wujijun11/git/TangMega60K_Synth/hardware/touch25/README.md

# Touch25：25键 FPGA 合成器触摸面板

本目录是本项目的 **25键纯被动电容触摸电极面板 R1 打样版**。它只负责提供可触摸的铜电极，触摸检测由外接的三块 MPR121 模块完成，FPGA负责读取触摸状态与合成声音。

**状态：独立几何预检通过；最终原生工程已导入，2026-10-09 18:24:32完成立创EDA原生DRC，141项检查、0错误。实际导出的Gerber完成163项独立几何检查、全部通过，ZIP字节和25键映射交叉核对通过。尚未下单，触摸、音频整机与延迟未实测。**

2026-10-09：同名最终 Gerber ZIP 已上传立创并解析成功，关联文件 ID 为 `99255657`，识别尺寸29 × 10.5 cm、2层。这里只记录上传完成，订单仍未提交、未付款。

2026-10-09 21:28：按用户要求再次上传同一最终ZIP，最新关联文件 ID 为 `99258298`，上传记录显示处理成功（16秒）。新订单准备页核对29 × 10.5 cm、2层、哑黑阻焊、无铅喷锡及手动确认；未提交订单、未付款。该次上传未更改R1制造图。

本次继续优化已补齐 [8/8/9组可拆线束与底托方案](harness_assembly_zh.md)、[装配示意图](harness_layout.png)、[逐键校准工具与流程](calibration_guide_zh.md) 和 [B的驱动交接约定](touch25_driver_handoff_zh.md)。校准工具的10项合成测试通过；原制造文件和25键映射未修改。模块实物外形、引脚约束、采集驱动、校准阈值和完整延迟仍需上板确认。

## 面板规格

| 项目 | 设计值 |
| --- | --- |
| 音域 | C4–C6，MIDI 60–84，共25个半音 |
| 琴键 | 15个白键位置、10个黑键位置；平面触摸，无按压行程 |
| PCB | 双层，290 × 105 mm；建议1.6 mm FR-4 |
| 白键节距 | 18 mm |
| 白键电极 | 16 × 28 mm，圆角半径1.5 mm |
| 黑键电极 | 11 × 25 mm，圆角半径1.5 mm |
| 外观建议 | 黑色阻焊、白色丝印；白键由轮廓及音名识别 |
| 电极表面 | 顶层铜覆盖阻焊，不开露铜或锡膏窗口 |
| 信号接口 | J1：1×8；J2：1×8；J3：1×9，均为2.54 mm排针 |
| 连接孔 | 1.0 mm通孔、1.8 mm焊盘；pin1为方形焊盘 |
| 转层孔 | 0.3 mm孔、0.8 mm焊盘，焊环0.25 mm；上下阻焊扩展−0.4 mm，实际Gerber确认双面盖孔 |
| 最小丝印 | 字高1.0 mm，线宽0.15 mm |
| 安装孔 | 六个3.2 mm非金属化通孔；下中孔已改到(170,100) mm |

面板没有 MCU、MPR121 芯片、音频电路、SCL/SDA、VCC或GND接口，也没有地平面。不能单独发声。工程预览中的半透明色用于显示被阻焊覆盖的电极位置，不能当作实物照片或实际铜面颜色。

## 电极连接

| 面板接口 | 琴键网络 | 外接模块 | 模块触摸通道 |
| --- | --- | --- | --- |
| J1 pin1–8 | E00–E07 | MPR121 #1 | ELE0–ELE7 |
| J2 pin1–8 | E08–E15 | MPR121 #2 | ELE0–ELE7 |
| J3 pin1–9 | E16–E24 | MPR121 #3 | ELE0–ELE8 |

三个接口只传电极信号。**面板上的这些针脚接 MPR121 的 ELE端，不能直接接 FPGA GPIO，也不能接3.3V、5V或GND。** 从面板正面看，各接口pin1在左，信号按音高从左到右增加；从背面看左右会反转，请识别方形pin1。

将三块模块放在对应接口附近，电极连接线以 **不超过5 cm** 为布置目标，尽量避开DAC时钟线和功放/喇叭线。使用三个独立 I²C 总线：每块模块的 SCL、SDA、IRQ分别接FPGA，共占9个GPIO；模块另接3.3V和公共GND。按目前仅DAC占用三路PMOD信号的接线，13个空闲GPIO接完后剩4个。具体FPGA针脚必须由约束文件分配到已确认的3.3V GPIO。

完整装配步骤和25键逐针表见 [装配与接线指南](assembly_wiring_zh.md)。
面板侧优先采用2.54 mm的8/8/9针成组母壳，两端标明J1/J2/J3及pin1；模块端按实物ELE标注核对，不能默认两端直通。模块放在下沿外绝缘托架，量实物后确定固定方式；详见 [线束与底托方案](harness_assembly_zh.md)。

## 还需要准备

- 三块 MPR121 模块，优先选择排针已焊版本；模块使用3.3V供电及3.3V数字电平。
- 1×8公排针两条、1×9公排针一条，需要自行焊接；本面板没有SMT器件，普通PCB打样不会自动焊排针。
- 25根短电极信号线。面板侧用2.54 mm的1×8母壳两只、1×9母壳一只及匹配端子；模块侧公排针可用1P母端逐针接线，核对ELE物理顺序后再考虑成组插头。电极线另作拉力固定。
- 模块到FPGA的9根数字信号线及3.3V/GND分配线。模块公排针到FPGA PMOD插孔通常使用公对母线。
- 六套M3绝缘支柱/螺丝及安装底板；避免PCB背面焊点碰金属。
- 可选薄PET保护膜。加膜后重新校准触摸阈值，并重新测试响应。

当前FPGA工程还需要增加MPR121初始化、三总线触摸读取、25键音符映射与校准。触摸开/关不能作为已经测得的压力或击键速度；项目要求的第二种独立演奏维度应另接合适传感器。端到端触摸→声音延迟仍需实测，不能用芯片采样间隔或软件预检代替。

## 文件和复现

| 文件 | 用途 |
| --- | --- |
| `Touch25_C4_C6_18mm_R1_Final/Touch25_C4_C6_18mm_R1_Final.eprj3` | 在立创EDA专业版实际保存、完成0错误DRC的最终原生工程入口 |
| `Touch25_C4_C6_18mm_R1_Final/pcb/Touch25_C4_C6_18mm_R1.epcb2` | 最终原生PCB源码，随同上面的工程目录保存 |
| `Gerber_Touch25_C4_C6_18mm_R1_2026-10-09.zip` | 实际原生导出的制造文件，54,830字节；163项独立检查通过 |
| `Touch25_C4_C6_18mm_R1.epro2` | 生成脚本创建、用于导入的R1原生交换工程 |
| `Touch25_C4_C6_18mm_R1.epru` | 同一工程的原生记录文本 |
| `generate_touch25.py` | 从同源几何生成工程、映射与预览 |
| `native_writer.py`、`clean_editor_defaults.json` | 干净原生序列化器与编辑器通用默认配置，不含旧555电路 |
| `design_manifest.json` | 尺寸、坐标、每键电极与线路几何、状态和工程SHA256 |
| `mapping.csv` | 25键、MIDI、排针和MPR121通道逐项映射 |
| `top_preview.svg`、`bottom_preview.svg` | 工程几何预览；底层以正面透视方向显示，不镜像 |
| `top_preview.png`、`bottom_preview.png`、`design_overview.png` | 对现有SVG的渲染及中文双面总览，非原生Gerber截图 |
| `render_preview_png.cjs`、`compose_preview_png.py` | PNG渲染与组合脚本；需要sharp和Pillow，不修改工程几何 |
| `validate_geometry.py`、`geometry_preflight.json` | 独立几何与映射检查，不是立创原生DRC |
| `assembly_wiring_zh.md` | 中文装配、逐针接线和首板验收指南 |
| `harness_assembly_zh.md`、`harness_layout.svg/png` | 不改R1孔位的成组线束、pin1标记与模块托架方案；模块占位不用于加工 |
| `calibrate_touch25.py`、`calibration_template.csv`、`calibration_guide_zh.md` | 读取实测日志并生成逐键阈值候选；缺测/故障/噪声重叠时阻止相应候选，不写设备 |
| `test_calibrate_touch25.py` | 10项合成数据测试，不表示首板已实测 |
| `touch25_driver_handoff_zh.md` | B后续驱动的初始化、8/8/9状态屏蔽、按下/释放、故障恢复与验收约定 |
| `verification/optimization_20261009.md` | 本次优化范围、验证和制造文件保持情况 |
| `fabrication_parameters_zh.md` | PCB打样参数与提交前核对说明，价格/选项以实际页面为准 |
| `verification/actual_gerber_audit.json` | 实际Gerber的163项独立检查明细、钻孔/铜层/阻焊与文件哈希 |
| `verification/actual_gerber_review.md` | 实际制造文件的审核结论、解析方法和实物验收限制 |
| `verification/package_crosscheck.json` | ZIP内12个文件的字节核对和MIDI60–84映射核对 |

在本目录执行 `python generate_touch25.py` 和 `python validate_geometry.py` 可重新生成、检查。重新生成会创建新文档/对象UUID，因此归档文件SHA256会改变；电极尺寸和线路几何由生成脚本决定。设计坐标以毫米表示、正y向下，写入原生工程时统一将y取负。

## 已完成的真实预检

下中安装孔移动到(170,100) mm后，`geometry_preflight.json`记录：25键和8/8/9通道映射通过；同源几何的电极→转层点→接口端点连续；异网铜和安装孔避让检查通过。最小异网铜间距为 **0.740 mm**，最小异网线线间距为 **0.786818 mm**。原生记录包含25个顶层FILL电极、100段铜线和56个PAD（25个接口、25个转层点、6个NPTH）。

最终原生工程还完成了141项DRC检查、0错误，并实际导出了54,830字节的Gerber ZIP。该ZIP的SHA256为 `796CCB39E2B18CB72EF80832254A5D7D71BE6FFF0C74F9DEE4A8960D6979C42C`。实际Gerber的163项独立检查全部通过，确认290 × 105 mm闭合外框、25路独立连接、25个0.3 mm转层PTH、25个1.0 mm接口PTH、六个3.2 mm NPTH、双面电极/转层阻焊覆盖、接口阻焊开窗及无独立锡膏文件；ZIP内12个文件与审核副本逐字节一致，CSV/manifest的MIDI60–84映射一致。

这些证据不等同于厂家CAM接受或首板硬件验收。审核按标称钻孔移除了与NPTH完全同心同径的铜圆盘，钻偏、孔径公差和工厂CAM修改仍需制造端确认；实际Gerber检查也不代替完整丝印可读性审核。没有任何已下单、已制造、触摸延迟、音频整机或首板硬件验收通过的声明。详细范围见 `verification/actual_gerber_review.md`。
