wujijun11/git/TangMega60K_Synth/docs/hardware/GAO板内验证-20260923.md

# GAO板内数字验证（2026-09-23）

## 工程与运行方式

新增独立入口 `BoardAudioGAO.gprj`，顶层为 `rtl/board/board_audio_gao_top.v`，复用现有 `live64_system_top`。原主音源与手动板级诊断入口未被替换。

上电后自动执行：复位 → 启动64声部 → 保持约1秒 → 停止 → 等待释放完成且声部数归零 → 完成次数加一 → 下一轮。错误、任意非零欠载及等待超时会置位粘滞 `fault` 并停机。每轮音源复位会清除其欠载计数，但不会清除该粘滞故障。

配置 `debug/board_audio.rao` 用系统时钟采集4096点，观察状态、声部数、欠载及内部I2S。此工程不输出外部DAC引脚，不能用于模拟音频验收。

## 编译、仿真与下载

- `scripts/test-board-gao.ps1` 通过：`BOARD GAO AUTORUN PASSED runs=2 restart=3`。
- `scripts/build-board-gao.tcl` 构建通过；Setup/Hold违例均为0。
- V22非专用时钟输入导致的PR1014仍存在，本次未消除该物理限制。
- 实际带GAO码流为 `impl/pnr/ao_0.fs`。SHA256：`C8958860C0C4394B5CFD2E7FC11A349229BDBA240642F0F29CE1BF1208C6EA8C`。
- GOWIN Programmer SRAM Program成功，用时11.91秒，器件ID `0x0001481B`，User Code `0x0000C446`，Status Code `0x70026020`。未写Flash；断电后此SRAM程序不保留。

## 实物读回

| 信号 | 第一次采集 | 第二次采集 |
| --- | --- | --- |
| completed_runs（十进制） | 15 | 80 |
| active_count | 64 | 64 |
| phase | 3（HOLD） | 3（HOLD） |
| error / fault | 0 / 0 | 0 / 0 |
| underruns | 0 | 0 |
| 有效采样点 | 4096 | 4096 |

完成次数从15增加到80，表明自动启停及释放归零流程持续运行；两次快照均位于保持阶段，并非停止瞬间的直接波形。欠载、错误和粘滞故障均为0。启动欠载及自检复位修复过程见[修复记录](启动欠载修复-20260923.md)。

仅保留修复后的有效波形：[第15轮](gao-20260923/zero_underrun_run15.csv)和[第80轮](gao-20260923/zero_underrun_later.csv)。检查脚本默认零欠载要求下均通过：BCLK周期16个系统时钟、完整声道槽32位、1位延迟后24位数据、末尾填零，并各解码7个完整非零PCM样本。修复前的两份启动欠载波形已按用户要求移除。

CSV导出窗口默认时间单位为us、周期为1，不能把它作为实际采样时间。检查脚本使用行号作为系统时钟周期。按板载标称50MHz推算，BCLK为3.125MHz，音频采样率为48,828.125Hz；本次没有用外部仪器测量晶振频率。

复核命令（项目目录内）：

```powershell
python scripts/check-gao-capture.py docs/hardware/gao-20260923/zero_underrun_run15.csv docs/hardware/gao-20260923/zero_underrun_later.csv
```

## 验证边界与下一步

本次完成板内满声部运行、自动释放重启及I2S数字格式检查，未逐样本对比实物PCM的算法期望值，未验证外置DAC、模拟音质、准确音高或演奏端到端延迟。音高参数目前按48kHz生成，需与实际音频时钟统一。完整262144帧ModelSim频谱回归另行运行，不能用此GAO检查替代。

继续调试时在GOWIN打开本工程，进入Gowin Analyzer Oscilloscope，加载对应RAO与匹配码流，按F1采集；查看 `fault`、`active_count`、`completed_runs` 和I2S信号。DAC到货后再核对物理引脚、电平与供电并开展外部输出验证。
