wujijun11/git/TangMega60K_Synth/docs/hardware/官方资料读取-20260920.md

# 官方硬件资料读取记录（2026-09-20）

读取来源：Sipeed Tang Mega 60K Wiki所链接的官方下载站。
本次下载及读取资料，未修改RTL、工程文件或生效CST/SDC，未烧录。

## 资料版本

- SOM/tang_mega_60k_30354_schematics..pdf：7页，下载站更新时间2026-06-08。确实有2026年上传的60K核心板资料；不代表手中实物就是30354，也不代表所有图纸页日期都是2026。
- SOM/tang_mega_60k_30353_schematics.pdf：7页，旧版对照。
- DOCK/Tang_Mega_NEO_Dock-60K_31004_Schematics.pdf：21页，Rev 1.4，2025-03-31。
- 08_Misc/tang_mega_60K_pins.cst：官方60K全引脚参考，下载站更新时间2024-11-19。
- PTC PT8211_s.pdf：芯片手册明确16位、LSBJ格式。

文件保存在工作区tmp/hardware_read_20260920，核心板30354部分PDF字体不能直接提取，相关时钟和电源页已渲染查看；底板音频、按键、扩展口和DVP页已渲染查看。未逐项验收所有外设或新旧版本差异。

## 与当前工程直接相关的发现

1. 核心板30354第2页：Y1100为50MHz，OUT经R973到BANK7_V22_EMCCLK_50Mhz；官方CST sys_clk=V22、LVCMOS33。
2. 当前发送器DIV=8：Fs=clk/(8*2*64)。50MHz直连会得到48828.125Hz，不是48000Hz；当前音源ROM按48kHz生成。需要验证可实现的时钟方案，不能简单假定PLL能精确生成49.152MHz。
3. 底板第10页：U16=PT8211-S，U20=NS4263，PA_EN=1关闭功放，0开启。原理图I2S_BCLK/I2S_LRCK/I2S_DIN命名不能改变DAC的LSBJ协议。当前24位Philips I2S不能直接驱动该DAC。
4. 沿用用户既定标准I2S路线，后续应连接兼容的外置DAC，并依据具体模块电路决定供电、FMT/XSMT/SCK等接法。本次不恢复已删除PT8211模式。
5. 底板第9页：用户按键AA13、AB13、Y12在BANK9，要求LVCMOS15、内部上拉至1.5V，按下接地。AA13在官方例程CST命名sys_rst_n，但物理上是用户按键，不是系统专用复位管脚。
6. 底板第19页：FPC10P也注明BANK9、1.5V。更正笼统说法：不能把全部FPGA引脚设为3.3V；必须逐个BANK核对。
7. 官方CST包含摄像头、DDR、以太网等例程内部层级的INS_LOC/CLOCK_LOC，不可整份直接加入本音源工程。应只选已核对、实际使用的端口，并匹配新板级顶层名称。
8. PMOD与SDRAM1/DVP存在复用；外接DAC/键床分配前须建立冲突表。第19页PMOD电源脚1/2为3.3V，3/4为GND，以图纸连接器编号为准；不可按通用模块的外观方向猜针脚。

## 官方CST参考映射（不是已批准接线表）

|信号|FPGA球号|CST电平|用途|
|---|---|---|---|
|sys_clk|V22|3.3V|50MHz时钟|
|sys_rst_n|AA13|1.5V，上拉|板载用户按键EX_KEY.0|
|Key_in[0]|AB13|1.5V，上拉|板载用户按键EX_KEY.1|
|Key_in[1]|Y12|1.5V，上拉|板载用户按键EX_KEY.2|
|HP_BCK|Y17|3.3V|板载PT8211 BCK|
|HP_WS|AB17|3.3V|板载PT8211 WS|
|HP_DIN|AA16|3.3V|板载PT8211 DIN|
|PA_EN|AB16|3.3V|板载功放控制|

球号不是排针编号；板载DAC引脚也不是外置DAC建议接线。

## 尚需确认

实物核心板与底板丝印版本；外置标准I2S DAC具体模块；外接键床/传感器占用；音频时钟精度及PLL可行性；最终CST/SDC、布局布线和上板测量。

## 官方来源

- https://wiki.sipeed.com/hardware/zh/tang/tang-mega-60k/mega-60k.html
- https://dl.sipeed.com/shareURL/TANG/Mega_138K_60K/02_Schematic/SOM
- https://dl.sipeed.com/shareURL/TANG/Mega_138K_60K/02_Schematic/DOCK
- https://dl.sipeed.com/shareURL/TANG/Mega_138K_60K/08_Misc
- https://www.princeton.com.tw/Portals/0/activeforums_Attach/PT8211_s.pdf
