wujijun11/git/TangMega60K_Synth/docs/hardware/主工程板上复测-20261011.md

# 主工程板上复测（2026-10-11）

当前板上为 `full/ContestFull.gprj` / `board_contest_full_top`。独立单音诊断之后，已通过 Gowin Programmer GUI 恢复完整主工程；本次保留该位流，只读器件码并按用户实际听测核对控制。J13 空着，使用现有 PCM5102A → 功放 → 喇叭。

## 配置与构建依据

- 位流：`full/impl/pnr/ContestFull.fs`；SHA256 为 `d206588cf0e7a7d2e068e081b83c071344ddc7ccc740abeac4f350bebe4aa0ed`。
- 本次 JTAG 只读完成，退出码 0：器件 ID `0x0001481B`、用户码 `0x0000F0A6`、状态码 `0x70026020`。器件码读取不是整个位流内容回读，也不提供内部声部数或欠载计数。
- 对应布局布线报告：建立余量 0.171ns、保持余量 0.004ns，建立/保持违规均为 0；块 RAM 为 106/118（90%）。这是静态构建结果，不能代替长时间实物稳定性测试。

下载历史见 [GUI 下载记录](../../verification/contest-full-20261011/hardware-gui-after-diagnostic.json)，本次原始读码见 [JTAG 日志](../../verification/contest-full-20261011/jtag-main-controls-retest.log)，构建数据见 [build-results.json](../../verification/contest-full-20261011/build-results.json)。SRAM 配置断电后丢失。

## 实物结果

| 检查 | 结果与来源 |
| --- | --- |
| KEY0 启动、播放中停止、再按重播 | 用户报告通过 |
| KEY2 按下并松开复位，再按 KEY0 | 用户报告可重新播放 |
| 播放中按 KEY1 | 用户报告乐曲停止 |
| 再按 KEY1 退出引导，再按 KEY0 | 用户报告可重新播放 |
| 喇叭实际输出 | 用户报告“声音很轻，但能听到音高变化” |

原话为“能播放、停止、重播，复位后也能重播”和“KEY1 能停止乐曲，退出后 KEY0 能重播”。结构化结果见 [本次板上复测记录](../../verification/contest-full-20261011/hardware-main-controls-retest.json)。没有外接灯条，本次 KEY1 结果仅证明声音控制和恢复，不证明指引灯输出正常。

声音偏轻尚未解决。代码中主工程 `MASTER_SHIFT=1`，单声部诊断为 7；同一单音的数字尺度差 64 倍（约 36.1dB），主工程保留了多声部叠加余量。本次没有改变混音增益，也没有测量模拟输出电平、精确音高或失真，不能据此宣布旋律和音质验收通过。

## 尚未实测的功能

25 键琴键 PCB、滑条、ESP32-C3 和外接 WS2812 尚未到货。用户确认没有 HDMI 显示器和 3.3V USB 转 TTL；电脑仅枚举到蓝牙虚拟 COM5，不能当作 FPGA 的 UART 使用。现有主工程没有可用的内嵌 GAO，DEBUG USB 的读码不能替代内部遥测。

因此，25 键/滑条、手机 BLE、外接 LED、HDMI、64 声部实际并发、运行时音色/音效，以及控制到 DAC 的物理延迟仍待验收。现有仿真通过记录继续作为软件证据，不能标为以上实物功能已经通过。整机接线与后续步骤见 [首次上板与到货验收](../全功能首次上板步骤-20261011.md)。
