wujijun11/git/TangMega60K_Synth/docs/hardware/外置I2S下载验证-20260927.md

# 外置 I2S 下载验证（2026-09-27）

## 当前结论

外置 DAC 测试工程仿真、综合、布局布线通过，已通过 Gowin Programmer 下载到 Tang Mega 60K 的 SRAM。实际喇叭声音仍待用户反馈，不能据下载成功判定音频硬件验收通过。

本次使用 `clock48/BoardAudio48kI2S.gprj`、顶层 `board_audio_48k_i2s_top`，复用 `live64_system_top` 的 64 声部自检。这是外置音频链路测试入口，不是队员 B 完整演奏交互的最终板级入口。没有烧写 Flash。

## 接线证据

用户断电测量确认：青绿色线在 DAC 端的金属触点与 PMOD1 的 AA20 焊点持续蜂鸣，电阻接近 0Ω。此次测量直接确认数据线导通，其他线没有在本次获得独立测量结果。

| DAC 信号 | 线色 | 工程约束 |
| --- | --- | --- |
| DIN | 青绿色 | AA20 |
| WSEL / LRCLK | 紫色 | AB21 |
| BCK | 蓝色 | Y21 |

用户报告功放板已连接。

## 仿真与构建

- 脚本：`scripts/test-board-48k-i2s.ps1`
- 结果：`BOARD 48K EXTERNAL I2S PASSED stop/restart/reset slots=521 active_bits=1024`
- 构建：`gw_sh.exe scripts/build-board-48k-i2s.tcl`，退出码 0。
- 构建日志：工作区 `tmp/board_audio_i2s_build_20260927.log`。
- 时序报告：`clock48/impl/pnr/BoardAudio48kI2S.tr`。
- Setup 违规端点 0；Hold 违规端点 0。
- 49.152 MHz 音频时钟域报告 Fmax 72.536 MHz。
- 仍有 ROM 文本位宽、时钟关系 CK3000、非专用时钟布线 PR1014 等警告；本次未改动 RTL 或约束，不将此次编译描述为零警告。

## 实际下载结果

- 文件：`clock48/impl/pnr/BoardAudio48kI2S.fs`
- SHA256：`5D6743116073242F13620DB34CD2896C4DFE3D169D882845997E197526ED18DB`
- 工具：Gowin Programmer V1.9.12 (64-bit) (2558)
- 下载线：USB Debugger A/0/609/null
- 器件：GW5AT-60B，ID `0x0001481B`
- 操作：`SRAM Program`
- User Code：`0x0000BB56`
- Status Code：`0x70026020`
- 输出：`Finished.`，用时 13.03 秒。

## 待完成的实物测试

功放低音量，短按用户 KEY0（AA13）启动自检；KEY1（AB13）停止；KEY2（Y12）复位。不要把 PWR 当作用户按键。待记录是否发声，以及停止、再次启动、复位是否符合预期。
