wujijun11/git/TangMega60K_Synth/docs/hardware/外置I2S下载验证-20261007.md

# 外置 I2S 下载验证（2026-10-07）

## 本次结果

已在 GOWIN FPGA Designer 打开 `clock48/BoardAudio48kI2S.gprj`，通过 Gowin Programmer 将既有位流重新下载到 Tang Mega 60K 的 SRAM。下载器本次报告 `Finished.`，用时 11.78 秒。未重新编译，未烧写 Flash。

这确认本次下载成功。随后用户反馈“可以发声”，并明确确认“KEY1 能停止，KEY0 能重新发声，KEY2 能复位静音”。据此，本次外置音频链路的发声、停止、重新启动及复位静音检查按用户实物反馈通过；最终供电电压仍待确认。

## 下载证据

- 工具：Gowin Programmer V1.9.12 (64-bit) (2558)
- 文件：`clock48/impl/pnr/BoardAudio48kI2S.fs`
- SHA256：`5D6743116073242F13620DB34CD2896C4DFE3D169D882845997E197526ED18DB`，本机核对与 2026-09-27 记录一致。
- 顶层：`board_audio_48k_i2s_top`
- 工程器件：`GW5AT-LV60PG484AC1/I0`
- 本次识别：`GW5AT-60B(0x0001481B)`
- 下载线：`USB Debugger A/0/609/null@2.5MHz`；操作过程中报告频率更新为 15MHz。
- 操作：`SRAM Program`
- User Code：`0x0000BB56`
- Status Code：`0x70026020`
- 输出：`Finished.`，`Cost 11.78 second(s)`。

## 用户实物测试

功放供电应为 5V，音量从低档开始。普通用户键 KEY0（AA13 / EX_KEY.0）启动，KEY1（AB13）停止，KEY2（Y12）复位。PWR 不是这些用户键。

本测试入口同时持续输出 64 个正弦音（MIDI 36–99），不播放旋律。按 KEY1 后约 100ms 的尾音释放属程序预期；释放后可再次按 KEY0 启动。KEY2 复位后需再次按 KEY0。

| 项目 | 本次实物结果 |
| --- | --- |
| 功放供电电压、极性 | 待用户实测反馈 |
| KEY0 启动后发声 | 用户报告可以发声，并确认 KEY0 能重新发声 |
| KEY1 停止 | 用户确认通过 |
| KEY0 再启动 | 用户确认通过 |
| KEY2 复位静音 | 用户确认通过 |

## 接口与限制

- PMOD 外置 DAC：DIN=AA20（青绿色），WSEL/LRCLK=AB21（紫色），BCK=Y21（蓝色）。此次未新增线路实测。
- 2026-09-27 用户独立确认 DIN 至 AA20 约 0Ω 导通；其余线不得标记为已独立测量通过。
- 此入口是外置 DAC 64 音自检，不是队员 B 实体交互的最终演奏入口。
- 既有编译的时序与警告见 `外置I2S下载验证-20260927.md`；此次没有重新运行仿真、综合或布局布线，未消除既有 ROM 位宽、CK3000、PR1014 警告。
