wujijun11/git/TangMega60K_Synth/docs/hardware/启动欠载修复-20260923.md

# 启动欠载修复

## 原因和改动

复位释放后，I2S在第16个系统时钟开始第一帧；音源仍需初始化声部RAM并计算首个样本。此前空FIFO会直接计一次欠载，因此板内记录出现启动值1。

`rtl/i2s_tx.v` 增加播放启动状态：首个有效左右声道样本对被取出或在帧边界直通后，才启用欠载检测。在此之前连续输出成对静音，BCLK/LRCLK和frame_tick持续运行。正常播放后缺帧仍输出静音并置位脉冲、粘滞标志及累加计数；补供不会清除历史故障，只有复位清除。

此状态以有效握手的数据为准，首个全零静音样本也会启动监测。一直未提供第一帧的数据源不会触发播放欠载，需要上层用启动超时识别；GAO自动诊断已有超时检查。

两个板级诊断顶层均取消允许一次欠载的例外，任意非零欠载即故障。GAO CSV检查脚本默认要求零欠载；复核修复前的历史CSV时才显式传 `--max-underruns 1`。历史波形没有修改，不代表修复后上板结果。

## 验证

- 控制/I2S六组回归通过，含分频1与8、V1/V2接口、延迟首样本、真实断供、边界直通、FIFO反压、复位重新预备及串行PCM逐帧比对。
- `test-board-audio.ps1` 通过（2425帧），真实64声部音源启动欠载要求已从1改为0；包含停止回收、重启与复位。
- `test-board-gao.ps1` 通过：完成2轮自动启停并第3次启动，欠载为0（`BOARD GAO AUTORUN PASSED runs=2 restart=3`）。
- GAO工程重新综合、布局布线及生成码流成功；Setup/Hold违例均为0。原PR1014仍存在，NL0002为固定表情控制逻辑被优化。
- 新 `impl/pnr/ao_0.fs` SHA256：`53AD53110633932B8FF538D5447B09FCAA3F9B4D16449FB0E04E175E88825C9C`。

上述为第一次修复构建。此前29/120轮实物证据属于旧版。

## 后续实物复测与复位修复

首次下载53AD版本成功（12.75秒，User Code A0E3），但GAO读到phase=6、fault=1、active_count=0、underruns=0、completed_runs=0；重新加载RAO后仍相同，不能判定通过。

检查发现GAO顶层使用多位状态的组合译码直接驱动音源异步复位，存在状态切换毛刺风险。现将rst_n改为寄存器，仅在预备完成时释放、每轮释放回收完成时拉低。修改后实物恢复正常；未直接测量瞬态复位毛刺，因此该机理为代码分析支持的原因判断。

最终码流SHA256：`C8958860C0C4394B5CFD2E7FC11A349229BDBA240642F0F29CE1BF1208C6EA8C`。SRAM下载Finished，用时11.91秒，User Code `0x0000C446`，Status `0x70026020`；未写Flash。重新布局布线Setup/Hold违例均为0，PR1014仍存在。

寄存器复位版本重新运行 `test-board-gao.ps1` 通过：`BOARD GAO AUTORUN PASSED runs=2 restart=3`，退出码0，仿真结束时间99.25211ms。运行耗时较长但未超时，启动欠载严格要求0。

两次实物CSV：[第15轮](gao-20260923/zero_underrun_run15.csv)、[第80轮](gao-20260923/zero_underrun_later.csv)。均为64声部保持状态，error=0、fault=0、underruns=0，各4096点；默认严格零欠载检查通过，BCLK周期16拍、32位槽及24位PCM解码通过。计数15→80确认持续自动启停。CSV时间刻度仍为导出默认值，检查使用行号表示系统时钟周期。

外置DAC、模拟输出与长期稳定性不包含在本次验收中。
