wujijun11/git/TangMega60K_Synth/hardware/ahct125/release/verification/schematic_review.md

# AHCT125 LED R1 原理图独立审查

审查日期：2026-10-18（Asia/Shanghai）。结论：**原理图连接审查通过**；此结论仅针对下列文件，不代表 PCB 布局布线、电源通流、PCBA 装配或实物波形已验收。审查未修改设计、未调用 EDA invoke。

## 审查输入与一致性

- 导出网表：`C:/Users/asus/Documents/LCEDA-Pro/projects/AHCT125-LED-R1/AHCT125_LED_R1.net`
- 网表 SHA-256：`e24749d23e3ad3736b3fd62dc2f0cbd5bdbf5e99cbf973d99b10e33d2554a2c4`
- SCH DRC 记录：`hardware/ahct125/references/sch-check.json`
- DRC 记录 SHA-256：`06e9aa9ddcb675c63aaf10f387c4421ff171c44bc252c5f5f86fcb9aa049c51b`
- DRC 返回 `ok=true`、`value.passed=true`、`verbose=[]`。
- DRC 记录内嵌的 `value.net` 与导出网表逐字符相同。
- 独立解析结果：9 个元件、5 个网络、28 个已连接引脚；没有重复归属网络的引脚。
- 逐个比较下文预期网络集合，差异为 0；U1 的三个未用输出未被连接。

## U1 逐针检查

U1 为 TI `SN74AHCT125DR`，C155176，SOIC-14，采用标准 14 脚脚序。符号引脚名称与 TI 官方资料一致。

| 引脚 | 功能 | 导出网表 | 结论 |
| --- | --- | --- | --- |
| 1 | /1OE | GND | 第一通道常使能，正确 |
| 2 | 1A | DATA_IN | 输入，正确 |
| 3 | 1Y | BUF_OUT | 进入 R2，正确 |
| 4 | /2OE | +5V | 关闭未用第二通道，正确 |
| 5 | 2A | GND | 未用输入固定，正确 |
| 6 | 2Y | 未接 | 未用输出留空，正确 |
| 7 | GND | GND | 正确 |
| 8 | 3Y | 未接 | 未用输出留空，正确 |
| 9 | 3A | GND | 未用输入固定，正确 |
| 10 | /3OE | +5V | 关闭未用第三通道，正确 |
| 11 | 4Y | 未接 | 未用输出留空，正确 |
| 12 | 4A | GND | 未用输入固定，正确 |
| 13 | /4OE | +5V | 关闭未用第四通道，正确 |
| 14 | VCC | +5V | 正确；按 4.5～5.5V 工作范围使用 |

## 其余八件逐针检查

| 位号 / 物料 | 引脚连接 | 结论 |
| --- | --- | --- |
| R1 / C25804，10kΩ，0603，100mW | 1=DATA_IN，2=GND | 输入下拉正确；3.3V 时耗散约 1.1mW |
| R2 / C23138，330Ω，0603，100mW | 1=BUF_OUT，2=DATA_OUT | 单个输出串联电阻，正确 |
| C1 / C14663，100nF，50V，X7R，0603 | 1=+5V，2=GND | 去耦连接正确，位置待 PCB 检查 |
| C2 / C15850，10µF，25V，X5R，0805 | 1=+5V，2=GND | 本地储能连接正确 |
| C3 / C88853，1000µF，10V，径向 D8×11.5mm，P3.5mm | 1=+5V，2=GND | 网表极性分配正确；装配仍需按封装正负号核对 |
| J1 / C124375，2P，2.54mm 公排针 | 1=DATA_IN，2=GND | FPGA 输入接口正确，没有 5V 引出到该口 |
| J2 / C124376，3P，2.54mm 公排针 | 1=DATA_OUT，2=+5V，3=GND | LED 接口与指定脚序一致 |
| J3 / C474906，KF127-5.08-2P | 1=+5V，2=GND | 外接电源入口正确 |

完整信号链为 `J1-1 → U1-2 / U1-3 → R2-1 / R2-2 → J2-1`；未发现绕过 R2 的输出连接。R1 下拉只在输入端，未形成电阻分压器。+5V 与 GND 是两个独立网络。

## 布板、装配及使用边界

1. C1 必须贴近 U1 的供电脚，缩短电源与回地回路。网表不能证明这一点。C3 应靠近 J2 电源出口；安装整板时靠近 LED 的 DIN/电源入口。
2. 外接稳压 5V 同时供 U1 和 LED；GND 与 FPGA 共地。J1-1 接当前项目 J13-14/A15；J1-2 接 FPGA GND。J2-1 只接 LED DIN，不接 DOUT。
3. 本电路没有反接保护、过压保护或电源限流。丝印不能替代这些保护；供电极性必须按 J3-1/J3-2 检查，不得将外接 5V 接到 FPGA GPIO。
4. J2 器件的排针额定电流不代表未知杜邦插簧、线径和压接点可持续承载 2A。成品通流能力需结合 PCB 铜宽、焊接、配套线材与温升确认；对未知杜邦连接仅作低亮度调试，不承诺 2A。
5. 裸排针没有机械防反插。J1/J2 应大字标注功能和每针信号；J2 中间脚是 +5V，不能凭常见灯板线序整排盲插。
6. 当前 U1-1 常使能，输入 10kΩ 下拉提供断线/FPGA 未驱动时的默认低电平；这并不是经过电源监控的无毛刺启动保证。TI 的输入快沿要求不宜用未经分析的 RC 延时替代。
7. AHCT 与 LED 若分别上电/断电，输出高电平可能通过未供电 LED 的 DIN 结构回灌。共用同一 5V 电源并一起通断；330Ω 只限流，不构成电源隔离。
8. 首板仍需测 LED DIN 的高低电平、0/1 脉宽及电源跌落。逻辑仿真和 SCH DRC 不能替代实物测量。数据线与地线成对、尽量短，避免未知长线电容。

## 非阻塞的元数据问题

网表中 C3 的 `3D Model Title` 为 `CAP-TH_D8.0-H8.0-P3.50`，但选定 Rubycon 物料的实际高度为 **11.5mm**。这不改变电气网络或 3.5mm 脚距，但 3D 装配/外壳避让应按实际高度检查，不能以模型标题的 8mm 为机械依据。

U1 库中多项逻辑脚的 ERC 类型均标作 `Passive`。因此 DRC 通过只是一项辅助证据；本次另行依据芯片功能逐针审查，不把 ERC 通过等同于电路功能证明。

## 官方依据

- [TI SN74AHCT125 数据手册](https://www.ti.com/lit/ds/symlink/sn74ahct125.pdf)：14 脚定义、TTL 输入门限、供电范围、未用输入/输出处理、近端去耦与输入边沿要求。
- [LCSC C88853 商品页](https://www.lcsc.com/product-detail/C88853.html)及 [Rubycon PX 数据表](https://datasheet.lcsc.com/datasheet/pdf/1f06f8929b144e399833f605cc15b596.pdf?productCode=C88853)：1000µF/10V、D8×11.5mm、脚距 3.5mm。
- [LCSC C474906 商品页](https://www.lcsc.com/product-detail/C474906.html)：KF127-5.08-2P，2P、5.08mm 直插端子。
