wujijun11/git/TangMega60K_Synth/docs/混音平滑上板异常排查_20261027.md

# 混音平滑上板异常与独立启动诊断

## 已确认事实

2026-10-27，用户下载平滑新版后Programmer显示Finished，彩灯为绿色，实体琴键不可用。C3仍能被搜索到，失败提示为FPGA握手超时/无响应。保持接线不变，回退原滑条音量版后恢复。此次对比将优先排查范围收敛到新版实现，不能反过来要求用户先更换接线或蓝牙模块。

| 项目 | 文件 | SHA256 |
|---|---|---|
| 已暂停平滑版 | `ContestFull_HeadroomSmooth_TEST1024.fs` | `2415136A6A5DC6278B8772AE6E2F3C83290882282383437C5CA35A7D15F3ECA9` |
| 用户确认回退恢复 | `ContestFull_SliderVolume_TEST1024.fs` | `3C87F83E373BBEABF9D564474E7FB669F35856E339B89EF383AA9A25A6C35BF6` |

两个本地文件均实际计算哈希并与交付清单一致。原ZIP保留，旁置STATUS与暂停使用说明；打包器增加暂停门禁，不再把原仿真/STA作为重复交付该故障位流的理由。

## 检查得到什么，尚不能断定什么

与基线`20aa6f9`相比，原平滑版生产修改只有：新增平滑模块、音源中可选接入、完整系统启用参数、GPRJ加入该文件。C3、Windows/手机、UART源码、板级引脚、PLL源码与SDC没有改动。实际综合网表的三组PLLA倍分频参数也已与原版逐项查看，一致。

但是重新综合/布局布线会改变整个实现，不能由“源码没改PLL”推导为“上板时钟和复位一定没问题”。Setup/Hold为正也不是已经通过实板验收。

实体传感器与UART都运行在49.152MHz域，共用板级`rst_n`。原RGB发送器运行在独立50MHz，默认淡绿色不取决于音频PLL是否已经运行。因此绿色不能排除音频域未启动或一直复位。这是排查优先方向，**不是已确认PLL根因**。新的混音数据不直接控制UART复位；音频通路的局部复位也不直接复位UART。

仿真存在明确边界：`audio_plla_stage`在`SIM`条件下跳过实际PLL_INIT动态初始化，原厂模型不提供真实MDRDO；整机板级测试因此不能证明本次硬件PLL启动过程已经正确。原42项实际仿真结果保留，但不能用它们覆盖这次实板失败。

## 临时诊断模块与职责

本分支`codex/headroom-board-triage`只增加启动观察，不改变平滑算法，不把临时诊断版称为修复版，不上传main或自动下载。

| 文件 | 作用 |
|---|---|
| `rtl/board/audio_boot_status.v` | 在独立50MHz读取既有48位双级采样快照，检测音频心跳，并生成RGB状态 |
| `rtl/board/board_contest_full_top.v` | 本分支新增`BOOT_DIAGNOSTIC=1`选择诊断颜色；其他音频/通信连接不变 |
| `full/ContestFull.gprj` | 加入诊断模块；不改CST/SDC/PLL参数 |
| `sim/tb_audio_boot_status.sv` | 人工快照验证颜色优先级、心跳停转及恢复；不能当真实PLL测试 |
| `scripts/test-modelsim-full.ps1` | 登记上述用例，与板级、音频和通信相关回归一起运行 |

既有快照低位含`board_ready[0]、audio_locked[1]、ready_sync[2]、rst_n[3]、audio_rst_n[4]`，心跳位为44，传感器ready/fault分别为18:16和21:19。没有增加跨域功能控制。心跳取既有音频计数器bit8，正常约5.2μs翻转一次、周期约10.4μs；超100ms未观察到翻转则判为停转。这里使用普通寄存器计数器，无块RAM或历史记录。

## 诊断版颜色表

此表仅适用于独立启动诊断位流，覆盖原模式灯色。

| 颜色 | 观察含义 |
|---|---|
| 白 | 独立50MHz上电等待尚未结束，正常只持续很短时间 |
| 红 | 两级音频PLL综合锁定资格尚未成立，不能据此直接区分哪一级 |
| 蓝 | 尚未见音频心跳，或心跳停止超过100ms |
| 紫红 | 音频心跳存在，但顶层仍处于复位或ready尚未同步 |
| 黄 | 顶层已运行，但音频局部通路仍被panic/传感器溢出复位 |
| 青 | 公共启动链正常，但传感器未全部就绪或报告故障 |
| 绿 | 音频心跳、复位释放和传感器就绪；不证明UART握手或声音已正常 |

没有音频时钟时，50MHz灯色逻辑仍能显示红/蓝。多位状态是诊断快照，刚下载的短暂变色不算稳定故障；观察约3秒后的稳定颜色，并记录键盘与握手是否正常。

## 验证与下一步

### 排查流水记录

| 顺序 | 操作与证据 | 结论/状态 |
|---|---|---|
| 1 | 用户反馈新版Finished、绿色、实体键无效；C3可发现但FPGA握手超时 | 用户实板失败，不能再标记为待首测或已经可用 |
| 2 | 用户保持接线不变，回退原滑条音量版 | 用户确认恢复，优先排查新版实现 |
| 3 | 实际读取两份本地FS哈希、比较生产源码差异及综合网表PLLA参数 | 本地交付与记录匹配；协议/引脚/PLL源码与参数未更改；未确认根因 |
| 4 | 独立分支新增50MHz彩灯启动观察；第一轮7项相关ModelSim满足预期 | 只证明仿真场景，不证明实板启动 |
| 5 | 第一轮Gowin构建`headroom-boot-probe`在TA2003停止：原`status_meta*`被优化删除，SDC对象不存在 | 未形成有效位流；保留失败日志，不作为时序通过 |
| 6 | 给原状态同步寄存器加入keep/preserve，保留原SDC目标；重新冻结源码运行`headroom-boot-probe-r2`构建和7项回归 | 未删除/放松SDC，没有修改平滑算法；以本轮实际结果为准 |
| 7 | 用户下载R2后反馈“绿色，握手成功”，随后确认“实体琴键也恢复正常” | 通过一次用户实板的启动状态、FPGA蓝牙握手、实体键发声检查；原故障根因仍未确认 |

失败轮原始记录位于`TangDirectScore_1vn_tkqm/verification/boot-build/build_headroom-boot-probe_20261027_182735_502545a8`；后续交付归档同时保留其错误日志与结果JSON。未自动扫描/Program板卡，也未刷C3。

### 第二轮实际结果

- 最终诊断源码7项选定ModelSim全部正常通过：`audio_boot_status、headroom_smoothing_n64、oled_volume_board、transport_status_equivalence、full_system、expression_merge、audio_i2s`；80个生产源文件参与编译，运行前后输入SHA一致。不是重新运行原42项；这些是发版前仿真证据，用户后续实板反馈另列如下。
- Gowin实际综合、布局布线、STA和位流生成通过；Setup/Hold/Recovery/Removal最小余量分别`0.200/0.126/3.555/0.573ns`，违反端点0。95个构建输入与当前源文件SHA核对一致。
- Logic27891、Register19179、BSRAM105、DSP56.5。相比暂停的平滑位流增加212 Logic与22寄存器，BSRAM/DSP不变；Setup余量减少0.138ns。因此仅用于临时定位，不作为长期增加诊断功能或已经修复的版本。
- 临时位流命名`ContestFull_HeadroomBootProbe_R2.fs`，SHA256为`BD359CFD031977B970D2DB0C4E058C9575E12F2596B24A69CC62ED4A5E00480A`。不覆盖原版或故障版，不自动下载。
- 临时位流在`delivery-headroom-boot-probe/fpga/`，日志应显示UserCode`0x0000F2EA`；配套GUI在同目录下`fpga-source/full/ContestFull.gprj`。源码提交`75d0769`，交付清单另存本报告目录`delivery-manifest.json`。
- 证据目录：[`reports/headroom-board-triage-20261027/`](reports/headroom-board-triage-20261027/selected-r2/build-results.json)，其中`failed-r1`保留第一次失败，`selected-r2`保存通过的实际构建，`modelsim-r2`保存7项日志与输入记录。

复现时先运行`scripts/prepare-direct-score-verification.py`生成英文目录副本；在副本运行`scripts/test-modelsim-full.ps1 -CaseName @('audio_boot_status','headroom_smoothing_n64','oled_volume_board','transport_status_equivalence','full_system','expression_merge','audio_i2s')`，实际需可用ModelSim。构建运行`python scripts/build-contest-isolated.py --variant headroom-boot-probe-r2 --without-gao --baseline <原平滑构建结果JSON>`；原始完整命令另存`gowin-run.json`。源码GPRJ保留原调试配置，交付GUI副本关闭GAO，与本次受验条件一致。

以上记录了诊断单元、相关集成仿真与完整隔离布局布线的实际结果。诊断版改变了少量逻辑和布局；即使它在实板恢复，也不能直接证明原故障只由某一PLL或平滑算式造成。需要用户回传稳定颜色/行为，再决定针对性修复，不连续发布没有区分目的的随机候选。

### 用户实板反馈：R2单次运行恢复

2026-10-27，用户先确认R2“绿色，握手成功”，随后确认实体琴键也恢复正常。来源为用户实际观察，代理未自动下载、未读取板内逻辑分析仪，不把这次观察写成代理仪器测量。

- 诊断绿色表示：已有音频心跳、综合锁定资格成立、顶层与音频局部复位释放、传感器就绪。
- 握手成功进一步说明本次C3至FPGA的命令/回复路径能工作；实体发声说明本次触摸到音源及音频输出链已能运行。
- R2保留相同平滑算法。这表明该算法在本次运行中没有阻止上述基本功能，不能据此排除所有跨档边界问题。
- 诊断观察逻辑、keep/preserve以及重新布局布线同时存在，且没有对原故障位流采到时钟/复位状态，无法把恢复唯一归因于PLL、某个复位或某条约束。**“增加指示灯后恢复”不等于“指示灯修复了根因”。**

保留当前确切FS及其SHA，不立即删除诊断逻辑后重建，也不覆盖仍需复现的原故障FS。硬件反馈记录另存[`hardware-feedback-20261027.json`](reports/headroom-board-triage-20261027/hardware-feedback-20261027.json)。后续验收应分别记录连续弹奏/蓝牙交替操作、增益跨档听感、多次冷启动、64声部实测；这些尚不能填写通过。本轮不为上述待验项目预先生成结论。

为固定这次用户实际使用的构建，已另存[实板反馈对应R2封存包](../releases/headroom-boot-probe-20261027/ContestFull_HeadroomBootProbe_R2.zip)，含原FS、配套GUI源码、日志、发版清单及本次用户反馈。ZIP内所有文件已与本地副本逐项核对字节一致，ZIP SHA256为`8809A7DBA794E579FA0AAD162587889184E75F81481C4374F3A9BF2052D3F2CE`。未重新构建位流；源RTL仍对应`75d0769`。封存清单另存`archive-manifest.json`，其`fullHardwareAcceptance=false`明确表示尚未完成全部实板验收。

**当前结论：原版回退可用；故障平滑位流继续暂停；R2通过一次用户实板的绿色状态、握手和实体发声检查，固定保留为测试候选；根因与长期稳定性未确认。**

后续听感反馈：用户发现持续按住一个音、加入其他音时原声音被压低。已从`AUTO_HEADROOM`目标倍率表定位为按活跃声部数整体调增益的既有策略；平滑保留了减半终点。它与本次启动故障分开记录，见[持续音增益问题](持续音被新增声部压低_20261027.md)。基本发声/握手恢复不代表这一听感问题已经解决；本次没有重新构建R2。

原可用版保持可下载。不要为取诊断数据刷写C3、改引脚或改接线；本轮不通过电脑自动Program。
