wujijun11/git/TangMega60K_Synth/docs/25灯WS2812逐键指引_20261025.md

# 5×5 灯板做逐键指引

最新Windows 1.4.3增加了灯位与琴键对照界面，入口为
`delivery-realtime-score/windows-guide-map/TangNeonStudio/TangNeonStudio.exe`。
按钮已移至25键区域的灯位图旁，使用与估计同步限制见[灯位琴键对照说明](灯位琴键对照_20261025.md)。
下文保留1.4.2原始按钮位置说明；硬件接线与校准方案仍适用。

这块 5×5 灯板如果是带 `DIN / DOUT / 5V / GND` 的 WS2812/WS2812B 可寻址灯板，就能用 25 颗灯分别对应 25 个琴键。它只需要一根数据线，不需要 25 根 FPGA GPIO。

## 使用时是什么样子

在琴键和灯板上都贴1–25的编号，灯8亮就弹键8，灯3、7、10同时亮就同时按对应键。
以下是给演奏者看的编号，代码中的 key0 对应标号1，key24对应标号25：

```text
 1   2   3   4   5
 6   7   8   9  10
11  12  13  14  15
16  17  18  19  20
21  22  23  24  25
```

如果琴键也是5×5，建议灯板与琴键方向一致；如果琴键是一字排列，灯板放在旁边配同号标签，
但需要目光查找对应键，直观程度不如把灯装在各个琴键下面。不要把5×5整板直接裁成灯条。
灯表示当前曲谱目标，现有逻辑没有“提前几拍预告”和“等待弹对再继续”。
青色仅表示目标键与触摸键同时成立，不是音准检测或教学评分。

## 电脑版从哪里打开

使用 `delivery-realtime-score/windows-guide/TangNeonStudio/TangNeonStudio.exe`，左下角版本 **1.4.2**。
保留整个TangNeonStudio目录和其中的 `_internal`。

1. 连接FPGA，进入“曲谱”页，选择内置曲谱或25键映射曲谱。
2. 回到“演奏”页，在底部播放按钮旁点击“灯光指引”。所选曲谱需要上传时会先完整上传。
3. 状态回传确认后按钮亮起，SESSION显示GUIDE；FPGA按节奏点亮目标灯，自己弹实体琴键发声。
4. 再点“灯光指引”停止提示。点“全部停止”可停止整体演奏。

未接设备可进入“离线演示”检查按钮和流程；演示不点亮真实灯板，也不是完整5×5教学画面。
板上已有完整主工程的指引链路时，本次恢复按钮不要求重新下载 `.fs`。
440Hz测试位流不具备这条链路；具体当前板上程序仍应核对。

## 信号链

```text
FPGA A15（CST: guide_led_data，底板 J13-14）
        ↓ 3.3V逻辑
74AHCT125 输入
        ↓ 5V逻辑
74AHCT125 输出 ── 330Ω ── 灯板 DIN
```

另外连接：

- 灯板 `5V` 接独立、稳定的 5V 电源；25 颗全亮时按灯板规格预留电流，不能从 FPGA GPIO 取电。
- FPGA、74AHCT125、灯板电源必须共地。
- 74AHCT125 的 VCC 接 5V，输入侧接 FPGA 的 3.3V；不要把 5V 直接送回 FPGA 引脚。
- 使用的通道 `/OE` 接低电平使能，VCC/GND近端加0.1µF去耦。模块版按其接口说明连接。
- 灯板入口 `5V/GND` 并联约 470–1000µF 电解电容，DIN 串 220–470Ω 电阻；电容正负极不能接反。
- 按灯板箭头从 `DIN` 进入，`DOUT` 是向下一块灯板的输出；只有一块 5×5 时，DOUT 悬空即可。

工程约束已经把 `guide_led_data` 定位到 FPGA 球位 A15，对应底板 J13 第14脚。J13-11 的 5V 不作为灯板大电流电源，优先使用独立 5V 供电。

74AHCT125的使能、电源和引脚依据[TI数据手册](https://www.ti.com/lit/ds/symlink/sn74ahct125.pdf)。
上述接法仅适用于确认型号的兼容灯板；若实物是多针行列扫描矩阵而不是WS2812，不能套用。

## FPGA 内部已经做了什么

`performance_controller` 产生 25 位 `guide_mask`，每一位代表一个逻辑琴键。`ws2812_guide.v` 把它串成 25 个像素的 GRB 数据帧：

- 当前曲谱要按的键：绿色；
- 触摸键当前按下：蓝色；
- 两者同时成立：青色；
- 其余灯：熄灭。

串行帧通过 `guide_led_data` 输出，RTL 已包含 WS2812 的时序、帧快照和复位低电平。当前 FPGA 工程不需要增加 25 根引脚。

## 5×5 排列校准

灯珠在板上的几何位置，和 DIN 经过的像素顺序可能不同。工程参数 `GUIDE_PIXEL_KEY_MAP` 是“像素编号 → 琴键编号”的排列，默认是 0 到 24 直序。5×5 灯板常见的蛇形走线例子如下，假设逻辑琴键按从左到右、从上到下编号：

```text
逻辑琴键布局：
 0  1  2  3  4
 5  6  7  8  9
10 11 12 13 14
15 16 17 18 19
20 21 22 23 24

蛇形 DIN 像素对应的琴键顺序：
 0, 1, 2, 3, 4,
 9, 8, 7, 6, 5,
10,11,12,13,14,
19,18,17,16,15,
20,21,22,23,24
```

这只是常见示例，不能直接假定适合购买的灯板。实际校准步骤：

1. 在上位机“曲谱 → 导入曲谱JSON”打开 `hardware/led25/calibration-25.json`，再在演奏页点“灯光指引”。它包含50条事件，每键亮800ms，键间隔200ms。
2. 观察亮的是 5×5 的哪一个位置，记录“逻辑键 → 实际像素”。
3. 把记录结果写入 `GUIDE_PIXEL_KEY_MAP`，重新综合并生成 `.fs`。
4. 再跑一遍 25 个键，确认每个位置唯一、顺序正确，没有镜像或上下颠倒。

`ws2812_guide.v` 在仿真中会检查这个表必须是 0–24 的完整排列；重复编号或越界会直接报错。

## 软件使用限制

桌面端“灯光指引”按钮发送原有的 guide start/stop 命令，FPGA 静音运行曲谱指引，指引本身不发声。使用 25 键映射曲谱或板上内置曲谱；直接音高曲谱不提供逐键指引，因为它没有 25 键映射。

“静音”是指指引模块不替你弹奏，实体琴键仍可正常演奏。开始前关闭其他播放和录制。
蓝牙实时长曲谱也暂不提供该指引，不能把任意128音高强行对应到25颗灯。

## 本次代码结构

- `desktop/web/guide-control.js`：指引业务，确认状态、准备所选曲谱、启停、取消检查和格式限制。
- `desktop/web/app.js` / `index.html`：按钮、状态显示和与上传模块的连接。
- `desktop/tests/test_guide_ui.cjs`：真实浏览器界面加协议模拟器测试。
- `rtl/performance/performance_controller.v`：既有曲谱定时与目标键掩码，未修改。
- `rtl/performance/ws2812_guide.v`：既有灯珠顺序映射和串行输出，未修改。
- `hardware/led25/calibration-25.json`：既有逐键校准曲谱。

本次未新增HDL，不新增FPGA资源需求；没有重新综合，因此不据此宣称整机时序或现场灯效通过。

灯板接好后先低亮度测试。若灯全亮、颜色错乱或随机闪烁，优先检查 DIN/DOUT方向、独立 5V 电源、共地、74AHCT125 方向和入口电容，再检查像素排列表。

本说明只覆盖 RTL 和接线方案；灯板实际型号、电源电流、现场电平和整曲指引仍需上板实测。
