wujijun11/git/TangMega60K_Synth/docs/当前工程状态-20261023.md

# 当前工程状态：2026-10-23

为减少现场飞线，新增[外设转接底板第一版](../hardware/interconnect_backplane/README.md)，把 J13、C3、三块 MPR121、AHCT125/LED 电源接口统一到一块被动底板上。

完整入口为 `full/ContestFull.gprj`，顶层 `board_contest_full_top`。25 键触摸、64 声部音源、I2S、曲谱、LED 和远程协议都保留在完整工程中。电脑端为 [Tang Neon Studio 1.0.4](../desktop/README.md)，蓝牙板为 [ESP32-C3-Zero 桥接固件](../firmware/ble_bridge/README.md)。

## 源码与实机状态

| 项目 | 当前状态 |
| --- | --- |
| 主工程源码 | 完整构建通过，对应 UserCode `8FE0`；Setup/Hold 违规均为 0 |
| 实板当前 SRAM | 被动 UART 观察版完整主工程 `3B9F`，读回编号一致；GAO 配置 ID `5544` |
| FPGA 非易失 Flash | 本次没有写入；SRAM 下载不代表断电后保留 |
| C3 生产固件 | 已写入应用分区并独立校验，保留 RX6/TX7 接法 |
| 电脑软件 | 1.0.4 已构建；源码、构建脚本和协议测试随仓库提供 |
| BLE → FPGA 握手 | 尚未验收通过；此前 C3 报告收到并提交 UART 查询，但没有收到 FPGA 返回字节 |
| 最近现场状态 | C3 USB 与蓝牙广播均离线，无法完成发送后的片内对照采样 |

生产固件修复了蓝牙写回调中的数据覆盖、跨会话回调和延迟断连的连接归属问题；FPGA 修复截断帧头后的同步恢复；电脑控制器补充命令队列边界、停止/断开时的音符释放和可选 C3 只读诊断。上述软件验证不能代替实际硬件握手。

C3 宿主生命周期 62 项、所用 SDK 接收路径 60 项、电脑原生传输与诊断专项各 11 项及诊断界面 3 个场景已有通过记录。发布记录保留测试范围与待完成事项，不能解释为整机全部通过。

## 串口接线

| ESP32-C3 | FPGA NEO Dock |
| --- | --- |
| GPIO7 / UART TX | J13-7 / A14 / UART RX |
| GPIO6 / UART RX | J13-8 / A13 / UART TX |
| GND | J13-12 / GND |

串口为 115200、8N1、3.3V。C3 的 USB 串口当前只供日志使用；FPGA DEBUG USB 用于下载与片内分析。协议连接需返回同序号 ACK 并完成状态同步，软件才显示 FPGA 已连接。

## 构建与诊断

1. 在工程目录用 GOWIN 运行 `scripts/build-contest-full.tcl`，或使用 `scripts/build-contest-isolated.py` 生成独立完整快照；工具与 Python 依赖按各脚本说明配置。
2. C3 使用 `scripts/build-ble-bridge.ps1`，要求 Arduino-ESP32 3.3.5、微雪 ESP32-C3-Zero 目标和仓库中的 `firmware/libraries/BridgeBLE`，不要退回全局未修补的 BLE 库。
3. Windows 软件使用 `desktop/build.ps1`；移动端源码仍在 `mobile/`，本轮没有重新宣称发布新的 APK。
4. [UART 被动观测说明](../verification/uart-live-debug-20261023/README-observation.md)附完整源码副本、等价仿真、GAO 解码器及实机基线。`observation-source/` 与生产主源分开；该副本没有生成诊断 ACK，也没有改变外部引脚或琴键功能。

一次 READBACK 正常应收到 16 字节请求、接受 1 条命令，再发出 ACK 加遥测共 32 字节。当前只有发送前的空闲基线，不能据此判定物理串口已经导通。若重启或重新下载，必须重新采集基线。

GitHub 保存源码、ROM、精选原始报告与校验值。完整编译缓存、波形、安装器、设备 Flash/NVS 备份、私人订单、账号数据库及个人 EDA 恢复资料留在本机。历史琴键/滑条原生工程保留仓库已脱敏副本；AHCT 只采用已检查账号归属为空的精选设计交付。
