wujijun11/git/TangMega60K_Synth/docs/31005接口映射核对-20261017.md

# 31005接口映射核对

核对日期：2026-10-17。本文是原理图和当前CST之间的离线网名核对，不是现场导通、电压或功能测试记录。

## 核对方法与适用范围

用户此前照片显示底板编号为31005，工程器件为Tang Mega 60K。31005本地原理图的标题是138K Dock，因此不能将其中的138K球位直接套用给60K。本次依次核对：

1. 当前 `full/contest_full.cst` 的60K封装球位。
2. 60K核心30354原理图第1页中，该球位到C2399连接器的实际脚号；随后用30353原理图第1页复核同12路。
3. 31005底板原理图第7页中，与C2399配对的J1同号触点所连接的底板网名。
4. 31005底板原理图第19页中，该底板网名到J13的脚号。

以下结论适用于这组原理图对应的硬件连接。装配前仍须在实物确认底板编号、J13/J9丝印、pin1方向、排针安装和供电；本文没有证明现场硬件与原理图完全一致。不得按照片左右关系猜孔号。

30353与30354两份本地60K核心原理图第1页的这12路球位到C2399触点映射相同。这里只比较本表所需连接，不据此宣称两个核心版本的全部电路一致。

## 完整信号链

MPR①/②/③分别对应RTL索引0/1/2。核心连接器C2399与底板连接器J1列出的是接触点脚号，不是外部杜邦线接口。

| 当前CST信号 | 60K球位 | 核心C2399／底板J1接触点 | 31005底板网名 | 外部接口 |
| --- | --- | ---: | --- | --- |
| `mpr_scl[0]`，MPR① SCL | E14 | 65 | SDRAM0_D0 | J13-1 |
| `mpr_sda[0]`，MPR① SDA | E13 | 67 | SDRAM0_D1 | J13-2 |
| `mpr_scl[1]`，MPR② SCL | C15 | 59 | SDRAM0_D2 | J13-3 |
| `mpr_sda[1]`，MPR② SDA | C14 | 61 | SDRAM0_D3 | J13-4 |
| `mpr_scl[2]`，MPR③ SCL | B13 | 53 | SDRAM0_D4 | J13-5 |
| `mpr_sda[2]`，MPR③ SDA | C13 | 55 | SDRAM0_D5 | J13-6 |
| `uart_rx`，FPGA接收 | A14 | 47 | SDRAM0_D6 | J13-7 |
| `uart_tx`，FPGA发送 | A13 | 49 | SDRAM0_D7 | J13-8 |
| `mpr_irq_n[0]`，MPR① IRQ | B16 | 41 | SDRAM0_D15 | J13-9 |
| `mpr_irq_n[1]`，MPR② IRQ | B15 | 43 | SDRAM0_D14 | J13-10 |
| `mpr_irq_n[2]`，MPR③ IRQ | A16 | 35 | SDRAM0_D13 | J13-13 |
| `guide_led_data`，外部灯控 | A15 | 37 | SDRAM0_D12 | J13-14 |

当前CST将这些外设信号声明为3.3V LVCMOS。声明不是电压测量结果；接外设前仍应确认现场供电和连接位置。LED信号经5V供电的74AHCT125转换后再进入灯板DIN，不把5V送入FPGA GPIO。

## 供电与地

31005原理图第19页明确：

| 接口 | 网名／作用 | 装配说明 |
| --- | --- | --- |
| J13-11 | `5V_Peripheral` | 是5V，不能接MPR的3.3V脚。外接LED独立供电方案不使用此脚承担灯板电流。 |
| J13-12 | GND | 可作为外设公共地，再经可靠分线连接需要共地的设备。 |
| PMOD0 J9-1、J9-2 | `+3V3` | 原理图上的3.3V取电位置，可经可靠分线供给三块MPR。 |
| PMOD0 J9-3、J9-4 | GND | PMOD0地，可选作MPR地线连接。 |
| PMOD1 J8-1、J8-2 | `+3V3` | 同样是3.3V，但既有DAC使用J8，优先保留已验证的DAC接线。 |

**J13没有默认直接引出的3.3V电源脚。** J13-29为`SDRAM0_EXIO0`，默认经R68连接`SDRAM0_DM0`；接3.3V的R69在原图打叉不装。J13-30为`SDRAM0_EXIO1`，默认经R70连接`SDRAM0_DM1`；接地的R71在原图打叉不装。因此不能把J13-29/30当成3.3V/GND使用。

J9上的一个触点不能硬塞多根杜邦线。需要给三块MPR分电时，使用面包板电源排、可靠分线端子或焊接分线，并先断电操作。J13与SDRAM0共享接口，不可同时装SDRAM扩展模块。

## 原始资料与校验

图片由既存本地原理图渲染，2026-10-17复制到 `hardware/wiring31005/`，复制后SHA256一致。没有重绘或改变原图网名。

其中30353第1页在本次复核中使用本机Poppler重新渲染，保存在同一证据目录；其余三张为既有图片逐字节复制。

| 文件 | 来源与页码 | SHA256 |
| --- | --- | --- |
| [core30354_p1.png](../hardware/wiring31005/core30354_p1.png) | `tang_mega_60k_30354_schematics..pdf` 第1/7页；标题Sipeed_TANG_MEGA_60K，Rev 1.0，2025-06-27 | `f66fd9e02771a23d5e1cb9df8885ad5fed5c6e2eb12116d9a21110a66634615f` |
| [core30353_p1.png](../hardware/wiring31005/core30353_p1.png) | `tang_mega_60k_30353_schematics.pdf` 第1/7页；同表12路的独立复核 | `30a62bf783dad884bda29e1eb1dc1ac24b5377aedecaa264cfda13037c81a0b8` |
| [neo31005_p7.png](../hardware/wiring31005/neo31005_p7.png) | `Tang_Mega_NEO_Dock-138K_31005_Schematics.pdf` 第7/21页；页内Rev 1.3，2024-10-15 | `86296ce5c15ab6350c6487bbb172d2a942fb6f540823d1ad678c6520c25080b5` |
| [neo31005_p19.png](../hardware/wiring31005/neo31005_p19.png) | 同一31005 PDF 第19/21页；页内Rev 1.3，2024-10-15 | `b9b5018f9c4a4dcd6aa80d230a1e8922bba0ead226152a09f4a78076f8d20168` |

原始PDF存于工作区 `C:/Users/asus/Desktop/Git/tmp/hardware_read_20260920/`，没有在本文范围内复制大型PDF。31005 PDF封面标Rev 1.4（2025-02-08），与所引用第7、19页内的Rev 1.3分别记录，不混称成同一页版本。

| 其他核对输入 | SHA256 |
| --- | --- |
| `tang_mega_60k_30354_schematics..pdf` | `e457547f08ca37250b27ccfd4c8e29e3ce44cf309b24324623932fd2626002be` |
| `tang_mega_60k_30353_schematics.pdf` | `f9a1a01862fe8c48cb5461e88f84d61e37d03f2d032e0baee7ef03fb951f6157` |
| `Tang_Mega_NEO_Dock-138K_31005_Schematics.pdf` | `ade025e2c30b23d9fa820346cabd5ee3f90e6b9bfbc083d48bc691e1d3977d1e` |
| `full/contest_full.cst` | `57f9e07e34f38c81e6f1d1b4e9b44eebddae7481f28afd06942076c44fa8dd6c` |

核对完成的是12路信号及原理图供电位置。现场导通、电源极性／电压、传感器及LED/蓝牙实测均未由本记录完成。生产RTL、CST、SDC和下载产物未修改。
