wujijun11/git/TangMega60K_Synth/docs/全功能首次上板步骤-20261011.md

# 全功能工程首次上板与到货验收

本说明对应 `full/ContestFull.gprj` / `board_contest_full_top`，以及2026-10-11生成的位流、APK与ESP32-C3蓝牙桥固件。完整工程已经通过仿真、布局布线和时序检查，APK和蓝牙固件均已实际编译，尚未完成实物验收。官网要求与现有证据见 [全功能工程与官网验收](全功能工程与官网验收-20261011.md)。

本次优化位流已通过DEBUG USB下载SRAM，J13空着，原DAC／功放保留。恢复完整主工程后，用户已报告KEY0播放／停止／重播、KEY2复位后重新播放、KEY1停止乐曲及退出引导后重播通过。声音有音高变化但偏轻，曲调与音质尚未验收。最新结果见[主工程板上复测](hardware/主工程板上复测-20261011.md)，完整下载历史见[实物记录](../verification/contest-full-20261011/hardware-tests.json)；完整外设验收仍未完成。以下步骤用于重新下载和到货验收。

早期手机视频未识别出预期旋律，之后使用[独立单音诊断](发声异常与单音诊断-20261011.md)排查。后续自动诊断已由用户报告音高变化及控制正常，随后通过Gowin Programmer GUI恢复 `ContestFull.fs`。当前板上为完整主工程，用户码再次读回 `0x0000F0A6`；完整主工程的KEY1为静音指引模式切换，与诊断版停止键行为不同。

## 下载前核对

1. 核对手中Tang Mega 60K底板的编号、版本、接口pin1。新J13约束依据31004 Rev1.4；早前照片有31005字样，必须按实际原理图或断电导通测量核对。完整接线表在上述验收说明。
2. MPR121使用3.3V供电、3.3V I²C上拉和公共GND。J13-11为5V，不能接模块3.3V脚。板载KEY接口为1.5V，不能用它们接3.3V外设。
3. PCM5102A保留已试听的PMOD1连接：BCLK=Y21、LRCLK=AB21、DATA=AA20。功放保持原来已验证的5V供电和喇叭输出连接。
4. 接线时断开供电，核对无短路后恢复供电。将功放音量先调低，再进行试听。
5. 在GOWIN Programmer选择对应GW5AT-60B器件，先将 `release/contest-full-optimized-20261011/ContestFull.fs` 下载到SRAM。SRAM配置断电后丢失。以实际下载成功状态为准，不能把文件生成当作下载成功。

## 不接触摸模块的基础检查

KEY0启动/停止内置《欢乐颂》。KEY1启动/停止脱机LED指引；指引模式本身不会自动发声。KEY2复位静音。完整工程的按键行为与旧板载按键A4/和弦测试不同。先根据实际板上丝印或已确认的KEY接法识别按键，不把PWR开关当KEY0。

没有MPR模块时，传感器离线状态是预期结果；不能仅凭RGB灯颜色认定音频故障。记录曲谱是否能够开始、停止、再次开始，复位是否静音。若不发声，先用旧的已试听入口作对照，再检查下载状态、DAC供电及功放音量。

## 三块MPR与琴键、滑条

三块模块使用独立SCL/SDA/IRQ，地址均为0x5A。序号在本说明从1开始；RTL数组从0开始。

| 实物模块 | RTL索引 | 接线 | 启用数量 | 默认音符 |
| --- | --- | --- | --- | --- |
| 第1块 | 0 | 琴键J1 pin1～8→ELE0～7；滑条J4 pin1～4→ELE8～11 | 12 | MIDI60～67 |
| 第2块 | 1 | 琴键J2 pin1～8→ELE0～7 | 8 | MIDI68～75 |
| 第3块 | 2 | 琴键J3 pin1～9→ELE0～8 | 9 | MIDI76～84 |

琴键和滑条接口都是敏感电极，不接供电或FPGA GPIO。滑条接第1块模块，不接第2块。电极线尽量短并固定，避开I²S时钟、功放和喇叭线。装配图分别见 [琴键接线](../hardware/touch25/assembly_wiring_zh.md) 和 [滑条接线](../hardware/slider4/README.md)。

上电时保持无人触摸，等待模块配置读回及基线校准。先逐个验收第1块的八键，确认按下有声、保持不重触发、松开无卡音；再加第2/3块和跨模块和弦。25键默认从C4到C6。触摸键当前力度固定100，不能用来测真实按压力度。

滑条左端/中点/右端分别检查负弯音/接近零/正弯音，默认范围±200音分，松手回中。位置和阈值须按最终覆盖膜、线束、安装方式校准，数字仿真不替代轻触及抗功放干扰测试。

## 手机和蓝牙桥

将 `TangSynthRemote-debug.apk` 传到支持Android APK的鸿蒙4/EMUI手机并安装，按系统提示允许蓝牙权限。没有蓝牙模块时，可以选择“协议模拟（无硬件）”查看控制页；模拟不会使真实板子发声。

ESP32-C3桥固件已编译成功，文件位于 `firmware/ble_bridge/output/`。拿到模块后，先核对所购开发板的GPIO6/7、闪存容量及供电，再选择对应固件和烧录方式。默认桥GPIO7 TX→FPGA UART RX，桥GPIO6 RX←FPGA UART TX，共地、3.3V逻辑。桥只搬运控制包，音频仍由FPGA生成。固件构建方法见 [蓝牙桥说明](../firmware/ble_bridge/README.md)。

手机连接名称 `Tang-Synth-C3`。先“读取FPGA状态”，再逐个测试按下/松开、四音色、直通/延迟/混响/合唱、增益/弯音/颤音。“全部停止 / Panic”应静音；保持触摸的键要松开再按才重新触发。切换到后台或关闭蓝牙后验证手机声部释放，物理键和曲谱应保留各自控制关系。

曲谱上传先完成所有行和提交，再播放。开始/停止录音后“回传录音”并导出JSON；记录的是演奏事件，不是PCM音频。物理琴键事件可在板内回放，手机事件可导出但不支持该板内回放入口。用户曲谱与录制保存在片内RAM，断电丢失。

## LED与HDMI

25灯WS2812按琴键顺序安装，数据从已核对的A15接口经74AHCT125等合适的单向3.3→5V电平转换进入DIN；灯条使用独立5V电源并共地。先验收首灯方向和灯数，再验收KEY1的脱机曲谱指引、曲谱停止后的熄灯。琴键PCB自身不含LED。

HDMI接支持640×480时序的显示器。检查波形随发声变化、左右声道XY图，以及频率分析柱随音高变化。内置64频点显示覆盖46.875～3000Hz，不代替完整外部频谱仪。

## 验收记录

| 项目 | 通过条件 | 实物结果 |
| --- | --- | --- |
| 板载播放控制 | KEY0播放／停止／重播；KEY2复位恢复；KEY1停止并退出后KEY0可重播 | 完整主工程复测由用户报告通过；有音高变化但声音偏轻，曲调与音质待确认 |
| 25单键 | 对应MIDI60～84；保持、松开、快速连击无卡音 | 待填写 |
| 和弦与故障 | 跨模块同时演奏；单模块离线只释放该模块 | 待填写 |
| 滑条 | 左/中/右单调；松手回中；与选音可独立操作 | 待填写 |
| 四音色/三表情/三音效 | 实际输出可区分，切换及紧急停止有效 | 待填写 |
| 脱机LED曲谱 | 无手机可运行，灯号与25键对应 | 待填写 |
| 手机联动 | 状态读回、重映射、上传、导出、断线释放 | 待填写 |
| 64声部 | 活跃数读回64，并用外部频谱验证同时可闻独立音高 | 待填写 |
| HDMI | 三视图随演奏变化，复位后恢复 | 待填写 |
| 总延迟 | 示波器/逻辑分析仪测控制到DAC输出，记录最坏值和波动 | 待填写 |

MPR最短滤波和轮询相位使物理响应有可变等待。当前方案尚不能承诺≤10ms基础指标，也不能承诺≤5ms及无抖动扩展指标；测量结果决定是否需要调整输入硬件。万用表可检查供电和断电导通，不能验证这两个延迟指标。
