wujijun11/git/TangMega60K_Synth/docs/音频引擎V2验证记录.md

# V2 音频引擎验证记录

验证日期：2026-09-17。基线：队长提交 `166f043`。分支：`feature/liujiakun-audio-v2`。

用户确认尚未编写旧音源，因此本次是新增实现，不是对某个既有 DDS 算法进行逐位迁移。公共队长 RTL 和接口文档未修改。

## 1. 实际运行环境与复现

- Windows PowerShell，ModelSim SE-64 10.6e。
- GOWIN V1.9.12 x64，器件 GW5AT-LV60PG484AC1/I0。
- ROM 和算法采样率 48 kHz；I2S 联调使用约 49.152 MHz 时钟、BCLK_HALF_DIV=8，每音频帧预算 1024 个系统时钟。

从 TangMega60K_Synth 目录运行：

```powershell
# 新增音源的单元、4 声部、64 声部、I2S 闭环，以及导出样本分析
./scripts/test-audio.ps1 -ModelSimBin 'C:/modelsim/modeltech64_10.6e/win64'

# 原队长工程六组回归
./scripts/test.ps1 -ModelSimBin 'C:/modelsim/modeltech64_10.6e/win64'

# 分别综合旁路和开启延迟的顶层
& 'C:/Gowin/Gowin_V1.9.12_x64/IDE/bin/gw_sh.exe' scripts/synth-audio.tcl
& 'C:/Gowin/Gowin_V1.9.12_x64/IDE/bin/gw_sh.exe' scripts/synth-audio-fx.tcl
```

本次确实执行了上述验证；不是仅提供脚本。新增仿真每次使用新临时目录编译，不复用旧 work。仿真检查每个 testbench 的 test_passed 标志和退出码，PowerShell 再检查各组完成标志和导出 PCM。参数或断言不通过会使脚本失败。

## 2. 4 声部与 64 声部分开验收

| 项目 | 4 声部实例 | 64 声部实例 |
|---|---:|---:|
| ModelSim 结果 | PASS | PASS |
| 输出样本总数 | 81,188 | 81,366 |
| begin 提交沿至 FX_SEND 的最大周期数 | 45 | 585 |
| 中性参数与固定中性参考逐位相等 | 9,804 帧 | 9,804 帧 |
| 满载分配、拒绝额外音符 | 4/4 | 64/64 |
| 同时释放、done 反压后回收 | 4/4 | 64/64 |
| 额外两次独立尾音测试后累计 done | 6 | 66 |

参考实例是同一新核心的 EXPRESSION_ENABLE=0 固定中性路径，不是历史旧音源。此比较可以发现 V2 中性参数造成的额外幅度或音高改变，但不能替代对全部算法的独立数学验证；下面另有频率、频谱、单位算术和时序断言。

两种声部数均覆盖：

- 原 cmd/done/sample 握手；同音高不同 source 的分配独立性（source 只在队长分配器中出现）。
- 每声部相位与状态独立；改频、重新触发、释放不串扰其他声部。
- begin 后下一拍读取本次提交参数；同一帧全声部使用同一份参数。
- gain、bend、vibrato 三个限速平滑器逐帧推进量核对；LFO 每帧恰好推进一次。
- sample 反压时 valid、左右样本保持，所有声部相位、LFO 和参数平滑暂停。
- 反压期间收到新表情事件，active 参数到下一次 begin 才提交。
- done 反压时负载稳定；RELEASE 到零才上报一次；gain=0 不误回收。
- 满载释放、再分配、输出受阻时复位，不残留旧声部或旧输出。

585 周期是上述计算区间的计数，不是完整按键到声音延迟，也不代表布局布线后已实现 49.152 MHz。实际连续供数另由 I2S 闭环检查。

## 3. 表情与音色的数字样本测量

4/64 两组以下测量一致；正弦为 MIDI 69、最大力度，分别等待包络/表情稳定后测量。

| 设置 | 频率测量 | 左声道 RMS（样本编码值） |
|---|---:|---:|
| gain=2048，bend=0，vibrato=0 | 440.001905 Hz | 26065.96200 |
| gain=1024，其余中性 | 439.996642 Hz | 13032.97355 |
| bend=+1200 音分，其余中性 | 879.996465 Hz | 26066.02557 |
| bend=-1200 音分，其余中性 | 219.996074 Hz | 26065.96102 |

gain 减半后幅度约减半，音高不变；±1200 音分分别产生约两倍/一半频率；gain=0 在延迟旁路下逐位静音。A4 的 32 位频率控制字为 39370534，理论量化频率 440.000005066 Hz。表中从有限长度、量化波形零交叉测出的频率有测量误差，不能把两者混为 DDS 本身的误差。

独立导出 PCM 分析（scripts/verify-audio-samples.ps1）：

| 项目 | 实际结果 | 验收限制 |
|---|---:|---|
| 正弦二次谐波/基频 | 9.60×10^-8 | <0.002 |
| 正弦三次谐波/基频 | 9.25×10^-7 | <0.002 |
| 谐波音色二次谐波/基频 | 0.49999524 | 0.5±0.005 |
| 谐波音色三次谐波/基频 | 0.24999626 | 0.25±0.005 |
| 颤音速度 | 5.003813 Hz | 5±0.05 Hz |
| 100 音分颤音的测量范围 | -101.1114～+101.1395 音分 | 两端分别距 ±100 不超过 3 音分 |

颤音深度的 PCM 估计使用相邻零交叉周期，有限测量窗口及波表量化会产生偏差；同时仿真直接核对 LFO 步进和频率控制字范围。该测量不是板上声卡或示波器实测。

pcm_4.csv、pcm_64.csv 中 segment：0 中性正弦，1 半增益，2 上弯八度，3 下弯八度，4 颤音，5 谐波音色，6 满载。left/right 是有符号整数样本，采样率 48 kHz。

## 4. 算术、包络和延迟单元测试

实际结果：AUDIO DSP UNITS PASSED。

- 增益 unity/half/zero，正负边界，正负饱和。
- 64 路同相 16 位最大正值、最小负值累加，无回绕；与各声部频率不同的系统测试分开。
- Attack 480 样本单调到顶，Decay 3840 样本到保持电平，提前释放不下溢。
- 延迟单元使用缩短的 4 样本缓冲测脉冲响应，回声在 4、8、12、16 样本出现，验证反馈 0.5、wet 0.25。
- 旁路精确透传有符号 24 位边界；复位后旧延迟历史不泄漏。

这不是对所有可取参数的穷举证明。实际 2400 样本延迟由下一组整机仿真覆盖。

## 5. 64 声部 + 延迟 + 原 I2S 的闭环

使用 audio_system_v2_delay、原 captain_system_top_v2 与原 i2s_tx，不用替代 I2S 模型。外部串行接收器检查 I2S 一位延迟、32 位槽、填充位，并逐帧比较接受的左右 PCM。

实际结果：

```text
AUDIO I2S INTEGRATION PASSED voices=64 delay=on
frames=10862 nonzero=10859
steady_underrun_delta=0 startup_underruns=1 stalls=4712617
```

64 个不同音高（MIDI 36..99），交替音色；运行中改变三项表情，再释放全部音符检查回收。4712617 为观察到的反压时钟数，不是丢样本数。

启动阶段有 1 次 underrun，是引擎初始化/填充前的空 FIFO；在 200 帧预热后统计窗口内新增 underrun 为 0。没有隐瞒启动空帧，也不把它计作稳态断流。

新增全部 ModelSim 编译/仿真结束统计：0 errors、0 warnings。原队长六组回归全部完成；其 tb_control_v2 原有 11 个未连接端口警告仍保留，没有为消除这些警告修改公共文件。

## 6. 实际高云综合资源

| 顶层 | LUT | Register | ALU | BSRAM | MULTALU27X18 | MULT27X36 |
|---|---:|---:|---:|---:|---:|---:|
| audio_system_v2（延迟旁路） | 2452 | 1879 | 288 | 22 | 3 | 3 |
| audio_system_v2_delay（延迟开启） | 2713 | 2002 | 401 | 34 | 3 | 3 |

这是队长控制/分配/I2S 加音源的完整顶层综合结果，不是音源单模块数字。DSP 列按工具原语名称报告，不能直接当成等量的 18×18 乘法器个数。两个顶层都完成综合，RTL 解析 0 警告；工具另有用户缓存 sh.log 无法打开的提示，未阻止项目综合报告生成。

证据：synth_dry.log、synth_fx.log、对应 resources.xml。没有运行布局布线，不报告不存在的 Fmax、时序裕量或上板结果。

## 7. 未完成与协议待定

- 板级 PLL/CST/复位/DAC 配置、SDC、布局布线时序收敛和上板试听尚未完成，不能直接声称达到整机硬件验收。
- V2 没有独立滑音/连奏、实时 ADSR、声像或效果器控制协议。本版实现全局弯音平滑和静态可旁路延迟；未私自扩展公共接口。
- 高音区减去过高谐波，最终基频夹到 0.45Fs；超范围大弯音会被限高。
- 音色/力度突变和波表分区切换仍可能留下听感痕迹，未做交叉淡化。合唱和混响未实现。
- 全局增益在延迟前；开启延迟时降到零仍保留逐渐衰减的回声。整机“立即静音并清除回声”需队长共同定义后级 mute/clear 语义。
- 没有用户旧音源，不能声称通过旧音源回归；中性兼容的严格定义见第 2 节。

完整模块说明及接线见《音频引擎V2实现与接线.md》。本轮只在个人分支工作，未 push、未合并 main。
