wujijun11/git/TangMega60K_Synth/docs/团队协作说明.md

# 团队协作说明

## 当前交付范围

2026-10-07 更新：板载 KEY0/KEY1 已通过 `board_key_event_adapter` 接入 B 的 `instrument_system_v2` 与 A 的八成分钢琴；新外置 I2S 演奏工程已完成仿真、布局布线及 SRAM 下载，用户反馈本轮试听“已完成”。B 的下一份交付是实体演奏面板和独立表情输入的驱动、标定、引脚表及验证；现有两键属于同一触发维度。当前接入位置和硬件验证范围见[板载按键演奏记录](hardware/板载按键演奏-20261007.md)，下方日期记录保留历史状态。

2026-09-24 更新：B 的 `interaction_top_v2`、事件 FIFO 和统一逻辑顶层 `instrument_system_v2` 已合入，连接到 A 的最新八成分钢琴音源。B 侧已覆盖普通键和和弦的按下快照、松键回放、来源编号和表情更新；实物扫描、去抖和传感器驱动仍需板级实现。标称49.152MHz音频时钟及48kHz外置I2S约束已存在于 `clock48` 工程，但尚未把这一套交互输入接到实物外设。最新范围以[队员B合并记录](队员B合并记录-20260924.md)为准，下面的早期里程碑描述保留作背景。

平台：Sipeed Tang Mega 60K。当前交付新增V2：64声部按来源管理、三维全局表情参数通道、24位立体声I2S及样本缓冲。原V1继续可用；迁移按[接口V2与队员迁移](接口V2与队员迁移.md)进行。
已包含DDS、ADSR、混音及64声部自检；64声部最终混为左右两个音频输出声道。`BoardAudioDiagnostic.gprj`已接入主音源并完成布局布线和SRAM下载，但尚未完成实物音频验收。传感器驱动、最终音频时钟及外置DAC引脚接入仍待完成。板级数字自检采用50MHz，实际采样率48,828.125Hz，不能当作已校准48kHz音频入口。

| 目录 | 内容 | 对接建议 |
| --- | --- | --- |
| `rtl/` | 可综合的 Verilog 模块 | 队长维护控制器、I2S 和集成顶层 |
| `sim/` | SystemVerilog 测试台、ModelSim 脚本 | 所有成员提交模块时附相应测试 |
| `scripts/` | 本机测试、GOWIN 综合入口 | 工具路径根据本机安装位置指定 |
| `docs/` | 接口、使用说明、验证记录 | 修改接口时同步更新 |

## 两位队员如何接入

- 音频负责人：基于已合入的逐样本合成引擎继续验证音高、音色、包络与满负载行为。输入控制命令及尾音回收接口遵循V2；向队长输出 `sample_left`、`sample_right`（24位有符号数）和 `sample_valid`，接收 `sample_ready`。
- 交互负责人：把选音、触发、松键与力度转换成控制事件，遵循ready/valid握手；V2新增source并保存松键所需的原音符列表，使用独立表情快照通道。
- 音频负责人迁移：原cmd/done/sample字段保持不变；V2新增engine_sample_begin与active参数连接。负责实现真实幅度平滑、弯音换算、颤音LFO，不能仅连端口就声明三种表情完成。
- 队长：维护接口协议和集成顶层，负责控制器、I2S、联合仿真及后续板级时钟、引脚和时序验证。

所有 ready/valid 接口都只在两者同时为 1 的时钟沿完成传输。valid 为 1 而 ready 为 0 时，发送方必须保持 valid 和负载稳定。
当前音频入口与 I2S 发送器使用同一系统时钟；跨时钟模块不得直接接入，应先设计并验证跨时钟传输。

## 获取和运行

```powershell
git clone https://github.com/wujijun11/git.git
cd git/TangMega60K_Synth
./scripts/test.ps1 -ModelSimBin 'D:/msim/modelsim_ase/win32aloem'
```

若安装在其他位置，替换 `-ModelSimBin`。脚本同时检查控制器与 I2S 测试的退出码和通过标志。
GOWIN 打开 `TangMega60K_Synth.gprj`；仿真操作见 README 和第二阶段说明。

## 提交与合并

1. 队长为队友配置仓库协作者后，队友克隆仓库；也可使用个人 fork 提交 Pull Request。
2. 从最新 main 建立自己的功能分支，例如 `feature/audio-engine` 或 `feature/input-events`。
3. 每次提交仅包含相关源文件、测试和说明；使用 `git add <具体文件>`，先查看 `git diff --staged`。
4. 推送个人分支，在 GitHub 创建 Pull Request，说明功能、接口变化、测试结果和未完成事项。
5. 队长审查并运行联合测试后合并。发生接口冲突时先协商，不直接覆盖其他成员文件。

上传前不要包含安装包、许可证、账号凭据、仿真 work 库、波形数据库、工具缓存及个人路径配置。
这些文件仍可保留在各自电脑；项目的 `.gitignore` 会排除常见生成物。
