wujijun11/git/TangMega60K_Synth/docs/模块输入输出_20261030/01-总装启动.md

# 01 总装、启动与复位

[总索引](README.md) · [先理解接口规则](接口阅读方法.md) · [全部命名连接](实例连接索引.md)

端口方向始终相对本模块。位宽中的“默认”按模块声明计算，父实例覆盖值另列；连接例为父模块局部网络名，不是板上引脚名。

## audio_boot_status

定义：[rtl/board/audio_boot_status.v:3](https://github.com/wujijun11/git/blob/codex/sustain-20261030/TangMega60K_Synth/rtl/board/audio_boot_status.v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)

用途：在50MHz域观察PLL、复位、音频心跳和传感器状态，控制板载RGB诊断色；不接入音频ready/reset控制链，不保存黑匣子历史。

时序/注意事项：50MHz域只读观察48位启动快照、音频心跳并决定RGB颜色；不向功能链输出ready/reset，也不保存历史。输入多位快照是诊断观察，不能当严格原子跨时钟数据。

源码中本模块自己的边沿触发条件：`posedge clk`。子模块还可有自己的时序。

### 编译参数（模块默认值）

下列默认值不是当前父实例一定采用的值；覆盖项见本节末尾。

| 参数 | 默认表达式 | 含义/单位 |
|---|---|---|
| `HEARTBEAT_TIMEOUT_CYCLES` | `5000000` | 计数门限/步长，单位本模块时钟周期；换算时间必须使用实际连接时钟。 |

### 输入（2个）

| 端口 | 位宽 | 数值类型 | 作用、单位及条件 | 一处实际连接例 |
|---|---|---|---|---|
| `clk` | 1位 | 无符号/位图 | 本模块工作时钟；当前完整音频链通常为49.152MHz，显示/板级模块须看各自连接。 | `board_contest_full_top.status_monitor`：`sys_clk` |
| `snapshot` | `[47:0]`；默认48位 | 无符号/位图 | 50MHz域双级采样后的48位启动诊断快照；各位来自顶层debug_status打包，不是MPR121的43字节快照。 | `board_contest_full_top.status_monitor`：`debug_status` |

### 输出（1个）

| 端口 | 位宽 | 数值类型 | 作用、单位及条件 | 一处实际连接例 |
|---|---|---|---|---|
| `status_grb` | `[23:0]`；默认24位 | 无符号/位图 | 板载RGB颜色，24位按G、R、B字节排列；不是通常书写的RGB顺序。 | `board_contest_full_top.status_monitor`：`boot_status_grb` |

### 父级实例及参数覆盖

表中包含旧入口和条件分支，列出连接不表示分支最终启用。参数未覆盖时仍使用模块默认值。

| 父模块.实例 | 显式覆盖参数 | 父模块是否在完整顶层静态关系中 |
|---|---|---|
| `board_contest_full_top.status_monitor` | 未显式覆盖 | 是（含条件分支） |

[回到总索引](README.md)

## board_bringup_top

定义：[rtl/board/board_bringup_top.v:3](https://github.com/wujijun11/git/blob/codex/sustain-20261030/TangMega60K_Synth/rtl/board/board_bringup_top.v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)

用途：底板基础按键消抖、上电等待及RGB状态编码；被完整板级顶层复用，也可独立排查板卡。

时序/注意事项：50MHz域上电等待、板载按键消抖和RGB发送。key_n为低有效原始按键，keys_pressed为高有效按住状态。

源码中本模块自己的边沿触发条件：`posedge sys_clk`。子模块还可有自己的时序。

### 编译参数（模块默认值）

下列默认值不是当前父实例一定采用的值；覆盖项见本节末尾。

| 参数 | 默认表达式 | 含义/单位 |
|---|---|---|
| `DEBOUNCE_CYCLES` | `500000` | 计数门限/步长，单位本模块时钟周期；换算时间必须使用实际连接时钟。 |
| `HALF_SECOND_CYCLES` | `25000000` | 计数门限/步长，单位本模块时钟周期；换算时间必须使用实际连接时钟。 |
| `STATUS_MODE` | `0` | 板载RGB显示状态选择，依模块已有分支解释。 |

### 输入（3个）

| 端口 | 位宽 | 数值类型 | 作用、单位及条件 | 一处实际连接例 |
|---|---|---|---|---|
| `sys_clk` | 1位 | 无符号/位图 | 板载50MHz参考时钟输入，不是48kHz采样脉冲。 | `board_contest_full_top.board`：`sys_clk` |
| `key_n` | `[2:0]`；默认3位 | 无符号/位图 | 板载按键原始低有效输入，key_n[0..2]经消抖后使用。 | `board_contest_full_top.board`：`key_n` |
| `status_grb` | `[23:0]`；默认24位 | 无符号/位图 | 板载RGB颜色，24位按G、R、B字节排列；不是通常书写的RGB顺序。 | `board_contest_full_top.board`：`selected_status_grb` |

### 输出（4个）

| 端口 | 位宽 | 数值类型 | 作用、单位及条件 | 一处实际连接例 |
|---|---|---|---|---|
| `rgb_data` | 1位 | 无符号/位图；声明初值=`0` | 板载可寻址RGB灯的串行控制输出。 | `board_contest_full_top.board`：`rgb_data` |
| `pa_disable` | 1位 | 无符号/位图 | 板载功放禁止控制；不是外接PAM8403的USB供电。 | `board_contest_full_top.board`：`pa_disable` |
| `board_ready` | 1位 | 无符号/位图 | 板级上电等待和基础初始化完成指示。 | `board_contest_full_top.board`：`board_ready` |
| `keys_pressed` | `[2:0]`；默认3位 | 无符号/位图 | 消抖/同步后的板载按键按住位图，1表示按下。 | `board_contest_full_top.board`：`pressed_50` |

### 父级实例及参数覆盖

表中包含旧入口和条件分支，列出连接不表示分支最终启用。参数未覆盖时仍使用模块默认值。

| 父模块.实例 | 显式覆盖参数 | 父模块是否在完整顶层静态关系中 |
|---|---|---|
| `board_contest_full_top.board` | `DEBOUNCE_CYCLES=DEBOUNCE_CYCLES`；`STATUS_MODE=1` | 是（含条件分支） |
| `board_audio_16_48k_i2s_top.u_board` | `DEBOUNCE_CYCLES=DEBOUNCE_CYCLES` | 否/备用入口 |
| `board_audio_48k_gao_top.u_board` | `STATUS_MODE=1` | 否/备用入口 |
| `board_audio_48k_i2s_top.u_board` | `DEBOUNCE_CYCLES=DEBOUNCE_CYCLES` | 否/备用入口 |
| `board_audio_diagnostic_top.u_board` | `DEBOUNCE_CYCLES=DEBOUNCE_CYCLES`；`STATUS_MODE=1` | 否/备用入口 |
| `board_audio_gao_top.u_board` | `STATUS_MODE=1` | 否/备用入口 |
| `board_instrument_b_48k_gao_top.u_board` | `DEBOUNCE_CYCLES=DEBOUNCE_CYCLES`；`STATUS_MODE=1` | 否/备用入口 |
| `board_instrument_b_48k_i2s_top.u_board` | `DEBOUNCE_CYCLES=DEBOUNCE_CYCLES` | 否/备用入口 |
| `board_sequence16_48k_i2s_top.u_board` | `DEBOUNCE_CYCLES=DEBOUNCE_CYCLES` | 否/备用入口 |

[回到总索引](README.md)

## board_contest_full_top

定义：[rtl/board/board_contest_full_top.v:4](https://github.com/wujijun11/git/blob/codex/sustain-20261030/TangMega60K_Synth/rtl/board/board_contest_full_top.v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)

用途：当前物理板级顶层：连接50MHz输入、音频PLL、复位、实体引脚、HDMI、OLED和完整内部系统。

时序/注意事项：物理板级顶层。sys_clk为50MHz；内部音频49.152MHz、视频25/125MHz。端口能否外接以CST和板卡丝印为准。多数子模块端口仅为FPGA内部连线。

源码中本模块自己的边沿触发条件：`posedge audio_clk`；`posedge audio_clk or negedge audio_locked`；`posedge audio_clk or negedge rst_n`；`posedge pixel_clk or negedge video_locked`；`posedge sys_clk`。子模块还可有自己的时序。

### 编译参数（模块默认值）

下列默认值不是当前父实例一定采用的值；覆盖项见本节末尾。

| 参数 | 默认表达式 | 含义/单位 |
|---|---|---|
| `DEBOUNCE_CYCLES` | `100000` | 计数门限/步长，单位本模块时钟周期；换算时间必须使用实际连接时钟。 |
| `SLIDER_VOLUME_ENABLE` | `1` | 功能/接口选择参数，通常0关闭、1开启；不是运行时按钮。 |
| `MENU_HIERARCHY_ENABLE` | `1` | 功能/接口选择参数，通常0关闭、1开启；不是运行时按钮。 |
| `STABLE_CHORD_MIX_ENABLE` | `1` | 完整工程固定增益和弦方案选择开关，当前为1。 |
| `EARLY_KEY_ENABLE` | `1` | 功能/接口选择参数，通常0关闭、1开启；不是运行时按钮。 |
| `SUSTAIN_ENABLE` | `1` | 功能/接口选择参数，通常0关闭、1开启；不是运行时按钮。 |
| `BOOT_DIAGNOSTIC` | `1` | 板载RGB使用启动/PLL/心跳诊断色的编译参数，不是运行时菜单。 |
| `OLED_ENABLE` | `1` | 功能/接口选择参数，通常0关闭、1开启；不是运行时按钮。 |
| `OLED_I2C_HZ` | `100000` | 频率配置，单位Hz；用于计数/分频换算。 |
| `OLED_ADDRESS` | `7'h3c` | 7位I2C从机地址，不含读写位。 |
| `OLED_POWER_WAIT_CYCLES` | `4915200` | 计数门限/步长，单位本模块时钟周期；换算时间必须使用实际连接时钟。 |
| `OLED_FRAME_WAIT_CYCLES` | `1966080` | 计数门限/步长，单位本模块时钟周期；换算时间必须使用实际连接时钟。 |
| `OLED_WAVE_ENABLE` | `1` | 功能/接口选择参数，通常0关闭、1开启；不是运行时按钮。 |
| `OLED_WAVE_IDLE_CYCLES` | `491520000` | 计数门限/步长，单位本模块时钟周期；换算时间必须使用实际连接时钟。 |
| `GUIDE_BRIGHTNESS` | `8'd32` | 灯珠亮度8位刻度0..255，增大前须核对供电余量。 |
| `GUIDE_TOUCH_BRIGHTNESS` | `8'd16` | 灯珠亮度8位刻度0..255，增大前须核对供电余量。 |
| `GUIDE_PIXEL_KEY_MAP` | `{5'd24,5'd23,5'd22,5'd21,5'd20, 5'd19,5'd18,5'd17,5'd16,5'd15,5'd14,5'd13,5'd12,5'd11,5'd10, 5'd9,5'd8,5'd7,5'd6,5'd5,5'd4,5'd3,5'd2,5'd1,5'd0}` | 完整顶层传给灯板驱动的灯号到键号映射。 |

### 输入（4个）

| 端口 | 位宽 | 数值类型 | 作用、单位及条件 | 一处实际连接例 |
|---|---|---|---|---|
| `sys_clk` | 1位 | 无符号/位图 | 板载50MHz参考时钟输入，不是48kHz采样脉冲。 | 本清单无父实例命名接线；见独立工程或外部顶层。 |
| `key_n` | `[2:0]`；默认3位 | 无符号/位图 | 板载按键原始低有效输入，key_n[0..2]经消抖后使用。 | 本清单无父实例命名接线；见独立工程或外部顶层。 |
| `mpr_irq_n` | `[2:0]`；默认3位 | 无符号/位图 | 三块MPR121的低有效IRQ输入，按位对应模块0、1、2。 | 本清单无父实例命名接线；见独立工程或外部顶层。 |
| `uart_rx` | 1位 | 无符号/位图 | FPGA接收C3发来的UART位流。 | 本清单无父实例命名接线；见独立工程或外部顶层。 |

### 输出（12个）

| 端口 | 位宽 | 数值类型 | 作用、单位及条件 | 一处实际连接例 |
|---|---|---|---|---|
| `uart_tx` | 1位 | 无符号/位图 | FPGA向C3发送UART位流。 | 本清单无父实例命名接线；见独立工程或外部顶层。 |
| `rgb_data` | 1位 | 无符号/位图 | 板载可寻址RGB灯的串行控制输出。 | 本清单无父实例命名接线；见独立工程或外部顶层。 |
| `pa_disable` | 1位 | 无符号/位图 | 板载功放禁止控制；不是外接PAM8403的USB供电。 | 本清单无父实例命名接线；见独立工程或外部顶层。 |
| `i2s_bclk` | 1位 | 无符号/位图 | I2S位时钟输出；当前48kHz×64=3.072MHz。 | 本清单无父实例命名接线；见独立工程或外部顶层。 |
| `i2s_lrclk` | 1位 | 无符号/位图 | I2S左右声道选择/帧时钟输出，当前48kHz。 | 本清单无父实例命名接线；见独立工程或外部顶层。 |
| `i2s_data` | 1位 | 无符号/位图 | 标准Philips I2S串行数据，左右各24有效位、各32位槽。 | 本清单无父实例命名接线；见独立工程或外部顶层。 |
| `guide_led_data` | 1位 | 无符号/位图 | 外部5×5可寻址灯板的数据输出，需按既定电平转换和供电接线。 | 本清单无父实例命名接线；见独立工程或外部顶层。 |
| `tmds_clk_p` | 1位 | 无符号/位图 | HDMI TMDS时钟差分对正端。 | 本清单无父实例命名接线；见独立工程或外部顶层。 |
| `tmds_clk_n` | 1位 | 无符号/位图 | HDMI TMDS时钟差分对负端。 | 本清单无父实例命名接线；见独立工程或外部顶层。 |
| `tmds_data_p` | `[2:0]`；默认3位 | 无符号/位图 | 三路HDMI TMDS数据差分对正端。 | 本清单无父实例命名接线；见独立工程或外部顶层。 |
| `tmds_data_n` | `[2:0]`；默认3位 | 无符号/位图 | 三路HDMI TMDS数据差分对负端。 | 本清单无父实例命名接线；见独立工程或外部顶层。 |
| `hdmi_enable` | 1位 | 无符号/位图 | HDMI接口使能控制。 | 本清单无父实例命名接线；见独立工程或外部顶层。 |

### 双向（4个）

| 端口 | 位宽 | 数值类型 | 作用、单位及条件 | 一处实际连接例 |
|---|---|---|---|---|
| `mpr_scl` | `[2:0]`；默认3位 | 无符号/位图 | 三路相互独立的MPR121 I2C时钟线。 | 本清单无父实例命名接线；见独立工程或外部顶层。 |
| `mpr_sda` | `[2:0]`；默认3位 | 无符号/位图 | 三路相互独立的MPR121 I2C数据线。 | 本清单无父实例命名接线；见独立工程或外部顶层。 |
| `oled_scl` | 1位 | 无符号/位图 | OLED独立I2C时钟线，与MPR121三路总线分开。 | 本清单无父实例命名接线；见独立工程或外部顶层。 |
| `oled_sda` | 1位 | 无符号/位图 | OLED独立I2C数据线，与MPR121三路总线分开。 | 本清单无父实例命名接线；见独立工程或外部顶层。 |

[回到总索引](README.md)

## board_local_actions

定义：[rtl/board/board_contest_full_top.v:180](https://github.com/wujijun11/git/blob/codex/sustain-20261030/TangMega60K_Synth/rtl/board/board_contest_full_top.v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)

用途：当前物理板级顶层：连接50MHz输入、音频PLL、复位、实体引脚、HDMI、OLED和完整内部系统。

时序/注意事项：KEY0控制内置曲谱发声，KEY1控制离线指引；模式切换可能先停止并等待旧音释放。动作必须保持到local_action_ready。KEY2复位在板级父模块处理。

源码中本模块自己的边沿触发条件：`posedge clk or negedge rst_n`。子模块还可有自己的时序。

### 输入（6个）

| 端口 | 位宽 | 数值类型 | 作用、单位及条件 | 一处实际连接例 |
|---|---|---|---|---|
| `clk` | 1位 | 无符号/位图 | 本模块工作时钟；当前完整音频链通常为49.152MHz，显示/板级模块须看各自连接。 | `board_contest_full_top.local_actions`：`audio_clk` |
| `rst_n` | 1位 | 无符号/位图 | 低有效复位：0复位、1运行；同步/异步方式见本模块触发条件。 | `board_contest_full_top.local_actions`：`rst_n` |
| `keys_pressed` | `[1:0]`；默认2位 | 无符号/位图 | 消抖/同步后的板载按键按住位图，1表示按下。 | `board_contest_full_top.local_actions`：`pressed_sync[1:0]` |
| `playing` | 1位 | 无符号/位图 | 曲谱或回放业务正在播放，不等于所有声部均空闲/发声。 | `board_contest_full_top.local_actions`：`playing` |
| `guide` | 1位 | 无符号/位图 | 灯光指引业务状态，用于板级/显示观察。 | `board_contest_full_top.local_actions`：`guide` |
| `local_action_ready` | 1位 | 无符号/位图 | 本地动作接收许可；不是发送完成或全系统就绪。与同组valid同时为1才完成一次传输。 | `board_contest_full_top.local_actions`：`local_ready` |

### 输出（2个）

| 端口 | 位宽 | 数值类型 | 作用、单位及条件 | 一处实际连接例 |
|---|---|---|---|---|
| `local_action_valid` | 1位 | 无符号/位图 | 本地动作有效指示；标准流接口与同组ready在同一时钟边沿同时为1才接收。无ready的观察脉冲另见时序说明。 | `board_contest_full_top.local_actions`：`local_valid` |
| `local_action` | `[7:0]`；默认8位 | 无符号/位图 | 本地按键/菜单发出的曲谱控制动作编号。 | `board_contest_full_top.local_actions`：`action` |

### 父级实例及参数覆盖

表中包含旧入口和条件分支，列出连接不表示分支最终启用。参数未覆盖时仍使用模块默认值。

| 父模块.实例 | 显式覆盖参数 | 父模块是否在完整顶层静态关系中 |
|---|---|---|
| `board_contest_full_top.local_actions` | 未显式覆盖 | 是（含条件分支） |

[回到总索引](README.md)

## instrument_full_system

定义：[rtl/instrument_full_system.v:3](https://github.com/wujijun11/git/blob/codex/sustain-20261030/TangMega60K_Synth/rtl/instrument_full_system.v#L3)

用途：完整系统的内部接线中心，连接传感器、菜单、远程命令、录放、64声部、音效和显示观察端口；不负责板卡物理引脚。

时序/注意事项：完整逻辑系统。音频/通信/触摸/菜单使用clk，视频观察使用video_clk。公共event/cmd/done/sample协议未增加source字段。

源码中本模块自己的边沿触发条件：`posedge clk or negedge audio_rst_n`；`posedge clk or negedge rst_n`；`posedge video_clk or negedge audio_rst_n`。子模块还可有自己的时序。

### 编译参数（模块默认值）

下列默认值不是当前父实例一定采用的值；覆盖项见本节末尾。

| 参数 | 默认表达式 | 含义/单位 |
|---|---|---|
| `CLK_HZ` | `49152000` | 本模块工作时钟频率，单位Hz；用于换算计数周期，不创建新时钟。 |
| `UART_BAUD` | `115200` | FPGA与C3 UART波特率，单位bit/s。 |
| `SENSOR_SETTLE_CYCLES` | `CLK_HZ/20` | 计数门限/步长，单位本模块时钟周期；换算时间必须使用实际连接时钟。 |
| `MENU_ENABLE` | `1` | 功能/接口选择参数，通常0关闭、1开启；不是运行时按钮。 |
| `MENU_DEBOUNCE_CYCLES` | `CLK_HZ/50` | 计数门限/步长，单位本模块时钟周期；换算时间必须使用实际连接时钟。 |
| `MENU_LONG_PRESS_CYCLES` | `CLK_HZ` | 计数门限/步长，单位本模块时钟周期；换算时间必须使用实际连接时钟。 |
| `MENU_ROOT_IDLE_CYCLES` | `CLK_HZ*5` | 计数门限/步长，单位本模块时钟周期；换算时间必须使用实际连接时钟。 |
| `SLIDER_VOLUME_ENABLE` | `0` | 功能/接口选择参数，通常0关闭、1开启；不是运行时按钮。 |
| `HIERARCHICAL_MENU_ENABLE` | `0` | 功能/接口选择参数，通常0关闭、1开启；不是运行时按钮。 |
| `MENU_WAVE_IDLE_CYCLES` | `CLK_HZ*10` | 计数门限/步长，单位本模块时钟周期；换算时间必须使用实际连接时钟。 |
| `STABLE_CHORD_MIX_ENABLE` | `0` | 完整工程固定增益和弦方案选择开关，当前为1。 |
| `EARLY_KEY_ENABLE` | `0` | 功能/接口选择参数，通常0关闭、1开启；不是运行时按钮。 |
| `SUSTAIN_ENABLE` | `0` | 功能/接口选择参数，通常0关闭、1开启；不是运行时按钮。 |
| `ROM_DIR` | `"rtl/audio/rom/"` | 离线ROM/字模/系数文件路径；不是运行时播放的音频文件。 |
| `GUIDE_BRIGHTNESS` | `8'd32` | 灯珠亮度8位刻度0..255，增大前须核对供电余量。 |
| `GUIDE_TOUCH_BRIGHTNESS` | `8'd16` | 灯珠亮度8位刻度0..255，增大前须核对供电余量。 |
| `GUIDE_PIXEL_KEY_MAP` | `{5'd24,5'd23,5'd22,5'd21,5'd20, 5'd19,5'd18,5'd17,5'd16,5'd15,5'd14,5'd13,5'd12,5'd11,5'd10, 5'd9,5'd8,5'd7,5'd6,5'd5,5'd4,5'd3,5'd2,5'd1,5'd0}` | 完整顶层传给灯板驱动的灯号到键号映射。 |

### 输入（10个）

| 端口 | 位宽 | 数值类型 | 作用、单位及条件 | 一处实际连接例 |
|---|---|---|---|---|
| `clk` | 1位 | 无符号/位图 | 本模块工作时钟；当前完整音频链通常为49.152MHz，显示/板级模块须看各自连接。 | `board_contest_full_top.system`：`audio_clk` |
| `rst_n` | 1位 | 无符号/位图 | 低有效复位：0复位、1运行；同步/异步方式见本模块触发条件。 | `board_contest_full_top.system`：`rst_n` |
| `uart_rx` | 1位 | 无符号/位图 | FPGA接收C3发来的UART位流。 | `board_contest_full_top.system`：`uart_rx` |
| `mpr_irq_n` | `[2:0]`；默认3位 | 无符号/位图 | 三块MPR121的低有效IRQ输入，按位对应模块0、1、2。 | `board_contest_full_top.system`：`mpr_irq_n` |
| `local_action_valid` | 1位 | 无符号/位图 | 本地动作有效指示；标准流接口与同组ready在同一时钟边沿同时为1才接收。无ready的观察脉冲另见时序说明。 | `board_contest_full_top.system`：`local_valid` |
| `local_action` | `[7:0]`；默认8位 | 无符号/位图 | 本地按键/菜单发出的曲谱控制动作编号。 | `board_contest_full_top.system`：`action` |
| `video_clk` | 1位 | 无符号/位图 | 视频观察/绘图使用的像素时钟。 | `board_contest_full_top.system`：`pixel_clk` |
| `video_x` | `[9:0]`；默认10位 | 无符号/位图 | 提供给内部绘图器的像素横坐标。 | `board_contest_full_top.system`：`x` |
| `video_y` | `[9:0]`；默认10位 | 无符号/位图 | 提供给内部绘图器的像素纵坐标。 | `board_contest_full_top.system`：`y` |
| `video_de` | 1位 | 无符号/位图 | 内部绘图器有效显示区指示。 | `board_contest_full_top.system`：`de` |

### 输出（44个）

| 端口 | 位宽 | 数值类型 | 作用、单位及条件 | 一处实际连接例 |
|---|---|---|---|---|
| `uart_tx` | 1位 | 无符号/位图 | FPGA向C3发送UART位流。 | `board_contest_full_top.system`：`uart_tx` |
| `local_action_ready` | 1位 | 无符号/位图 | 本地动作接收许可；不是发送完成或全系统就绪。与同组valid同时为1才完成一次传输。 | `board_contest_full_top.system`：`local_ready` |
| `i2s_bclk` | 1位 | 无符号/位图 | I2S位时钟输出；当前48kHz×64=3.072MHz。 | `board_contest_full_top.system`：`i2s_bclk` |
| `i2s_lrclk` | 1位 | 无符号/位图 | I2S左右声道选择/帧时钟输出，当前48kHz。 | `board_contest_full_top.system`：`i2s_lrclk` |
| `i2s_data` | 1位 | 无符号/位图 | 标准Philips I2S串行数据，左右各24有效位、各32位槽。 | `board_contest_full_top.system`：`i2s_data` |
| `guide_led_data` | 1位 | 无符号/位图 | 外部5×5可寻址灯板的数据输出，需按既定电平转换和供电接线。 | `board_contest_full_top.system`：`guide_led_data` |
| `active_count` | `[6:0]`；默认7位 | 无符号/位图 | 已分配声部数，包含仍按住、延音保留及尚未回收的释放尾音；当前最多64。 | `board_contest_full_top.system`：`voices` |
| `touch_mask` | `[24:0]`；默认25位 | 无符号/位图 | 25个实体琴键的触摸状态位图，bit i=1表示第i键按住。 | `board_contest_full_top.system`：`debug_touch` |
| `guide_mask` | `[24:0]`；默认25位 | 无符号/位图 | 当前需要提示的25键目标位图，灯板按映射显示。 | 本清单无父实例命名接线；见独立工程或外部顶层。 |
| `sensor_ready` | `[2:0]`；默认3位 | 无符号/位图 | 三块MPR121初始化就绪位图。 | `board_contest_full_top.system`：`sensor_ready` |
| `sensor_fault` | `[2:0]`；默认3位 | 无符号/位图 | 三块MPR121故障位图。 | `board_contest_full_top.system`：`sensor_fault` |
| `underrun_count` | `[31:0]`；默认32位 | 无符号/位图 | 累计I2S欠载次数；启动静音与真实欠载需按实现区分。 | `board_contest_full_top.system`：`underruns` |
| `overflow_sticky` | 1位 | 无符号/位图 | 发生溢出后保持的历史标志，复位或规定清除动作后清零。 | `board_contest_full_top.system`：`overflow` |
| `playing` | 1位 | 无符号/位图 | 曲谱或回放业务正在播放，不等于所有声部均空闲/发声。 | `board_contest_full_top.system`：`playing` |
| `recording` | 1位 | 无符号/位图 | 正在记录演奏音符事件；不是录制PCM声音。 | `board_contest_full_top.system`：`recording` |
| `guide_active` | 1位 | 无符号/位图 | 曲谱灯光指引或等候学习业务正在运行。 | `board_contest_full_top.system`：`guide` |
| `video_rgb` | `[23:0]`；默认24位 | 无符号/位图 | 内部绘图器生成的RGB像素。 | `board_contest_full_top.system`：`rgb` |
| `monitor_left` | `[23:0]`；默认24位 | 有符号补码 | 用于观察的左声道PCM。 | 本清单无父实例命名接线；见独立工程或外部顶层。 |
| `monitor_right` | `[23:0]`；默认24位 | 有符号补码 | 用于观察的右声道PCM。 | 本清单无父实例命名接线；见独立工程或外部顶层。 |
| `monitor_valid` | 1位 | 无符号/位图 | 观察抽头样本有效指示，不允许显示拖住音频。 | 本清单无父实例命名接线；见独立工程或外部顶层。 |
| `debug_last_note` | `[6:0]`；默认7位 | 无符号/位图 | 最近一次音源接受的NoteOn音高编号。 | `board_contest_full_top.system`：`debug_note` |
| `debug_transmit_left` | `[23:0]`；默认24位 | 有符号补码 | 传给显示观察的实际I2S左声道PCM，不是移位中的串行寄存器。 | `board_contest_full_top.system`：`debug_transmit_left` |
| `debug_audio_reset_status` | `[3:0]`；默认4位 | 无符号/位图 | 音频启动/复位链的打包诊断状态，具体位定义见接线。 | `board_contest_full_top.system`：`debug_audio_reset_status` |
| `menu_main` | 1位 | 无符号/位图 | 当前导航处于主菜单的观察信号。 | `board_contest_full_top.system`：`menu_main` |
| `menu_page` | `[1:0]`；默认2位 | 无符号/位图 | 旧四类业务页编号或兼容菜单页编码；分层页面另看view。 | `board_contest_full_top.system`：`menu_page` |
| `menu_zone` | `[1:0]`；默认2位 | 无符号/位图 | 当前滑条区域0..3。 | `board_contest_full_top.system`：`menu_zone` |
| `menu_timbre` | `[1:0]`；默认2位 | 无符号/位图 | 菜单选择的音色编号。 | 本清单无父实例命名接线；见独立工程或外部顶层。 |
| `menu_transpose` | `[6:0]`；默认7位 | 有符号补码 | 菜单选择的音区移调，单位半音。 | 本清单无父实例命名接线；见独立工程或外部顶层。 |
| `menu_busy` | 1位 | 无符号/位图 | 当前菜单动作正在执行。 | `board_contest_full_top.system`：`menu_busy` |
| `menu_error` | `[7:0]`；默认8位 | 无符号/位图 | 供OLED/远程模式状态观察的菜单错误码。 | `board_contest_full_top.system`：`menu_error` |
| `menu_record_count` | `[15:0]`；默认16位 | 无符号/位图 | 供菜单显示的已录事件条数。 | `board_contest_full_top.system`：`menu_record_count` |
| `menu_prompt_valid` | 1位 | 无符号/位图 | 请求生成一次短提示音的脉冲，不是传输录音。 | 本清单无父实例命名接线；见独立工程或外部顶层。 |
| `menu_prompt_code` | `[1:0]`；默认2位 | 无符号/位图 | 短提示音类别编号，控制数学合成提示的音高/模式。 | 本清单无父实例命名接线；见独立工程或外部顶层。 |
| `menu_volume_mode` | 1位 | 无符号/位图 | 当前滑条处于连续控制界面/兼容音量模式。 | `board_contest_full_top.system`：`menu_volume_mode` |
| `menu_volume_percent` | `[7:0]`；默认8位 | 无符号/位图 | 实际已提交总增益换算的显示百分比0..100。 | `board_contest_full_top.system`：`menu_volume_percent` |
| `menu_touch_active` | 1位 | 无符号/位图 | 原始滑条有效触摸状态，供显示层观察。 | `board_contest_full_top.system`：`menu_touch_active` |
| `menu_view` | `[3:0]`；默认4位 | 无符号/位图 | 完整系统对外观察的分层页面编号。 | `board_contest_full_top.system`：`menu_view` |
| `menu_expression_mode` | `[1:0]`；默认2位 | 无符号/位图 | 滑条当前连续表情类型：0音量、1弯音、2颤音。 | `board_contest_full_top.system`：`menu_expression_mode` |
| `menu_waveform_view` | 1位 | 无符号/位图 | 菜单策略要求显示空闲/设置后的波形界面。 | `board_contest_full_top.system`：`menu_waveform_view` |
| `menu_control_value` | `[11:0]`；默认12位 | 无符号/位图 | 当前显示参数的数值：音量百分比、弯音绝对音分或颤音深度音分。 | `board_contest_full_top.system`：`menu_control_value` |
| `menu_control_negative` | 1位 | 无符号/位图 | 当前显示参数为负值的标志，主要用于弯音。 | `board_contest_full_top.system`：`menu_control_negative` |
| `menu_control_percent` | `[7:0]`；默认8位 | 无符号/位图 | 当前连续参数换算为0..100的显示条位置，弯音中点为50。 | `board_contest_full_top.system`：`menu_control_percent` |
| `sustain_enabled` | 1位 | 无符号/位图 | 实际延音开关：1暂缓松键OFF，0开始释放已松开的保留声部。 | `board_contest_full_top.system`：`sustain_enabled` |
| `sustain_deferred_count` | `[6:0]`；默认7位 | 无符号/位图 | 完整系统对外观察的延音保留声部数。 | `board_contest_full_top.system`：`未连接()` |

### 双向（2个）

| 端口 | 位宽 | 数值类型 | 作用、单位及条件 | 一处实际连接例 |
|---|---|---|---|---|
| `mpr_scl` | `[2:0]`；默认3位 | 无符号/位图 | 三路相互独立的MPR121 I2C时钟线。 | `board_contest_full_top.system`：`mpr_scl` |
| `mpr_sda` | `[2:0]`；默认3位 | 无符号/位图 | 三路相互独立的MPR121 I2C数据线。 | `board_contest_full_top.system`：`mpr_sda` |

### 父级实例及参数覆盖

表中包含旧入口和条件分支，列出连接不表示分支最终启用。参数未覆盖时仍使用模块默认值。

| 父模块.实例 | 显式覆盖参数 | 父模块是否在完整顶层静态关系中 |
|---|---|---|
| `board_contest_full_top.system` | `SLIDER_VOLUME_ENABLE=SLIDER_VOLUME_ENABLE`；`HIERARCHICAL_MENU_ENABLE=MENU_HIERARCHY_ENABLE`；`MENU_WAVE_IDLE_CYCLES=OLED_WAVE_IDLE_CYCLES`；`STABLE_CHORD_MIX_ENABLE=STABLE_CHORD_MIX_ENABLE`；`EARLY_KEY_ENABLE=EARLY_KEY_ENABLE`；`SUSTAIN_ENABLE=SUSTAIN_ENABLE`；`MENU_ROOT_IDLE_CYCLES=OLED_ENABLE && OLED_WAVE_ENABLE ? 0 : 245760000`；`GUIDE_BRIGHTNESS=GUIDE_BRIGHTNESS`；`GUIDE_TOUCH_BRIGHTNESS=GUIDE_TOUCH_BRIGHTNESS`；`GUIDE_PIXEL_KEY_MAP=GUIDE_PIXEL_KEY_MAP` | 是（含条件分支） |

[回到总索引](README.md)
