wujijun11/git/TangMega60K_Synth/docs/模块输入输出_20261030/03-触摸驱动.md

# 03 触摸采集与硬件驱动

[总索引](README.md) · [先理解接口规则](接口阅读方法.md) · [全部命名连接](实例连接索引.md)

端口方向始终相对本模块。位宽中的“默认”按模块声明计算，父实例覆盖值另列；连接例为父模块局部网络名，不是板上引脚名。

## i2c_register_master

定义：[rtl/sensors/i2c_register_master.v:3](https://github.com/wujijun11/git/blob/codex/sustain-20261030/TangMega60K_Synth/rtl/sensors/i2c_register_master.v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)

用途：开漏I²C寄存器读写底层，含超时/总线恢复；供MPR121采集使用，不与OLED共用同一总线状态机。

时序/注意事项：cmd握手启动一次寄存器事务，忙时不接新事务。读取字节通过rdata_valid脉冲输出，没有rdata_ready；done标志整次事务结束，error说明结果。SCL/SDA只拉低或高阻释放。

源码中本模块自己的边沿触发条件：`posedge clk`。子模块还可有自己的时序。

### 编译参数（模块默认值）

下列默认值不是当前父实例一定采用的值；覆盖项见本节末尾。

| 参数 | 默认表达式 | 含义/单位 |
|---|---|---|
| `CLK_HZ` | `49152000` | 本模块工作时钟频率，单位Hz；用于换算计数周期，不创建新时钟。 |
| `I2C_HZ` | `400000` | 频率配置，单位Hz；用于计数/分频换算。 |
| `TIMEOUT_CYCLES` | `CLK_HZ/200` | 计数门限/步长，单位本模块时钟周期；换算时间必须使用实际连接时钟。 |

### 输入（8个）

| 端口 | 位宽 | 数值类型 | 作用、单位及条件 | 一处实际连接例 |
|---|---|---|---|---|
| `clk` | 1位 | 无符号/位图 | 本模块工作时钟；当前完整音频链通常为49.152MHz，显示/板级模块须看各自连接。 | `mpr121_sampler.bus`：`clk` |
| `resetn` | 1位 | 无符号/位图 | 低有效复位：0复位、1运行；不是触摸状态。 | `mpr121_sampler.bus`：`resetn` |
| `cmd_valid` | 1位 | 无符号/位图 | 命令有效指示；标准流接口与同组ready在同一时钟边沿同时为1才接收。无ready的观察脉冲另见时序说明。 | `mpr121_sampler.bus`：`cmd_valid` |
| `cmd_read` | 1位 | 无符号/位图 | I2C事务方向：1读寄存器、0写寄存器。 | `mpr121_sampler.bus`：`cmd_read` |
| `cmd_addr` | `[6:0]`；默认7位 | 无符号/位图 | I2C从设备7位地址；0x3C等不要写成包含读写位的0x78。 | `mpr121_sampler.bus`：`I2C_ADDR` |
| `cmd_reg` | `[7:0]`；默认8位 | 无符号/位图 | I2C目标寄存器地址。 | `mpr121_sampler.bus`：`(state==POLL)?8'h00:cfg_addr(cfg_index)` |
| `cmd_wdata` | `[7:0]`；默认8位 | 无符号/位图 | I2C寄存器写入的8位数据。 | `mpr121_sampler.bus`：`cfg_data(cfg_index)` |
| `cmd_len` | `[5:0]`；默认6位 | 无符号/位图 | I2C连续读取的字节数，受模块范围约束。 | `mpr121_sampler.bus`：`(state==POLL)?6'd43:6'd1` |

### 输出（7个）

| 端口 | 位宽 | 数值类型 | 作用、单位及条件 | 一处实际连接例 |
|---|---|---|---|---|
| `cmd_ready` | 1位 | 无符号/位图 | 命令接收许可；不是发送完成或全系统就绪。与同组valid同时为1才完成一次传输。 | `mpr121_sampler.bus`：`bus_ready` |
| `busy` | 1位 | 无符号/位图 | 当前模块或受观察任务正在处理；含义随模块而异，不等于系统死机。 | `mpr121_sampler.bus`：`bus_busy` |
| `done` | 1位 | 无符号/位图 | 当前事务完成指示；不要与V2声部回收done_valid混淆。 | `mpr121_sampler.bus`：`bus_done` |
| `error` | `[2:0]`；默认3位 | 无符号/位图 | 本模块错误码；位宽和编码由模块决定，不能直接当电压/音量。 | `mpr121_sampler.bus`：`bus_error` |
| `rdata_valid` | 1位 | 无符号/位图 | 一个I2C读取字节有效的脉冲，无字节级ready。 | `mpr121_sampler.bus`：`rx_valid` |
| `rdata` | `[7:0]`；默认8位 | 无符号/位图 | I2C本次读到的8位数据。 | `mpr121_sampler.bus`：`rx_data` |
| `rindex` | `[5:0]`；默认6位 | 无符号/位图 | 当前I2C读取字节在本次连续读取中的索引。 | `mpr121_sampler.bus`：`rx_index` |

### 双向（2个）

| 端口 | 位宽 | 数值类型 | 作用、单位及条件 | 一处实际连接例 |
|---|---|---|---|---|
| `scl` | 1位 | 无符号/位图 | I2C时钟双向开漏线：主动拉低或高阻释放，由上拉形成高电平。 | `mpr121_sampler.bus`：`scl` |
| `sda` | 1位 | 无符号/位图 | I2C数据双向开漏线：主动拉低或高阻释放，由上拉形成高电平。 | `mpr121_sampler.bus`：`sda` |

### 父级实例及参数覆盖

表中包含旧入口和条件分支，列出连接不表示分支最终启用。参数未覆盖时仍使用模块默认值。

| 父模块.实例 | 显式覆盖参数 | 父模块是否在完整顶层静态关系中 |
|---|---|---|
| `mpr121_sampler.bus` | `CLK_HZ=CLK_HZ`；`I2C_HZ=I2C_HZ`；`TIMEOUT_CYCLES=TIMEOUT_CYCLES` | 是（含条件分支） |

[回到总索引](README.md)

## mpr121_input_frontend

定义：[rtl/sensors/mpr121_input_frontend.v:3](https://github.com/wujijun11/git/blob/codex/sustain-20261030/TangMega60K_Synth/rtl/sensors/mpr121_input_frontend.v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)

用途：组织三片MPR121采样、25键和四电极滑条，向上层报告有效触摸与故障。

时序/注意事项：三条独立I2C总线并行采集。key事件与expr_update分别握手；ready/fault为三块芯片状态位图。第一块ELE8..11作为滑条，快键通道与完整滑条快照分开。

本模块未解析到自己的posedge/negedge always块；可能是组合计算或连接子模块的包装，不能仅因没有此类块就断言所有内部功能均为组合。

### 编译参数（模块默认值）

下列默认值不是当前父实例一定采用的值；覆盖项见本节末尾。

| 参数 | 默认表达式 | 含义/单位 |
|---|---|---|
| `CLK_HZ` | `49152000` | 本模块工作时钟频率，单位Hz；用于换算计数周期，不创建新时钟。 |
| `I2C_HZ` | `400000` | 频率配置，单位Hz；用于计数/分频换算。 |
| `TIMEOUT_CYCLES` | `CLK_HZ/200` | 计数门限/步长，单位本模块时钟周期；换算时间必须使用实际连接时钟。 |
| `POLL_CYCLES` | `CLK_HZ/2000` | 计数门限/步长，单位本模块时钟周期；换算时间必须使用实际连接时钟。 |
| `RESET_CYCLES` | `CLK_HZ/1000` | 计数门限/步长，单位本模块时钟周期；换算时间必须使用实际连接时钟。 |
| `SETTLE_CYCLES` | `CLK_HZ/20` | 计数门限/步长，单位本模块时钟周期；换算时间必须使用实际连接时钟。 |
| `RETRY_CYCLES` | `CLK_HZ/10` | 计数门限/步长，单位本模块时钟周期；换算时间必须使用实际连接时钟。 |
| `CALIBRATION_SNAPSHOTS` | `3` | 初始化校准所需连续完整快照数量。 |
| `MAX_RETRIES` | `2` | 允许重试的最大次数。 |
| `ADDR0` | `7'h5a` | 7位I2C从机地址，不含读写位。 |
| `ADDR1` | `7'h5a` | 7位I2C从机地址，不含读写位。 |
| `ADDR2` | `7'h5a` | 7位I2C从机地址，不含读写位。 |
| `SOURCE_BASE` | `25` | 按键/自检来源编号基址，须避免与其他来源冲突。 |
| `EVENT_FIFO_DEPTH` | `64` | 缓存/队列容量，单位条或存储项，具体随模块。 |
| `EARLY_KEY_ENABLE` | `0` | 功能/接口选择参数，通常0关闭、1开启；不是运行时按钮。 |
| `TOUCH_THRESHOLD` | `12` | MPR121触摸阈值寄存器数值，不是伏特。 |
| `RELEASE_THRESHOLD` | `6` | MPR121释放阈值寄存器数值，不是伏特。 |
| `FILTER_CDC` | `8'h10` | MPR121采样/充电电流相关寄存器配置编码。 |
| `FILTER_CDT` | `8'h20` | MPR121采样/充电时间相关寄存器配置编码。 |
| `SLIDER_NOISE0` | `4` | 滑条电极噪声门限，单位采样差分刻度。 |
| `SLIDER_NOISE1` | `4` | 滑条电极噪声门限，单位采样差分刻度。 |
| `SLIDER_NOISE2` | `4` | 滑条电极噪声门限，单位采样差分刻度。 |
| `SLIDER_NOISE3` | `4` | 滑条电极噪声门限，单位采样差分刻度。 |
| `SLIDER_GAIN0` | `256` | 滑条电极校准增益，当前256对应1倍。 |
| `SLIDER_GAIN1` | `256` | 滑条电极校准增益，当前256对应1倍。 |
| `SLIDER_GAIN2` | `256` | 滑条电极校准增益，当前256对应1倍。 |
| `SLIDER_GAIN3` | `256` | 滑条电极校准增益，当前256对应1倍。 |
| `SLIDER_MIN_WEIGHT` | `12` | 传给滑条采集器的标定配置，单位同对应位置/权重参数。 |
| `SLIDER_POSITION_MIN` | `0` | 传给滑条采集器的标定配置，单位同对应位置/权重参数。 |
| `SLIDER_POSITION_MAX` | `3072` | 传给滑条采集器的标定配置，单位同对应位置/权重参数。 |
| `SLIDER_BEND_MAX` | `200` | 弯音/迟滞/死区范围，单位音分，100音分=1半音。 |
| `SLIDER_BEND_ENABLE` | `1` | 功能/接口选择参数，通常0关闭、1开启；不是运行时按钮。 |

### 输入（7个）

| 端口 | 位宽 | 数值类型 | 作用、单位及条件 | 一处实际连接例 |
|---|---|---|---|---|
| `clk` | 1位 | 无符号/位图 | 本模块工作时钟；当前完整音频链通常为49.152MHz，显示/板级模块须看各自连接。 | `instrument_full_system.sensors`：`clk` |
| `resetn` | 1位 | 无符号/位图 | 低有效复位：0复位、1运行；不是触摸状态。 | `instrument_full_system.sensors`：`rst_n` |
| `irq_n` | `[2:0]`；默认3位 | 无符号/位图 | MPR121低有效中断请求；不是音频数据线。 | `instrument_full_system.sensors`：`irq_sync` |
| `key_map_flat` | `[174:0]`；默认175位 | 无符号/位图 | 25个实体键的MIDI音高映射，25×7=175位，键i使用[i*7 +:7]。 | `instrument_full_system.sensors`：`mapping` |
| `current_timbre` | `[1:0]`；默认2位 | 无符号/位图 | 当前选定音色编号，用于新产生音符。 | `instrument_full_system.sensors`：`timbre` |
| `key_ready` | 1位 | 无符号/位图 | 触摸琴键事件接收许可；不是发送完成或全系统就绪。与同组valid同时为1才完成一次传输。 | `instrument_full_system.sensors`：`sensor_er` |
| `expr_update_ready` | 1位 | 无符号/位图 | 增量表情参数接收许可；不是发送完成或全系统就绪。与同组valid同时为1才完成一次传输。 | `instrument_full_system.sensors`：`slider_xr` |

### 输出（23个）

| 端口 | 位宽 | 数值类型 | 作用、单位及条件 | 一处实际连接例 |
|---|---|---|---|---|
| `key_valid` | 1位 | 无符号/位图 | 触摸琴键事件有效指示；标准流接口与同组ready在同一时钟边沿同时为1才接收。无ready的观察脉冲另见时序说明。 | `instrument_full_system.sensors`：`sensor_ev` |
| `key_on` | 1位 | 无符号/位图 | 触摸琴键事件开关，1按下/触发、0松开/释放。 | `instrument_full_system.sensors`：`sensor_on` |
| `key_source` | `[5:0]`；默认6位 | 无符号/位图 | 触摸琴键事件来源所有权编号，当前6位；用于同音不同来源的正确松键，不直接改变音色。 | `instrument_full_system.sensors`：`sensor_source` |
| `key_note` | `[6:0]`；默认7位 | 无符号/位图 | 触摸琴键事件MIDI音高编号0..127，不是频率Hz。 | `instrument_full_system.sensors`：`sensor_note` |
| `key_velocity` | `[6:0]`；默认7位 | 无符号/位图 | 触摸琴键事件MIDI式力度编号0..127。 | `instrument_full_system.sensors`：`sensor_velocity` |
| `key_timbre` | `[1:0]`；默认2位 | 无符号/位图 | 触摸琴键事件音色编号，当前完整音源0正弦、1风琴、2八成分钢琴、3可选FM。 | `instrument_full_system.sensors`：`sensor_timbre` |
| `expr_update_valid` | 1位 | 无符号/位图 | 增量表情参数有效指示；标准流接口与同组ready在同一时钟边沿同时为1才接收。无ready的观察脉冲另见时序说明。 | `instrument_full_system.sensors`：`slider_xv` |
| `expr_update_mask` | `[2:0]`；默认3位 | 无符号/位图 | 增量表情参数更新掩码，bit0增益、bit1弯音、bit2颤音，仅选中的字段生效。 | `instrument_full_system.sensors`：`slider_xm` |
| `expr_update_gain_q1_11` | `[11:0]`；默认12位 | 无符号/位图 | 增量表情参数无符号Q1.11增益，2048=1倍。 | `instrument_full_system.sensors`：`slider_gain` |
| `expr_update_bend_cents` | `[12:0]`；默认13位 | 有符号补码 | 增量表情参数有符号弯音，单位音分；100音分=1半音。 | `instrument_full_system.sensors`：`slider_bend` |
| `expr_update_vibrato_depth_cents` | `[7:0]`；默认8位 | 无符号/位图 | 增量表情参数颤音深度，单位音分，控制链限制0..100。 | `instrument_full_system.sensors`：`slider_vib` |
| `touch_mask` | `[24:0]`；默认25位 | 无符号/位图 | 25个实体琴键的触摸状态位图，bit i=1表示第i键按住。 | `instrument_full_system.sensors`：`touch_mask` |
| `fault` | `[2:0]`；默认3位 | 无符号/位图 | 传感器或显示驱动故障标志/逐模块位图；不会自动代表整个FPGA断电。 | `instrument_full_system.sensors`：`sensor_fault` |
| `ready` | `[2:0]`；默认3位 | 无符号/位图 | 模块初始化就绪或可工作状态；传感器中不是下游握手ready。 | `instrument_full_system.sensors`：`sensor_ready` |
| `event_overflow` | 1位 | 无符号/位图 | 触摸事件缓存出现容量不足的诊断。 | `instrument_full_system.sensors`：`sensor_overflow` |
| `pending_events` | `[15:0]`；默认16位 | 无符号/位图 | 等待输出的触摸事件数量，单位条。 | `instrument_full_system.sensors`：`sensor_pending` |
| `last_error` | `[11:0]`；默认12位 | 无符号/位图 | 最近一次驱动/业务错误码；多传感器时为打包字段。 | 本清单无父实例命名接线；见独立工程或外部顶层。 |
| `error_count` | `[95:0]`；默认96位 | 无符号/位图 | 累计错误次数；多传感器时按模块打包。 | 本清单无父实例命名接线；见独立工程或外部顶层。 |
| `last_success_age` | `[95:0]`；默认96位 | 无符号/位图 | 距最近成功采样的时钟周期数；多模块时打包多个计数。 | 本清单无父实例命名接线；见独立工程或外部顶层。 |
| `init_stage` | `[14:0]`；默认15位 | 无符号/位图 | 传感器初始化阶段编号；多模块时为打包字段。 | 本清单无父实例命名接线；见独立工程或外部顶层。 |
| `oor_status` | `[47:0]`；默认48位 | 无符号/位图 | 采集模块读出的MPR121 OOR状态位，供诊断观察；具体位含义按寄存器定义解释。 | 本清单无父实例命名接线；见独立工程或外部顶层。 |
| `slider_active` | 1位 | 无符号/位图 | 滑条当前有有效触摸。 | `instrument_full_system.sensors`：`slider_active` |
| `slider_position` | `[11:0]`；默认12位 | 无符号/位图 | 滑条位置，当前标度0..3072，由四电极权重计算。 | `instrument_full_system.sensors`：`slider_position` |

### 双向（2个）

| 端口 | 位宽 | 数值类型 | 作用、单位及条件 | 一处实际连接例 |
|---|---|---|---|---|
| `scl` | `[2:0]`；默认3位 | 无符号/位图 | I2C时钟双向开漏线：主动拉低或高阻释放，由上拉形成高电平。 | `instrument_full_system.sensors`：`mpr_scl` |
| `sda` | `[2:0]`；默认3位 | 无符号/位图 | I2C数据双向开漏线：主动拉低或高阻释放，由上拉形成高电平。 | `instrument_full_system.sensors`：`mpr_sda` |

### 父级实例及参数覆盖

表中包含旧入口和条件分支，列出连接不表示分支最终启用。参数未覆盖时仍使用模块默认值。

| 父模块.实例 | 显式覆盖参数 | 父模块是否在完整顶层静态关系中 |
|---|---|---|
| `instrument_full_system.sensors` | `CLK_HZ=CLK_HZ`；`SETTLE_CYCLES=SENSOR_SETTLE_CYCLES`；`EARLY_KEY_ENABLE=EARLY_KEY_ENABLE`；`SOURCE_BASE=25`；`SLIDER_BEND_ENABLE=!MENU_ENABLE` | 是（含条件分支） |

[回到总索引](README.md)

## mpr121_key_eventizer

定义：[rtl/sensors/mpr121_key_eventizer.v:3](https://github.com/wujijun11/git/blob/codex/sustain-20261030/TangMega60K_Synth/rtl/sensors/mpr121_key_eventizer.v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)

用途：把完整触摸快照的按下/松开变化转成有来源的演奏事件；缓存批量变化，避免和弦漏键。

时序/注意事项：逐芯片snapshot_valid/ready接收触摸位图，再序列化为key事件。为整批转移预留空间；key_valid阻塞时不丢松键。同一次持键沿用按下时的音高/音色映射。

源码中本模块自己的边沿触发条件：`posedge clk`。子模块还可有自己的时序。

### 编译参数（模块默认值）

下列默认值不是当前父实例一定采用的值；覆盖项见本节末尾。

| 参数 | 默认表达式 | 含义/单位 |
|---|---|---|
| `FIFO_DEPTH` | `64` | 缓存/队列容量，单位条或存储项，具体随模块。 |
| `SOURCE_BASE` | `25` | 按键/自检来源编号基址，须避免与其他来源冲突。 |

### 输入（10个）

| 端口 | 位宽 | 数值类型 | 作用、单位及条件 | 一处实际连接例 |
|---|---|---|---|---|
| `clk` | 1位 | 无符号/位图 | 本模块工作时钟；当前完整音频链通常为49.152MHz，显示/板级模块须看各自连接。 | `mpr121_input_frontend.eventizer`：`clk` |
| `resetn` | 1位 | 无符号/位图 | 低有效复位：0复位、1运行；不是触摸状态。 | `mpr121_input_frontend.eventizer`：`resetn` |
| `snapshot_valid` | `[2:0]`；默认3位 | 无符号/位图 | 一份或逐模块完整快照有效；与snapshot_ready配合接收。 | `mpr121_input_frontend.eventizer`：`EARLY_KEY_ENABLE?early_valid:snap_valid` |
| `touch0` | `[7:0]`；默认8位 | 无符号/位图 | 第一块触摸芯片对应的8个琴键状态。 | `mpr121_input_frontend.eventizer`：`EARLY_KEY_ENABLE?early_status[7:0]:snaps[7:0]` |
| `touch1` | `[7:0]`；默认8位 | 无符号/位图 | 第二块触摸芯片对应的8个琴键状态。 | `mpr121_input_frontend.eventizer`：`EARLY_KEY_ENABLE?early_status[12+:8]:snaps[344+:8]` |
| `touch2` | `[8:0]`；默认9位 | 无符号/位图 | 第三块触摸芯片对应的9个琴键状态。 | `mpr121_input_frontend.eventizer`：`EARLY_KEY_ENABLE?early_status[24+:9]:snaps[688+:9]` |
| `fault` | `[2:0]`；默认3位 | 无符号/位图 | 传感器或显示驱动故障标志/逐模块位图；不会自动代表整个FPGA断电。 | `mpr121_input_frontend.eventizer`：`fault` |
| `key_map_flat` | `[174:0]`；默认175位 | 无符号/位图 | 25个实体键的MIDI音高映射，25×7=175位，键i使用[i*7 +:7]。 | `mpr121_input_frontend.eventizer`：`key_map_flat` |
| `current_timbre` | `[1:0]`；默认2位 | 无符号/位图 | 当前选定音色编号，用于新产生音符。 | `mpr121_input_frontend.eventizer`：`current_timbre` |
| `key_ready` | 1位 | 无符号/位图 | 触摸琴键事件接收许可；不是发送完成或全系统就绪。与同组valid同时为1才完成一次传输。 | `mpr121_input_frontend.eventizer`：`key_ready` |

### 输出（10个）

| 端口 | 位宽 | 数值类型 | 作用、单位及条件 | 一处实际连接例 |
|---|---|---|---|---|
| `snapshot_ready` | `[2:0]`；默认3位 | 无符号/位图 | 可接收完整快照的许可，逐模块位图时每位独立对应一块芯片。 | `mpr121_input_frontend.eventizer`：`event_snapshot_ready` |
| `key_valid` | 1位 | 无符号/位图 | 触摸琴键事件有效指示；标准流接口与同组ready在同一时钟边沿同时为1才接收。无ready的观察脉冲另见时序说明。 | `mpr121_input_frontend.eventizer`：`key_valid` |
| `key_on` | 1位 | 无符号/位图 | 触摸琴键事件开关，1按下/触发、0松开/释放。 | `mpr121_input_frontend.eventizer`：`key_on` |
| `key_source` | `[5:0]`；默认6位 | 无符号/位图 | 触摸琴键事件来源所有权编号，当前6位；用于同音不同来源的正确松键，不直接改变音色。 | `mpr121_input_frontend.eventizer`：`key_source` |
| `key_note` | `[6:0]`；默认7位 | 无符号/位图 | 触摸琴键事件MIDI音高编号0..127，不是频率Hz。 | `mpr121_input_frontend.eventizer`：`key_note` |
| `key_velocity` | `[6:0]`；默认7位 | 无符号/位图 | 触摸琴键事件MIDI式力度编号0..127。 | `mpr121_input_frontend.eventizer`：`key_velocity` |
| `key_timbre` | `[1:0]`；默认2位 | 无符号/位图 | 触摸琴键事件音色编号，当前完整音源0正弦、1风琴、2八成分钢琴、3可选FM。 | `mpr121_input_frontend.eventizer`：`key_timbre` |
| `touch_mask` | `[24:0]`；默认25位 | 无符号/位图 | 25个实体琴键的触摸状态位图，bit i=1表示第i键按住。 | `mpr121_input_frontend.eventizer`：`touch_mask` |
| `overflow` | 1位 | 无符号/位图 | 模块容量/事件队列溢出指示；脉冲或保持方式见实现。 | `mpr121_input_frontend.eventizer`：`event_overflow` |
| `pending_events` | `[15:0]`；默认16位 | 无符号/位图 | 等待输出的触摸事件数量，单位条。 | `mpr121_input_frontend.eventizer`：`pending_events` |

### 父级实例及参数覆盖

表中包含旧入口和条件分支，列出连接不表示分支最终启用。参数未覆盖时仍使用模块默认值。

| 父模块.实例 | 显式覆盖参数 | 父模块是否在完整顶层静态关系中 |
|---|---|---|
| `mpr121_input_frontend.eventizer` | `FIFO_DEPTH=EVENT_FIFO_DEPTH`；`SOURCE_BASE=SOURCE_BASE` | 是（含条件分支） |

[回到总索引](README.md)

## mpr121_sampler

定义：[rtl/sensors/mpr121_sampler.v:3](https://github.com/wujijun11/git/blob/codex/sustain-20261030/TangMega60K_Synth/rtl/sensors/mpr121_sampler.v#L3)

用途：MPR121初始化、配置读回、校准等待与一致性寄存器快照，检测传感器失联并重试。

时序/注意事项：一块MPR121驱动。完整43字节快照用snapshot_valid/ready；EARLY_KEY_ENABLE时前2字节通过独立early_key口提前上报。IRQ须已在父级同步。

源码中本模块自己的边沿触发条件：`posedge clk`。子模块还可有自己的时序。

### 编译参数（模块默认值）

下列默认值不是当前父实例一定采用的值；覆盖项见本节末尾。

| 参数 | 默认表达式 | 含义/单位 |
|---|---|---|
| `CLK_HZ` | `49152000` | 本模块工作时钟频率，单位Hz；用于换算计数周期，不创建新时钟。 |
| `I2C_HZ` | `400000` | 频率配置，单位Hz；用于计数/分频换算。 |
| `TIMEOUT_CYCLES` | `CLK_HZ/200` | 计数门限/步长，单位本模块时钟周期；换算时间必须使用实际连接时钟。 |
| `POLL_CYCLES` | `CLK_HZ/2000` | 计数门限/步长，单位本模块时钟周期；换算时间必须使用实际连接时钟。 |
| `RESET_CYCLES` | `CLK_HZ/1000` | 计数门限/步长，单位本模块时钟周期；换算时间必须使用实际连接时钟。 |
| `SETTLE_CYCLES` | `CLK_HZ/20` | 计数门限/步长，单位本模块时钟周期；换算时间必须使用实际连接时钟。 |
| `RETRY_CYCLES` | `CLK_HZ/10` | 计数门限/步长，单位本模块时钟周期；换算时间必须使用实际连接时钟。 |
| `CALIBRATION_SNAPSHOTS` | `3` | 初始化校准所需连续完整快照数量。 |
| `MAX_RETRIES` | `2` | 允许重试的最大次数。 |
| `ELECTRODES` | `12` | 该MPR121启用的电极数量。 |
| `EARLY_KEY_ENABLE` | `0` | 功能/接口选择参数，通常0关闭、1开启；不是运行时按钮。 |
| `I2C_ADDR` | `7'h5a` | 7位I2C从机地址，不含读写位。 |
| `TOUCH_THRESHOLD` | `12` | MPR121触摸阈值寄存器数值，不是伏特。 |
| `RELEASE_THRESHOLD` | `6` | MPR121释放阈值寄存器数值，不是伏特。 |
| `FILTER_CDC` | `8'h10` | MPR121采样/充电电流相关寄存器配置编码。 |
| `FILTER_CDT` | `8'h20` | MPR121采样/充电时间相关寄存器配置编码。 |

### 输入（5个）

| 端口 | 位宽 | 数值类型 | 作用、单位及条件 | 一处实际连接例 |
|---|---|---|---|---|
| `clk` | 1位 | 无符号/位图 | 本模块工作时钟；当前完整音频链通常为49.152MHz，显示/板级模块须看各自连接。 | `mpr121_input_frontend.sampler`：`clk` |
| `resetn` | 1位 | 无符号/位图 | 低有效复位：0复位、1运行；不是触摸状态。 | `mpr121_input_frontend.sampler`：`resetn` |
| `irq_n` | 1位 | 无符号/位图 | MPR121低有效中断请求；不是音频数据线。 | `mpr121_input_frontend.sampler`：`irq_n[g]` |
| `snapshot_ready` | 1位 | 无符号/位图 | 可接收完整快照的许可，逐模块位图时每位独立对应一块芯片。 | `mpr121_input_frontend.sampler`：`snap_ready[g]` |
| `early_key_ready` | 1位 | 无符号/位图 | 下游可接受快速琴键状态；完整滑条快照仍会继续读完。 | `mpr121_input_frontend.sampler`：`early_ready[g]` |

### 输出（11个）

| 端口 | 位宽 | 数值类型 | 作用、单位及条件 | 一处实际连接例 |
|---|---|---|---|---|
| `snapshot_valid` | 1位 | 无符号/位图 | 一份或逐模块完整快照有效；与snapshot_ready配合接收。 | `mpr121_input_frontend.sampler`：`snap_valid[g]` |
| `snapshot` | `[343:0]`；默认344位 | 无符号/位图 | 一次完整读取的43字节快照，344位；包含电极状态、滤波数据和基线等。 | `mpr121_input_frontend.sampler`：`snaps[g*344 +:344]` |
| `ready` | 1位 | 无符号/位图 | 模块初始化就绪或可工作状态；传感器中不是下游握手ready。 | `mpr121_input_frontend.sampler`：`ready[g]` |
| `fault` | 1位 | 无符号/位图 | 传感器或显示驱动故障标志/逐模块位图；不会自动代表整个FPGA断电。 | `mpr121_input_frontend.sampler`：`fault[g]` |
| `last_error` | `[3:0]`；默认4位 | 无符号/位图 | 最近一次驱动/业务错误码；多传感器时为打包字段。 | `mpr121_input_frontend.sampler`：`last_error[g*4 +:4]` |
| `error_count` | `[31:0]`；默认32位 | 无符号/位图 | 累计错误次数；多传感器时按模块打包。 | `mpr121_input_frontend.sampler`：`error_count[g*32 +:32]` |
| `last_success_age` | `[31:0]`；默认32位 | 无符号/位图 | 距最近成功采样的时钟周期数；多模块时打包多个计数。 | `mpr121_input_frontend.sampler`：`last_success_age[g*32 +:32]` |
| `init_stage` | `[4:0]`；默认5位 | 无符号/位图 | 传感器初始化阶段编号；多模块时为打包字段。 | `mpr121_input_frontend.sampler`：`init_stage[g*5 +:5]` |
| `oor_status` | `[15:0]`；默认16位 | 无符号/位图 | 采集模块读出的MPR121 OOR状态位，供诊断观察；具体位含义按寄存器定义解释。 | `mpr121_input_frontend.sampler`：`oor_status[g*16 +:16]` |
| `early_key_valid` | 1位 | 无符号/位图 | 前2字节键状态已就绪，等待early_key_ready接收。 | `mpr121_input_frontend.sampler`：`early_valid[g]` |
| `early_key_status` | `[11:0]`；默认12位 | 无符号/位图 | 快速读取的前2字节中的12位电极触摸状态，仅用于琴键快通道。 | `mpr121_input_frontend.sampler`：`early_status[g*12+:12]` |

### 双向（2个）

| 端口 | 位宽 | 数值类型 | 作用、单位及条件 | 一处实际连接例 |
|---|---|---|---|---|
| `scl` | 1位 | 无符号/位图 | I2C时钟双向开漏线：主动拉低或高阻释放，由上拉形成高电平。 | `mpr121_input_frontend.sampler`：`scl[g]` |
| `sda` | 1位 | 无符号/位图 | I2C数据双向开漏线：主动拉低或高阻释放，由上拉形成高电平。 | `mpr121_input_frontend.sampler`：`sda[g]` |

### 父级实例及参数覆盖

表中包含旧入口和条件分支，列出连接不表示分支最终启用。参数未覆盖时仍使用模块默认值。

| 父模块.实例 | 显式覆盖参数 | 父模块是否在完整顶层静态关系中 |
|---|---|---|
| `mpr121_input_frontend.sampler` | `CLK_HZ=CLK_HZ`；`I2C_HZ=I2C_HZ`；`TIMEOUT_CYCLES=TIMEOUT_CYCLES`；`POLL_CYCLES=POLL_CYCLES`；`RESET_CYCLES=RESET_CYCLES`；`SETTLE_CYCLES=SETTLE_CYCLES`；`RETRY_CYCLES=RETRY_CYCLES`；`CALIBRATION_SNAPSHOTS=CALIBRATION_SNAPSHOTS`；`MAX_RETRIES=MAX_RETRIES`；`ELECTRODES=(g==0)?12:((g==1)?8:9)`；`EARLY_KEY_ENABLE=EARLY_KEY_ENABLE`；`I2C_ADDR=(g==0)?ADDR0:((g==1)?ADDR1:ADDR2)`；`TOUCH_THRESHOLD=TOUCH_THRESHOLD`；`RELEASE_THRESHOLD=RELEASE_THRESHOLD`；`FILTER_CDC=FILTER_CDC`；`FILTER_CDT=FILTER_CDT` | 是（含条件分支） |

[回到总索引](README.md)

## mpr121_slider

定义：[rtl/sensors/mpr121_slider.v:3](https://github.com/wujijun11/git/blob/codex/sustain-20261030/TangMega60K_Synth/rtl/sensors/mpr121_slider.v#L3)

用途：由四电极触摸强度计算加权位置0..3072；保留旧弯音输出能力，完整菜单模式不再直接用其弯音。

时序/注意事项：snapshot_strobe启动一次完整快照的位置计算。输入快照不是每周期变动的实时模拟电压；内部除法分时执行。expr_update输出可反压，active/position作为当前状态另行观察。

源码中本模块自己的边沿触发条件：`posedge clk`。子模块还可有自己的时序。

### 编译参数（模块默认值）

下列默认值不是当前父实例一定采用的值；覆盖项见本节末尾。

| 参数 | 默认表达式 | 含义/单位 |
|---|---|---|
| `NOISE0` | `4` | 滑条电极噪声门限，单位采样差分刻度。 |
| `NOISE1` | `4` | 滑条电极噪声门限，单位采样差分刻度。 |
| `NOISE2` | `4` | 滑条电极噪声门限，单位采样差分刻度。 |
| `NOISE3` | `4` | 滑条电极噪声门限，单位采样差分刻度。 |
| `GAIN0` | `256` | 滑条电极校准增益，当前256对应1倍。 |
| `GAIN1` | `256` | 滑条电极校准增益，当前256对应1倍。 |
| `GAIN2` | `256` | 滑条电极校准增益，当前256对应1倍。 |
| `GAIN3` | `256` | 滑条电极校准增益，当前256对应1倍。 |
| `MIN_WEIGHT` | `12` | 判定滑条有效触摸所需最小总权重。 |
| `POSITION_MIN` | `0` | 滑条位置标定下限，单位位置刻度。 |
| `POSITION_MAX` | `3072` | 滑条位置标定上限，当前常用3072。 |
| `BEND_MAX_CENTS` | `200` | 弯音/迟滞/死区范围，单位音分，100音分=1半音。 |
| `DEADZONE_CENTS` | `3` | 弯音/迟滞/死区范围，单位音分，100音分=1半音。 |
| `HYSTERESIS_CENTS` | `2` | 弯音/迟滞/死区范围，单位音分，100音分=1半音。 |
| `BEND_ENABLE` | `1` | 功能/接口选择参数，通常0关闭、1开启；不是运行时按钮。 |

### 输入（6个）

| 端口 | 位宽 | 数值类型 | 作用、单位及条件 | 一处实际连接例 |
|---|---|---|---|---|
| `clk` | 1位 | 无符号/位图 | 本模块工作时钟；当前完整音频链通常为49.152MHz，显示/板级模块须看各自连接。 | `mpr121_input_frontend.slider`：`clk` |
| `resetn` | 1位 | 无符号/位图 | 低有效复位：0复位、1运行；不是触摸状态。 | `mpr121_input_frontend.slider`：`resetn` |
| `snapshot_strobe` | 1位 | 无符号/位图 | 完整快照提交脉冲，采集模块据此启动位置计算。 | `mpr121_input_frontend.slider`：`snap_valid[0] && snap_ready[0]` |
| `snapshot` | `[343:0]`；默认344位 | 无符号/位图 | 第一块MPR121的43字节完整快照，用于ELE8..11四电极滑条计算。 | `mpr121_input_frontend.slider`：`snaps[343:0]` |
| `fault` | 1位 | 无符号/位图 | 传感器或显示驱动故障标志/逐模块位图；不会自动代表整个FPGA断电。 | `mpr121_input_frontend.slider`：`fault[0]` |
| `expr_update_ready` | 1位 | 无符号/位图 | 增量表情参数接收许可；不是发送完成或全系统就绪。与同组valid同时为1才完成一次传输。 | `mpr121_input_frontend.slider`：`expr_update_ready` |

### 输出（8个）

| 端口 | 位宽 | 数值类型 | 作用、单位及条件 | 一处实际连接例 |
|---|---|---|---|---|
| `expr_update_valid` | 1位 | 无符号/位图 | 增量表情参数有效指示；标准流接口与同组ready在同一时钟边沿同时为1才接收。无ready的观察脉冲另见时序说明。 | `mpr121_input_frontend.slider`：`expr_update_valid` |
| `expr_update_mask` | `[2:0]`；默认3位 | 无符号/位图 | 增量表情参数更新掩码，bit0增益、bit1弯音、bit2颤音，仅选中的字段生效。 | `mpr121_input_frontend.slider`：`expr_update_mask` |
| `expr_update_gain_q1_11` | `[11:0]`；默认12位 | 无符号/位图 | 增量表情参数无符号Q1.11增益，2048=1倍。 | `mpr121_input_frontend.slider`：`expr_update_gain_q1_11` |
| `expr_update_bend_cents` | `[12:0]`；默认13位 | 有符号补码 | 增量表情参数有符号弯音，单位音分；100音分=1半音。 | `mpr121_input_frontend.slider`：`expr_update_bend_cents` |
| `expr_update_vibrato_depth_cents` | `[7:0]`；默认8位 | 无符号/位图 | 增量表情参数颤音深度，单位音分，控制链限制0..100。 | `mpr121_input_frontend.slider`：`expr_update_vibrato_depth_cents` |
| `active` | 1位 | 无符号/位图 | 该模块处理对象处于活动状态；音频中是声部有效，学习中是学习任务有效。 | `mpr121_input_frontend.slider`：`slider_active` |
| `position` | `[11:0]`；默认12位 | 无符号/位图 | 滑条连续位置，当前标度0..3072；位宽12并不表示有效范围一定到4095。 | `mpr121_input_frontend.slider`：`slider_position` |
| `latest_bend` | `[12:0]`；默认13位 | 有符号补码 | 采集模块最近计算的弯音，单位音分；当前菜单方案主要使用位置输出。 | `mpr121_input_frontend.slider`：`latest_bend` |

### 父级实例及参数覆盖

表中包含旧入口和条件分支，列出连接不表示分支最终启用。参数未覆盖时仍使用模块默认值。

| 父模块.实例 | 显式覆盖参数 | 父模块是否在完整顶层静态关系中 |
|---|---|---|
| `mpr121_input_frontend.slider` | `NOISE0=SLIDER_NOISE0`；`NOISE1=SLIDER_NOISE1`；`NOISE2=SLIDER_NOISE2`；`NOISE3=SLIDER_NOISE3`；`GAIN0=SLIDER_GAIN0`；`GAIN1=SLIDER_GAIN1`；`GAIN2=SLIDER_GAIN2`；`GAIN3=SLIDER_GAIN3`；`MIN_WEIGHT=SLIDER_MIN_WEIGHT`；`POSITION_MIN=SLIDER_POSITION_MIN`；`POSITION_MAX=SLIDER_POSITION_MAX`；`BEND_MAX_CENTS=SLIDER_BEND_MAX`；`BEND_ENABLE=SLIDER_BEND_ENABLE` | 是（含条件分支） |

[回到总索引](README.md)
