wujijun11/git/TangMega60K_Synth/docs/模块输入输出_20261030/05-曲谱录制学习.md

# 05 曲谱、录制与学习

[总索引](README.md) · [先理解接口规则](接口阅读方法.md) · [全部命名连接](实例连接索引.md)

端口方向始终相对本模块。位宽中的“默认”按模块声明计算，父实例覆盖值另列；连接例为父模块局部网络名，不是板上引脚名。

## learning_stepper

定义：[rtl/performance/learning_stepper.v:4](https://github.com/wujijun11/git/blob/codex/sustain-20261030/TangMega60K_Synth/rtl/performance/learning_stepper.v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)

用途：学习模式判定器：等待松键、等待正确目标/和弦，按齐才前进；不限等待时间，本版不考核节奏。

时序/注意事项：row握手读取音符行，按目标聚合学习步骤；touch_ready是采集初始化条件。只有用户按齐目标才前进，可无限等待，不能用普通定时播放代替。

源码中本模块自己的边沿触发条件：`posedge clk`。子模块还可有自己的时序。

### 输入（11个）

| 端口 | 位宽 | 数值类型 | 作用、单位及条件 | 一处实际连接例 |
|---|---|---|---|---|
| `clk` | 1位 | 无符号/位图 | 本模块工作时钟；当前完整音频链通常为49.152MHz，显示/板级模块须看各自连接。 | `performance_controller.stepper`：`clk` |
| `rst_n` | 1位 | 无符号/位图 | 低有效复位：0复位、1运行；同步/异步方式见本模块触发条件。 | `performance_controller.stepper`：`rst_n` |
| `start` | 1位 | 无符号/位图 | 启动一次处理的控制；不是统一的ready/valid握手，接受条件见模块说明。 | `performance_controller.stepper`：`action_command && action==9` |
| `stop` | 1位 | 无符号/位图 | 请求停止当前自检/学习任务；实际释放与完成需后续时序。 | `performance_controller.stepper`：`action_command && (action==0 &#124;&#124; action==5 &#124;&#124; action==7)` |
| `row_valid` | 1位 | 无符号/位图 | 曲谱行有效指示；标准流接口与同组ready在同一时钟边沿同时为1才接收。无ready的观察脉冲另见时序说明。 | `performance_controller.stepper`：`learn_row_valid` |
| `row_key` | `[4:0]`；默认5位 | 无符号/位图 | 学习曲谱本行的实体键编号，0..24。 | `performance_controller.stepper`：`active_key[4:0]` |
| `row_on` | 1位 | 无符号/位图 | 学习曲谱本行开关：1按下、0松开。 | `performance_controller.stepper`：`active_on` |
| `row_delta_ms` | `[31:0]`；默认32位 | 无符号/位图 | 学习曲谱本行相对时间，单位毫秒；实际前进仍受按键等待条件控制。 | `performance_controller.stepper`：`active_row[47:16]` |
| `row_last` | 1位 | 无符号/位图 | 当前行是本轮最后一条事件的标志。 | `performance_controller.stepper`：`score_position+16'd1>=run_count` |
| `touch_mask` | `[24:0]`；默认25位 | 无符号/位图 | 25个实体琴键的触摸状态位图，bit i=1表示第i键按住。 | `performance_controller.stepper`：`learning_touch_mask` |
| `touch_ready` | 1位 | 无符号/位图 | 触摸前端就绪条件，用来避免未初始化数据误判学习；不是row_ready。 | `performance_controller.stepper`：`learning_touch_ready` |

### 输出（7个）

| 端口 | 位宽 | 数值类型 | 作用、单位及条件 | 一处实际连接例 |
|---|---|---|---|---|
| `row_ready` | 1位 | 无符号/位图 | 曲谱行接收许可；不是发送完成或全系统就绪。与同组valid同时为1才完成一次传输。 | `performance_controller.stepper`：`learn_row_ready` |
| `active` | 1位 | 无符号/位图 | 该模块处理对象处于活动状态；音频中是声部有效，学习中是学习任务有效。 | `performance_controller.stepper`：`learn_active` |
| `target_mask` | `[24:0]`；默认25位 | 无符号/位图 | 当前学习步骤要求按下的25键目标位图，可包含和弦。 | `performance_controller.stepper`：`learn_target` |
| `waiting_release` | 1位 | 无符号/位图 | 学习模式正等待松开之前的触摸状态。 | `performance_controller.stepper`：`learn_release` |
| `waiting_press` | 1位 | 无符号/位图 | 学习模式正等待按齐本步目标。 | `performance_controller.stepper`：`learn_press` |
| `completed_steps` | `[15:0]`；默认16位 | 无符号/位图 | 已完成学习步骤数。 | `performance_controller.stepper`：`learn_completed` |
| `finished` | 1位 | 无符号/位图 | 当前包络/学习/自检已到结束条件，具体是组合结果还是脉冲见实现。 | `performance_controller.stepper`：`learn_finished` |

### 父级实例及参数覆盖

表中包含旧入口和条件分支，列出连接不表示分支最终启用。参数未覆盖时仍使用模块默认值。

| 父模块.实例 | 显式覆盖参数 | 父模块是否在完整顶层静态关系中 |
|---|---|---|
| `performance_controller.stepper` | 未显式覆盖 | 是（含条件分支） |

[回到总索引](README.md)

## performance_controller

定义：[rtl/performance/performance_controller.v:2](https://github.com/wujijun11/git/blob/codex/sustain-20261030/TangMega60K_Synth/rtl/performance/performance_controller.v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)

用途：曲谱/录制RAM、时间调度、播放、停止释放、指引与学习的业务核心；当前板上曲谱容量1024条事件，不是1024首歌，也不保存PCM。

时序/注意事项：command口提交曲谱业务；event口输出调度后的音符。record_valid只观察已经接受的演奏，不能反压。record_read_index经同步RAM返回record_read_valid/row_payload。板内容量由SCORE_CAPACITY/RECORD_CAPACITY决定。

源码中本模块自己的边沿触发条件：`posedge clk`。子模块还可有自己的时序。

### 编译参数（模块默认值）

下列默认值不是当前父实例一定采用的值；覆盖项见本节末尾。

| 参数 | 默认表达式 | 含义/单位 |
|---|---|---|
| `CLK_HZ` | `49152000` | 本模块工作时钟频率，单位Hz；用于换算计数周期，不创建新时钟。 |
| `SCORE_CAPACITY` | `1024` | 板内曲谱RAM容量，单位事件条数，不是歌曲数。 |
| `RECORD_CAPACITY` | `1024` | 板内演奏录制RAM容量，单位事件条数。 |
| `SCORE_SOURCE_BASE` | `0` | 普通曲谱按键来源编号基址。 |
| `RECORD_SOURCE_BASE` | `25` | 录制回放来源编号基址。 |
| `DIRECT_SCORE_ENABLE` | `0` | 功能/接口选择参数，通常0关闭、1开启；不是运行时按钮。 |
| `LEARNING_ENABLE` | `0` | 功能/接口选择参数，通常0关闭、1开启；不是运行时按钮。 |
| `DIRECT_SCORE_SOURCE` | `6'd62` | 直接MIDI音高曲谱的来源编号。 |

### 输入（17个）

| 端口 | 位宽 | 数值类型 | 作用、单位及条件 | 一处实际连接例 |
|---|---|---|---|---|
| `clk` | 1位 | 无符号/位图 | 本模块工作时钟；当前完整音频链通常为49.152MHz，显示/板级模块须看各自连接。 | `instrument_full_system.performance`：`clk` |
| `rst_n` | 1位 | 无符号/位图 | 低有效复位：0复位、1运行；同步/异步方式见本模块触发条件。 | `instrument_full_system.performance`：`rst_n` |
| `command_valid` | 1位 | 无符号/位图 | 曲谱命令有效指示；标准流接口与同组ready在同一时钟边沿同时为1才接收。无ready的观察脉冲另见时序说明。 | `instrument_full_system.performance`：`staged_command_valid` |
| `command_opcode` | `[7:0]`；默认8位 | 无符号/位图 | 曲谱命令通信/业务命令操作码，解释取决于对应协议层。 | `instrument_full_system.performance`：`staged_opcode` |
| `command_payload` | `[79:0]`；默认80位 | 无符号/位图 | 曲谱命令打包负载；具体位布局见模块专用说明和协议文档。 | `instrument_full_system.performance`：`staged_payload` |
| `record_valid` | 1位 | 无符号/位图 | 已被仲裁器接受的演奏事件观察脉冲；无record_ready，录制模块不能反压原演奏链。 | `instrument_full_system.performance`：`push_valid && push_ready && arb_selected!=2` |
| `record_on` | 1位 | 无符号/位图 | 录制事件开关，1按下/触发、0松开/释放。 | `instrument_full_system.performance`：`push_payload[22]` |
| `record_source` | `[5:0]`；默认6位 | 无符号/位图 | 录制事件来源所有权编号，当前6位；用于同音不同来源的正确松键，不直接改变音色。 | `instrument_full_system.performance`：`push_payload[21:16]` |
| `record_note` | `[6:0]`；默认7位 | 无符号/位图 | 录制事件MIDI音高编号0..127，不是频率Hz。 | `instrument_full_system.performance`：`push_payload[15:9]` |
| `record_velocity` | `[6:0]`；默认7位 | 无符号/位图 | 录制事件MIDI式力度编号0..127。 | `instrument_full_system.performance`：`push_payload[8:2]` |
| `record_timbre` | `[1:0]`；默认2位 | 无符号/位图 | 录制事件音色编号，当前完整音源0正弦、1风琴、2八成分钢琴、3可选FM。 | `instrument_full_system.performance`：`push_payload[1:0]` |
| `event_ready` | 1位 | 无符号/位图 | 音符事件接收许可；不是发送完成或全系统就绪。与同组valid同时为1才完成一次传输。 | `instrument_full_system.performance`：`perf_er` |
| `key_map_flat` | `[174:0]`；默认175位 | 无符号/位图 | 25个实体键的MIDI音高映射，25×7=175位，键i使用[i*7 +:7]。 | `instrument_full_system.performance`：`mapping` |
| `current_timbre` | `[1:0]`；默认2位 | 无符号/位图 | 当前选定音色编号，用于新产生音符。 | `instrument_full_system.performance`：`timbre` |
| `learning_touch_mask` | `[24:0]`；默认25位 | 无符号/位图 | 供学习判定的25键触摸位图。 | `instrument_full_system.performance`：`touch_mask` |
| `learning_touch_ready` | 1位 | 无符号/位图 | 学习所需触摸数据已经初始化就绪的条件，不是曲谱流ready。 | `instrument_full_system.performance`：`(&sensor_ready) && !(&#124;sensor_fault)` |
| `record_read_index` | `[15:0]`；默认16位 | 无符号/位图 | 主机请求读取的录制事件索引。 | `instrument_full_system.performance`：`read_index` |

### 输出（20个）

| 端口 | 位宽 | 数值类型 | 作用、单位及条件 | 一处实际连接例 |
|---|---|---|---|---|
| `command_ready` | 1位 | 无符号/位图 | 曲谱后端可处理命令；当前实现常为1，但命令仍可能返回业务错误状态。 | `instrument_full_system.performance`：`perf_ready` |
| `command_status` | `[7:0]`；默认8位 | 无符号/位图 | 曲谱后端对本次命令的执行状态码。 | `instrument_full_system.performance`：`perf_status` |
| `action_busy` | 1位 | 无符号/位图 | 菜单/曲谱动作仍在处理，不能当作已经完成。 | `instrument_full_system.performance`：`perf_action_busy` |
| `local_action_status` | `[7:0]`；默认8位 | 无符号/位图 | 本地控制动作的实际执行状态码。 | `instrument_full_system.performance`：`perf_local_action_status` |
| `event_valid` | 1位 | 无符号/位图 | 音符事件有效指示；标准流接口与同组ready在同一时钟边沿同时为1才接收。无ready的观察脉冲另见时序说明。 | `instrument_full_system.performance`：`perf_ev` |
| `event_on` | 1位 | 无符号/位图 | 音符事件开关，1按下/触发、0松开/释放。 | `instrument_full_system.performance`：`perf_on` |
| `event_source` | `[5:0]`；默认6位 | 无符号/位图 | 音符事件来源所有权编号，当前6位；用于同音不同来源的正确松键，不直接改变音色。 | `instrument_full_system.performance`：`perf_source` |
| `event_note` | `[6:0]`；默认7位 | 无符号/位图 | 音符事件MIDI音高编号0..127，不是频率Hz。 | `instrument_full_system.performance`：`perf_note` |
| `event_velocity` | `[6:0]`；默认7位 | 无符号/位图 | 音符事件MIDI式力度编号0..127。 | `instrument_full_system.performance`：`perf_velocity` |
| `event_timbre` | `[1:0]`；默认2位 | 无符号/位图 | 音符事件音色编号，当前完整音源0正弦、1风琴、2八成分钢琴、3可选FM。 | `instrument_full_system.performance`：`perf_timbre` |
| `learning_status_payload` | `[79:0]`；默认80位 | 无符号/位图 | 等候学习的80位只读状态负载。 | `instrument_full_system.performance`：`learning_status_payload` |
| `guide_mask` | `[24:0]`；默认25位 | 无符号/位图 | 当前需要提示的25键目标位图，灯板按映射显示。 | `instrument_full_system.performance`：`guide_mask` |
| `playing` | 1位 | 无符号/位图 | 曲谱或回放业务正在播放，不等于所有声部均空闲/发声。 | `instrument_full_system.performance`：`playing` |
| `recording` | 1位 | 无符号/位图 | 正在记录演奏音符事件；不是录制PCM声音。 | `instrument_full_system.performance`：`recording` |
| `guide_active` | 1位 | 无符号/位图 | 曲谱灯光指引或等候学习业务正在运行。 | `instrument_full_system.performance`：`guide_active` |
| `overflow_sticky` | 1位 | 无符号/位图 | 发生溢出后保持的历史标志，复位或规定清除动作后清零。 | `instrument_full_system.performance`：`record_overflow` |
| `record_count` | `[15:0]`；默认16位 | 无符号/位图 | 已记录的演奏事件条数，不是歌曲数量。 | `instrument_full_system.performance`：`record_count` |
| `score_position` | `[15:0]`；默认16位 | 无符号/位图 | 当前曲谱/回放事件位置。 | `instrument_full_system.performance`：`score_position` |
| `record_read_valid` | 1位 | 无符号/位图 | 请求的录制事件读数已有效；按同步RAM路径使用。 | `instrument_full_system.performance`：`read_valid` |
| `row_payload` | `[79:0]`；默认80位 | 无符号/位图 | 录制事件读取返回负载，包含事件数据和索引，不是PCM。 | `instrument_full_system.performance`：`read_row` |

### 父级实例及参数覆盖

表中包含旧入口和条件分支，列出连接不表示分支最终启用。参数未覆盖时仍使用模块默认值。

| 父模块.实例 | 显式覆盖参数 | 父模块是否在完整顶层静态关系中 |
|---|---|---|
| `instrument_full_system.performance` | `CLK_HZ=CLK_HZ`；`DIRECT_SCORE_ENABLE=1`；`LEARNING_ENABLE=1` | 是（含条件分支） |

[回到总索引](README.md)
