wujijun11/git/TangMega60K_Synth/docs/模块输入输出_20261030/实例连接索引.md

# 全部RTL命名实例连接索引

[总索引](README.md)

按父模块分组；每一行都是源码中的.port(网络/表达式)。同名网络只有在同一父模块内才可能是同一根线。generate复制数量和条件不在此展开，SIM与综合互斥分支也可能同时出现。未连接()和常量连接如实保留。

## audio_clock_48k

定义：[rtl/clock/audio_clock_48k.v:6](https://github.com/wujijun11/git/blob/codex/sustain-20261030/TangMega60K_Synth/rtl/clock/audio_clock_48k.v#L6)

### pll_38m4：audio_plla_stage

| 子模块端口 | 相对子模块方向 | 父级实际网络/表达式 |
|---|---|---|
| `clkin` | 输入 | `clk_50` |
| `mdclk` | 输入 | `clk_50` |
| `reset` | 输入 | `1'b0` |
| `clkout` | 输出 | `clk_38m4` |
| `locked` | 输出 | `lock_38m4` |
| `debug_raw_lock` | 输出 | `raw_lock_first` |
| `debug_raw_reset` | 输出 | `raw_reset_first` |

### pll_49m152：audio_plla_stage

| 子模块端口 | 相对子模块方向 | 父级实际网络/表达式 |
|---|---|---|
| `clkin` | 输入 | `clk_38m4` |
| `mdclk` | 输入 | `clk_50` |
| `reset` | 输入 | `!first_lock_stable` |
| `clkout` | 输出 | `clk_audio` |
| `locked` | 输出 | `lock_49m152` |
| `debug_raw_lock` | 输出 | `raw_lock_second` |
| `debug_raw_reset` | 输出 | `raw_reset_second` |

## audio_plla_stage

定义：[rtl/clock/audio_clock_48k.v:68](https://github.com/wujijun11/git/blob/codex/sustain-20261030/TangMega60K_Synth/rtl/clock/audio_clock_48k.v#L68)

### init：PLL_INIT

| 子模块端口 | 相对子模块方向 | 父级实际网络/表达式 |
|---|---|---|
| `I_RST` | 输入 | `reset` |
| `I_MD_CLK` | 输入 | `mdclk` |
| `O_RST` | 输出 | `primitive_reset` |
| `I_LOCK` | 输入 | `primitive_lock` |
| `O_LOCK` | 输出 | `locked` |
| `O_MD_INC` | 输出 | `md_inc` |
| `O_MD_OPC` | 输出 | `md_op` |
| `O_MD_WR_DATA` | 输出 | `md_write` |
| `I_MD_RD_DATA` | 输入 | `md_read` |
| `PLL_INIT_BYPASS` | 输入 | `1'b0` |
| `MDRDO` | 输出 | 显式未连接() |
| `MDOPC` | 输入 | `2'b00` |
| `MDAINC` | 输入 | `1'b0` |
| `MDWDI` | 输入 | `8'b0` |

## audio_system_v2

定义：[rtl/audio/audio_system_v2.v:5](https://github.com/wujijun11/git/blob/codex/sustain-20261030/TangMega60K_Synth/rtl/audio/audio_system_v2.v#L5)

### u_captain：captain_system_top_v2

| 子模块端口 | 相对子模块方向 | 父级实际网络/表达式 |
|---|---|---|
| `clk` | 输入 | `clk` |
| `rst_n` | 输入 | `rst_n` |
| `event_valid` | 输入 | `event_valid` |
| `event_ready` | 输出 | `event_ready` |
| `event_on` | 输入 | `event_on` |
| `event_source` | 输入 | `event_source` |
| `event_note` | 输入 | `event_note` |
| `event_velocity` | 输入 | `event_velocity` |
| `event_timbre` | 输入 | `event_timbre` |
| `expr_valid` | 输入 | `expr_valid` |
| `expr_ready` | 输出 | `expr_ready` |
| `expr_gain` | 输入 | `expr_gain` |
| `expr_bend_cents` | 输入 | `expr_bend_cents` |
| `expr_vibrato_cents` | 输入 | `expr_vibrato_cents` |
| `engine_sample_begin` | 输入 | `engine_sample_begin` |
| `active_gain` | 输出 | `active_gain` |
| `active_bend_cents` | 输出 | `active_bend_cents` |
| `active_vibrato_cents` | 输出 | `active_vibrato_cents` |
| `expr_applied` | 输出 | `expr_applied` |
| `cmd_valid` | 输出 | `cmd_valid` |
| `cmd_ready` | 输入 | `cmd_ready` |
| `cmd_on` | 输出 | `cmd_on` |
| `cmd_voice` | 输出 | `cmd_voice` |
| `cmd_note` | 输出 | `cmd_note` |
| `cmd_velocity` | 输出 | `cmd_velocity` |
| `cmd_timbre` | 输出 | `cmd_timbre` |
| `done_valid` | 输入 | `done_valid` |
| `done_ready` | 输出 | `done_ready` |
| `done_voice` | 输入 | `done_voice` |
| `sample_valid` | 输入 | `sample_valid` |
| `sample_ready` | 输出 | `sample_ready` |
| `sample_left` | 输入 | `sample_left` |
| `sample_right` | 输入 | `sample_right` |
| `i2s_bclk` | 输出 | `i2s_bclk` |
| `i2s_lrclk` | 输出 | `i2s_lrclk` |
| `i2s_data` | 输出 | `i2s_data` |
| `active_count` | 输出 | `active_count` |
| `active_mask` | 输出 | 显式未连接() |
| `held_mask` | 输出 | 显式未连接() |
| `full_pulse` | 输出 | `full_pulse` |
| `ignored_pulse` | 输出 | 显式未连接() |
| `done_error_pulse` | 输出 | `done_error_pulse` |
| `frame_tick` | 输出 | 显式未连接() |
| `fifo_level` | 输出 | 显式未连接() |
| `underrun_pulse` | 输出 | 显式未连接() |
| `underrun_sticky` | 输出 | 显式未连接() |
| `underrun_count` | 输出 | `underrun_count` |

### u_engine：voice_engine

| 子模块端口 | 相对子模块方向 | 父级实际网络/表达式 |
|---|---|---|
| `clk` | 输入 | `clk` |
| `rst_n` | 输入 | `rst_n` |
| `cmd_valid` | 输入 | `cmd_valid` |
| `cmd_ready` | 输出 | `cmd_ready` |
| `cmd_on` | 输入 | `cmd_on` |
| `cmd_voice` | 输入 | `cmd_voice` |
| `cmd_note` | 输入 | `cmd_note` |
| `cmd_velocity` | 输入 | `cmd_velocity` |
| `cmd_timbre` | 输入 | `cmd_timbre` |
| `done_valid` | 输出 | `done_valid` |
| `done_ready` | 输入 | `done_ready` |
| `done_voice` | 输出 | `done_voice` |
| `sample_valid` | 输出 | `sample_valid` |
| `sample_ready` | 输入 | `sample_ready` |
| `sample_left` | 输出 | `sample_left` |
| `sample_right` | 输出 | `sample_right` |
| `engine_sample_begin` | 输出 | `engine_sample_begin` |
| `active_gain` | 输入 | `active_gain` |
| `active_bend_cents` | 输入 | `active_bend_cents` |
| `active_vibrato_cents` | 输入 | `active_vibrato_cents` |

## audio_system_v2_delay

定义：[rtl/audio/audio_system_v2.v:64](https://github.com/wujijun11/git/blob/codex/sustain-20261030/TangMega60K_Synth/rtl/audio/audio_system_v2.v#L64)

### u_system：audio_system_v2

| 子模块端口 | 相对子模块方向 | 父级实际网络/表达式 |
|---|---|---|
| `clk` | 输入 | `clk` |
| `rst_n` | 输入 | `rst_n` |
| `event_valid` | 输入 | `event_valid` |
| `event_ready` | 输出 | `event_ready` |
| `event_on` | 输入 | `event_on` |
| `event_source` | 输入 | `event_source` |
| `event_note` | 输入 | `event_note` |
| `event_velocity` | 输入 | `event_velocity` |
| `event_timbre` | 输入 | `event_timbre` |
| `expr_valid` | 输入 | `expr_valid` |
| `expr_ready` | 输出 | `expr_ready` |
| `expr_gain` | 输入 | `expr_gain` |
| `expr_bend_cents` | 输入 | `expr_bend_cents` |
| `expr_vibrato_cents` | 输入 | `expr_vibrato_cents` |
| `i2s_bclk` | 输出 | `i2s_bclk` |
| `i2s_lrclk` | 输出 | `i2s_lrclk` |
| `i2s_data` | 输出 | `i2s_data` |
| `active_count` | 输出 | `active_count` |
| `full_pulse` | 输出 | `full_pulse` |
| `done_error_pulse` | 输出 | `done_error_pulse` |
| `underrun_count` | 输出 | `underrun_count` |

## audio_system_v2_fm

定义：[rtl/audio/audio_system_v2_fm.v:3](https://github.com/wujijun11/git/blob/codex/sustain-20261030/TangMega60K_Synth/rtl/audio/audio_system_v2_fm.v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)

### u_system：audio_system_v2

| 子模块端口 | 相对子模块方向 | 父级实际网络/表达式 |
|---|---|---|
| `clk` | 输入 | `clk` |
| `rst_n` | 输入 | `rst_n` |
| `event_valid` | 输入 | `event_valid` |
| `event_ready` | 输出 | `event_ready` |
| `event_on` | 输入 | `event_on` |
| `event_source` | 输入 | `event_source` |
| `event_note` | 输入 | `event_note` |
| `event_velocity` | 输入 | `event_velocity` |
| `event_timbre` | 输入 | `event_timbre` |
| `expr_valid` | 输入 | `expr_valid` |
| `expr_ready` | 输出 | `expr_ready` |
| `expr_gain` | 输入 | `expr_gain` |
| `expr_bend_cents` | 输入 | `expr_bend_cents` |
| `expr_vibrato_cents` | 输入 | `expr_vibrato_cents` |
| `i2s_bclk` | 输出 | `i2s_bclk` |
| `i2s_lrclk` | 输出 | `i2s_lrclk` |
| `i2s_data` | 输出 | `i2s_data` |
| `active_count` | 输出 | `active_count` |
| `full_pulse` | 输出 | `full_pulse` |
| `done_error_pulse` | 输出 | `done_error_pulse` |
| `underrun_count` | 输出 | `underrun_count` |

## board_audio_16_48k_i2s_top

定义：[rtl/board/board_audio_16_48k_i2s_top.v:3](https://github.com/wujijun11/git/blob/codex/sustain-20261030/TangMega60K_Synth/rtl/board/board_audio_16_48k_i2s_top.v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)

### u_audio：audio_system_v2

| 子模块端口 | 相对子模块方向 | 父级实际网络/表达式 |
|---|---|---|
| `clk` | 输入 | `audio_clk` |
| `rst_n` | 输入 | `rst_n` |
| `event_valid` | 输入 | `event_valid` |
| `event_ready` | 输出 | `event_ready` |
| `event_on` | 输入 | `event_on` |
| `event_source` | 输入 | `event_source` |
| `event_note` | 输入 | `event_note` |
| `event_velocity` | 输入 | `event_velocity` |
| `event_timbre` | 输入 | `event_timbre` |
| `expr_valid` | 输入 | `1'b0` |
| `expr_ready` | 输出 | 显式未连接() |
| `expr_gain` | 输入 | `12'd2048` |
| `expr_bend_cents` | 输入 | `13'sd0` |
| `expr_vibrato_cents` | 输入 | `8'd0` |
| `i2s_bclk` | 输出 | `i2s_bclk` |
| `i2s_lrclk` | 输出 | `i2s_lrclk` |
| `i2s_data` | 输出 | `i2s_data` |
| `active_count` | 输出 | `active_count` |
| `full_pulse` | 输出 | `full_pulse` |
| `done_error_pulse` | 输出 | `done_error_pulse` |
| `underrun_count` | 输出 | `underruns` |

### u_audio_clock：audio_clock_48k

| 子模块端口 | 相对子模块方向 | 父级实际网络/表达式 |
|---|---|---|
| `clk_50` | 输入 | `sys_clk` |
| `clk_audio` | 输出 | `audio_clk` |
| `locked` | 输出 | `pll_locked` |

该实例未写出的端口：`debug_pll_status`。是否可省略须以该调用用途为准。

### u_board：board_bringup_top

| 子模块端口 | 相对子模块方向 | 父级实际网络/表达式 |
|---|---|---|
| `sys_clk` | 输入 | `sys_clk` |
| `key_n` | 输入 | `key_n` |
| `rgb_data` | 输出 | `rgb_data` |
| `pa_disable` | 输出 | `pa_disable` |
| `board_ready` | 输出 | `board_ready` |
| `keys_pressed` | 输出 | `pressed_50` |
| `status_grb` | 输入 | `24'h000000` |

### u_selftest：poly16_event_source

| 子模块端口 | 相对子模块方向 | 父级实际网络/表达式 |
|---|---|---|
| `clk` | 输入 | `audio_clk` |
| `rst_n` | 输入 | `rst_n` |
| `start` | 输入 | `start_request` |
| `stop` | 输入 | `pressed_sync[1]` |
| `active_count` | 输入 | `active_count` |
| `allocation_error` | 输入 | `full_pulse &#124;&#124; done_error_pulse` |
| `start_ready` | 输出 | `start_ready` |
| `busy` | 输出 | `busy` |
| `holding` | 输出 | `holding` |
| `released_pulse` | 输出 | `released` |
| `error` | 输出 | `error` |
| `event_valid` | 输出 | `event_valid` |
| `event_ready` | 输入 | `event_ready` |
| `event_on` | 输出 | `event_on` |
| `event_source` | 输出 | `event_source` |
| `event_note` | 输出 | `event_note` |
| `event_velocity` | 输出 | `event_velocity` |
| `event_timbre` | 输出 | `event_timbre` |

## board_audio_48k_gao_top

定义：[rtl/board/board_audio_48k_gao_top.v:3](https://github.com/wujijun11/git/blob/codex/sustain-20261030/TangMega60K_Synth/rtl/board/board_audio_48k_gao_top.v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)

### u_audio_clock：audio_clock_48k

| 子模块端口 | 相对子模块方向 | 父级实际网络/表达式 |
|---|---|---|
| `clk_50` | 输入 | `sys_clk` |
| `clk_audio` | 输出 | `audio_clk` |
| `locked` | 输出 | `pll_locked` |

该实例未写出的端口：`debug_pll_status`。是否可省略须以该调用用途为准。

### u_board：board_bringup_top

| 子模块端口 | 相对子模块方向 | 父级实际网络/表达式 |
|---|---|---|
| `sys_clk` | 输入 | `sys_clk` |
| `key_n` | 输入 | `key_n` |
| `rgb_data` | 输出 | `rgb_data` |
| `pa_disable` | 输出 | `pa_disable` |
| `board_ready` | 输出 | `board_ready` |
| `keys_pressed` | 输出 | `pressed` |
| `status_grb` | 输入 | `24'h000000` |

### u_live64：live64_system_top

| 子模块端口 | 相对子模块方向 | 父级实际网络/表达式 |
|---|---|---|
| `clk` | 输入 | `audio_clk` |
| `rst_n` | 输入 | `rst_n` |
| `start` | 输入 | `start_request` |
| `stop` | 输入 | `stop_request` |
| `start_ready` | 输出 | `start_ready` |
| `busy` | 输出 | `busy` |
| `holding` | 输出 | `holding` |
| `released_pulse` | 输出 | `released` |
| `error` | 输出 | `error` |
| `active_count` | 输出 | `active_count` |
| `i2s_bclk` | 输出 | `bclk` |
| `i2s_lrclk` | 输出 | `lrclk` |
| `i2s_data` | 输出 | `serial_data` |
| `underrun_count` | 输出 | `underruns` |

## board_audio_48k_i2s_top

定义：[rtl/board/board_audio_48k_i2s_top.v:4](https://github.com/wujijun11/git/blob/codex/sustain-20261030/TangMega60K_Synth/rtl/board/board_audio_48k_i2s_top.v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)

### u_audio_clock：audio_clock_48k

| 子模块端口 | 相对子模块方向 | 父级实际网络/表达式 |
|---|---|---|
| `clk_50` | 输入 | `sys_clk` |
| `clk_audio` | 输出 | `audio_clk` |
| `locked` | 输出 | `pll_locked` |

该实例未写出的端口：`debug_pll_status`。是否可省略须以该调用用途为准。

### u_board：board_bringup_top

| 子模块端口 | 相对子模块方向 | 父级实际网络/表达式 |
|---|---|---|
| `sys_clk` | 输入 | `sys_clk` |
| `key_n` | 输入 | `key_n` |
| `rgb_data` | 输出 | `rgb_data` |
| `pa_disable` | 输出 | `pa_disable` |
| `board_ready` | 输出 | `board_ready` |
| `keys_pressed` | 输出 | `pressed_50` |
| `status_grb` | 输入 | `24'h000000` |

### u_live64：live64_system_top

| 子模块端口 | 相对子模块方向 | 父级实际网络/表达式 |
|---|---|---|
| `clk` | 输入 | `audio_clk` |
| `rst_n` | 输入 | `rst_n` |
| `start` | 输入 | `start_request` |
| `stop` | 输入 | `pressed_sync[1]` |
| `start_ready` | 输出 | `start_ready` |
| `busy` | 输出 | `busy` |
| `holding` | 输出 | `holding` |
| `released_pulse` | 输出 | `released` |
| `error` | 输出 | `error` |
| `active_count` | 输出 | `active_count` |
| `i2s_bclk` | 输出 | `i2s_bclk` |
| `i2s_lrclk` | 输出 | `i2s_lrclk` |
| `i2s_data` | 输出 | `i2s_data` |
| `underrun_count` | 输出 | `underruns` |

## board_audio_diagnostic_top

定义：[rtl/board/board_audio_diagnostic_top.v:4](https://github.com/wujijun11/git/blob/codex/sustain-20261030/TangMega60K_Synth/rtl/board/board_audio_diagnostic_top.v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)

### u_board：board_bringup_top

| 子模块端口 | 相对子模块方向 | 父级实际网络/表达式 |
|---|---|---|
| `sys_clk` | 输入 | `sys_clk` |
| `key_n` | 输入 | `key_n` |
| `rgb_data` | 输出 | `rgb_data` |
| `pa_disable` | 输出 | `pa_disable` |
| `board_ready` | 输出 | `board_ready` |
| `keys_pressed` | 输出 | `pressed` |
| `status_grb` | 输入 | `status` |

### u_live64：live64_system_top

| 子模块端口 | 相对子模块方向 | 父级实际网络/表达式 |
|---|---|---|
| `clk` | 输入 | `sys_clk` |
| `rst_n` | 输入 | `rst_n` |
| `start` | 输入 | `start_request` |
| `stop` | 输入 | `pressed[1]` |
| `start_ready` | 输出 | `start_ready` |
| `busy` | 输出 | `busy` |
| `holding` | 输出 | `holding` |
| `released_pulse` | 输出 | `released` |
| `error` | 输出 | `error` |
| `active_count` | 输出 | `active_count` |
| `i2s_bclk` | 输出 | `bclk` |
| `i2s_lrclk` | 输出 | `lrclk` |
| `i2s_data` | 输出 | `serial_data` |
| `underrun_count` | 输出 | `underruns` |

## board_audio_gao_top

定义：[rtl/board/board_audio_gao_top.v:3](https://github.com/wujijun11/git/blob/codex/sustain-20261030/TangMega60K_Synth/rtl/board/board_audio_gao_top.v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)

### u_board：board_bringup_top

| 子模块端口 | 相对子模块方向 | 父级实际网络/表达式 |
|---|---|---|
| `sys_clk` | 输入 | `sys_clk` |
| `key_n` | 输入 | `key_n` |
| `rgb_data` | 输出 | `rgb_data` |
| `pa_disable` | 输出 | `pa_disable` |
| `board_ready` | 输出 | `board_ready` |
| `keys_pressed` | 输出 | `pressed` |
| `status_grb` | 输入 | `24'h000000` |

### u_live64：live64_system_top

| 子模块端口 | 相对子模块方向 | 父级实际网络/表达式 |
|---|---|---|
| `clk` | 输入 | `sys_clk` |
| `rst_n` | 输入 | `rst_n` |
| `start` | 输入 | `start_request` |
| `stop` | 输入 | `stop_request` |
| `start_ready` | 输出 | `start_ready` |
| `busy` | 输出 | `busy` |
| `holding` | 输出 | `holding` |
| `released_pulse` | 输出 | `released` |
| `error` | 输出 | `error` |
| `active_count` | 输出 | `active_count` |
| `i2s_bclk` | 输出 | `bclk` |
| `i2s_lrclk` | 输出 | `lrclk` |
| `i2s_data` | 输出 | `serial_data` |
| `underrun_count` | 输出 | `underruns` |

## board_contest_full_top

定义：[rtl/board/board_contest_full_top.v:4](https://github.com/wujijun11/git/blob/codex/sustain-20261030/TangMega60K_Synth/rtl/board/board_contest_full_top.v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)

### align：video_sync_align

| 子模块端口 | 相对子模块方向 | 父级实际网络/表达式 |
|---|---|---|
| `clk` | 输入 | `pixel_clk` |
| `reset` | 输入 | `!video_reset[1]` |
| `hsync_in` | 输入 | `hs` |
| `vsync_in` | 输入 | `vs` |
| `de_in` | 输入 | `de` |
| `hsync_out` | 输出 | `hs_aligned` |
| `vsync_out` | 输出 | `vs_aligned` |
| `de_out` | 输出 | `de_aligned` |

### audio_clock：audio_clock_48k

| 子模块端口 | 相对子模块方向 | 父级实际网络/表达式 |
|---|---|---|
| `clk_50` | 输入 | `sys_clk` |
| `clk_audio` | 输出 | `audio_clk` |
| `locked` | 输出 | `audio_locked` |
| `debug_pll_status` | 输出 | `debug_pll_status` |

### board：board_bringup_top

| 子模块端口 | 相对子模块方向 | 父级实际网络/表达式 |
|---|---|---|
| `sys_clk` | 输入 | `sys_clk` |
| `key_n` | 输入 | `key_n` |
| `rgb_data` | 输出 | `rgb_data` |
| `pa_disable` | 输出 | `pa_disable` |
| `board_ready` | 输出 | `board_ready` |
| `keys_pressed` | 输出 | `pressed_50` |
| `status_grb` | 输入 | `selected_status_grb` |

### display：oled_status_display

| 子模块端口 | 相对子模块方向 | 父级实际网络/表达式 |
|---|---|---|
| `clk` | 输入 | `audio_clk` |
| `rst_n` | 输入 | `rst_n` |
| `main_menu` | 输入 | `menu_main` |
| `menu_page` | 输入 | `menu_page` |
| `zone` | 输入 | `menu_zone` |
| `recording` | 输入 | `recording` |
| `playing` | 输入 | `playing` |
| `guide` | 输入 | `guide` |
| `busy` | 输入 | `menu_busy` |
| `error` | 输入 | `menu_error` |
| `record_count` | 输入 | `menu_record_count` |
| `performance_mode` | 输入 | `menu_volume_mode` |
| `volume_percent` | 输入 | `menu_volume_percent` |
| `scl` | 双向 | `oled_scl` |
| `sda` | 双向 | `oled_sda` |
| `fault` | 输出 | `oled_fault` |
| `completed_frames` | 输出 | `oled_completed_frames` |
| `ui_activity` | 输入 | `menu_touch_active` |
| `audio_sample_valid` | 输入 | `oled_audio_sample_valid` |
| `audio_sample` | 输入 | `debug_transmit_left` |
| `hierarchy_view` | 输入 | `menu_view` |
| `expression_mode` | 输入 | `menu_expression_mode` |
| `external_waveform_view` | 输入 | `menu_waveform_view` |
| `control_value` | 输入 | `menu_control_value` |
| `control_negative` | 输入 | `menu_control_negative` |
| `control_percent` | 输入 | `menu_control_percent` |
| `sustain_enabled` | 输入 | `sustain_enabled` |

### local_actions：board_local_actions

| 子模块端口 | 相对子模块方向 | 父级实际网络/表达式 |
|---|---|---|
| `clk` | 输入 | `audio_clk` |
| `rst_n` | 输入 | `rst_n` |
| `keys_pressed` | 输入 | `pressed_sync[1:0]` |
| `playing` | 输入 | `playing` |
| `guide` | 输入 | `guide` |
| `local_action_valid` | 输出 | `local_valid` |
| `local_action_ready` | 输入 | `local_ready` |
| `local_action` | 输出 | `action` |

### status_monitor：audio_boot_status

| 子模块端口 | 相对子模块方向 | 父级实际网络/表达式 |
|---|---|---|
| `clk` | 输入 | `sys_clk` |
| `snapshot` | 输入 | `debug_status` |
| `status_grb` | 输出 | `boot_status_grb` |

### system：instrument_full_system

| 子模块端口 | 相对子模块方向 | 父级实际网络/表达式 |
|---|---|---|
| `clk` | 输入 | `audio_clk` |
| `rst_n` | 输入 | `rst_n` |
| `uart_rx` | 输入 | `uart_rx` |
| `uart_tx` | 输出 | `uart_tx` |
| `mpr_scl` | 双向 | `mpr_scl` |
| `mpr_sda` | 双向 | `mpr_sda` |
| `mpr_irq_n` | 输入 | `mpr_irq_n` |
| `local_action_valid` | 输入 | `local_valid` |
| `local_action_ready` | 输出 | `local_ready` |
| `local_action` | 输入 | `action` |
| `i2s_bclk` | 输出 | `i2s_bclk` |
| `i2s_lrclk` | 输出 | `i2s_lrclk` |
| `i2s_data` | 输出 | `i2s_data` |
| `guide_led_data` | 输出 | `guide_led_data` |
| `active_count` | 输出 | `voices` |
| `touch_mask` | 输出 | `debug_touch` |
| `sensor_ready` | 输出 | `sensor_ready` |
| `sensor_fault` | 输出 | `sensor_fault` |
| `underrun_count` | 输出 | `underruns` |
| `overflow_sticky` | 输出 | `overflow` |
| `playing` | 输出 | `playing` |
| `recording` | 输出 | `recording` |
| `guide_active` | 输出 | `guide` |
| `video_clk` | 输入 | `pixel_clk` |
| `video_x` | 输入 | `x` |
| `video_y` | 输入 | `y` |
| `video_de` | 输入 | `de` |
| `video_rgb` | 输出 | `rgb` |
| `debug_transmit_left` | 输出 | `debug_transmit_left` |
| `debug_last_note` | 输出 | `debug_note` |
| `debug_audio_reset_status` | 输出 | `debug_audio_reset_status` |
| `menu_main` | 输出 | `menu_main` |
| `menu_page` | 输出 | `menu_page` |
| `menu_zone` | 输出 | `menu_zone` |
| `menu_busy` | 输出 | `menu_busy` |
| `menu_error` | 输出 | `menu_error` |
| `menu_record_count` | 输出 | `menu_record_count` |
| `menu_volume_mode` | 输出 | `menu_volume_mode` |
| `menu_volume_percent` | 输出 | `menu_volume_percent` |
| `menu_touch_active` | 输出 | `menu_touch_active` |
| `menu_view` | 输出 | `menu_view` |
| `menu_expression_mode` | 输出 | `menu_expression_mode` |
| `menu_waveform_view` | 输出 | `menu_waveform_view` |
| `menu_control_value` | 输出 | `menu_control_value` |
| `menu_control_negative` | 输出 | `menu_control_negative` |
| `menu_control_percent` | 输出 | `menu_control_percent` |
| `sustain_enabled` | 输出 | `sustain_enabled` |
| `sustain_deferred_count` | 输出 | 显式未连接() |

该实例未写出的端口：`guide_mask`、`menu_prompt_code`、`menu_prompt_valid`、`menu_timbre`、`menu_transpose`、`monitor_left`、`monitor_right`、`monitor_valid`。是否可省略须以该调用用途为准。

### timing：video_timing_640x480

| 子模块端口 | 相对子模块方向 | 父级实际网络/表达式 |
|---|---|---|
| `clk` | 输入 | `pixel_clk` |
| `reset` | 输入 | `!video_reset[1]` |
| `pixel_x` | 输出 | `x` |
| `pixel_y` | 输出 | `y` |
| `hsync` | 输出 | `hs` |
| `vsync` | 输出 | `vs` |
| `de` | 输出 | `de` |

### video：video_tmds_tx

| 子模块端口 | 相对子模块方向 | 父级实际网络/表达式 |
|---|---|---|
| `clk_pixel` | 输入 | `pixel_clk` |
| `clk_serial` | 输入 | `serial_clk` |
| `reset` | 输入 | `!video_reset[1]` |
| `red` | 输入 | `rgb[23:16]` |
| `green` | 输入 | `rgb[15:8]` |
| `blue` | 输入 | `rgb[7:0]` |
| `hsync` | 输入 | `hs_aligned` |
| `vsync` | 输入 | `vs_aligned` |
| `de` | 输入 | `de_aligned` |
| `tmds_clk_p` | 输出 | `tmds_clk_p` |
| `tmds_clk_n` | 输出 | `tmds_clk_n` |
| `tmds_data_p` | 输出 | `tmds_data_p` |
| `tmds_data_n` | 输出 | `tmds_data_n` |

### video_clock：video_clocking

| 子模块端口 | 相对子模块方向 | 父级实际网络/表达式 |
|---|---|---|
| `clk_50` | 输入 | `sys_clk` |
| `reset` | 输入 | `1'b0` |
| `clk_pixel` | 输出 | `pixel_clk` |
| `clk_serial` | 输出 | `serial_clk` |
| `locked` | 输出 | `video_locked` |

## board_instrument_b_48k_gao_top

定义：[rtl/board/board_instrument_b_48k_gao_top.v:3](https://github.com/wujijun11/git/blob/codex/sustain-20261030/TangMega60K_Synth/rtl/board/board_instrument_b_48k_gao_top.v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)

### u_audio_clock：audio_clock_48k

| 子模块端口 | 相对子模块方向 | 父级实际网络/表达式 |
|---|---|---|
| `clk_50` | 输入 | `sys_clk` |
| `clk_audio` | 输出 | `audio_clk` |
| `locked` | 输出 | `pll_locked` |

该实例未写出的端口：`debug_pll_status`。是否可省略须以该调用用途为准。

### u_board：board_bringup_top

| 子模块端口 | 相对子模块方向 | 父级实际网络/表达式 |
|---|---|---|
| `sys_clk` | 输入 | `sys_clk` |
| `key_n` | 输入 | `key_n` |
| `rgb_data` | 输出 | `rgb_data` |
| `pa_disable` | 输出 | `pa_disable` |
| `board_ready` | 输出 | `board_ready` |
| `keys_pressed` | 输出 | `pressed_50` |
| `status_grb` | 输入 | `status_grb` |

### u_instrument：instrument_system_v2

| 子模块端口 | 相对子模块方向 | 父级实际网络/表达式 |
|---|---|---|
| `clk` | 输入 | `audio_clk` |
| `rst_n` | 输入 | `rst_n` |
| `key_valid` | 输入 | `key_valid` |
| `key_ready` | 输出 | `key_ready` |
| `key_on` | 输入 | `key_on` |
| `key_source` | 输入 | `6'd1` |
| `key_note` | 输入 | `key_on ? 7'd69 : 7'd100` |
| `key_velocity` | 输入 | `key_on ? 7'd100 : 7'd0` |
| `key_timbre` | 输入 | `key_on ? 2'd2 : 2'd0` |
| `chord_valid` | 输入 | `chord_valid` |
| `chord_ready` | 输出 | `chord_ready` |
| `chord_on` | 输入 | `chord_on` |
| `chord_id` | 输入 | `3'd0` |
| `chord_source` | 输入 | `6'd2` |
| `chord_count` | 输入 | `4'd3` |
| `chord_notes_flat` | 输入 | `chord_on ? {35'd0, 7'd67, 7'd64, 7'd60} : 56'd0` |
| `chord_velocity` | 输入 | `chord_on ? 7'd100 : 7'd0` |
| `chord_timbre` | 输入 | `chord_on ? 2'd2 : 2'd0` |
| `expr_update_valid` | 输入 | `expr_update_valid` |
| `expr_update_ready` | 输出 | `expr_update_ready` |
| `expr_update_mask` | 输入 | `3'b111` |
| `expr_update_gain` | 输入 | `12'd1800` |
| `expr_update_bend_cents` | 输入 | `13'sd25` |
| `expr_update_vibrato_cents` | 输入 | `8'd7` |
| `i2s_bclk` | 输出 | `bclk` |
| `i2s_lrclk` | 输出 | `lrclk` |
| `i2s_data` | 输出 | `serial_data` |
| `active_count` | 输出 | `active_count` |
| `voice_full_pulse` | 输出 | `voice_full_pulse` |
| `done_error_pulse` | 输出 | `done_error_pulse` |
| `i2s_underrun_count` | 输出 | `underruns` |
| `event_fifo_level` | 输出 | `event_fifo_level` |
| `event_fifo_full` | 输出 | `event_fifo_full` |
| `event_backpressure` | 输出 | `event_backpressure` |
| `event_overflow_pulse` | 输出 | `event_overflow_pulse` |
| `event_overflow_sticky` | 输出 | `event_overflow_sticky` |
| `event_overflow_count` | 输出 | `event_overflow_count` |
| `events_pushed` | 输出 | `events_pushed` |
| `events_delivered` | 输出 | `events_delivered` |
| `current_expr_gain` | 输出 | `current_expr_gain` |
| `current_expr_bend_cents` | 输出 | `current_expr_bend_cents` |
| `current_expr_vibrato_cents` | 输出 | `current_expr_vibrato_cents` |

## board_instrument_b_48k_i2s_top

定义：[rtl/board/board_instrument_b_48k_i2s_top.v:4](https://github.com/wujijun11/git/blob/codex/sustain-20261030/TangMega60K_Synth/rtl/board/board_instrument_b_48k_i2s_top.v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)

### u_audio_clock：audio_clock_48k

| 子模块端口 | 相对子模块方向 | 父级实际网络/表达式 |
|---|---|---|
| `clk_50` | 输入 | `sys_clk` |
| `clk_audio` | 输出 | `audio_clk` |
| `locked` | 输出 | `pll_locked` |

该实例未写出的端口：`debug_pll_status`。是否可省略须以该调用用途为准。

### u_board：board_bringup_top

| 子模块端口 | 相对子模块方向 | 父级实际网络/表达式 |
|---|---|---|
| `sys_clk` | 输入 | `sys_clk` |
| `key_n` | 输入 | `key_n` |
| `rgb_data` | 输出 | `rgb_data` |
| `pa_disable` | 输出 | `pa_disable` |
| `board_ready` | 输出 | `board_ready` |
| `keys_pressed` | 输出 | `pressed_50` |
| `status_grb` | 输入 | `24'h000000` |

### u_instrument：instrument_system_v2

| 子模块端口 | 相对子模块方向 | 父级实际网络/表达式 |
|---|---|---|
| `clk` | 输入 | `audio_clk` |
| `rst_n` | 输入 | `instrument_rst_n` |
| `key_valid` | 输入 | `key_valid` |
| `key_ready` | 输出 | `key_ready` |
| `key_on` | 输入 | `key_on` |
| `key_source` | 输入 | `key_source` |
| `key_note` | 输入 | `key_note` |
| `key_velocity` | 输入 | `key_velocity` |
| `key_timbre` | 输入 | `key_timbre` |
| `chord_valid` | 输入 | `chord_valid` |
| `chord_ready` | 输出 | `chord_ready` |
| `chord_on` | 输入 | `chord_on` |
| `chord_id` | 输入 | `chord_id` |
| `chord_source` | 输入 | `chord_source` |
| `chord_count` | 输入 | `chord_count` |
| `chord_notes_flat` | 输入 | `chord_notes_flat` |
| `chord_velocity` | 输入 | `chord_velocity` |
| `chord_timbre` | 输入 | `chord_timbre` |
| `expr_update_valid` | 输入 | `1'b0` |
| `expr_update_ready` | 输出 | 显式未连接() |
| `expr_update_mask` | 输入 | `3'b000` |
| `expr_update_gain` | 输入 | `12'd2048` |
| `expr_update_bend_cents` | 输入 | `13'sd0` |
| `expr_update_vibrato_cents` | 输入 | `8'd0` |
| `i2s_bclk` | 输出 | `i2s_bclk` |
| `i2s_lrclk` | 输出 | `i2s_lrclk` |
| `i2s_data` | 输出 | `i2s_data` |
| `active_count` | 输出 | `active_count` |
| `voice_full_pulse` | 输出 | `voice_full_pulse` |
| `done_error_pulse` | 输出 | `done_error_pulse` |
| `i2s_underrun_count` | 输出 | `underruns` |
| `event_fifo_level` | 输出 | `event_fifo_level` |
| `event_fifo_full` | 输出 | `event_fifo_full` |
| `event_backpressure` | 输出 | `event_backpressure` |
| `event_overflow_pulse` | 输出 | `event_overflow_pulse` |
| `event_overflow_sticky` | 输出 | `event_overflow_sticky` |
| `event_overflow_count` | 输出 | `event_overflow_count` |
| `events_pushed` | 输出 | `events_pushed` |
| `events_delivered` | 输出 | `events_delivered` |
| `current_expr_gain` | 输出 | `current_expr_gain` |
| `current_expr_bend_cents` | 输出 | `current_expr_bend_cents` |
| `current_expr_vibrato_cents` | 输出 | `current_expr_vibrato_cents` |

### u_keys：board_key_event_adapter

| 子模块端口 | 相对子模块方向 | 父级实际网络/表达式 |
|---|---|---|
| `clk` | 输入 | `audio_clk` |
| `rst_n` | 输入 | `rst_n` |
| `pressed` | 输入 | `pressed_sync[1:0]` |
| `key_valid` | 输出 | `key_valid` |
| `key_ready` | 输入 | `key_ready` |
| `key_on` | 输出 | `key_on` |
| `key_source` | 输出 | `key_source` |
| `key_note` | 输出 | `key_note` |
| `key_velocity` | 输出 | `key_velocity` |
| `key_timbre` | 输出 | `key_timbre` |
| `chord_valid` | 输出 | `chord_valid` |
| `chord_ready` | 输入 | `chord_ready` |
| `chord_on` | 输出 | `chord_on` |
| `chord_id` | 输出 | `chord_id` |
| `chord_source` | 输出 | `chord_source` |
| `chord_count` | 输出 | `chord_count` |
| `chord_notes_flat` | 输出 | `chord_notes_flat` |
| `chord_velocity` | 输出 | `chord_velocity` |
| `chord_timbre` | 输出 | `chord_timbre` |
| `overflow_pulse` | 输出 | `input_overflow_pulse` |
| `overflow_sticky` | 输出 | `input_overflow_sticky` |
| `pending_count` | 输出 | `input_pending_count` |

## board_sequence16_48k_i2s_top

定义：[rtl/board/board_sequence16_48k_i2s_top.v:3](https://github.com/wujijun11/git/blob/codex/sustain-20261030/TangMega60K_Synth/rtl/board/board_sequence16_48k_i2s_top.v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)

### u_audio：audio_system_v2

| 子模块端口 | 相对子模块方向 | 父级实际网络/表达式 |
|---|---|---|
| `clk` | 输入 | `audio_clk` |
| `rst_n` | 输入 | `rst_n` |
| `event_valid` | 输入 | `event_valid` |
| `event_ready` | 输出 | `event_ready` |
| `event_on` | 输入 | `event_on` |
| `event_source` | 输入 | `event_source` |
| `event_note` | 输入 | `event_note` |
| `event_velocity` | 输入 | `event_velocity` |
| `event_timbre` | 输入 | `event_timbre` |
| `expr_valid` | 输入 | `1'b0` |
| `expr_ready` | 输出 | 显式未连接() |
| `expr_gain` | 输入 | `12'd2048` |
| `expr_bend_cents` | 输入 | `13'sd0` |
| `expr_vibrato_cents` | 输入 | `8'd0` |
| `i2s_bclk` | 输出 | `i2s_bclk` |
| `i2s_lrclk` | 输出 | `i2s_lrclk` |
| `i2s_data` | 输出 | `i2s_data` |
| `active_count` | 输出 | `active_count` |
| `full_pulse` | 输出 | `full_pulse` |
| `done_error_pulse` | 输出 | `done_error_pulse` |
| `underrun_count` | 输出 | `underruns` |

### u_audio_clock：audio_clock_48k

| 子模块端口 | 相对子模块方向 | 父级实际网络/表达式 |
|---|---|---|
| `clk_50` | 输入 | `sys_clk` |
| `clk_audio` | 输出 | `audio_clk` |
| `locked` | 输出 | `pll_locked` |

该实例未写出的端口：`debug_pll_status`。是否可省略须以该调用用途为准。

### u_board：board_bringup_top

| 子模块端口 | 相对子模块方向 | 父级实际网络/表达式 |
|---|---|---|
| `sys_clk` | 输入 | `sys_clk` |
| `key_n` | 输入 | `key_n` |
| `rgb_data` | 输出 | `rgb_data` |
| `pa_disable` | 输出 | `pa_disable` |
| `board_ready` | 输出 | `board_ready` |
| `keys_pressed` | 输出 | `pressed_50` |
| `status_grb` | 输入 | `24'h000000` |

### u_selftest：sequence16_event_source

| 子模块端口 | 相对子模块方向 | 父级实际网络/表达式 |
|---|---|---|
| `clk` | 输入 | `audio_clk` |
| `rst_n` | 输入 | `rst_n` |
| `start` | 输入 | `start_request` |
| `stop` | 输入 | `pressed_sync[1]` |
| `active_count` | 输入 | `active_count` |
| `allocation_error` | 输入 | `full_pulse &#124;&#124; done_error_pulse` |
| `start_ready` | 输出 | `start_ready` |
| `busy` | 输出 | `busy` |
| `holding` | 输出 | `holding` |
| `released_pulse` | 输出 | `released` |
| `error` | 输出 | `error` |
| `event_valid` | 输出 | `event_valid` |
| `event_ready` | 输入 | `event_ready` |
| `event_on` | 输出 | `event_on` |
| `event_source` | 输出 | `event_source` |
| `event_note` | 输出 | `event_note` |
| `event_velocity` | 输出 | `event_velocity` |
| `event_timbre` | 输出 | `event_timbre` |

## captain_control_top

定义：[rtl/captain_control_top.v:4](https://github.com/wujijun11/git/blob/codex/sustain-20261030/TangMega60K_Synth/rtl/captain_control_top.v#L4)

### u_allocator：voice_allocator

| 子模块端口 | 相对子模块方向 | 父级实际网络/表达式 |
|---|---|---|
| `clk` | 输入 | `clk` |
| `rst_n` | 输入 | `rst_n` |
| `event_valid` | 输入 | `event_valid` |
| `event_ready` | 输出 | `event_ready` |
| `event_on` | 输入 | `event_on` |
| `event_note` | 输入 | `event_note` |
| `event_velocity` | 输入 | `event_velocity` |
| `event_timbre` | 输入 | `event_timbre` |
| `cmd_valid` | 输出 | `cmd_valid` |
| `cmd_ready` | 输入 | `cmd_ready` |
| `cmd_on` | 输出 | `cmd_on` |
| `cmd_voice` | 输出 | `cmd_voice` |
| `cmd_note` | 输出 | `cmd_note` |
| `cmd_velocity` | 输出 | `cmd_velocity` |
| `cmd_timbre` | 输出 | `cmd_timbre` |
| `done_valid` | 输入 | `done_valid` |
| `done_ready` | 输出 | `done_ready` |
| `done_voice` | 输入 | `done_voice` |
| `active_count` | 输出 | `active_count` |
| `active_mask` | 输出 | `active_mask` |
| `held_mask` | 输出 | `held_mask` |
| `full_pulse` | 输出 | `full_pulse` |
| `ignored_pulse` | 输出 | `ignored_pulse` |
| `done_error_pulse` | 输出 | `done_error_pulse` |

## captain_control_top_v2

定义：[rtl/captain_control_top_v2.v:4](https://github.com/wujijun11/git/blob/codex/sustain-20261030/TangMega60K_Synth/rtl/captain_control_top_v2.v#L4)

### u_allocator：voice_allocator_v2

| 子模块端口 | 相对子模块方向 | 父级实际网络/表达式 |
|---|---|---|
| `clk` | 输入 | `clk` |
| `rst_n` | 输入 | `rst_n` |
| `event_valid` | 输入 | `event_valid` |
| `event_ready` | 输出 | `event_ready` |
| `event_on` | 输入 | `event_on` |
| `event_source` | 输入 | `event_source` |
| `event_note` | 输入 | `event_note` |
| `event_velocity` | 输入 | `event_velocity` |
| `event_timbre` | 输入 | `event_timbre` |
| `cmd_valid` | 输出 | `cmd_valid` |
| `cmd_ready` | 输入 | `cmd_ready` |
| `cmd_on` | 输出 | `cmd_on` |
| `cmd_voice` | 输出 | `cmd_voice` |
| `cmd_note` | 输出 | `cmd_note` |
| `cmd_velocity` | 输出 | `cmd_velocity` |
| `cmd_timbre` | 输出 | `cmd_timbre` |
| `done_valid` | 输入 | `done_valid` |
| `done_ready` | 输出 | `done_ready` |
| `done_voice` | 输入 | `done_voice` |
| `active_count` | 输出 | `active_count` |
| `active_mask` | 输出 | `active_mask` |
| `held_mask` | 输出 | `held_mask` |
| `full_pulse` | 输出 | `full_pulse` |
| `ignored_pulse` | 输出 | `ignored_pulse` |
| `done_error_pulse` | 输出 | `done_error_pulse` |

### u_expression：expression_controls_v2

| 子模块端口 | 相对子模块方向 | 父级实际网络/表达式 |
|---|---|---|
| `clk` | 输入 | `clk` |
| `rst_n` | 输入 | `rst_n` |
| `expr_valid` | 输入 | `expr_valid` |
| `expr_ready` | 输出 | `expr_ready` |
| `expr_gain` | 输入 | `expr_gain` |
| `expr_bend_cents` | 输入 | `expr_bend_cents` |
| `expr_vibrato_cents` | 输入 | `expr_vibrato_cents` |
| `engine_sample_begin` | 输入 | `engine_sample_begin` |
| `active_gain` | 输出 | `active_gain` |
| `active_bend_cents` | 输出 | `active_bend_cents` |
| `active_vibrato_cents` | 输出 | `active_vibrato_cents` |
| `expr_applied` | 输出 | `expr_applied` |

## captain_system_top

定义：[rtl/captain_system_top.v:4](https://github.com/wujijun11/git/blob/codex/sustain-20261030/TangMega60K_Synth/rtl/captain_system_top.v#L4)

### u_audio：i2s_tx

| 子模块端口 | 相对子模块方向 | 父级实际网络/表达式 |
|---|---|---|
| `clk` | 输入 | `clk` |
| `rst_n` | 输入 | `rst_n` |
| `sample_valid` | 输入 | `sample_valid` |
| `sample_ready` | 输出 | `sample_ready` |
| `sample_left` | 输入 | `sample_left` |
| `sample_right` | 输入 | `sample_right` |
| `i2s_bclk` | 输出 | `i2s_bclk` |
| `i2s_lrclk` | 输出 | `i2s_lrclk` |
| `i2s_data` | 输出 | `i2s_data` |
| `frame_tick` | 输出 | `frame_tick` |
| `fifo_level` | 输出 | `fifo_level` |
| `underrun_pulse` | 输出 | `underrun_pulse` |
| `underrun_sticky` | 输出 | `underrun_sticky` |
| `underrun_count` | 输出 | `underrun_count` |

该实例未写出的端口：`debug_frame_left`。是否可省略须以该调用用途为准。

### u_control：captain_control_top

| 子模块端口 | 相对子模块方向 | 父级实际网络/表达式 |
|---|---|---|
| `clk` | 输入 | `clk` |
| `rst_n` | 输入 | `rst_n` |
| `event_valid` | 输入 | `event_valid` |
| `event_ready` | 输出 | `event_ready` |
| `event_on` | 输入 | `event_on` |
| `event_note` | 输入 | `event_note` |
| `event_velocity` | 输入 | `event_velocity` |
| `event_timbre` | 输入 | `event_timbre` |
| `cmd_valid` | 输出 | `cmd_valid` |
| `cmd_ready` | 输入 | `cmd_ready` |
| `cmd_on` | 输出 | `cmd_on` |
| `cmd_voice` | 输出 | `cmd_voice` |
| `cmd_note` | 输出 | `cmd_note` |
| `cmd_velocity` | 输出 | `cmd_velocity` |
| `cmd_timbre` | 输出 | `cmd_timbre` |
| `done_valid` | 输入 | `done_valid` |
| `done_ready` | 输出 | `done_ready` |
| `done_voice` | 输入 | `done_voice` |
| `active_count` | 输出 | `active_count` |
| `active_mask` | 输出 | `active_mask` |
| `held_mask` | 输出 | `held_mask` |
| `full_pulse` | 输出 | `full_pulse` |
| `ignored_pulse` | 输出 | `ignored_pulse` |
| `done_error_pulse` | 输出 | `done_error_pulse` |

## captain_system_top_v2

定义：[rtl/captain_system_top_v2.v:4](https://github.com/wujijun11/git/blob/codex/sustain-20261030/TangMega60K_Synth/rtl/captain_system_top_v2.v#L4)

### u_audio：i2s_tx

| 子模块端口 | 相对子模块方向 | 父级实际网络/表达式 |
|---|---|---|
| `clk` | 输入 | `clk` |
| `rst_n` | 输入 | `rst_n` |
| `sample_valid` | 输入 | `sample_valid` |
| `sample_ready` | 输出 | `sample_ready` |
| `sample_left` | 输入 | `sample_left` |
| `sample_right` | 输入 | `sample_right` |
| `i2s_bclk` | 输出 | `i2s_bclk` |
| `i2s_lrclk` | 输出 | `i2s_lrclk` |
| `i2s_data` | 输出 | `i2s_data` |
| `frame_tick` | 输出 | `frame_tick` |
| `fifo_level` | 输出 | `fifo_level` |
| `underrun_pulse` | 输出 | `underrun_pulse` |
| `underrun_sticky` | 输出 | `underrun_sticky` |
| `underrun_count` | 输出 | `underrun_count` |

该实例未写出的端口：`debug_frame_left`。是否可省略须以该调用用途为准。

### u_control：captain_control_top_v2

| 子模块端口 | 相对子模块方向 | 父级实际网络/表达式 |
|---|---|---|
| `clk` | 输入 | `clk` |
| `rst_n` | 输入 | `rst_n` |
| `event_valid` | 输入 | `event_valid` |
| `event_ready` | 输出 | `event_ready` |
| `event_on` | 输入 | `event_on` |
| `event_source` | 输入 | `event_source` |
| `event_note` | 输入 | `event_note` |
| `expr_valid` | 输入 | `expr_valid` |
| `expr_ready` | 输出 | `expr_ready` |
| `expr_gain` | 输入 | `expr_gain` |
| `expr_bend_cents` | 输入 | `expr_bend_cents` |
| `expr_vibrato_cents` | 输入 | `expr_vibrato_cents` |
| `engine_sample_begin` | 输入 | `engine_sample_begin` |
| `active_gain` | 输出 | `active_gain` |
| `active_bend_cents` | 输出 | `active_bend_cents` |
| `active_vibrato_cents` | 输出 | `active_vibrato_cents` |
| `expr_applied` | 输出 | `expr_applied` |
| `event_velocity` | 输入 | `event_velocity` |
| `event_timbre` | 输入 | `event_timbre` |
| `cmd_valid` | 输出 | `cmd_valid` |
| `cmd_ready` | 输入 | `cmd_ready` |
| `cmd_on` | 输出 | `cmd_on` |
| `cmd_voice` | 输出 | `cmd_voice` |
| `cmd_note` | 输出 | `cmd_note` |
| `cmd_velocity` | 输出 | `cmd_velocity` |
| `cmd_timbre` | 输出 | `cmd_timbre` |
| `done_valid` | 输入 | `done_valid` |
| `done_ready` | 输出 | `done_ready` |
| `done_voice` | 输入 | `done_voice` |
| `active_count` | 输出 | `active_count` |
| `active_mask` | 输出 | `active_mask` |
| `held_mask` | 输出 | `held_mask` |
| `full_pulse` | 输出 | `full_pulse` |
| `ignored_pulse` | 输出 | `ignored_pulse` |
| `done_error_pulse` | 输出 | `done_error_pulse` |

## instrument_full_system

定义：[rtl/instrument_full_system.v:3](https://github.com/wujijun11/git/blob/codex/sustain-20261030/TangMega60K_Synth/rtl/instrument_full_system.v#L3)

### arbiter：note_arbiter

| 子模块端口 | 相对子模块方向 | 父级实际网络/表达式 |
|---|---|---|
| `clk` | 输入 | `clk` |
| `rst_n` | 输入 | `audio_rst_n` |
| `in_valid` | 输入 | `{watchdog_ev,perf_ev,remote_ev,sensor_ev && !sensor_blocked}` |
| `in_ready` | 输出 | `arb_ready` |
| `in_payload` | 输入 | `{watchdog_on,watchdog_source,watchdog_note,watchdog_velocity,watchdog_timbre, perf_on,perf_source,perf_note,perf_velocity,perf_timbre, remote_on,remote_source,remote_note,remote_velocity,remote_timbre, sensor_on,sensor_source,sensor_note,sensor_velocity,sensor_timbre}` |
| `out_valid` | 输出 | `arbiter_push_valid` |
| `out_ready` | 输入 | `push_ready` |
| `out_payload` | 输出 | `push_payload` |
| `selected` | 输出 | `arb_selected` |

### audio：i2s_tx

| 子模块端口 | 相对子模块方向 | 父级实际网络/表达式 |
|---|---|---|
| `clk` | 输入 | `clk` |
| `rst_n` | 输入 | `audio_rst_n` |
| `sample_valid` | 输入 | `post_valid` |
| `sample_ready` | 输出 | `post_ready` |
| `sample_left` | 输入 | `post_l` |
| `sample_right` | 输入 | `post_r` |
| `i2s_bclk` | 输出 | `i2s_bclk` |
| `i2s_lrclk` | 输出 | `i2s_lrclk` |
| `i2s_data` | 输出 | `i2s_data` |
| `underrun_count` | 输出 | `underrun_count` |
| `debug_frame_left` | 输出 | `debug_transmit_left` |

该实例未写出的端口：`fifo_level`、`frame_tick`、`underrun_pulse`、`underrun_sticky`。是否可省略须以该调用用途为准。

### control：captain_control_top_v2

| 子模块端口 | 相对子模块方向 | 父级实际网络/表达式 |
|---|---|---|
| `clk` | 输入 | `clk` |
| `rst_n` | 输入 | `audio_rst_n` |
| `event_valid` | 输入 | `ev` |
| `event_ready` | 输出 | `er` |
| `event_on` | 输入 | `eon` |
| `event_source` | 输入 | `es` |
| `event_note` | 输入 | `en` |
| `event_velocity` | 输入 | `evel` |
| `event_timbre` | 输入 | `et` |
| `expr_valid` | 输入 | `xv` |
| `expr_ready` | 输出 | `xr` |
| `expr_gain` | 输入 | `xg` |
| `expr_bend_cents` | 输入 | `xb` |
| `expr_vibrato_cents` | 输入 | `vib` |
| `engine_sample_begin` | 输入 | `sample_begin` |
| `active_gain` | 输出 | `gain` |
| `active_bend_cents` | 输出 | `bend` |
| `active_vibrato_cents` | 输出 | `vibrato` |
| `cmd_valid` | 输出 | `cmdv` |
| `cmd_ready` | 输入 | `cmdr` |
| `cmd_on` | 输出 | `cmdon` |
| `cmd_voice` | 输出 | `voice` |
| `cmd_note` | 输出 | `note` |
| `cmd_velocity` | 输出 | `velocity` |
| `cmd_timbre` | 输出 | `tone` |
| `done_valid` | 输入 | `dv` |
| `done_ready` | 输出 | `dr` |
| `done_voice` | 输入 | `done_voice` |
| `active_count` | 输出 | `active_count` |

该实例未写出的端口：`active_mask`、`done_error_pulse`、`expr_applied`、`full_pulse`、`held_mask`、`ignored_pulse`。是否可省略须以该调用用途为准。

### effects：runtime_audio_fx

| 子模块端口 | 相对子模块方向 | 父级实际网络/表达式 |
|---|---|---|
| `clk` | 输入 | `clk` |
| `rst_n` | 输入 | `audio_rst_n` |
| `mode` | 输入 | `fx` |
| `in_valid` | 输入 | `pcm_valid` |
| `in_ready` | 输出 | `pcm_ready` |
| `in_left` | 输入 | `pcm_l` |
| `in_right` | 输入 | `pcm_r` |
| `out_valid` | 输出 | `fx_valid` |
| `out_ready` | 输入 | `fx_ready` |
| `out_left` | 输出 | `fx_l` |
| `out_right` | 输出 | `fx_r` |

### events：event_fifo_v2

| 子模块端口 | 相对子模块方向 | 父级实际网络/表达式 |
|---|---|---|
| `clk` | 输入 | `clk` |
| `rst_n` | 输入 | `audio_rst_n` |
| `push_valid` | 输入 | `push_valid` |
| `push_ready` | 输出 | `push_ready` |
| `push_on` | 输入 | `push_payload[22]` |
| `push_source` | 输入 | `push_payload[21:16]` |
| `push_note` | 输入 | `push_payload[15:9]` |
| `push_velocity` | 输入 | `push_payload[8:2]` |
| `push_timbre` | 输入 | `push_payload[1:0]` |
| `pop_valid` | 输出 | `ev` |
| `pop_ready` | 输入 | `er` |
| `pop_on` | 输出 | `eon` |
| `pop_source` | 输出 | `es` |
| `pop_note` | 输出 | `en` |
| `pop_velocity` | 输出 | `evel` |
| `pop_timbre` | 输出 | `et` |

该实例未写出的端口：`empty`、`full`、`level`。是否可省略须以该调用用途为准。

### expression：expression_merge

| 子模块端口 | 相对子模块方向 | 父级实际网络/表达式 |
|---|---|---|
| `clk` | 输入 | `clk` |
| `rst_n` | 输入 | `audio_rst_n` |
| `a_valid` | 输入 | `local_expression_enabled ? volume_xv : slider_xv` |
| `a_ready` | 输出 | `expression_a_ready` |
| `a_mask` | 输入 | `local_expression_enabled ? local_expression_mask : slider_xm` |
| `a_gain` | 输入 | `local_expression_enabled ? volume_gain : slider_gain` |
| `a_bend` | 输入 | `local_expression_bend` |
| `a_vibrato` | 输入 | `local_expression_vibrato` |
| `b_valid` | 输入 | `phone_xv` |
| `b_ready` | 输出 | `phone_xr` |
| `b_mask` | 输入 | `phone_xm` |
| `b_gain` | 输入 | `phone_gain` |
| `b_bend` | 输入 | `phone_bend` |
| `b_vibrato` | 输入 | `phone_vib` |
| `out_valid` | 输出 | `xv` |
| `out_ready` | 输入 | `xr` |
| `out_gain` | 输出 | `xg` |
| `out_bend` | 输出 | `xb` |
| `out_vibrato` | 输出 | `vib` |

### guide：ws2812_guide

| 子模块端口 | 相对子模块方向 | 父级实际网络/表达式 |
|---|---|---|
| `clk` | 输入 | `clk` |
| `rst_n` | 输入 | `rst_n` |
| `guide_mask` | 输入 | `guide_mask` |
| `touch_mask` | 输入 | `touch_mask` |
| `led_data` | 输出 | `guide_led_data` |

该实例未写出的端口：`busy`、`frame_done`。是否可省略须以该调用用途为准。

### local_controls：local_action_arbiter

| 子模块端口 | 相对子模块方向 | 父级实际网络/表达式 |
|---|---|---|
| `clk` | 输入 | `clk` |
| `rst_n` | 输入 | `rst_n` |
| `key_valid` | 输入 | `local_action_valid` |
| `key_ready` | 输出 | `local_action_ready` |
| `key_action` | 输入 | `local_action` |
| `menu_valid` | 输入 | `menu_action_valid` |
| `menu_ready` | 输出 | `menu_action_ready` |
| `menu_action` | 输入 | `menu_action` |
| `out_valid` | 输出 | `merged_action_valid` |
| `out_ready` | 输入 | `merged_action_ready` |
| `out_action` | 输出 | `merged_action` |
| `selected_menu` | 输出 | `selected_menu_action` |

### menu_actions：menu_action_router

| 子模块端口 | 相对子模块方向 | 父级实际网络/表达式 |
|---|---|---|
| `clk` | 输入 | `clk` |
| `rst_n` | 输入 | `rst_n` |
| `request_valid` | 输入 | `menu_request_valid` |
| `request_ready` | 输出 | `menu_request_ready` |
| `request_kind` | 输入 | `menu_request_kind` |
| `request_page` | 输入 | `menu_request_page` |
| `request_zone` | 输入 | `menu_request_zone` |
| `recording` | 输入 | `recording` |
| `playing` | 输入 | `playing` |
| `guide_active` | 输入 | `guide_active` |
| `timbre_valid` | 输出 | `menu_timbre_valid` |
| `timbre` | 输出 | `local_timbre` |
| `transpose` | 输出 | `menu_transpose` |
| `action_valid` | 输出 | `menu_action_valid` |
| `action_ready` | 输入 | `menu_action_ready` |
| `action` | 输出 | `menu_action` |
| `action_status` | 输入 | `perf_local_action_status` |
| `prompt_valid` | 输出 | `menu_prompt_valid` |
| `prompt_code` | 输出 | `menu_prompt_code` |
| `last_error` | 输出 | `dispatch_error` |
| `busy` | 输出 | `menu_busy` |

### menu_input：slider_menu_controller

| 子模块端口 | 相对子模块方向 | 父级实际网络/表达式 |
|---|---|---|
| `clk` | 输入 | `clk` |
| `rst_n` | 输入 | `rst_n` |
| `touch_active` | 输入 | `MENU_ENABLE && slider_active` |
| `touch_fault` | 输入 | `sensor_fault[0] &#124;&#124; !sensor_ready[0]` |
| `position` | 输入 | `slider_position` |
| `request_valid` | 输出 | `menu_request_valid` |
| `request_ready` | 输入 | `menu_request_ready` |
| `request_kind` | 输出 | `menu_request_kind` |
| `request_page` | 输出 | `menu_request_page` |
| `request_zone` | 输出 | `menu_request_zone` |
| `main_menu` | 输出 | `menu_main` |
| `page` | 输出 | `menu_page` |
| `selected_zone` | 输出 | 显式未连接() |
| `preview_zone` | 输出 | `menu_preview_zone` |
| `action_busy` | 输入 | `menu_busy` |
| `performance_mode` | 输出 | `menu_volume_mode` |
| `volume_position_valid` | 输出 | `volume_position_valid` |
| `volume_position` | 输出 | `volume_position` |

### monitor：audio_monitor_cdc

| 子模块端口 | 相对子模块方向 | 父级实际网络/表达式 |
|---|---|---|
| `src_clk` | 输入 | `clk` |
| `src_rst_n` | 输入 | `audio_rst_n` |
| `src_valid` | 输入 | `monitor_valid` |
| `src_left` | 输入 | `post_l` |
| `src_right` | 输入 | `post_r` |
| `drop_count` | 输出 | `cdc_drops` |
| `dst_clk` | 输入 | `video_clk` |
| `dst_rst_n` | 输入 | `video_reset[1]` |
| `dst_valid` | 输出 | `vsample` |
| `dst_left` | 输出 | `vl` |
| `dst_right` | 输出 | `vr` |

### navigation：menu_hierarchy

| 子模块端口 | 相对子模块方向 | 父级实际网络/表达式 |
|---|---|---|
| `clk` | 输入 | `clk` |
| `rst_n` | 输入 | `rst_n` |
| `touch_active` | 输入 | `MENU_ENABLE && slider_active` |
| `touch_fault` | 输入 | `sensor_fault[0] &#124;&#124; !sensor_ready[0]` |
| `position` | 输入 | `slider_position` |
| `request_valid` | 输出 | `menu_request_valid` |
| `request_ready` | 输入 | `menu_request_ready` |
| `request_kind` | 输出 | `menu_request_kind` |
| `request_page` | 输出 | `menu_request_page` |
| `request_zone` | 输出 | `menu_request_zone` |
| `action_busy` | 输入 | `menu_busy` |
| `action_done` | 输入 | `menu_prompt_valid` |
| `action_error` | 输入 | `dispatch_error` |
| `display_error` | 输出 | `hierarchy_error` |
| `fx_write` | 输出 | `local_fx_write` |
| `fx_value` | 输出 | `local_fx_value` |
| `expression_reset` | 输出 | `local_expression_reset` |
| `sustain_write` | 输出 | `local_sustain_write` |
| `sustain_value` | 输出 | `local_sustain_value` |
| `view` | 输出 | `menu_view` |
| `expression_mode` | 输出 | `menu_expression_mode` |
| `waveform_view` | 输出 | `menu_waveform_view` |
| `preview_zone` | 输出 | `menu_preview_zone` |
| `position_valid` | 输出 | `volume_position_valid` |
| `control_position` | 输出 | `volume_position` |

### parameters：slider_expression_control

| 子模块端口 | 相对子模块方向 | 父级实际网络/表达式 |
|---|---|---|
| `clk` | 输入 | `clk` |
| `rst_n` | 输入 | `audio_rst_n` |
| `mode` | 输入 | `menu_expression_mode` |
| `position_valid` | 输入 | `volume_position_valid` |
| `position` | 输入 | `volume_position` |
| `touch_active` | 输入 | `slider_active` |
| `touch_fault` | 输入 | `sensor_fault[0] &#124;&#124; !sensor_ready[0]` |
| `reset_expression` | 输入 | `local_expression_reset` |
| `expr_valid` | 输出 | `volume_xv` |
| `expr_ready` | 输入 | `volume_xr` |
| `expr_mask` | 输出 | `local_expression_mask` |
| `expr_gain` | 输出 | `volume_gain` |
| `expr_bend` | 输出 | `local_expression_bend` |
| `expr_vibrato` | 输出 | `local_expression_vibrato` |

### pedal：sustain_command_gate

| 子模块端口 | 相对子模块方向 | 父级实际网络/表达式 |
|---|---|---|
| `clk` | 输入 | `clk` |
| `rst_n` | 输入 | `audio_rst_n` |
| `sustain_enabled` | 输入 | `sustain_enabled` |
| `in_valid` | 输入 | `cmdv` |
| `in_ready` | 输出 | `cmdr` |
| `in_on` | 输入 | `cmdon` |
| `in_voice` | 输入 | `voice` |
| `in_note` | 输入 | `note` |
| `in_velocity` | 输入 | `velocity` |
| `in_timbre` | 输入 | `tone` |
| `out_valid` | 输出 | `engine_cmd_valid` |
| `out_ready` | 输入 | `engine_cmd_ready` |
| `out_on` | 输出 | `engine_cmd_on` |
| `out_voice` | 输出 | `engine_cmd_voice` |
| `out_note` | 输出 | `engine_cmd_note` |
| `out_velocity` | 输出 | `engine_cmd_velocity` |
| `out_timbre` | 输出 | `engine_cmd_timbre` |
| `deferred_mask` | 输出 | 显式未连接() |
| `deferred_count` | 输出 | `sustain_deferred_count` |

### performance：performance_controller

| 子模块端口 | 相对子模块方向 | 父级实际网络/表达式 |
|---|---|---|
| `clk` | 输入 | `clk` |
| `rst_n` | 输入 | `rst_n` |
| `command_valid` | 输入 | `staged_command_valid` |
| `command_ready` | 输出 | `perf_ready` |
| `command_opcode` | 输入 | `staged_opcode` |
| `command_payload` | 输入 | `staged_payload` |
| `command_status` | 输出 | `perf_status` |
| `action_busy` | 输出 | `perf_action_busy` |
| `local_action_status` | 输出 | `perf_local_action_status` |
| `record_valid` | 输入 | `push_valid && push_ready && arb_selected!=2` |
| `record_on` | 输入 | `push_payload[22]` |
| `record_source` | 输入 | `push_payload[21:16]` |
| `record_note` | 输入 | `push_payload[15:9]` |
| `record_velocity` | 输入 | `push_payload[8:2]` |
| `record_timbre` | 输入 | `push_payload[1:0]` |
| `event_valid` | 输出 | `perf_ev` |
| `event_ready` | 输入 | `perf_er` |
| `event_on` | 输出 | `perf_on` |
| `event_source` | 输出 | `perf_source` |
| `event_note` | 输出 | `perf_note` |
| `event_velocity` | 输出 | `perf_velocity` |
| `event_timbre` | 输出 | `perf_timbre` |
| `learning_touch_mask` | 输入 | `touch_mask` |
| `learning_touch_ready` | 输入 | `(&sensor_ready) && !(&#124;sensor_fault)` |
| `learning_status_payload` | 输出 | `learning_status_payload` |
| `key_map_flat` | 输入 | `mapping` |
| `current_timbre` | 输入 | `timbre` |
| `guide_mask` | 输出 | `guide_mask` |
| `playing` | 输出 | `playing` |
| `recording` | 输出 | `recording` |
| `guide_active` | 输出 | `guide_active` |
| `overflow_sticky` | 输出 | `record_overflow` |
| `record_count` | 输出 | `record_count` |
| `score_position` | 输出 | `score_position` |
| `record_read_index` | 输入 | `read_index` |
| `record_read_valid` | 输出 | `read_valid` |
| `row_payload` | 输出 | `read_row` |

### performance_commands：performance_command_stage

| 子模块端口 | 相对子模块方向 | 父级实际网络/表达式 |
|---|---|---|
| `clk` | 输入 | `clk` |
| `rst_n` | 输入 | `rst_n` |
| `remote_valid` | 输入 | `perf_cv` |
| `remote_ready` | 输出 | `perf_cr` |
| `remote_opcode` | 输入 | `perf_co` |
| `remote_payload` | 输入 | `perf_cp` |
| `local_valid` | 输入 | `merged_action_valid && !panic_quiescing && !panic` |
| `local_ready` | 输出 | `staged_local_ready` |
| `local_action` | 输入 | `merged_action` |
| `local_status` | 输出 | 显式未连接() |
| `command_valid` | 输出 | `staged_command_valid` |
| `command_ready` | 输入 | `perf_ready` |
| `command_opcode` | 输出 | `staged_opcode` |
| `command_payload` | 输出 | `staged_payload` |
| `command_status` | 输入 | `perf_status` |

### renderer：scope_renderer

| 子模块端口 | 相对子模块方向 | 父级实际网络/表达式 |
|---|---|---|
| `clk` | 输入 | `video_clk` |
| `rst_n` | 输入 | `video_reset[1]` |
| `x` | 输入 | `video_x` |
| `y` | 输入 | `video_y` |
| `de` | 输入 | `video_de` |
| `wave_data` | 输入 | `wave` |
| `xy_pixel` | 输入 | `xy` |
| `xy_valid` | 输入 | `xyvalid` |
| `spectrum_levels` | 输入 | `levels` |
| `wave_read_index` | 输出 | `wave_index` |
| `xy_read_addr` | 输出 | `xy_addr` |
| `rgb` | 输出 | `video_rgb` |

### router：remote_command_router

| 子模块端口 | 相对子模块方向 | 父级实际网络/表达式 |
|---|---|---|
| `clk` | 输入 | `clk` |
| `rst_n` | 输入 | `rst_n` |
| `cmd_valid` | 输入 | `cv && accept_commands` |
| `cmd_ready` | 输出 | `router_cr` |
| `cmd_seq` | 输入 | `cs` |
| `cmd_opcode` | 输入 | `co` |
| `cmd_payload` | 输入 | `cp` |
| `rsp_valid` | 输出 | `rv` |
| `rsp_ready` | 输入 | `rr` |
| `rsp_seq` | 输出 | `rs` |
| `rsp_opcode` | 输出 | `ro` |
| `rsp_payload` | 输出 | `rp` |
| `event_valid` | 输出 | `remote_ev` |
| `event_ready` | 输入 | `remote_er` |
| `event_on` | 输出 | `remote_on` |
| `event_source` | 输出 | `remote_source` |
| `event_note` | 输出 | `remote_note` |
| `event_velocity` | 输出 | `remote_velocity` |
| `event_timbre` | 输出 | `remote_timbre` |
| `expr_valid` | 输出 | `phone_xv` |
| `expr_ready` | 输入 | `phone_xr` |
| `expr_mask` | 输出 | `phone_xm` |
| `expr_gain` | 输出 | `phone_gain` |
| `expr_bend` | 输出 | `phone_bend` |
| `expr_vibrato` | 输出 | `phone_vib` |
| `performance_valid` | 输出 | `perf_cv` |
| `performance_pending` | 输出 | `perf_pending` |
| `performance_ready` | 输入 | `perf_cr` |
| `performance_opcode` | 输出 | `perf_co` |
| `performance_payload` | 输出 | `perf_cp` |
| `performance_status` | 输入 | `perf_status` |
| `key_map_flat` | 输出 | `base_mapping` |
| `current_timbre` | 输出 | `router_timbre` |
| `effect_mode` | 输出 | `router_fx` |
| `panic_pulse` | 输出 | `panic` |
| `timbre_write_pulse` | 输出 | `router_timbre_written` |
| `sustain_write_pulse` | 输出 | `router_sustain_written` |
| `sustain_value` | 输出 | `router_sustain_value` |
| `sustain_status_payload` | 输入 | `sustain_status_payload` |
| `active_count` | 输入 | `active_count` |
| `playing` | 输入 | `playing` |
| `recording` | 输入 | `recording` |
| `guide_active` | 输入 | `guide_active` |
| `overflow_sticky` | 输入 | `overflow_sticky` |
| `record_count` | 输入 | `record_count` |
| `score_position` | 输入 | `score_position` |
| `underrun_count` | 输入 | `underrun_count` |
| `mode_status_payload` | 输入 | `mode_status_payload` |
| `learning_status_payload` | 输入 | `learning_status_payload` |
| `record_read_index` | 输出 | `read_index` |
| `record_read_valid` | 输入 | `read_valid` |
| `record_read_payload` | 输入 | `read_row` |

### sensors：mpr121_input_frontend

| 子模块端口 | 相对子模块方向 | 父级实际网络/表达式 |
|---|---|---|
| `clk` | 输入 | `clk` |
| `resetn` | 输入 | `rst_n` |
| `irq_n` | 输入 | `irq_sync` |
| `scl` | 双向 | `mpr_scl` |
| `sda` | 双向 | `mpr_sda` |
| `key_map_flat` | 输入 | `mapping` |
| `current_timbre` | 输入 | `timbre` |
| `key_valid` | 输出 | `sensor_ev` |
| `key_ready` | 输入 | `sensor_er` |
| `key_on` | 输出 | `sensor_on` |
| `key_source` | 输出 | `sensor_source` |
| `key_note` | 输出 | `sensor_note` |
| `key_velocity` | 输出 | `sensor_velocity` |
| `key_timbre` | 输出 | `sensor_timbre` |
| `expr_update_valid` | 输出 | `slider_xv` |
| `expr_update_ready` | 输入 | `slider_xr` |
| `expr_update_mask` | 输出 | `slider_xm` |
| `expr_update_gain_q1_11` | 输出 | `slider_gain` |
| `expr_update_bend_cents` | 输出 | `slider_bend` |
| `expr_update_vibrato_depth_cents` | 输出 | `slider_vib` |
| `touch_mask` | 输出 | `touch_mask` |
| `fault` | 输出 | `sensor_fault` |
| `ready` | 输出 | `sensor_ready` |
| `event_overflow` | 输出 | `sensor_overflow` |
| `pending_events` | 输出 | `sensor_pending` |
| `slider_active` | 输出 | `slider_active` |
| `slider_position` | 输出 | `slider_position` |

该实例未写出的端口：`error_count`、`init_stage`、`last_error`、`last_success_age`、`oor_status`。是否可省略须以该调用用途为准。

### synth：voice_engine

| 子模块端口 | 相对子模块方向 | 父级实际网络/表达式 |
|---|---|---|
| `clk` | 输入 | `clk` |
| `rst_n` | 输入 | `audio_rst_n` |
| `cmd_valid` | 输入 | `engine_cmd_valid` |
| `cmd_ready` | 输出 | `engine_cmd_ready` |
| `cmd_on` | 输入 | `engine_cmd_on` |
| `cmd_voice` | 输入 | `engine_cmd_voice` |
| `cmd_note` | 输入 | `engine_cmd_note` |
| `cmd_velocity` | 输入 | `engine_cmd_velocity` |
| `cmd_timbre` | 输入 | `engine_cmd_timbre` |
| `done_valid` | 输出 | `dv` |
| `done_ready` | 输入 | `dr` |
| `done_voice` | 输出 | `done_voice` |
| `sample_valid` | 输出 | `pcm_valid` |
| `sample_ready` | 输入 | `pcm_ready` |
| `sample_left` | 输出 | `pcm_l` |
| `sample_right` | 输出 | `pcm_r` |
| `engine_sample_begin` | 输出 | `sample_begin` |
| `active_gain` | 输入 | `gain` |
| `active_bend_cents` | 输入 | `bend` |
| `active_vibrato_cents` | 输入 | `vibrato` |

### transpose_keys：key_map_transpose

| 子模块端口 | 相对子模块方向 | 父级实际网络/表达式 |
|---|---|---|
| `base_map` | 输入 | `base_mapping` |
| `semitones` | 输入 | `menu_transpose` |
| `mapped_notes` | 输出 | `mapping` |

### uart：remote_uart_transport

| 子模块端口 | 相对子模块方向 | 父级实际网络/表达式 |
|---|---|---|
| `clk` | 输入 | `clk` |
| `reset` | 输入 | `!rst_n` |
| `rx` | 输入 | `uart_rx` |
| `tx` | 输出 | `uart_tx` |
| `cmd_valid` | 输出 | `cv` |
| `cmd_ready` | 输入 | `cr` |
| `cmd_seq` | 输出 | `cs` |
| `cmd_opcode` | 输出 | `co` |
| `cmd_payload` | 输出 | `cp` |
| `rsp_valid` | 输入 | `rv` |
| `rsp_ready` | 输出 | `rr` |
| `rsp_seq` | 输入 | `rs` |
| `rsp_opcode` | 输入 | `ro` |
| `rsp_payload` | 输入 | `rp` |
| `crc_error_count` | 输出 | `crc_errors` |
| `framing_error_count` | 输出 | `framing_errors` |
| `overflow_count` | 输出 | `uart_overflows` |
| `timeout_count` | 输出 | `uart_timeouts` |
| `overflow_pulse` | 输出 | `uart_overflow` |

### ui_prompt：ui_tone_overlay

| 子模块端口 | 相对子模块方向 | 父级实际网络/表达式 |
|---|---|---|
| `clk` | 输入 | `clk` |
| `rst_n` | 输入 | `audio_rst_n` |
| `prompt_valid` | 输入 | `menu_prompt_valid` |
| `prompt_code` | 输入 | `menu_prompt_code` |
| `in_valid` | 输入 | `fx_valid` |
| `in_ready` | 输出 | `fx_ready` |
| `in_left` | 输入 | `fx_l` |
| `in_right` | 输入 | `fx_r` |
| `out_valid` | 输出 | `post_valid` |
| `out_ready` | 输入 | `post_ready` |
| `out_left` | 输出 | `post_l` |
| `out_right` | 输出 | `post_r` |

### visual：audio_visualizer

| 子模块端口 | 相对子模块方向 | 父级实际网络/表达式 |
|---|---|---|
| `clk` | 输入 | `video_clk` |
| `rst_n` | 输入 | `video_reset[1]` |
| `sample_valid` | 输入 | `vsample` |
| `sample_left` | 输入 | `vl` |
| `sample_right` | 输入 | `vr` |
| `spectrum_levels` | 输出 | `levels` |
| `wave_read_index` | 输入 | `wave_index` |
| `wave_data` | 输出 | `wave` |
| `xy_read_addr` | 输入 | `xy_addr` |
| `xy_pixel` | 输出 | `xy` |
| `xy_valid` | 输出 | `xyvalid` |

该实例未写出的端口：`dropped_samples`、`spectrum_valid`。是否可省略须以该调用用途为准。

### volume：slider_volume_control

| 子模块端口 | 相对子模块方向 | 父级实际网络/表达式 |
|---|---|---|
| `clk` | 输入 | `clk` |
| `rst_n` | 输入 | `audio_rst_n` |
| `position_valid` | 输入 | `volume_position_valid` |
| `position` | 输入 | `volume_position` |
| `expr_valid` | 输出 | `volume_xv` |
| `expr_ready` | 输入 | `volume_xr` |
| `expr_gain` | 输出 | `volume_gain` |

### volume_meter：gain_percent_meter

| 子模块端口 | 相对子模块方向 | 父级实际网络/表达式 |
|---|---|---|
| `clk` | 输入 | `clk` |
| `rst_n` | 输入 | `rst_n` |
| `gain` | 输入 | `gain` |
| `percent` | 输出 | `menu_volume_percent` |

### watchdog：remote_note_watchdog

| 子模块端口 | 相对子模块方向 | 父级实际网络/表达式 |
|---|---|---|
| `clk` | 输入 | `clk` |
| `rst_n` | 输入 | `rst_n` |
| `heartbeat` | 输入 | `cv && cr` |
| `expire` | 输入 | `uart_overflow &#124;&#124; panic_discard` |
| `accepted` | 输入 | `remote_ev && remote_er` |
| `accepted_on` | 输入 | `remote_on` |
| `accepted_note` | 输入 | `remote_note` |
| `event_valid` | 输出 | `watchdog_ev` |
| `event_ready` | 输入 | `watchdog_er` |
| `event_on` | 输出 | `watchdog_on` |
| `event_source` | 输出 | `watchdog_source` |
| `event_note` | 输出 | `watchdog_note` |
| `event_velocity` | 输出 | `watchdog_velocity` |
| `event_timbre` | 输出 | `watchdog_timbre` |
| `releasing` | 输出 | `phone_releasing` |

该实例未写出的端口：`timeout_count`。是否可省略须以该调用用途为准。

## instrument_system_v2

定义：[rtl/instrument_system_v2.v:7](https://github.com/wujijun11/git/blob/codex/sustain-20261030/TangMega60K_Synth/rtl/instrument_system_v2.v#L7)

### u_audio：audio_system_v2

| 子模块端口 | 相对子模块方向 | 父级实际网络/表达式 |
|---|---|---|
| `clk` | 输入 | `clk` |
| `rst_n` | 输入 | `rst_n` |
| `event_valid` | 输入 | `event_valid` |
| `event_ready` | 输出 | `event_ready` |
| `event_on` | 输入 | `event_on` |
| `event_source` | 输入 | `event_source` |
| `event_note` | 输入 | `event_note` |
| `event_velocity` | 输入 | `event_velocity` |
| `event_timbre` | 输入 | `event_timbre` |
| `expr_valid` | 输入 | `expr_valid` |
| `expr_ready` | 输出 | `expr_ready` |
| `expr_gain` | 输入 | `expr_gain` |
| `expr_bend_cents` | 输入 | `expr_bend_cents` |
| `expr_vibrato_cents` | 输入 | `expr_vibrato_cents` |
| `i2s_bclk` | 输出 | `i2s_bclk` |
| `i2s_lrclk` | 输出 | `i2s_lrclk` |
| `i2s_data` | 输出 | `i2s_data` |
| `active_count` | 输出 | `active_count` |
| `full_pulse` | 输出 | `voice_full_pulse` |
| `done_error_pulse` | 输出 | `done_error_pulse` |
| `underrun_count` | 输出 | `i2s_underrun_count` |

### u_inputs：interaction_top_v2

| 子模块端口 | 相对子模块方向 | 父级实际网络/表达式 |
|---|---|---|
| `clk` | 输入 | `clk` |
| `rst_n` | 输入 | `rst_n` |
| `in_valid` | 输入 | `key_valid` |
| `in_ready` | 输出 | `key_ready` |
| `in_on` | 输入 | `key_on` |
| `in_source` | 输入 | `key_source` |
| `in_note` | 输入 | `key_note` |
| `in_velocity` | 输入 | `key_velocity` |
| `in_timbre` | 输入 | `key_timbre` |
| `chord_valid` | 输入 | `chord_valid` |
| `chord_ready` | 输出 | `chord_ready` |
| `chord_on` | 输入 | `chord_on` |
| `chord_id` | 输入 | `chord_id` |
| `chord_source` | 输入 | `chord_source` |
| `chord_count` | 输入 | `chord_count` |
| `chord_notes_flat` | 输入 | `chord_notes_flat` |
| `chord_velocity` | 输入 | `chord_velocity` |
| `chord_timbre` | 输入 | `chord_timbre` |
| `event_valid` | 输出 | `event_valid` |
| `event_ready` | 输入 | `event_ready` |
| `event_on` | 输出 | `event_on` |
| `event_source` | 输出 | `event_source` |
| `event_note` | 输出 | `event_note` |
| `event_velocity` | 输出 | `event_velocity` |
| `event_timbre` | 输出 | `event_timbre` |
| `expr_update_valid` | 输入 | `expr_update_valid` |
| `expr_update_ready` | 输出 | `expr_update_ready` |
| `expr_update_mask` | 输入 | `expr_update_mask` |
| `expr_update_gain` | 输入 | `expr_update_gain` |
| `expr_update_bend_cents` | 输入 | `expr_update_bend_cents` |
| `expr_update_vibrato_cents` | 输入 | `expr_update_vibrato_cents` |
| `expr_valid` | 输出 | `expr_valid` |
| `expr_ready` | 输入 | `expr_ready` |
| `expr_gain` | 输出 | `expr_gain` |
| `expr_bend_cents` | 输出 | `expr_bend_cents` |
| `expr_vibrato_cents` | 输出 | `expr_vibrato_cents` |
| `fifo_level` | 输出 | `event_fifo_level` |
| `fifo_full` | 输出 | `event_fifo_full` |
| `event_backpressure` | 输出 | `event_backpressure` |
| `overflow_pulse` | 输出 | `event_overflow_pulse` |
| `overflow_sticky` | 输出 | `event_overflow_sticky` |
| `overflow_count` | 输出 | `event_overflow_count` |
| `pushed_count` | 输出 | `events_pushed` |
| `event_count` | 输出 | `events_delivered` |
| `current_expr_gain` | 输出 | `current_expr_gain` |
| `current_expr_bend_cents` | 输出 | `current_expr_bend_cents` |
| `current_expr_vibrato_cents` | 输出 | `current_expr_vibrato_cents` |

## interaction_top

定义：[rtl/interaction_top.v:32](https://github.com/wujijun11/git/blob/codex/sustain-20261030/TangMega60K_Synth/rtl/interaction_top.v#L32)

### u_events：event_fifo

| 子模块端口 | 相对子模块方向 | 父级实际网络/表达式 |
|---|---|---|
| `clk` | 输入 | `clk` |
| `rst_n` | 输入 | `rst_n` |
| `push_valid` | 输入 | `in_valid` |
| `push_ready` | 输出 | `in_ready` |
| `push_on` | 输入 | `in_on` |
| `push_note` | 输入 | `in_note` |
| `push_velocity` | 输入 | `in_velocity` |
| `push_timbre` | 输入 | `in_timbre` |
| `pop_valid` | 输出 | `event_valid` |
| `pop_ready` | 输入 | `event_ready` |
| `pop_on` | 输出 | `event_on` |
| `pop_note` | 输出 | `event_note` |
| `pop_velocity` | 输出 | `event_velocity` |
| `pop_timbre` | 输出 | `event_timbre` |
| `level` | 输出 | `fifo_level` |
| `full` | 输出 | `fifo_full` |
| `empty` | 输出 | 显式未连接() |

## interaction_top_v2

定义：[rtl/interaction_top_v2.v:13](https://github.com/wujijun11/git/blob/codex/sustain-20261030/TangMega60K_Synth/rtl/interaction_top_v2.v#L13)

### u_events：event_fifo_v2

| 子模块端口 | 相对子模块方向 | 父级实际网络/表达式 |
|---|---|---|
| `clk` | 输入 | `clk` |
| `rst_n` | 输入 | `rst_n` |
| `push_valid` | 输入 | `fifo_push_valid` |
| `push_ready` | 输出 | `fifo_push_ready` |
| `push_on` | 输入 | `fifo_push_on` |
| `push_source` | 输入 | `fifo_push_source` |
| `push_note` | 输入 | `fifo_push_note` |
| `push_velocity` | 输入 | `fifo_push_velocity` |
| `push_timbre` | 输入 | `fifo_push_timbre` |
| `pop_valid` | 输出 | `event_valid` |
| `pop_ready` | 输入 | `event_ready` |
| `pop_on` | 输出 | `event_on` |
| `pop_source` | 输出 | `event_source` |
| `pop_note` | 输出 | `event_note` |
| `pop_velocity` | 输出 | `event_velocity` |
| `pop_timbre` | 输出 | `event_timbre` |
| `level` | 输出 | `fifo_level` |
| `full` | 输出 | `fifo_full` |
| `empty` | 输出 | 显式未连接() |

## live64_system_top

定义：[rtl/diagnostics/live64_system_top.v:4](https://github.com/wujijun11/git/blob/codex/sustain-20261030/TangMega60K_Synth/rtl/diagnostics/live64_system_top.v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)

### u_audio：audio_system_v2

| 子模块端口 | 相对子模块方向 | 父级实际网络/表达式 |
|---|---|---|
| `clk` | 输入 | `clk` |
| `rst_n` | 输入 | `rst_n` |
| `event_valid` | 输入 | `event_valid` |
| `event_ready` | 输出 | `event_ready` |
| `event_on` | 输入 | `event_on` |
| `event_source` | 输入 | `event_source` |
| `event_note` | 输入 | `event_note` |
| `event_velocity` | 输入 | `event_velocity` |
| `event_timbre` | 输入 | `event_timbre` |
| `expr_valid` | 输入 | `1'b0` |
| `expr_ready` | 输出 | 显式未连接() |
| `expr_gain` | 输入 | `12'd2048` |
| `expr_bend_cents` | 输入 | `13'sd0` |
| `expr_vibrato_cents` | 输入 | `8'd0` |
| `i2s_bclk` | 输出 | `i2s_bclk` |
| `i2s_lrclk` | 输出 | `i2s_lrclk` |
| `i2s_data` | 输出 | `i2s_data` |
| `active_count` | 输出 | `active_count` |
| `full_pulse` | 输出 | `full_pulse` |
| `done_error_pulse` | 输出 | `done_error_pulse` |
| `underrun_count` | 输出 | `underrun_count` |

### u_selftest：live64_event_source

| 子模块端口 | 相对子模块方向 | 父级实际网络/表达式 |
|---|---|---|
| `clk` | 输入 | `clk` |
| `rst_n` | 输入 | `rst_n` |
| `start` | 输入 | `start` |
| `stop` | 输入 | `stop` |
| `active_count` | 输入 | `active_count` |
| `allocation_error` | 输入 | `full_pulse &#124;&#124; done_error_pulse` |
| `start_ready` | 输出 | `start_ready` |
| `busy` | 输出 | `busy` |
| `holding` | 输出 | `holding` |
| `released_pulse` | 输出 | `released_pulse` |
| `error` | 输出 | `error` |
| `event_valid` | 输出 | `event_valid` |
| `event_ready` | 输入 | `event_ready` |
| `event_on` | 输出 | `event_on` |
| `event_source` | 输出 | `event_source` |
| `event_note` | 输出 | `event_note` |
| `event_velocity` | 输出 | `event_velocity` |
| `event_timbre` | 输出 | `event_timbre` |

## menu_hierarchy

定义：[rtl/control/menu_hierarchy.v:4](https://github.com/wujijun11/git/blob/codex/sustain-20261030/TangMega60K_Synth/rtl/control/menu_hierarchy.v#L4)

### gestures：slider_gesture_input

| 子模块端口 | 相对子模块方向 | 父级实际网络/表达式 |
|---|---|---|
| `clk` | 输入 | `clk` |
| `rst_n` | 输入 | `rst_n` |
| `touch_active` | 输入 | `touch_active` |
| `touch_fault` | 输入 | `touch_fault` |
| `position` | 输入 | `position` |
| `continuous_mode` | 输入 | `view==0` |
| `waveform_view` | 输入 | `waveform_view` |
| `event_valid` | 输出 | `gv` |
| `event_ready` | 输入 | `gr` |
| `event_kind` | 输出 | `kind` |
| `event_zone` | 输出 | `zone` |
| `preview_zone` | 输出 | `preview_zone` |
| `position_valid` | 输出 | `position_valid` |
| `control_position` | 输出 | `control_position` |

## mpr121_input_frontend

定义：[rtl/sensors/mpr121_input_frontend.v:3](https://github.com/wujijun11/git/blob/codex/sustain-20261030/TangMega60K_Synth/rtl/sensors/mpr121_input_frontend.v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)

### eventizer：mpr121_key_eventizer

| 子模块端口 | 相对子模块方向 | 父级实际网络/表达式 |
|---|---|---|
| `clk` | 输入 | `clk` |
| `resetn` | 输入 | `resetn` |
| `snapshot_valid` | 输入 | `EARLY_KEY_ENABLE?early_valid:snap_valid` |
| `snapshot_ready` | 输出 | `event_snapshot_ready` |
| `touch0` | 输入 | `EARLY_KEY_ENABLE?early_status[7:0]:snaps[7:0]` |
| `touch1` | 输入 | `EARLY_KEY_ENABLE?early_status[12+:8]:snaps[344+:8]` |
| `touch2` | 输入 | `EARLY_KEY_ENABLE?early_status[24+:9]:snaps[688+:9]` |
| `fault` | 输入 | `fault` |
| `key_map_flat` | 输入 | `key_map_flat` |
| `current_timbre` | 输入 | `current_timbre` |
| `key_valid` | 输出 | `key_valid` |
| `key_ready` | 输入 | `key_ready` |
| `key_on` | 输出 | `key_on` |
| `key_source` | 输出 | `key_source` |
| `key_note` | 输出 | `key_note` |
| `key_velocity` | 输出 | `key_velocity` |
| `key_timbre` | 输出 | `key_timbre` |
| `touch_mask` | 输出 | `touch_mask` |
| `overflow` | 输出 | `event_overflow` |
| `pending_events` | 输出 | `pending_events` |

### sampler：mpr121_sampler

| 子模块端口 | 相对子模块方向 | 父级实际网络/表达式 |
|---|---|---|
| `clk` | 输入 | `clk` |
| `resetn` | 输入 | `resetn` |
| `irq_n` | 输入 | `irq_n[g]` |
| `snapshot_ready` | 输入 | `snap_ready[g]` |
| `snapshot_valid` | 输出 | `snap_valid[g]` |
| `snapshot` | 输出 | `snaps[g*344 +:344]` |
| `ready` | 输出 | `ready[g]` |
| `fault` | 输出 | `fault[g]` |
| `last_error` | 输出 | `last_error[g*4 +:4]` |
| `error_count` | 输出 | `error_count[g*32 +:32]` |
| `last_success_age` | 输出 | `last_success_age[g*32 +:32]` |
| `init_stage` | 输出 | `init_stage[g*5 +:5]` |
| `oor_status` | 输出 | `oor_status[g*16 +:16]` |
| `scl` | 双向 | `scl[g]` |
| `sda` | 双向 | `sda[g]` |
| `early_key_valid` | 输出 | `early_valid[g]` |
| `early_key_ready` | 输入 | `early_ready[g]` |
| `early_key_status` | 输出 | `early_status[g*12+:12]` |

### slider：mpr121_slider

| 子模块端口 | 相对子模块方向 | 父级实际网络/表达式 |
|---|---|---|
| `clk` | 输入 | `clk` |
| `resetn` | 输入 | `resetn` |
| `snapshot_strobe` | 输入 | `snap_valid[0] && snap_ready[0]` |
| `snapshot` | 输入 | `snaps[343:0]` |
| `fault` | 输入 | `fault[0]` |
| `expr_update_valid` | 输出 | `expr_update_valid` |
| `expr_update_ready` | 输入 | `expr_update_ready` |
| `expr_update_mask` | 输出 | `expr_update_mask` |
| `expr_update_gain_q1_11` | 输出 | `expr_update_gain_q1_11` |
| `expr_update_bend_cents` | 输出 | `expr_update_bend_cents` |
| `expr_update_vibrato_depth_cents` | 输出 | `expr_update_vibrato_depth_cents` |
| `active` | 输出 | `slider_active` |
| `position` | 输出 | `slider_position` |
| `latest_bend` | 输出 | `latest_bend` |

## mpr121_sampler

定义：[rtl/sensors/mpr121_sampler.v:3](https://github.com/wujijun11/git/blob/codex/sustain-20261030/TangMega60K_Synth/rtl/sensors/mpr121_sampler.v#L3)

### bus：i2c_register_master

| 子模块端口 | 相对子模块方向 | 父级实际网络/表达式 |
|---|---|---|
| `clk` | 输入 | `clk` |
| `resetn` | 输入 | `resetn` |
| `cmd_valid` | 输入 | `cmd_valid` |
| `cmd_ready` | 输出 | `bus_ready` |
| `cmd_read` | 输入 | `cmd_read` |
| `cmd_addr` | 输入 | `I2C_ADDR` |
| `cmd_reg` | 输入 | `(state==POLL)?8'h00:cfg_addr(cfg_index)` |
| `cmd_wdata` | 输入 | `cfg_data(cfg_index)` |
| `cmd_len` | 输入 | `(state==POLL)?6'd43:6'd1` |
| `busy` | 输出 | `bus_busy` |
| `done` | 输出 | `bus_done` |
| `error` | 输出 | `bus_error` |
| `rdata_valid` | 输出 | `rx_valid` |
| `rdata` | 输出 | `rx_data` |
| `rindex` | 输出 | `rx_index` |
| `scl` | 双向 | `scl` |
| `sda` | 双向 | `sda` |

## oled_status_display

定义：[rtl/visual/oled_status_display.v:5](https://github.com/wujijun11/git/blob/codex/sustain-20261030/TangMega60K_Synth/rtl/visual/oled_status_display.v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)

### bus：oled_i2c_stream

| 子模块端口 | 相对子模块方向 | 父级实际网络/表达式 |
|---|---|---|
| `clk` | 输入 | `clk` |
| `resetn` | 输入 | `rst_n` |
| `cmd_valid` | 输入 | `state==SEND` |
| `cmd_ready` | 输出 | `cmd_ready` |
| `cmd_addr` | 输入 | `ADDRESS` |
| `cmd_control` | 输入 | `control_byte` |
| `cmd_length` | 输入 | `stream_length` |
| `data_valid` | 输入 | `1'b1` |
| `data_ready` | 输出 | `stream_ready` |
| `data` | 输入 | `stream_data` |
| `done` | 输出 | `transaction_done` |
| `error` | 输出 | `transaction_error` |
| `scl` | 双向 | `scl` |
| `sda` | 双向 | `sda` |

### capture：oled_wave_capture

| 子模块端口 | 相对子模块方向 | 父级实际网络/表达式 |
|---|---|---|
| `clk` | 输入 | `clk` |
| `rst_n` | 输入 | `rst_n` |
| `sample_valid` | 输入 | `audio_sample_valid` |
| `sample` | 输入 | `audio_sample` |
| `frame_snapshot` | 输入 | `state==SNAPSHOT` |
| `read_column` | 输入 | `column` |
| `read_bounds` | 输出 | `bounds` |

### decimal_count：bin16_to_bcd

| 子模块端口 | 相对子模块方向 | 父级实际网络/表达式 |
|---|---|---|
| `clk` | 输入 | `clk` |
| `rst_n` | 输入 | `rst_n` |
| `start` | 输入 | `bcd_start` |
| `value` | 输入 | `snap_count` |
| `digits` | 输出 | `digits` |
| `done` | 输出 | `bcd_done` |

### decimal_volume：bin16_to_bcd

| 子模块端口 | 相对子模块方向 | 父级实际网络/表达式 |
|---|---|---|
| `clk` | 输入 | `clk` |
| `rst_n` | 输入 | `rst_n` |
| `start` | 输入 | `bcd_start` |
| `value` | 输入 | `HIERARCHY_UI_ENABLE?{4'd0,snap_control}:{8'd0,snap_volume}` |
| `digits` | 输出 | `volume_digits` |
| `done` | 输出 | `volume_bcd_done` |

### idle_control：oled_idle_view

| 子模块端口 | 相对子模块方向 | 父级实际网络/表达式 |
|---|---|---|
| `clk` | 输入 | `clk` |
| `rst_n` | 输入 | `rst_n` |
| `touch_active` | 输入 | `ui_activity` |
| `busy` | 输入 | `busy` |
| `error` | 输入 | `error` |
| `ui_signature` | 输入 | `ui_signature` |
| `waveform_view` | 输出 | `waveform_idle` |

### renderer：oled_hierarchy_renderer

| 子模块端口 | 相对子模块方向 | 父级实际网络/表达式 |
|---|---|---|
| `clk` | 输入 | `clk` |
| `screen_page` | 输入 | `screen_page` |
| `column` | 输入 | `column` |
| `view` | 输入 | `snap_view` |
| `zone` | 输入 | `snap_zone` |
| `expression_mode` | 输入 | `snap_expression` |
| `recording` | 输入 | `snap_record` |
| `playing` | 输入 | `snap_play` |
| `guide` | 输入 | `snap_guide` |
| `busy` | 输入 | `snap_busy` |
| `error` | 输入 | `snap_error` |
| `record_digits` | 输入 | `digits` |
| `control_digits` | 输入 | `volume_digits` |
| `control_negative` | 输入 | `snap_negative` |
| `control_percent` | 输入 | `snap_percent` |
| `sustain_enabled` | 输入 | `snap_sustain` |
| `data` | 输出 | `menu_pixels` |

### renderer：oled_menu_renderer

| 子模块端口 | 相对子模块方向 | 父级实际网络/表达式 |
|---|---|---|
| `clk` | 输入 | `clk` |
| `screen_page` | 输入 | `screen_page` |
| `column` | 输入 | `column` |
| `main_menu` | 输入 | `snap_main` |
| `menu_page` | 输入 | `snap_page` |
| `zone` | 输入 | `snap_zone` |
| `recording` | 输入 | `snap_record` |
| `playing` | 输入 | `snap_play` |
| `guide` | 输入 | `snap_guide` |
| `busy` | 输入 | `snap_busy` |
| `error` | 输入 | `snap_error` |
| `record_digits` | 输入 | `digits` |
| `data` | 输出 | `menu_pixels` |
| `performance_mode` | 输入 | `snap_performance` |
| `volume_digits` | 输入 | `volume_digits[11:0]` |
| `volume_percent` | 输入 | `snap_volume` |

### wave_renderer：oled_wave_renderer

| 子模块端口 | 相对子模块方向 | 父级实际网络/表达式 |
|---|---|---|
| `clk` | 输入 | `clk` |
| `screen_page` | 输入 | `screen_page` |
| `column` | 输入 | `column` |
| `bounds` | 输入 | `bounds` |
| `data` | 输出 | `wave_pixels` |

## performance_controller

定义：[rtl/performance/performance_controller.v:2](https://github.com/wujijun11/git/blob/codex/sustain-20261030/TangMega60K_Synth/rtl/performance/performance_controller.v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)

### stepper：learning_stepper

| 子模块端口 | 相对子模块方向 | 父级实际网络/表达式 |
|---|---|---|
| `clk` | 输入 | `clk` |
| `rst_n` | 输入 | `rst_n` |
| `start` | 输入 | `action_command && action==9` |
| `stop` | 输入 | `action_command && (action==0 &#124;&#124; action==5 &#124;&#124; action==7)` |
| `row_valid` | 输入 | `learn_row_valid` |
| `row_ready` | 输出 | `learn_row_ready` |
| `row_key` | 输入 | `active_key[4:0]` |
| `row_on` | 输入 | `active_on` |
| `row_delta_ms` | 输入 | `active_row[47:16]` |
| `row_last` | 输入 | `score_position+16'd1>=run_count` |
| `touch_mask` | 输入 | `learning_touch_mask` |
| `touch_ready` | 输入 | `learning_touch_ready` |
| `active` | 输出 | `learn_active` |
| `target_mask` | 输出 | `learn_target` |
| `waiting_release` | 输出 | `learn_release` |
| `waiting_press` | 输出 | `learn_press` |
| `completed_steps` | 输出 | `learn_completed` |
| `finished` | 输出 | `learn_finished` |

## remote_uart_transport

定义：[rtl/remote/remote_uart_transport.sv:73](https://github.com/wujijun11/git/blob/codex/sustain-20261030/TangMega60K_Synth/rtl/remote/remote_uart_transport.sv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)

### receiver：remote_uart_rx

| 子模块端口 | 相对子模块方向 | 父级实际网络/表达式 |
|---|---|---|
| `clk` | 输入 | `clk` |
| `reset` | 输入 | `reset` |
| `rx` | 输入 | `rx` |
| `data` | 输出 | `rx_byte` |
| `valid` | 输出 | `rx_valid` |
| `framing_error` | 输出 | `rx_framing` |

### transmitter：remote_uart_tx

| 子模块端口 | 相对子模块方向 | 父级实际网络/表达式 |
|---|---|---|
| `clk` | 输入 | `clk` |
| `reset` | 输入 | `reset` |
| `data` | 输入 | `tx_byte` |
| `start` | 输入 | `tx_start` |
| `busy` | 输出 | `tx_busy` |
| `tx` | 输出 | `tx` |

## tone_demo_top

定义：[rtl/tone_demo_top.v:4](https://github.com/wujijun11/git/blob/codex/sustain-20261030/TangMega60K_Synth/rtl/tone_demo_top.v#L4)

### u_source：test_tone_source

| 子模块端口 | 相对子模块方向 | 父级实际网络/表达式 |
|---|---|---|
| `clk` | 输入 | `clk` |
| `rst_n` | 输入 | `rst_n` |
| `sample_valid` | 输出 | `valid` |
| `sample_ready` | 输入 | `ready` |
| `sample_left` | 输出 | `left_sample` |
| `sample_right` | 输出 | `right_sample` |

### u_tx：i2s_tx

| 子模块端口 | 相对子模块方向 | 父级实际网络/表达式 |
|---|---|---|
| `clk` | 输入 | `clk` |
| `rst_n` | 输入 | `rst_n` |
| `sample_valid` | 输入 | `valid` |
| `sample_ready` | 输出 | `ready` |
| `sample_left` | 输入 | `left_sample` |
| `sample_right` | 输入 | `right_sample` |
| `i2s_bclk` | 输出 | `i2s_bclk` |
| `i2s_lrclk` | 输出 | `i2s_lrclk` |
| `i2s_data` | 输出 | `i2s_data` |
| `frame_tick` | 输出 | 显式未连接() |
| `fifo_level` | 输出 | 显式未连接() |
| `underrun_pulse` | 输出 | 显式未连接() |
| `underrun_sticky` | 输出 | 显式未连接() |
| `underrun_count` | 输出 | `underrun_count` |

该实例未写出的端口：`debug_frame_left`。是否可省略须以该调用用途为准。

## video_clocking

定义：[rtl/visual/video_clocking.v:6](https://github.com/wujijun11/git/blob/codex/sustain-20261030/TangMega60K_Synth/rtl/visual/video_clocking.v#L6)

### init：PLL_INIT

| 子模块端口 | 相对子模块方向 | 父级实际网络/表达式 |
|---|---|---|
| `I_RST` | 输入 | `reset` |
| `I_MD_CLK` | 输入 | `clk_50` |
| `O_RST` | 输出 | `primitive_reset` |
| `I_LOCK` | 输入 | `raw_lock` |
| `O_LOCK` | 输出 | `init_lock` |
| `O_MD_INC` | 输出 | `md_inc` |
| `O_MD_OPC` | 输出 | `md_op` |
| `O_MD_WR_DATA` | 输出 | `md_write` |
| `I_MD_RD_DATA` | 输入 | `md_read` |
| `PLL_INIT_BYPASS` | 输入 | `1'b0` |
| `MDRDO` | 输出 | 显式未连接() |
| `MDOPC` | 输入 | `2'b00` |
| `MDAINC` | 输入 | `1'b0` |
| `MDWDI` | 输入 | `8'b0` |

## video_tmds_tx

定义：[rtl/visual/video_tmds_tx.v:6](https://github.com/wujijun11/git/blob/codex/sustain-20261030/TangMega60K_Synth/rtl/visual/video_tmds_tx.v#L6)

### blue_lane：video_serializer10

| 子模块端口 | 相对子模块方向 | 父级实际网络/表达式 |
|---|---|---|
| `clk_pixel` | 输入 | `clk_pixel` |
| `clk_serial` | 输入 | `clk_serial` |
| `reset` | 输入 | `reset` |
| `symbol` | 输入 | `blue_symbol` |
| `serial` | 输出 | `serial_data[0]` |

### clock_lane：video_serializer10

| 子模块端口 | 相对子模块方向 | 父级实际网络/表达式 |
|---|---|---|
| `clk_pixel` | 输入 | `clk_pixel` |
| `clk_serial` | 输入 | `clk_serial` |
| `reset` | 输入 | `reset` |
| `symbol` | 输入 | `10'b1111100000` |
| `serial` | 输出 | `serial_clock` |

### enc_blue：video_tmds_encoder

| 子模块端口 | 相对子模块方向 | 父级实际网络/表达式 |
|---|---|---|
| `clk` | 输入 | `clk_pixel` |
| `reset` | 输入 | `reset` |
| `data` | 输入 | `blue` |
| `de` | 输入 | `de` |
| `c0` | 输入 | `hsync` |
| `c1` | 输入 | `vsync` |
| `symbol` | 输出 | `blue_symbol` |

### enc_green：video_tmds_encoder

| 子模块端口 | 相对子模块方向 | 父级实际网络/表达式 |
|---|---|---|
| `clk` | 输入 | `clk_pixel` |
| `reset` | 输入 | `reset` |
| `data` | 输入 | `green` |
| `de` | 输入 | `de` |
| `c0` | 输入 | `1'b0` |
| `c1` | 输入 | `1'b0` |
| `symbol` | 输出 | `green_symbol` |

### enc_red：video_tmds_encoder

| 子模块端口 | 相对子模块方向 | 父级实际网络/表达式 |
|---|---|---|
| `clk` | 输入 | `clk_pixel` |
| `reset` | 输入 | `reset` |
| `data` | 输入 | `red` |
| `de` | 输入 | `de` |
| `c0` | 输入 | `1'b0` |
| `c1` | 输入 | `1'b0` |
| `symbol` | 输出 | `red_symbol` |

### green_lane：video_serializer10

| 子模块端口 | 相对子模块方向 | 父级实际网络/表达式 |
|---|---|---|
| `clk_pixel` | 输入 | `clk_pixel` |
| `clk_serial` | 输入 | `clk_serial` |
| `reset` | 输入 | `reset` |
| `symbol` | 输入 | `green_symbol` |
| `serial` | 输出 | `serial_data[1]` |

### red_lane：video_serializer10

| 子模块端口 | 相对子模块方向 | 父级实际网络/表达式 |
|---|---|---|
| `clk_pixel` | 输入 | `clk_pixel` |
| `clk_serial` | 输入 | `clk_serial` |
| `reset` | 输入 | `reset` |
| `symbol` | 输入 | `red_symbol` |
| `serial` | 输出 | `serial_data[2]` |

## voice_engine

定义：[rtl/audio/voice_engine.v:5](https://github.com/wujijun11/git/blob/codex/sustain-20261030/TangMega60K_Synth/rtl/audio/voice_engine.v#L5)

### limiter：stereo_peak_limiter

| 子模块端口 | 相对子模块方向 | 父级实际网络/表达式 |
|---|---|---|
| `clk` | 输入 | `clk` |
| `rst_n` | 输入 | `rst_n` |
| `in_valid` | 输入 | `state==FX_SEND` |
| `in_ready` | 输出 | `fx_ready` |
| `in_left` | 输入 | `wide_left` |
| `in_right` | 输入 | `wide_right` |
| `out_valid` | 输出 | `source_valid` |
| `out_ready` | 输入 | `source_ready` |
| `out_left` | 输出 | `source_left` |
| `out_right` | 输出 | `source_right` |
| `applied_gain_q16` | 输出 | `limiter_gain` |
| `limiting` | 输出 | `limiting` |

### smooth_gain：headroom_smoother

| 子模块端口 | 相对子模块方向 | 父级实际网络/表达式 |
|---|---|---|
| `clk` | 输入 | `clk` |
| `rst_n` | 输入 | `rst_n` |
| `start` | 输入 | `state==V_MIX && voice_id==VOICE_COUNT-1` |
| `active_count` | 输入 | `frame_active_count` |
| `target_shift` | 输入 | `frame_boost_shift` |
| `mix_left` | 输入 | `mix_left` |
| `mix_right` | 输入 | `mix_right` |
| `scaled_left` | 输出 | `master_mix_left` |
| `scaled_right` | 输出 | `master_mix_right` |
| `applied_gain_q10` | 输出 | `applied_gain_q10` |
| `peak_guard` | 输出 | `peak_guard` |

### u_adsr：adsr

| 子模块端口 | 相对子模块方向 | 父级实际网络/表达式 |
|---|---|---|
| `active` | 输入 | `r_active` |
| `timbre` | 输入 | `r_timbre` |
| `stage` | 输入 | `r_stage` |
| `level` | 输入 | `r_env` |
| `next_stage` | 输出 | `env_next_stage` |
| `next_level` | 输出 | `env_next` |
| `finished` | 输出 | `env_finished` |

### u_dds：dds_lane

| 子模块端口 | 相对子模块方向 | 父级实际网络/表达式 |
|---|---|---|
| `phase` | 输入 | `w_phase` |
| `ftw` | 输入 | `effective_ftw` |
| `timbre` | 输入 | `w_timbre` |
| `next_phase` | 输出 | `dds_next_phase` |
| `wave_addr` | 输出 | `dds_addr` |

### u_expression：pitch_expression

| 子模块端口 | 相对子模块方向 | 父级实际网络/表达式 |
|---|---|---|
| `clk` | 输入 | `clk` |
| `rst_n` | 输入 | `rst_n` |
| `start` | 输入 | `state==LATCH` |
| `gain_target` | 输入 | `EXPRESSION_ENABLE ? active_gain : 12'd2048` |
| `bend_target` | 输入 | `EXPRESSION_ENABLE ? active_bend_cents : 13'sd0` |
| `depth_target` | 输入 | `EXPRESSION_ENABLE ? active_vibrato_cents : 8'd0` |
| `valid` | 输出 | `expr_valid` |
| `frame_gain` | 输出 | `frame_gain` |
| `frame_ratio` | 输出 | `frame_ratio` |

### u_fm：fm_piano_lane

| 子模块端口 | 相对子模块方向 | 父级实际网络/表达式 |
|---|---|---|
| `clk` | 输入 | `clk` |
| `rst_n` | 输入 | `rst_n` |
| `start` | 输入 | `state==V_READ` |
| `voice` | 输入 | `voice_id` |
| `active` | 输入 | `r_active && r_timbre==3` |
| `age` | 输入 | `r_age` |
| `velocity` | 输入 | `r_velocity` |
| `fundamental_ftw` | 输入 | `effective_ftw` |
| `valid` | 输出 | `fm_valid` |
| `sample` | 输出 | `fm_sample` |

### u_fx：audio_fx

| 子模块端口 | 相对子模块方向 | 父级实际网络/表达式 |
|---|---|---|
| `clk` | 输入 | `clk` |
| `rst_n` | 输入 | `rst_n` |
| `bypass` | 输入 | `!FX_ENABLE` |
| `in_valid` | 输入 | `source_valid` |
| `in_ready` | 输出 | `source_ready` |
| `in_left` | 输入 | `source_left` |
| `in_right` | 输入 | `source_right` |
| `out_valid` | 输出 | `sample_valid` |
| `out_ready` | 输入 | `sample_ready` |
| `out_left` | 输出 | `sample_left` |
| `out_right` | 输出 | `sample_right` |

### u_gain：gain_saturator

| 子模块端口 | 相对子模块方向 | 父级实际网络/表达式 |
|---|---|---|
| `clk` | 输入 | `clk` |
| `mix_left` | 输入 | `master_mix_left` |
| `mix_right` | 输入 | `master_mix_right` |
| `gain` | 输入 | `frame_gain` |
| `out_left` | 输出 | `dry_left` |
| `out_right` | 输出 | `dry_right` |
| `wide_left` | 输出 | `wide_left` |
| `wide_right` | 输出 | `wide_right` |

### u_mixer：stereo_mixer

| 子模块端口 | 相对子模块方向 | 父级实际网络/表达式 |
|---|---|---|
| `clk` | 输入 | `clk` |
| `rst_n` | 输入 | `rst_n` |
| `clear` | 输入 | `state==PREP` |
| `add` | 输入 | `state==V_MIX` |
| `voice_id` | 输入 | `voice_id` |
| `sample_in` | 输入 | `voice_sample` |
| `left_sum` | 输出 | `mix_left` |
| `right_sum` | 输出 | 显式未连接() |

### u_mixer_r：stereo_mixer

| 子模块端口 | 相对子模块方向 | 父级实际网络/表达式 |
|---|---|---|
| `clk` | 输入 | `clk` |
| `rst_n` | 输入 | `rst_n` |
| `clear` | 输入 | `state==PREP` |
| `add` | 输入 | `state==V_MIX` |
| `voice_id` | 输入 | `voice_id` |
| `sample_in` | 输入 | `voice_sample_r` |
| `left_sum` | 输出 | 显式未连接() |
| `right_sum` | 输出 | `mix_right` |

### u_polar0：polar_lane

| 子模块端口 | 相对子模块方向 | 父级实际网络/表达式 |
|---|---|---|
| `clk` | 输入 | `clk` |
| `rst_n` | 输入 | `rst_n` |
| `start` | 输入 | `state==V_READ` |
| `voice` | 输入 | `voice_id` |
| `active` | 输入 | `r_active && r_timbre==2` |
| `age` | 输入 | `r_age` |
| `fundamental_ftw` | 输入 | `effective_ftw` |
| `base_ftw` | 输入 | `r_base` |
| `valid` | 输出 | `pv0` |
| `left` | 输出 | `pL0` |
| `right` | 输出 | `pR0` |

### u_polar1：polar_lane

| 子模块端口 | 相对子模块方向 | 父级实际网络/表达式 |
|---|---|---|
| `clk` | 输入 | `clk` |
| `rst_n` | 输入 | `rst_n` |
| `start` | 输入 | `state==V_READ` |
| `voice` | 输入 | `voice_id` |
| `active` | 输入 | `r_active && r_timbre==2` |
| `age` | 输入 | `r_age` |
| `fundamental_ftw` | 输入 | `effective_ftw` |
| `base_ftw` | 输入 | `r_base` |
| `valid` | 输出 | `pv1` |
| `left` | 输出 | `pL1` |
| `right` | 输出 | `pR1` |

### u_state：voice_state_ram

| 子模块端口 | 相对子模块方向 | 父级实际网络/表达式 |
|---|---|---|
| `clk` | 输入 | `clk` |
| `read_addr` | 输入 | `ram_addr` |
| `read_data` | 输出 | `ram_data` |
| `write_enable` | 输入 | `ram_write` |
| `write_addr` | 输入 | `ram_write_addr` |
| `write_data` | 输入 | `ram_write_data` |

### u_tables：wavetable_rom

| 子模块端口 | 相对子模块方向 | 父级实际网络/表达式 |
|---|---|---|
| `clk` | 输入 | `clk` |
| `wave_addr` | 输入 | `wave_addr` |
| `wave_sample` | 输出 | `wave_sample` |
| `note_addr` | 输入 | `pending_note` |
| `note_ftw` | 输出 | `note_ftw` |
| `velocity_addr` | 输入 | `w_velocity` |
| `velocity_gain` | 输出 | `velocity_gain` |
| `piano_addr` | 输入 | `13'd0` |
| `piano_body` | 输出 | 显式未连接() |
| `piano_bright` | 输出 | 显式未连接() |
