wujijun11/git/TangMega60K_Synth/docs/模块输入输出_20261030/接口阅读方法.md

# 把输入输出看成模块之间的交接

[回到总索引](README.md)

## 输入、输出相对谁

模块好比一个小工作台。input是别人送进来的信息，output是本工作台送出去的信息。
同一根线从发送者看是output，从接收者看就是input。大部分线在FPGA内部，不需要你拿杜邦线逐个连接。
真正接到板外的信号由board_contest_full_top端口和CST引脚约束决定。

以新延音门为例：

```text
分配器cmd_valid输出 → 延音门in_valid输入
分配器cmd_ready输入 ← 延音门in_ready输出
延音门out_valid输出 → 音源cmd_valid输入
延音门out_ready输入 ← 音源cmd_ready输出
```

ready逆着数据方向返回，因为它表达“我现在能接”。输入输出不是按信号名字valid/ready固定判断，
而是按这个信号对当前模块的方向判断。

## 位宽与signed怎么看

```verilog
input wire [6:0] cmd_note;
input wire signed [12:0] active_bend_cents;
output wire signed [23:0] sample_left;
```

- cmd_note是7位无符号音高编号，可编码0..127。例如69通常代表A4，不能直接把440写进去。
- active_bend_cents是13位有符号数，传负数可以降音，单位音分；100音分是一个半音。
- sample_left是24位有符号振幅，范围−8388608..8388607，是某一瞬间的振幅，不是音高编号。

位宽能编码的范围，不等于业务允许的范围。例如12位滑条位置能编码0..4095，但当前有效标度是0..3072。
位图和普通整数也不同：25位touch_mask每一位对应一个键，并不是一个0..33554431的演奏参数。

wire/reg是Verilog声明类型；reg并不保证一定综合成寄存器。ADSR的output reg由组合always计算，
实际是否保存状态要看触发条件和赋值完整性。

## valid/ready如何交接

对于文档明确标为标准流握手的通路，在其所属时钟上升沿满足：

```text
valid=1 且 ready=1 → 完成一次传输
valid=1 且 ready=0 → 发送者继续保持valid及整组负载
valid=0           → 本拍没有有效传输
```

例如音源sample_valid=1而音效sample_ready=0时，左右样本必须一起保持，不能只保持左路，
也不能提前更新为下一帧。ready=1只是“可接收”，并不要求发送者必须先等ready才能把valid拉高。
复位/取消是否可撤回必须服从具体模块协议，不能自行把“松手了”作为撤回已呈现事件的理由。

注意：并非每个名为valid的信号都能等待ready。remote_uart_rx.valid只有接收字节脉冲，
没有ready；观察sample_valid也不允许显示反压音频。polar_lane.valid表示一次流水线结果，
没有out_ready。每个模块说明都区分这些情况。

## 为什么音源有三套接口

| 接口组 | 方向（相对voice_engine） | 交接内容 |
|---|---|---|
| cmd_* | 输入命令、输出cmd_ready | 某个声部按下/松开，音高、力度、音色 |
| done_* | 输出完成、输入done_ready | 某个声部的释放包络已经结束，可以回收槽位 |
| sample_* | 输出左右样本、输入sample_ready | 所有声部混合后的一对24位PCM |

因此cmd_voice=17不代表只有17个音，也不代表I2S有64个声道。
一个48kHz采样帧最终是一对左/右混音样本；64个逻辑声部在音源里算好再混合。

延音只改变OFF何时送给音源。它不把done伪造成提前完成，也不改变sample接口。
关闭延音后，已松键的声音进入释放；仍按住的声部继续发声。

## 帧边界为什么有engine_sample_begin

表情提交器把新增益/弯音/颤音先暂存，等begin上升沿再提交为active_*。
由于时序寄存器同一边沿更新，音源在下一上升沿或之后读取新值。
同一帧64个声部用同一份参数，避免前半帧用旧音量、后半帧用新音量。
pitch_expression的全局LFO也每生成帧只推进一次，而不是每个声部推进一次。

## 编译参数和实际连接

parameter决定综合出的电路或ROM路径，input是电路运行时送入的信息。
接口表的“默认101位”来自voice_state_ram的WIDTH默认值，而当前实例明确写WIDTH=125，
所以当前RAM数据口实际按125位连接。

连接索引里的“父模块.实例”是某个具体工作台，例如voice_engine.u_state。
同名module可以实例化多次，例如polar_lane有两条lane。实例数量、逻辑声部数、泛音分量数要分开理解。
本索引包含generate条件两侧源码，但不会证明两侧都综合进入了最终位流。

## 时钟与复位先看清

当前主要时钟是板载参考50MHz、音频工作49.152MHz、视频像素25MHz/串行125MHz。
48kHz是实际音频采样率；I2S的3.072MHz BCLK是串行输出时序，不能与工作时钟混淆。
rst_n/resetn通常低有效，reset高有效；同步/异步方式以每模块的always边沿和子模块连接为准。
DDS/ADSR组合模块没有clk，不能凭名字给它们补一个时钟。

SCL/SDA为开漏，总线高电平由上拉产生。该文档仅整理已确认接口，不新增引脚或电压接法。
