wujijun11/git/TangMega60K_Synth/releases/headroom-smoothing-20261027/暂停使用.md

# 此平滑位流暂停使用

用户实板确认：下载Finished，实体琴键失效，C3可被搜索到但FPGA握手超时；相同接线回退`ContestFull_SliderVolume_TEST1024.fs`后恢复。

仿真及STA通过不等于实板通过，不能继续将该ZIP当作可用最新版。原ZIP、哈希与位流保留，便于复现，未用新文件覆盖历史证据。根因尚未确认，排查在独立分支`codex/headroom-board-triage`进行。
