wujijun11/git/TangMega60K_Synth/docs/作品文档准备_20261026/主工程模块连接索引.md

# 主工程模块连接索引

[返回阅读入口](README.md)

下表仅列从board_contest_full_top静态遍历到的已知RTL模块。不展开generate参数、不统计实例复制数量、不含外部厂商原语；因此不能拿表长当资源或振荡器数量。

| 模块 | 定义文件 | 直接实例化的模块（实例名） |
|---|---|---|
| `PLL_INIT` | [rtl/clock/pll_init.v](../../rtl/clock/pll_init.v) | 无本清单可识别的子模块 |
| `adsr` | [rtl/audio/adsr.v](../../rtl/audio/adsr.v) | 无本清单可识别的子模块 |
| `audio_clock_48k` | [rtl/clock/audio_clock_48k.v](../../rtl/clock/audio_clock_48k.v) | audio_plla_stage（pll_38m4）；audio_plla_stage（pll_49m152） |
| `audio_fx` | [rtl/audio/audio_fx.v](../../rtl/audio/audio_fx.v) | 无本清单可识别的子模块 |
| `audio_monitor_cdc` | [rtl/visual/audio_monitor_cdc.v](../../rtl/visual/audio_monitor_cdc.v) | 无本清单可识别的子模块 |
| `audio_plla_stage` | [rtl/clock/audio_clock_48k.v](../../rtl/clock/audio_clock_48k.v) | PLL_INIT（init） |
| `audio_visualizer` | [rtl/visual/audio_visualizer.v](../../rtl/visual/audio_visualizer.v) | 无本清单可识别的子模块 |
| `bin16_to_bcd` | [rtl/visual/bin16_to_bcd.v](../../rtl/visual/bin16_to_bcd.v) | 无本清单可识别的子模块 |
| `board_bringup_top` | [rtl/board/board_bringup_top.v](../../rtl/board/board_bringup_top.v) | 无本清单可识别的子模块 |
| `board_contest_full_top` | [rtl/board/board_contest_full_top.v](../../rtl/board/board_contest_full_top.v) | board_bringup_top（board）；audio_clock_48k（audio_clock）；video_clocking（video_clock）；board_local_actions（local_actions）；video_timing_640x480（timing）；instrument_full_system（system）；oled_status_display（display）；video_sync_align（align）；video_tmds_tx（video） |
| `board_local_actions` | [rtl/board/board_contest_full_top.v](../../rtl/board/board_contest_full_top.v) | 无本清单可识别的子模块 |
| `captain_control_top_v2` | [rtl/captain_control_top_v2.v](../../rtl/captain_control_top_v2.v) | voice_allocator_v2（u_allocator）；expression_controls_v2（u_expression） |
| `dds_lane` | [rtl/audio/dds_lane.v](../../rtl/audio/dds_lane.v) | 无本清单可识别的子模块 |
| `event_fifo_v2` | [rtl/event_fifo_v2.v](../../rtl/event_fifo_v2.v) | 无本清单可识别的子模块 |
| `expression_controls_v2` | [rtl/expression_controls_v2.v](../../rtl/expression_controls_v2.v) | 无本清单可识别的子模块 |
| `expression_merge` | [rtl/control/expression_merge.v](../../rtl/control/expression_merge.v) | 无本清单可识别的子模块 |
| `fm_piano_lane` | [rtl/audio/fm_piano_lane.v](../../rtl/audio/fm_piano_lane.v) | 无本清单可识别的子模块 |
| `gain_percent_meter` | [rtl/control/gain_percent_meter.v](../../rtl/control/gain_percent_meter.v) | 无本清单可识别的子模块 |
| `gain_saturator` | [rtl/audio/gain_saturator.v](../../rtl/audio/gain_saturator.v) | 无本清单可识别的子模块 |
| `i2c_register_master` | [rtl/sensors/i2c_register_master.v](../../rtl/sensors/i2c_register_master.v) | 无本清单可识别的子模块 |
| `i2s_tx` | [rtl/i2s_tx.v](../../rtl/i2s_tx.v) | 无本清单可识别的子模块 |
| `instrument_full_system` | [rtl/instrument_full_system.v](../../rtl/instrument_full_system.v) | remote_uart_transport（uart）；remote_command_router（router）；mpr121_input_frontend（sensors）；slider_menu_controller（menu_input）；menu_action_router（menu_actions）；key_map_transpose（transpose_keys）；local_action_arbiter（local_controls）；performance_command_stage（performance_commands）；performance_controller（performance）；ws2812_guide（guide）；remote_note_watchdog（watchdog）；note_arbiter（arbiter）；event_fifo_v2（events）；slider_volume_control（volume）；expression_merge（expression）；gain_percent_meter（volume_meter）；captain_control_top_v2（control）；voice_engine（synth）；runtime_audio_fx（effects）；ui_tone_overlay（ui_prompt）；i2s_tx（audio）；audio_monitor_cdc（monitor）；audio_visualizer（visual）；scope_renderer（renderer） |
| `key_map_transpose` | [rtl/control/key_map_transpose.v](../../rtl/control/key_map_transpose.v) | 无本清单可识别的子模块 |
| `learning_stepper` | [rtl/performance/learning_stepper.v](../../rtl/performance/learning_stepper.v) | 无本清单可识别的子模块 |
| `local_action_arbiter` | [rtl/control/local_action_arbiter.v](../../rtl/control/local_action_arbiter.v) | 无本清单可识别的子模块 |
| `menu_action_router` | [rtl/control/menu_action_router.v](../../rtl/control/menu_action_router.v) | 无本清单可识别的子模块 |
| `mpr121_input_frontend` | [rtl/sensors/mpr121_input_frontend.v](../../rtl/sensors/mpr121_input_frontend.v) | mpr121_sampler（sampler）；mpr121_key_eventizer（eventizer）；mpr121_slider（slider） |
| `mpr121_key_eventizer` | [rtl/sensors/mpr121_key_eventizer.v](../../rtl/sensors/mpr121_key_eventizer.v) | 无本清单可识别的子模块 |
| `mpr121_sampler` | [rtl/sensors/mpr121_sampler.v](../../rtl/sensors/mpr121_sampler.v) | i2c_register_master（bus） |
| `mpr121_slider` | [rtl/sensors/mpr121_slider.v](../../rtl/sensors/mpr121_slider.v) | 无本清单可识别的子模块 |
| `note_arbiter` | [rtl/control/note_arbiter.v](../../rtl/control/note_arbiter.v) | 无本清单可识别的子模块 |
| `oled_menu_renderer` | [rtl/visual/oled_menu_renderer.v](../../rtl/visual/oled_menu_renderer.v) | 无本清单可识别的子模块 |
| `oled_status_display` | [rtl/visual/oled_status_display.v](../../rtl/visual/oled_status_display.v) | bin16_to_bcd（decimal_count）；bin16_to_bcd（decimal_volume）；oled_menu_renderer（renderer）；i2c_register_master（bus） |
| `performance_command_stage` | [rtl/control/performance_command_stage.v](../../rtl/control/performance_command_stage.v) | 无本清单可识别的子模块 |
| `performance_controller` | [rtl/performance/performance_controller.v](../../rtl/performance/performance_controller.v) | learning_stepper（stepper） |
| `pitch_expression` | [rtl/audio/pitch_expression.v](../../rtl/audio/pitch_expression.v) | 无本清单可识别的子模块 |
| `polar_lane` | [rtl/audio/polar_lane.v](../../rtl/audio/polar_lane.v) | 无本清单可识别的子模块 |
| `remote_command_router` | [rtl/control/remote_command_router.v](../../rtl/control/remote_command_router.v) | 无本清单可识别的子模块 |
| `remote_note_watchdog` | [rtl/control/remote_note_watchdog.v](../../rtl/control/remote_note_watchdog.v) | 无本清单可识别的子模块 |
| `remote_uart_rx` | [rtl/remote/remote_uart_transport.sv](../../rtl/remote/remote_uart_transport.sv) | 无本清单可识别的子模块 |
| `remote_uart_transport` | [rtl/remote/remote_uart_transport.sv](../../rtl/remote/remote_uart_transport.sv) | remote_uart_rx（receiver）；remote_uart_tx（transmitter） |
| `remote_uart_tx` | [rtl/remote/remote_uart_transport.sv](../../rtl/remote/remote_uart_transport.sv) | 无本清单可识别的子模块 |
| `runtime_audio_fx` | [rtl/audio/runtime_audio_fx.v](../../rtl/audio/runtime_audio_fx.v) | 无本清单可识别的子模块 |
| `scope_renderer` | [rtl/visual/scope_renderer.v](../../rtl/visual/scope_renderer.v) | 无本清单可识别的子模块 |
| `slider_menu_controller` | [rtl/control/slider_menu_controller.v](../../rtl/control/slider_menu_controller.v) | 无本清单可识别的子模块 |
| `slider_volume_control` | [rtl/control/slider_volume_control.v](../../rtl/control/slider_volume_control.v) | 无本清单可识别的子模块 |
| `stereo_mixer` | [rtl/audio/stereo_mixer.v](../../rtl/audio/stereo_mixer.v) | 无本清单可识别的子模块 |
| `ui_tone_overlay` | [rtl/audio/ui_tone_overlay.v](../../rtl/audio/ui_tone_overlay.v) | 无本清单可识别的子模块 |
| `video_clocking` | [rtl/visual/video_clocking.v](../../rtl/visual/video_clocking.v) | PLL_INIT（init） |
| `video_serializer10` | [rtl/visual/video_tmds_tx.v](../../rtl/visual/video_tmds_tx.v) | 无本清单可识别的子模块 |
| `video_sync_align` | [rtl/visual/video_timing_640x480.v](../../rtl/visual/video_timing_640x480.v) | 无本清单可识别的子模块 |
| `video_timing_640x480` | [rtl/visual/video_timing_640x480.v](../../rtl/visual/video_timing_640x480.v) | 无本清单可识别的子模块 |
| `video_tmds_encoder` | [rtl/visual/video_tmds_encoder.v](../../rtl/visual/video_tmds_encoder.v) | 无本清单可识别的子模块 |
| `video_tmds_tx` | [rtl/visual/video_tmds_tx.v](../../rtl/visual/video_tmds_tx.v) | video_tmds_encoder（enc_red）；video_tmds_encoder（enc_green）；video_tmds_encoder（enc_blue）；video_serializer10（red_lane）；video_serializer10（green_lane）；video_serializer10（blue_lane）；video_serializer10（clock_lane） |
| `voice_allocator_v2` | [rtl/voice_allocator_v2.v](../../rtl/voice_allocator_v2.v) | 无本清单可识别的子模块 |
| `voice_engine` | [rtl/audio/voice_engine.v](../../rtl/audio/voice_engine.v) | voice_state_ram（u_state）；adsr（u_adsr）；pitch_expression（u_expression）；dds_lane（u_dds）；polar_lane（u_polar0）；polar_lane（u_polar1）；fm_piano_lane（u_fm）；wavetable_rom（u_tables）；stereo_mixer（u_mixer）；stereo_mixer（u_mixer_r）；gain_saturator（u_gain）；audio_fx（u_fx） |
| `voice_state_ram` | [rtl/audio/voice_state_ram.v](../../rtl/audio/voice_state_ram.v) | 无本清单可识别的子模块 |
| `wavetable_rom` | [rtl/audio/wavetable_rom.v](../../rtl/audio/wavetable_rom.v) | 无本清单可识别的子模块 |
| `ws2812_guide` | [rtl/performance/ws2812_guide.v](../../rtl/performance/ws2812_guide.v) | 无本清单可识别的子模块 |
