wujijun11/git/TangMega60K_Synth/docs/作品文档准备_20261026/其他工程文件索引.md

# 其他工程文件索引

[返回阅读入口](README.md)

补充列出冻结版本的1134个配套/归档文件，与520个开发源码文件合计1654项；其中151项归档代码/HTML报告另在源码逐文件说明文末详列。报告、图像、压缩包、ROM和约束不是同一种文件；此表按用途分类，不代替报告内容审查。

| 文件 | 用途 |
|---|---|
| [.gitattributes](../../.gitattributes) | Git忽略/文本属性规则，控制缓存、生成物与换行处理。 |
| [.gitignore](../../.gitignore) | Git忽略/文本属性规则，控制缓存、生成物与换行处理。 |
| [AudioEngine_V2.gprj](../../AudioEngine_V2.gprj) | Gowin工程入口：列出器件与输入文件；具体顶层由配套构建脚本指定。 |
| [BoardAudioDiagnostic.gprj](../../BoardAudioDiagnostic.gprj) | Gowin工程入口：列出器件与输入文件；具体顶层由配套构建脚本指定。 |
| [BoardAudioGAO.gprj](../../BoardAudioGAO.gprj) | Gowin工程入口：列出器件与输入文件；具体顶层由配套构建脚本指定。 |
| [BoardBringup.gprj](../../BoardBringup.gprj) | Gowin工程入口：列出器件与输入文件；具体顶层由配套构建脚本指定。 |
| [Live64_Diagnostic.gprj](../../Live64_Diagnostic.gprj) | Gowin工程入口：列出器件与输入文件；具体顶层由配套构建脚本指定。 |
| [README.md](../../README.md) | 所在模块的入口、用法与验证边界说明。 |
| [TangMega60K_Synth.gprj](../../TangMega60K_Synth.gprj) | Gowin工程入口：列出器件与输入文件；具体顶层由配套构建脚本指定。 |
| [TangMega60K_Synth_V2.gprj](../../TangMega60K_Synth_V2.gprj) | Gowin工程入口：列出器件与输入文件；具体顶层由配套构建脚本指定。 |
| [ToneDemo.gprj](../../ToneDemo.gprj) | Gowin工程入口：列出器件与输入文件；具体顶层由配套构建脚本指定。 |
| [assets/audio/LICENSE-Salamander.txt](../../assets/audio/LICENSE-Salamander.txt) | 音色离线拟合参数、参考来源或授权说明；不可据此宣称实时播放原始PCM。 |
| [assets/audio/README.md](../../assets/audio/README.md) | 音色离线拟合参数、参考来源或授权说明；不可据此宣称实时播放原始PCM。 |
| [assets/audio/piano_a4_iq.json](../../assets/audio/piano_a4_iq.json) | 音色离线拟合参数、参考来源或授权说明；不可据此宣称实时播放原始PCM。 |
| [assets/audio/piano_eight_profiles.json](../../assets/audio/piano_eight_profiles.json) | 音色离线拟合参数、参考来源或授权说明；不可据此宣称实时播放原始PCM。 |
| [board16/BoardAudio16_48kI2S.gprj](../../board16/BoardAudio16_48kI2S.gprj) | Gowin工程入口：列出器件与输入文件；具体顶层由配套构建脚本指定。 |
| [board16/rtl/audio/rom/midi.hex](../../board16/rtl/audio/rom/midi.hex) | 128个MIDI音高的频率控制字；HDL初始化输入，不等于整段录音。 |
| [board16/rtl/audio/rom/piano.hex](../../board16/rtl/audio/rom/piano.hex) | 原钢琴数学查表数据；HDL初始化输入，不等于整段录音。 |
| [board16/rtl/audio/rom/polar_lane0.hex](../../board16/rtl/audio/rom/polar_lane0.hex) | 八成分钢琴偶数通道的分段幅度/相位参数；HDL初始化输入，不等于整段录音。 |
| [board16/rtl/audio/rom/polar_lane1.hex](../../board16/rtl/audio/rom/polar_lane1.hex) | 八成分钢琴奇数通道的分段幅度/相位参数；HDL初始化输入，不等于整段录音。 |
| [board16/rtl/audio/rom/polar_ratios.hex](../../board16/rtl/audio/rom/polar_ratios.hex) | 八成分非整数谐波频率比例；HDL初始化输入，不等于整段录音。 |
| [board16/rtl/audio/rom/ratio.hex](../../board16/rtl/audio/rom/ratio.hex) | 弯音/颤音的音高比例查表；HDL初始化输入，不等于整段录音。 |
| [board16/rtl/audio/rom/sine.hex](../../board16/rtl/audio/rom/sine.hex) | 正弦波表；HDL初始化输入，不等于整段录音。 |
| [board16/rtl/audio/rom/velocity.hex](../../board16/rtl/audio/rom/velocity.hex) | 力度到幅度的曲线；HDL初始化输入，不等于整段录音。 |
| [board16/rtl/audio/rom/waves.hex](../../board16/rtl/audio/rom/waves.hex) | 数学周期波形查表数据；HDL初始化输入，不等于整段录音。 |
| [boardkeys48/BoardInstrumentB48kI2S.gprj](../../boardkeys48/BoardInstrumentB48kI2S.gprj) | Gowin工程入口：列出器件与输入文件；具体顶层由配套构建脚本指定。 |
| [boardkeys48/rtl/audio/rom/midi.hex](../../boardkeys48/rtl/audio/rom/midi.hex) | 128个MIDI音高的频率控制字；HDL初始化输入，不等于整段录音。 |
| [boardkeys48/rtl/audio/rom/piano.hex](../../boardkeys48/rtl/audio/rom/piano.hex) | 原钢琴数学查表数据；HDL初始化输入，不等于整段录音。 |
| [boardkeys48/rtl/audio/rom/polar_lane0.hex](../../boardkeys48/rtl/audio/rom/polar_lane0.hex) | 八成分钢琴偶数通道的分段幅度/相位参数；HDL初始化输入，不等于整段录音。 |
| [boardkeys48/rtl/audio/rom/polar_lane1.hex](../../boardkeys48/rtl/audio/rom/polar_lane1.hex) | 八成分钢琴奇数通道的分段幅度/相位参数；HDL初始化输入，不等于整段录音。 |
| [boardkeys48/rtl/audio/rom/polar_ratios.hex](../../boardkeys48/rtl/audio/rom/polar_ratios.hex) | 八成分非整数谐波频率比例；HDL初始化输入，不等于整段录音。 |
| [boardkeys48/rtl/audio/rom/ratio.hex](../../boardkeys48/rtl/audio/rom/ratio.hex) | 弯音/颤音的音高比例查表；HDL初始化输入，不等于整段录音。 |
| [boardkeys48/rtl/audio/rom/sine.hex](../../boardkeys48/rtl/audio/rom/sine.hex) | 正弦波表；HDL初始化输入，不等于整段录音。 |
| [boardkeys48/rtl/audio/rom/velocity.hex](../../boardkeys48/rtl/audio/rom/velocity.hex) | 力度到幅度的曲线；HDL初始化输入，不等于整段录音。 |
| [boardkeys48/rtl/audio/rom/waves.hex](../../boardkeys48/rtl/audio/rom/waves.hex) | 数学周期波形查表数据；HDL初始化输入，不等于整段录音。 |
| [boardseq16/BoardSequence16_48kI2S.gprj](../../boardseq16/BoardSequence16_48kI2S.gprj) | Gowin工程入口：列出器件与输入文件；具体顶层由配套构建脚本指定。 |
| [boardseq16/rtl/audio/rom/midi.hex](../../boardseq16/rtl/audio/rom/midi.hex) | 128个MIDI音高的频率控制字；HDL初始化输入，不等于整段录音。 |
| [boardseq16/rtl/audio/rom/piano.hex](../../boardseq16/rtl/audio/rom/piano.hex) | 原钢琴数学查表数据；HDL初始化输入，不等于整段录音。 |
| [boardseq16/rtl/audio/rom/polar_lane0.hex](../../boardseq16/rtl/audio/rom/polar_lane0.hex) | 八成分钢琴偶数通道的分段幅度/相位参数；HDL初始化输入，不等于整段录音。 |
| [boardseq16/rtl/audio/rom/polar_lane1.hex](../../boardseq16/rtl/audio/rom/polar_lane1.hex) | 八成分钢琴奇数通道的分段幅度/相位参数；HDL初始化输入，不等于整段录音。 |
| [boardseq16/rtl/audio/rom/polar_ratios.hex](../../boardseq16/rtl/audio/rom/polar_ratios.hex) | 八成分非整数谐波频率比例；HDL初始化输入，不等于整段录音。 |
| [boardseq16/rtl/audio/rom/ratio.hex](../../boardseq16/rtl/audio/rom/ratio.hex) | 弯音/颤音的音高比例查表；HDL初始化输入，不等于整段录音。 |
| [boardseq16/rtl/audio/rom/sine.hex](../../boardseq16/rtl/audio/rom/sine.hex) | 正弦波表；HDL初始化输入，不等于整段录音。 |
| [boardseq16/rtl/audio/rom/velocity.hex](../../boardseq16/rtl/audio/rom/velocity.hex) | 力度到幅度的曲线；HDL初始化输入，不等于整段录音。 |
| [boardseq16/rtl/audio/rom/waves.hex](../../boardseq16/rtl/audio/rom/waves.hex) | 数学周期波形查表数据；HDL初始化输入，不等于整段录音。 |
| [clock48/BoardAudio48kGAO.gprj](../../clock48/BoardAudio48kGAO.gprj) | Gowin工程入口：列出器件与输入文件；具体顶层由配套构建脚本指定。 |
| [clock48/BoardAudio48kI2S.gprj](../../clock48/BoardAudio48kI2S.gprj) | Gowin工程入口：列出器件与输入文件；具体顶层由配套构建脚本指定。 |
| [clock48/BoardInstrumentB48kGAO.gprj](../../clock48/BoardInstrumentB48kGAO.gprj) | Gowin工程入口：列出器件与输入文件；具体顶层由配套构建脚本指定。 |
| [clock48/board48k.sdc](../../clock48/board48k.sdc) | 时钟、生成时钟和时序约束；不是通过缩短文档数字提高硬件速度。 |
| [clock48/board48k_i2s.cst](../../clock48/board48k_i2s.cst) | 物理引脚和I/O电平约束；须对应此工程的实物接线。 |
| [clock48/board48k_i2s.sdc](../../clock48/board48k_i2s.sdc) | 时钟、生成时钟和时序约束；不是通过缩短文档数字提高硬件速度。 |
| [clock48/board_audio_48k.rao](../../clock48/board_audio_48k.rao) | GAO片内逻辑分析仪配置；启用会影响资源与布局，须区分调试/发布构建。 |
| [clock48/board_b_48k.sdc](../../clock48/board_b_48k.sdc) | 时钟、生成时钟和时序约束；不是通过缩短文档数字提高硬件速度。 |
| [clock48/board_instrument_b_48k.rao](../../clock48/board_instrument_b_48k.rao) | GAO片内逻辑分析仪配置；启用会影响资源与布局，须区分调试/发布构建。 |
| [clock48/rtl/audio/rom/midi.hex](../../clock48/rtl/audio/rom/midi.hex) | 128个MIDI音高的频率控制字；HDL初始化输入，不等于整段录音。 |
| [clock48/rtl/audio/rom/piano.hex](../../clock48/rtl/audio/rom/piano.hex) | 原钢琴数学查表数据；HDL初始化输入，不等于整段录音。 |
| [clock48/rtl/audio/rom/polar_lane0.hex](../../clock48/rtl/audio/rom/polar_lane0.hex) | 八成分钢琴偶数通道的分段幅度/相位参数；HDL初始化输入，不等于整段录音。 |
| [clock48/rtl/audio/rom/polar_lane1.hex](../../clock48/rtl/audio/rom/polar_lane1.hex) | 八成分钢琴奇数通道的分段幅度/相位参数；HDL初始化输入，不等于整段录音。 |
| [clock48/rtl/audio/rom/polar_ratios.hex](../../clock48/rtl/audio/rom/polar_ratios.hex) | 八成分非整数谐波频率比例；HDL初始化输入，不等于整段录音。 |
| [clock48/rtl/audio/rom/ratio.hex](../../clock48/rtl/audio/rom/ratio.hex) | 弯音/颤音的音高比例查表；HDL初始化输入，不等于整段录音。 |
| [clock48/rtl/audio/rom/sine.hex](../../clock48/rtl/audio/rom/sine.hex) | 正弦波表；HDL初始化输入，不等于整段录音。 |
| [clock48/rtl/audio/rom/velocity.hex](../../clock48/rtl/audio/rom/velocity.hex) | 力度到幅度的曲线；HDL初始化输入，不等于整段录音。 |
| [clock48/rtl/audio/rom/waves.hex](../../clock48/rtl/audio/rom/waves.hex) | 数学周期波形查表数据；HDL初始化输入，不等于整段录音。 |
| [constraints/board_audio.sdc](../../constraints/board_audio.sdc) | 时钟、生成时钟和时序约束；不是通过缩短文档数字提高硬件速度。 |
| [constraints/board_bringup.cst](../../constraints/board_bringup.cst) | 物理引脚和I/O电平约束；须对应此工程的实物接线。 |
| [constraints/board_bringup.sdc](../../constraints/board_bringup.sdc) | 时钟、生成时钟和时序约束；不是通过缩短文档数字提高硬件速度。 |
| [constraints/board_gao.sdc](../../constraints/board_gao.sdc) | 时钟、生成时钟和时序约束；不是通过缩短文档数字提高硬件速度。 |
| [debug/board_audio.rao](../../debug/board_audio.rao) | GAO片内逻辑分析仪配置；启用会影响资源与布局，须区分调试/发布构建。 |
| [desktop/README.md](../../desktop/README.md) | 所在模块的入口、用法与验证边界说明。 |
| [desktop/assets/neon.ico](../../desktop/assets/neon.ico) | 配套配置/数据/说明；结合所属目录使用，不作为独立可执行功能。 |
| [desktop/assets/neon.png](../../desktop/assets/neon.png) | 示意、波形或界面图片；需区分预览/仿真和真实实物照片。 |
| [desktop/examples/C4-C6.json](../../desktop/examples/C4-C6.json) | 配套配置/数据/说明；结合所属目录使用，不作为独立可执行功能。 |
| [desktop/requirements.txt](../../desktop/requirements.txt) | Python依赖与版本清单。 |
| [docs/25灯WS2812逐键指引_20261025.md](../../docs/25%E7%81%AFWS2812%E9%80%90%E9%94%AE%E6%8C%87%E5%BC%95_20261025.md) | 接口、算法、装配、使用或历史技术说明；日期早的说明可能不代表当前入口。 |
| [docs/31005接口映射核对-20261017.md](../../docs/31005%E6%8E%A5%E5%8F%A3%E6%98%A0%E5%B0%84%E6%A0%B8%E5%AF%B9-20261017.md) | 接口、算法、装配、使用或历史技术说明；日期早的说明可能不代表当前入口。 |
| [docs/64音现场自检与接入.md](../../docs/64%E9%9F%B3%E7%8E%B0%E5%9C%BA%E8%87%AA%E6%A3%80%E4%B8%8E%E6%8E%A5%E5%85%A5.md) | 接口、算法、装配、使用或历史技术说明；日期早的说明可能不代表当前入口。 |
| [docs/64音自检验证记录.md](../../docs/64%E9%9F%B3%E8%87%AA%E6%A3%80%E9%AA%8C%E8%AF%81%E8%AE%B0%E5%BD%95.md) | 接口、算法、装配、使用或历史技术说明；日期早的说明可能不代表当前入口。 |
| [docs/FM电钢琴实验.md](../../docs/FM%E7%94%B5%E9%92%A2%E7%90%B4%E5%AE%9E%E9%AA%8C.md) | 接口、算法、装配、使用或历史技术说明；日期早的说明可能不代表当前入口。 |
| [docs/Live64合并验证-20260919.md](../../docs/Live64%E5%90%88%E5%B9%B6%E9%AA%8C%E8%AF%81-20260919.md) | 接口、算法、装配、使用或历史技术说明；日期早的说明可能不代表当前入口。 |
| [docs/ModelSim完整回归-20260919.md](../../docs/ModelSim%E5%AE%8C%E6%95%B4%E5%9B%9E%E5%BD%92-20260919.md) | 接口、算法、装配、使用或历史技术说明；日期早的说明可能不代表当前入口。 |
| [docs/ModelSim波形检查-20260918.md](../../docs/ModelSim%E6%B3%A2%E5%BD%A2%E6%A3%80%E6%9F%A5-20260918.md) | 接口、算法、装配、使用或历史技术说明；日期早的说明可能不代表当前入口。 |
| [docs/OLED完整工程接入_20261026.md](../../docs/OLED%E5%AE%8C%E6%95%B4%E5%B7%A5%E7%A8%8B%E6%8E%A5%E5%85%A5_20261026.md) | 接口、算法、装配、使用或历史技术说明；日期早的说明可能不代表当前入口。 |
| [docs/PT8211板载DAC适配-20260919.md](../../docs/PT8211%E6%9D%BF%E8%BD%BDDAC%E9%80%82%E9%85%8D-20260919.md) | 接口、算法、装配、使用或历史技术说明；日期早的说明可能不代表当前入口。 |
| [docs/TangMega60K-Dock兼容性核查-20260919.md](../../docs/TangMega60K-Dock%E5%85%BC%E5%AE%B9%E6%80%A7%E6%A0%B8%E6%9F%A5-20260919.md) | 接口、算法、装配、使用或历史技术说明；日期早的说明可能不代表当前入口。 |
| [docs/hardware/16声部持续发声测试-20261008.md](../../docs/hardware/16%E5%A3%B0%E9%83%A8%E6%8C%81%E7%BB%AD%E5%8F%91%E5%A3%B0%E6%B5%8B%E8%AF%95-20261008.md) | 接口、算法、装配、使用或历史技术说明；日期早的说明可能不代表当前入口。 |
| [docs/hardware/16音逐个播放测试-20261008.md](../../docs/hardware/16%E9%9F%B3%E9%80%90%E4%B8%AA%E6%92%AD%E6%94%BE%E6%B5%8B%E8%AF%95-20261008.md) | 接口、算法、装配、使用或历史技术说明；日期早的说明可能不代表当前入口。 |
| [docs/hardware/25键LED指引选购与安装-20261011.md](../../docs/hardware/25%E9%94%AELED%E6%8C%87%E5%BC%95%E9%80%89%E8%B4%AD%E4%B8%8E%E5%AE%89%E8%A3%85-20261011.md) | 接口、算法、装配、使用或历史技术说明；日期早的说明可能不代表当前入口。 |
| [docs/hardware/48kHz外置I2S预备工程-20260923.md](../../docs/hardware/48kHz%E5%A4%96%E7%BD%AEI2S%E9%A2%84%E5%A4%87%E5%B7%A5%E7%A8%8B-20260923.md) | 接口、算法、装配、使用或历史技术说明；日期早的说明可能不代表当前入口。 |
| [docs/hardware/48kHz时钟与I2S板级验证-20260923.md](../../docs/hardware/48kHz%E6%97%B6%E9%92%9F%E4%B8%8EI2S%E6%9D%BF%E7%BA%A7%E9%AA%8C%E8%AF%81-20260923.md) | 接口、算法、装配、使用或历史技术说明；日期早的说明可能不代表当前入口。 |
| [docs/hardware/GAO板内验证-20260923.md](../../docs/hardware/GAO%E6%9D%BF%E5%86%85%E9%AA%8C%E8%AF%81-20260923.md) | 接口、算法、装配、使用或历史技术说明；日期早的说明可能不代表当前入口。 |
| [docs/hardware/PR1014-clock-investigation-20260922.md](../../docs/hardware/PR1014-clock-investigation-20260922.md) | 接口、算法、装配、使用或历史技术说明；日期早的说明可能不代表当前入口。 |
| [docs/hardware/gao-20260923/zero_underrun_later.csv](../../docs/hardware/gao-20260923/zero_underrun_later.csv) | 接口、算法、装配、使用或历史技术说明；日期早的说明可能不代表当前入口。 |
| [docs/hardware/gao-20260923/zero_underrun_results.json](../../docs/hardware/gao-20260923/zero_underrun_results.json) | 接口、算法、装配、使用或历史技术说明；日期早的说明可能不代表当前入口。 |
| [docs/hardware/gao-20260923/zero_underrun_run15.csv](../../docs/hardware/gao-20260923/zero_underrun_run15.csv) | 接口、算法、装配、使用或历史技术说明；日期早的说明可能不代表当前入口。 |
| [docs/hardware/gao-48k-20260923/board_audio_48k_core0.csv](../../docs/hardware/gao-48k-20260923/board_audio_48k_core0.csv) | 接口、算法、装配、使用或历史技术说明；日期早的说明可能不代表当前入口。 |
| [docs/hardware/gao-48k-20260923/board_audio_48k_later_core0.csv](../../docs/hardware/gao-48k-20260923/board_audio_48k_later_core0.csv) | 接口、算法、装配、使用或历史技术说明；日期早的说明可能不代表当前入口。 |
| [docs/hardware/gao-48k-20260923/board_audio_48k_reconnected_core0.csv](../../docs/hardware/gao-48k-20260923/board_audio_48k_reconnected_core0.csv) | 接口、算法、装配、使用或历史技术说明；日期早的说明可能不代表当前入口。 |
| [docs/hardware/gao-48k-20260923/verification.json](../../docs/hardware/gao-48k-20260923/verification.json) | 接口、算法、装配、使用或历史技术说明；日期早的说明可能不代表当前入口。 |
| [docs/hardware/gao-48k-20260923/verification_reconnected.json](../../docs/hardware/gao-48k-20260923/verification_reconnected.json) | 接口、算法、装配、使用或历史技术说明；日期早的说明可能不代表当前入口。 |
| [docs/hardware/mini_keyboard_enclosure_plan.md](../../docs/hardware/mini_keyboard_enclosure_plan.md) | 接口、算法、装配、使用或历史技术说明；日期早的说明可能不代表当前入口。 |
| [docs/hardware/reference/Tang_Mega_138K_NEO_Dock.pdf](../../docs/hardware/reference/Tang_Mega_138K_NEO_Dock.pdf) | 接口、算法、装配、使用或历史技术说明；日期早的说明可能不代表当前入口。 |
| [docs/hardware/reports/BoardAudio48kI2S-eight-20260923-timing.html](../../docs/hardware/reports/BoardAudio48kI2S-eight-20260923-timing.html) | Gowin自动生成的引脚/资源/时序HTML报告，不是运行程序；内容只对应该目录的构建版本。 |
| [docs/hardware/reports/BoardAudio48kI2S-eight-20260923.rpt.txt](../../docs/hardware/reports/BoardAudio48kI2S-eight-20260923.rpt.txt) | 接口、算法、装配、使用或历史技术说明；日期早的说明可能不代表当前入口。 |
| [docs/hardware/主工程0111操作与验收-20261021.md](../../docs/hardware/%E4%B8%BB%E5%B7%A5%E7%A8%8B0111%E6%93%8D%E4%BD%9C%E4%B8%8E%E9%AA%8C%E6%94%B6-20261021.md) | 接口、算法、装配、使用或历史技术说明；日期早的说明可能不代表当前入口。 |
| [docs/hardware/主工程板上复测-20261011.md](../../docs/hardware/%E4%B8%BB%E5%B7%A5%E7%A8%8B%E6%9D%BF%E4%B8%8A%E5%A4%8D%E6%B5%8B-20261011.md) | 接口、算法、装配、使用或历史技术说明；日期早的说明可能不代表当前入口。 |
| [docs/hardware/主音源板级接入-20260922.md](../../docs/hardware/%E4%B8%BB%E9%9F%B3%E6%BA%90%E6%9D%BF%E7%BA%A7%E6%8E%A5%E5%85%A5-20260922.md) | 接口、算法、装配、使用或历史技术说明；日期早的说明可能不代表当前入口。 |
| [docs/hardware/启动欠载修复-20260923.md](../../docs/hardware/%E5%90%AF%E5%8A%A8%E6%AC%A0%E8%BD%BD%E4%BF%AE%E5%A4%8D-20260923.md) | 接口、算法、装配、使用或历史技术说明；日期早的说明可能不代表当前入口。 |
| [docs/hardware/外置I2S下载验证-20260927.md](../../docs/hardware/%E5%A4%96%E7%BD%AEI2S%E4%B8%8B%E8%BD%BD%E9%AA%8C%E8%AF%81-20260927.md) | 接口、算法、装配、使用或历史技术说明；日期早的说明可能不代表当前入口。 |
| [docs/hardware/外置I2S下载验证-20261007.md](../../docs/hardware/%E5%A4%96%E7%BD%AEI2S%E4%B8%8B%E8%BD%BD%E9%AA%8C%E8%AF%81-20261007.md) | 接口、算法、装配、使用或历史技术说明；日期早的说明可能不代表当前入口。 |
| [docs/hardware/官方资料读取-20260920.md](../../docs/hardware/%E5%AE%98%E6%96%B9%E8%B5%84%E6%96%99%E8%AF%BB%E5%8F%96-20260920.md) | 接口、算法、装配、使用或历史技术说明；日期早的说明可能不代表当前入口。 |
| [docs/hardware/按键响应优化-20261008.md](../../docs/hardware/%E6%8C%89%E9%94%AE%E5%93%8D%E5%BA%94%E4%BC%98%E5%8C%96-20261008.md) | 接口、算法、装配、使用或历史技术说明；日期早的说明可能不代表当前入口。 |
| [docs/hardware/板级验证-20260922.md](../../docs/hardware/%E6%9D%BF%E7%BA%A7%E9%AA%8C%E8%AF%81-20260922.md) | 接口、算法、装配、使用或历史技术说明；日期早的说明可能不代表当前入口。 |
| [docs/hardware/板载按键演奏-20261007.md](../../docs/hardware/%E6%9D%BF%E8%BD%BD%E6%8C%89%E9%94%AE%E6%BC%94%E5%A5%8F-20261007.md) | 接口、算法、装配、使用或历史技术说明；日期早的说明可能不代表当前入口。 |
| [docs/hardware/队员B-48kHz板内自检-20260924.md](../../docs/hardware/%E9%98%9F%E5%91%98B-48kHz%E6%9D%BF%E5%86%85%E8%87%AA%E6%A3%80-20260924.md) | 接口、算法、装配、使用或历史技术说明；日期早的说明可能不代表当前入口。 |
| [docs/live64/frequencies64.csv](../../docs/live64/frequencies64.csv) | 接口、算法、装配、使用或历史技术说明；日期早的说明可能不代表当前入口。 |
| [docs/mpr121-implementation.md](../../docs/mpr121-implementation.md) | 接口、算法、装配、使用或历史技术说明；日期早的说明可能不代表当前入口。 |
| [docs/performance-implementation.md](../../docs/performance-implementation.md) | 接口、算法、装配、使用或历史技术说明；日期早的说明可能不代表当前入口。 |
| [docs/remote-control-v1.md](../../docs/remote-control-v1.md) | 接口、算法、装配、使用或历史技术说明；日期早的说明可能不代表当前入口。 |
| [docs/remote-implementation.md](../../docs/remote-implementation.md) | 接口、算法、装配、使用或历史技术说明；日期早的说明可能不代表当前入口。 |
| [docs/reports/pipeline-round2-20261026/comparison.json](../../docs/reports/pipeline-round2-20261026/comparison.json) | 报告原始证据或摘要；按日期、候选和冻结输入核对，不能混作当前实测。 |
| [docs/reports/pipeline-round2-20261026/experiment-elastic-r3/build-results.json](../../docs/reports/pipeline-round2-20261026/experiment-elastic-r3/build-results.json) | 报告原始证据或摘要；按日期、候选和冻结输入核对，不能混作当前实测。 |
| [docs/reports/pipeline-round2-20261026/experiment-elastic-r3/gowin-build.log](../../docs/reports/pipeline-round2-20261026/experiment-elastic-r3/gowin-build.log) | 报告原始证据或摘要；按日期、候选和冻结输入核对，不能混作当前实测。 |
| [docs/reports/pipeline-round2-20261026/experiment-elastic-r3/gowin-run.json](../../docs/reports/pipeline-round2-20261026/experiment-elastic-r3/gowin-run.json) | 报告原始证据或摘要；按日期、候选和冻结输入核对，不能混作当前实测。 |
| [docs/reports/pipeline-round2-20261026/experiment-elastic-r3/modelsim-experiment/global_panic.log](../../docs/reports/pipeline-round2-20261026/experiment-elastic-r3/modelsim-experiment/global_panic.log) | 报告原始证据或摘要；按日期、候选和冻结输入核对，不能混作当前实测。 |
| [docs/reports/pipeline-round2-20261026/experiment-elastic-r3/modelsim-experiment/manifest.json](../../docs/reports/pipeline-round2-20261026/experiment-elastic-r3/modelsim-experiment/manifest.json) | 报告原始证据或摘要；按日期、候选和冻结输入核对，不能混作当前实测。 |
| [docs/reports/pipeline-round2-20261026/experiment-elastic-r3/modelsim-experiment/test-summary.json](../../docs/reports/pipeline-round2-20261026/experiment-elastic-r3/modelsim-experiment/test-summary.json) | 报告原始证据或摘要；按日期、候选和冻结输入核对，不能混作当前实测。 |
| [docs/reports/pipeline-round2-20261026/experiment-elastic-r3/pre-adjustment/global_panic.log](../../docs/reports/pipeline-round2-20261026/experiment-elastic-r3/pre-adjustment/global_panic.log) | 报告原始证据或摘要；按日期、候选和冻结输入核对，不能混作当前实测。 |
| [docs/reports/pipeline-round2-20261026/experiment-elastic-r3/pre-adjustment/test-summary.json](../../docs/reports/pipeline-round2-20261026/experiment-elastic-r3/pre-adjustment/test-summary.json) | 报告原始证据或摘要；按日期、候选和冻结输入核对，不能混作当前实测。 |
| [docs/reports/pipeline-round2-20261026/experiment-elastic-r3/snapshot-inputs-after.json](../../docs/reports/pipeline-round2-20261026/experiment-elastic-r3/snapshot-inputs-after.json) | 报告原始证据或摘要；按日期、候选和冻结输入核对，不能混作当前实测。 |
| [docs/reports/pipeline-round2-20261026/experiment-elastic-r3/snapshot-inputs.json](../../docs/reports/pipeline-round2-20261026/experiment-elastic-r3/snapshot-inputs.json) | 报告原始证据或摘要；按日期、候选和冻结输入核对，不能混作当前实测。 |
| [docs/reports/pipeline-round2-20261026/experiment-elastic-r3/snapshot-metadata.json](../../docs/reports/pipeline-round2-20261026/experiment-elastic-r3/snapshot-metadata.json) | 报告原始证据或摘要；按日期、候选和冻结输入核对，不能混作当前实测。 |
| [docs/reports/pipeline-round2-20261026/experiment-group-r2/build-results.json](../../docs/reports/pipeline-round2-20261026/experiment-group-r2/build-results.json) | 报告原始证据或摘要；按日期、候选和冻结输入核对，不能混作当前实测。 |
| [docs/reports/pipeline-round2-20261026/experiment-group-r2/gowin-build.log](../../docs/reports/pipeline-round2-20261026/experiment-group-r2/gowin-build.log) | 报告原始证据或摘要；按日期、候选和冻结输入核对，不能混作当前实测。 |
| [docs/reports/pipeline-round2-20261026/experiment-group-r2/gowin-run.json](../../docs/reports/pipeline-round2-20261026/experiment-group-r2/gowin-run.json) | 报告原始证据或摘要；按日期、候选和冻结输入核对，不能混作当前实测。 |
| [docs/reports/pipeline-round2-20261026/experiment-group-r2/snapshot-inputs-after.json](../../docs/reports/pipeline-round2-20261026/experiment-group-r2/snapshot-inputs-after.json) | 报告原始证据或摘要；按日期、候选和冻结输入核对，不能混作当前实测。 |
| [docs/reports/pipeline-round2-20261026/experiment-group-r2/snapshot-inputs.json](../../docs/reports/pipeline-round2-20261026/experiment-group-r2/snapshot-inputs.json) | 报告原始证据或摘要；按日期、候选和冻结输入核对，不能混作当前实测。 |
| [docs/reports/pipeline-round2-20261026/experiment-group-r2/snapshot-metadata.json](../../docs/reports/pipeline-round2-20261026/experiment-group-r2/snapshot-metadata.json) | 报告原始证据或摘要；按日期、候选和冻结输入核对，不能混作当前实测。 |
| [docs/reports/pipeline-round2-20261026/modelsim-final/event_fifo_pipeline.log](../../docs/reports/pipeline-round2-20261026/modelsim-final/event_fifo_pipeline.log) | 报告原始证据或摘要；按日期、候选和冻结输入核对，不能混作当前实测。 |
| [docs/reports/pipeline-round2-20261026/modelsim-final/global_panic.log](../../docs/reports/pipeline-round2-20261026/modelsim-final/global_panic.log) | 报告原始证据或摘要；按日期、候选和冻结输入核对，不能混作当前实测。 |
| [docs/reports/pipeline-round2-20261026/modelsim-final/inputs.json](../../docs/reports/pipeline-round2-20261026/modelsim-final/inputs.json) | 报告原始证据或摘要；按日期、候选和冻结输入核对，不能混作当前实测。 |
| [docs/reports/pipeline-round2-20261026/modelsim-final/manifest.json](../../docs/reports/pipeline-round2-20261026/modelsim-final/manifest.json) | 报告原始证据或摘要；按日期、候选和冻结输入核对，不能混作当前实测。 |
| [docs/reports/pipeline-round2-20261026/modelsim-final/test-summary.json](../../docs/reports/pipeline-round2-20261026/modelsim-final/test-summary.json) | 报告原始证据或摘要；按日期、候选和冻结输入核对，不能混作当前实测。 |
| [docs/reports/pipeline-round2-20261026/modelsim-final/touch_i2s_latency.log](../../docs/reports/pipeline-round2-20261026/modelsim-final/touch_i2s_latency.log) | 报告原始证据或摘要；按日期、候选和冻结输入核对，不能混作当前实测。 |
| [docs/reports/pipeline-round2-20261026/selected-fifo-r1/ContestFull.pin.html](../../docs/reports/pipeline-round2-20261026/selected-fifo-r1/ContestFull.pin.html) | Gowin自动生成的引脚/资源/时序HTML报告，不是运行程序；内容只对应该目录的构建版本。 |
| [docs/reports/pipeline-round2-20261026/selected-fifo-r1/ContestFull.rpt.txt](../../docs/reports/pipeline-round2-20261026/selected-fifo-r1/ContestFull.rpt.txt) | 报告原始证据或摘要；按日期、候选和冻结输入核对，不能混作当前实测。 |
| [docs/reports/pipeline-round2-20261026/selected-fifo-r1/ContestFull.tr](../../docs/reports/pipeline-round2-20261026/selected-fifo-r1/ContestFull.tr) | 报告原始证据或摘要；按日期、候选和冻结输入核对，不能混作当前实测。 |
| [docs/reports/pipeline-round2-20261026/selected-fifo-r1/build-results.json](../../docs/reports/pipeline-round2-20261026/selected-fifo-r1/build-results.json) | 报告原始证据或摘要；按日期、候选和冻结输入核对，不能混作当前实测。 |
| [docs/reports/pipeline-round2-20261026/selected-fifo-r1/gowin-build.log](../../docs/reports/pipeline-round2-20261026/selected-fifo-r1/gowin-build.log) | 报告原始证据或摘要；按日期、候选和冻结输入核对，不能混作当前实测。 |
| [docs/reports/pipeline-round2-20261026/selected-fifo-r1/gowin-run.json](../../docs/reports/pipeline-round2-20261026/selected-fifo-r1/gowin-run.json) | 报告原始证据或摘要；按日期、候选和冻结输入核对，不能混作当前实测。 |
| [docs/reports/pipeline-round2-20261026/selected-fifo-r1/snapshot-inputs-after.json](../../docs/reports/pipeline-round2-20261026/selected-fifo-r1/snapshot-inputs-after.json) | 报告原始证据或摘要；按日期、候选和冻结输入核对，不能混作当前实测。 |
| [docs/reports/pipeline-round2-20261026/selected-fifo-r1/snapshot-inputs.json](../../docs/reports/pipeline-round2-20261026/selected-fifo-r1/snapshot-inputs.json) | 报告原始证据或摘要；按日期、候选和冻结输入核对，不能混作当前实测。 |
| [docs/reports/pipeline-round2-20261026/selected-fifo-r1/snapshot-metadata.json](../../docs/reports/pipeline-round2-20261026/selected-fifo-r1/snapshot-metadata.json) | 报告原始证据或摘要；按日期、候选和冻结输入核对，不能混作当前实测。 |
| [docs/reports/slider-volume-20261026/first-candidate/build-results.json](../../docs/reports/slider-volume-20261026/first-candidate/build-results.json) | 报告原始证据或摘要；按日期、候选和冻结输入核对，不能混作当前实测。 |
| [docs/reports/slider-volume-20261026/first-candidate/gowin-build.log](../../docs/reports/slider-volume-20261026/first-candidate/gowin-build.log) | 报告原始证据或摘要；按日期、候选和冻结输入核对，不能混作当前实测。 |
| [docs/reports/slider-volume-20261026/first-candidate/gowin-run.json](../../docs/reports/slider-volume-20261026/first-candidate/gowin-run.json) | 报告原始证据或摘要；按日期、候选和冻结输入核对，不能混作当前实测。 |
| [docs/reports/slider-volume-20261026/first-candidate/snapshot-inputs-after.json](../../docs/reports/slider-volume-20261026/first-candidate/snapshot-inputs-after.json) | 报告原始证据或摘要；按日期、候选和冻结输入核对，不能混作当前实测。 |
| [docs/reports/slider-volume-20261026/first-candidate/snapshot-inputs.json](../../docs/reports/slider-volume-20261026/first-candidate/snapshot-inputs.json) | 报告原始证据或摘要；按日期、候选和冻结输入核对，不能混作当前实测。 |
| [docs/reports/slider-volume-20261026/first-candidate/snapshot-metadata.json](../../docs/reports/slider-volume-20261026/first-candidate/snapshot-metadata.json) | 报告原始证据或摘要；按日期、候选和冻结输入核对，不能混作当前实测。 |
| [docs/reports/slider-volume-20261026/modelsim-final/inputs.json](../../docs/reports/slider-volume-20261026/modelsim-final/inputs.json) | 报告原始证据或摘要；按日期、候选和冻结输入核对，不能混作当前实测。 |
| [docs/reports/slider-volume-20261026/modelsim-final/manifest.json](../../docs/reports/slider-volume-20261026/modelsim-final/manifest.json) | 报告原始证据或摘要；按日期、候选和冻结输入核对，不能混作当前实测。 |
| [docs/reports/slider-volume-20261026/modelsim-final/oled_volume.log](../../docs/reports/slider-volume-20261026/modelsim-final/oled_volume.log) | 报告原始证据或摘要；按日期、候选和冻结输入核对，不能混作当前实测。 |
| [docs/reports/slider-volume-20261026/modelsim-final/oled_volume_board.log](../../docs/reports/slider-volume-20261026/modelsim-final/oled_volume_board.log) | 报告原始证据或摘要；按日期、候选和冻结输入核对，不能混作当前实测。 |
| [docs/reports/slider-volume-20261026/modelsim-final/slider_performance.log](../../docs/reports/slider-volume-20261026/modelsim-final/slider_performance.log) | 报告原始证据或摘要；按日期、候选和冻结输入核对，不能混作当前实测。 |
| [docs/reports/slider-volume-20261026/modelsim-final/slider_volume_control.log](../../docs/reports/slider-volume-20261026/modelsim-final/slider_volume_control.log) | 报告原始证据或摘要；按日期、候选和冻结输入核对，不能混作当前实测。 |
| [docs/reports/slider-volume-20261026/modelsim-final/slider_volume_system.log](../../docs/reports/slider-volume-20261026/modelsim-final/slider_volume_system.log) | 报告原始证据或摘要；按日期、候选和冻结输入核对，不能混作当前实测。 |
| [docs/reports/slider-volume-20261026/modelsim-final/test-summary.json](../../docs/reports/slider-volume-20261026/modelsim-final/test-summary.json) | 报告原始证据或摘要；按日期、候选和冻结输入核对，不能混作当前实测。 |
| [docs/reports/slider-volume-20261026/modelsim-final/touch_i2s_latency.log](../../docs/reports/slider-volume-20261026/modelsim-final/touch_i2s_latency.log) | 报告原始证据或摘要；按日期、候选和冻结输入核对，不能混作当前实测。 |
| [docs/reports/slider-volume-20261026/selected-r2/ContestFull.pin.html](../../docs/reports/slider-volume-20261026/selected-r2/ContestFull.pin.html) | Gowin自动生成的引脚/资源/时序HTML报告，不是运行程序；内容只对应该目录的构建版本。 |
| [docs/reports/slider-volume-20261026/selected-r2/ContestFull.rpt.txt](../../docs/reports/slider-volume-20261026/selected-r2/ContestFull.rpt.txt) | 报告原始证据或摘要；按日期、候选和冻结输入核对，不能混作当前实测。 |
| [docs/reports/slider-volume-20261026/selected-r2/ContestFull.tr](../../docs/reports/slider-volume-20261026/selected-r2/ContestFull.tr) | 报告原始证据或摘要；按日期、候选和冻结输入核对，不能混作当前实测。 |
| [docs/reports/slider-volume-20261026/selected-r2/build-results.json](../../docs/reports/slider-volume-20261026/selected-r2/build-results.json) | 报告原始证据或摘要；按日期、候选和冻结输入核对，不能混作当前实测。 |
| [docs/reports/slider-volume-20261026/selected-r2/gowin-build.log](../../docs/reports/slider-volume-20261026/selected-r2/gowin-build.log) | 报告原始证据或摘要；按日期、候选和冻结输入核对，不能混作当前实测。 |
| [docs/reports/slider-volume-20261026/selected-r2/gowin-run.json](../../docs/reports/slider-volume-20261026/selected-r2/gowin-run.json) | 报告原始证据或摘要；按日期、候选和冻结输入核对，不能混作当前实测。 |
| [docs/reports/slider-volume-20261026/selected-r2/snapshot-inputs-after.json](../../docs/reports/slider-volume-20261026/selected-r2/snapshot-inputs-after.json) | 报告原始证据或摘要；按日期、候选和冻结输入核对，不能混作当前实测。 |
| [docs/reports/slider-volume-20261026/selected-r2/snapshot-inputs.json](../../docs/reports/slider-volume-20261026/selected-r2/snapshot-inputs.json) | 报告原始证据或摘要；按日期、候选和冻结输入核对，不能混作当前实测。 |
| [docs/reports/slider-volume-20261026/selected-r2/snapshot-metadata.json](../../docs/reports/slider-volume-20261026/selected-r2/snapshot-metadata.json) | 报告原始证据或摘要；按日期、候选和冻结输入核对，不能混作当前实测。 |
| [docs/reports/slider-volume-20261026/test-development/before-fix-manifest.json](../../docs/reports/slider-volume-20261026/test-development/before-fix-manifest.json) | 报告原始证据或摘要；按日期、候选和冻结输入核对，不能混作当前实测。 |
| [docs/reports/slider-volume-20261026/test-development/before-fix-test-summary.json](../../docs/reports/slider-volume-20261026/test-development/before-fix-test-summary.json) | 报告原始证据或摘要；按日期、候选和冻结输入核对，不能混作当前实测。 |
| [docs/reports/slider-volume-20261026/test-development/oled_volume_board-before-fix.log](../../docs/reports/slider-volume-20261026/test-development/oled_volume_board-before-fix.log) | 报告原始证据或摘要；按日期、候选和冻结输入核对，不能混作当前实测。 |
| [docs/reports/timing-latency-20261026/analysis/latency-results.json](../../docs/reports/timing-latency-20261026/analysis/latency-results.json) | 报告原始证据或摘要；按日期、候选和冻结输入核对，不能混作当前实测。 |
| [docs/reports/timing-latency-20261026/analysis/延迟分段结果.md](../../docs/reports/timing-latency-20261026/analysis/%E5%BB%B6%E8%BF%9F%E5%88%86%E6%AE%B5%E7%BB%93%E6%9E%9C.md) | 报告原始证据或摘要；按日期、候选和冻结输入核对，不能混作当前实测。 |
| [docs/reports/timing-latency-20261026/evidence/fpga/ContestFull.pin.html](../../docs/reports/timing-latency-20261026/evidence/fpga/ContestFull.pin.html) | Gowin自动生成的引脚/资源/时序HTML报告，不是运行程序；内容只对应该目录的构建版本。 |
| [docs/reports/timing-latency-20261026/evidence/fpga/ContestFull.rpt.txt](../../docs/reports/timing-latency-20261026/evidence/fpga/ContestFull.rpt.txt) | 报告原始证据或摘要；按日期、候选和冻结输入核对，不能混作当前实测。 |
| [docs/reports/timing-latency-20261026/evidence/fpga/ContestFull.tr](../../docs/reports/timing-latency-20261026/evidence/fpga/ContestFull.tr) | 报告原始证据或摘要；按日期、候选和冻结输入核对，不能混作当前实测。 |
| [docs/reports/timing-latency-20261026/evidence/fpga/build-results.json](../../docs/reports/timing-latency-20261026/evidence/fpga/build-results.json) | 报告原始证据或摘要；按日期、候选和冻结输入核对，不能混作当前实测。 |
| [docs/reports/timing-latency-20261026/evidence/fpga/gowin-build.log](../../docs/reports/timing-latency-20261026/evidence/fpga/gowin-build.log) | 报告原始证据或摘要；按日期、候选和冻结输入核对，不能混作当前实测。 |
| [docs/reports/timing-latency-20261026/evidence/fpga/gowin-run.json](../../docs/reports/timing-latency-20261026/evidence/fpga/gowin-run.json) | 报告原始证据或摘要；按日期、候选和冻结输入核对，不能混作当前实测。 |
| [docs/reports/timing-latency-20261026/evidence/fpga/snapshot-inputs-after.json](../../docs/reports/timing-latency-20261026/evidence/fpga/snapshot-inputs-after.json) | 报告原始证据或摘要；按日期、候选和冻结输入核对，不能混作当前实测。 |
| [docs/reports/timing-latency-20261026/evidence/fpga/snapshot-inputs.json](../../docs/reports/timing-latency-20261026/evidence/fpga/snapshot-inputs.json) | 报告原始证据或摘要；按日期、候选和冻结输入核对，不能混作当前实测。 |
| [docs/reports/timing-latency-20261026/evidence/fpga/snapshot-metadata.json](../../docs/reports/timing-latency-20261026/evidence/fpga/snapshot-metadata.json) | 报告原始证据或摘要；按日期、候选和冻结输入核对，不能混作当前实测。 |
| [docs/reports/timing-latency-20261026/evidence/modelsim/cases/audio_i2s.do](../../docs/reports/timing-latency-20261026/evidence/modelsim/cases/audio_i2s.do) | 当次ModelSim用例运行脚本，保存编译/参数/运行命令；配套日志才证明结果，历史绝对路径须重建。 |
| [docs/reports/timing-latency-20261026/evidence/modelsim/cases/direct_score.do](../../docs/reports/timing-latency-20261026/evidence/modelsim/cases/direct_score.do) | 当次ModelSim用例运行脚本，保存编译/参数/运行命令；配套日志才证明结果，历史绝对路径须重建。 |
| [docs/reports/timing-latency-20261026/evidence/modelsim/cases/direct_system.do](../../docs/reports/timing-latency-20261026/evidence/modelsim/cases/direct_system.do) | 当次ModelSim用例运行脚本，保存编译/参数/运行命令；配套日志才证明结果，历史绝对路径须重建。 |
| [docs/reports/timing-latency-20261026/evidence/modelsim/cases/full_system.do](../../docs/reports/timing-latency-20261026/evidence/modelsim/cases/full_system.do) | 当次ModelSim用例运行脚本，保存编译/参数/运行命令；涉及tb_instrument_full_system；配套日志才证明结果，历史绝对路径须重建。 |
| [docs/reports/timing-latency-20261026/evidence/modelsim/cases/global_panic.do](../../docs/reports/timing-latency-20261026/evidence/modelsim/cases/global_panic.do) | 当次ModelSim用例运行脚本，保存编译/参数/运行命令；配套日志才证明结果，历史绝对路径须重建。 |
| [docs/reports/timing-latency-20261026/evidence/modelsim/cases/learning_mode.do](../../docs/reports/timing-latency-20261026/evidence/modelsim/cases/learning_mode.do) | 当次ModelSim用例运行脚本，保存编译/参数/运行命令；配套日志才证明结果，历史绝对路径须重建。 |
| [docs/reports/timing-latency-20261026/evidence/modelsim/cases/learning_status.do](../../docs/reports/timing-latency-20261026/evidence/modelsim/cases/learning_status.do) | 当次ModelSim用例运行脚本，保存编译/参数/运行命令；配套日志才证明结果，历史绝对路径须重建。 |
| [docs/reports/timing-latency-20261026/evidence/modelsim/cases/learning_system.do](../../docs/reports/timing-latency-20261026/evidence/modelsim/cases/learning_system.do) | 当次ModelSim用例运行脚本，保存编译/参数/运行命令；配套日志才证明结果，历史绝对路径须重建。 |
| [docs/reports/timing-latency-20261026/evidence/modelsim/cases/menu_replay.do](../../docs/reports/timing-latency-20261026/evidence/modelsim/cases/menu_replay.do) | 当次ModelSim用例运行脚本，保存编译/参数/运行命令；配套日志才证明结果，历史绝对路径须重建。 |
| [docs/reports/timing-latency-20261026/evidence/modelsim/cases/menu_system.do](../../docs/reports/timing-latency-20261026/evidence/modelsim/cases/menu_system.do) | 当次ModelSim用例运行脚本，保存编译/参数/运行命令；配套日志才证明结果，历史绝对路径须重建。 |
| [docs/reports/timing-latency-20261026/evidence/modelsim/cases/mpr121_backpressure.do](../../docs/reports/timing-latency-20261026/evidence/modelsim/cases/mpr121_backpressure.do) | 当次ModelSim用例运行脚本，保存编译/参数/运行命令；配套日志才证明结果，历史绝对路径须重建。 |
| [docs/reports/timing-latency-20261026/evidence/modelsim/cases/mpr121_capacity.do](../../docs/reports/timing-latency-20261026/evidence/modelsim/cases/mpr121_capacity.do) | 当次ModelSim用例运行脚本，保存编译/参数/运行命令；配套日志才证明结果，历史绝对路径须重建。 |
| [docs/reports/timing-latency-20261026/evidence/modelsim/cases/oled_timing_regression.do](../../docs/reports/timing-latency-20261026/evidence/modelsim/cases/oled_timing_regression.do) | 当次ModelSim用例运行脚本，保存编译/参数/运行命令；配套日志才证明结果，历史绝对路径须重建。 |
| [docs/reports/timing-latency-20261026/evidence/modelsim/cases/performance.do](../../docs/reports/timing-latency-20261026/evidence/modelsim/cases/performance.do) | 当次ModelSim用例运行脚本，保存编译/参数/运行命令；配套日志才证明结果，历史绝对路径须重建。 |
| [docs/reports/timing-latency-20261026/evidence/modelsim/cases/performance_commit.do](../../docs/reports/timing-latency-20261026/evidence/modelsim/cases/performance_commit.do) | 当次ModelSim用例运行脚本，保存编译/参数/运行命令；配套日志才证明结果，历史绝对路径须重建。 |
| [docs/reports/timing-latency-20261026/evidence/modelsim/cases/performance_retrigger.do](../../docs/reports/timing-latency-20261026/evidence/modelsim/cases/performance_retrigger.do) | 当次ModelSim用例运行脚本，保存编译/参数/运行命令；配套日志才证明结果，历史绝对路径须重建。 |
| [docs/reports/timing-latency-20261026/evidence/modelsim/cases/polar_margin_early_write.do](../../docs/reports/timing-latency-20261026/evidence/modelsim/cases/polar_margin_early_write.do) | 当次ModelSim用例运行脚本，保存编译/参数/运行命令；配套日志才证明结果，历史绝对路径须重建。 |
| [docs/reports/timing-latency-20261026/evidence/modelsim/cases/polar_margin_negative.do](../../docs/reports/timing-latency-20261026/evidence/modelsim/cases/polar_margin_negative.do) | 当次ModelSim用例运行脚本，保存编译/参数/运行命令；配套日志才证明结果，历史绝对路径须重建。 |
| [docs/reports/timing-latency-20261026/evidence/modelsim/cases/polar_margin_s1.do](../../docs/reports/timing-latency-20261026/evidence/modelsim/cases/polar_margin_s1.do) | 当次ModelSim用例运行脚本，保存编译/参数/运行命令；配套日志才证明结果，历史绝对路径须重建。 |
| [docs/reports/timing-latency-20261026/evidence/modelsim/cases/polar_margin_s2.do](../../docs/reports/timing-latency-20261026/evidence/modelsim/cases/polar_margin_s2.do) | 当次ModelSim用例运行脚本，保存编译/参数/运行命令；配套日志才证明结果，历史绝对路径须重建。 |
| [docs/reports/timing-latency-20261026/evidence/modelsim/cases/polar_margin_s3.do](../../docs/reports/timing-latency-20261026/evidence/modelsim/cases/polar_margin_s3.do) | 当次ModelSim用例运行脚本，保存编译/参数/运行命令；配套日志才证明结果，历史绝对路径须重建。 |
| [docs/reports/timing-latency-20261026/evidence/modelsim/cases/score_capacity_1024.do](../../docs/reports/timing-latency-20261026/evidence/modelsim/cases/score_capacity_1024.do) | 当次ModelSim用例运行脚本，保存编译/参数/运行命令；配套日志才证明结果，历史绝对路径须重建。 |
| [docs/reports/timing-latency-20261026/evidence/modelsim/cases/touch_i2s_latency.do](../../docs/reports/timing-latency-20261026/evidence/modelsim/cases/touch_i2s_latency.do) | 当次ModelSim用例运行脚本，保存编译/参数/运行命令；配套日志才证明结果，历史绝对路径须重建。 |
| [docs/reports/timing-latency-20261026/evidence/modelsim/cases/transport_status_equivalence.do](../../docs/reports/timing-latency-20261026/evidence/modelsim/cases/transport_status_equivalence.do) | 当次ModelSim用例运行脚本，保存编译/参数/运行命令；配套日志才证明结果，历史绝对路径须重建。 |
| [docs/reports/timing-latency-20261026/evidence/modelsim/inputs.json](../../docs/reports/timing-latency-20261026/evidence/modelsim/inputs.json) | 报告原始证据或摘要；按日期、候选和冻结输入核对，不能混作当前实测。 |
| [docs/reports/timing-latency-20261026/evidence/modelsim/logs/audio_i2s.console.log](../../docs/reports/timing-latency-20261026/evidence/modelsim/logs/audio_i2s.console.log) | 报告原始证据或摘要；按日期、候选和冻结输入核对，不能混作当前实测。 |
| [docs/reports/timing-latency-20261026/evidence/modelsim/logs/audio_i2s.exitcode](../../docs/reports/timing-latency-20261026/evidence/modelsim/logs/audio_i2s.exitcode) | 报告原始证据或摘要；按日期、候选和冻结输入核对，不能混作当前实测。 |
| [docs/reports/timing-latency-20261026/evidence/modelsim/logs/audio_i2s.log](../../docs/reports/timing-latency-20261026/evidence/modelsim/logs/audio_i2s.log) | 报告原始证据或摘要；按日期、候选和冻结输入核对，不能混作当前实测。 |
| [docs/reports/timing-latency-20261026/evidence/modelsim/logs/audio_i2s.worker.pid](../../docs/reports/timing-latency-20261026/evidence/modelsim/logs/audio_i2s.worker.pid) | 报告原始证据或摘要；按日期、候选和冻结输入核对，不能混作当前实测。 |
| [docs/reports/timing-latency-20261026/evidence/modelsim/logs/direct_score.console.log](../../docs/reports/timing-latency-20261026/evidence/modelsim/logs/direct_score.console.log) | 报告原始证据或摘要；按日期、候选和冻结输入核对，不能混作当前实测。 |
| [docs/reports/timing-latency-20261026/evidence/modelsim/logs/direct_score.exitcode](../../docs/reports/timing-latency-20261026/evidence/modelsim/logs/direct_score.exitcode) | 报告原始证据或摘要；按日期、候选和冻结输入核对，不能混作当前实测。 |
| [docs/reports/timing-latency-20261026/evidence/modelsim/logs/direct_score.log](../../docs/reports/timing-latency-20261026/evidence/modelsim/logs/direct_score.log) | 报告原始证据或摘要；按日期、候选和冻结输入核对，不能混作当前实测。 |
| [docs/reports/timing-latency-20261026/evidence/modelsim/logs/direct_score.worker.pid](../../docs/reports/timing-latency-20261026/evidence/modelsim/logs/direct_score.worker.pid) | 报告原始证据或摘要；按日期、候选和冻结输入核对，不能混作当前实测。 |
| [docs/reports/timing-latency-20261026/evidence/modelsim/logs/direct_system.console.log](../../docs/reports/timing-latency-20261026/evidence/modelsim/logs/direct_system.console.log) | 报告原始证据或摘要；按日期、候选和冻结输入核对，不能混作当前实测。 |
| [docs/reports/timing-latency-20261026/evidence/modelsim/logs/direct_system.exitcode](../../docs/reports/timing-latency-20261026/evidence/modelsim/logs/direct_system.exitcode) | 报告原始证据或摘要；按日期、候选和冻结输入核对，不能混作当前实测。 |
| [docs/reports/timing-latency-20261026/evidence/modelsim/logs/direct_system.log](../../docs/reports/timing-latency-20261026/evidence/modelsim/logs/direct_system.log) | 报告原始证据或摘要；按日期、候选和冻结输入核对，不能混作当前实测。 |
| [docs/reports/timing-latency-20261026/evidence/modelsim/logs/direct_system.worker.pid](../../docs/reports/timing-latency-20261026/evidence/modelsim/logs/direct_system.worker.pid) | 报告原始证据或摘要；按日期、候选和冻结输入核对，不能混作当前实测。 |
| [docs/reports/timing-latency-20261026/evidence/modelsim/logs/full_system.console.log](../../docs/reports/timing-latency-20261026/evidence/modelsim/logs/full_system.console.log) | 报告原始证据或摘要；按日期、候选和冻结输入核对，不能混作当前实测。 |
| [docs/reports/timing-latency-20261026/evidence/modelsim/logs/full_system.exitcode](../../docs/reports/timing-latency-20261026/evidence/modelsim/logs/full_system.exitcode) | 报告原始证据或摘要；按日期、候选和冻结输入核对，不能混作当前实测。 |
| [docs/reports/timing-latency-20261026/evidence/modelsim/logs/full_system.log](../../docs/reports/timing-latency-20261026/evidence/modelsim/logs/full_system.log) | 报告原始证据或摘要；按日期、候选和冻结输入核对，不能混作当前实测。 |
| [docs/reports/timing-latency-20261026/evidence/modelsim/logs/full_system.worker.pid](../../docs/reports/timing-latency-20261026/evidence/modelsim/logs/full_system.worker.pid) | 报告原始证据或摘要；按日期、候选和冻结输入核对，不能混作当前实测。 |
| [docs/reports/timing-latency-20261026/evidence/modelsim/logs/global_panic.console.log](../../docs/reports/timing-latency-20261026/evidence/modelsim/logs/global_panic.console.log) | 报告原始证据或摘要；按日期、候选和冻结输入核对，不能混作当前实测。 |
| [docs/reports/timing-latency-20261026/evidence/modelsim/logs/global_panic.exitcode](../../docs/reports/timing-latency-20261026/evidence/modelsim/logs/global_panic.exitcode) | 报告原始证据或摘要；按日期、候选和冻结输入核对，不能混作当前实测。 |
| [docs/reports/timing-latency-20261026/evidence/modelsim/logs/global_panic.log](../../docs/reports/timing-latency-20261026/evidence/modelsim/logs/global_panic.log) | 报告原始证据或摘要；按日期、候选和冻结输入核对，不能混作当前实测。 |
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
| [docs/reports/timing-latency-20261026/evidence/modelsim/logs/touch_i2s_latency.exitcode](../../docs/reports/timing-latency-20261026/evidence/modelsim/logs/touch_i2s_latency.exitcode) | 报告原始证据或摘要；按日期、候选和冻结输入核对，不能混作当前实测。 |
| [docs/reports/timing-latency-20261026/evidence/modelsim/logs/touch_i2s_latency.log](../../docs/reports/timing-latency-20261026/evidence/modelsim/logs/touch_i2s_latency.log) | 报告原始证据或摘要；按日期、候选和冻结输入核对，不能混作当前实测。 |
| [docs/reports/timing-latency-20261026/evidence/modelsim/logs/touch_i2s_latency.worker.pid](../../docs/reports/timing-latency-20261026/evidence/modelsim/logs/touch_i2s_latency.worker.pid) | 报告原始证据或摘要；按日期、候选和冻结输入核对，不能混作当前实测。 |
| [docs/reports/timing-latency-20261026/evidence/modelsim/logs/transport_status_equivalence.console.log](../../docs/reports/timing-latency-20261026/evidence/modelsim/logs/transport_status_equivalence.console.log) | 报告原始证据或摘要；按日期、候选和冻结输入核对，不能混作当前实测。 |
| [docs/reports/timing-latency-20261026/evidence/modelsim/logs/transport_status_equivalence.exitcode](../../docs/reports/timing-latency-20261026/evidence/modelsim/logs/transport_status_equivalence.exitcode) | 报告原始证据或摘要；按日期、候选和冻结输入核对，不能混作当前实测。 |
| [docs/reports/timing-latency-20261026/evidence/modelsim/logs/transport_status_equivalence.log](../../docs/reports/timing-latency-20261026/evidence/modelsim/logs/transport_status_equivalence.log) | 报告原始证据或摘要；按日期、候选和冻结输入核对，不能混作当前实测。 |
| [docs/reports/timing-latency-20261026/evidence/modelsim/logs/transport_status_equivalence.worker.pid](../../docs/reports/timing-latency-20261026/evidence/modelsim/logs/transport_status_equivalence.worker.pid) | 报告原始证据或摘要；按日期、候选和冻结输入核对，不能混作当前实测。 |
| [docs/reports/timing-latency-20261026/evidence/modelsim/logs/vendor.compile.log](../../docs/reports/timing-latency-20261026/evidence/modelsim/logs/vendor.compile.log) | 报告原始证据或摘要；按日期、候选和冻结输入核对，不能混作当前实测。 |
| [docs/reports/timing-latency-20261026/evidence/modelsim/logs/vlib.log](../../docs/reports/timing-latency-20261026/evidence/modelsim/logs/vlib.log) | 报告原始证据或摘要；按日期、候选和冻结输入核对，不能混作当前实测。 |
| [docs/reports/timing-latency-20261026/evidence/modelsim/manifest.json](../../docs/reports/timing-latency-20261026/evidence/modelsim/manifest.json) | 报告原始证据或摘要；按日期、候选和冻结输入核对，不能混作当前实测。 |
| [docs/reports/timing-latency-20261026/evidence/modelsim/test-summary.json](../../docs/reports/timing-latency-20261026/evidence/modelsim/test-summary.json) | 报告原始证据或摘要；按日期、候选和冻结输入核对，不能混作当前实测。 |
| [docs/reports/timing-latency-20261026/manifest.json](../../docs/reports/timing-latency-20261026/manifest.json) | 报告原始证据或摘要；按日期、候选和冻结输入核对，不能混作当前实测。 |
| [docs/reports/timing-latency-20261026/技术总结.md](../../docs/reports/timing-latency-20261026/%E6%8A%80%E6%9C%AF%E6%80%BB%E7%BB%93.md) | 报告原始证据或摘要；按日期、候选和冻结输入核对，不能混作当前实测。 |
| [docs/reports/timing-latency-20261026/源码修改.diff](../../docs/reports/timing-latency-20261026/%E6%BA%90%E7%A0%81%E4%BF%AE%E6%94%B9.diff) | 报告原始证据或摘要；按日期、候选和冻结输入核对，不能混作当前实测。 |
| [docs/reports/timing-latency-20261026/验证结果.md](../../docs/reports/timing-latency-20261026/%E9%AA%8C%E8%AF%81%E7%BB%93%E6%9E%9C.md) | 报告原始证据或摘要；按日期、候选和冻结输入核对，不能混作当前实测。 |
| [docs/主工程继续验证-20260923.md](../../docs/%E4%B8%BB%E5%B7%A5%E7%A8%8B%E7%BB%A7%E7%BB%AD%E9%AA%8C%E8%AF%81-20260923.md) | 接口、算法、装配、使用或历史技术说明；日期早的说明可能不代表当前入口。 |
| [docs/全功能工程与官网验收-20261011.md](../../docs/%E5%85%A8%E5%8A%9F%E8%83%BD%E5%B7%A5%E7%A8%8B%E4%B8%8E%E5%AE%98%E7%BD%91%E9%AA%8C%E6%94%B6-20261011.md) | 接口、算法、装配、使用或历史技术说明；日期早的说明可能不代表当前入口。 |
| [docs/全功能首次上板步骤-20261011.md](../../docs/%E5%85%A8%E5%8A%9F%E8%83%BD%E9%A6%96%E6%AC%A1%E4%B8%8A%E6%9D%BF%E6%AD%A5%E9%AA%A4-20261011.md) | 接口、算法、装配、使用或历史技术说明；日期早的说明可能不代表当前入口。 |
| [docs/八成分分区钢琴.md](../../docs/%E5%85%AB%E6%88%90%E5%88%86%E5%88%86%E5%8C%BA%E9%92%A2%E7%90%B4.md) | 接口、算法、装配、使用或历史技术说明；日期早的说明可能不代表当前入口。 |
| [docs/到货装配与联调-20261017.md](../../docs/%E5%88%B0%E8%B4%A7%E8%A3%85%E9%85%8D%E4%B8%8E%E8%81%94%E8%B0%83-20261017.md) | 接口、算法、装配、使用或历史技术说明；日期早的说明可能不代表当前入口。 |
| [docs/发声异常与单音诊断-20261011.md](../../docs/%E5%8F%91%E5%A3%B0%E5%BC%82%E5%B8%B8%E4%B8%8E%E5%8D%95%E9%9F%B3%E8%AF%8A%E6%96%AD-20261011.md) | 接口、算法、装配、使用或历史技术说明；日期早的说明可能不代表当前入口。 |
| [docs/团队协作说明.md](../../docs/%E5%9B%A2%E9%98%9F%E5%8D%8F%E4%BD%9C%E8%AF%B4%E6%98%8E.md) | 接口、算法、装配、使用或历史技术说明；日期早的说明可能不代表当前入口。 |
| [docs/工程复查与优化-20261011.md](../../docs/%E5%B7%A5%E7%A8%8B%E5%A4%8D%E6%9F%A5%E4%B8%8E%E4%BC%98%E5%8C%96-20261011.md) | 接口、算法、装配、使用或历史技术说明；日期早的说明可能不代表当前入口。 |
| [docs/当前工程状态-20261023.md](../../docs/%E5%BD%93%E5%89%8D%E5%B7%A5%E7%A8%8B%E7%8A%B6%E6%80%81-20261023.md) | 接口、算法、装配、使用或历史技术说明；日期早的说明可能不代表当前入口。 |
| [docs/恢复24位标准I2S-20260919.md](../../docs/%E6%81%A2%E5%A4%8D24%E4%BD%8D%E6%A0%87%E5%87%86I2S-20260919.md) | 接口、算法、装配、使用或历史技术说明；日期早的说明可能不代表当前入口。 |
| [docs/手机版曲库与蓝牙按键说明_20261025.md](../../docs/%E6%89%8B%E6%9C%BA%E7%89%88%E6%9B%B2%E5%BA%93%E4%B8%8E%E8%93%9D%E7%89%99%E6%8C%89%E9%94%AE%E8%AF%B4%E6%98%8E_20261025.md) | 接口、算法、装配、使用或历史技术说明；日期早的说明可能不代表当前入口。 |
| [docs/接口V2与队员迁移.md](../../docs/%E6%8E%A5%E5%8F%A3V2%E4%B8%8E%E9%98%9F%E5%91%98%E8%BF%81%E7%A7%BB.md) | 接口、算法、装配、使用或历史技术说明；日期早的说明可能不代表当前入口。 |
| [docs/接口与第一课.md](../../docs/%E6%8E%A5%E5%8F%A3%E4%B8%8E%E7%AC%AC%E4%B8%80%E8%AF%BE.md) | 接口、算法、装配、使用或历史技术说明；日期早的说明可能不代表当前入口。 |
| [docs/推荐曲目与刷新_20261025.md](../../docs/%E6%8E%A8%E8%8D%90%E6%9B%B2%E7%9B%AE%E4%B8%8E%E5%88%B7%E6%96%B0_20261025.md) | 接口、算法、装配、使用或历史技术说明；日期早的说明可能不代表当前入口。 |
| [docs/整机连线方案-20261017.md](../../docs/%E6%95%B4%E6%9C%BA%E8%BF%9E%E7%BA%BF%E6%96%B9%E6%A1%88-20261017.md) | 接口、算法、装配、使用或历史技术说明；日期早的说明可能不代表当前入口。 |
| [docs/时序与块RAM优化-20261011.md](../../docs/%E6%97%B6%E5%BA%8F%E4%B8%8E%E5%9D%97RAM%E4%BC%98%E5%8C%96-20261011.md) | 接口、算法、装配、使用或历史技术说明；日期早的说明可能不代表当前入口。 |
| [docs/时序余量与触摸I2S延迟技术总结_20261026.md](../../docs/%E6%97%B6%E5%BA%8F%E4%BD%99%E9%87%8F%E4%B8%8E%E8%A7%A6%E6%91%B8I2S%E5%BB%B6%E8%BF%9F%E6%8A%80%E6%9C%AF%E6%80%BB%E7%BB%93_20261026.md) | 接口、算法、装配、使用或历史技术说明；日期早的说明可能不代表当前入口。 |
| [docs/时序流水线第二轮技术总结_20261026.md](../../docs/%E6%97%B6%E5%BA%8F%E6%B5%81%E6%B0%B4%E7%BA%BF%E7%AC%AC%E4%BA%8C%E8%BD%AE%E6%8A%80%E6%9C%AF%E6%80%BB%E7%BB%93_20261026.md) | 接口、算法、装配、使用或历史技术说明；日期早的说明可能不代表当前入口。 |
| [docs/模式同步与蓝牙延迟修正_20261025.md](../../docs/%E6%A8%A1%E5%BC%8F%E5%90%8C%E6%AD%A5%E4%B8%8E%E8%93%9D%E7%89%99%E5%BB%B6%E8%BF%9F%E4%BF%AE%E6%AD%A3_20261025.md) | 接口、算法、装配、使用或历史技术说明；日期早的说明可能不代表当前入口。 |
| [docs/滑条菜单与曲库交付_20261025.md](../../docs/%E6%BB%91%E6%9D%A1%E8%8F%9C%E5%8D%95%E4%B8%8E%E6%9B%B2%E5%BA%93%E4%BA%A4%E4%BB%98_20261025.md) | 接口、算法、装配、使用或历史技术说明；日期早的说明可能不代表当前入口。 |
| [docs/滑条音量模式使用说明_20261026.md](../../docs/%E6%BB%91%E6%9D%A1%E9%9F%B3%E9%87%8F%E6%A8%A1%E5%BC%8F%E4%BD%BF%E7%94%A8%E8%AF%B4%E6%98%8E_20261026.md) | 接口、算法、装配、使用或历史技术说明；日期早的说明可能不代表当前入口。 |
| [docs/滑条音量演奏模式实现说明_20261026.md](../../docs/%E6%BB%91%E6%9D%A1%E9%9F%B3%E9%87%8F%E6%BC%94%E5%A5%8F%E6%A8%A1%E5%BC%8F%E5%AE%9E%E7%8E%B0%E8%AF%B4%E6%98%8E_20261026.md) | 接口、算法、装配、使用或历史技术说明；日期早的说明可能不代表当前入口。 |
| [docs/灯位琴键对照_20261025.md](../../docs/%E7%81%AF%E4%BD%8D%E7%90%B4%E9%94%AE%E5%AF%B9%E7%85%A7_20261025.md) | 接口、算法、装配、使用或历史技术说明；日期早的说明可能不代表当前入口。 |
| [docs/电脑快捷键与滑条操作_20261025.md](../../docs/%E7%94%B5%E8%84%91%E5%BF%AB%E6%8D%B7%E9%94%AE%E4%B8%8E%E6%BB%91%E6%9D%A1%E6%93%8D%E4%BD%9C_20261025.md) | 接口、算法、装配、使用或历史技术说明；日期早的说明可能不代表当前入口。 |
| [docs/电脑曲库联网修复_20261025.md](../../docs/%E7%94%B5%E8%84%91%E6%9B%B2%E5%BA%93%E8%81%94%E7%BD%91%E4%BF%AE%E5%A4%8D_20261025.md) | 接口、算法、装配、使用或历史技术说明；日期早的说明可能不代表当前入口。 |
| [docs/直接音高曲谱播放_20261025.md](../../docs/%E7%9B%B4%E6%8E%A5%E9%9F%B3%E9%AB%98%E6%9B%B2%E8%B0%B1%E6%92%AD%E6%94%BE_20261025.md) | 接口、算法、装配、使用或历史技术说明；日期早的说明可能不代表当前入口。 |
| [docs/第三阶段-测试音源.md](../../docs/%E7%AC%AC%E4%B8%89%E9%98%B6%E6%AE%B5-%E6%B5%8B%E8%AF%95%E9%9F%B3%E6%BA%90.md) | 接口、算法、装配、使用或历史技术说明；日期早的说明可能不代表当前入口。 |
| [docs/第二阶段-I2S使用说明.md](../../docs/%E7%AC%AC%E4%BA%8C%E9%98%B6%E6%AE%B5-I2S%E4%BD%BF%E7%94%A8%E8%AF%B4%E6%98%8E.md) | 接口、算法、装配、使用或历史技术说明；日期早的说明可能不代表当前入口。 |
| [docs/等候学习模式_20261026.md](../../docs/%E7%AD%89%E5%80%99%E5%AD%A6%E4%B9%A0%E6%A8%A1%E5%BC%8F_20261026.md) | 接口、算法、装配、使用或历史技术说明；日期早的说明可能不代表当前入口。 |
| [docs/蓝牙实时曲谱播放_20261025.md](../../docs/%E8%93%9D%E7%89%99%E5%AE%9E%E6%97%B6%E6%9B%B2%E8%B0%B1%E6%92%AD%E6%94%BE_20261025.md) | 接口、算法、装配、使用或历史技术说明；日期早的说明可能不代表当前入口。 |
| [docs/蓝牙延迟优化与测量_20261025.md](../../docs/%E8%93%9D%E7%89%99%E5%BB%B6%E8%BF%9F%E4%BC%98%E5%8C%96%E4%B8%8E%E6%B5%8B%E9%87%8F_20261025.md) | 接口、算法、装配、使用或历史技术说明；日期早的说明可能不代表当前入口。 |
| [docs/资源核对与曲谱扩容评估_20261025.md](../../docs/%E8%B5%84%E6%BA%90%E6%A0%B8%E5%AF%B9%E4%B8%8E%E6%9B%B2%E8%B0%B1%E6%89%A9%E5%AE%B9%E8%AF%84%E4%BC%B0_20261025.md) | 接口、算法、装配、使用或历史技术说明；日期早的说明可能不代表当前入口。 |
| [docs/赛题核查与下一步计划-20260916.md](../../docs/%E8%B5%9B%E9%A2%98%E6%A0%B8%E6%9F%A5%E4%B8%8E%E4%B8%8B%E4%B8%80%E6%AD%A5%E8%AE%A1%E5%88%92-20260916.md) | 接口、算法、装配、使用或历史技术说明；日期早的说明可能不代表当前入口。 |
| [docs/采购清单-桌面电子乐器-20260917.md](../../docs/%E9%87%87%E8%B4%AD%E6%B8%85%E5%8D%95-%E6%A1%8C%E9%9D%A2%E7%94%B5%E5%AD%90%E4%B9%90%E5%99%A8-20260917.md) | 接口、算法、装配、使用或历史技术说明；日期早的说明可能不代表当前入口。 |
| [docs/队员A交付核查-20260917.md](../../docs/%E9%98%9F%E5%91%98A%E4%BA%A4%E4%BB%98%E6%A0%B8%E6%9F%A5-20260917.md) | 接口、算法、装配、使用或历史技术说明；日期早的说明可能不代表当前入口。 |
| [docs/队员A八成分合并记录-20260923.md](../../docs/%E9%98%9F%E5%91%98A%E5%85%AB%E6%88%90%E5%88%86%E5%90%88%E5%B9%B6%E8%AE%B0%E5%BD%95-20260923.md) | 接口、算法、装配、使用或历史技术说明；日期早的说明可能不代表当前入口。 |
| [docs/队员B-V2迁移说明.md](../../docs/%E9%98%9F%E5%91%98B-V2%E8%BF%81%E7%A7%BB%E8%AF%B4%E6%98%8E.md) | 接口、算法、装配、使用或历史技术说明；日期早的说明可能不代表当前入口。 |
| [docs/队员B-接口变更提案.md](../../docs/%E9%98%9F%E5%91%98B-%E6%8E%A5%E5%8F%A3%E5%8F%98%E6%9B%B4%E6%8F%90%E6%A1%88.md) | 接口、算法、装配、使用或历史技术说明；日期早的说明可能不代表当前入口。 |
| [docs/队员B-集成说明.md](../../docs/%E9%98%9F%E5%91%98B-%E9%9B%86%E6%88%90%E8%AF%B4%E6%98%8E.md) | 接口、算法、装配、使用或历史技术说明；日期早的说明可能不代表当前入口。 |
| [docs/队员B-验证记录.md](../../docs/%E9%98%9F%E5%91%98B-%E9%AA%8C%E8%AF%81%E8%AE%B0%E5%BD%95.md) | 接口、算法、装配、使用或历史技术说明；日期早的说明可能不代表当前入口。 |
| [docs/队员B合并记录-20260924.md](../../docs/%E9%98%9F%E5%91%98B%E5%90%88%E5%B9%B6%E8%AE%B0%E5%BD%95-20260924.md) | 接口、算法、装配、使用或历史技术说明；日期早的说明可能不代表当前入口。 |
| [docs/音源合并记录-20260918.md](../../docs/%E9%9F%B3%E6%BA%90%E5%90%88%E5%B9%B6%E8%AE%B0%E5%BD%95-20260918.md) | 接口、算法、装配、使用或历史技术说明；日期早的说明可能不代表当前入口。 |
| [docs/音频引擎V2实现与接线.md](../../docs/%E9%9F%B3%E9%A2%91%E5%BC%95%E6%93%8EV2%E5%AE%9E%E7%8E%B0%E4%B8%8E%E6%8E%A5%E7%BA%BF.md) | 接口、算法、装配、使用或历史技术说明；日期早的说明可能不代表当前入口。 |
| [docs/音频引擎V2验证记录.md](../../docs/%E9%9F%B3%E9%A2%91%E5%BC%95%E6%93%8EV2%E9%AA%8C%E8%AF%81%E8%AE%B0%E5%BD%95.md) | 接口、算法、装配、使用或历史技术说明；日期早的说明可能不代表当前入口。 |
| [docs/验证记录.md](../../docs/%E9%AA%8C%E8%AF%81%E8%AE%B0%E5%BD%95.md) | 接口、算法、装配、使用或历史技术说明；日期早的说明可能不代表当前入口。 |
| [firmware/ble_bridge/README.md](../../firmware/ble_bridge/README.md) | 所在模块的入口、用法与验证边界说明。 |
| [firmware/libraries/BridgeBLE/LICENSE](../../firmware/libraries/BridgeBLE/LICENSE) | 第三方BLE库的许可、来源、构建描述或完整性清单；须保留。 |
| [firmware/libraries/BridgeBLE/UPSTREAM.md](../../firmware/libraries/BridgeBLE/UPSTREAM.md) | 第三方BLE库的许可、来源、构建描述或完整性清单；须保留。 |
| [firmware/libraries/BridgeBLE/library.properties](../../firmware/libraries/BridgeBLE/library.properties) | 第三方BLE库的许可、来源、构建描述或完整性清单；须保留。 |
| [firmware/libraries/BridgeBLE/source-manifest.json](../../firmware/libraries/BridgeBLE/source-manifest.json) | 第三方BLE库的许可、来源、构建描述或完整性清单；须保留。 |
| [full/ContestFull.gprj](../../full/ContestFull.gprj) | Gowin工程入口：列出器件与输入文件；具体顶层由配套构建脚本指定。 |
| [full/contest_full.cst](../../full/contest_full.cst) | 物理引脚和I/O电平约束；须对应此工程的实物接线。 |
| [full/contest_full.sdc](../../full/contest_full.sdc) | 时钟、生成时钟和时序约束；不是通过缩短文档数字提高硬件速度。 |
| [full/main_audio.rao](../../full/main_audio.rao) | GAO片内逻辑分析仪配置；启用会影响资源与布局，须区分调试/发布构建。 |
| [full/main_status.rao](../../full/main_status.rao) | GAO片内逻辑分析仪配置；启用会影响资源与布局，须区分调试/发布构建。 |
| [hardware/ahct125/README.md](../../hardware/ahct125/README.md) | 硬件几何/网络/器件清单、预览、制造导出或检查资料；按子目录README使用。 |
| [hardware/ahct125/assembly_order_notes.md](../../hardware/ahct125/assembly_order_notes.md) | 硬件几何/网络/器件清单、预览、制造导出或检查资料；按子目录README使用。 |
| [hardware/ahct125/release/README.md](../../hardware/ahct125/release/README.md) | 硬件几何/网络/器件清单、预览、制造导出或检查资料；按子目录README使用。 |
| [hardware/ahct125/release/assembly_order_notes.md](../../hardware/ahct125/release/assembly_order_notes.md) | 硬件几何/网络/器件清单、预览、制造导出或检查资料；按子目录README使用。 |
| [hardware/ahct125/release/maintenance/README.md](../../hardware/ahct125/release/maintenance/README.md) | 硬件几何/网络/器件清单、预览、制造导出或检查资料；按子目录README使用。 |
| [hardware/ahct125/release/manifest.json](../../hardware/ahct125/release/manifest.json) | 硬件几何/网络/器件清单、预览、制造导出或检查资料；按子目录README使用。 |
| [hardware/ahct125/release/preview/PCB.png](../../hardware/ahct125/release/preview/PCB.png) | 硬件几何/网络/器件清单、预览、制造导出或检查资料；按子目录README使用。 |
| [hardware/ahct125/release/preview/Schematic.png](../../hardware/ahct125/release/preview/Schematic.png) | 硬件几何/网络/器件清单、预览、制造导出或检查资料；按子目录README使用。 |
| [hardware/ahct125/release/production/AHCT125_LED_R1.net](../../hardware/ahct125/release/production/AHCT125_LED_R1.net) | 硬件几何/网络/器件清单、预览、制造导出或检查资料；按子目录README使用。 |
| [hardware/ahct125/release/production/BOM_AHCT125_LED_R1.csv](../../hardware/ahct125/release/production/BOM_AHCT125_LED_R1.csv) | 硬件几何/网络/器件清单、预览、制造导出或检查资料；按子目录README使用。 |
| [hardware/ahct125/release/production/BOM_AHCT125_LED_R1.xlsx](../../hardware/ahct125/release/production/BOM_AHCT125_LED_R1.xlsx) | 硬件几何/网络/器件清单、预览、制造导出或检查资料；按子目录README使用。 |
| [hardware/ahct125/release/production/CPL_AHCT125_LED_R1.csv](../../hardware/ahct125/release/production/CPL_AHCT125_LED_R1.csv) | 硬件几何/网络/器件清单、预览、制造导出或检查资料；按子目录README使用。 |
| [hardware/ahct125/release/production/CPL_AHCT125_LED_R1.xlsx](../../hardware/ahct125/release/production/CPL_AHCT125_LED_R1.xlsx) | 硬件几何/网络/器件清单、预览、制造导出或检查资料；按子目录README使用。 |
| [hardware/ahct125/release/production/Gerber_AHCT125_LED_R1.zip](../../hardware/ahct125/release/production/Gerber_AHCT125_LED_R1.zip) | 硬件几何/网络/器件清单、预览、制造导出或检查资料；按子目录README使用。 |
| [hardware/ahct125/release/production/PCB_AHCT125_LED_R1.pdf](../../hardware/ahct125/release/production/PCB_AHCT125_LED_R1.pdf) | 硬件几何/网络/器件清单、预览、制造导出或检查资料；按子目录README使用。 |
| [hardware/ahct125/release/project/AHCT125-LED-R1/AHCT125-LED-R1.eprj3](../../hardware/ahct125/release/project/AHCT125-LED-R1/AHCT125-LED-R1.eprj3) | 嘉立创EDA原生硬件设计/项目配置；不是Gowin输入，需原生DRC和实物装配验收。 |
| [hardware/ahct125/release/project/AHCT125-LED-R1/panel/Panel1.epan2](../../hardware/ahct125/release/project/AHCT125-LED-R1/panel/Panel1.epan2) | 嘉立创EDA原生硬件设计/项目配置；不是Gowin输入，需原生DRC和实物装配验收。 |
| [hardware/ahct125/release/project/AHCT125-LED-R1/pcb/PCB1.epcb2](../../hardware/ahct125/release/project/AHCT125-LED-R1/pcb/PCB1.epcb2) | 嘉立创EDA原生硬件设计/项目配置；不是Gowin输入，需原生DRC和实物装配验收。 |
| [hardware/ahct125/release/project/AHCT125-LED-R1/sch/Schematic1/P1.esch2](../../hardware/ahct125/release/project/AHCT125-LED-R1/sch/Schematic1/P1.esch2) | 嘉立创EDA原生硬件设计/项目配置；不是Gowin输入，需原生DRC和实物装配验收。 |
| [hardware/ahct125/release/project/AHCT125-LED-R1/sch/Schematic1/Schematic1.ecfg](../../hardware/ahct125/release/project/AHCT125-LED-R1/sch/Schematic1/Schematic1.ecfg) | 嘉立创EDA原生硬件设计/项目配置；不是Gowin输入，需原生DRC和实物装配验收。 |
| [hardware/ahct125/release/references/critical-layout.json](../../hardware/ahct125/release/references/critical-layout.json) | 硬件几何/网络/器件清单、预览、制造导出或检查资料；按子目录README使用。 |
| [hardware/ahct125/release/verification/fixed-ground-geometry.json](../../hardware/ahct125/release/verification/fixed-ground-geometry.json) | 硬件几何/网络/器件清单、预览、制造导出或检查资料；按子目录README使用。 |
| [hardware/ahct125/release/verification/footprint_review.md](../../hardware/ahct125/release/verification/footprint_review.md) | 硬件几何/网络/器件清单、预览、制造导出或检查资料；按子目录README使用。 |
| [hardware/ahct125/release/verification/independent-ground-check.json](../../hardware/ahct125/release/verification/independent-ground-check.json) | 硬件几何/网络/器件清单、预览、制造导出或检查资料；按子目录README使用。 |
| [hardware/ahct125/release/verification/layout_review.md](../../hardware/ahct125/release/verification/layout_review.md) | 硬件几何/网络/器件清单、预览、制造导出或检查资料；按子目录README使用。 |
| [hardware/ahct125/release/verification/manufacturing_review.json](../../hardware/ahct125/release/verification/manufacturing_review.json) | 硬件几何/网络/器件清单、预览、制造导出或检查资料；按子目录README使用。 |
| [hardware/ahct125/release/verification/manufacturing_review.md](../../hardware/ahct125/release/verification/manufacturing_review.md) | 硬件几何/网络/器件清单、预览、制造导出或检查资料；按子目录README使用。 |
| [hardware/ahct125/release/verification/pcb-check-ground-contours.json](../../hardware/ahct125/release/verification/pcb-check-ground-contours.json) | 硬件几何/网络/器件清单、预览、制造导出或检查资料；按子目录README使用。 |
| [hardware/ahct125/release/verification/release-reopen-check.json](../../hardware/ahct125/release/verification/release-reopen-check.json) | 硬件几何/网络/器件清单、预览、制造导出或检查资料；按子目录README使用。 |
| [hardware/ahct125/release/verification/sch-check.json](../../hardware/ahct125/release/verification/sch-check.json) | 硬件几何/网络/器件清单、预览、制造导出或检查资料；按子目录README使用。 |
| [hardware/ahct125/release/verification/schematic_review.md](../../hardware/ahct125/release/verification/schematic_review.md) | 硬件几何/网络/器件清单、预览、制造导出或检查资料；按子目录README使用。 |
| [hardware/interconnect_backplane/README.md](../../hardware/interconnect_backplane/README.md) | 硬件几何/网络/器件清单、预览、制造导出或检查资料；按子目录README使用。 |
| [hardware/interconnect_backplane/backplane_spec.json](../../hardware/interconnect_backplane/backplane_spec.json) | 硬件几何/网络/器件清单、预览、制造导出或检查资料；按子目录README使用。 |
| [hardware/interconnect_backplane/bom.csv](../../hardware/interconnect_backplane/bom.csv) | 硬件几何/网络/器件清单、预览、制造导出或检查资料；按子目录README使用。 |
| [hardware/interconnect_backplane/connector_map.csv](../../hardware/interconnect_backplane/connector_map.csv) | 硬件几何/网络/器件清单、预览、制造导出或检查资料；按子目录README使用。 |
| [hardware/interconnect_backplane/easyeda/README.md](../../hardware/interconnect_backplane/easyeda/README.md) | 硬件几何/网络/器件清单、预览、制造导出或检查资料；按子目录README使用。 |
| [hardware/interconnect_backplane/easyeda/TangMega60K-Backplane-R2-SameSide/FINAL_DRC_REPORT.md](../../hardware/interconnect_backplane/easyeda/TangMega60K-Backplane-R2-SameSide/FINAL_DRC_REPORT.md) | 硬件几何/网络/器件清单、预览、制造导出或检查资料；按子目录README使用。 |
| [hardware/interconnect_backplane/easyeda/TangMega60K-Backplane-R2-SameSide/README.md](../../hardware/interconnect_backplane/easyeda/TangMega60K-Backplane-R2-SameSide/README.md) | 硬件几何/网络/器件清单、预览、制造导出或检查资料；按子目录README使用。 |
| [hardware/interconnect_backplane/easyeda/TangMega60K-Backplane-R2-SameSide/TangMega60K-Backplane-R2-SameSide.eprj3](../../hardware/interconnect_backplane/easyeda/TangMega60K-Backplane-R2-SameSide/TangMega60K-Backplane-R2-SameSide.eprj3) | 嘉立创EDA原生硬件设计/项目配置；不是Gowin输入，需原生DRC和实物装配验收。 |
| [hardware/interconnect_backplane/easyeda/TangMega60K-Backplane-R2-SameSide/backplane_spec.json](../../hardware/interconnect_backplane/easyeda/TangMega60K-Backplane-R2-SameSide/backplane_spec.json) | 硬件几何/网络/器件清单、预览、制造导出或检查资料；按子目录README使用。 |
| [hardware/interconnect_backplane/easyeda/TangMega60K-Backplane-R2-SameSide/connector_bom.csv](../../hardware/interconnect_backplane/easyeda/TangMega60K-Backplane-R2-SameSide/connector_bom.csv) | 硬件几何/网络/器件清单、预览、制造导出或检查资料；按子目录README使用。 |
| [hardware/interconnect_backplane/easyeda/TangMega60K-Backplane-R2-SameSide/connector_map.csv](../../hardware/interconnect_backplane/easyeda/TangMega60K-Backplane-R2-SameSide/connector_map.csv) | 硬件几何/网络/器件清单、预览、制造导出或检查资料；按子目录README使用。 |
| [hardware/interconnect_backplane/easyeda/TangMega60K-Backplane-R2-SameSide/panel/Panel1.epan2](../../hardware/interconnect_backplane/easyeda/TangMega60K-Backplane-R2-SameSide/panel/Panel1.epan2) | 嘉立创EDA原生硬件设计/项目配置；不是Gowin输入，需原生DRC和实物装配验收。 |
| [hardware/interconnect_backplane/easyeda/TangMega60K-Backplane-R2-SameSide/pcb/PCB1.epcb2](../../hardware/interconnect_backplane/easyeda/TangMega60K-Backplane-R2-SameSide/pcb/PCB1.epcb2) | 嘉立创EDA原生硬件设计/项目配置；不是Gowin输入，需原生DRC和实物装配验收。 |
| [hardware/interconnect_backplane/easyeda/TangMega60K-Backplane-R2-SameSide/references/JILN-3210-XXR-family.pdf](../../hardware/interconnect_backplane/easyeda/TangMega60K-Backplane-R2-SameSide/references/JILN-3210-XXR-family.pdf) | 硬件几何/网络/器件清单、预览、制造导出或检查资料；按子目录README使用。 |
| [hardware/interconnect_backplane/easyeda/TangMega60K-Backplane-R2-SameSide/references/XFCN-PZ254R-11-family.pdf](../../hardware/interconnect_backplane/easyeda/TangMega60K-Backplane-R2-SameSide/references/XFCN-PZ254R-11-family.pdf) | 硬件几何/网络/器件清单、预览、制造导出或检查资料；按子目录README使用。 |
| [hardware/interconnect_backplane/easyeda/TangMega60K-Backplane-R2-SameSide/sch/Schematic1/P1.esch2](../../hardware/interconnect_backplane/easyeda/TangMega60K-Backplane-R2-SameSide/sch/Schematic1/P1.esch2) | 嘉立创EDA原生硬件设计/项目配置；不是Gowin输入，需原生DRC和实物装配验收。 |
| [hardware/interconnect_backplane/easyeda/TangMega60K-Backplane-R2-SameSide/sch/Schematic1/Schematic1.ecfg](../../hardware/interconnect_backplane/easyeda/TangMega60K-Backplane-R2-SameSide/sch/Schematic1/Schematic1.ecfg) | 嘉立创EDA原生硬件设计/项目配置；不是Gowin输入，需原生DRC和实物装配验收。 |
| [hardware/interconnect_backplane/easyeda/evidence/r2-drc-final-reopen.json](../../hardware/interconnect_backplane/easyeda/evidence/r2-drc-final-reopen.json) | 硬件几何/网络/器件清单、预览、制造导出或检查资料；按子目录README使用。 |
| [hardware/interconnect_backplane/easyeda/router_fallback/README.md](../../hardware/interconnect_backplane/easyeda/router_fallback/README.md) | 硬件几何/网络/器件清单、预览、制造导出或检查资料；按子目录README使用。 |
| [hardware/interconnect_backplane/easyeda/router_fallback/r2_geometry_check.json](../../hardware/interconnect_backplane/easyeda/router_fallback/r2_geometry_check.json) | 硬件几何/网络/器件清单、预览、制造导出或检查资料；按子目录README使用。 |
| [hardware/interconnect_backplane/easyeda/router_fallback/routing_r2_verified.json](../../hardware/interconnect_backplane/easyeda/router_fallback/routing_r2_verified.json) | 硬件几何/网络/器件清单、预览、制造导出或检查资料；按子目录README使用。 |
| [hardware/interconnect_backplane/layout_preview.svg](../../hardware/interconnect_backplane/layout_preview.svg) | 硬件几何/网络/器件清单、预览、制造导出或检查资料；按子目录README使用。 |
| [hardware/interconnect_backplane_r0.zip](../../hardware/interconnect_backplane_r0.zip) | 硬件几何/网络/器件清单、预览、制造导出或检查资料；按子目录README使用。 |
| [hardware/led25/README.md](../../hardware/led25/README.md) | 硬件几何/网络/器件清单、预览、制造导出或检查资料；按子目录README使用。 |
| [hardware/led25/calibration-25.json](../../hardware/led25/calibration-25.json) | 硬件几何/网络/器件清单、预览、制造导出或检查资料；按子目录README使用。 |
| [hardware/led25/identity.csv](../../hardware/led25/identity.csv) | 硬件几何/网络/器件清单、预览、制造导出或检查资料；按子目录README使用。 |
| [hardware/led25/serpentine.csv](../../hardware/led25/serpentine.csv) | 硬件几何/网络/器件清单、预览、制造导出或检查资料；按子目录README使用。 |
| [hardware/slider4/Gerber_Touch25_Slider4_100x20_R1_Release.zip](../../hardware/slider4/Gerber_Touch25_Slider4_100x20_R1_Release.zip) | 硬件几何/网络/器件清单、预览、制造导出或检查资料；按子目录README使用。 |
| [hardware/slider4/README.md](../../hardware/slider4/README.md) | 硬件几何/网络/器件清单、预览、制造导出或检查资料；按子目录README使用。 |
| [hardware/slider4/Touch25_Slider4_100x20_R1.epro2](../../hardware/slider4/Touch25_Slider4_100x20_R1.epro2) | 嘉立创EDA原生硬件设计/项目配置；不是Gowin输入，需原生DRC和实物装配验收。 |
| [hardware/slider4/Touch25_Slider4_100x20_R1_Final/Touch25_Slider4_100x20_R1_Final.eprj3](../../hardware/slider4/Touch25_Slider4_100x20_R1_Final/Touch25_Slider4_100x20_R1_Final.eprj3) | 嘉立创EDA原生硬件设计/项目配置；不是Gowin输入，需原生DRC和实物装配验收。 |
| [hardware/slider4/Touch25_Slider4_100x20_R1_Final/eprj3-intro.md](../../hardware/slider4/Touch25_Slider4_100x20_R1_Final/eprj3-intro.md) | 硬件几何/网络/器件清单、预览、制造导出或检查资料；按子目录README使用。 |
| [hardware/slider4/Touch25_Slider4_100x20_R1_Final/panel/Panel1.epan2](../../hardware/slider4/Touch25_Slider4_100x20_R1_Final/panel/Panel1.epan2) | 嘉立创EDA原生硬件设计/项目配置；不是Gowin输入，需原生DRC和实物装配验收。 |
| [hardware/slider4/Touch25_Slider4_100x20_R1_Final/pcb/PCB1.epcb2](../../hardware/slider4/Touch25_Slider4_100x20_R1_Final/pcb/PCB1.epcb2) | 嘉立创EDA原生硬件设计/项目配置；不是Gowin输入，需原生DRC和实物装配验收。 |
| [hardware/slider4/Touch25_Slider4_100x20_R1_Final/pcb/Touch25_Slider4_100x20_R1.epcb2](../../hardware/slider4/Touch25_Slider4_100x20_R1_Final/pcb/Touch25_Slider4_100x20_R1.epcb2) | 嘉立创EDA原生硬件设计/项目配置；不是Gowin输入，需原生DRC和实物装配验收。 |
| [hardware/slider4/Touch25_Slider4_100x20_R1_Final/sch/Schematic1/P1.esch2](../../hardware/slider4/Touch25_Slider4_100x20_R1_Final/sch/Schematic1/P1.esch2) | 嘉立创EDA原生硬件设计/项目配置；不是Gowin输入，需原生DRC和实物装配验收。 |
| [hardware/slider4/Touch25_Slider4_100x20_R1_Final/sch/Schematic1/Schematic1.ecfg](../../hardware/slider4/Touch25_Slider4_100x20_R1_Final/sch/Schematic1/Schematic1.ecfg) | 嘉立创EDA原生硬件设计/项目配置；不是Gowin输入，需原生DRC和实物装配验收。 |
| [hardware/slider4/clean_editor_defaults.json](../../hardware/slider4/clean_editor_defaults.json) | 硬件几何/网络/器件清单、预览、制造导出或检查资料；按子目录README使用。 |
| [hardware/slider4/design_manifest.json](../../hardware/slider4/design_manifest.json) | 硬件几何/网络/器件清单、预览、制造导出或检查资料；按子目录README使用。 |
| [hardware/slider4/design_overview.png](../../hardware/slider4/design_overview.png) | 硬件几何/网络/器件清单、预览、制造导出或检查资料；按子目录README使用。 |
| [hardware/slider4/design_overview.svg](../../hardware/slider4/design_overview.svg) | 硬件几何/网络/器件清单、预览、制造导出或检查资料；按子目录README使用。 |
| [hardware/slider4/independent_geometry_review.json](../../hardware/slider4/independent_geometry_review.json) | 硬件几何/网络/器件清单、预览、制造导出或检查资料；按子目录README使用。 |
| [hardware/slider4/native_drc_pass.jpg](../../hardware/slider4/native_drc_pass.jpg) | 硬件几何/网络/器件清单、预览、制造导出或检查资料；按子目录README使用。 |
| [hardware/slider4/verification/gerber_release_independent_audit.json](../../hardware/slider4/verification/gerber_release_independent_audit.json) | 硬件几何/网络/器件清单、预览、制造导出或检查资料；按子目录README使用。 |
| [hardware/slider4/verification/gerber_release_independent_audit.md](../../hardware/slider4/verification/gerber_release_independent_audit.md) | 硬件几何/网络/器件清单、预览、制造导出或检查资料；按子目录README使用。 |
| [hardware/slider4/wiring.csv](../../hardware/slider4/wiring.csv) | 硬件几何/网络/器件清单、预览、制造导出或检查资料；按子目录README使用。 |
| [hardware/touch25/Gerber_Touch25_C4_C6_18mm_R1_2026-10-09.zip](../../hardware/touch25/Gerber_Touch25_C4_C6_18mm_R1_2026-10-09.zip) | 硬件几何/网络/器件清单、预览、制造导出或检查资料；按子目录README使用。 |
| [hardware/touch25/README.md](../../hardware/touch25/README.md) | 硬件几何/网络/器件清单、预览、制造导出或检查资料；按子目录README使用。 |
| [hardware/touch25/Touch25_C4_C6_18mm_R1.epro2](../../hardware/touch25/Touch25_C4_C6_18mm_R1.epro2) | 嘉立创EDA原生硬件设计/项目配置；不是Gowin输入，需原生DRC和实物装配验收。 |
| [hardware/touch25/Touch25_C4_C6_18mm_R1/Touch25_C4_C6_18mm_R1.eprj3](../../hardware/touch25/Touch25_C4_C6_18mm_R1/Touch25_C4_C6_18mm_R1.eprj3) | 嘉立创EDA原生硬件设计/项目配置；不是Gowin输入，需原生DRC和实物装配验收。 |
| [hardware/touch25/Touch25_C4_C6_18mm_R1/eprj3-intro.md](../../hardware/touch25/Touch25_C4_C6_18mm_R1/eprj3-intro.md) | 硬件几何/网络/器件清单、预览、制造导出或检查资料；按子目录README使用。 |
| [hardware/touch25/Touch25_C4_C6_18mm_R1/pcb/Touch25_C4_C6_18mm_R1.epcb2](../../hardware/touch25/Touch25_C4_C6_18mm_R1/pcb/Touch25_C4_C6_18mm_R1.epcb2) | 嘉立创EDA原生硬件设计/项目配置；不是Gowin输入，需原生DRC和实物装配验收。 |
| [hardware/touch25/Touch25_C4_C6_18mm_R1_Final/Touch25_C4_C6_18mm_R1_Final.eprj3](../../hardware/touch25/Touch25_C4_C6_18mm_R1_Final/Touch25_C4_C6_18mm_R1_Final.eprj3) | 嘉立创EDA原生硬件设计/项目配置；不是Gowin输入，需原生DRC和实物装配验收。 |
| [hardware/touch25/Touch25_C4_C6_18mm_R1_Final/eprj3-intro.md](../../hardware/touch25/Touch25_C4_C6_18mm_R1_Final/eprj3-intro.md) | 硬件几何/网络/器件清单、预览、制造导出或检查资料；按子目录README使用。 |
| [hardware/touch25/Touch25_C4_C6_18mm_R1_Final/pcb/Touch25_C4_C6_18mm_R1.epcb2](../../hardware/touch25/Touch25_C4_C6_18mm_R1_Final/pcb/Touch25_C4_C6_18mm_R1.epcb2) | 嘉立创EDA原生硬件设计/项目配置；不是Gowin输入，需原生DRC和实物装配验收。 |
| [hardware/touch25/assembly_wiring_zh.md](../../hardware/touch25/assembly_wiring_zh.md) | 硬件几何/网络/器件清单、预览、制造导出或检查资料；按子目录README使用。 |
| [hardware/touch25/bottom_preview.png](../../hardware/touch25/bottom_preview.png) | 硬件几何/网络/器件清单、预览、制造导出或检查资料；按子目录README使用。 |
| [hardware/touch25/bottom_preview.svg](../../hardware/touch25/bottom_preview.svg) | 硬件几何/网络/器件清单、预览、制造导出或检查资料；按子目录README使用。 |
| [hardware/touch25/calibration_guide_zh.md](../../hardware/touch25/calibration_guide_zh.md) | 硬件几何/网络/器件清单、预览、制造导出或检查资料；按子目录README使用。 |
| [hardware/touch25/calibration_template.csv](../../hardware/touch25/calibration_template.csv) | 硬件几何/网络/器件清单、预览、制造导出或检查资料；按子目录README使用。 |
| [hardware/touch25/clean_editor_defaults.json](../../hardware/touch25/clean_editor_defaults.json) | 硬件几何/网络/器件清单、预览、制造导出或检查资料；按子目录README使用。 |
| [hardware/touch25/design_manifest.json](../../hardware/touch25/design_manifest.json) | 硬件几何/网络/器件清单、预览、制造导出或检查资料；按子目录README使用。 |
| [hardware/touch25/design_overview.png](../../hardware/touch25/design_overview.png) | 硬件几何/网络/器件清单、预览、制造导出或检查资料；按子目录README使用。 |
| [hardware/touch25/fabrication_parameters_zh.md](../../hardware/touch25/fabrication_parameters_zh.md) | 硬件几何/网络/器件清单、预览、制造导出或检查资料；按子目录README使用。 |
| [hardware/touch25/geometry_preflight.json](../../hardware/touch25/geometry_preflight.json) | 硬件几何/网络/器件清单、预览、制造导出或检查资料；按子目录README使用。 |
| [hardware/touch25/harness_assembly_zh.md](../../hardware/touch25/harness_assembly_zh.md) | 硬件几何/网络/器件清单、预览、制造导出或检查资料；按子目录README使用。 |
| [hardware/touch25/harness_layout.png](../../hardware/touch25/harness_layout.png) | 硬件几何/网络/器件清单、预览、制造导出或检查资料；按子目录README使用。 |
| [hardware/touch25/harness_layout.svg](../../hardware/touch25/harness_layout.svg) | 硬件几何/网络/器件清单、预览、制造导出或检查资料；按子目录README使用。 |
| [hardware/touch25/led_installation_25.png](../../hardware/touch25/led_installation_25.png) | 硬件几何/网络/器件清单、预览、制造导出或检查资料；按子目录README使用。 |
| [hardware/touch25/led_installation_25.svg](../../hardware/touch25/led_installation_25.svg) | 硬件几何/网络/器件清单、预览、制造导出或检查资料；按子目录README使用。 |
| [hardware/touch25/mapping.csv](../../hardware/touch25/mapping.csv) | 硬件几何/网络/器件清单、预览、制造导出或检查资料；按子目录README使用。 |
| [hardware/touch25/top_preview.png](../../hardware/touch25/top_preview.png) | 硬件几何/网络/器件清单、预览、制造导出或检查资料；按子目录README使用。 |
| [hardware/touch25/top_preview.svg](../../hardware/touch25/top_preview.svg) | 硬件几何/网络/器件清单、预览、制造导出或检查资料；按子目录README使用。 |
| [hardware/touch25/touch25_driver_handoff_zh.md](../../hardware/touch25/touch25_driver_handoff_zh.md) | 硬件几何/网络/器件清单、预览、制造导出或检查资料；按子目录README使用。 |
| [hardware/touch25/verification/actual_gerber_audit.json](../../hardware/touch25/verification/actual_gerber_audit.json) | 硬件几何/网络/器件清单、预览、制造导出或检查资料；按子目录README使用。 |
| [hardware/touch25/verification/actual_gerber_review.md](../../hardware/touch25/verification/actual_gerber_review.md) | 硬件几何/网络/器件清单、预览、制造导出或检查资料；按子目录README使用。 |
| [hardware/touch25/verification/optimization_20261009.md](../../hardware/touch25/verification/optimization_20261009.md) | 硬件几何/网络/器件清单、预览、制造导出或检查资料；按子目录README使用。 |
| [hardware/touch25/verification/package_crosscheck.json](../../hardware/touch25/verification/package_crosscheck.json) | 硬件几何/网络/器件清单、预览、制造导出或检查资料；按子目录README使用。 |
| [hardware/wiring31005/core30353_p1.png](../../hardware/wiring31005/core30353_p1.png) | 硬件几何/网络/器件清单、预览、制造导出或检查资料；按子目录README使用。 |
| [hardware/wiring31005/core30354_p1.png](../../hardware/wiring31005/core30354_p1.png) | 硬件几何/网络/器件清单、预览、制造导出或检查资料；按子目录README使用。 |
| [hardware/wiring31005/evidence-manifest.json](../../hardware/wiring31005/evidence-manifest.json) | 硬件几何/网络/器件清单、预览、制造导出或检查资料；按子目录README使用。 |
| [hardware/wiring31005/neo31005_p19.png](../../hardware/wiring31005/neo31005_p19.png) | 硬件几何/网络/器件清单、预览、制造导出或检查资料；按子目录README使用。 |
| [hardware/wiring31005/neo31005_p7.png](../../hardware/wiring31005/neo31005_p7.png) | 硬件几何/网络/器件清单、预览、制造导出或检查资料；按子目录README使用。 |
| [licenses/menu-font/COPYING](../../licenses/menu-font/COPYING) | 第三方素材/字体授权与来源，提交源码时随相关素材保留。 |
| [licenses/menu-font/OFL-1.1.txt](../../licenses/menu-font/OFL-1.1.txt) | 第三方素材/字体授权与来源，提交源码时随相关素材保留。 |
| [licenses/menu-font/manifest.json](../../licenses/menu-font/manifest.json) | 第三方素材/字体授权与来源，提交源码时随相关素材保留。 |
| [mobile/README.md](../../mobile/README.md) | 所在模块的入口、用法与验证边界说明。 |
| [mobile/android/.gitignore](../../mobile/android/.gitignore) | Git忽略/文本属性规则，控制缓存、生成物与换行处理。 |
| [mobile/android/app/src/main/AndroidManifest.xml](../../mobile/android/app/src/main/AndroidManifest.xml) | Android权限、资源或备份策略配置，配合原生Java和Gradle打包。 |
| [mobile/android/app/src/main/res/drawable/ic_piano.xml](../../mobile/android/app/src/main/res/drawable/ic_piano.xml) | Android权限、资源或备份策略配置，配合原生Java和Gradle打包。 |
| [mobile/android/app/src/main/res/xml/data_extraction_rules.xml](../../mobile/android/app/src/main/res/xml/data_extraction_rules.xml) | Android权限、资源或备份策略配置，配合原生Java和Gradle打包。 |
| [mobile/examples/score.json](../../mobile/examples/score.json) | 配套配置/数据/说明；结合所属目录使用，不作为独立可执行功能。 |
| [mono_auto/MonoAutostart.gprj](../../mono_auto/MonoAutostart.gprj) | Gowin工程入口：列出器件与输入文件；具体顶层由配套构建脚本指定。 |
| [mono_auto/README.md](../../mono_auto/README.md) | 所在模块的入口、用法与验证边界说明。 |
| [mono_auto/mono_auto.cst](../../mono_auto/mono_auto.cst) | 物理引脚和I/O电平约束；须对应此工程的实物接线。 |
| [mono_auto/mono_auto.sdc](../../mono_auto/mono_auto.sdc) | 时钟、生成时钟和时序约束；不是通过缩短文档数字提高硬件速度。 |
| [mono_auto/rtl/audio/rom/midi.hex](../../mono_auto/rtl/audio/rom/midi.hex) | 128个MIDI音高的频率控制字；HDL初始化输入，不等于整段录音。 |
| [mono_auto/rtl/audio/rom/piano.hex](../../mono_auto/rtl/audio/rom/piano.hex) | 原钢琴数学查表数据；HDL初始化输入，不等于整段录音。 |
| [mono_auto/rtl/audio/rom/polar_lane0.hex](../../mono_auto/rtl/audio/rom/polar_lane0.hex) | 八成分钢琴偶数通道的分段幅度/相位参数；HDL初始化输入，不等于整段录音。 |
| [mono_auto/rtl/audio/rom/polar_lane1.hex](../../mono_auto/rtl/audio/rom/polar_lane1.hex) | 八成分钢琴奇数通道的分段幅度/相位参数；HDL初始化输入，不等于整段录音。 |
| [mono_auto/rtl/audio/rom/polar_ratios.hex](../../mono_auto/rtl/audio/rom/polar_ratios.hex) | 八成分非整数谐波频率比例；HDL初始化输入，不等于整段录音。 |
| [mono_auto/rtl/audio/rom/ratio.hex](../../mono_auto/rtl/audio/rom/ratio.hex) | 弯音/颤音的音高比例查表；HDL初始化输入，不等于整段录音。 |
| [mono_auto/rtl/audio/rom/sine.hex](../../mono_auto/rtl/audio/rom/sine.hex) | 正弦波表；HDL初始化输入，不等于整段录音。 |
| [mono_auto/rtl/audio/rom/velocity.hex](../../mono_auto/rtl/audio/rom/velocity.hex) | 力度到幅度的曲线；HDL初始化输入，不等于整段录音。 |
| [mono_auto/rtl/audio/rom/waves.hex](../../mono_auto/rtl/audio/rom/waves.hex) | 数学周期波形查表数据；HDL初始化输入，不等于整段录音。 |
| [mono_diag/MonoDiagnostic.gprj](../../mono_diag/MonoDiagnostic.gprj) | Gowin工程入口：列出器件与输入文件；具体顶层由配套构建脚本指定。 |
| [mono_diag/README.md](../../mono_diag/README.md) | 所在模块的入口、用法与验证边界说明。 |
| [mono_diag/mono_diag.cst](../../mono_diag/mono_diag.cst) | 物理引脚和I/O电平约束；须对应此工程的实物接线。 |
| [mono_diag/mono_diag.sdc](../../mono_diag/mono_diag.sdc) | 时钟、生成时钟和时序约束；不是通过缩短文档数字提高硬件速度。 |
| [mono_diag/rtl/audio/rom/midi.hex](../../mono_diag/rtl/audio/rom/midi.hex) | 128个MIDI音高的频率控制字；HDL初始化输入，不等于整段录音。 |
| [mono_diag/rtl/audio/rom/piano.hex](../../mono_diag/rtl/audio/rom/piano.hex) | 原钢琴数学查表数据；HDL初始化输入，不等于整段录音。 |
| [mono_diag/rtl/audio/rom/polar_lane0.hex](../../mono_diag/rtl/audio/rom/polar_lane0.hex) | 八成分钢琴偶数通道的分段幅度/相位参数；HDL初始化输入，不等于整段录音。 |
| [mono_diag/rtl/audio/rom/polar_lane1.hex](../../mono_diag/rtl/audio/rom/polar_lane1.hex) | 八成分钢琴奇数通道的分段幅度/相位参数；HDL初始化输入，不等于整段录音。 |
| [mono_diag/rtl/audio/rom/polar_ratios.hex](../../mono_diag/rtl/audio/rom/polar_ratios.hex) | 八成分非整数谐波频率比例；HDL初始化输入，不等于整段录音。 |
| [mono_diag/rtl/audio/rom/ratio.hex](../../mono_diag/rtl/audio/rom/ratio.hex) | 弯音/颤音的音高比例查表；HDL初始化输入，不等于整段录音。 |
| [mono_diag/rtl/audio/rom/sine.hex](../../mono_diag/rtl/audio/rom/sine.hex) | 正弦波表；HDL初始化输入，不等于整段录音。 |
| [mono_diag/rtl/audio/rom/velocity.hex](../../mono_diag/rtl/audio/rom/velocity.hex) | 力度到幅度的曲线；HDL初始化输入，不等于整段录音。 |
| [mono_diag/rtl/audio/rom/waves.hex](../../mono_diag/rtl/audio/rom/waves.hex) | 数学周期波形查表数据；HDL初始化输入，不等于整段录音。 |
| [releases/learning-mode-20261026/ContestFull_LearningMode1024.fs](../../releases/learning-mode-20261026/ContestFull_LearningMode1024.fs) | 已归档发布包/清单/说明；不是默认正在编译的源码，需匹配版本。 |
| [releases/learning-mode-20261026/README.md](../../releases/learning-mode-20261026/README.md) | 已归档发布包/清单/说明；不是默认正在编译的源码，需匹配版本。 |
| [releases/learning-mode-20261026/SHA256.json](../../releases/learning-mode-20261026/SHA256.json) | 已归档发布包/清单/说明；不是默认正在编译的源码，需匹配版本。 |
| [releases/learning-mode-20261026/TangNeonStudio-Windows-1.5.0.zip](../../releases/learning-mode-20261026/TangNeonStudio-Windows-1.5.0.zip) | 已归档发布包/清单/说明；不是默认正在编译的源码，需匹配版本。 |
| [releases/learning-mode-20261026/evidence/browser.log](../../releases/learning-mode-20261026/evidence/browser.log) | 已归档发布包/清单/说明；不是默认正在编译的源码，需匹配版本。 |
| [releases/learning-mode-20261026/evidence/desktop-unit.log](../../releases/learning-mode-20261026/evidence/desktop-unit.log) | 已归档发布包/清单/说明；不是默认正在编译的源码，需匹配版本。 |
| [releases/learning-mode-20261026/evidence/fpga/ContestFull.pin.html](../../releases/learning-mode-20261026/evidence/fpga/ContestFull.pin.html) | Gowin自动生成的引脚/资源/时序HTML报告，不是运行程序；内容只对应该目录的构建版本。 |
| [releases/learning-mode-20261026/evidence/fpga/ContestFull.rpt.txt](../../releases/learning-mode-20261026/evidence/fpga/ContestFull.rpt.txt) | 已归档发布包/清单/说明；不是默认正在编译的源码，需匹配版本。 |
| [releases/learning-mode-20261026/evidence/fpga/ContestFull.tr](../../releases/learning-mode-20261026/evidence/fpga/ContestFull.tr) | 已归档发布包/清单/说明；不是默认正在编译的源码，需匹配版本。 |
| [releases/learning-mode-20261026/evidence/fpga/build-results.json](../../releases/learning-mode-20261026/evidence/fpga/build-results.json) | 已归档发布包/清单/说明；不是默认正在编译的源码，需匹配版本。 |
| [releases/learning-mode-20261026/evidence/fpga/gowin-build.log](../../releases/learning-mode-20261026/evidence/fpga/gowin-build.log) | 已归档发布包/清单/说明；不是默认正在编译的源码，需匹配版本。 |
| [releases/learning-mode-20261026/evidence/fpga/gowin-run.json](../../releases/learning-mode-20261026/evidence/fpga/gowin-run.json) | 已归档发布包/清单/说明；不是默认正在编译的源码，需匹配版本。 |
| [releases/learning-mode-20261026/evidence/fpga/gprj-dependencies.json](../../releases/learning-mode-20261026/evidence/fpga/gprj-dependencies.json) | 已归档发布包/清单/说明；不是默认正在编译的源码，需匹配版本。 |
| [releases/learning-mode-20261026/evidence/fpga/snapshot-inputs-after.json](../../releases/learning-mode-20261026/evidence/fpga/snapshot-inputs-after.json) | 已归档发布包/清单/说明；不是默认正在编译的源码，需匹配版本。 |
| [releases/learning-mode-20261026/evidence/fpga/snapshot-inputs.json](../../releases/learning-mode-20261026/evidence/fpga/snapshot-inputs.json) | 已归档发布包/清单/说明；不是默认正在编译的源码，需匹配版本。 |
| [releases/learning-mode-20261026/evidence/fpga/snapshot-metadata.json](../../releases/learning-mode-20261026/evidence/fpga/snapshot-metadata.json) | 已归档发布包/清单/说明；不是默认正在编译的源码，需匹配版本。 |
| [releases/learning-mode-20261026/evidence/modelsim/run_20261026_110418_581ab908/cases/control_router.do](../../releases/learning-mode-20261026/evidence/modelsim/run_20261026_110418_581ab908/cases/control_router.do) | 当次ModelSim用例运行脚本，保存编译/参数/运行命令；配套日志才证明结果，历史绝对路径须重建。 |
| [releases/learning-mode-20261026/evidence/modelsim/run_20261026_110418_581ab908/cases/direct_capability.do](../../releases/learning-mode-20261026/evidence/modelsim/run_20261026_110418_581ab908/cases/direct_capability.do) | 当次ModelSim用例运行脚本，保存编译/参数/运行命令；配套日志才证明结果，历史绝对路径须重建。 |
| [releases/learning-mode-20261026/evidence/modelsim/run_20261026_110418_581ab908/cases/direct_score.do](../../releases/learning-mode-20261026/evidence/modelsim/run_20261026_110418_581ab908/cases/direct_score.do) | 当次ModelSim用例运行脚本，保存编译/参数/运行命令；配套日志才证明结果，历史绝对路径须重建。 |
| [releases/learning-mode-20261026/evidence/modelsim/run_20261026_110418_581ab908/cases/direct_system.do](../../releases/learning-mode-20261026/evidence/modelsim/run_20261026_110418_581ab908/cases/direct_system.do) | 当次ModelSim用例运行脚本，保存编译/参数/运行命令；配套日志才证明结果，历史绝对路径须重建。 |
| [releases/learning-mode-20261026/evidence/modelsim/run_20261026_110418_581ab908/cases/global_panic.do](../../releases/learning-mode-20261026/evidence/modelsim/run_20261026_110418_581ab908/cases/global_panic.do) | 当次ModelSim用例运行脚本，保存编译/参数/运行命令；配套日志才证明结果，历史绝对路径须重建。 |
| [releases/learning-mode-20261026/evidence/modelsim/run_20261026_110418_581ab908/cases/learning_mode.do](../../releases/learning-mode-20261026/evidence/modelsim/run_20261026_110418_581ab908/cases/learning_mode.do) | 当次ModelSim用例运行脚本，保存编译/参数/运行命令；配套日志才证明结果，历史绝对路径须重建。 |
| [releases/learning-mode-20261026/evidence/modelsim/run_20261026_110418_581ab908/cases/learning_status.do](../../releases/learning-mode-20261026/evidence/modelsim/run_20261026_110418_581ab908/cases/learning_status.do) | 当次ModelSim用例运行脚本，保存编译/参数/运行命令；配套日志才证明结果，历史绝对路径须重建。 |
| [releases/learning-mode-20261026/evidence/modelsim/run_20261026_110418_581ab908/cases/learning_system.do](../../releases/learning-mode-20261026/evidence/modelsim/run_20261026_110418_581ab908/cases/learning_system.do) | 当次ModelSim用例运行脚本，保存编译/参数/运行命令；配套日志才证明结果，历史绝对路径须重建。 |
| [releases/learning-mode-20261026/evidence/modelsim/run_20261026_110418_581ab908/cases/menu_replay.do](../../releases/learning-mode-20261026/evidence/modelsim/run_20261026_110418_581ab908/cases/menu_replay.do) | 当次ModelSim用例运行脚本，保存编译/参数/运行命令；配套日志才证明结果，历史绝对路径须重建。 |
| [releases/learning-mode-20261026/evidence/modelsim/run_20261026_110418_581ab908/cases/menu_system.do](../../releases/learning-mode-20261026/evidence/modelsim/run_20261026_110418_581ab908/cases/menu_system.do) | 当次ModelSim用例运行脚本，保存编译/参数/运行命令；配套日志才证明结果，历史绝对路径须重建。 |
| [releases/learning-mode-20261026/evidence/modelsim/run_20261026_110418_581ab908/cases/mode_status.do](../../releases/learning-mode-20261026/evidence/modelsim/run_20261026_110418_581ab908/cases/mode_status.do) | 当次ModelSim用例运行脚本，保存编译/参数/运行命令；配套日志才证明结果，历史绝对路径须重建。 |
| [releases/learning-mode-20261026/evidence/modelsim/run_20261026_110418_581ab908/cases/performance.do](../../releases/learning-mode-20261026/evidence/modelsim/run_20261026_110418_581ab908/cases/performance.do) | 当次ModelSim用例运行脚本，保存编译/参数/运行命令；配套日志才证明结果，历史绝对路径须重建。 |
| [releases/learning-mode-20261026/evidence/modelsim/run_20261026_110418_581ab908/cases/performance_commit.do](../../releases/learning-mode-20261026/evidence/modelsim/run_20261026_110418_581ab908/cases/performance_commit.do) | 当次ModelSim用例运行脚本，保存编译/参数/运行命令；配套日志才证明结果，历史绝对路径须重建。 |
| [releases/learning-mode-20261026/evidence/modelsim/run_20261026_110418_581ab908/cases/performance_retrigger.do](../../releases/learning-mode-20261026/evidence/modelsim/run_20261026_110418_581ab908/cases/performance_retrigger.do) | 当次ModelSim用例运行脚本，保存编译/参数/运行命令；配套日志才证明结果，历史绝对路径须重建。 |
| [releases/learning-mode-20261026/evidence/modelsim/run_20261026_110418_581ab908/cases/ws2812_matrix.do](../../releases/learning-mode-20261026/evidence/modelsim/run_20261026_110418_581ab908/cases/ws2812_matrix.do) | 当次ModelSim用例运行脚本，保存编译/参数/运行命令；涉及tb_ws2812_matrix；配套日志才证明结果，历史绝对路径须重建。 |
| [releases/learning-mode-20261026/evidence/modelsim/run_20261026_110418_581ab908/inputs.json](../../releases/learning-mode-20261026/evidence/modelsim/run_20261026_110418_581ab908/inputs.json) | 已归档发布包/清单/说明；不是默认正在编译的源码，需匹配版本。 |
| [releases/learning-mode-20261026/evidence/modelsim/run_20261026_110418_581ab908/logs/control_router.console.log](../../releases/learning-mode-20261026/evidence/modelsim/run_20261026_110418_581ab908/logs/control_router.console.log) | 已归档发布包/清单/说明；不是默认正在编译的源码，需匹配版本。 |
| [releases/learning-mode-20261026/evidence/modelsim/run_20261026_110418_581ab908/logs/control_router.exitcode](../../releases/learning-mode-20261026/evidence/modelsim/run_20261026_110418_581ab908/logs/control_router.exitcode) | 已归档发布包/清单/说明；不是默认正在编译的源码，需匹配版本。 |
| [releases/learning-mode-20261026/evidence/modelsim/run_20261026_110418_581ab908/logs/control_router.log](../../releases/learning-mode-20261026/evidence/modelsim/run_20261026_110418_581ab908/logs/control_router.log) | 已归档发布包/清单/说明；不是默认正在编译的源码，需匹配版本。 |
| [releases/learning-mode-20261026/evidence/modelsim/run_20261026_110418_581ab908/logs/direct_capability.console.log](../../releases/learning-mode-20261026/evidence/modelsim/run_20261026_110418_581ab908/logs/direct_capability.console.log) | 已归档发布包/清单/说明；不是默认正在编译的源码，需匹配版本。 |
| [releases/learning-mode-20261026/evidence/modelsim/run_20261026_110418_581ab908/logs/direct_capability.exitcode](../../releases/learning-mode-20261026/evidence/modelsim/run_20261026_110418_581ab908/logs/direct_capability.exitcode) | 已归档发布包/清单/说明；不是默认正在编译的源码，需匹配版本。 |
| [releases/learning-mode-20261026/evidence/modelsim/run_20261026_110418_581ab908/logs/direct_capability.log](../../releases/learning-mode-20261026/evidence/modelsim/run_20261026_110418_581ab908/logs/direct_capability.log) | 已归档发布包/清单/说明；不是默认正在编译的源码，需匹配版本。 |
| [releases/learning-mode-20261026/evidence/modelsim/run_20261026_110418_581ab908/logs/direct_score.console.log](../../releases/learning-mode-20261026/evidence/modelsim/run_20261026_110418_581ab908/logs/direct_score.console.log) | 已归档发布包/清单/说明；不是默认正在编译的源码，需匹配版本。 |
| [releases/learning-mode-20261026/evidence/modelsim/run_20261026_110418_581ab908/logs/direct_score.exitcode](../../releases/learning-mode-20261026/evidence/modelsim/run_20261026_110418_581ab908/logs/direct_score.exitcode) | 已归档发布包/清单/说明；不是默认正在编译的源码，需匹配版本。 |
| [releases/learning-mode-20261026/evidence/modelsim/run_20261026_110418_581ab908/logs/direct_score.log](../../releases/learning-mode-20261026/evidence/modelsim/run_20261026_110418_581ab908/logs/direct_score.log) | 已归档发布包/清单/说明；不是默认正在编译的源码，需匹配版本。 |
| [releases/learning-mode-20261026/evidence/modelsim/run_20261026_110418_581ab908/logs/direct_system.console.log](../../releases/learning-mode-20261026/evidence/modelsim/run_20261026_110418_581ab908/logs/direct_system.console.log) | 已归档发布包/清单/说明；不是默认正在编译的源码，需匹配版本。 |
| [releases/learning-mode-20261026/evidence/modelsim/run_20261026_110418_581ab908/logs/direct_system.exitcode](../../releases/learning-mode-20261026/evidence/modelsim/run_20261026_110418_581ab908/logs/direct_system.exitcode) | 已归档发布包/清单/说明；不是默认正在编译的源码，需匹配版本。 |
| [releases/learning-mode-20261026/evidence/modelsim/run_20261026_110418_581ab908/logs/direct_system.log](../../releases/learning-mode-20261026/evidence/modelsim/run_20261026_110418_581ab908/logs/direct_system.log) | 已归档发布包/清单/说明；不是默认正在编译的源码，需匹配版本。 |
| [releases/learning-mode-20261026/evidence/modelsim/run_20261026_110418_581ab908/logs/global_panic.console.log](../../releases/learning-mode-20261026/evidence/modelsim/run_20261026_110418_581ab908/logs/global_panic.console.log) | 已归档发布包/清单/说明；不是默认正在编译的源码，需匹配版本。 |
| [releases/learning-mode-20261026/evidence/modelsim/run_20261026_110418_581ab908/logs/global_panic.exitcode](../../releases/learning-mode-20261026/evidence/modelsim/run_20261026_110418_581ab908/logs/global_panic.exitcode) | 已归档发布包/清单/说明；不是默认正在编译的源码，需匹配版本。 |
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
| [releases/learning-mode-20261026/evidence/modelsim/run_20261026_110418_581ab908/logs/performance_retrigger.log](../../releases/learning-mode-20261026/evidence/modelsim/run_20261026_110418_581ab908/logs/performance_retrigger.log) | 已归档发布包/清单/说明；不是默认正在编译的源码，需匹配版本。 |
| [releases/learning-mode-20261026/evidence/modelsim/run_20261026_110418_581ab908/logs/rtl.compile.log](../../releases/learning-mode-20261026/evidence/modelsim/run_20261026_110418_581ab908/logs/rtl.compile.log) | 已归档发布包/清单/说明；不是默认正在编译的源码，需匹配版本。 |
| [releases/learning-mode-20261026/evidence/modelsim/run_20261026_110418_581ab908/logs/testbenches.compile.log](../../releases/learning-mode-20261026/evidence/modelsim/run_20261026_110418_581ab908/logs/testbenches.compile.log) | 已归档发布包/清单/说明；不是默认正在编译的源码，需匹配版本。 |
| [releases/learning-mode-20261026/evidence/modelsim/run_20261026_110418_581ab908/logs/vendor.compile.log](../../releases/learning-mode-20261026/evidence/modelsim/run_20261026_110418_581ab908/logs/vendor.compile.log) | 已归档发布包/清单/说明；不是默认正在编译的源码，需匹配版本。 |
| [releases/learning-mode-20261026/evidence/modelsim/run_20261026_110418_581ab908/logs/vlib.log](../../releases/learning-mode-20261026/evidence/modelsim/run_20261026_110418_581ab908/logs/vlib.log) | 已归档发布包/清单/说明；不是默认正在编译的源码，需匹配版本。 |
| [releases/learning-mode-20261026/evidence/modelsim/run_20261026_110418_581ab908/logs/ws2812_matrix.console.log](../../releases/learning-mode-20261026/evidence/modelsim/run_20261026_110418_581ab908/logs/ws2812_matrix.console.log) | 已归档发布包/清单/说明；不是默认正在编译的源码，需匹配版本。 |
| [releases/learning-mode-20261026/evidence/modelsim/run_20261026_110418_581ab908/logs/ws2812_matrix.exitcode](../../releases/learning-mode-20261026/evidence/modelsim/run_20261026_110418_581ab908/logs/ws2812_matrix.exitcode) | 已归档发布包/清单/说明；不是默认正在编译的源码，需匹配版本。 |
| [releases/learning-mode-20261026/evidence/modelsim/run_20261026_110418_581ab908/logs/ws2812_matrix.log](../../releases/learning-mode-20261026/evidence/modelsim/run_20261026_110418_581ab908/logs/ws2812_matrix.log) | 已归档发布包/清单/说明；不是默认正在编译的源码，需匹配版本。 |
| [releases/learning-mode-20261026/evidence/modelsim/run_20261026_110418_581ab908/manifest.json](../../releases/learning-mode-20261026/evidence/modelsim/run_20261026_110418_581ab908/manifest.json) | 已归档发布包/清单/说明；不是默认正在编译的源码，需匹配版本。 |
| [releases/learning-mode-20261026/evidence/modelsim/run_20261026_110418_581ab908/test-summary.json](../../releases/learning-mode-20261026/evidence/modelsim/run_20261026_110418_581ab908/test-summary.json) | 已归档发布包/清单/说明；不是默认正在编译的源码，需匹配版本。 |
| [releases/learning-mode-20261026/evidence/modelsim/run_20261026_111343_f9037044/cases/full_system.do](../../releases/learning-mode-20261026/evidence/modelsim/run_20261026_111343_f9037044/cases/full_system.do) | 当次ModelSim用例运行脚本，保存编译/参数/运行命令；涉及tb_instrument_full_system；配套日志才证明结果，历史绝对路径须重建。 |
| [releases/learning-mode-20261026/evidence/modelsim/run_20261026_111343_f9037044/cases/mpr121_backpressure.do](../../releases/learning-mode-20261026/evidence/modelsim/run_20261026_111343_f9037044/cases/mpr121_backpressure.do) | 当次ModelSim用例运行脚本，保存编译/参数/运行命令；配套日志才证明结果，历史绝对路径须重建。 |
| [releases/learning-mode-20261026/evidence/modelsim/run_20261026_111343_f9037044/cases/performance_stage.do](../../releases/learning-mode-20261026/evidence/modelsim/run_20261026_111343_f9037044/cases/performance_stage.do) | 当次ModelSim用例运行脚本，保存编译/参数/运行命令；配套日志才证明结果，历史绝对路径须重建。 |
| [releases/learning-mode-20261026/evidence/modelsim/run_20261026_111343_f9037044/cases/score_capacity_1024.do](../../releases/learning-mode-20261026/evidence/modelsim/run_20261026_111343_f9037044/cases/score_capacity_1024.do) | 当次ModelSim用例运行脚本，保存编译/参数/运行命令；配套日志才证明结果，历史绝对路径须重建。 |
| [releases/learning-mode-20261026/evidence/modelsim/run_20261026_111343_f9037044/inputs.json](../../releases/learning-mode-20261026/evidence/modelsim/run_20261026_111343_f9037044/inputs.json) | 已归档发布包/清单/说明；不是默认正在编译的源码，需匹配版本。 |
| [releases/learning-mode-20261026/evidence/modelsim/run_20261026_111343_f9037044/logs/full_system.console.log](../../releases/learning-mode-20261026/evidence/modelsim/run_20261026_111343_f9037044/logs/full_system.console.log) | 已归档发布包/清单/说明；不是默认正在编译的源码，需匹配版本。 |
| [releases/learning-mode-20261026/evidence/modelsim/run_20261026_111343_f9037044/logs/full_system.exitcode](../../releases/learning-mode-20261026/evidence/modelsim/run_20261026_111343_f9037044/logs/full_system.exitcode) | 已归档发布包/清单/说明；不是默认正在编译的源码，需匹配版本。 |
| [releases/learning-mode-20261026/evidence/modelsim/run_20261026_111343_f9037044/logs/full_system.log](../../releases/learning-mode-20261026/evidence/modelsim/run_20261026_111343_f9037044/logs/full_system.log) | 已归档发布包/清单/说明；不是默认正在编译的源码，需匹配版本。 |
| [releases/learning-mode-20261026/evidence/modelsim/run_20261026_111343_f9037044/logs/mpr121_backpressure.console.log](../../releases/learning-mode-20261026/evidence/modelsim/run_20261026_111343_f9037044/logs/mpr121_backpressure.console.log) | 已归档发布包/清单/说明；不是默认正在编译的源码，需匹配版本。 |
| [releases/learning-mode-20261026/evidence/modelsim/run_20261026_111343_f9037044/logs/mpr121_backpressure.exitcode](../../releases/learning-mode-20261026/evidence/modelsim/run_20261026_111343_f9037044/logs/mpr121_backpressure.exitcode) | 已归档发布包/清单/说明；不是默认正在编译的源码，需匹配版本。 |
| [releases/learning-mode-20261026/evidence/modelsim/run_20261026_111343_f9037044/logs/mpr121_backpressure.log](../../releases/learning-mode-20261026/evidence/modelsim/run_20261026_111343_f9037044/logs/mpr121_backpressure.log) | 已归档发布包/清单/说明；不是默认正在编译的源码，需匹配版本。 |
| [releases/learning-mode-20261026/evidence/modelsim/run_20261026_111343_f9037044/logs/performance_stage.console.log](../../releases/learning-mode-20261026/evidence/modelsim/run_20261026_111343_f9037044/logs/performance_stage.console.log) | 已归档发布包/清单/说明；不是默认正在编译的源码，需匹配版本。 |
| [releases/learning-mode-20261026/evidence/modelsim/run_20261026_111343_f9037044/logs/performance_stage.exitcode](../../releases/learning-mode-20261026/evidence/modelsim/run_20261026_111343_f9037044/logs/performance_stage.exitcode) | 已归档发布包/清单/说明；不是默认正在编译的源码，需匹配版本。 |
| [releases/learning-mode-20261026/evidence/modelsim/run_20261026_111343_f9037044/logs/performance_stage.log](../../releases/learning-mode-20261026/evidence/modelsim/run_20261026_111343_f9037044/logs/performance_stage.log) | 已归档发布包/清单/说明；不是默认正在编译的源码，需匹配版本。 |
| [releases/learning-mode-20261026/evidence/modelsim/run_20261026_111343_f9037044/logs/rtl.compile.log](../../releases/learning-mode-20261026/evidence/modelsim/run_20261026_111343_f9037044/logs/rtl.compile.log) | 已归档发布包/清单/说明；不是默认正在编译的源码，需匹配版本。 |
| [releases/learning-mode-20261026/evidence/modelsim/run_20261026_111343_f9037044/logs/score_capacity_1024.console.log](../../releases/learning-mode-20261026/evidence/modelsim/run_20261026_111343_f9037044/logs/score_capacity_1024.console.log) | 已归档发布包/清单/说明；不是默认正在编译的源码，需匹配版本。 |
| [releases/learning-mode-20261026/evidence/modelsim/run_20261026_111343_f9037044/logs/score_capacity_1024.exitcode](../../releases/learning-mode-20261026/evidence/modelsim/run_20261026_111343_f9037044/logs/score_capacity_1024.exitcode) | 已归档发布包/清单/说明；不是默认正在编译的源码，需匹配版本。 |
| [releases/learning-mode-20261026/evidence/modelsim/run_20261026_111343_f9037044/logs/score_capacity_1024.log](../../releases/learning-mode-20261026/evidence/modelsim/run_20261026_111343_f9037044/logs/score_capacity_1024.log) | 已归档发布包/清单/说明；不是默认正在编译的源码，需匹配版本。 |
| [releases/learning-mode-20261026/evidence/modelsim/run_20261026_111343_f9037044/logs/testbenches.compile.log](../../releases/learning-mode-20261026/evidence/modelsim/run_20261026_111343_f9037044/logs/testbenches.compile.log) | 已归档发布包/清单/说明；不是默认正在编译的源码，需匹配版本。 |
| [releases/learning-mode-20261026/evidence/modelsim/run_20261026_111343_f9037044/logs/vendor.compile.log](../../releases/learning-mode-20261026/evidence/modelsim/run_20261026_111343_f9037044/logs/vendor.compile.log) | 已归档发布包/清单/说明；不是默认正在编译的源码，需匹配版本。 |
| [releases/learning-mode-20261026/evidence/modelsim/run_20261026_111343_f9037044/logs/vlib.log](../../releases/learning-mode-20261026/evidence/modelsim/run_20261026_111343_f9037044/logs/vlib.log) | 已归档发布包/清单/说明；不是默认正在编译的源码，需匹配版本。 |
| [releases/learning-mode-20261026/evidence/modelsim/run_20261026_111343_f9037044/manifest.json](../../releases/learning-mode-20261026/evidence/modelsim/run_20261026_111343_f9037044/manifest.json) | 已归档发布包/清单/说明；不是默认正在编译的源码，需匹配版本。 |
| [releases/learning-mode-20261026/evidence/modelsim/run_20261026_111343_f9037044/test-summary.json](../../releases/learning-mode-20261026/evidence/modelsim/run_20261026_111343_f9037044/test-summary.json) | 已归档发布包/清单/说明；不是默认正在编译的源码，需匹配版本。 |
| [releases/learning-mode-20261026/evidence/publication/desktop.log](../../releases/learning-mode-20261026/evidence/publication/desktop.log) | 已归档发布包/清单/说明；不是默认正在编译的源码，需匹配版本。 |
| [releases/learning-mode-20261026/evidence/publication/mobile-midi.log](../../releases/learning-mode-20261026/evidence/publication/mobile-midi.log) | 已归档发布包/清单/说明；不是默认正在编译的源码，需匹配版本。 |
| [releases/learning-mode-20261026/evidence/publication/mobile.log](../../releases/learning-mode-20261026/evidence/publication/mobile.log) | 已归档发布包/清单/说明；不是默认正在编译的源码，需匹配版本。 |
| [releases/learning-mode-20261026/evidence/publication/python.log](../../releases/learning-mode-20261026/evidence/publication/python.log) | 已归档发布包/清单/说明；不是默认正在编译的源码，需匹配版本。 |
| [releases/learning-mode-20261026/evidence/ui/learning-narrow.png](../../releases/learning-mode-20261026/evidence/ui/learning-narrow.png) | 已归档发布包/清单/说明；不是默认正在编译的源码，需匹配版本。 |
| [releases/learning-mode-20261026/evidence/ui/result.json](../../releases/learning-mode-20261026/evidence/ui/result.json) | 已归档发布包/清单/说明；不是默认正在编译的源码，需匹配版本。 |
| [releases/learning-mode-20261026/evidence/ui/wait-for-chord.png](../../releases/learning-mode-20261026/evidence/ui/wait-for-chord.png) | 已归档发布包/清单/说明；不是默认正在编译的源码，需匹配版本。 |
| [releases/learning-mode-20261026/evidence/windows-build/build-manifest.json](../../releases/learning-mode-20261026/evidence/windows-build/build-manifest.json) | 已归档发布包/清单/说明；不是默认正在编译的源码，需匹配版本。 |
| [releases/learning-mode-20261026/evidence/windows-build/installed-dependencies.txt](../../releases/learning-mode-20261026/evidence/windows-build/installed-dependencies.txt) | 已归档发布包/清单/说明；不是默认正在编译的源码，需匹配版本。 |
| [releases/learning-mode-20261026/evidence/windows-build/packaged-smoke-test.json](../../releases/learning-mode-20261026/evidence/windows-build/packaged-smoke-test.json) | 已归档发布包/清单/说明；不是默认正在编译的源码，需匹配版本。 |
| [releases/learning-mode-20261026/manifest.json](../../releases/learning-mode-20261026/manifest.json) | 已归档发布包/清单/说明；不是默认正在编译的源码，需匹配版本。 |
| [releases/learning-mode-20261026/使用与模块说明.md](../../releases/learning-mode-20261026/%E4%BD%BF%E7%94%A8%E4%B8%8E%E6%A8%A1%E5%9D%97%E8%AF%B4%E6%98%8E.md) | 已归档发布包/清单/说明；不是默认正在编译的源码，需匹配版本。 |
| [releases/learning-mode-20261026/提交前复核.md](../../releases/learning-mode-20261026/%E6%8F%90%E4%BA%A4%E5%89%8D%E5%A4%8D%E6%A0%B8.md) | 已归档发布包/清单/说明；不是默认正在编译的源码，需匹配版本。 |
| [releases/learning-mode-20261026/验证结果.md](../../releases/learning-mode-20261026/%E9%AA%8C%E8%AF%81%E7%BB%93%E6%9E%9C.md) | 已归档发布包/清单/说明；不是默认正在编译的源码，需匹配版本。 |
| [releases/pipeline-round2-20261026/ContestFull_PipelineRound2_TEST1024.zip](../../releases/pipeline-round2-20261026/ContestFull_PipelineRound2_TEST1024.zip) | 已归档发布包/清单/说明；不是默认正在编译的源码，需匹配版本。 |
| [releases/pipeline-round2-20261026/README.md](../../releases/pipeline-round2-20261026/README.md) | 已归档发布包/清单/说明；不是默认正在编译的源码，需匹配版本。 |
| [releases/pipeline-round2-20261026/release-info.json](../../releases/pipeline-round2-20261026/release-info.json) | 已归档发布包/清单/说明；不是默认正在编译的源码，需匹配版本。 |
| [releases/slider-volume-20261026/ContestFull_SliderVolume_TEST1024.zip](../../releases/slider-volume-20261026/ContestFull_SliderVolume_TEST1024.zip) | 已归档发布包/清单/说明；不是默认正在编译的源码，需匹配版本。 |
| [releases/slider-volume-20261026/README.md](../../releases/slider-volume-20261026/README.md) | 已归档发布包/清单/说明；不是默认正在编译的源码，需匹配版本。 |
| [releases/slider-volume-20261026/release-info.json](../../releases/slider-volume-20261026/release-info.json) | 已归档发布包/清单/说明；不是默认正在编译的源码，需匹配版本。 |
| [rtl/audio/rom/menu_font.hex](../../rtl/audio/rom/menu_font.hex) | OLED中文/符号字模；HDL初始化输入，不等于整段录音。 |
| [rtl/audio/rom/midi.hex](../../rtl/audio/rom/midi.hex) | 128个MIDI音高的频率控制字；HDL初始化输入，不等于整段录音。 |
| [rtl/audio/rom/piano.hex](../../rtl/audio/rom/piano.hex) | 原钢琴数学查表数据；HDL初始化输入，不等于整段录音。 |
| [rtl/audio/rom/polar_lane0.hex](../../rtl/audio/rom/polar_lane0.hex) | 八成分钢琴偶数通道的分段幅度/相位参数；HDL初始化输入，不等于整段录音。 |
| [rtl/audio/rom/polar_lane1.hex](../../rtl/audio/rom/polar_lane1.hex) | 八成分钢琴奇数通道的分段幅度/相位参数；HDL初始化输入，不等于整段录音。 |
| [rtl/audio/rom/polar_ratios.hex](../../rtl/audio/rom/polar_ratios.hex) | 八成分非整数谐波频率比例；HDL初始化输入，不等于整段录音。 |
| [rtl/audio/rom/ratio.hex](../../rtl/audio/rom/ratio.hex) | 弯音/颤音的音高比例查表；HDL初始化输入，不等于整段录音。 |
| [rtl/audio/rom/sine.hex](../../rtl/audio/rom/sine.hex) | 正弦波表；HDL初始化输入，不等于整段录音。 |
| [rtl/audio/rom/velocity.hex](../../rtl/audio/rom/velocity.hex) | 力度到幅度的曲线；HDL初始化输入，不等于整段录音。 |
| [rtl/audio/rom/waves.hex](../../rtl/audio/rom/waves.hex) | 数学周期波形查表数据；HDL初始化输入，不等于整段录音。 |
| [rtl/visual/goertzel_1024_64.hex](../../rtl/visual/goertzel_1024_64.hex) | 64个Goertzel显示频点系数；HDL初始化输入，不等于整段录音。 |
| [sim/gclk_comparison_timing.txt](../../sim/gclk_comparison_timing.txt) | 配套配置/数据/说明；结合所属目录使用，不作为独立可执行功能。 |
| [sim/modelsim_local.ini](../../sim/modelsim_local.ini) | 配套配置/数据/说明；结合所属目录使用，不作为独立可执行功能。 |
| [verification/ble-connection-fix-20261023/README.md](../../verification/ble-connection-fix-20261023/README.md) | 历史验证记录/固定输入/采集资料；对应版本和实际结果须看同目录清单。 |
| [verification/ble-connection-fix-20261023/accepted-summary.json](../../verification/ble-connection-fix-20261023/accepted-summary.json) | 历史验证记录/固定输入/采集资料；对应版本和实际结果须看同目录清单。 |
| [verification/ble-connection-fix-20261023/c3-compile.log](../../verification/ble-connection-fix-20261023/c3-compile.log) | 历史验证记录/固定输入/采集资料；对应版本和实际结果须看同目录清单。 |
| [verification/ble-connection-fix-20261023/c3-review/README.md](../../verification/ble-connection-fix-20261023/c3-review/README.md) | 历史验证记录/固定输入/采集资料；对应版本和实际结果须看同目录清单。 |
| [verification/ble-connection-fix-20261023/c3-review/after/ble_bridge.ino](../../verification/ble-connection-fix-20261023/c3-review/after/ble_bridge.ino) | 2026-10-23 C3修复后冻结对照副本：ESP32-C3 BLE↔UART透明桥，处理会话、队列、故障和统计；不合成音频，不生成曲谱事件，也不替FPGA重复执行命令。 |
| [verification/ble-connection-fix-20261023/c3-review/after/bridge_uart_io.h](../../verification/ble-connection-fix-20261023/c3-review/after/bridge_uart_io.h) | 2026-10-23 C3修复后冻结对照副本：基于IDF UART检查实际写入/超时，避免上层接口无条件返回成功导致丢包。 |
| [verification/ble-connection-fix-20261023/c3-review/before/ble_bridge.ino](../../verification/ble-connection-fix-20261023/c3-review/before/ble_bridge.ino) | 2026-10-23 C3修复前冻结对照副本：ESP32-C3 BLE↔UART透明桥，处理会话、队列、故障和统计；不合成音频，不生成曲谱事件，也不替FPGA重复执行命令。 |
| [verification/ble-connection-fix-20261023/c3-review/before/bridge_uart_io.h](../../verification/ble-connection-fix-20261023/c3-review/before/bridge_uart_io.h) | 2026-10-23 C3修复前冻结对照副本：基于IDF UART检查实际写入/超时，避免上层接口无条件返回成功导致丢包。 |
| [verification/ble-connection-fix-20261023/c3-review/harness/bridge_transport_test.cpp](../../verification/ble-connection-fix-20261023/c3-review/harness/bridge_transport_test.cpp) | C3桥实际传输逻辑的宿主测试，使用Arduino/BLE/RTOS替身，不代表射频结果；历史专项材料，不等于当前版本已重新运行。 |
| [verification/ble-connection-fix-20261023/c3-review/harness/run-bridge-tests.py](../../verification/ble-connection-fix-20261023/c3-review/harness/run-bridge-tests.py) | 编译并运行宿主桥传输测试；历史专项材料，不等于当前版本已重新运行。 |
| [verification/ble-connection-fix-20261023/c3-review/harness/stubs/Arduino.h](../../verification/ble-connection-fix-20261023/c3-review/harness/stubs/Arduino.h) | 宿主测试用Arduino.h替身，模拟Arduino/BLE/RTOS接口；不编入正式C3固件，也不是上游SDK。 |
| [verification/ble-connection-fix-20261023/c3-review/harness/stubs/BLE2902.h](../../verification/ble-connection-fix-20261023/c3-review/harness/stubs/BLE2902.h) | 宿主测试用BLE2902.h替身，模拟Arduino/BLE/RTOS接口；不编入正式C3固件，也不是上游SDK。 |
| [verification/ble-connection-fix-20261023/c3-review/harness/stubs/BLEDevice.h](../../verification/ble-connection-fix-20261023/c3-review/harness/stubs/BLEDevice.h) | 宿主测试用BLEDevice.h替身，模拟Arduino/BLE/RTOS接口；不编入正式C3固件，也不是上游SDK。 |
| [verification/ble-connection-fix-20261023/c3-review/harness/stubs/BLEServer.h](../../verification/ble-connection-fix-20261023/c3-review/harness/stubs/BLEServer.h) | 宿主测试用BLEServer.h替身，模拟Arduino/BLE/RTOS接口；不编入正式C3固件，也不是上游SDK。 |
| [verification/ble-connection-fix-20261023/c3-review/harness/stubs/BLEUtils.h](../../verification/ble-connection-fix-20261023/c3-review/harness/stubs/BLEUtils.h) | 宿主测试用BLEUtils.h替身，模拟Arduino/BLE/RTOS接口；不编入正式C3固件，也不是上游SDK。 |
| [verification/ble-connection-fix-20261023/c3-review/harness/stubs/freertos/FreeRTOS.h](../../verification/ble-connection-fix-20261023/c3-review/harness/stubs/freertos/FreeRTOS.h) | 宿主测试用FreeRTOS.h替身，模拟Arduino/BLE/RTOS接口；不编入正式C3固件，也不是上游SDK。 |
| [verification/ble-connection-fix-20261023/c3-review/harness/stubs/freertos/queue.h](../../verification/ble-connection-fix-20261023/c3-review/harness/stubs/freertos/queue.h) | 宿主测试用queue.h替身，模拟Arduino/BLE/RTOS接口；不编入正式C3固件，也不是上游SDK。 |
| [verification/ble-connection-fix-20261023/c3-review/harness/stubs/freertos/task.h](../../verification/ble-connection-fix-20261023/c3-review/harness/stubs/freertos/task.h) | 宿主测试用task.h替身，模拟Arduino/BLE/RTOS接口；不编入正式C3固件，也不是上游SDK。 |
| [verification/ble-connection-fix-20261023/c3-review/host-close_20261023_220707_498936/result.json](../../verification/ble-connection-fix-20261023/c3-review/host-close_20261023_220707_498936/result.json) | 历史验证记录/固定输入/采集资料；对应版本和实际结果须看同目录清单。 |
| [verification/ble-connection-fix-20261023/c3-review/production-freeze.json](../../verification/ble-connection-fix-20261023/c3-review/production-freeze.json) | 历史验证记录/固定输入/采集资料；对应版本和实际结果须看同目录清单。 |
| [verification/ble-connection-fix-20261023/c3-review/run_host_close_tests.py](../../verification/ble-connection-fix-20261023/c3-review/run_host_close_tests.py) | 核对主机关闭/断连时桥队列清理；历史专项材料，不等于当前版本已重新运行。 |
| [verification/ble-connection-fix-20261023/c3-review/run_lifecycle_tests.py](../../verification/ble-connection-fix-20261023/c3-review/run_lifecycle_tests.py) | 核对BLE桥会话切换与生命周期；历史专项材料，不等于当前版本已重新运行。 |
| [verification/ble-connection-fix-20261023/desktop-review/README.md](../../verification/ble-connection-fix-20261023/desktop-review/README.md) | 历史验证记录/固定输入/采集资料；对应版本和实际结果须看同目录清单。 |
| [verification/ble-connection-fix-20261023/desktop-review/diagnostic-ui-result.json](../../verification/ble-connection-fix-20261023/desktop-review/diagnostic-ui-result.json) | 历史验证记录/固定输入/采集资料；对应版本和实际结果须看同目录清单。 |
| [verification/ble-connection-fix-20261023/desktop-review/diagnostic-ui.log](../../verification/ble-connection-fix-20261023/desktop-review/diagnostic-ui.log) | 历史验证记录/固定输入/采集资料；对应版本和实际结果须看同目录清单。 |
| [verification/ble-connection-fix-20261023/desktop-review/diagnostics-result.json](../../verification/ble-connection-fix-20261023/desktop-review/diagnostics-result.json) | 历史验证记录/固定输入/采集资料；对应版本和实际结果须看同目录清单。 |
| [verification/ble-connection-fix-20261023/desktop-review/diagnostics-tests.log](../../verification/ble-connection-fix-20261023/desktop-review/diagnostics-tests.log) | 历史验证记录/固定输入/采集资料；对应版本和实际结果须看同目录清单。 |
| [verification/ble-connection-fix-20261023/desktop-review/first-notify-result.json](../../verification/ble-connection-fix-20261023/desktop-review/first-notify-result.json) | 历史验证记录/固定输入/采集资料；对应版本和实际结果须看同目录清单。 |
| [verification/ble-connection-fix-20261023/desktop-review/first-notify.log](../../verification/ble-connection-fix-20261023/desktop-review/first-notify.log) | 历史验证记录/固定输入/采集资料；对应版本和实际结果须看同目录清单。 |
| [verification/ble-connection-fix-20261023/desktop-review/first-readback-result.json](../../verification/ble-connection-fix-20261023/desktop-review/first-readback-result.json) | 历史验证记录/固定输入/采集资料；对应版本和实际结果须看同目录清单。 |
| [verification/ble-connection-fix-20261023/desktop-review/first-readback.log](../../verification/ble-connection-fix-20261023/desktop-review/first-readback.log) | 历史验证记录/固定输入/采集资料；对应版本和实际结果须看同目录清单。 |
| [verification/ble-connection-fix-20261023/desktop-review/native-legacy-11.log](../../verification/ble-connection-fix-20261023/desktop-review/native-legacy-11.log) | 历史验证记录/固定输入/采集资料；对应版本和实际结果须看同目录清单。 |
| [verification/ble-connection-fix-20261023/desktop-review/run_diagnostic_ui.py](../../verification/ble-connection-fix-20261023/desktop-review/run_diagnostic_ui.py) | 运行诊断界面测试并留存证据；历史专项材料，不等于当前版本已重新运行。 |
| [verification/ble-connection-fix-20261023/desktop-review/test_diagnostics.py](../../verification/ble-connection-fix-20261023/desktop-review/test_diagnostics.py) | 测试诊断信息与错误传播；历史专项材料，不等于当前版本已重新运行。 |
| [verification/ble-connection-fix-20261023/desktop-review/test_first_notify.py](../../verification/ble-connection-fix-20261023/desktop-review/test_first_notify.py) | 测试BLE首条通知在订阅/连接边界的处理；历史专项材料，不等于当前版本已重新运行。 |
| [verification/ble-connection-fix-20261023/desktop-review/test_first_readback.js](../../verification/ble-connection-fix-20261023/desktop-review/test_first_readback.js) | 测试首条状态读回和控制会话握手；历史专项材料，不等于当前版本已重新运行。 |
| [verification/ble-connection-fix-20261023/final-verification.json](../../verification/ble-connection-fix-20261023/final-verification.json) | 历史验证记录/固定输入/采集资料；对应版本和实际结果须看同目录清单。 |
| [verification/code-hardening-20261023/README.md](../../verification/code-hardening-20261023/README.md) | 历史验证记录/固定输入/采集资料；对应版本和实际结果须看同目录清单。 |
| [verification/code-hardening-20261023/fpga-build/build_uart-prefix-recovery_20261023_094225_1ccb041d/build-results.json](../../verification/code-hardening-20261023/fpga-build/build_uart-prefix-recovery_20261023_094225_1ccb041d/build-results.json) | 历史验证记录/固定输入/采集资料；对应版本和实际结果须看同目录清单。 |
| [verification/code-hardening-20261023/fpga-build/build_uart-prefix-recovery_20261023_094225_1ccb041d/gowin-build.log](../../verification/code-hardening-20261023/fpga-build/build_uart-prefix-recovery_20261023_094225_1ccb041d/gowin-build.log) | 历史验证记录/固定输入/采集资料；对应版本和实际结果须看同目录清单。 |
| [verification/code-hardening-20261023/fpga-build/build_uart-prefix-recovery_20261023_094225_1ccb041d/gowin-run.json](../../verification/code-hardening-20261023/fpga-build/build_uart-prefix-recovery_20261023_094225_1ccb041d/gowin-run.json) | 历史验证记录/固定输入/采集资料；对应版本和实际结果须看同目录清单。 |
| [verification/code-hardening-20261023/fpga-build/build_uart-prefix-recovery_20261023_094225_1ccb041d/gprj-dependencies.json](../../verification/code-hardening-20261023/fpga-build/build_uart-prefix-recovery_20261023_094225_1ccb041d/gprj-dependencies.json) | 历史验证记录/固定输入/采集资料；对应版本和实际结果须看同目录清单。 |
| [verification/code-hardening-20261023/fpga-build/build_uart-prefix-recovery_20261023_094225_1ccb041d/snapshot-inputs.json](../../verification/code-hardening-20261023/fpga-build/build_uart-prefix-recovery_20261023_094225_1ccb041d/snapshot-inputs.json) | 历史验证记录/固定输入/采集资料；对应版本和实际结果须看同目录清单。 |
| [verification/desktop-app-20261021/README.md](../../verification/desktop-app-20261021/README.md) | 历史验证记录/固定输入/采集资料；对应版本和实际结果须看同目录清单。 |
| [verification/direct-score/baseline.json](../../verification/direct-score/baseline.json) | 历史验证记录/固定输入/采集资料；对应版本和实际结果须看同目录清单。 |
| [verification/learning-mode/build-results.json](../../verification/learning-mode/build-results.json) | 历史验证记录/固定输入/采集资料；对应版本和实际结果须看同目录清单。 |
| [verification/modelsim-20261014/README.md](../../verification/modelsim-20261014/README.md) | 历史验证记录/固定输入/采集资料；对应版本和实际结果须看同目录清单。 |
| [verification/modelsim-20261014/baseline_20261014_124011/case_1.log](../../verification/modelsim-20261014/baseline_20261014_124011/case_1.log) | 历史验证记录/固定输入/采集资料；对应版本和实际结果须看同目录清单。 |
| [verification/modelsim-20261014/baseline_20261014_124011/case_1.stdout.log](../../verification/modelsim-20261014/baseline_20261014_124011/case_1.stdout.log) | 历史验证记录/固定输入/采集资料；对应版本和实际结果须看同目录清单。 |
| [verification/modelsim-20261014/baseline_20261014_124011/case_2.log](../../verification/modelsim-20261014/baseline_20261014_124011/case_2.log) | 历史验证记录/固定输入/采集资料；对应版本和实际结果须看同目录清单。 |
| [verification/modelsim-20261014/baseline_20261014_124011/case_2.stdout.log](../../verification/modelsim-20261014/baseline_20261014_124011/case_2.stdout.log) | 历史验证记录/固定输入/采集资料；对应版本和实际结果须看同目录清单。 |
| [verification/modelsim-20261014/baseline_20261014_124011/case_3.log](../../verification/modelsim-20261014/baseline_20261014_124011/case_3.log) | 历史验证记录/固定输入/采集资料；对应版本和实际结果须看同目录清单。 |
| [verification/modelsim-20261014/baseline_20261014_124011/case_3.stdout.log](../../verification/modelsim-20261014/baseline_20261014_124011/case_3.stdout.log) | 历史验证记录/固定输入/采集资料；对应版本和实际结果须看同目录清单。 |
| [verification/modelsim-20261014/baseline_20261014_124011/compile.log](../../verification/modelsim-20261014/baseline_20261014_124011/compile.log) | 历史验证记录/固定输入/采集资料；对应版本和实际结果须看同目录清单。 |
| [verification/modelsim-20261014/baseline_20261014_124011/compile.stdout.log](../../verification/modelsim-20261014/baseline_20261014_124011/compile.stdout.log) | 历史验证记录/固定输入/采集资料；对应版本和实际结果须看同目录清单。 |
| [verification/modelsim-20261014/baseline_20261014_124011/results.json](../../verification/modelsim-20261014/baseline_20261014_124011/results.json) | 历史验证记录/固定输入/采集资料；对应版本和实际结果须看同目录清单。 |
| [verification/modelsim-20261014/build_snapshot_20261014_124217/README.md](../../verification/modelsim-20261014/build_snapshot_20261014_124217/README.md) | 历史验证记录/固定输入/采集资料；对应版本和实际结果须看同目录清单。 |
| [verification/modelsim-20261014/build_snapshot_20261014_124217/build-results.json](../../verification/modelsim-20261014/build_snapshot_20261014_124217/build-results.json) | 历史验证记录/固定输入/采集资料；对应版本和实际结果须看同目录清单。 |
| [verification/modelsim-20261014/build_snapshot_20261014_124217/gowin-build.exit.txt](../../verification/modelsim-20261014/build_snapshot_20261014_124217/gowin-build.exit.txt) | 历史验证记录/固定输入/采集资料；对应版本和实际结果须看同目录清单。 |
| [verification/modelsim-20261014/build_snapshot_20261014_124217/gowin-build.log](../../verification/modelsim-20261014/build_snapshot_20261014_124217/gowin-build.log) | 历史验证记录/固定输入/采集资料；对应版本和实际结果须看同目录清单。 |
| [verification/modelsim-20261014/build_snapshot_20261014_124217/gprj-dependencies.json](../../verification/modelsim-20261014/build_snapshot_20261014_124217/gprj-dependencies.json) | 历史验证记录/固定输入/采集资料；对应版本和实际结果须看同目录清单。 |
| [verification/modelsim-20261014/build_snapshot_20261014_124217/protected-impl-after.json](../../verification/modelsim-20261014/build_snapshot_20261014_124217/protected-impl-after.json) | 历史验证记录/固定输入/采集资料；对应版本和实际结果须看同目录清单。 |
| [verification/modelsim-20261014/build_snapshot_20261014_124217/protected-impl-before.json](../../verification/modelsim-20261014/build_snapshot_20261014_124217/protected-impl-before.json) | 历史验证记录/固定输入/采集资料；对应版本和实际结果须看同目录清单。 |
| [verification/modelsim-20261014/build_snapshot_20261014_124217/snapshot-inputs.json](../../verification/modelsim-20261014/build_snapshot_20261014_124217/snapshot-inputs.json) | 历史验证记录/固定输入/采集资料；对应版本和实际结果须看同目录清单。 |
| [verification/modelsim-20261014/build_snapshot_20261014_124217/snapshot-metadata.json](../../verification/modelsim-20261014/build_snapshot_20261014_124217/snapshot-metadata.json) | 历史验证记录/固定输入/采集资料；对应版本和实际结果须看同目录清单。 |
| [verification/modelsim-20261014/core_acceptance/README.md](../../verification/modelsim-20261014/core_acceptance/README.md) | 历史验证记录/固定输入/采集资料；对应版本和实际结果须看同目录清单。 |
| [verification/modelsim-20261014/core_acceptance/manifest.json](../../verification/modelsim-20261014/core_acceptance/manifest.json) | 历史验证记录/固定输入/采集资料；对应版本和实际结果须看同目录清单。 |
| [verification/modelsim-20261014/run_20261014_124827_1829ac81/inputs.json](../../verification/modelsim-20261014/run_20261014_124827_1829ac81/inputs.json) | 历史验证记录/固定输入/采集资料；对应版本和实际结果须看同目录清单。 |
| [verification/modelsim-20261014/run_20261014_124827_1829ac81/logs/audio_engine_n4.console.log](../../verification/modelsim-20261014/run_20261014_124827_1829ac81/logs/audio_engine_n4.console.log) | 历史验证记录/固定输入/采集资料；对应版本和实际结果须看同目录清单。 |
| [verification/modelsim-20261014/run_20261014_124827_1829ac81/logs/audio_engine_n4.exitcode](../../verification/modelsim-20261014/run_20261014_124827_1829ac81/logs/audio_engine_n4.exitcode) | 历史验证记录/固定输入/采集资料；对应版本和实际结果须看同目录清单。 |
| [verification/modelsim-20261014/run_20261014_124827_1829ac81/logs/audio_engine_n4.log](../../verification/modelsim-20261014/run_20261014_124827_1829ac81/logs/audio_engine_n4.log) | 历史验证记录/固定输入/采集资料；对应版本和实际结果须看同目录清单。 |
| [verification/modelsim-20261014/run_20261014_124827_1829ac81/logs/audio_engine_n64.console.log](../../verification/modelsim-20261014/run_20261014_124827_1829ac81/logs/audio_engine_n64.console.log) | 历史验证记录/固定输入/采集资料；对应版本和实际结果须看同目录清单。 |
| [verification/modelsim-20261014/run_20261014_124827_1829ac81/logs/audio_engine_n64.log](../../verification/modelsim-20261014/run_20261014_124827_1829ac81/logs/audio_engine_n64.log) | 历史验证记录/固定输入/采集资料；对应版本和实际结果须看同目录清单。 |
| [verification/modelsim-20261014/run_20261014_124827_1829ac81/logs/audio_engine_n64.timeout.log](../../verification/modelsim-20261014/run_20261014_124827_1829ac81/logs/audio_engine_n64.timeout.log) | 历史验证记录/固定输入/采集资料；对应版本和实际结果须看同目录清单。 |
| [verification/modelsim-20261014/run_20261014_124827_1829ac81/logs/audio_i2s.console.log](../../verification/modelsim-20261014/run_20261014_124827_1829ac81/logs/audio_i2s.console.log) | 历史验证记录/固定输入/采集资料；对应版本和实际结果须看同目录清单。 |
| [verification/modelsim-20261014/run_20261014_124827_1829ac81/logs/audio_i2s.exitcode](../../verification/modelsim-20261014/run_20261014_124827_1829ac81/logs/audio_i2s.exitcode) | 历史验证记录/固定输入/采集资料；对应版本和实际结果须看同目录清单。 |
| [verification/modelsim-20261014/run_20261014_124827_1829ac81/logs/audio_i2s.log](../../verification/modelsim-20261014/run_20261014_124827_1829ac81/logs/audio_i2s.log) | 历史验证记录/固定输入/采集资料；对应版本和实际结果须看同目录清单。 |
| [verification/modelsim-20261014/run_20261014_124827_1829ac81/logs/audio_monitor_cdc.console.log](../../verification/modelsim-20261014/run_20261014_124827_1829ac81/logs/audio_monitor_cdc.console.log) | 历史验证记录/固定输入/采集资料；对应版本和实际结果须看同目录清单。 |
| [verification/modelsim-20261014/run_20261014_124827_1829ac81/logs/audio_monitor_cdc.exitcode](../../verification/modelsim-20261014/run_20261014_124827_1829ac81/logs/audio_monitor_cdc.exitcode) | 历史验证记录/固定输入/采集资料；对应版本和实际结果须看同目录清单。 |
| [verification/modelsim-20261014/run_20261014_124827_1829ac81/logs/audio_monitor_cdc.log](../../verification/modelsim-20261014/run_20261014_124827_1829ac81/logs/audio_monitor_cdc.log) | 历史验证记录/固定输入/采集资料；对应版本和实际结果须看同目录清单。 |
| [verification/modelsim-20261014/run_20261014_124827_1829ac81/logs/audio_units.console.log](../../verification/modelsim-20261014/run_20261014_124827_1829ac81/logs/audio_units.console.log) | 历史验证记录/固定输入/采集资料；对应版本和实际结果须看同目录清单。 |
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
| [verification/modelsim-20261014/run_20261014_124827_1829ac81/logs/ws2812_reject_large.log](../../verification/modelsim-20261014/run_20261014_124827_1829ac81/logs/ws2812_reject_large.log) | 历史验证记录/固定输入/采集资料；对应版本和实际结果须看同目录清单。 |
| [verification/modelsim-20261014/run_20261014_124827_1829ac81/logs/ws2812_reject_map.console.log](../../verification/modelsim-20261014/run_20261014_124827_1829ac81/logs/ws2812_reject_map.console.log) | 历史验证记录/固定输入/采集资料；对应版本和实际结果须看同目录清单。 |
| [verification/modelsim-20261014/run_20261014_124827_1829ac81/logs/ws2812_reject_map.exitcode](../../verification/modelsim-20261014/run_20261014_124827_1829ac81/logs/ws2812_reject_map.exitcode) | 历史验证记录/固定输入/采集资料；对应版本和实际结果须看同目录清单。 |
| [verification/modelsim-20261014/run_20261014_124827_1829ac81/logs/ws2812_reject_map.log](../../verification/modelsim-20261014/run_20261014_124827_1829ac81/logs/ws2812_reject_map.log) | 历史验证记录/固定输入/采集资料；对应版本和实际结果须看同目录清单。 |
| [verification/modelsim-20261014/run_20261014_124827_1829ac81/logs/ws2812_reject_zero.console.log](../../verification/modelsim-20261014/run_20261014_124827_1829ac81/logs/ws2812_reject_zero.console.log) | 历史验证记录/固定输入/采集资料；对应版本和实际结果须看同目录清单。 |
| [verification/modelsim-20261014/run_20261014_124827_1829ac81/logs/ws2812_reject_zero.exitcode](../../verification/modelsim-20261014/run_20261014_124827_1829ac81/logs/ws2812_reject_zero.exitcode) | 历史验证记录/固定输入/采集资料；对应版本和实际结果须看同目录清单。 |
| [verification/modelsim-20261014/run_20261014_124827_1829ac81/logs/ws2812_reject_zero.log](../../verification/modelsim-20261014/run_20261014_124827_1829ac81/logs/ws2812_reject_zero.log) | 历史验证记录/固定输入/采集资料；对应版本和实际结果须看同目录清单。 |
| [verification/modelsim-20261014/run_20261014_124827_1829ac81/logs/ws2812_waveform.console.log](../../verification/modelsim-20261014/run_20261014_124827_1829ac81/logs/ws2812_waveform.console.log) | 历史验证记录/固定输入/采集资料；对应版本和实际结果须看同目录清单。 |
| [verification/modelsim-20261014/run_20261014_124827_1829ac81/logs/ws2812_waveform.exitcode](../../verification/modelsim-20261014/run_20261014_124827_1829ac81/logs/ws2812_waveform.exitcode) | 历史验证记录/固定输入/采集资料；对应版本和实际结果须看同目录清单。 |
| [verification/modelsim-20261014/run_20261014_124827_1829ac81/logs/ws2812_waveform.log](../../verification/modelsim-20261014/run_20261014_124827_1829ac81/logs/ws2812_waveform.log) | 历史验证记录/固定输入/采集资料；对应版本和实际结果须看同目录清单。 |
| [verification/modelsim-20261014/run_20261014_124827_1829ac81/manifest.json](../../verification/modelsim-20261014/run_20261014_124827_1829ac81/manifest.json) | 历史验证记录/固定输入/采集资料；对应版本和实际结果须看同目录清单。 |
| [verification/modelsim-20261014/run_20261014_124827_1829ac81/test-summary.json](../../verification/modelsim-20261014/run_20261014_124827_1829ac81/test-summary.json) | 历史验证记录/固定输入/采集资料；对应版本和实际结果须看同目录清单。 |
| [verification/second-code-review-20261023/README.md](../../verification/second-code-review-20261023/README.md) | 历史验证记录/固定输入/采集资料；对应版本和实际结果须看同目录清单。 |
| [verification/timing-20261014/audit-watchdog-equivalence-inputs.ps1](../../verification/timing-20261014/audit-watchdog-equivalence-inputs.ps1) | 核对历史看门狗等价测试输入哈希与参考版本；历史专项材料，不等于当前版本已重新运行。 |
| [verification/timing-20261014/router-performance-equivalence-evidence.md](../../verification/timing-20261014/router-performance-equivalence-evidence.md) | 历史验证记录/固定输入/采集资料；对应版本和实际结果须看同目录清单。 |
| [verification/timing-20261014/router_performance_equivalence_20261014_200638_461a1134/compile.console.log](../../verification/timing-20261014/router_performance_equivalence_20261014_200638_461a1134/compile.console.log) | 历史验证记录/固定输入/采集资料；对应版本和实际结果须看同目录清单。 |
| [verification/timing-20261014/router_performance_equivalence_20261014_200638_461a1134/compile.log](../../verification/timing-20261014/router_performance_equivalence_20261014_200638_461a1134/compile.log) | 历史验证记录/固定输入/采集资料；对应版本和实际结果须看同目录清单。 |
| [verification/timing-20261014/router_performance_equivalence_20261014_200638_461a1134/oracle_negative.console.log](../../verification/timing-20261014/router_performance_equivalence_20261014_200638_461a1134/oracle_negative.console.log) | 历史验证记录/固定输入/采集资料；对应版本和实际结果须看同目录清单。 |
| [verification/timing-20261014/router_performance_equivalence_20261014_200638_461a1134/oracle_negative.log](../../verification/timing-20261014/router_performance_equivalence_20261014_200638_461a1134/oracle_negative.log) | 历史验证记录/固定输入/采集资料；对应版本和实际结果须看同目录清单。 |
| [verification/timing-20261014/router_performance_equivalence_20261014_200638_461a1134/seed_123456789.console.log](../../verification/timing-20261014/router_performance_equivalence_20261014_200638_461a1134/seed_123456789.console.log) | 历史验证记录/固定输入/采集资料；对应版本和实际结果须看同目录清单。 |
| [verification/timing-20261014/router_performance_equivalence_20261014_200638_461a1134/seed_123456789.log](../../verification/timing-20261014/router_performance_equivalence_20261014_200638_461a1134/seed_123456789.log) | 历史验证记录/固定输入/采集资料；对应版本和实际结果须看同目录清单。 |
| [verification/timing-20261014/router_performance_equivalence_20261014_200638_461a1134/seed_471833.console.log](../../verification/timing-20261014/router_performance_equivalence_20261014_200638_461a1134/seed_471833.console.log) | 历史验证记录/固定输入/采集资料；对应版本和实际结果须看同目录清单。 |
| [verification/timing-20261014/router_performance_equivalence_20261014_200638_461a1134/seed_471833.log](../../verification/timing-20261014/router_performance_equivalence_20261014_200638_461a1134/seed_471833.log) | 历史验证记录/固定输入/采集资料；对应版本和实际结果须看同目录清单。 |
| [verification/timing-20261014/router_performance_equivalence_20261014_200638_461a1134/seed_94177.console.log](../../verification/timing-20261014/router_performance_equivalence_20261014_200638_461a1134/seed_94177.console.log) | 历史验证记录/固定输入/采集资料；对应版本和实际结果须看同目录清单。 |
| [verification/timing-20261014/router_performance_equivalence_20261014_200638_461a1134/seed_94177.log](../../verification/timing-20261014/router_performance_equivalence_20261014_200638_461a1134/seed_94177.log) | 历史验证记录/固定输入/采集资料；对应版本和实际结果须看同目录清单。 |
| [verification/timing-20261014/router_performance_equivalence_20261014_200638_461a1134/summary.json](../../verification/timing-20261014/router_performance_equivalence_20261014_200638_461a1134/summary.json) | 历史验证记录/固定输入/采集资料；对应版本和实际结果须看同目录清单。 |
| [verification/timing-20261014/watchdog-equivalence-evidence.md](../../verification/timing-20261014/watchdog-equivalence-evidence.md) | 历史验证记录/固定输入/采集资料；对应版本和实际结果须看同目录清单。 |
| [verification/timing-20261014/watchdog-equivalence-guard-audit.json](../../verification/timing-20261014/watchdog-equivalence-guard-audit.json) | 历史验证记录/固定输入/采集资料；对应版本和实际结果须看同目录清单。 |
| [verification/timing-20261014/watchdog-equivalence-tested-runner-v1.ps1](../../verification/timing-20261014/watchdog-equivalence-tested-runner-v1.ps1) | 当次已受验的看门狗等价运行器快照；历史专项材料，不等于当前版本已重新运行。 |
| [verification/timing-20261014/watchdog_equivalence_20261014_194640_7ea7700c/summary.json](../../verification/timing-20261014/watchdog_equivalence_20261014_194640_7ea7700c/summary.json) | 历史验证记录/固定输入/采集资料；对应版本和实际结果须看同目录清单。 |
| [verification/timing-20261014/watchdog_equivalence_20261014_194715_03d4ed52/compile.console.log](../../verification/timing-20261014/watchdog_equivalence_20261014_194715_03d4ed52/compile.console.log) | 历史验证记录/固定输入/采集资料；对应版本和实际结果须看同目录清单。 |
| [verification/timing-20261014/watchdog_equivalence_20261014_194715_03d4ed52/compile.log](../../verification/timing-20261014/watchdog_equivalence_20261014_194715_03d4ed52/compile.log) | 历史验证记录/固定输入/采集资料；对应版本和实际结果须看同目录清单。 |
| [verification/timing-20261014/watchdog_equivalence_20261014_194715_03d4ed52/oracle_negative.console.log](../../verification/timing-20261014/watchdog_equivalence_20261014_194715_03d4ed52/oracle_negative.console.log) | 历史验证记录/固定输入/采集资料；对应版本和实际结果须看同目录清单。 |
| [verification/timing-20261014/watchdog_equivalence_20261014_194715_03d4ed52/oracle_negative.log](../../verification/timing-20261014/watchdog_equivalence_20261014_194715_03d4ed52/oracle_negative.log) | 历史验证记录/固定输入/采集资料；对应版本和实际结果须看同目录清单。 |
| [verification/timing-20261014/watchdog_equivalence_20261014_194715_03d4ed52/seed_123456789.console.log](../../verification/timing-20261014/watchdog_equivalence_20261014_194715_03d4ed52/seed_123456789.console.log) | 历史验证记录/固定输入/采集资料；对应版本和实际结果须看同目录清单。 |
| [verification/timing-20261014/watchdog_equivalence_20261014_194715_03d4ed52/seed_123456789.log](../../verification/timing-20261014/watchdog_equivalence_20261014_194715_03d4ed52/seed_123456789.log) | 历史验证记录/固定输入/采集资料；对应版本和实际结果须看同目录清单。 |
| [verification/timing-20261014/watchdog_equivalence_20261014_194715_03d4ed52/seed_734921.console.log](../../verification/timing-20261014/watchdog_equivalence_20261014_194715_03d4ed52/seed_734921.console.log) | 历史验证记录/固定输入/采集资料；对应版本和实际结果须看同目录清单。 |
| [verification/timing-20261014/watchdog_equivalence_20261014_194715_03d4ed52/seed_734921.log](../../verification/timing-20261014/watchdog_equivalence_20261014_194715_03d4ed52/seed_734921.log) | 历史验证记录/固定输入/采集资料；对应版本和实际结果须看同目录清单。 |
| [verification/timing-20261014/watchdog_equivalence_20261014_194715_03d4ed52/seed_94177.console.log](../../verification/timing-20261014/watchdog_equivalence_20261014_194715_03d4ed52/seed_94177.console.log) | 历史验证记录/固定输入/采集资料；对应版本和实际结果须看同目录清单。 |
| [verification/timing-20261014/watchdog_equivalence_20261014_194715_03d4ed52/seed_94177.log](../../verification/timing-20261014/watchdog_equivalence_20261014_194715_03d4ed52/seed_94177.log) | 历史验证记录/固定输入/采集资料；对应版本和实际结果须看同目录清单。 |
| [verification/timing-20261014/watchdog_equivalence_20261014_194715_03d4ed52/summary.json](../../verification/timing-20261014/watchdog_equivalence_20261014_194715_03d4ed52/summary.json) | 历史验证记录/固定输入/采集资料；对应版本和实际结果须看同目录清单。 |
| [verification/timing-margin-20261014/README.md](../../verification/timing-margin-20261014/README.md) | 历史验证记录/固定输入/采集资料；对应版本和实际结果须看同目录清单。 |
| [verification/timing-margin-20261014/build_payload-select_20261014_200315_8e6fbc97/build-results.json](../../verification/timing-margin-20261014/build_payload-select_20261014_200315_8e6fbc97/build-results.json) | 历史验证记录/固定输入/采集资料；对应版本和实际结果须看同目录清单。 |
| [verification/timing-margin-20261014/build_payload-select_20261014_200315_8e6fbc97/full/impl/pnr/ContestFull.rpt.html](../../verification/timing-margin-20261014/build_payload-select_20261014_200315_8e6fbc97/full/impl/pnr/ContestFull.rpt.html) | Gowin自动生成的引脚/资源/时序HTML报告，不是运行程序；内容只对应该目录的构建版本。 |
| [verification/timing-margin-20261014/build_payload-select_20261014_200315_8e6fbc97/full/impl/pnr/ContestFull.rpt.txt](../../verification/timing-margin-20261014/build_payload-select_20261014_200315_8e6fbc97/full/impl/pnr/ContestFull.rpt.txt) | 历史验证记录/固定输入/采集资料；对应版本和实际结果须看同目录清单。 |
| [verification/timing-margin-20261014/build_payload-select_20261014_200315_8e6fbc97/full/impl/pnr/ContestFull.tr](../../verification/timing-margin-20261014/build_payload-select_20261014_200315_8e6fbc97/full/impl/pnr/ContestFull.tr) | 历史验证记录/固定输入/采集资料；对应版本和实际结果须看同目录清单。 |
| [verification/timing-margin-20261014/build_payload-select_20261014_200315_8e6fbc97/full/impl/pnr/ContestFull.tr.html](../../verification/timing-margin-20261014/build_payload-select_20261014_200315_8e6fbc97/full/impl/pnr/ContestFull.tr.html) | Gowin自动生成的引脚/资源/时序HTML报告，不是运行程序；内容只对应该目录的构建版本。 |
| [verification/timing-margin-20261014/build_payload-select_20261014_200315_8e6fbc97/full/impl/pnr/ContestFull_tr_cata.html](../../verification/timing-margin-20261014/build_payload-select_20261014_200315_8e6fbc97/full/impl/pnr/ContestFull_tr_cata.html) | Gowin自动生成的引脚/资源/时序HTML报告，不是运行程序；内容只对应该目录的构建版本。 |
| [verification/timing-margin-20261014/build_payload-select_20261014_200315_8e6fbc97/full/impl/pnr/ContestFull_tr_content.html](../../verification/timing-margin-20261014/build_payload-select_20261014_200315_8e6fbc97/full/impl/pnr/ContestFull_tr_content.html) | Gowin自动生成的引脚/资源/时序HTML报告，不是运行程序；内容只对应该目录的构建版本。 |
| [verification/timing-margin-20261014/build_payload-select_20261014_200315_8e6fbc97/gowin-build.exit.txt](../../verification/timing-margin-20261014/build_payload-select_20261014_200315_8e6fbc97/gowin-build.exit.txt) | 历史验证记录/固定输入/采集资料；对应版本和实际结果须看同目录清单。 |
| [verification/timing-margin-20261014/build_payload-select_20261014_200315_8e6fbc97/gowin-build.log](../../verification/timing-margin-20261014/build_payload-select_20261014_200315_8e6fbc97/gowin-build.log) | 历史验证记录/固定输入/采集资料；对应版本和实际结果须看同目录清单。 |
| [verification/timing-margin-20261014/build_payload-select_20261014_200315_8e6fbc97/gprj-dependencies.json](../../verification/timing-margin-20261014/build_payload-select_20261014_200315_8e6fbc97/gprj-dependencies.json) | 历史验证记录/固定输入/采集资料；对应版本和实际结果须看同目录清单。 |
| [verification/timing-margin-20261014/build_payload-select_20261014_200315_8e6fbc97/protected-impl-after.json](../../verification/timing-margin-20261014/build_payload-select_20261014_200315_8e6fbc97/protected-impl-after.json) | 历史验证记录/固定输入/采集资料；对应版本和实际结果须看同目录清单。 |
| [verification/timing-margin-20261014/build_payload-select_20261014_200315_8e6fbc97/protected-impl-before.json](../../verification/timing-margin-20261014/build_payload-select_20261014_200315_8e6fbc97/protected-impl-before.json) | 历史验证记录/固定输入/采集资料；对应版本和实际结果须看同目录清单。 |
| [verification/timing-margin-20261014/build_payload-select_20261014_200315_8e6fbc97/snapshot-inputs-after.json](../../verification/timing-margin-20261014/build_payload-select_20261014_200315_8e6fbc97/snapshot-inputs-after.json) | 历史验证记录/固定输入/采集资料；对应版本和实际结果须看同目录清单。 |
| [verification/timing-margin-20261014/build_payload-select_20261014_200315_8e6fbc97/snapshot-inputs.json](../../verification/timing-margin-20261014/build_payload-select_20261014_200315_8e6fbc97/snapshot-inputs.json) | 历史验证记录/固定输入/采集资料；对应版本和实际结果须看同目录清单。 |
| [verification/timing-margin-20261014/build_payload-select_20261014_200315_8e6fbc97/snapshot-metadata.json](../../verification/timing-margin-20261014/build_payload-select_20261014_200315_8e6fbc97/snapshot-metadata.json) | 历史验证记录/固定输入/采集资料；对应版本和实际结果须看同目录清单。 |
| [verification/timing-margin-20261014/build_payload-select_20261014_200315_8e6fbc97/warning-comparison.json](../../verification/timing-margin-20261014/build_payload-select_20261014_200315_8e6fbc97/warning-comparison.json) | 历史验证记录/固定输入/采集资料；对应版本和实际结果须看同目录清单。 |
| [verification/timing-margin-20261014/build_scalar-nonempty_20261014_194501_f7aeeb65/build-results.json](../../verification/timing-margin-20261014/build_scalar-nonempty_20261014_194501_f7aeeb65/build-results.json) | 历史验证记录/固定输入/采集资料；对应版本和实际结果须看同目录清单。 |
| [verification/timing-margin-20261014/build_scalar-nonempty_20261014_194501_f7aeeb65/gowin-build.exit.txt](../../verification/timing-margin-20261014/build_scalar-nonempty_20261014_194501_f7aeeb65/gowin-build.exit.txt) | 历史验证记录/固定输入/采集资料；对应版本和实际结果须看同目录清单。 |
| [verification/timing-margin-20261014/build_scalar-nonempty_20261014_194501_f7aeeb65/gowin-build.log](../../verification/timing-margin-20261014/build_scalar-nonempty_20261014_194501_f7aeeb65/gowin-build.log) | 历史验证记录/固定输入/采集资料；对应版本和实际结果须看同目录清单。 |
| [verification/timing-margin-20261014/build_scalar-nonempty_20261014_194501_f7aeeb65/gprj-dependencies.json](../../verification/timing-margin-20261014/build_scalar-nonempty_20261014_194501_f7aeeb65/gprj-dependencies.json) | 历史验证记录/固定输入/采集资料；对应版本和实际结果须看同目录清单。 |
| [verification/timing-margin-20261014/build_scalar-nonempty_20261014_194501_f7aeeb65/protected-impl-after.json](../../verification/timing-margin-20261014/build_scalar-nonempty_20261014_194501_f7aeeb65/protected-impl-after.json) | 历史验证记录/固定输入/采集资料；对应版本和实际结果须看同目录清单。 |
| [verification/timing-margin-20261014/build_scalar-nonempty_20261014_194501_f7aeeb65/protected-impl-before.json](../../verification/timing-margin-20261014/build_scalar-nonempty_20261014_194501_f7aeeb65/protected-impl-before.json) | 历史验证记录/固定输入/采集资料；对应版本和实际结果须看同目录清单。 |
| [verification/timing-margin-20261014/build_scalar-nonempty_20261014_194501_f7aeeb65/snapshot-inputs-after.json](../../verification/timing-margin-20261014/build_scalar-nonempty_20261014_194501_f7aeeb65/snapshot-inputs-after.json) | 历史验证记录/固定输入/采集资料；对应版本和实际结果须看同目录清单。 |
| [verification/timing-margin-20261014/build_scalar-nonempty_20261014_194501_f7aeeb65/snapshot-inputs.json](../../verification/timing-margin-20261014/build_scalar-nonempty_20261014_194501_f7aeeb65/snapshot-inputs.json) | 历史验证记录/固定输入/采集资料；对应版本和实际结果须看同目录清单。 |
| [verification/timing-margin-20261014/build_scalar-nonempty_20261014_194501_f7aeeb65/snapshot-metadata.json](../../verification/timing-margin-20261014/build_scalar-nonempty_20261014_194501_f7aeeb65/snapshot-metadata.json) | 历史验证记录/固定输入/采集资料；对应版本和实际结果须看同目录清单。 |
| [verification/timing-margin-20261014/compare-build-warnings.py](../../verification/timing-margin-20261014/compare-build-warnings.py) | 比较优化前后构建警告，防止仅看通过标志漏掉新增问题；历史专项材料，不等于当前版本已重新运行。 |
| [verification/timing-margin-20261014/modelsim_payload_select/run_20261014_200705_ffd383c2/inputs.json](../../verification/timing-margin-20261014/modelsim_payload_select/run_20261014_200705_ffd383c2/inputs.json) | 历史验证记录/固定输入/采集资料；对应版本和实际结果须看同目录清单。 |
| [verification/timing-margin-20261014/modelsim_payload_select/run_20261014_200705_ffd383c2/logs/audio_engine_n4.console.log](../../verification/timing-margin-20261014/modelsim_payload_select/run_20261014_200705_ffd383c2/logs/audio_engine_n4.console.log) | 历史验证记录/固定输入/采集资料；对应版本和实际结果须看同目录清单。 |
| [verification/timing-margin-20261014/modelsim_payload_select/run_20261014_200705_ffd383c2/logs/audio_engine_n4.exitcode](../../verification/timing-margin-20261014/modelsim_payload_select/run_20261014_200705_ffd383c2/logs/audio_engine_n4.exitcode) | 历史验证记录/固定输入/采集资料；对应版本和实际结果须看同目录清单。 |
| [verification/timing-margin-20261014/modelsim_payload_select/run_20261014_200705_ffd383c2/logs/audio_engine_n4.log](../../verification/timing-margin-20261014/modelsim_payload_select/run_20261014_200705_ffd383c2/logs/audio_engine_n4.log) | 历史验证记录/固定输入/采集资料；对应版本和实际结果须看同目录清单。 |
| [verification/timing-margin-20261014/modelsim_payload_select/run_20261014_200705_ffd383c2/logs/audio_i2s.console.log](../../verification/timing-margin-20261014/modelsim_payload_select/run_20261014_200705_ffd383c2/logs/audio_i2s.console.log) | 历史验证记录/固定输入/采集资料；对应版本和实际结果须看同目录清单。 |
| [verification/timing-margin-20261014/modelsim_payload_select/run_20261014_200705_ffd383c2/logs/audio_i2s.log](../../verification/timing-margin-20261014/modelsim_payload_select/run_20261014_200705_ffd383c2/logs/audio_i2s.log) | 历史验证记录/固定输入/采集资料；对应版本和实际结果须看同目录清单。 |
| [verification/timing-margin-20261014/modelsim_payload_select/run_20261014_200705_ffd383c2/logs/audio_monitor_cdc.console.log](../../verification/timing-margin-20261014/modelsim_payload_select/run_20261014_200705_ffd383c2/logs/audio_monitor_cdc.console.log) | 历史验证记录/固定输入/采集资料；对应版本和实际结果须看同目录清单。 |
| [verification/timing-margin-20261014/modelsim_payload_select/run_20261014_200705_ffd383c2/logs/audio_monitor_cdc.exitcode](../../verification/timing-margin-20261014/modelsim_payload_select/run_20261014_200705_ffd383c2/logs/audio_monitor_cdc.exitcode) | 历史验证记录/固定输入/采集资料；对应版本和实际结果须看同目录清单。 |
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
| [verification/timing-margin-20261014/modelsim_payload_select_resume/run_20261014_213338_49354631/logs/ws2812_reject_zero.log](../../verification/timing-margin-20261014/modelsim_payload_select_resume/run_20261014_213338_49354631/logs/ws2812_reject_zero.log) | 历史验证记录/固定输入/采集资料；对应版本和实际结果须看同目录清单。 |
| [verification/timing-margin-20261014/modelsim_payload_select_resume/run_20261014_213338_49354631/manifest.json](../../verification/timing-margin-20261014/modelsim_payload_select_resume/run_20261014_213338_49354631/manifest.json) | 历史验证记录/固定输入/采集资料；对应版本和实际结果须看同目录清单。 |
| [verification/timing-margin-20261014/modelsim_payload_select_resume/run_20261014_213338_49354631/test-summary.json](../../verification/timing-margin-20261014/modelsim_payload_select_resume/run_20261014_213338_49354631/test-summary.json) | 历史验证记录/固定输入/采集资料；对应版本和实际结果须看同目录清单。 |
| [verification/timing-margin-20261014/promotion.json](../../verification/timing-margin-20261014/promotion.json) | 历史验证记录/固定输入/采集资料；对应版本和实际结果须看同目录清单。 |
| [verification/timing-margin-20261014/selected-release.json](../../verification/timing-margin-20261014/selected-release.json) | 历史验证记录/固定输入/采集资料；对应版本和实际结果须看同目录清单。 |
| [verification/timing-margin-20261014/verify-selected-release.py](../../verification/timing-margin-20261014/verify-selected-release.py) | 核对历史选定交付输入、时序报告与位流一致性；历史专项材料，不等于当前版本已重新运行。 |
| [verification/uart-live-debug-20261023/README-observation.md](../../verification/uart-live-debug-20261023/README-observation.md) | 历史验证记录/固定输入/采集资料；对应版本和实际结果须看同目录清单。 |
| [verification/uart-live-debug-20261023/RUN-STATUS.md](../../verification/uart-live-debug-20261023/RUN-STATUS.md) | 历史验证记录/固定输入/采集资料；对应版本和实际结果须看同目录清单。 |
| [verification/uart-live-debug-20261023/baseline-inputs.json](../../verification/uart-live-debug-20261023/baseline-inputs.json) | 历史验证记录/固定输入/采集资料；对应版本和实际结果须看同目录清单。 |
| [verification/uart-live-debug-20261023/baseline_remote_uart_transport.sv](../../verification/uart-live-debug-20261023/baseline_remote_uart_transport.sv) | UART观测修改前的冻结通信RTL参考；历史专项材料，不等于当前版本已重新运行。 |
| [verification/uart-live-debug-20261023/c3-tx-observation-audit/copied-header.diff](../../verification/uart-live-debug-20261023/c3-tx-observation-audit/copied-header.diff) | 历史验证记录/固定输入/采集资料；对应版本和实际结果须看同目录清单。 |
| [verification/uart-live-debug-20261023/c3-tx-observation-audit/isr-disassembly.txt](../../verification/uart-live-debug-20261023/c3-tx-observation-audit/isr-disassembly.txt) | 历史验证记录/固定输入/采集资料；对应版本和实际结果须看同目录清单。 |
| [verification/uart-live-debug-20261023/c3-tx-observation-audit/result.json](../../verification/uart-live-debug-20261023/c3-tx-observation-audit/result.json) | 历史验证记录/固定输入/采集资料；对应版本和实际结果须看同目录清单。 |
| [verification/uart-live-debug-20261023/c3-tx-observation-audit/sections.txt](../../verification/uart-live-debug-20261023/c3-tx-observation-audit/sections.txt) | 历史验证记录/固定输入/采集资料；对应版本和实际结果须看同目录清单。 |
| [verification/uart-live-debug-20261023/c3-tx-observation-audit/selected-symbols.json](../../verification/uart-live-debug-20261023/c3-tx-observation-audit/selected-symbols.json) | 历史验证记录/固定输入/采集资料；对应版本和实际结果须看同目录清单。 |
| [verification/uart-live-debug-20261023/c3-tx-observation-build.log](../../verification/uart-live-debug-20261023/c3-tx-observation-build.log) | 历史验证记录/固定输入/采集资料；对应版本和实际结果须看同目录清单。 |
| [verification/uart-live-debug-20261023/c3-tx-observation-source/README.md](../../verification/uart-live-debug-20261023/c3-tx-observation-source/README.md) | 历史验证记录/固定输入/采集资料；对应版本和实际结果须看同目录清单。 |
| [verification/uart-live-debug-20261023/c3-tx-observation-source/ble_bridge.ino.diff](../../verification/uart-live-debug-20261023/c3-tx-observation-source/ble_bridge.ino.diff) | 历史验证记录/固定输入/采集资料；对应版本和实际结果须看同目录清单。 |
| [verification/uart-live-debug-20261023/c3-tx-observation-source/ble_bridge/ble_bridge.ino](../../verification/uart-live-debug-20261023/c3-tx-observation-source/ble_bridge/ble_bridge.ino) | C3实际UART发送观察版冻结副本，用于定位BLE到串口路径，不是当前默认固件。ESP32-C3 BLE↔UART透明桥，处理会话、队列、故障和统计；不合成音频，不生成曲谱事件，也不替FPGA重复执行命令。 |
| [verification/uart-live-debug-20261023/c3-tx-observation-source/ble_bridge/bridge_uart_io.h](../../verification/uart-live-debug-20261023/c3-tx-observation-source/ble_bridge/bridge_uart_io.h) | C3实际UART发送观察版冻结副本，用于定位BLE到串口路径，不是当前默认固件。基于IDF UART检查实际写入/超时，避免上层接口无条件返回成功导致丢包。 |
| [verification/uart-live-debug-20261023/c3-tx-observation-source/bridge_uart_io.h.diff](../../verification/uart-live-debug-20261023/c3-tx-observation-source/bridge_uart_io.h.diff) | 历史验证记录/固定输入/采集资料；对应版本和实际结果须看同目录清单。 |
| [verification/uart-live-debug-20261023/c3-tx-observation-source/source-audit.json](../../verification/uart-live-debug-20261023/c3-tx-observation-source/source-audit.json) | 历史验证记录/固定输入/采集资料；对应版本和实际结果须看同目录清单。 |
| [verification/uart-live-debug-20261023/capture-before/main_status_core0.csv](../../verification/uart-live-debug-20261023/capture-before/main_status_core0.csv) | 历史验证记录/固定输入/采集资料；对应版本和实际结果须看同目录清单。 |
| [verification/uart-live-debug-20261023/capture-before/result.json](../../verification/uart-live-debug-20261023/capture-before/result.json) | 历史验证记录/固定输入/采集资料；对应版本和实际结果须看同目录清单。 |
| [verification/uart-live-debug-20261023/decode_uart_gao.py](../../verification/uart-live-debug-20261023/decode_uart_gao.py) | 只读解码GAO采集的UART串行位与通信帧；历史专项材料，不等于当前版本已重新运行。 |
| [verification/uart-live-debug-20261023/decoder-tests.log](../../verification/uart-live-debug-20261023/decoder-tests.log) | 历史验证记录/固定输入/采集资料；对应版本和实际结果须看同目录清单。 |
| [verification/uart-live-debug-20261023/fpga-after.log](../../verification/uart-live-debug-20261023/fpga-after.log) | 历史验证记录/固定输入/采集资料；对应版本和实际结果须看同目录清单。 |
| [verification/uart-live-debug-20261023/fpga-before.log](../../verification/uart-live-debug-20261023/fpga-before.log) | 历史验证记录/固定输入/采集资料；对应版本和实际结果须看同目录清单。 |
| [verification/uart-live-debug-20261023/fpga-build/build_uart-gao-passive_20261023_225737_4569e195/build-results.json](../../verification/uart-live-debug-20261023/fpga-build/build_uart-gao-passive_20261023_225737_4569e195/build-results.json) | 历史验证记录/固定输入/采集资料；对应版本和实际结果须看同目录清单。 |
| [verification/uart-live-debug-20261023/fpga-build/build_uart-gao-passive_20261023_225737_4569e195/gowin-build.log](../../verification/uart-live-debug-20261023/fpga-build/build_uart-gao-passive_20261023_225737_4569e195/gowin-build.log) | 历史验证记录/固定输入/采集资料；对应版本和实际结果须看同目录清单。 |
| [verification/uart-live-debug-20261023/fpga-build/build_uart-gao-passive_20261023_225737_4569e195/gowin-run.json](../../verification/uart-live-debug-20261023/fpga-build/build_uart-gao-passive_20261023_225737_4569e195/gowin-run.json) | 历史验证记录/固定输入/采集资料；对应版本和实际结果须看同目录清单。 |
| [verification/uart-live-debug-20261023/fpga-build/build_uart-gao-passive_20261023_225737_4569e195/gprj-dependencies.json](../../verification/uart-live-debug-20261023/fpga-build/build_uart-gao-passive_20261023_225737_4569e195/gprj-dependencies.json) | 历史验证记录/固定输入/采集资料；对应版本和实际结果须看同目录清单。 |
| [verification/uart-live-debug-20261023/fpga-build/build_uart-gao-passive_20261023_225737_4569e195/snapshot-inputs.json](../../verification/uart-live-debug-20261023/fpga-build/build_uart-gao-passive_20261023_225737_4569e195/snapshot-inputs.json) | 历史验证记录/固定输入/采集资料；对应版本和实际结果须看同目录清单。 |
| [verification/uart-live-debug-20261023/fpga-sram-program.log](../../verification/uart-live-debug-20261023/fpga-sram-program.log) | 历史验证记录/固定输入/采集资料；对应版本和实际结果须看同目录清单。 |
| [verification/uart-live-debug-20261023/main-status-report.json](../../verification/uart-live-debug-20261023/main-status-report.json) | 历史验证记录/固定输入/采集资料；对应版本和实际结果须看同目录清单。 |
| [verification/uart-live-debug-20261023/main_status_core0.csv](../../verification/uart-live-debug-20261023/main_status_core0.csv) | 历史验证记录/固定输入/采集资料；对应版本和实际结果须看同目录清单。 |
| [verification/uart-live-debug-20261023/observation-preparation-result.json](../../verification/uart-live-debug-20261023/observation-preparation-result.json) | 历史验证记录/固定输入/采集资料；对应版本和实际结果须看同目录清单。 |
| [verification/uart-live-debug-20261023/observation-source/full/ContestFull.gprj](../../verification/uart-live-debug-20261023/observation-source/full/ContestFull.gprj) | 历史验证记录/固定输入/采集资料；对应版本和实际结果须看同目录清单。 |
| [verification/uart-live-debug-20261023/observation-source/full/contest_full.cst](../../verification/uart-live-debug-20261023/observation-source/full/contest_full.cst) | 历史验证记录/固定输入/采集资料；对应版本和实际结果须看同目录清单。 |
| [verification/uart-live-debug-20261023/observation-source/full/contest_full.sdc](../../verification/uart-live-debug-20261023/observation-source/full/contest_full.sdc) | 历史验证记录/固定输入/采集资料；对应版本和实际结果须看同目录清单。 |
| [verification/uart-live-debug-20261023/observation-source/full/main_status.rao](../../verification/uart-live-debug-20261023/observation-source/full/main_status.rao) | 历史验证记录/固定输入/采集资料；对应版本和实际结果须看同目录清单。 |
| [verification/uart-live-debug-20261023/observation-source/rtl/audio/adsr.v](../../verification/uart-live-debug-20261023/observation-source/rtl/audio/adsr.v) | 2026-10-23被动UART观察工程冻结副本，不能与当前主源混用。计算起音、衰减、保持、释放包络及重触发过渡，决定声音随时间如何变响、变弱、结束。 |
| [verification/uart-live-debug-20261023/observation-source/rtl/audio/audio_fx.v](../../verification/uart-live-debug-20261023/observation-source/rtl/audio/audio_fx.v) | 2026-10-23被动UART观察工程冻结副本，不能与当前主源混用。较早的固定立体声反馈延迟，供独立音源示例与回归；完整工程关闭音源内部此支路，另用runtime_audio_fx。 |
| [verification/uart-live-debug-20261023/observation-source/rtl/audio/audio_system_v2.v](../../verification/uart-live-debug-20261023/observation-source/rtl/audio/audio_system_v2.v) | 2026-10-23被动UART观察工程冻结副本，不能与当前主源混用。V2控制、音源与I2S的逻辑集成示例，含干声及固定延迟两个顶层；不含当前整机全部外围。 |
| [verification/uart-live-debug-20261023/observation-source/rtl/audio/audio_system_v2_fm.v](../../verification/uart-live-debug-20261023/observation-source/rtl/audio/audio_system_v2_fm.v) | 2026-10-23被动UART观察工程冻结副本，不能与当前主源混用。可选FM音色的独立V2音频集成示例。 |
| [verification/uart-live-debug-20261023/observation-source/rtl/audio/dds_lane.v](../../verification/uart-live-debug-20261023/observation-source/rtl/audio/dds_lane.v) | 2026-10-23被动UART观察工程冻结副本，不能与当前主源混用。32位相位累加器及频率控制字运算，产生波表地址；相位回绕形成周期振荡。 |
| [verification/uart-live-debug-20261023/observation-source/rtl/audio/fm_piano_lane.v](../../verification/uart-live-debug-20261023/observation-source/rtl/audio/fm_piano_lane.v) | 2026-10-23被动UART观察工程冻结副本，不能与当前主源混用。可切换的双运算器FM音色计算通道，保留为另一种声音；不是当前八成分钢琴的替代实现。 |
| [verification/uart-live-debug-20261023/observation-source/rtl/audio/gain_saturator.v](../../verification/uart-live-debug-20261023/observation-source/rtl/audio/gain_saturator.v) | 2026-10-23被动UART观察工程冻结副本，不能与当前主源混用。应用Q1.11增益、混音缩放并饱和到24位，防止数值溢出回绕；自动余量策略仍沿用原算法。 |
| [verification/uart-live-debug-20261023/observation-source/rtl/audio/pitch_expression.v](../../verification/uart-live-debug-20261023/observation-source/rtl/audio/pitch_expression.v) | 2026-10-23被动UART观察工程冻结副本，不能与当前主源混用。对增益、弯音、颤音深度作逐帧平滑；查音高比例表，全局低频振荡器每采样帧只推进一次。 |
| [verification/uart-live-debug-20261023/observation-source/rtl/audio/polar_lane.v](../../verification/uart-live-debug-20261023/observation-source/rtl/audio/polar_lane.v) | 2026-10-23被动UART观察工程冻结副本，不能与当前主源混用。八成分钢琴的计算通道之一：每通道分时处理4个分量，两通道合计8个；读取幅度/相位参数并保存分量状态，减少原I/Q运算占用。 |
| [verification/uart-live-debug-20261023/observation-source/rtl/audio/rom/midi.hex](../../verification/uart-live-debug-20261023/observation-source/rtl/audio/rom/midi.hex) | 历史验证记录/固定输入/采集资料；对应版本和实际结果须看同目录清单。 |
| [verification/uart-live-debug-20261023/observation-source/rtl/audio/rom/piano.hex](../../verification/uart-live-debug-20261023/observation-source/rtl/audio/rom/piano.hex) | 历史验证记录/固定输入/采集资料；对应版本和实际结果须看同目录清单。 |
| [verification/uart-live-debug-20261023/observation-source/rtl/audio/rom/polar_lane0.hex](../../verification/uart-live-debug-20261023/observation-source/rtl/audio/rom/polar_lane0.hex) | 历史验证记录/固定输入/采集资料；对应版本和实际结果须看同目录清单。 |
| [verification/uart-live-debug-20261023/observation-source/rtl/audio/rom/polar_lane1.hex](../../verification/uart-live-debug-20261023/observation-source/rtl/audio/rom/polar_lane1.hex) | 历史验证记录/固定输入/采集资料；对应版本和实际结果须看同目录清单。 |
| [verification/uart-live-debug-20261023/observation-source/rtl/audio/rom/polar_ratios.hex](../../verification/uart-live-debug-20261023/observation-source/rtl/audio/rom/polar_ratios.hex) | 历史验证记录/固定输入/采集资料；对应版本和实际结果须看同目录清单。 |
| [verification/uart-live-debug-20261023/observation-source/rtl/audio/rom/ratio.hex](../../verification/uart-live-debug-20261023/observation-source/rtl/audio/rom/ratio.hex) | 历史验证记录/固定输入/采集资料；对应版本和实际结果须看同目录清单。 |
| [verification/uart-live-debug-20261023/observation-source/rtl/audio/rom/sine.hex](../../verification/uart-live-debug-20261023/observation-source/rtl/audio/rom/sine.hex) | 历史验证记录/固定输入/采集资料；对应版本和实际结果须看同目录清单。 |
| [verification/uart-live-debug-20261023/observation-source/rtl/audio/rom/velocity.hex](../../verification/uart-live-debug-20261023/observation-source/rtl/audio/rom/velocity.hex) | 历史验证记录/固定输入/采集资料；对应版本和实际结果须看同目录清单。 |
| [verification/uart-live-debug-20261023/observation-source/rtl/audio/rom/waves.hex](../../verification/uart-live-debug-20261023/observation-source/rtl/audio/rom/waves.hex) | 历史验证记录/固定输入/采集资料；对应版本和实际结果须看同目录清单。 |
| [verification/uart-live-debug-20261023/observation-source/rtl/audio/runtime_audio_fx.v](../../verification/uart-live-debug-20261023/observation-source/rtl/audio/runtime_audio_fx.v) | 2026-10-23被动UART观察工程冻结副本，不能与当前主源混用。完整工程运行时干声、延迟、混响、合唱；共享历史RAM，处理切换清空与输出反压。 |
| [verification/uart-live-debug-20261023/observation-source/rtl/audio/stereo_mixer.v](../../verification/uart-live-debug-20261023/observation-source/rtl/audio/stereo_mixer.v) | 2026-10-23被动UART观察工程冻结副本，不能与当前主源混用。将各声部的当前样本按声像累加为左右声道；使用扩展位宽，64声部最终仍是两路PCM。 |
| [verification/uart-live-debug-20261023/observation-source/rtl/audio/voice_engine.v](../../verification/uart-live-debug-20261023/observation-source/rtl/audio/voice_engine.v) | 2026-10-23被动UART观察工程冻结副本，不能与当前主源混用。音源主调度器：逐帧扫描声部，执行DDS/钢琴/FM、ADSR、力度和混音，输出左右24位PCM；遵守cmd/done/sample握手。 |
| [verification/uart-live-debug-20261023/observation-source/rtl/audio/voice_state_ram.v](../../verification/uart-live-debug-20261023/observation-source/rtl/audio/voice_state_ram.v) | 2026-10-23被动UART观察工程冻结副本，不能与当前主源混用。保存各声部独立相位、频率、包络、音色等状态；用同步RAM代替大量分散寄存器。 |
| [verification/uart-live-debug-20261023/observation-source/rtl/audio/wavetable_rom.v](../../verification/uart-live-debug-20261023/observation-source/rtl/audio/wavetable_rom.v) | 2026-10-23被动UART观察工程冻结副本，不能与当前主源混用。读取数学波形、音高频率字、力度及原钢琴查表数据；其ROM不是整段演奏录音。 |
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
