wujijun11/git/TangMega60K_Synth/desktop/assets/neon.png

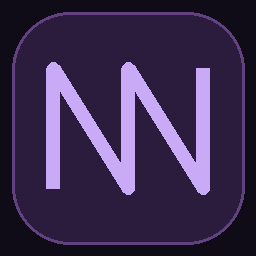
TangMega60K_Synth/desktop/assets/neon.png
