wujijun11/git/TangMega60K_Synth/docs/reports/menu-hierarchy-20261028/menu-preview/menu_06.png

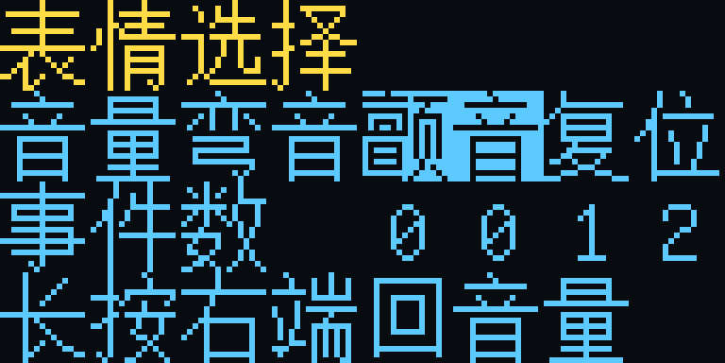
TangMega60K_Synth/docs/reports/menu-hierarchy-20261028/menu-preview/menu_06.png
