wujijun11/git/TangMega60K_Synth/docs/reports/menu-hierarchy-20261028/wave-preview/OLED真实音频波形_仿真像素.png

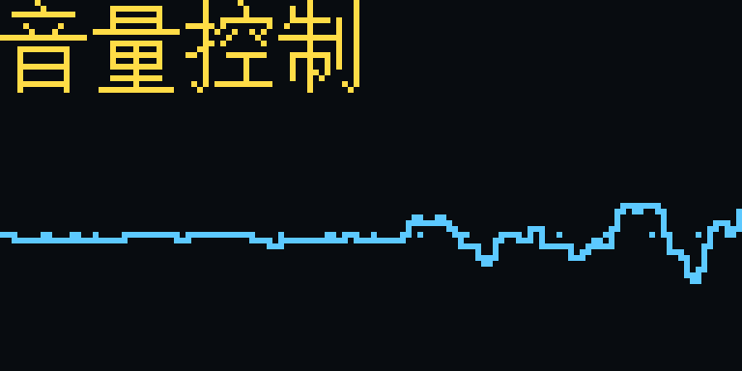
TangMega60K_Synth/docs/reports/menu-hierarchy-20261028/wave-preview/OLED真实音频波形_仿真像素.png
