wujijun11/git/TangMega60K_Synth/docs/reports/oled-idle-wave-20261027/preview/oled_awake_menu_frame.png

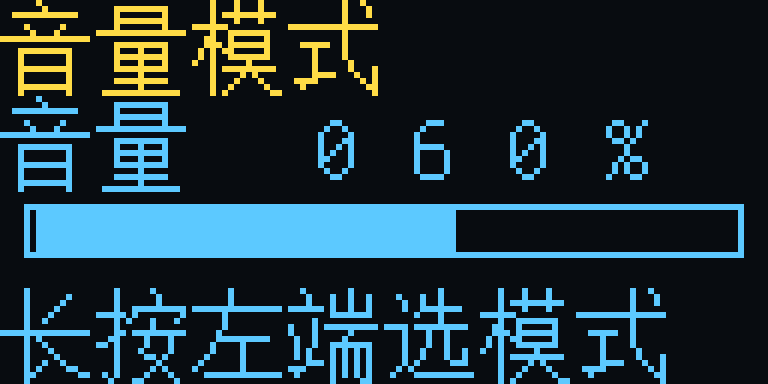
TangMega60K_Synth/docs/reports/oled-idle-wave-20261027/preview/oled_awake_menu_frame.png
