wujijun11/git/TangMega60K_Synth/docs/reports/sustain-20261030/clients/analysis/声音菜单_延音入口.png

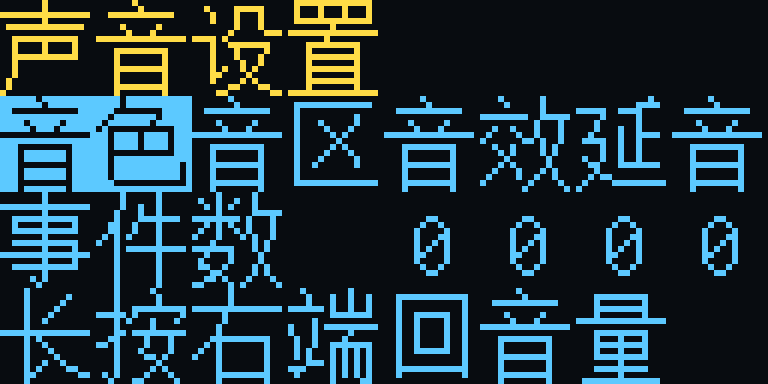
TangMega60K_Synth/docs/reports/sustain-20261030/clients/analysis/声音菜单_延音入口.png
