wujijun11/git/TangMega60K_Synth/docs/reports/sustain-20261030/clients/analysis/延音设置_关闭.png

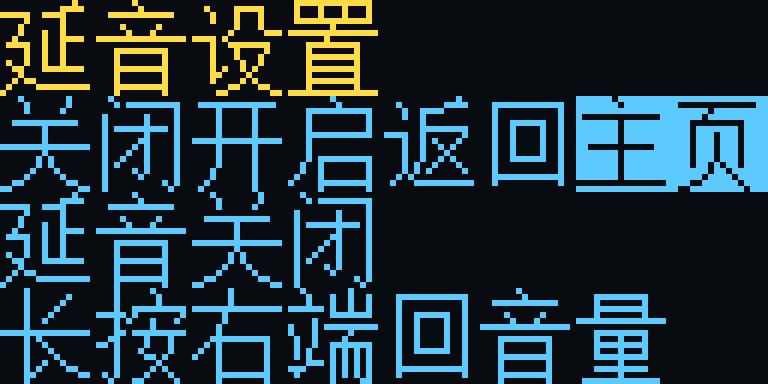
TangMega60K_Synth/docs/reports/sustain-20261030/clients/analysis/延音设置_关闭.png
