wujijun11/git/TangMega60K_Synth/docs/reports/sustain-20261030/clients/browser/Windows延音开关_协议模拟.png

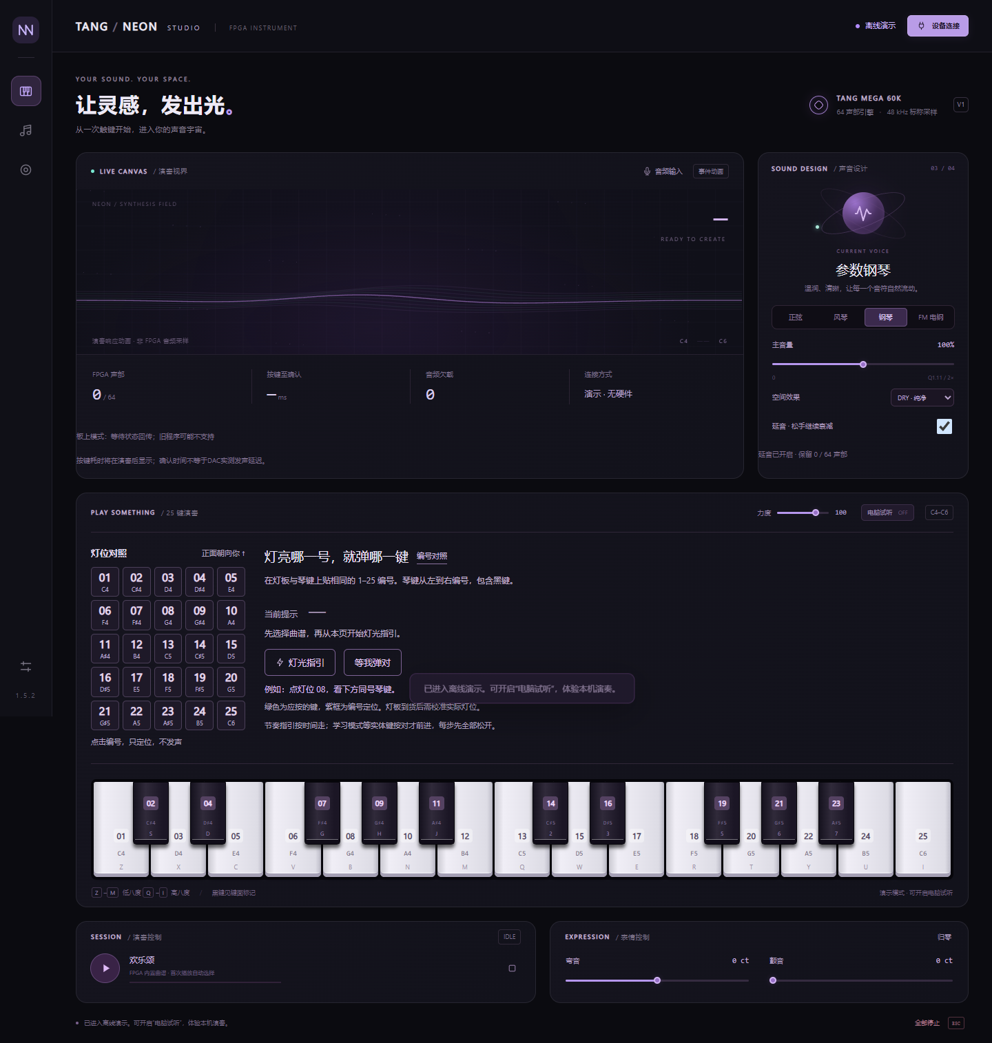
TangMega60K_Synth/docs/reports/sustain-20261030/clients/browser/Windows延音开关_协议模拟.png
