wujijun11/git/TangMega60K_Synth/hardware/ahct125/release/preview/PCB.png

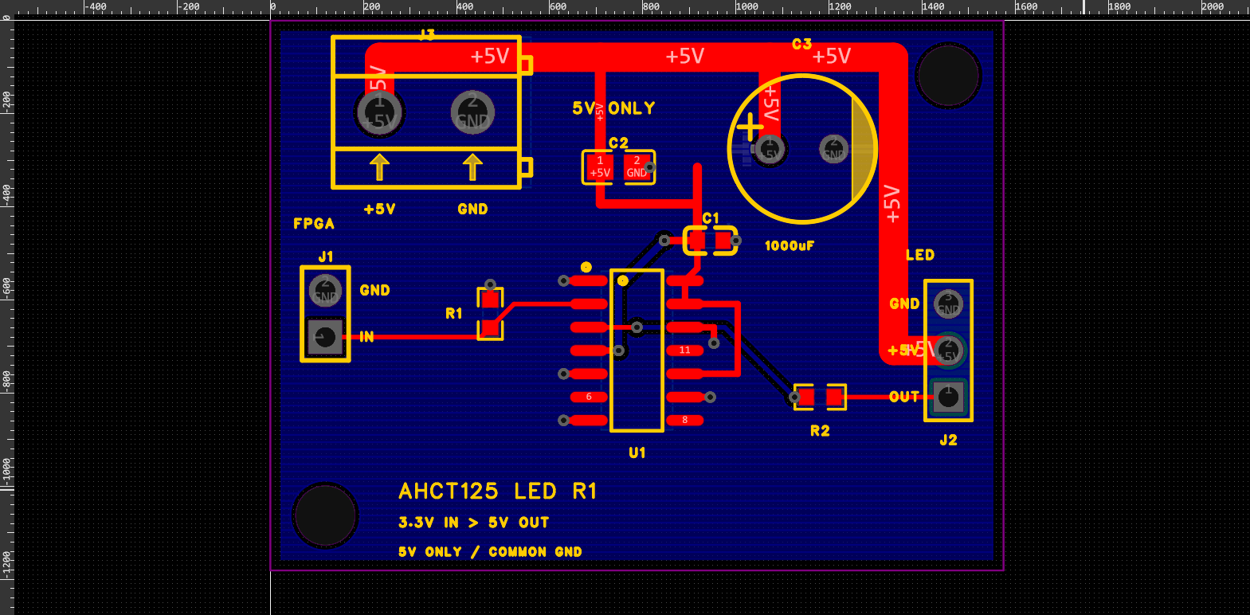
TangMega60K_Synth/hardware/ahct125/release/preview/PCB.png
