wujijun11/git/TangMega60K_Synth/hardware/ahct125/release/preview/Schematic.png

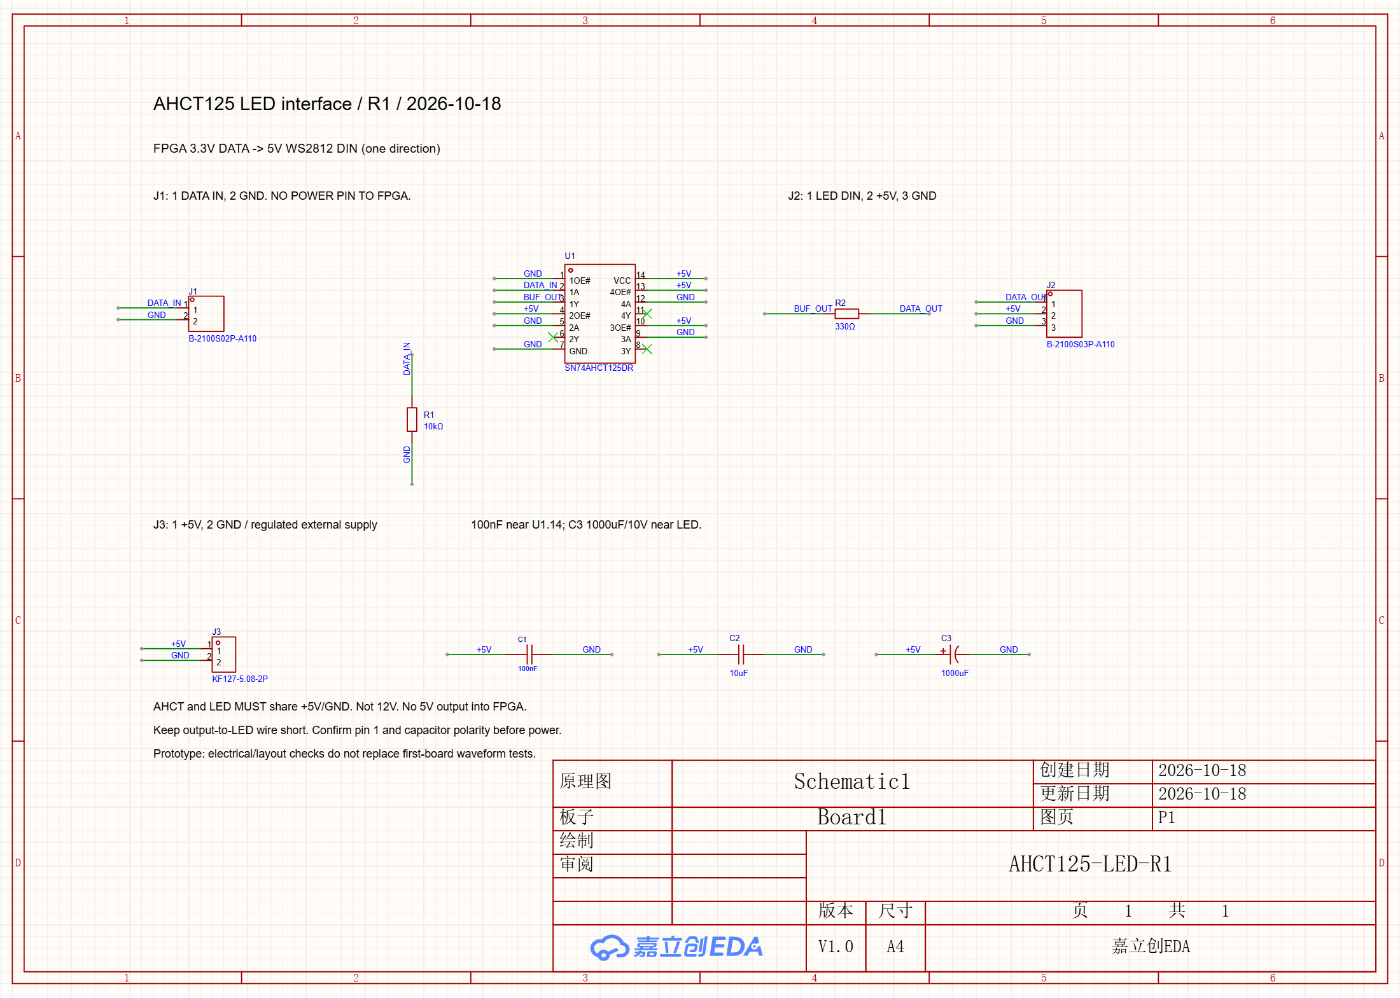
TangMega60K_Synth/hardware/ahct125/release/preview/Schematic.png
