wujijun11/git/TangMega60K_Synth/hardware/slider4/design_overview.png

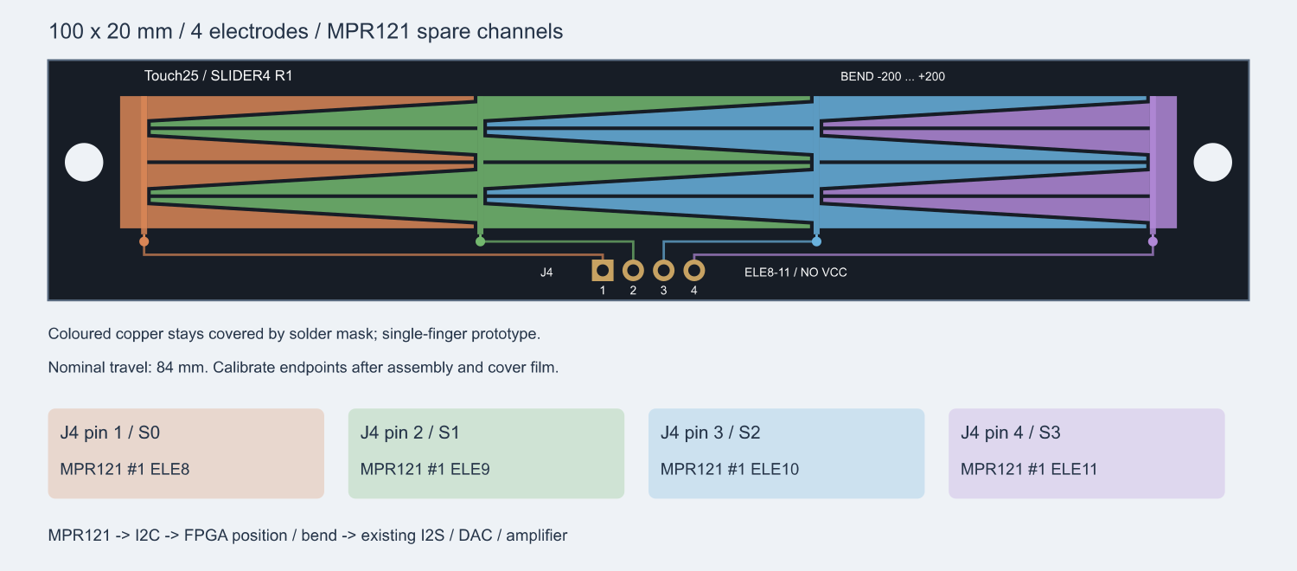
TangMega60K_Synth/hardware/slider4/design_overview.png
