wujijun11/git/TangMega60K_Synth/hardware/slider4/native_drc_pass.jpg

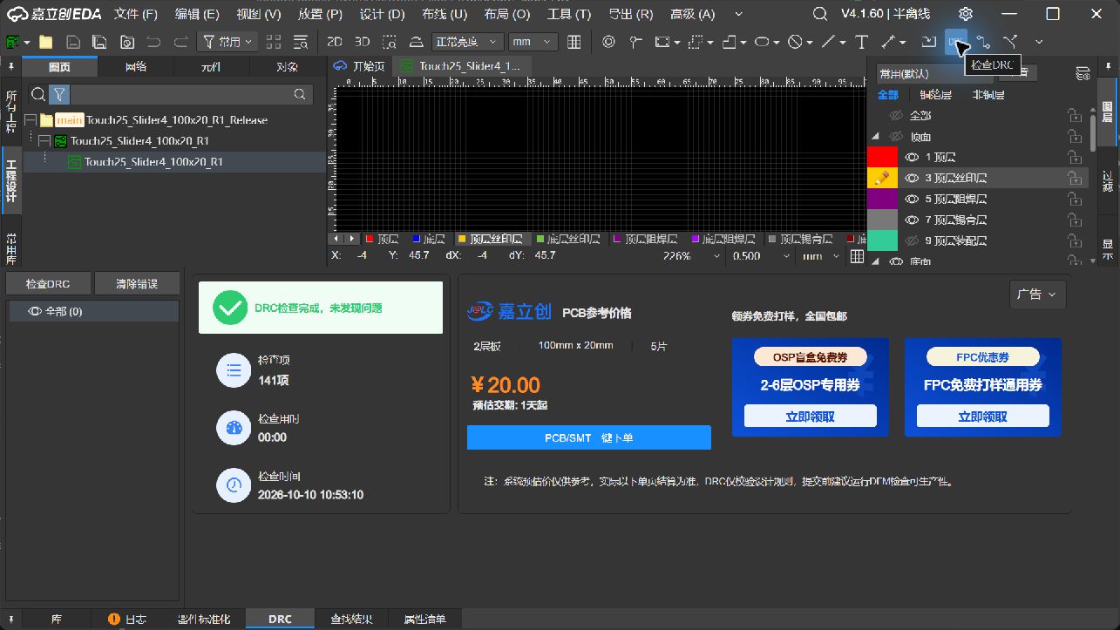
TangMega60K_Synth/hardware/slider4/native_drc_pass.jpg
