wujijun11/git/TangMega60K_Synth/hardware/touch25/bottom_preview.png

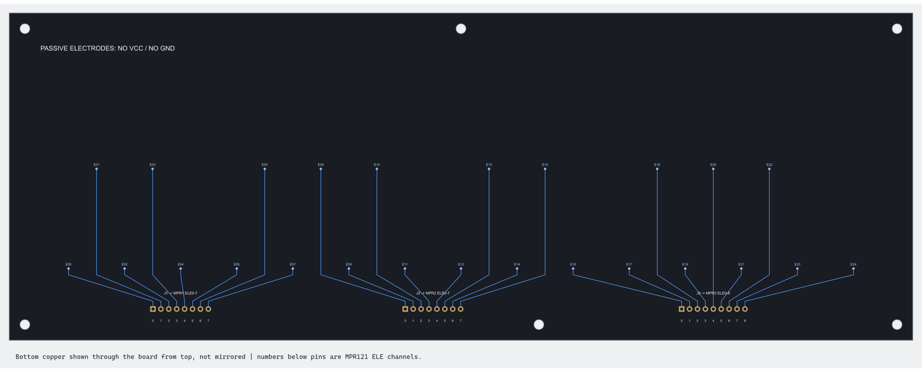
TangMega60K_Synth/hardware/touch25/bottom_preview.png
