wujijun11/git/TangMega60K_Synth/hardware/touch25/design_overview.png

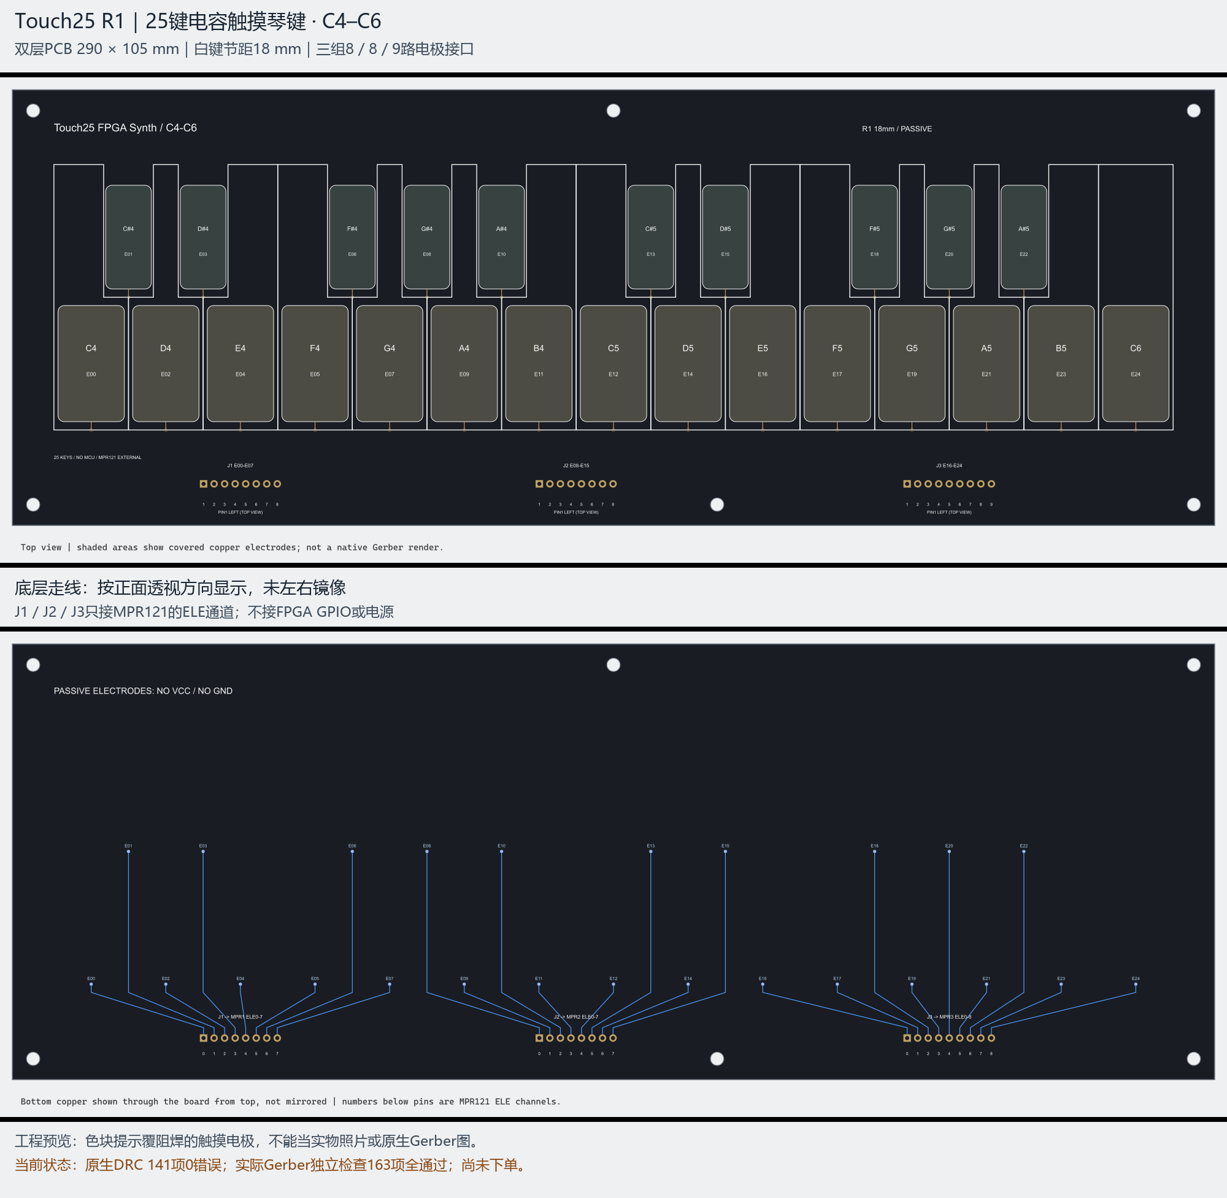
TangMega60K_Synth/hardware/touch25/design_overview.png
