wujijun11/git/TangMega60K_Synth/hardware/touch25/harness_layout.png

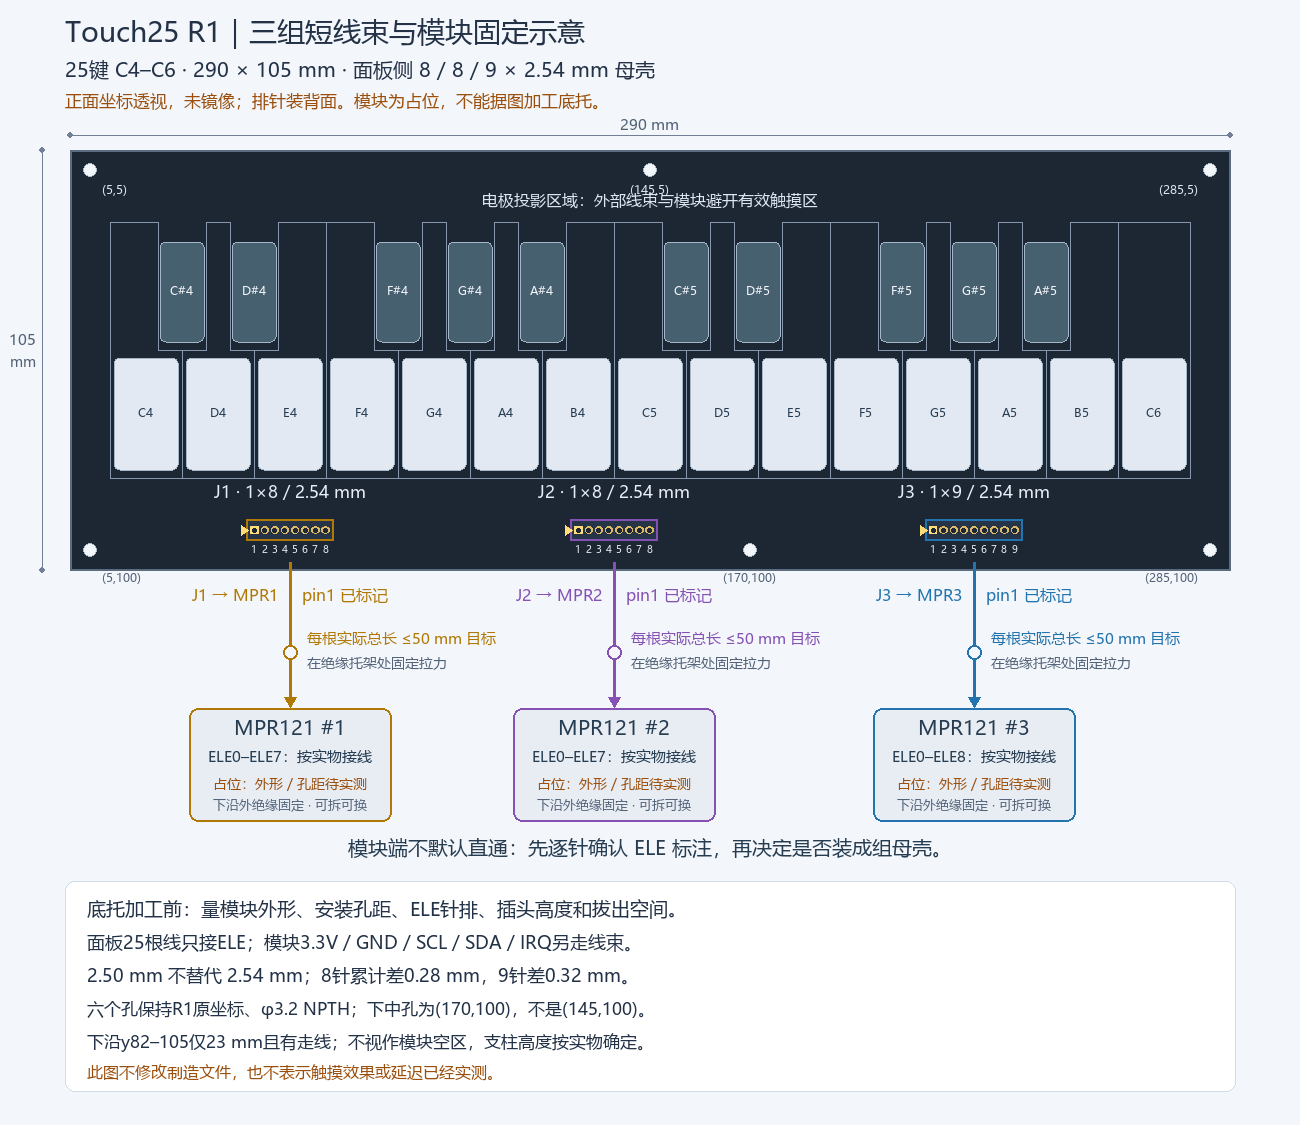
TangMega60K_Synth/hardware/touch25/harness_layout.png
