wujijun11/git/TangMega60K_Synth/docs/采购清单-桌面电子乐器-20260917.md

# 桌面电子乐器采购清单（选型草案，2026-09-17）

范围：Sipeed Tang Mega 60K + NEO Dock；8个和弦按钮、4个压力演奏垫、独立压力增益/滑条弯音/旋钮颤音；目标64复音、2种以上合成音色、FPGA效果和LED曲目指引。数量按一套整机，加少量备件列出。已有器材不重复采购。

本表是可实施方案的备料清单，不代表模块已经买到、装配电路已经定稿或整机已经通过验收。板卡丝印、实际模块原理图、GPIO供电与余量、外壳孔位尚需核对；供应商的替代型号不能视为自动兼容。当前未核实闲鱼库存和成交价格。

## 音频方案的重要核对

官方NEO Dock-60K 31004原理图（Rev 1.4，2025-03-31）第10页，U16为PT8211-S，U20为NS4263。PT8211采用16位LSBJ/右对齐格式；工程现有i2s_tx为24位Philips I2S、每声道32个BCLK。不能只因网络名写着I2S就直接沿用发送格式。

本清单选外接PCM5102A成品DAC模块，使用标准I2S，再连接有源音箱。原有板载PT8211和扬声器端子不属于这条外接音频链。若将来使用板载音频，需要独立适配、验证串行格式，并明确比赛的I2S要求。

PCM5102A的模拟输出是线电平，不直接驱动低阻耳机或无源扬声器。模块需具备完整稳压、去耦、滤波和输出插座，并提供原理图；确认其实际VIN电压、I2S格式配置、SCK无外部MCLK时的处理及静音脚状态。芯片可采用3线I2S，但模块的接法必须按实物原理图确定。

## A. 板卡、供电与音频

| 编号 | 器件/规格 | 安装需要 | 建议备有 | 采购及使用条件 |
|---|---|---:|---:|---|
| A01 | Sipeed Tang Mega 60K核心板 | 1 | 1 | 核对已有板卡，无须另买138K |
| A02 | 与核心板配套的NEO Dock底板 | 1 | 1 | 若已是完整套装，不重复买；Console不是同一底板 |
| A03 | 核心板/底板配套固定件、原配散热器 | 1套 | 1套 | 优先使用原套装；缺件按实际孔径/芯片空间配 |
| A04 | USB数据线，适配电脑到板上DEBUG USB-C | 1 | 2 | 必须有数据功能，1条备用 |
| A05 | 稳压12V DC适配器，建议3A，DC5521 | 1 | 1 | 电流是本方案留余量的选择；极性按板卡标识核对，含交流电源线 |
| A06 | PCM5102A成品立体声DAC模块 | 1 | 1 | 3.3V数字电平、支持24位I2S，带已焊排针和3.5mm TRS线输出；模块VIN按原理图 |
| A07 | AUX模拟输入有源立体声音箱，带音量控制 | 1套 | 1套 | 配套电源/USB供电线完整；使用有线输入 |
| A08 | 3.5mm TRS立体声音频线，公对公 | 1 | 2 | 1条备用；如音箱自带同规格线，减去重复项 |
| A09 | 5V USB电源适配器，建议2A | 条件1 | 1 | 仅USB供电音箱缺电源时购买；不把5V接到FPGA IO |
| A10 | 带开关电源插排 | 1 | 1 | 实验室已有可共用 |

外接输入、逻辑芯片、OLED按3.3V系统设计。ADC参考电压和传感器激励采用同一经核对的3.3V源；所有相关模块共地。板上3.3V/5V引脚的剩余供电能力需核算；若不足，补独立受控稳压电源，不能并联两个稳压器输出。

## B. 人机输入与模拟采集

| 编号 | 器件/规格 | 安装需要 | 建议购买/备有 | 用途及配套 |
|---|---|---:|---:|---|
| B01 | 常开、自复位、无灯面板按钮，拟选24mm安装孔 | 14 | 16 | 8和弦+6功能，2备件；含螺母/卡扣，固定具体触点尺寸 |
| B02 | FSR402类薄膜力敏电阻，同一确定型号 | 5 | 6 | 4演奏垫+1独立持续压力，1备件；须有曲线与引出端资料 |
| B03 | 与FSR引出端匹配的预接引线/夹持转接件 | 5套 | 6套 | 与B02一起买；不能按不明间距强插或长时间直接烫焊薄膜尾部 |
| B04 | 演奏垫软面、刚性背板、局部传力块 | 5组 | 6组 | 4大垫+1表情压区+备件；外形待布局，传力块落在传感器有效区 |
| B05 | B10K线性滑动电位器，拟选60mm行程 | 1 | 2 | 弯音；配滑块帽和安装件，另1备件；不是音频对数电位器 |
| B06 | B10K线性旋转电位器 | 1 | 2 | 颤音深度+1备件，配轴径相符旋钮、螺母、垫圈 |
| B07 | 额外B10K旋转电位器及旋钮 | 可选1 | 可选1 | 后续效果干湿比；当前V2无专门效果参数接口，不当成已接入功能 |
| B08 | MCP3208-CI/P，DIP-16，12位8通道SPI ADC | 1 | 2 | 工作3.3V；1备件。选择模块版时必须明确电平/参考和原理图，不与裸芯片重复购买 |
| B09 | MCP6004-I/P，DIP-14，四运放 | 2 | 3 | 8路电压跟随缓冲，降低ADC看到的源阻抗；1备件 |
| B10 | 100kΩ多圈微调电阻，如3296W | 5 | 6 | 压力分压范围调试，与固定电阻配用；最终阻值按FSR标定 |
| B11 | SN74HC165N，DIP-16 | 2 | 3 | 级联采集普通按钮，3.3V；1备件，别换成只适合5V的器件 |

B01六个功能建议为音色、和弦模式、八度上/下、效果开关、静音/协调复位。紧急静音/复位的最终接法需单独定义；若作为硬件复位，不能只通过正在工作的移位扫描链实现。

ADC通道分配：CH0~3=四演奏垫，CH4=独立全局压力，CH5=弯音滑条，CH6=颤音旋钮，CH7=预留/效果旋钮。四演奏垫是手指压力触发方案，不是压电鼓棒打击方案。压力幅值到velocity的映射需要标定，不能直接称为物理击键速度测量。

MCP3208在低供电下的最高采样率与5V规格不同；按数据手册选择SPI频率和采集时序。缓冲/RC须验证建立时间，滤波和力度采集窗口计入延迟，不能通过长时间等待峰值满足力度功能却忽略10ms要求。

## C. 指示与图形显示

| 编号 | 器件/规格 | 安装需要 | 建议购买/备有 | 说明 |
|---|---|---:|---:|---|
| C01 | SN74HC595N，DIP-16 | 2 | 3 | 16路低电流LED驱动，3.3V；1备用 |
| C02 | 高效率低电流绿色LED，拟选3mm | 12 | 20 | 8和弦+4演奏垫状态 |
| C03 | 红色LED，拟选3mm | 2 | 10 | 满载/异常状态 |
| C04 | 黄色LED，拟选3mm | 2 | 10 | 模式/指引状态 |
| C05 | LED面板灯座/固定套，与LED外径匹配 | 16 | 20 | 装配件 |
| C06 | 0.96英寸128×64 OLED，SSD1315，7针SPI成品模块 | 扩展1 | 1 | 选有文档的3.3V模块；FPGA显示参数/简易波形，用于扩展演示 |
| C07 | OLED配套7针线及固定支架/螺丝 | 1套 | 1套 | 有配套线不重复买；SSD1306/SH1106替代品需重新核对驱动 |

每颗LED串独立限流电阻，初始按约1mA等级设计并按颜色核算，检查595总电流；OE及复位脚不能悬空。OLED和LED同时配备是完整展示方案，基础发声阶段可以先不装OLED。效果器、曲目节奏逻辑和图形生成在FPGA实现，购买屏幕不等于完成可视化。

## D. 电阻、电容、芯片座和原型板

以下是备料数量，不是要求全部焊进电路；具体位号和值在前端原理图确定后分配。

| 编号 | 物品 | 建议数量 | 说明 |
|---|---|---:|---|
| D01 | 33Ω、100Ω金属膜电阻，1%、1/4W | 各20 | 数字串联阻尼/模拟缓冲隔离备选，按实测选择 |
| D02 | 1kΩ电阻，1%、1/4W | 50 | LED限流及前端备料 |
| D03 | 4.7kΩ、10kΩ电阻，1%、1/4W | 各50 | 上拉/下拉及压力分压 |
| D04 | 22kΩ、47kΩ、100kΩ电阻，1%、1/4W | 各20 | FSR范围调试，按实际曲线选值 |
| D05 | 100nF陶瓷去耦电容，额定≥16V | 30 | 每个IC电源脚附近至少1颗，ADC电源/参考分别处理 |
| D06 | 1nF、10nF陶瓷电容，额定≥16V | 各20 | 模拟滤波备选；不是所有输入任意并大电容 |
| D07 | 1μF电容，额定≥16V | 10 | 前端/参考局部滤波 |
| D08 | 10μF、47μF电解电容，额定≥16V | 各10 | 3.3V/5V局部储能；注意极性 |
| D09 | DIP-16窄体芯片插座 | 8 | MCP3208、165、595共安装5个，余量备用 |
| D10 | DIP-14窄体芯片插座 | 3 | 两片运放及备件 |
| D11 | 2.54mm FR-4双面洞洞板，约10×15cm | 2 | 一块模拟前端，一块按键/LED；最终布局可改 |
| D12 | 830孔面包板 | 1 | 低速原型；正式I2S不要经过长面包板线路 |
| D13 | 连接转接小板/试焊板 | 2 | 线束固定、接口测试 |
| D14 | 最终前端/连接PCB打样 | 条件1批 | 原型成功且原理图审查后，可替代部分洞洞板，先不下单 |

若选择现成ADC缓冲模块、按键扩展模块、LED模块，其已经包含的芯片、电阻和去耦不重复采购；必须知道实际电路，不能仅凭标题含“3.3V/5V”确认兼容。

## E. 连线和接口（按本方案留合理余量）

| 编号 | 物品 | 建议数量 | 说明 |
|---|---|---:|---|
| E01 | 2.54mm杜邦线，母母/公母/公公 | 每种40根 | 原型连接；I2S单独用短线，长线与地线配对 |
| E02 | 2.54mm 1×40可裁排针 | 5条 | 子板端子 |
| E03 | 2.54mm 1×40可裁排母 | 5条 | 子板插接 |
| E04 | 2.54mm跳线帽 | 20个 | 配置/测量断点 |
| E05 | 与按钮端子匹配的预压接绝缘母插簧线 | 32根 | 两根/按钮，覆盖16个；必须随按钮确认2.8/4.8mm等实际宽度 |
| E06 | 成套带锁2针预压接线束+板端插座 | 10套 | 按键、传感器分组；同品牌、同间距，不混PH/XH |
| E07 | 成套带锁3针预压接线束+板端插座 | 5套 | 滑条、旋钮、供电；同系列，含预压端子 |
| E08 | 多芯总线连接线/转接板 | 1套，待定 | 对接实际Dock扩展口；先核对排针/排母、间距、方向和占用 |
| E09 | 24~26AWG多股绝缘导线，红/黑/黄/蓝/绿 | 每色2m | 信号和短距离低压配线 |
| E10 | 22AWG红/黑电源线 | 各2m | 低压电源配线，不接市电 |
| E11 | 热缩管，2/3/5mm | 每种1m | 焊点及线束绝缘 |
| E12 | 2~3mm宽小扎带 | 50根 | 理线与应力释放 |
| E13 | 自粘扎带座 | 10个 | 内部固定 |
| E14 | 编号标签/线号标签 | 1张 | 每束线标注信号与电源方向 |
| E15 | 3.5mm TRS插座转接测试板/转接线 | 1 | 接示波器测DAC模拟输出，保证测线输出对地 |

不预先购买不明针脚的“树莓派40针直插扩展板”。Dock接口即使外形类似，也不能假设引脚兼容。前端到FPGA的初步数字需求：165扫描3线、595控制4线、ADC SPI4线、OLED SPI5线、协调复位1线、外接DAC3线，合计约20根信号；OLED/ADC可评估共享部分SPI。最终CST必须在板卡版本与复用资源核对后生成。

## F. 结构和散热

| 编号 | 物品 | 建议数量 | 说明 |
|---|---|---:|---|
| F01 | 面板+底板+侧壁/完整外壳 | 1套，尺寸待定 | 实物试排后画孔位；不沿用旧键床方案尺寸直接加工 |
| F02 | 前述五个压力区域的固定件、传力/回弹结构 | 5组 | 与B04一起加工，预留防过压限位与薄膜出线保护 |
| F03 | M2/M2.5/M3尼龙隔离柱和螺丝/螺母/垫圈套装 | 各1小盒 | 匹配实际板孔；不要强行用更大螺丝 |
| F04 | 底部防滑脚垫 | 4，备8 | 外壳稳定 |
| F05 | 泡棉双面胶/绝缘固定胶 | 1卷 | 固定轻型模块，不能覆盖传感器有效区影响受力 |
| F06 | 绝缘片/Kapton胶带 | 1卷/张 | 防止焊点与壳体短接 |
| F07 | 塑料护线圈 | 4 | 线缆穿壳孔的保护 |
| F08 | 面板标识贴纸 | 1套 | 音符、功能、输入输出、电源标识 |
| F09 | FPGA配套散热片和绝缘导热垫 | 缺少才买1套 | 先检查套装；不能压碰周边元件 |
| F10 | 5V风扇、匹配线束、防护网、螺丝 | 条件1套 | 密闭外壳温升实测决定；接口针序和电流需核对 |

## G. 选做的无线和记录扩展

| 项目 | 数量 | 使用范围与限制 |
|---|---:|---|
| 有AT文档的BLE-UART成品模块，3.3V IO | 选做1 | 可参考E104-BT02系列加适配底板；实际硬件版本、供电、手机支持必须核对。只传曲谱/控制/演奏事件 |
| 蓝牙模块适配底板、排针、天线 | 按模块配1套 | 选择已装PCB天线版本可免外接天线；不能漏买裸模块所需转接 |
| 支持BLE的手机 | 已有1 | App还需开发；蓝牙透传板不自动获得曲谱界面 |
| 16/32GB microSD卡+电脑读卡器 | 选做各1 | 脱机大量曲谱/音频记录才考虑；少量LED曲谱可放FPGA ROM，板上已有卡槽 |
| 3.3V USB-UART调试模块+USB线 | 选做1套 | 板载UART可满足时不买；需要独立调试BLE时才添置 |
| 耳机放大器+有线耳机 | 选做各1 | 只在需要耳机监听时添加；不得用PCM5102A线输出直接带低阻耳机 |

无线传输不参与实时音频生成。当前V2没有完整蓝牙曲谱/效果/录音接口，需后续开发。演奏事件记录和WAV音频记录是两件事。若要FPGA生成的WAV通过蓝牙回传，需设计存储、文件系统、缓存和传输协议；普通串口BLE不能被默认当成实时24位立体声音频链。

如果要求声音从外壳内直接发出，可以用模拟输入双声道功放模块+两个匹配阻抗/功率的扬声器+喇叭线束/网罩/供电替换A07有源音箱。这个分支需确定功放输入电平、扬声器规格和功耗后单独锁定，不能与主方案随意混接。主方案完整发声不需要这些额外元件。

## H. 装配工具（每队一套，可借用）

| 物品 | 数量 | 配套 |
|---|---:|---|
| 温控电烙铁/焊台 | 1套 | 含电源、烙铁架、适合通孔焊接的烙铁头 |
| 细焊锡丝、电子助焊剂 | 各1 | 正规电子焊接耗材 |
| 吸锡带或吸锡器 | 1 | 返修 |
| 烙铁清洁铜丝球 | 1 | 工具维护 |
| 斜口钳、剥线钳、尖嘴钳、镊子 | 各1 | 线材与元件装配 |
| 螺丝刀套装 | 1 | 匹配结构螺丝 |
| 数显卡尺/直尺 | 各1 | 孔位和尺寸测量 |
| 热风工具/热缩工具 | 借用1 | 热缩管处理，远离FSR薄膜 |
| 固定夹具/第三只手 | 1 | 焊接固定 |
| 护目镜、焊烟抽排设施 | 1套 | 焊接和钻孔工位配套 |
| 防静电垫/腕带 | 1套 | 按工位规范使用 |
| 开孔加工条件 | 借用/委托1次 | 面板孔用加工服务也可，不必买台钻 |

## I. 验证设备（有借用渠道则不采购）

| 物品 | 数量 | 要验证什么 |
|---|---:|---|
| 数字万用表+表笔 | 1 | 电源极性、电压、短路、FSR阻值 |
| 8通道或以上逻辑分析仪 | 1 | 3.3V兼容，I2S/SPI采样速率至少24MS/s等级，配USB数据线和抓钩 |
| 示波器 | 1 | 建议≥2通道、50MHz等级并配匹配10×探头；观察触发到模拟声音及信号质量，按测量对象选择实际性能 |
| 测试抓钩/迷你夹/短接地线 | 1组 | 数字和模拟测试点 |
| USB音频接口，真正立体声Line In | 1 | 建议24bit/48kHz或更高，关闭自动增益/降噪，采集频谱；廉价单声道麦克风输入小声卡不替代 |
| DAC到音频接口的线 | 1 | 依接口购买，如3.5mm TRS转双6.35mm TS；不要选成单声道短接线 |
| 音频接口USB线、电脑可用接口 | 1套 | 检查随机附件；数字样本分析之外仍需验证真实DAC输出 |
| 开发电脑 | 现有 | GOWIN、仿真器、Git和音频分析工具；无需为每位队员重复购买全套仪器 |

万用表不能证明I2S时序和10ms延迟，逻辑分析仪不能代替模拟音频输出测量。验收重点包括64实际独立声部、混音无回绕、两种音色、三维实际表情、持续输出无欠载，以及真实输入到DAC输出的延迟。

## 无需因64复音额外购买

不需要64个DAC、64个扬声器、64个按键、独立DSP芯片、Arduino/STM32音源、树莓派/RK3588或预录音频播放模块。无需为了基本合成另买DDR3、Flash、独立JTAG下载器；有NEO Dock时先用板上已有资源。没有定义续航目标，暂不采购锂电池、充电板或升压板。

## 分批采购和待定项

第一批：核对已有板卡和电源；A06/A07/A08；至少1路FSR和引线、滑条、旋钮；ADC及缓冲；少量按钮、移位芯片、阻容、原型板和连线；准备可借用的测量设备。

第二批：原型测通后补齐5路FSR、14按钮、16指示LED、OLED和完整线束，安装一套完整面板。备件数量可合并下单以节省运费。

第三批：布局/电气审核后加工外壳及可选PCB；需要无线/录音时再采购G组并定义协议。

尚需用户/实物信息：核心板和底板丝印及所含配件；音箱/万用表等已有物品；所选模块完整商品页和原理图；最终面板安装孔距。外壳、接口总线和电源极性在这些信息确认前不按猜测下单。

## 官方参考

- Sipeed Tang Mega 60K：https://wiki.sipeed.com/hardware/zh/tang/tang-mega-60k/mega-60k.html
- NEO Dock 60K 31004原理图：https://dl.sipeed.com/fileList/TANG/Mega_138K_60K/02_Schematic/DOCK/Tang_Mega_NEO_Dock-60K_31004_Schematics.pdf
- PT8211格式：https://www.princeton.com.tw/en-us/Products/Multi-Media-Audio/Digital-to-Analog-Converter
- PCM5102A：https://www.ti.com/product/PCM5102A
- MCP3208：https://www.microchip.com/en-us/product/mcp3208
- MCP3208数据手册：https://ww1.microchip.com/downloads/en/devicedoc/21298e.pdf
- MCP6004数据手册：https://ww1.microchip.com/downloads/aemDocuments/documents/MSLD/ProductDocuments/DataSheets/MCP6001-1R-1U-2-4-1-MHz-Low-Power-Op-Amp-DS20001733L.pdf
- FSR402：https://www.interlinkelectronics.com/fsr-402
- SN74HC165：https://www.ti.com/product/SN74HC165
- SN74HC595：https://www.ti.com/product/SN74HC595
- OLED参考模块：https://www.waveshare.com/product/displays/0.96inch-oled-module-c.htm
- BLE参考系列：https://www.ebyte.com/product/107.html
