wujijun11/git/TangMega60K_Synth/hardware/ahct125/release/production/BOM_AHCT125_LED_R1.csv

No. | Quantity | Comment | Designator | Footprint | Value | Manufacturer Part | Manufacturer | Supplier Part | Supplier
1 | 1 | 100nF | C1 | C0603 | 100nF | CC0603KRX7R9BB104 | YAGEO(国巨) | C14663 | LCSC
2 | 1 | 10uF | C2 | C0805 | 10uF | CL21A106KAYNNNE | SAMSUNG(三星) | C15850 | LCSC
3 | 1 | 1000uF | C3 | CAP-TH_BD8.0-P3.50-D0.6-FD | 1000uF | 10PX1000MEFC8X11.5 | Rubycon(红宝石) | C88853 | LCSC
4 | 1 | B-2100S02P-A110 | J1 | HDR-TH_2P-P2.54-V-M-1 |  | B-2100S02P-A110 | Ckmtw(灿科盟) | C124375 | LCSC
5 | 1 | B-2100S03P-A110 | J2 | HDR-TH_3P-P2.54-V-M-1 |  | B-2100S03P-A110 | Ckmtw(灿科盟) | C124376 | LCSC
6 | 1 | KF127-5.08-2P | J3 | CONN-TH_P5.08_KF127-5.08-2P |  | KF127-5.08-2P | KEFA(科发) | C474906 | LCSC
7 | 1 | 10kΩ | R1 | R0603 | 10kΩ | 0603WAF1002T5E | UNI-ROYAL(厚声) | C25804 | LCSC
8 | 1 | 330Ω | R2 | R0603 | 330Ω | 0603WAF3300T5E | UNI-ROYAL(厚声) | C23138 | LCSC
9 | 1 | SN74AHCT125DR | U1 | SOIC-14_L8.7-W3.9-P1.27-LS6.0-BL |  | SN74AHCT125DR | TI(德州仪器) | C155176 | LCSC
