wujijun11/git/TangMega60K_Synth/hardware/touch25/fabrication_parameters_zh.md

# Touch25 R1 PCB打样参数

以下是这块纯被动触摸面板的建议下单参数，需在实际厂家页面核对自动识别结果、可选项、价格和交期。**这里只准备制造说明，没有提交订单或付款。实际导出的Gerber已完成163项独立检查、全部通过，并通过ZIP字节与25键映射交叉核对。**

| 参数 | 建议选择 |
| --- | --- |
| 上传文件 | `Gerber_Touch25_C4_C6_18mm_R1_2026-10-09.zip`，54,830字节 |
| 类型 | 普通刚性PCB |
| 层数 | 2层 |
| 尺寸 | 290 × 105 mm |
| 数量 | 5片 |
| 材料 | FR-4 |
| 板厚 | 1.6 mm |
| 外层铜厚 | 1 oz |
| 阻焊颜色 | 黑色 |
| 丝印颜色 | 白色 |
| 表面处理 | 无铅喷锡 |
| SMT贴片 | 不需要 |
| 钢网 | 不需要 |
| 装配 | 本次只做裸PCB；排针需自行焊接或另约代焊 |

这是25个触摸电极和三个接口的面板，没有板载MPR121或MCU，不需要BOM、坐标文件或贴片服务。MPR121模块三块另购。

提交前核对：外框确实为290 × 105 mm、顶底铜均存在、25个触摸电极保持阻焊覆盖、25个0.3 mm转层孔按设计盖阻焊、25个1.0 mm连接孔是金属化通孔、六个3.2 mm安装孔是非金属化通孔。下中安装孔在(170,100) mm。表面处理主要作用于露出的连接焊盘，触摸区不应开窗露铜。

如厂家页面将尺寸、孔属性或阻焊识别为其他值，应先核对制造文件，不直接按错误识别结果付款。黑色阻焊、白色丝印、板厚、铜厚及数量等实际可选项和报价以页面为准；不预设免费打样资格或具体交期。

最终原生工程为 `Touch25_C4_C6_18mm_R1_Final/Touch25_C4_C6_18mm_R1_Final.eprj3`，在2026-10-09 18:24:32完成141项原生DRC、0错误。该结果不代表触摸响应、整机音频或端到端延迟已通过实测。

实际Gerber检查报告位于 `verification/actual_gerber_audit.json`、`verification/actual_gerber_review.md` 和 `verification/package_crosscheck.json`。对应ZIP的SHA256为 `796CCB39E2B18CB72EF80832254A5D7D71BE6FFF0C74F9DEE4A8960D6979C42C`。审核不等于厂家CAM接受；标称钻孔与铜圆盘重合处理、钻孔公差和丝印可读性限制已在报告中说明。
