wujijun11/git/TangMega60K_Synth/docs/reports/windows-minimized-20261027/build/installed-dependencies.txt

altgraph==0.17.5
bleak==3.0.2
bottle==0.13.4
cffi==2.1.1
clr_loader==0.3.1
mido==1.3.3
packaging==26.3
pefile==2024.8.26
proxy_tools==0.1.0
pycparser==3.11
pyinstaller==6.22.3
pyinstaller-hooks-contrib==2026.9
pyserial==3.5
pythonnet==3.2.1
pywebview==6.2.1
pywin32-ctypes==0.2.3
setuptools==84.2.1
typing_extensions==4.16.0
winrt-runtime==3.2.1
winrt-Windows.Devices.Bluetooth==3.2.1
winrt-Windows.Devices.Bluetooth.Advertisement==3.2.1
winrt-Windows.Devices.Bluetooth.GenericAttributeProfile==3.2.1
winrt-Windows.Devices.Enumeration==3.2.1
winrt-Windows.Devices.Radios==3.2.1
winrt-Windows.Foundation==3.2.1
winrt-Windows.Foundation.Collections==3.2.1
winrt-Windows.Storage.Streams==3.2.1
