wujijun11/git/TangMega60K_Synth/verification/uart-live-debug-20261023/c3-tx-observation-audit/isr-disassembly.txt

C:\Users\asus\Desktop\Git\TangMega60K_Synth\verification\uart-live-debug-20261023\c3-tx-observation-build\ble_bridge.ino.elf:     file format elf32-littleriscv

Disassembly of section .iram0.text:

403802de <BridgeTxObserver::edgeIsr(void*)>:
403802de:	1141                	addi	sp,sp,-16
403802e0:	c422                	sw	s0,8(sp)
403802e2:	c606                	sw	ra,12(sp)
403802e4:	842a                	mv	s0,a0
403802e6:	45d0c0ef          	jal	4038cf42 <vPortEnterCritical>
403802ea:	08042783          	lw	a5,128(s0)
403802ee:	40b2                	lw	ra,12(sp)
403802f0:	0785                	addi	a5,a5,1
403802f2:	08f42023          	sw	a5,128(s0)
403802f6:	4422                	lw	s0,8(sp)
403802f8:	0141                	addi	sp,sp,16
403802fa:	4770c06f          	j	4038cf70 <vPortExitCritical>

C:\Users\asus\Desktop\Git\TangMega60K_Synth\verification\uart-live-debug-20261023\c3-tx-observation-build\ble_bridge.ino.elf:     file format elf32-littleriscv

Disassembly of section .iram0.text:

403802fe <gpio_intr_service>:
403802fe:	7179                	addi	sp,sp,-48
40380300:	d422                	sw	s0,40(sp)
40380302:	9d818793          	addi	a5,gp,-1576 # 3fc94dd8 <gpio_context>
40380306:	4b9c                	lw	a5,16(a5)
40380308:	d606                	sw	ra,44(sp)
4038030a:	d226                	sw	s1,36(sp)
4038030c:	d04a                	sw	s2,32(sp)
4038030e:	ce4e                	sw	s3,28(sp)
40380310:	cc52                	sw	s4,24(sp)
40380312:	ca56                	sw	s5,20(sp)
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

4038cf32 <vPortClearInterruptMaskFromISR>:
4038cf32:	600c27b7          	lui	a5,0x600c2
4038cf36:	18a7aa23          	sw	a0,404(a5) # 600c2194 <SYSTEM+0x2194>
4038cf3a:	0001                	nop
4038cf3c:	0001                	nop
4038cf3e:	0001                	nop
4038cf40:	8082                	ret
