wujijun11/git/TangMega60K_Synth/verification/timing-margin-20261014/build_payload-select_20261014_200315_8e6fbc97/full/impl/pnr/ContestFull.rpt.html

- PnR Messages
- PnR Details
- Resource
  - Resource Usage Summary
  - I/O Bank Usage Summary
  - Clock Resource Usage Summary
  - Global Clock Signals
  - Pinout by Port Name
  - All Package Pins

# PnR Messages

Report Title | PnR Report
Design File | C:\Users\asus\Desktop\Git\TangMega60K_Synth\verification\timing-margin-20261014\build_payload-select_20261014_200315_8e6fbc97\full\impl\gwsynthesis\ContestFull.vg
Physical Constraints File | C:\Users\asus\Desktop\Git\TangMega60K_Synth\verification\timing-margin-20261014\build_payload-select_20261014_200315_8e6fbc97\full\contest_full.cst
Timing Constraints File | C:\Users\asus\Desktop\Git\TangMega60K_Synth\verification\timing-margin-20261014\build_payload-select_20261014_200315_8e6fbc97\full\contest_full.sdc
Tool Version | V1.9.12 (64-bit)
Part Number | GW5AT-LV60PG484AC1/I0
Device | GW5AT-60
Device Version | B
Created Time | Wed Oct 14 20:18:42 2026
Legal Announcement | Copyright (C)2014-2025 Gowin Semiconductor Corporation. All rights reserved.

# PnR Details

Place & Route Process

Running placement: Placement Phase 0: CPU time = 0h 0m 42s, Elapsed time = 0h 0m 42s Placement Phase 1: CPU time = 0h 0m 6s, Elapsed time = 0h 0m 6s Placement Phase 2: CPU time = 0h 2m 28s, Elapsed time = 0h 2m 28s Placement Phase 3: CPU time = 0h 1m 1s, Elapsed time = 0h 1m 1s Total Placement: CPU time = 0h 4m 17s, Elapsed time = 0h 4m 17s Running routing: Routing Phase 0: CPU time = 0h 0m 0.037s, Elapsed time = 0h 0m 0.038s Routing Phase 1: CPU time = 0h 3m 35s, Elapsed time = 0h 3m 35s Routing Phase 2: CPU time = 0h 0m 2s, Elapsed time = 0h 0m 2s Routing Phase 3: CPU time = 0h 0m 0s, Elapsed time = 0h 0m 0s Total Routing: CPU time = 0h 3m 37s, Elapsed time = 0h 3m 37s Generate output files: CPU time = 0h 0m 21s, Elapsed time = 0h 0m 21s
Total Time and Memory Usage | CPU time = 0h 8m 15s, Elapsed time = 0h 8m 15s, Peak memory usage = 2096MB

# Resource

## Resource Usage Summary:

Resource | Usage | Utilization
Logic | 21968/59904 | 37%
--LUT,ALU,ROM16 | 21968(18825 LUT, 3143 ALU, 0 ROM16) | -
--SSRAM(RAM16) | 0 | -
Register | 15322/60780 | 26%
--Logic Register as Latch | 0/59904 | 0%
--Logic Register as FF | 15307/59904 | 26%
--I/O Register as Latch | 0/876 | 0%
--I/O Register as FF | 15/876 | 2%
CLS | 19420/29952 | 65%
I/O Port | 30/297 | 11%
I/O Buf | 26 | -
--Input Buf | 8 | -
--Output Buf | 12 | -
--Inout Buf | 6 | -
IOLOGIC | 4 ODDR | 2%
BSRAM | 39 SDPB 24 SDPX9B 36 pROM 7 pROMX9 | 90%
DSP | 3 MULT12X12 21 MULT27X36 7 MULTALU27X18 | 43%

## I/O Bank Usage Summary:

I/O Bank | Usage | Utilization
bank 1 | 12/25 | 48%
bank 2 | 0/26 | 0%
bank 3 | 0/8 | 0%
bank 4 | 7/16 | 44%
bank 5 | 3/34 | 9%
bank 6 | 0/20 | 0%
bank 7 | 3/24 | 13%
bank 8 | 2/24 | 9%
bank 9 | 3/66 | 5%
bank 10 | 0/25 | 0%
bank 11 | 0/25 | 0%
bank 12 | 0/4 | 0%

## Clock Resource Usage Summary:

Clock Resource | Usage | Utilization
PRIMARY | 8/8 | 100%
LW | 8/8 | 100%
GCLK_PIN | 0/40 | 0%
PLLA | 3/8 | 38%

## Global Clock Signals:

Signal | Global Clock | Location
sys_clk_d | PRIMARY | PTR1 PTR2 PTR3 PBR1 PBR3
audio_clk | PRIMARY | PTR0 PTR1 PTR2 PBR0 PBR1 PBR2
serial_clk | PRIMARY | PTR3 PBR1
pixel_clk | PRIMARY | PTR0 PTR1 PTR2 PBR0 PBR1
audio_clock/clk_38m4 | PRIMARY | PTR1
system/sensors/eventizer/n2842_19 | PRIMARY | PTR2
system/synth/u_polar0/v[0] | PRIMARY | PTR1 PTR2 PBR1
system/synth/u_polar1/v[0] | PRIMARY | PTR1 PBR0 PBR1 PBR2
n11_7 | LW | -
system/audio_rst_n | LW | -
system/video_reset[1] | LW | -
system/synth/u_polar0/v[1] | LW | -
system/synth/u_polar0/v[2] | LW | -
system/synth/u_polar1/v[1] | LW | -
system/synth/u_polar1/v[2] | LW | -
system/visual/n15721_9 | LW | -

## Pinout by Port Name:

Port Name | Diff Pair | Loc./Bank | Constraint | Dir. | Site | CFG | IO Type | Drive | Pull Mode | PCI Clamp | Hysteresis | Open Drain | Slew Rate | Vref | Single Resistor | Diff Resistor | BankVccio | Pull Strength | Ctle
sys_clk | - | V22/7 | Y | in | IOB117[B] | EMCCLK | LVCMOS33 | OFF | NONE | OFF | ON | OFF | SLOW | OFF | OFF | OFF | 3.3 | MEDIUM | NONE
key_n[0] | - | AA13/9 | Y | in | IOB54[B] | - | LVCMOS15 | OFF | UP | OFF | ON | OFF | SLOW | OFF | OFF | OFF | 1.5 | MEDIUM | NONE
key_n[1] | - | AB13/9 | Y | in | IOB54[A] | - | LVCMOS15 | OFF | UP | OFF | ON | OFF | SLOW | OFF | OFF | OFF | 1.5 | MEDIUM | NONE
key_n[2] | - | Y12/9 | Y | in | IOB52[A] | - | LVCMOS15 | OFF | UP | OFF | ON | OFF | SLOW | OFF | OFF | OFF | 1.5 | MEDIUM | NONE
mpr_irq_n[0] | - | B16/1 | Y | in | IOT97[B] | - | LVCMOS33 | OFF | UP | OFF | ON | OFF | SLOW | OFF | OFF | OFF | 3.3 | MEDIUM | NONE
mpr_irq_n[1] | - | B15/1 | Y | in | IOT97[A] | - | LVCMOS33 | OFF | UP | OFF | ON | OFF | SLOW | OFF | OFF | OFF | 3.3 | MEDIUM | NONE
mpr_irq_n[2] | - | A16/1 | Y | in | IOT99[B] | - | LVCMOS33 | OFF | UP | OFF | ON | OFF | SLOW | OFF | OFF | OFF | 3.3 | MEDIUM | NONE
uart_rx | - | A14/1 | Y | in | IOT95[B] | - | LVCMOS33 | OFF | UP | OFF | ON | OFF | SLOW | OFF | OFF | OFF | 3.3 | MEDIUM | NONE
uart_tx | - | A13/1 | Y | out | IOT95[A] | - | LVCMOS33 | 4 | NONE | OFF | OFF | OFF | SLOW | OFF | OFF | OFF | 3.3 | MEDIUM | NONE
rgb_data | - | J16/5 | Y | out | IOR47[A] | - | LVCMOS33 | 8 | NONE | OFF | OFF | OFF | SLOW | OFF | OFF | OFF | 3.3 | MEDIUM | NONE
pa_disable | - | AB16/7 | Y | out | IOB108[B] | - | LVCMOS33 | 4 | NONE | OFF | OFF | OFF | SLOW | OFF | OFF | OFF | 3.3 | MEDIUM | NONE
i2s_bclk | - | Y21/8 | Y | out | IOB99[A] | - | LVCMOS33 | 4 | NONE | OFF | OFF | OFF | SLOW | OFF | OFF | OFF | 3.3 | MEDIUM | NONE
i2s_lrclk | - | AB21/8 | Y | out | IOB97[A] | D14 | LVCMOS33 | 4 | NONE | OFF | OFF | OFF | SLOW | OFF | OFF | OFF | 3.3 | MEDIUM | NONE
i2s_data | - | AA20/7 | Y | out | IOB102[A] | D11 | LVCMOS33 | 4 | NONE | OFF | OFF | OFF | SLOW | OFF | OFF | OFF | 3.3 | MEDIUM | NONE
guide_led_data | - | A15/1 | Y | out | IOT99[A] | - | LVCMOS33 | 4 | NONE | OFF | OFF | OFF | SLOW | OFF | OFF | OFF | 3.3 | MEDIUM | NONE
tmds_clk_p | tmds_clk_n | G15/4 | Y | out | IOR24[A] | - | LVDS25 | 3.5 | NONE | OFF | OFF | NONE | NONE | OFF | OFF | OFF | 3.3 | MEDIUM | NONE
tmds_clk_n | tmds_clk_p | G16/4 | Y | out | IOR24[B] | - | LVDS25 | 3.5 | NONE | OFF | OFF | NONE | NONE | OFF | OFF | OFF | 3.3 | MEDIUM | NONE
tmds_data_p[0] | tmds_data_n[0] | J14/4 | Y | out | IOR26[A] | - | LVDS25 | 3.5 | NONE | OFF | OFF | NONE | NONE | OFF | OFF | OFF | 3.3 | MEDIUM | NONE
tmds_data_p[1] | tmds_data_n[1] | J15/4 | Y | out | IOR22[A] | - | LVDS25 | 3.5 | NONE | OFF | OFF | NONE | NONE | OFF | OFF | OFF | 3.3 | MEDIUM | NONE
tmds_data_p[2] | tmds_data_n[2] | K17/5 | Y | out | IOR39[A] | RPLL0_T_IN0/RPLL0_T_FB1 | LVDS25 | 3.5 | NONE | OFF | OFF | NONE | NONE | OFF | OFF | OFF | 3.3 | MEDIUM | NONE
tmds_data_n[0] | tmds_data_p[0] | H14/4 | Y | out | IOR26[B] | - | LVDS25 | 3.5 | NONE | OFF | OFF | NONE | NONE | OFF | OFF | OFF | 3.3 | MEDIUM | NONE
tmds_data_n[1] | tmds_data_p[1] | H15/4 | Y | out | IOR22[B] | - | LVDS25 | 3.5 | NONE | OFF | OFF | NONE | NONE | OFF | OFF | OFF | 3.3 | MEDIUM | NONE
tmds_data_n[2] | tmds_data_p[2] | J17/5 | Y | out | IOR39[B] | RPLL0_C_IN0/RPLL0_C_FB1 | LVDS25 | 3.5 | NONE | OFF | OFF | NONE | NONE | OFF | OFF | OFF | 3.3 | MEDIUM | NONE
hdmi_enable | - | K13/4 | Y | out | IOR36[A] | RPLL0_T_IN1/RPLL0_T_FB0 | LVCMOS33 | 12 | UP | OFF | OFF | OFF | SLOW | OFF | OFF | OFF | 3.3 | MEDIUM | NONE
mpr_scl[0] | - | E14/1 | Y | io | IOT78[B] | - | LVCMOS33 | 4 | NONE | OFF | OFF | OFF | SLOW | OFF | OFF | OFF | 3.3 | MEDIUM | NONE
mpr_scl[1] | - | C15/1 | Y | io | IOT85[B] | - | LVCMOS33 | 4 | NONE | OFF | OFF | OFF | SLOW | OFF | OFF | OFF | 3.3 | MEDIUM | NONE
mpr_scl[2] | - | B13/1 | Y | io | IOT93[B] | - | LVCMOS33 | 4 | NONE | OFF | OFF | OFF | SLOW | OFF | OFF | OFF | 3.3 | MEDIUM | NONE
mpr_sda[0] | - | E13/1 | Y | io | IOT78[A] | - | LVCMOS33 | 4 | NONE | OFF | OFF | OFF | SLOW | OFF | OFF | OFF | 3.3 | MEDIUM | NONE
mpr_sda[1] | - | C14/1 | Y | io | IOT85[A] | - | LVCMOS33 | 4 | NONE | OFF | OFF | OFF | SLOW | OFF | OFF | OFF | 3.3 | MEDIUM | NONE
mpr_sda[2] | - | C13/1 | Y | io | IOT93[A] | - | LVCMOS33 | 4 | NONE | OFF | OFF | OFF | SLOW | OFF | OFF | OFF | 3.3 | MEDIUM | NONE

## All Package Pins:

Loc./Bank | Signal | Dir. | Site | CFG | IO Type | Drive | Pull Mode | PCI Clamp | Hysteresis | Open Drain | Slew Rate | Vref | Single Resistor | Diff Resistor | Bank Vccio | Pull Strength | Ctle
E13/1 | mpr_sda[0] | io | IOT78[A] | - | LVCMOS33 | 4 | NONE | OFF | OFF | OFF | SLOW | OFF | OFF | OFF | 3.3 | MEDIUM | NONE
E14/1 | mpr_scl[0] | io | IOT78[B] | - | LVCMOS33 | 4 | NONE | OFF | OFF | OFF | SLOW | OFF | OFF | OFF | 3.3 | MEDIUM | NONE
F13/1 | - | in | IOT80[A] | TPLL0_T_IN1/TPLL0_T_FB1 | LVCMOS33 | 8 | UP | OFF | ON | OFF | SLOW | OFF | OFF | OFF | 3.3 | MEDIUM | NONE
F14/1 | - | in | IOT80[B] | TPLL0_C_IN1/TPLL0_C_FB1 | LVCMOS33 | 8 | UP | OFF | ON | OFF | SLOW | OFF | OFF | OFF | 3.3 | MEDIUM | NONE
D14/1 | - | in | IOT82[A] | PCIE_HOST_RSTN/TPLL0_T_IN2/TPLL0_T_FB0 | LVCMOS33 | 8 | UP | OFF | ON | OFF | SLOW | OFF | OFF | OFF | 3.3 | MEDIUM | NONE
D15/1 | - | in | IOT82[B] | TPLL0_C_IN2/TPLL0_C_FB0 | LVCMOS33 | 8 | UP | OFF | ON | OFF | SLOW | OFF | OFF | OFF | 3.3 | MEDIUM | NONE
C14/1 | mpr_sda[1] | io | IOT85[A] | - | LVCMOS33 | 4 | NONE | OFF | OFF | OFF | SLOW | OFF | OFF | OFF | 3.3 | MEDIUM | NONE
C15/1 | mpr_scl[1] | io | IOT85[B] | - | LVCMOS33 | 4 | NONE | OFF | OFF | OFF | SLOW | OFF | OFF | OFF | 3.3 | MEDIUM | NONE
E16/1 | - | in | IOT87[A] | - | LVCMOS33 | 8 | UP | OFF | ON | OFF | SLOW | OFF | OFF | OFF | 3.3 | MEDIUM | NONE
D16/1 | - | in | IOT87[B] | - | LVCMOS33 | 8 | UP | OFF | ON | OFF | SLOW | OFF | OFF | OFF | 3.3 | MEDIUM | NONE
F16/1 | - | in | IOT89[A] | Q0REF_T_IN0 | LVCMOS33 | 8 | UP | OFF | ON | OFF | SLOW | OFF | OFF | OFF | 3.3 | MEDIUM | NONE
E17/1 | - | in | IOT89[B] | Q0REF_C_IN0 | LVCMOS33 | 8 | UP | OFF | ON | OFF | SLOW | OFF | OFF | OFF | 3.3 | MEDIUM | NONE
F15/1 | - | in | IOT91[A] | - | LVCMOS33 | 8 | UP | OFF | ON | OFF | SLOW | OFF | OFF | OFF | 3.3 | MEDIUM | NONE
C13/1 | mpr_sda[2] | io | IOT93[A] | - | LVCMOS33 | 4 | NONE | OFF | OFF | OFF | SLOW | OFF | OFF | OFF | 3.3 | MEDIUM | NONE
B13/1 | mpr_scl[2] | io | IOT93[B] | - | LVCMOS33 | 4 | NONE | OFF | OFF | OFF | SLOW | OFF | OFF | OFF | 3.3 | MEDIUM | NONE
A13/1 | uart_tx | out | IOT95[A] | - | LVCMOS33 | 4 | NONE | OFF | OFF | OFF | SLOW | OFF | OFF | OFF | 3.3 | MEDIUM | NONE
A14/1 | uart_rx | in | IOT95[B] | - | LVCMOS33 | OFF | UP | OFF | ON | OFF | SLOW | OFF | OFF | OFF | 3.3 | MEDIUM | NONE
B15/1 | mpr_irq_n[1] | in | IOT97[A] | - | LVCMOS33 | OFF | UP | OFF | ON | OFF | SLOW | OFF | OFF | OFF | 3.3 | MEDIUM | NONE
B16/1 | mpr_irq_n[0] | in | IOT97[B] | - | LVCMOS33 | OFF | UP | OFF | ON | OFF | SLOW | OFF | OFF | OFF | 3.3 | MEDIUM | NONE
A15/1 | guide_led_data | out | IOT99[A] | - | LVCMOS33 | 4 | NONE | OFF | OFF | OFF | SLOW | OFF | OFF | OFF | 3.3 | MEDIUM | NONE
A16/1 | mpr_irq_n[2] | in | IOT99[B] | - | LVCMOS33 | OFF | UP | OFF | ON | OFF | SLOW | OFF | OFF | OFF | 3.3 | MEDIUM | NONE
B17/1 | - | in | IOT104[A] | GCLKT_1 | LVCMOS33 | 8 | UP | OFF | ON | OFF | SLOW | OFF | OFF | OFF | 3.3 | MEDIUM | NONE
B18/1 | - | in | IOT104[B] | GCLKC_1 | LVCMOS33 | 8 | UP | OFF | ON | OFF | SLOW | OFF | OFF | OFF | 3.3 | MEDIUM | NONE
D17/1 | - | in | IOT106[A] | GCLKT_0 | LVCMOS33 | 8 | UP | OFF | ON | OFF | SLOW | OFF | OFF | OFF | 3.3 | MEDIUM | NONE
C17/1 | - | in | IOT106[B] | GCLKC_0 | LVCMOS33 | 8 | UP | OFF | ON | OFF | SLOW | OFF | OFF | OFF | 3.3 | MEDIUM | NONE
A18/2 | - | in | IOT113[A] | Q0REF_T_IN1 | LVCMOS33 | 8 | UP | OFF | ON | OFF | SLOW | OFF | OFF | OFF | 3.3 | MEDIUM | NONE
A19/2 | - | in | IOT113[B] | Q0REF_C_IN1 | LVCMOS33 | 8 | UP | OFF | ON | OFF | SLOW | OFF | OFF | OFF | 3.3 | MEDIUM | NONE
C18/2 | - | in | IOT115[A] | GCLKT_3 | LVCMOS33 | 8 | UP | OFF | ON | OFF | SLOW | OFF | OFF | OFF | 3.3 | MEDIUM | NONE
C19/2 | - | in | IOT115[B] | GCLKC_3 | LVCMOS33 | 8 | UP | OFF | ON | OFF | SLOW | OFF | OFF | OFF | 3.3 | MEDIUM | NONE
F18/2 | - | in | IOT117[A] | - | LVCMOS33 | 8 | UP | OFF | ON | OFF | SLOW | OFF | OFF | OFF | 3.3 | MEDIUM | NONE
E18/2 | - | in | IOT117[B] | - | LVCMOS33 | 8 | UP | OFF | ON | OFF | SLOW | OFF | OFF | OFF | 3.3 | MEDIUM | NONE
E19/2 | - | in | IOT120[A] | GCLKT_2 | LVCMOS33 | 8 | UP | OFF | ON | OFF | SLOW | OFF | OFF | OFF | 3.3 | MEDIUM | NONE
D19/2 | - | in | IOT120[B] | GCLKC_2 | LVCMOS33 | 8 | UP | OFF | ON | OFF | SLOW | OFF | OFF | OFF | 3.3 | MEDIUM | NONE
B20/2 | - | in | IOT122[A] | - | LVCMOS33 | 8 | UP | OFF | ON | OFF | SLOW | OFF | OFF | OFF | 3.3 | MEDIUM | NONE
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
AB18/8 | - | in | IOB77[B] | BPLL1_C_IN2/BPLL1_C_FB0 | LVCMOS33 | 8 | UP | OFF | ON | OFF | SLOW | OFF | OFF | OFF | 3.3 | MEDIUM | NONE
V17/8 | - | in | IOB79[A] | CSI_B | LVCMOS33 | 8 | UP | OFF | ON | OFF | SLOW | OFF | OFF | OFF | 3.3 | MEDIUM | NONE
W17/8 | - | in | IOB79[B] | - | LVCMOS33 | 8 | UP | OFF | ON | OFF | SLOW | OFF | OFF | OFF | 3.3 | MEDIUM | NONE
V18/8 | - | in | IOB81[A] | GCLKT_11 | LVCMOS33 | 8 | UP | OFF | ON | OFF | SLOW | OFF | OFF | OFF | 3.3 | MEDIUM | NONE
V19/8 | - | in | IOB81[B] | GCLKC_11 | LVCMOS33 | 8 | UP | OFF | ON | OFF | SLOW | OFF | OFF | OFF | 3.3 | MEDIUM | NONE
AA19/8 | - | in | IOB85[A] | RDWR_B | LVCMOS33 | 8 | DOWN | OFF | ON | OFF | SLOW | OFF | OFF | OFF | 3.3 | MEDIUM | NONE
AB20/8 | - | out | IOB85[B] | CSO_B/DOUT | LVCMOS33 | 8 | UP | OFF | OFF | OFF | SLOW | OFF | OFF | OFF | 3.3 | MEDIUM | NONE
Y18/8 | - | in | IOB87[A] | GCLKT_10 | LVCMOS33 | 8 | UP | OFF | ON | OFF | SLOW | OFF | OFF | OFF | 3.3 | MEDIUM | NONE
Y19/8 | - | in | IOB87[B] | GCLKC_10 | LVCMOS33 | 8 | UP | OFF | ON | OFF | SLOW | OFF | OFF | OFF | 3.3 | MEDIUM | NONE
AB15/8 | - | in | IOB89[A] | - | LVCMOS33 | 8 | UP | OFF | ON | OFF | SLOW | OFF | OFF | OFF | 3.3 | MEDIUM | NONE
AA14/8 | - | in | IOB89[B] | - | LVCMOS33 | 8 | UP | OFF | ON | OFF | SLOW | OFF | OFF | OFF | 3.3 | MEDIUM | NONE
W14/8 | - | in | IOB91[A] | - | LVCMOS33 | 8 | UP | OFF | ON | OFF | SLOW | OFF | OFF | OFF | 3.3 | MEDIUM | NONE
V14/8 | - | in | IOB91[B] | - | LVCMOS33 | 8 | UP | OFF | ON | OFF | SLOW | OFF | OFF | OFF | 3.3 | MEDIUM | NONE
W19/8 | - | in | IOB93[A] | GCLKT_9 | LVCMOS33 | 8 | UP | OFF | ON | OFF | SLOW | OFF | OFF | OFF | 3.3 | MEDIUM | NONE
W20/8 | - | in | IOB93[B] | GCLKC_9 | LVCMOS33 | 8 | UP | OFF | ON | OFF | SLOW | OFF | OFF | OFF | 3.3 | MEDIUM | NONE
U20/8 | - | in | IOB95[A] | GCLKT_8 | LVCMOS33 | 8 | UP | OFF | ON | OFF | SLOW | OFF | OFF | OFF | 3.3 | MEDIUM | NONE
V20/8 | - | in | IOB95[B] | GCLKC_8 | LVCMOS33 | 8 | UP | OFF | ON | OFF | SLOW | OFF | OFF | OFF | 3.3 | MEDIUM | NONE
AB21/8 | i2s_lrclk | out | IOB97[A] | D14 | LVCMOS33 | 4 | NONE | OFF | OFF | OFF | SLOW | OFF | OFF | OFF | 3.3 | MEDIUM | NONE
AB22/8 | - | in | IOB97[B] | D15 | LVCMOS33 | 8 | NONE | OFF | ON | OFF | SLOW | OFF | OFF | OFF | 3.3 | MEDIUM | NONE
Y21/8 | i2s_bclk | out | IOB99[A] | - | LVCMOS33 | 4 | NONE | OFF | OFF | OFF | SLOW | OFF | OFF | OFF | 3.3 | MEDIUM | NONE
Y22/8 | - | in | IOB99[B] | D13 | LVCMOS33 | 8 | NONE | OFF | ON | OFF | SLOW | OFF | OFF | OFF | 3.3 | MEDIUM | NONE
AA20/7 | i2s_data | out | IOB102[A] | D11 | LVCMOS33 | 4 | NONE | OFF | OFF | OFF | SLOW | OFF | OFF | OFF | 3.3 | MEDIUM | NONE
AA21/7 | - | in | IOB102[B] | D12 | LVCMOS33 | 8 | NONE | OFF | ON | OFF | SLOW | OFF | OFF | OFF | 3.3 | MEDIUM | NONE
W21/7 | - | in | IOB104[A] | D09 | LVCMOS33 | 8 | NONE | OFF | ON | OFF | SLOW | OFF | OFF | OFF | 3.3 | MEDIUM | NONE
W22/7 | - | in | IOB104[B] | D10 | LVCMOS33 | 8 | NONE | OFF | ON | OFF | SLOW | OFF | OFF | OFF | 3.3 | MEDIUM | NONE
AA16/7 | - | in | IOB106[A] | - | LVCMOS33 | 8 | UP | OFF | ON | OFF | SLOW | OFF | OFF | OFF | 3.3 | MEDIUM | NONE
AA15/7 | - | in | IOB106[B] | - | LVCMOS33 | 8 | UP | OFF | ON | OFF | SLOW | OFF | OFF | OFF | 3.3 | MEDIUM | NONE
AB17/7 | - | in | IOB108[A] | - | LVCMOS33 | 8 | UP | OFF | ON | OFF | SLOW | OFF | OFF | OFF | 3.3 | MEDIUM | NONE
AB16/7 | pa_disable | out | IOB108[B] | - | LVCMOS33 | 4 | NONE | OFF | OFF | OFF | SLOW | OFF | OFF | OFF | 3.3 | MEDIUM | NONE
T19/7 | - | in | IOB111[A] | MCS_N | LVCMOS33 | 8 | UP | OFF | ON | OFF | SLOW | OFF | OFF | OFF | 3.3 | MEDIUM | NONE
T20/7 | - | in | IOB111[B] | D08 | LVCMOS33 | 8 | NONE | OFF | ON | OFF | SLOW | OFF | OFF | OFF | 3.3 | MEDIUM | NONE
P19/7 | - | in | IOB113[A] | D06 | LVCMOS33 | 8 | UP | OFF | ON | OFF | SLOW | OFF | OFF | OFF | 3.3 | MEDIUM | NONE
R19/7 | - | in | IOB113[B] | D07 | LVCMOS33 | 8 | UP | OFF | ON | OFF | SLOW | OFF | OFF | OFF | 3.3 | MEDIUM | NONE
T21/7 | - | in | IOB115[A] | D04 | LVCMOS33 | 8 | UP | OFF | ON | OFF | SLOW | OFF | OFF | OFF | 3.3 | MEDIUM | NONE
U21/7 | - | in | IOB115[B] | D05 | LVCMOS33 | 8 | UP | OFF | ON | OFF | SLOW | OFF | OFF | OFF | 3.3 | MEDIUM | NONE
U22/7 | - | in | IOB117[A] | PUDC_B | LVCMOS33 | 8 | DOWN | OFF | ON | OFF | SLOW | OFF | OFF | OFF | 3.3 | MEDIUM | NONE
V22/7 | sys_clk | in | IOB117[B] | EMCCLK | LVCMOS33 | OFF | NONE | OFF | ON | OFF | SLOW | OFF | OFF | OFF | 3.3 | MEDIUM | NONE
P21/7 | - | in | IOB120[A] | D02/MI2 | LVCMOS33 | 8 | UP | OFF | ON | OFF | SLOW | OFF | OFF | OFF | 3.3 | MEDIUM | NONE
R21/7 | - | in | IOB120[B] | D03/MI3 | LVCMOS33 | 8 | UP | OFF | ON | OFF | SLOW | OFF | OFF | OFF | 3.3 | MEDIUM | NONE
Y17/7 | - | in | IOB122[A] | - | LVCMOS33 | 8 | UP | OFF | ON | OFF | SLOW | OFF | OFF | OFF | 3.3 | MEDIUM | NONE
Y16/7 | - | in | IOB122[B] | - | LVCMOS33 | 8 | UP | OFF | ON | OFF | SLOW | OFF | OFF | OFF | 3.3 | MEDIUM | NONE
P20/7 | - | in | IOB124[A] | - | LVCMOS33 | 8 | UP | OFF | ON | OFF | SLOW | OFF | OFF | OFF | 3.3 | MEDIUM | NONE
V13/7 | - | in | IOB124[B] | - | LVCMOS33 | 8 | UP | OFF | ON | OFF | SLOW | OFF | OFF | OFF | 3.3 | MEDIUM | NONE
W16/7 | - | in | IOB126[A] | - | LVCMOS33 | 8 | UP | OFF | ON | OFF | SLOW | OFF | OFF | OFF | 3.3 | MEDIUM | NONE
W15/7 | - | in | IOB126[B] | - | LVCMOS33 | 8 | UP | OFF | ON | OFF | SLOW | OFF | OFF | OFF | 3.3 | MEDIUM | NONE
P22/6 | - | in | IOB128[A] | D00/MOSI/MI0 | LVCMOS33 | 8 | UP | OFF | ON | OFF | SLOW | OFF | OFF | OFF | 3.3 | MEDIUM | NONE
R22/6 | - | in | IOB128[B] | D01/DIN/MISO/MI1 | LVCMOS33 | 8 | UP | OFF | ON | OFF | SLOW | OFF | OFF | OFF | 3.3 | MEDIUM | NONE
V15/6 | - | in | IOB130[A] | - | LVCMOS33 | 8 | UP | OFF | ON | OFF | SLOW | OFF | OFF | OFF | 3.3 | MEDIUM | NONE
U15/6 | - | in | IOB130[B] | - | LVCMOS33 | 8 | UP | OFF | ON | OFF | SLOW | OFF | OFF | OFF | 3.3 | MEDIUM | NONE
T15/6 | - | in | IOB132[A] | - | LVCMOS33 | 8 | UP | OFF | ON | OFF | SLOW | OFF | OFF | OFF | 3.3 | MEDIUM | NONE
T14/6 | - | in | IOB132[B] | - | LVCMOS33 | 8 | UP | OFF | ON | OFF | SLOW | OFF | OFF | OFF | 3.3 | MEDIUM | NONE
U16/6 | - | in | IOB134[A] | - | LVCMOS33 | 8 | UP | OFF | ON | OFF | SLOW | OFF | OFF | OFF | 3.3 | MEDIUM | NONE
N15/6 | - | in | IOB134[B] | - | LVCMOS33 | 8 | UP | OFF | ON | OFF | SLOW | OFF | OFF | OFF | 3.3 | MEDIUM | NONE
P16/6 | - | in | IOB136[A] | - | LVCMOS33 | 8 | UP | OFF | ON | OFF | SLOW | OFF | OFF | OFF | 3.3 | MEDIUM | NONE
R17/6 | - | in | IOB136[B] | - | LVCMOS33 | 8 | UP | OFF | ON | OFF | SLOW | OFF | OFF | OFF | 3.3 | MEDIUM | NONE
N13/6 | - | in | IOB138[A] | - | LVCMOS33 | 8 | UP | OFF | ON | OFF | SLOW | OFF | OFF | OFF | 3.3 | MEDIUM | NONE
N14/6 | - | in | IOB138[B] | - | LVCMOS33 | 8 | UP | OFF | ON | OFF | SLOW | OFF | OFF | OFF | 3.3 | MEDIUM | NONE
N17/6 | - | in | IOB140[A] | - | LVCMOS33 | 8 | UP | OFF | ON | OFF | SLOW | OFF | OFF | OFF | 3.3 | MEDIUM | NONE
P17/6 | - | in | IOB140[B] | - | LVCMOS33 | 8 | UP | OFF | ON | OFF | SLOW | OFF | OFF | OFF | 3.3 | MEDIUM | NONE
P15/6 | - | in | IOB142[A] | - | LVCMOS33 | 8 | UP | OFF | ON | OFF | SLOW | OFF | OFF | OFF | 3.3 | MEDIUM | NONE
R16/6 | - | in | IOB142[B] | - | LVCMOS33 | 8 | UP | OFF | ON | OFF | SLOW | OFF | OFF | OFF | 3.3 | MEDIUM | NONE
R18/6 | - | in | IOB144[A] | - | LVCMOS33 | 8 | UP | OFF | ON | OFF | SLOW | OFF | OFF | OFF | 3.3 | MEDIUM | NONE
T18/6 | - | in | IOB144[B] | - | LVCMOS33 | 8 | UP | OFF | ON | OFF | SLOW | OFF | OFF | OFF | 3.3 | MEDIUM | NONE
P14/6 | - | in | IOB146[A] | - | LVCMOS33 | 8 | UP | OFF | ON | OFF | SLOW | OFF | OFF | OFF | 3.3 | MEDIUM | NONE
R14/6 | - | in | IOB146[B] | - | LVCMOS33 | 8 | UP | OFF | ON | OFF | SLOW | OFF | OFF | OFF | 3.3 | MEDIUM | NONE
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
L4/10 | - | in | IOL59[B] | - | LVCMOS33 | 8 | UP | OFF | ON | OFF | SLOW | OFF | OFF | OFF | 3.3 | MEDIUM | NONE
N4/10 | - | in | IOL61[A] | - | LVCMOS33 | 8 | UP | OFF | ON | OFF | SLOW | OFF | OFF | OFF | 3.3 | MEDIUM | NONE
N3/10 | - | in | IOL61[B] | - | LVCMOS33 | 8 | UP | OFF | ON | OFF | SLOW | OFF | OFF | OFF | 3.3 | MEDIUM | NONE
R1/10 | - | in | IOL63[A] | LPLL1_T_IN0 | LVCMOS33 | 8 | UP | OFF | ON | OFF | SLOW | OFF | OFF | OFF | 3.3 | MEDIUM | NONE
P1/10 | - | in | IOL63[B] | LPLL1_C_IN0 | LVCMOS33 | 8 | UP | OFF | ON | OFF | SLOW | OFF | OFF | OFF | 3.3 | MEDIUM | NONE
L6/10 | - | in | IOL65[A] | - | LVCMOS33 | 8 | UP | OFF | ON | OFF | SLOW | OFF | OFF | OFF | 3.3 | MEDIUM | NONE
P5/10 | - | in | IOL66[A] | LPLL1_T_IN1/LPLL1_T_FB0 | LVCMOS33 | 8 | UP | OFF | ON | OFF | SLOW | OFF | OFF | OFF | 3.3 | MEDIUM | NONE
P4/10 | - | in | IOL66[B] | LPLL1_C_IN1/LPLL1_C_FB0 | LVCMOS33 | 8 | UP | OFF | ON | OFF | SLOW | OFF | OFF | OFF | 3.3 | MEDIUM | NONE
P2/10 | - | in | IOL68[A] | LPLL1_T_IN2/LPLL1_T_FB0 | LVCMOS33 | 8 | UP | OFF | ON | OFF | SLOW | OFF | OFF | OFF | 3.3 | MEDIUM | NONE
N2/10 | - | in | IOL68[B] | LPLL1_C_IN2/LPLL1_C_FB0 | LVCMOS33 | 8 | UP | OFF | ON | OFF | SLOW | OFF | OFF | OFF | 3.3 | MEDIUM | NONE
M6/10 | - | in | IOL70[A] | BPLL0_T_IN0 | LVCMOS33 | 8 | UP | OFF | ON | OFF | SLOW | OFF | OFF | OFF | 3.3 | MEDIUM | NONE
M5/10 | - | in | IOL70[B] | BPLL0_C_IN0 | LVCMOS33 | 8 | UP | OFF | ON | OFF | SLOW | OFF | OFF | OFF | 3.3 | MEDIUM | NONE
P6/10 | - | in | IOL72[A] | - | LVCMOS33 | 8 | UP | OFF | ON | OFF | SLOW | OFF | OFF | OFF | 3.3 | MEDIUM | NONE
N5/10 | - | in | IOL72[B] | - | LVCMOS33 | 8 | UP | OFF | ON | OFF | SLOW | OFF | OFF | OFF | 3.3 | MEDIUM | NONE
V12/12 | - | in | IOR1[A] | TCK | LVCMOS33 | 8 | UP | OFF | ON | OFF | SLOW | OFF | OFF | OFF | 3.3 | MEDIUM | NONE
R13/12 | - | in | IOR1[B] | TDI | LVCMOS33 | 8 | UP | OFF | ON | OFF | SLOW | OFF | OFF | OFF | 3.3 | MEDIUM | NONE
T13/12 | - | in | IOR3[A] | TMS | LVCMOS33 | 8 | UP | OFF | ON | OFF | SLOW | OFF | OFF | OFF | 3.3 | MEDIUM | NONE
U13/12 | - | out | IOR3[B] | TDO | LVCMOS33 | 8 | UP | OFF | OFF | OFF | SLOW | OFF | OFF | OFF | 3.3 | MEDIUM | NONE
L12/3 | - | in | IOR5[A] | CCLK | LVCMOS33 | 8 | UP | OFF | ON | OFF | SLOW | OFF | OFF | OFF | 3.3 | MEDIUM | NONE
U12/3 | - | in | IOR5[B] | READY | LVCMOS33 | 8 | UP | OFF | ON | OFF | SLOW | OFF | OFF | OFF | 3.3 | MEDIUM | NONE
U10/3 | - | in | IOR7[A] | MODE1 | LVCMOS33 | 8 | UP | OFF | ON | OFF | SLOW | OFF | OFF | OFF | 3.3 | MEDIUM | NONE
U11/3 | - | in | IOR7[B] | MODE0 | LVCMOS33 | 8 | UP | OFF | ON | OFF | SLOW | OFF | OFF | OFF | 3.3 | MEDIUM | NONE
G11/3 | - | in | IOR9[A] | DONE | LVCMOS33 | 8 | UP | OFF | ON | OFF | SLOW | OFF | OFF | OFF | 3.3 | MEDIUM | NONE
N12/3 | - | in | IOR9[B] | RECONFIG_N | LVCMOS33 | 8 | UP | OFF | ON | OFF | SLOW | OFF | OFF | OFF | 3.3 | MEDIUM | NONE
U8/3 | - | in | IOR11[A] | TPLL1_T_IN0/TPLL1_T_FB1 | LVCMOS33 | 8 | UP | OFF | ON | OFF | SLOW | OFF | OFF | OFF | 3.3 | MEDIUM | NONE
U9/3 | - | in | IOR11[B] | MODE2/TPLL1_C_IN0/TPLL1_C_FB1 | LVCMOS33 | 8 | UP | OFF | ON | OFF | SLOW | OFF | OFF | OFF | 3.3 | MEDIUM | NONE
H13/4 | - | in | IOR20[A] | - | LVCMOS33 | 8 | UP | OFF | ON | OFF | SLOW | OFF | OFF | OFF | 3.3 | MEDIUM | NONE
G13/4 | - | in | IOR20[B] | - | LVCMOS33 | 8 | UP | OFF | ON | OFF | SLOW | OFF | OFF | OFF | 3.3 | MEDIUM | NONE
J15/4 | tmds_data_p[1] | out | IOR22[A] | - | LVDS25 | 3.5 | NONE | OFF | OFF | NONE | NONE | OFF | OFF | OFF | 3.3 | MEDIUM | NONE
H15/4 | tmds_data_n[1] | out | IOR22[B] | - | LVDS25 | 3.5 | NONE | OFF | OFF | NONE | NONE | OFF | OFF | OFF | 3.3 | MEDIUM | NONE
G15/4 | tmds_clk_p | out | IOR24[A] | - | LVDS25 | 3.5 | NONE | OFF | OFF | NONE | NONE | OFF | OFF | OFF | 3.3 | MEDIUM | NONE
G16/4 | tmds_clk_n | out | IOR24[B] | - | LVDS25 | 3.5 | NONE | OFF | OFF | NONE | NONE | OFF | OFF | OFF | 3.3 | MEDIUM | NONE
J14/4 | tmds_data_p[0] | out | IOR26[A] | - | LVDS25 | 3.5 | NONE | OFF | OFF | NONE | NONE | OFF | OFF | OFF | 3.3 | MEDIUM | NONE
H14/4 | tmds_data_n[0] | out | IOR26[B] | - | LVDS25 | 3.5 | NONE | OFF | OFF | NONE | NONE | OFF | OFF | OFF | 3.3 | MEDIUM | NONE
G17/4 | - | in | IOR30[A] | - | LVCMOS33 | 8 | UP | OFF | ON | OFF | SLOW | OFF | OFF | OFF | 3.3 | MEDIUM | NONE
G18/4 | - | in | IOR30[B] | - | LVCMOS33 | 8 | UP | OFF | ON | OFF | SLOW | OFF | OFF | OFF | 3.3 | MEDIUM | NONE
H17/4 | - | in | IOR32[A] | - | LVCMOS33 | 8 | UP | OFF | ON | OFF | SLOW | OFF | OFF | OFF | 3.3 | MEDIUM | NONE
H18/4 | - | in | IOR32[B] | - | LVCMOS33 | 8 | UP | OFF | ON | OFF | SLOW | OFF | OFF | OFF | 3.3 | MEDIUM | NONE
L16/4 | - | in | IOR34[A] | - | LVCMOS33 | 8 | UP | OFF | ON | OFF | SLOW | OFF | OFF | OFF | 3.3 | MEDIUM | NONE
K16/4 | - | in | IOR34[B] | - | LVCMOS33 | 8 | UP | OFF | ON | OFF | SLOW | OFF | OFF | OFF | 3.3 | MEDIUM | NONE
K13/4 | hdmi_enable | out | IOR36[A] | RPLL0_T_IN1/RPLL0_T_FB0 | LVCMOS33 | 12 | UP | OFF | OFF | OFF | SLOW | OFF | OFF | OFF | 3.3 | MEDIUM | NONE
K14/4 | - | in | IOR36[B] | RPLL0_C_IN1/RPLL0_C_FB0 | LVCMOS33 | 8 | UP | OFF | ON | OFF | SLOW | OFF | OFF | OFF | 3.3 | MEDIUM | NONE
K17/5 | tmds_data_p[2] | out | IOR39[A] | RPLL0_T_IN0/RPLL0_T_FB1 | LVDS25 | 3.5 | NONE | OFF | OFF | NONE | NONE | OFF | OFF | OFF | 3.3 | MEDIUM | NONE
J17/5 | tmds_data_n[2] | out | IOR39[B] | RPLL0_C_IN0/RPLL0_C_FB1 | LVDS25 | 3.5 | NONE | OFF | OFF | NONE | NONE | OFF | OFF | OFF | 3.3 | MEDIUM | NONE
J19/5 | - | in | IOR41[A] | GCLKT_7 | LVCMOS33 | 8 | UP | OFF | ON | OFF | SLOW | OFF | OFF | OFF | 3.3 | MEDIUM | NONE
H19/5 | - | in | IOR41[B] | GCLKC_7 | LVCMOS33 | 8 | UP | OFF | ON | OFF | SLOW | OFF | OFF | OFF | 3.3 | MEDIUM | NONE
H20/5 | - | in | IOR43[A] | - | LVCMOS33 | 8 | UP | OFF | ON | OFF | SLOW | OFF | OFF | OFF | 3.3 | MEDIUM | NONE
G20/5 | - | in | IOR43[B] | - | LVCMOS33 | 8 | UP | OFF | ON | OFF | SLOW | OFF | OFF | OFF | 3.3 | MEDIUM | NONE
J22/5 | - | in | IOR45[A] | - | LVCMOS33 | 8 | UP | OFF | ON | OFF | SLOW | OFF | OFF | OFF | 3.3 | MEDIUM | NONE
H22/5 | - | in | IOR45[B] | - | LVCMOS33 | 8 | UP | OFF | ON | OFF | SLOW | OFF | OFF | OFF | 3.3 | MEDIUM | NONE
J16/5 | rgb_data | out | IOR47[A] | - | LVCMOS33 | 8 | NONE | OFF | OFF | OFF | SLOW | OFF | OFF | OFF | 3.3 | MEDIUM | NONE
L14/5 | - | in | IOR48[A] | - | LVCMOS33 | 8 | UP | OFF | ON | OFF | SLOW | OFF | OFF | OFF | 3.3 | MEDIUM | NONE
L15/5 | - | in | IOR48[B] | - | LVCMOS33 | 8 | UP | OFF | ON | OFF | SLOW | OFF | OFF | OFF | 3.3 | MEDIUM | NONE
M13/5 | - | in | IOR50[A] | - | LVCMOS33 | 8 | UP | OFF | ON | OFF | SLOW | OFF | OFF | OFF | 3.3 | MEDIUM | NONE
L13/5 | - | in | IOR50[B] | - | LVCMOS33 | 8 | UP | OFF | ON | OFF | SLOW | OFF | OFF | OFF | 3.3 | MEDIUM | NONE
M15/5 | - | in | IOR52[A] | - | LVCMOS33 | 8 | UP | OFF | ON | OFF | SLOW | OFF | OFF | OFF | 3.3 | MEDIUM | NONE
M16/5 | - | in | IOR52[B] | - | LVCMOS33 | 8 | UP | OFF | ON | OFF | SLOW | OFF | OFF | OFF | 3.3 | MEDIUM | NONE
J20/5 | - | in | IOR54[A] | GCLKT_5 | LVCMOS33 | 8 | UP | OFF | ON | OFF | SLOW | OFF | OFF | OFF | 3.3 | MEDIUM | NONE
J21/5 | - | in | IOR54[B] | GCLKC_5 | LVCMOS33 | 8 | UP | OFF | ON | OFF | SLOW | OFF | OFF | OFF | 3.3 | MEDIUM | NONE
M17/5 | - | in | IOR56[A] | - | LVCMOS33 | 8 | UP | OFF | ON | OFF | SLOW | OFF | OFF | OFF | 3.3 | MEDIUM | NONE
K18/5 | - | in | IOR57[A] | GCLKT_6 | LVCMOS33 | 8 | UP | OFF | ON | OFF | SLOW | OFF | OFF | OFF | 3.3 | MEDIUM | NONE
K19/5 | - | in | IOR57[B] | GCLKC_6 | LVCMOS33 | 8 | UP | OFF | ON | OFF | SLOW | OFF | OFF | OFF | 3.3 | MEDIUM | NONE
K21/5 | - | in | IOR59[A] | - | LVCMOS33 | 8 | UP | OFF | ON | OFF | SLOW | OFF | OFF | OFF | 3.3 | MEDIUM | NONE
K22/5 | - | in | IOR59[B] | - | LVCMOS33 | 8 | UP | OFF | ON | OFF | SLOW | OFF | OFF | OFF | 3.3 | MEDIUM | NONE
L19/5 | - | in | IOR61[A] | SDA/GCLKT_4/RPLL1_T_IN2/RPLL1_T_FB0 | LVCMOS33 | 8 | UP | OFF | ON | OFF | SLOW | OFF | OFF | OFF | 3.3 | MEDIUM | NONE
L20/5 | - | in | IOR61[B] | SCL/GCLKC_4/RPLL1_C_IN2/RPLL1_C_FB0 | LVCMOS33 | 8 | UP | OFF | ON | OFF | SLOW | OFF | OFF | OFF | 3.3 | MEDIUM | NONE
N22/5 | - | in | IOR63[A] | SI/SSI0 | LVCMOS33 | 8 | UP | OFF | ON | OFF | SLOW | OFF | OFF | OFF | 3.3 | MEDIUM | NONE
M22/5 | - | in | IOR63[B] | SSPI_CS_N | LVCMOS33 | 8 | UP | OFF | ON | OFF | SLOW | OFF | OFF | OFF | 3.3 | MEDIUM | NONE
M18/5 | - | in | IOR66[A] | SO/SSI1/RPLL1_T_IN1/RPLL1_T_FB1 | LVCMOS33 | 8 | UP | OFF | ON | OFF | SLOW | OFF | OFF | OFF | 3.3 | MEDIUM | NONE
L18/5 | - | in | IOR66[B] | SSPI_CLK/RPLL1_C_IN1/RPLL1_C_FB1 | LVCMOS33 | 8 | UP | OFF | ON | OFF | SLOW | OFF | OFF | OFF | 3.3 | MEDIUM | NONE
M21/5 | - | in | IOR68[A] | - | LVCMOS33 | 8 | UP | OFF | ON | OFF | SLOW | OFF | OFF | OFF | 3.3 | MEDIUM | NONE
L21/5 | - | in | IOR68[B] | - | LVCMOS33 | 8 | UP | OFF | ON | OFF | SLOW | OFF | OFF | OFF | 3.3 | MEDIUM | NONE
N20/5 | - | in | IOR70[A] | SSPI_WPN/SSI2 | LVCMOS33 | 8 | UP | OFF | ON | OFF | SLOW | OFF | OFF | OFF | 3.3 | MEDIUM | NONE
M20/5 | - | in | IOR70[B] | CLKHOLD_N/SSI3 | LVCMOS33 | 8 | UP | OFF | ON | OFF | SLOW | OFF | OFF | OFF | 3.3 | MEDIUM | NONE
N18/5 | - | in | IOR72[A] | RPLL1_T_IN0 | LVCMOS33 | 8 | UP | OFF | ON | OFF | SLOW | OFF | OFF | OFF | 3.3 | MEDIUM | NONE
N19/5 | - | in | IOR72[B] | RPLL1_C_IN0 | LVCMOS33 | 8 | UP | OFF | ON | OFF | SLOW | OFF | OFF | OFF | 3.3 | MEDIUM | NONE
N9/ADC | - | in | ADCTN | - | - | - | - | - | - | - | - | - | - | - | - | - | -
N10/ADC | - | in | ADCTP | - | - | - | - | - | - | - | - | - | - | - | - | - | -
M9/ADC | - | in | ADCVN | - | - | - | - | - | - | - | - | - | - | - | - | - | -
L10/ADC | - | in | ADCVP | - | - | - | - | - | - | - | - | - | - | - | - | - | -
F8/Q0 | - | inout | Q0_ATEST_O | - | - | - | - | - | - | - | - | - | - | - | - | - | -
A8/Q0 | - | in | Q0_LN0_RXM_I | - | - | - | - | - | - | - | - | - | - | - | - | - | -
B8/Q0 | - | in | Q0_LN0_RXP_I | - | - | - | - | - | - | - | - | - | - | - | - | - | -
A4/Q0 | - | out | Q0_LN0_TXM_O | - | - | - | - | - | - | - | - | - | - | - | - | - | -
B4/Q0 | - | out | Q0_LN0_TXP_O | - | - | - | - | - | - | - | - | - | - | - | - | - | -
C11/Q0 | - | in | Q0_LN1_RXM_I | - | - | - | - | - | - | - | - | - | - | - | - | - | -
D11/Q0 | - | in | Q0_LN1_RXP_I | - | - | - | - | - | - | - | - | - | - | - | - | - | -
C5/Q0 | - | out | Q0_LN1_TXM_O | - | - | - | - | - | - | - | - | - | - | - | - | - | -
D5/Q0 | - | out | Q0_LN1_TXP_O | - | - | - | - | - | - | - | - | - | - | - | - | - | -
A10/Q0 | - | in | Q0_LN2_RXM_I | - | - | - | - | - | - | - | - | - | - | - | - | - | -
B10/Q0 | - | in | Q0_LN2_RXP_I | - | - | - | - | - | - | - | - | - | - | - | - | - | -
A6/Q0 | - | out | Q0_LN2_TXM_O | - | - | - | - | - | - | - | - | - | - | - | - | - | -
B6/Q0 | - | out | Q0_LN2_TXP_O | - | - | - | - | - | - | - | - | - | - | - | - | - | -
C9/Q0 | - | in | Q0_LN3_RXM_I | - | - | - | - | - | - | - | - | - | - | - | - | - | -
D9/Q0 | - | in | Q0_LN3_RXP_I | - | - | - | - | - | - | - | - | - | - | - | - | - | -
C7/Q0 | - | out | Q0_LN3_TXM_O | - | - | - | - | - | - | - | - | - | - | - | - | - | -
D7/Q0 | - | out | Q0_LN3_TXP_O | - | - | - | - | - | - | - | - | - | - | - | - | - | -
E6/Q0 | - | in | Q0_REFCLKM_0 | - | - | - | - | - | - | - | - | - | - | - | - | - | -
E10/Q0 | - | in | Q0_REFCLKM_1 | - | - | - | - | - | - | - | - | - | - | - | - | - | -
F6/Q0 | - | in | Q0_REFCLKP_0 | - | - | - | - | - | - | - | - | - | - | - | - | - | -
F10/Q0 | - | in | Q0_REFCLKP_1 | - | - | - | - | - | - | - | - | - | - | - | - | - | -
