wujijun11/git/TangMega60K_Synth/verification/timing-margin-20261014/build_payload-select_20261014_200315_8e6fbc97/full/impl/pnr/ContestFull_tr_cata.html

- Timing Messages
- Timing Summaries
  - STA Tool Run Summary
  - Clock Summary
  - Max Frequency Summary
  - Total Negative Slack Summary
- Timing Details
  - Path Slacks Table
    - Setup Paths Table
    - Hold Paths Table
    - Recovery Paths Table
    - Removal Paths Table
  - Minimum Pulse Width Table
  - Timing Report By Analysis Type
    - Setup Analysis Report
    - Hold Analysis Report
    - Recovery Analysis Report
    - Removal Analysis Report
  - Minimum Pulse Width Report
  - High Fanout Nets Report
  - Route Congestions Report
  - Timing Exceptions Report
    - Setup Analysis Report
    - Hold Analysis Report
    - Recovery Analysis Report
    - Removal Analysis Report
  - Timing Constraints Report
