wujijun11/git/TangMega60K_Synth/verification/timing-margin-20261014/build_payload-select_20261014_200315_8e6fbc97/full/impl/pnr/ContestFull_tr_content.html

# Timing Messages

Report Title | Timing Analysis Report
Design File | C:\Users\asus\Desktop\Git\TangMega60K_Synth\verification\timing-margin-20261014\build_payload-select_20261014_200315_8e6fbc97\full\impl\gwsynthesis\ContestFull.vg
Physical Constraints File | C:\Users\asus\Desktop\Git\TangMega60K_Synth\verification\timing-margin-20261014\build_payload-select_20261014_200315_8e6fbc97\full\contest_full.cst
Timing Constraint File | C:\Users\asus\Desktop\Git\TangMega60K_Synth\verification\timing-margin-20261014\build_payload-select_20261014_200315_8e6fbc97\full\contest_full.sdc
Tool Version | V1.9.12 (64-bit)
Part Number | GW5AT-LV60PG484AC1/I0
Device | GW5AT-60
Device Version | B
Created Time | Wed Oct 14 20:18:43 2026
Legal Announcement | Copyright (C)2014-2025 Gowin Semiconductor Corporation. All rights reserved.

# Timing Summaries

## STA Tool Run Summary:

Setup Delay Model | Slow 0.855V 0C C1/I0
Hold Delay Model | Fast 0.945V 85C C1/I0
Numbers of Paths Analyzed | 92658
Numbers of Endpoints Analyzed | 50300
Numbers of Falling Endpoints | 0
Numbers of Setup Violated Endpoints | 0
Numbers of Hold Violated Endpoints | 0

## Clock Summary:

NO. | Clock Name | Type | Period | Frequency(MHz) | Rise | Fall | Source | Master | Objects
1 | sys_clk | Base | 20.000 | 50.000 | 0.000 | 10.000 | | | sys_clk
2 | audio_clock/pll_38m4/pll/CLKOUT0.default_gen_clk | Generated | 26.042 | 38.400 | 0.000 | 13.021 | sys_clk_ibuf/I | sys_clk | audio_clock/pll_38m4/pll/CLKOUT0
3 | video_clock/pll/CLKOUT0.default_gen_clk | Generated | 8.000 | 125.000 | 0.000 | 4.000 | sys_clk_ibuf/I | sys_clk | video_clock/pll/CLKOUT0
4 | video_clock/pll/CLKOUT1.default_gen_clk | Generated | 40.000 | 25.000 | 0.000 | 20.000 | sys_clk_ibuf/I | sys_clk | video_clock/pll/CLKOUT1
5 | audio_clock/pll_49m152/pll/CLKOUT0.default_gen_clk | Generated | 20.345 | 49.152 | 0.000 | 10.173 | audio_clock/pll_38m4/pll/CLKOUT0 | audio_clock/pll_38m4/pll/CLKOUT0.default_gen_clk | audio_clock/pll_49m152/pll/CLKOUT0

## Max Frequency Summary:

NO. | Clock Name | Constraint | Actual Fmax | Logic Level | Entity
1 | sys_clk | 50.000(MHz) | 150.333(MHz) | 9 | TOP
2 | video_clock/pll/CLKOUT0.default_gen_clk | 125.000(MHz) | 192.377(MHz) | 1 | TOP
3 | video_clock/pll/CLKOUT1.default_gen_clk | 25.000(MHz) | 73.046(MHz) | 16 | TOP
4 | audio_clock/pll_49m152/pll/CLKOUT0.default_gen_clk | 49.152(MHz) | 49.817(MHz) | 16 | TOP

#### No timing paths to get frequency of audio_clock/pll_38m4/pll/CLKOUT0.default_gen_clk!

## Total Negative Slack Summary:

Clock Name | Analysis Type | Endpoints TNS | Number of Endpoints
sys_clk | Setup | 0.000 | 0
sys_clk | Hold | 0.000 | 0
audio_clock/pll_38m4/pll/CLKOUT0.default_gen_clk | Setup | 0.000 | 0
audio_clock/pll_38m4/pll/CLKOUT0.default_gen_clk | Hold | 0.000 | 0
video_clock/pll/CLKOUT0.default_gen_clk | Setup | 0.000 | 0
video_clock/pll/CLKOUT0.default_gen_clk | Hold | 0.000 | 0
video_clock/pll/CLKOUT1.default_gen_clk | Setup | 0.000 | 0
video_clock/pll/CLKOUT1.default_gen_clk | Hold | 0.000 | 0
audio_clock/pll_49m152/pll/CLKOUT0.default_gen_clk | Setup | 0.000 | 0
audio_clock/pll_49m152/pll/CLKOUT0.default_gen_clk | Hold | 0.000 | 0

# Timing Details

## Path Slacks Table:

### Setup Paths Table

#### Report Command:report_timing -setup -max_paths 25 -max_common_paths 1

Path Number | Path Slack | From Node | To Node | From Clock | To Clock | Relation | Clock Skew | Data Delay
1 | 0.272 | system/performance/record_ram_record_ram_0_2_s/DO[1] | system/performance/event_velocity_1_s0/D | audio_clock/pll_49m152/pll/CLKOUT0.default_gen_clk:[R] | audio_clock/pll_49m152/pll/CLKOUT0.default_gen_clk:[R] | 20.345 | 0.009 | 20.000
2 | 0.278 | system/sensors/eventizer/fifo_fifo_0_0_s/DO[13] | system/events/mem[37]_5_s0/CE | audio_clock/pll_49m152/pll/CLKOUT0.default_gen_clk:[R] | audio_clock/pll_49m152/pll/CLKOUT0.default_gen_clk:[R] | 20.345 | 0.000 | 19.756
3 | 0.278 | system/sensors/eventizer/fifo_fifo_0_0_s/DO[13] | system/events/mem[37]_22_s0/CE | audio_clock/pll_49m152/pll/CLKOUT0.default_gen_clk:[R] | audio_clock/pll_49m152/pll/CLKOUT0.default_gen_clk:[R] | 20.345 | 0.000 | 19.756
4 | 0.447 | system/performance/record_ram_record_ram_0_2_s/DO[1] | system/performance/event_velocity_0_s0/D | audio_clock/pll_49m152/pll/CLKOUT0.default_gen_clk:[R] | audio_clock/pll_49m152/pll/CLKOUT0.default_gen_clk:[R] | 20.345 | 0.009 | 19.825
5 | 0.540 | system/sensors/eventizer/fifo_fifo_0_0_s/DO[13] | system/events/mem[35]_22_s0/CE | audio_clock/pll_49m152/pll/CLKOUT0.default_gen_clk:[R] | audio_clock/pll_49m152/pll/CLKOUT0.default_gen_clk:[R] | 20.345 | 0.000 | 19.494
6 | 0.756 | system/performance/record_ram_record_ram_0_2_s/DO[1] | system/performance/event_note_6_s0/D | audio_clock/pll_49m152/pll/CLKOUT0.default_gen_clk:[R] | audio_clock/pll_49m152/pll/CLKOUT0.default_gen_clk:[R] | 20.345 | 0.019 | 19.506
7 | 0.787 | system/sensors/eventizer/fifo_fifo_0_0_s/DO[13] | system/events/mem[35]_5_s0/CE | audio_clock/pll_49m152/pll/CLKOUT0.default_gen_clk:[R] | audio_clock/pll_49m152/pll/CLKOUT0.default_gen_clk:[R] | 20.345 | -0.009 | 19.256
8 | 0.787 | system/sensors/eventizer/fifo_fifo_0_0_s/DO[13] | system/events/mem[35]_6_s0/CE | audio_clock/pll_49m152/pll/CLKOUT0.default_gen_clk:[R] | audio_clock/pll_49m152/pll/CLKOUT0.default_gen_clk:[R] | 20.345 | -0.009 | 19.256
9 | 0.791 | system/sensors/eventizer/fifo_fifo_0_0_s/DO[13] | system/events/mem[39]_4_s0/CE | audio_clock/pll_49m152/pll/CLKOUT0.default_gen_clk:[R] | audio_clock/pll_49m152/pll/CLKOUT0.default_gen_clk:[R] | 20.345 | -0.009 | 19.252
10 | 0.848 | system/performance/record_ram_record_ram_0_2_s/DO[1] | system/performance/event_on_s0/D | audio_clock/pll_49m152/pll/CLKOUT0.default_gen_clk:[R] | audio_clock/pll_49m152/pll/CLKOUT0.default_gen_clk:[R] | 20.345 | 0.009 | 19.424
11 | 0.858 | system/sensors/eventizer/fifo_fifo_0_0_s/DO[13] | system/performance/last_record_ms_0_s0/CE | audio_clock/pll_49m152/pll/CLKOUT0.default_gen_clk:[R] | audio_clock/pll_49m152/pll/CLKOUT0.default_gen_clk:[R] | 20.345 | 0.000 | 19.176
12 | 0.858 | system/sensors/eventizer/fifo_fifo_0_0_s/DO[13] | system/performance/last_record_ms_2_s0/CE | audio_clock/pll_49m152/pll/CLKOUT0.default_gen_clk:[R] | audio_clock/pll_49m152/pll/CLKOUT0.default_gen_clk:[R] | 20.345 | 0.000 | 19.176
13 | 0.858 | system/sensors/eventizer/fifo_fifo_0_0_s/DO[13] | system/performance/last_record_ms_3_s0/CE | audio_clock/pll_49m152/pll/CLKOUT0.default_gen_clk:[R] | audio_clock/pll_49m152/pll/CLKOUT0.default_gen_clk:[R] | 20.345 | 0.000 | 19.176
14 | 0.858 | system/sensors/eventizer/fifo_fifo_0_0_s/DO[13] | system/performance/last_record_ms_4_s0/CE | audio_clock/pll_49m152/pll/CLKOUT0.default_gen_clk:[R] | audio_clock/pll_49m152/pll/CLKOUT0.default_gen_clk:[R] | 20.345 | 0.000 | 19.176
15 | 0.899 | system/sensors/eventizer/fifo_fifo_0_0_s/DO[13] | system/events/mem[39]_3_s0/CE | audio_clock/pll_49m152/pll/CLKOUT0.default_gen_clk:[R] | audio_clock/pll_49m152/pll/CLKOUT0.default_gen_clk:[R] | 20.345 | 0.000 | 19.135
16 | 0.956 | system/performance/record_ram_record_ram_0_2_s/DO[1] | system/performance/event_note_1_s0/D | audio_clock/pll_49m152/pll/CLKOUT0.default_gen_clk:[R] | audio_clock/pll_49m152/pll/CLKOUT0.default_gen_clk:[R] | 20.345 | 0.009 | 19.316
17 | 0.956 | system/performance/record_ram_record_ram_0_2_s/DO[1] | system/performance/event_note_4_s0/D | audio_clock/pll_49m152/pll/CLKOUT0.default_gen_clk:[R] | audio_clock/pll_49m152/pll/CLKOUT0.default_gen_clk:[R] | 20.345 | 0.009 | 19.316
18 | 0.962 | system/sensors/eventizer/fifo_fifo_0_0_s/DO[13] | system/events/mem[39]_8_s0/CE | audio_clock/pll_49m152/pll/CLKOUT0.default_gen_clk:[R] | audio_clock/pll_49m152/pll/CLKOUT0.default_gen_clk:[R] | 20.345 | 0.009 | 19.062
19 | 1.001 | system/performance/record_ram_record_ram_0_2_s/DO[1] | system/performance/event_velocity_3_s0/D | audio_clock/pll_49m152/pll/CLKOUT0.default_gen_clk:[R] | audio_clock/pll_49m152/pll/CLKOUT0.default_gen_clk:[R] | 20.345 | 0.009 | 19.271
20 | 1.004 | system/sensors/eventizer/fifo_fifo_0_0_s/DO[13] | system/events/mem[37]_6_s0/CE | audio_clock/pll_49m152/pll/CLKOUT0.default_gen_clk:[R] | audio_clock/pll_49m152/pll/CLKOUT0.default_gen_clk:[R] | 20.345 | -0.009 | 19.039
21 | 1.004 | system/sensors/eventizer/fifo_fifo_0_0_s/DO[13] | system/events/mem[37]_7_s0/CE | audio_clock/pll_49m152/pll/CLKOUT0.default_gen_clk:[R] | audio_clock/pll_49m152/pll/CLKOUT0.default_gen_clk:[R] | 20.345 | -0.009 | 19.039
22 | 1.004 | system/performance/record_ram_record_ram_0_2_s/DO[1] | system/performance/event_velocity_6_s0/D | audio_clock/pll_49m152/pll/CLKOUT0.default_gen_clk:[R] | audio_clock/pll_49m152/pll/CLKOUT0.default_gen_clk:[R] | 20.345 | 0.009 | 19.268
23 | 1.033 | system/sensors/eventizer/fifo_fifo_0_0_s/DO[13] | system/performance/last_record_ms_30_s0/CE | audio_clock/pll_49m152/pll/CLKOUT0.default_gen_clk:[R] | audio_clock/pll_49m152/pll/CLKOUT0.default_gen_clk:[R] | 20.345 | 0.000 | 19.001
24 | 1.050 | system/sensors/eventizer/fifo_fifo_0_0_s/DO[13] | system/performance/last_record_ms_1_s0/CE | audio_clock/pll_49m152/pll/CLKOUT0.default_gen_clk:[R] | audio_clock/pll_49m152/pll/CLKOUT0.default_gen_clk:[R] | 20.345 | 0.000 | 18.984
25 | 1.082 | system/performance/record_ram_record_ram_0_2_s/DO[1] | system/performance/event_velocity_2_s0/D | audio_clock/pll_49m152/pll/CLKOUT0.default_gen_clk:[R] | audio_clock/pll_49m152/pll/CLKOUT0.default_gen_clk:[R] | 20.345 | 0.009 | 19.190

### Hold Paths Table

#### Report Command:report_timing -hold -max_paths 25 -max_common_paths 1

Path Number | Path Slack | From Node | To Node | From Clock | To Clock | Relation | Clock Skew | Data Delay
1 | 0.035 | system/synth/u_polar0/tR3_17_s0/Q | system/synth/u_polar0/states_states_0_1_s/DI[13] | audio_clock/pll_49m152/pll/CLKOUT0.default_gen_clk:[R] | audio_clock/pll_49m152/pll/CLKOUT0.default_gen_clk:[R] | 0.000 | -0.193 | 0.265
2 | 0.068 | system/synth/u_polar0/tR3_8_s0/Q | system/synth/u_polar0/states_states_0_1_s/DI[4] | audio_clock/pll_49m152/pll/CLKOUT0.default_gen_clk:[R] | audio_clock/pll_49m152/pll/CLKOUT0.default_gen_clk:[R] | 0.000 | -0.197 | 0.302
3 | 0.068 | system/synth/u_polar0/tR3_6_s0/Q | system/synth/u_polar0/states_states_0_1_s/DI[2] | audio_clock/pll_49m152/pll/CLKOUT0.default_gen_clk:[R] | audio_clock/pll_49m152/pll/CLKOUT0.default_gen_clk:[R] | 0.000 | -0.197 | 0.302
4 | 0.069 | system/synth/u_polar0/tR3_13_s0/Q | system/synth/u_polar0/states_states_0_1_s/DI[9] | audio_clock/pll_49m152/pll/CLKOUT0.default_gen_clk:[R] | audio_clock/pll_49m152/pll/CLKOUT0.default_gen_clk:[R] | 0.000 | -0.197 | 0.303
5 | 0.073 | system/synth/u_polar0/tR3_19_s0/Q | system/synth/u_polar0/states_states_0_1_s/DI[15] | audio_clock/pll_49m152/pll/CLKOUT0.default_gen_clk:[R] | audio_clock/pll_49m152/pll/CLKOUT0.default_gen_clk:[R] | 0.000 | -0.193 | 0.303
6 | 0.092 | system/synth/u_polar0/tR3_4_s0/Q | system/synth/u_polar0/states_states_0_1_s/DI[0] | audio_clock/pll_49m152/pll/CLKOUT0.default_gen_clk:[R] | audio_clock/pll_49m152/pll/CLKOUT0.default_gen_clk:[R] | 0.000 | -0.197 | 0.326
7 | 0.094 | system/synth/u_polar0/tR3_15_s0/Q | system/synth/u_polar0/states_states_0_1_s/DI[11] | audio_clock/pll_49m152/pll/CLKOUT0.default_gen_clk:[R] | audio_clock/pll_49m152/pll/CLKOUT0.default_gen_clk:[R] | 0.000 | -0.197 | 0.328
8 | 0.097 | system/synth/u_polar0/addr3_6_s0/Q | system/synth/u_polar0/states_states_0_2_s/ADA[11] | audio_clock/pll_49m152/pll/CLKOUT0.default_gen_clk:[R] | audio_clock/pll_49m152/pll/CLKOUT0.default_gen_clk:[R] | 0.000 | -0.193 | 0.327
9 | 0.097 | system/synth/u_polar0/tR3_21_s0/Q | system/synth/u_polar0/states_states_0_1_s/DI[17] | audio_clock/pll_49m152/pll/CLKOUT0.default_gen_clk:[R] | audio_clock/pll_49m152/pll/CLKOUT0.default_gen_clk:[R] | 0.000 | -0.193 | 0.327
10 | 0.102 | system/synth/u_polar0/tL3_25_s0/Q | system/synth/u_polar0/states_states_0_2_s/DI[17] | audio_clock/pll_49m152/pll/CLKOUT0.default_gen_clk:[R] | audio_clock/pll_49m152/pll/CLKOUT0.default_gen_clk:[R] | 0.000 | -0.193 | 0.332
11 | 0.129 | system/synth/u_polar0/addr3_7_s0/Q | system/synth/u_polar0/states_states_0_1_s/ADA[12] | audio_clock/pll_49m152/pll/CLKOUT0.default_gen_clk:[R] | audio_clock/pll_49m152/pll/CLKOUT0.default_gen_clk:[R] | 0.000 | -0.197 | 0.363
12 | 0.133 | system/synth/u_polar0/addr3_7_s0/Q | system/synth/u_polar0/states_states_0_2_s/ADA[12] | audio_clock/pll_49m152/pll/CLKOUT0.default_gen_clk:[R] | audio_clock/pll_49m152/pll/CLKOUT0.default_gen_clk:[R] | 0.000 | -0.193 | 0.363
13 | 0.138 | system/synth/u_polar0/end3_10_s0/Q | system/synth/u_polar0/states_states_0_5_s/DI[5] | audio_clock/pll_49m152/pll/CLKOUT0.default_gen_clk:[R] | audio_clock/pll_49m152/pll/CLKOUT0.default_gen_clk:[R] | 0.000 | 0.000 | 0.175
14 | 0.144 | system/synth/u_polar0/tR3_18_s0/Q | system/synth/u_polar0/states_states_0_1_s/DI[14] | audio_clock/pll_49m152/pll/CLKOUT0.default_gen_clk:[R] | audio_clock/pll_49m152/pll/CLKOUT0.default_gen_clk:[R] | 0.000 | -0.197 | 0.378
15 | 0.146 | system/synth/u_polar0/tL3_15_s0/Q | system/synth/u_polar0/states_states_0_2_s/DI[7] | audio_clock/pll_49m152/pll/CLKOUT0.default_gen_clk:[R] | audio_clock/pll_49m152/pll/CLKOUT0.default_gen_clk:[R] | 0.000 | -0.193 | 0.376
16 | 0.146 | system/synth/u_polar0/addr3_7_s0/Q | system/synth/u_polar0/states_states_0_0_s/ADA[12] | audio_clock/pll_49m152/pll/CLKOUT0.default_gen_clk:[R] | audio_clock/pll_49m152/pll/CLKOUT0.default_gen_clk:[R] | 0.000 | -0.201 | 0.384
17 | 0.150 | system/synth/u_polar0/tL3_11_s0/Q | system/synth/u_polar0/states_states_0_2_s/DI[3] | audio_clock/pll_49m152/pll/CLKOUT0.default_gen_clk:[R] | audio_clock/pll_49m152/pll/CLKOUT0.default_gen_clk:[R] | 0.000 | -0.189 | 0.376
18 | 0.152 | system/synth/u_polar0/addr3_6_s0/Q | system/synth/u_polar0/states_states_0_1_s/ADA[11] | audio_clock/pll_49m152/pll/CLKOUT0.default_gen_clk:[R] | audio_clock/pll_49m152/pll/CLKOUT0.default_gen_clk:[R] | 0.000 | -0.197 | 0.386
19 | 0.153 | system/synth/u_polar0/v_3_s0/Q | system/synth/u_polar0/states_states_0_1_s/CEA | audio_clock/pll_49m152/pll/CLKOUT0.default_gen_clk:[R] | audio_clock/pll_49m152/pll/CLKOUT0.default_gen_clk:[R] | 0.000 | -0.197 | 0.335
20 | 0.158 | system/synth/u_polar0/tR3_5_s0/Q | system/synth/u_polar0/states_states_0_1_s/DI[1] | audio_clock/pll_49m152/pll/CLKOUT0.default_gen_clk:[R] | audio_clock/pll_49m152/pll/CLKOUT0.default_gen_clk:[R] | 0.000 | -0.201 | 0.396
21 | 0.162 | system/synth/u_polar0/tL3_23_s0/Q | system/synth/u_polar0/states_states_0_2_s/DI[15] | audio_clock/pll_49m152/pll/CLKOUT0.default_gen_clk:[R] | audio_clock/pll_49m152/pll/CLKOUT0.default_gen_clk:[R] | 0.000 | -0.193 | 0.392
22 | 0.162 | system/synth/u_polar0/tL3_12_s0/Q | system/synth/u_polar0/states_states_0_2_s/DI[4] | audio_clock/pll_49m152/pll/CLKOUT0.default_gen_clk:[R] | audio_clock/pll_49m152/pll/CLKOUT0.default_gen_clk:[R] | 0.000 | -0.197 | 0.396
23 | 0.162 | system/synth/u_polar0/tR3_10_s0/Q | system/synth/u_polar0/states_states_0_1_s/DI[6] | audio_clock/pll_49m152/pll/CLKOUT0.default_gen_clk:[R] | audio_clock/pll_49m152/pll/CLKOUT0.default_gen_clk:[R] | 0.000 | -0.197 | 0.396
24 | 0.162 | system/synth/u_polar0/tR3_9_s0/Q | system/synth/u_polar0/states_states_0_1_s/DI[5] | audio_clock/pll_49m152/pll/CLKOUT0.default_gen_clk:[R] | audio_clock/pll_49m152/pll/CLKOUT0.default_gen_clk:[R] | 0.000 | -0.197 | 0.396
25 | 0.170 | video_clock/init/rRomAddr_5_s1/Q | video_clock/init/rRomDReg_0_s4/AD[10] | sys_clk:[R] | sys_clk:[R] | 0.000 | 0.004 | 0.201

### Recovery Paths Table

#### Report Command:report_timing -recovery -max_paths 25 -max_common_paths 1

Path Number | Path Slack | From Node | To Node | From Clock | To Clock | Relation | Clock Skew | Data Delay
1 | 8.207 | ready_sync_s0/Q | system/synth/u_polar1/n25821_0_s/RESET[0] | audio_clock/pll_49m152/pll/CLKOUT0.default_gen_clk:[R] | audio_clock/pll_49m152/pll/CLKOUT0.default_gen_clk:[R] | 20.345 | 0.000 | 11.577
2 | 9.115 | ready_sync_s0/Q | system/synth/u_polar1/n25822_0_s/RESET[0] | audio_clock/pll_49m152/pll/CLKOUT0.default_gen_clk:[R] | audio_clock/pll_49m152/pll/CLKOUT0.default_gen_clk:[R] | 20.345 | -0.009 | 10.678
3 | 9.923 | ready_sync_s0/Q | system/synth/n3266_s/RESET[0] | audio_clock/pll_49m152/pll/CLKOUT0.default_gen_clk:[R] | audio_clock/pll_49m152/pll/CLKOUT0.default_gen_clk:[R] | 20.345 | 0.000 | 9.861
4 | 10.077 | ready_sync_s0/Q | system/synth/n3387_s/RESET[0] | audio_clock/pll_49m152/pll/CLKOUT0.default_gen_clk:[R] | audio_clock/pll_49m152/pll/CLKOUT0.default_gen_clk:[R] | 20.345 | -0.009 | 9.717
5 | 10.327 | ready_sync_s0/Q | system/synth/u_polar0/n25821_0_s/RESET[0] | audio_clock/pll_49m152/pll/CLKOUT0.default_gen_clk:[R] | audio_clock/pll_49m152/pll/CLKOUT0.default_gen_clk:[R] | 20.345 | -0.009 | 9.467
6 | 10.358 | ready_sync_s0/Q | system/synth/n3524_s/RESET[0] | audio_clock/pll_49m152/pll/CLKOUT0.default_gen_clk:[R] | audio_clock/pll_49m152/pll/CLKOUT0.default_gen_clk:[R] | 20.345 | 0.000 | 9.426
7 | 10.386 | ready_sync_s0/Q | system/synth/u_expression/n746_s/RESET[0] | audio_clock/pll_49m152/pll/CLKOUT0.default_gen_clk:[R] | audio_clock/pll_49m152/pll/CLKOUT0.default_gen_clk:[R] | 20.345 | 0.000 | 9.398
8 | 10.682 | ready_sync_s0/Q | system/synth/u_polar0/n25822_0_s/RESET[0] | audio_clock/pll_49m152/pll/CLKOUT0.default_gen_clk:[R] | audio_clock/pll_49m152/pll/CLKOUT0.default_gen_clk:[R] | 20.345 | 0.000 | 9.102
9 | 10.734 | ready_sync_s0/Q | system/synth/n3491_s/RESET[0] | audio_clock/pll_49m152/pll/CLKOUT0.default_gen_clk:[R] | audio_clock/pll_49m152/pll/CLKOUT0.default_gen_clk:[R] | 20.345 | 0.009 | 9.041
10 | 10.821 | ready_sync_s0/Q | system/synth/u_gain/n143_s/RESET[0] | audio_clock/pll_49m152/pll/CLKOUT0.default_gen_clk:[R] | audio_clock/pll_49m152/pll/CLKOUT0.default_gen_clk:[R] | 20.345 | 0.000 | 8.963
11 | 10.983 | ready_sync_s0/Q | system/synth/u_gain/n188_s/RESET[0] | audio_clock/pll_49m152/pll/CLKOUT0.default_gen_clk:[R] | audio_clock/pll_49m152/pll/CLKOUT0.default_gen_clk:[R] | 20.345 | -0.009 | 8.811
12 | 11.423 | ready_sync_s0/Q | system/synth/n3071_s/RESET[0] | audio_clock/pll_49m152/pll/CLKOUT0.default_gen_clk:[R] | audio_clock/pll_49m152/pll/CLKOUT0.default_gen_clk:[R] | 20.345 | -0.009 | 8.371
13 | 13.269 | ready_sync_s0/Q | system/effects/comb_average_10_s0/CLEAR | audio_clock/pll_49m152/pll/CLKOUT0.default_gen_clk:[R] | audio_clock/pll_49m152/pll/CLKOUT0.default_gen_clk:[R] | 20.345 | 0.000 | 6.729
14 | 13.269 | ready_sync_s0/Q | system/synth/u_polar0/v_5_s0/CLEAR | audio_clock/pll_49m152/pll/CLKOUT0.default_gen_clk:[R] | audio_clock/pll_49m152/pll/CLKOUT0.default_gen_clk:[R] | 20.345 | 0.000 | 6.729
15 | 13.271 | ready_sync_s0/Q | system/effects/active_mode_0_s0/CLEAR | audio_clock/pll_49m152/pll/CLKOUT0.default_gen_clk:[R] | audio_clock/pll_49m152/pll/CLKOUT0.default_gen_clk:[R] | 20.345 | 0.009 | 6.718
16 | 13.271 | ready_sync_s0/Q | system/effects/active_mode_1_s0/CLEAR | audio_clock/pll_49m152/pll/CLKOUT0.default_gen_clk:[R] | audio_clock/pll_49m152/pll/CLKOUT0.default_gen_clk:[R] | 20.345 | 0.009 | 6.718
17 | 13.271 | ready_sync_s0/Q | system/effects/aout0_0_s0/CLEAR | audio_clock/pll_49m152/pll/CLKOUT0.default_gen_clk:[R] | audio_clock/pll_49m152/pll/CLKOUT0.default_gen_clk:[R] | 20.345 | 0.000 | 6.727
18 | 13.271 | ready_sync_s0/Q | system/effects/aout0_1_s0/CLEAR | audio_clock/pll_49m152/pll/CLKOUT0.default_gen_clk:[R] | audio_clock/pll_49m152/pll/CLKOUT0.default_gen_clk:[R] | 20.345 | 0.000 | 6.727
19 | 13.271 | ready_sync_s0/Q | system/effects/aout0_2_s0/CLEAR | audio_clock/pll_49m152/pll/CLKOUT0.default_gen_clk:[R] | audio_clock/pll_49m152/pll/CLKOUT0.default_gen_clk:[R] | 20.345 | 0.000 | 6.727
20 | 13.271 | ready_sync_s0/Q | system/effects/aout0_3_s0/CLEAR | audio_clock/pll_49m152/pll/CLKOUT0.default_gen_clk:[R] | audio_clock/pll_49m152/pll/CLKOUT0.default_gen_clk:[R] | 20.345 | 0.000 | 6.727
21 | 13.271 | ready_sync_s0/Q | system/effects/aout0_4_s0/CLEAR | audio_clock/pll_49m152/pll/CLKOUT0.default_gen_clk:[R] | audio_clock/pll_49m152/pll/CLKOUT0.default_gen_clk:[R] | 20.345 | 0.000 | 6.727
22 | 13.271 | ready_sync_s0/Q | system/effects/aout0_5_s0/CLEAR | audio_clock/pll_49m152/pll/CLKOUT0.default_gen_clk:[R] | audio_clock/pll_49m152/pll/CLKOUT0.default_gen_clk:[R] | 20.345 | 0.000 | 6.727
23 | 13.273 | ready_sync_s0/Q | system/effects/comb_average_15_s0/CLEAR | audio_clock/pll_49m152/pll/CLKOUT0.default_gen_clk:[R] | audio_clock/pll_49m152/pll/CLKOUT0.default_gen_clk:[R] | 20.345 | 0.009 | 6.716
24 | 13.273 | ready_sync_s0/Q | system/effects/comb_average_9_s0/CLEAR | audio_clock/pll_49m152/pll/CLKOUT0.default_gen_clk:[R] | audio_clock/pll_49m152/pll/CLKOUT0.default_gen_clk:[R] | 20.345 | 0.000 | 6.725
25 | 13.273 | ready_sync_s0/Q | system/synth/u_polar0/v_0_s0/CLEAR | audio_clock/pll_49m152/pll/CLKOUT0.default_gen_clk:[R] | audio_clock/pll_49m152/pll/CLKOUT0.default_gen_clk:[R] | 20.345 | 0.000 | 6.725

### Removal Paths Table

#### Report Command:report_timing -removal -max_paths 25 -max_common_paths 1

Path Number | Path Slack | From Node | To Node | From Clock | To Clock | Relation | Clock Skew | Data Delay
1 | 0.386 | audio_clock/first_lock_stable_s0/Q | audio_clock/pll_49m152/init/rEnable_1_s0/CLEAR | sys_clk:[R] | sys_clk:[R] | 0.000 | 0.004 | 0.329
2 | 0.386 | audio_clock/first_lock_stable_s0/Q | audio_clock/pll_49m152/init/rEnable_0_s0/CLEAR | sys_clk:[R] | sys_clk:[R] | 0.000 | 0.004 | 0.329
3 | 1.844 | system/sensors/eventizer/overflow_s0/Q | system/monitor/bundle_18_s0/CLEAR | audio_clock/pll_49m152/pll/CLKOUT0.default_gen_clk:[R] | audio_clock/pll_49m152/pll/CLKOUT0.default_gen_clk:[R] | 0.000 | -0.197 | 1.988
4 | 1.844 | system/sensors/eventizer/overflow_s0/Q | system/synth/u_polar0/right_10_s0/CLEAR | audio_clock/pll_49m152/pll/CLKOUT0.default_gen_clk:[R] | audio_clock/pll_49m152/pll/CLKOUT0.default_gen_clk:[R] | 0.000 | -0.197 | 1.988
5 | 1.849 | system/sensors/eventizer/overflow_s0/Q | system/monitor/bundle_17_s0/CLEAR | audio_clock/pll_49m152/pll/CLKOUT0.default_gen_clk:[R] | audio_clock/pll_49m152/pll/CLKOUT0.default_gen_clk:[R] | 0.000 | -0.197 | 1.993
6 | 1.849 | system/sensors/eventizer/overflow_s0/Q | system/synth/u_polar0/right_11_s0/CLEAR | audio_clock/pll_49m152/pll/CLKOUT0.default_gen_clk:[R] | audio_clock/pll_49m152/pll/CLKOUT0.default_gen_clk:[R] | 0.000 | -0.197 | 1.993
7 | 1.849 | system/sensors/eventizer/overflow_s0/Q | system/synth/u_polar0/right_30_s0/CLEAR | audio_clock/pll_49m152/pll/CLKOUT0.default_gen_clk:[R] | audio_clock/pll_49m152/pll/CLKOUT0.default_gen_clk:[R] | 0.000 | -0.197 | 1.993
8 | 1.852 | system/sensors/eventizer/overflow_s0/Q | system/synth/u_polar0/sumR_4_s0/CLEAR | audio_clock/pll_49m152/pll/CLKOUT0.default_gen_clk:[R] | audio_clock/pll_49m152/pll/CLKOUT0.default_gen_clk:[R] | 0.000 | -0.189 | 1.988
9 | 1.852 | system/sensors/eventizer/overflow_s0/Q | system/synth/u_polar0/sumR_5_s0/CLEAR | audio_clock/pll_49m152/pll/CLKOUT0.default_gen_clk:[R] | audio_clock/pll_49m152/pll/CLKOUT0.default_gen_clk:[R] | 0.000 | -0.193 | 1.992
10 | 1.852 | system/sensors/eventizer/overflow_s0/Q | system/synth/u_polar0/sumR_13_s0/CLEAR | audio_clock/pll_49m152/pll/CLKOUT0.default_gen_clk:[R] | audio_clock/pll_49m152/pll/CLKOUT0.default_gen_clk:[R] | 0.000 | -0.193 | 1.992
11 | 1.852 | system/sensors/eventizer/overflow_s0/Q | system/synth/u_polar0/sumR_16_s0/CLEAR | audio_clock/pll_49m152/pll/CLKOUT0.default_gen_clk:[R] | audio_clock/pll_49m152/pll/CLKOUT0.default_gen_clk:[R] | 0.000 | -0.193 | 1.992
12 | 1.852 | system/sensors/eventizer/overflow_s0/Q | system/synth/u_polar0/sumR_31_s0/CLEAR | audio_clock/pll_49m152/pll/CLKOUT0.default_gen_clk:[R] | audio_clock/pll_49m152/pll/CLKOUT0.default_gen_clk:[R] | 0.000 | -0.193 | 1.992
13 | 1.854 | system/sensors/eventizer/overflow_s0/Q | system/monitor/ack_sync_s0/CLEAR | audio_clock/pll_49m152/pll/CLKOUT0.default_gen_clk:[R] | audio_clock/pll_49m152/pll/CLKOUT0.default_gen_clk:[R] | 0.000 | -0.197 | 1.998
14 | 1.854 | system/sensors/eventizer/overflow_s0/Q | system/effects/cfill1_7_s3/CLEAR | audio_clock/pll_49m152/pll/CLKOUT0.default_gen_clk:[R] | audio_clock/pll_49m152/pll/CLKOUT0.default_gen_clk:[R] | 0.000 | -0.197 | 1.998
15 | 1.854 | system/sensors/eventizer/overflow_s0/Q | system/effects/cfill1_5_s1/CLEAR | audio_clock/pll_49m152/pll/CLKOUT0.default_gen_clk:[R] | audio_clock/pll_49m152/pll/CLKOUT0.default_gen_clk:[R] | 0.000 | -0.197 | 1.998
16 | 1.854 | system/sensors/eventizer/overflow_s0/Q | system/synth/u_polar0/right_7_s0/CLEAR | audio_clock/pll_49m152/pll/CLKOUT0.default_gen_clk:[R] | audio_clock/pll_49m152/pll/CLKOUT0.default_gen_clk:[R] | 0.000 | -0.197 | 1.998
17 | 1.854 | system/sensors/eventizer/overflow_s0/Q | system/synth/u_polar0/right_8_s0/CLEAR | audio_clock/pll_49m152/pll/CLKOUT0.default_gen_clk:[R] | audio_clock/pll_49m152/pll/CLKOUT0.default_gen_clk:[R] | 0.000 | -0.197 | 1.998
18 | 1.854 | system/sensors/eventizer/overflow_s0/Q | system/monitor/req_s2/CLEAR | audio_clock/pll_49m152/pll/CLKOUT0.default_gen_clk:[R] | audio_clock/pll_49m152/pll/CLKOUT0.default_gen_clk:[R] | 0.000 | -0.193 | 1.994
19 | 1.854 | system/sensors/eventizer/overflow_s0/Q | system/effects/cfill1_3_s3/CLEAR | audio_clock/pll_49m152/pll/CLKOUT0.default_gen_clk:[R] | audio_clock/pll_49m152/pll/CLKOUT0.default_gen_clk:[R] | 0.000 | -0.193 | 1.994
20 | 1.854 | system/sensors/eventizer/overflow_s0/Q | system/effects/cfill1_4_s3/CLEAR | audio_clock/pll_49m152/pll/CLKOUT0.default_gen_clk:[R] | audio_clock/pll_49m152/pll/CLKOUT0.default_gen_clk:[R] | 0.000 | -0.193 | 1.994
21 | 1.854 | system/sensors/eventizer/overflow_s0/Q | system/effects/cfill1_6_s3/CLEAR | audio_clock/pll_49m152/pll/CLKOUT0.default_gen_clk:[R] | audio_clock/pll_49m152/pll/CLKOUT0.default_gen_clk:[R] | 0.000 | -0.193 | 1.994
22 | 1.854 | system/sensors/eventizer/overflow_s0/Q | system/synth/u_polar0/right_14_s0/CLEAR | audio_clock/pll_49m152/pll/CLKOUT0.default_gen_clk:[R] | audio_clock/pll_49m152/pll/CLKOUT0.default_gen_clk:[R] | 0.000 | -0.193 | 1.994
23 | 1.854 | system/sensors/eventizer/overflow_s0/Q | system/synth/u_polar0/right_17_s0/CLEAR | audio_clock/pll_49m152/pll/CLKOUT0.default_gen_clk:[R] | audio_clock/pll_49m152/pll/CLKOUT0.default_gen_clk:[R] | 0.000 | -0.193 | 1.994
24 | 1.857 | system/sensors/eventizer/overflow_s0/Q | system/synth/u_polar0/issuing_s1/CLEAR | audio_clock/pll_49m152/pll/CLKOUT0.default_gen_clk:[R] | audio_clock/pll_49m152/pll/CLKOUT0.default_gen_clk:[R] | 0.000 | -0.193 | 1.997
25 | 1.857 | system/sensors/eventizer/overflow_s0/Q | system/synth/u_polar0/sumR_11_s0/CLEAR | audio_clock/pll_49m152/pll/CLKOUT0.default_gen_clk:[R] | audio_clock/pll_49m152/pll/CLKOUT0.default_gen_clk:[R] | 0.000 | -0.189 | 1.993

## Minimum Pulse Width Table:

Number | Slack | Actual Width | Required Width | Type | Clock | Objects

#### Report Command:report_min_pulse_width -nworst 10 -detail

1 | 2.322 | 2.572 | 0.250 | Low Pulse Width | video_clock/pll/CLKOUT0.default_gen_clk | video/green_lane/shift_9_s0
2 | 2.322 | 2.572 | 0.250 | Low Pulse Width | video_clock/pll/CLKOUT0.default_gen_clk | video/green_lane/shift_8_s0
3 | 2.322 | 2.572 | 0.250 | Low Pulse Width | video_clock/pll/CLKOUT0.default_gen_clk | video/blue_lane/shift_9_s0
4 | 2.322 | 2.572 | 0.250 | Low Pulse Width | video_clock/pll/CLKOUT0.default_gen_clk | video/blue_lane/shift_8_s0
5 | 2.322 | 2.572 | 0.250 | Low Pulse Width | video_clock/pll/CLKOUT0.default_gen_clk | video/blue_lane/shift_7_s0
6 | 2.322 | 2.572 | 0.250 | Low Pulse Width | video_clock/pll/CLKOUT0.default_gen_clk | video/blue_lane/shift_6_s0
7 | 2.322 | 2.572 | 0.250 | Low Pulse Width | video_clock/pll/CLKOUT0.default_gen_clk | video/blue_lane/shift_4_s0
8 | 2.323 | 2.573 | 0.250 | High Pulse Width | video_clock/pll/CLKOUT0.default_gen_clk | video/green_lane/shift_9_s0
9 | 2.323 | 2.573 | 0.250 | High Pulse Width | video_clock/pll/CLKOUT0.default_gen_clk | video/green_lane/shift_8_s0
10 | 2.323 | 2.573 | 0.250 | High Pulse Width | video_clock/pll/CLKOUT0.default_gen_clk | video/blue_lane/shift_9_s0

## Timing Report By Analysis Type:

### Setup Analysis Report

#### Report Command:report_timing -setup -max_paths 25 -max_common_paths 1

### Path1

Path Summary:

Slack | 0.272
Data Arrival Time | 27.072
Data Required Time | 27.344
From | system/performance/record_ram_record_ram_0_2_s
To | system/performance/event_velocity_1_s0
Launch Clk | audio_clock/pll_49m152/pll/CLKOUT0.default_gen_clk:[R]
Latch Clk | audio_clock/pll_49m152/pll/CLKOUT0.default_gen_clk:[R]

Data Arrival Path:

AT | DELAY | TYPE | RF | FANOUT | LOC | NODE
0.000 | 0.000 | | | | | active clock edge time
0.000 | 0.000 | | | | | audio_clock/pll_49m152/pll/CLKOUT0.default_gen_clk
4.964 | 4.964 | tCL | RR | 9528 | PLL_T[0] | audio_clock/pll_49m152/pll/CLKOUT0
7.072 | 2.109 | tNET | RR | 16 | BSRAM_R56[31][A] | system/performance/record_ram_record_ram_0_2_s/CLKB
9.077 | 2.005 | tC2Q | RF | 4 | BSRAM_R56[31][A] | system/performance/record_ram_record_ram_0_2_s/DO[1]
10.255 | 1.178 | tNET | FF | 1 | R44C128[0][A] | system/performance/active_key_2_s4/I1
10.781 | 0.526 | tINS | FR | 1 | R44C128[0][A] | system/performance/active_key_2_s4/F
10.784 | 0.003 | tNET | RR | 1 | R44C128[0][B] | system/performance/active_key_2_s3/I1
11.046 | 0.262 | tINS | RR | 1 | R44C128[0][B] | system/performance/active_key_2_s3/F
11.431 | 0.385 | tNET | RR | 1 | R46C127[0][A] | system/performance/active_key_2_s0/I2
11.811 | 0.380 | tINS | RF | 224 | R46C127[0][A] | system/performance/active_key_2_s0/F
15.770 | 3.959 | tNET | FF | 1 | R68C124[2][A] | system/performance/active_note_6_s13/I0
16.296 | 0.526 | tINS | FR | 29 | R68C124[2][A] | system/performance/active_note_6_s13/F
17.575 | 1.279 | tNET | RR | 1 | R70C114[1][A] | system/performance/active_note_1_s125/I0
18.036 | 0.461 | tINS | RR | 1 | R70C114[1][A] | system/performance/active_note_1_s125/F
18.039 | 0.003 | tNET | RR | 1 | R70C114[2][B] | system/performance/active_note_1_s115/I1
18.301 | 0.262 | tINS | RR | 1 | R70C114[2][B] | system/performance/active_note_1_s115/F
18.629 | 0.327 | tNET | RR | 1 | R69C114[2][B] | system/performance/active_note_1_s78/I2
19.155 | 0.526 | tINS | RR | 1 | R69C114[2][B] | system/performance/active_note_1_s78/F
19.821 | 0.666 | tNET | RR | 1 | R62C119[2][B] | system/performance/active_note_1_s25/I3
20.282 | 0.461 | tINS | RR | 1 | R62C119[2][B] | system/performance/active_note_1_s25/F
20.285 | 0.003 | tNET | RR | 1 | R62C119[3][A] | system/performance/active_note_1_s6/I3
20.782 | 0.498 | tINS | RR | 1 | R62C119[3][A] | system/performance/active_note_1_s6/F
20.940 | 0.157 | tNET | RR | 1 | R61C119[3][A] | system/performance/active_note_1_s1/I3
21.230 | 0.290 | tINS | RF | 1 | R61C119[3][A] | system/performance/active_note_1_s1/F
21.696 | 0.466 | tNET | FF | 1 | R61C125[0][A] | system/performance/active_note_1_s0/I0
22.157 | 0.461 | tINS | FR | 2 | R61C125[0][A] | system/performance/active_note_1_s0/F
23.151 | 0.994 | tNET | RR | 2 | R60C138[0][B] | system/performance/n4752_s0/I1
23.714 | 0.562 | tINS | RF | 1 | R60C138[0][B] | system/performance/n4752_s0/COUT
23.714 | 0.000 | tNET | FF | 2 | R60C138[1][A] | system/performance/n4753_s0/CIN
23.764 | 0.050 | tINS | FR | 1 | R60C138[1][A] | system/performance/n4753_s0/COUT
23.764 | 0.000 | tNET | RR | 2 | R60C138[1][B] | system/performance/n4754_s0/CIN
23.814 | 0.050 | tINS | RR | 1 | R60C138[1][B] | system/performance/n4754_s0/COUT
23.814 | 0.000 | tNET | RR | 2 | R60C138[2][A] | system/performance/n4755_s0/CIN
23.864 | 0.050 | tINS | RR | 1 | R60C138[2][A] | system/performance/n4755_s0/COUT
23.864 | 0.000 | tNET | RR | 2 | R60C138[2][B] | system/performance/n4756_s0/CIN
23.914 | 0.050 | tINS | RR | 1 | R60C138[2][B] | system/performance/n4756_s0/COUT
23.914 | 0.000 | tNET | RR | 2 | R60C139[0][A] | system/performance/n4757_s0/CIN
23.964 | 0.050 | tINS | RR | 3 | R60C139[0][A] | system/performance/n4757_s0/COUT
24.772 | 0.809 | tNET | RR | 1 | R60C135[3][B] | system/performance/n5028_s10/I2
25.270 | 0.498 | tINS | RR | 8 | R60C135[3][B] | system/performance/n5028_s10/F
26.611 | 1.341 | tNET | RR | 1 | R48C139[0][A] | system/performance/n5047_s2/I3
27.072 | 0.461 | tINS | RR | 1 | R48C139[0][A] | system/performance/n5047_s2/F
27.072 | 0.000 | tNET | RR | 1 | R48C139[0][A] | system/performance/event_velocity_1_s0/D

Data Required Path:

AT | DELAY | TYPE | RF | FANOUT | LOC | NODE
20.345 | 20.345 | | | | | active clock edge time
20.345 | 0.000 | | | | | audio_clock/pll_49m152/pll/CLKOUT0.default_gen_clk
25.309 | 4.964 | tCL | RR | 9528 | PLL_T[0] | audio_clock/pll_49m152/pll/CLKOUT0
27.408 | 2.099 | tNET | RR | 1 | R48C139[0][A] | system/performance/event_velocity_1_s0/CLK
27.344 | -0.064 | tSu | | 1 | R48C139[0][A] | system/performance/event_velocity_1_s0

Path Statistics:

Clock Skew | -0.009
Setup Relationship | 20.345
Logic Level | 16
Arrival Clock Path Delay | cell: 0.000, 0.000%; route: 2.109, 100.000%
Arrival Data Path Delay | cell: 6.426, 32.131%; route: 11.569, 57.844%; tC2Q: 2.005, 10.025%
Required Clock Path Delay | cell: 0.000, 0.000%; route: 2.099, 100.000%

### Path2

Path Summary:

Slack | 0.278
Data Arrival Time | 26.819
Data Required Time | 27.097
From | system/sensors/eventizer/fifo_fifo_0_0_s
To | system/events/mem[37]_5_s0
Launch Clk | audio_clock/pll_49m152/pll/CLKOUT0.default_gen_clk:[R]
Latch Clk | audio_clock/pll_49m152/pll/CLKOUT0.default_gen_clk:[R]

Data Arrival Path:

AT | DELAY | TYPE | RF | FANOUT | LOC | NODE
0.000 | 0.000 | | | | | active clock edge time
0.000 | 0.000 | | | | | audio_clock/pll_49m152/pll/CLKOUT0.default_gen_clk
4.964 | 4.964 | tCL | RR | 9528 | PLL_T[0] | audio_clock/pll_49m152/pll/CLKOUT0
7.063 | 2.099 | tNET | RR | 16 | BSRAM_R19[6] | system/sensors/eventizer/fifo_fifo_0_0_s/CLKB
9.073 | 2.010 | tC2Q | RR | 7 | BSRAM_R19[6] | system/sensors/eventizer/fifo_fifo_0_0_s/DO[13]
9.316 | 0.243 | tNET | RR | 1 | R20C104[3][B] | system/n1299_s4/I0
9.837 | 0.521 | tINS | RR | 3 | R20C104[3][B] | system/n1299_s4/F
10.167 | 0.330 | tNET | RR | 1 | R20C103[2][B] | system/n1327_s62/S0
10.419 | 0.252 | tINS | RR | 2 | R20C103[2][B] | system/n1327_s62/O
10.959 | 0.540 | tNET | RR | 1 | R20C108[0][B] | system/n1333_s8/I0
11.222 | 0.262 | tINS | RR | 1 | R20C108[0][B] | system/n1333_s8/F
11.794 | 0.572 | tNET | RR | 1 | R25C108[2][B] | system/n1333_s7/I2
12.311 | 0.516 | tINS | RR | 1 | R25C108[2][B] | system/n1333_s7/F
12.468 | 0.157 | tNET | RR | 1 | R26C108[3][A] | system/n1333_s5/I1
12.758 | 0.290 | tINS | RF | 1 | R26C108[3][A] | system/n1333_s5/F
12.763 | 0.005 | tNET | FF | 1 | R26C108[3][B] | system/n1333_s2/I2
13.178 | 0.415 | tINS | FR | 4 | R26C108[3][B] | system/n1333_s2/F
14.587 | 1.409 | tNET | RR | 1 | R59C113[1][B] | system/arbiter/n10_s6/I2
14.849 | 0.262 | tINS | RR | 2 | R59C113[1][B] | system/arbiter/n10_s6/F
14.989 | 0.140 | tNET | RR | 1 | R59C113[3][A] | system/arbiter/n27_s4/I1
15.487 | 0.498 | tINS | RR | 2 | R59C113[3][A] | system/arbiter/n27_s4/F
15.647 | 0.160 | tNET | RR | 1 | R60C113[3][B] | system/arbiter/n31_s3/I3
16.144 | 0.498 | tINS | RR | 1 | R60C113[3][B] | system/arbiter/n31_s3/F
16.147 | 0.003 | tNET | RR | 1 | R60C113[3][A] | system/arbiter/n31_s1/I0
16.644 | 0.498 | tINS | RR | 2 | R60C113[3][A] | system/arbiter/n31_s1/F
16.784 | 0.140 | tNET | RR | 1 | R60C113[2][B] | system/arbiter/n153_s4/I0
17.301 | 0.516 | tINS | RR | 44 | R60C113[2][B] | system/arbiter/n153_s4/F
17.656 | 0.355 | tNET | RR | 1 | R58C112[0][B] | system/arbiter/push_valid_s1/I3
18.182 | 0.526 | tINS | RR | 1 | R58C112[0][B] | system/arbiter/push_valid_s1/F
18.184 | 0.003 | tNET | RR | 1 | R58C112[1][A] | system/arbiter/push_valid_s0/I3
18.701 | 0.516 | tINS | RR | 2 | R58C112[1][A] | system/arbiter/push_valid_s0/F
18.706 | 0.005 | tNET | RR | 1 | R58C112[0][A] | system/arbiter/push_valid_s/I0
18.968 | 0.262 | tINS | RR | 3 | R58C112[0][A] | system/arbiter/push_valid_s/F
19.773 | 0.805 | tNET | RR | 1 | R27C111[3][B] | system/n921_s1/I3
20.294 | 0.521 | tINS | RR | 38 | R27C111[3][B] | system/n921_s1/F
22.801 | 2.506 | tNET | RR | 1 | R7C93[0][B] | system/events/n6895_s1/I3
23.063 | 0.262 | tINS | RR | 8 | R7C93[0][B] | system/events/n6895_s1/F
24.773 | 1.710 | tNET | RR | 1 | R23C93[3][B] | system/events/n7010_s0/I3
25.271 | 0.498 | tINS | RR | 8 | R23C93[3][B] | system/events/n7010_s0/F
26.819 | 1.549 | tNET | RR | 1 | R9C97[1][B] | system/events/mem[37]_5_s0/CE

Data Required Path:

AT | DELAY | TYPE | RF | FANOUT | LOC | NODE
20.345 | 20.345 | | | | | active clock edge time
20.345 | 0.000 | | | | | audio_clock/pll_49m152/pll/CLKOUT0.default_gen_clk
25.309 | 4.964 | tCL | RR | 9528 | PLL_T[0] | audio_clock/pll_49m152/pll/CLKOUT0
27.408 | 2.099 | tNET | RR | 1 | R9C97[1][B] | system/events/mem[37]_5_s0/CLK
27.097 | -0.311 | tSu | | 1 | R9C97[1][B] | system/events/mem[37]_5_s0

Path Statistics:

Clock Skew | 0.000
Setup Relationship | 20.345
Logic Level | 18
Arrival Clock Path Delay | cell: 0.000, 0.000%; route: 2.099, 100.000%
Arrival Data Path Delay | cell: 7.115, 36.014%; route: 10.631, 53.812%; tC2Q: 2.010, 10.174%
Required Clock Path Delay | cell: 0.000, 0.000%; route: 2.099, 100.000%

### Path3

Path Summary:

Slack | 0.278
Data Arrival Time | 26.819
Data Required Time | 27.097
From | system/sensors/eventizer/fifo_fifo_0_0_s
To | system/events/mem[37]_22_s0
Launch Clk | audio_clock/pll_49m152/pll/CLKOUT0.default_gen_clk:[R]
Latch Clk | audio_clock/pll_49m152/pll/CLKOUT0.default_gen_clk:[R]

Data Arrival Path:

AT | DELAY | TYPE | RF | FANOUT | LOC | NODE
0.000 | 0.000 | | | | | active clock edge time
0.000 | 0.000 | | | | | audio_clock/pll_49m152/pll/CLKOUT0.default_gen_clk
4.964 | 4.964 | tCL | RR | 9528 | PLL_T[0] | audio_clock/pll_49m152/pll/CLKOUT0
7.063 | 2.099 | tNET | RR | 16 | BSRAM_R19[6] | system/sensors/eventizer/fifo_fifo_0_0_s/CLKB
9.073 | 2.010 | tC2Q | RR | 7 | BSRAM_R19[6] | system/sensors/eventizer/fifo_fifo_0_0_s/DO[13]
9.316 | 0.243 | tNET | RR | 1 | R20C104[3][B] | system/n1299_s4/I0
9.837 | 0.521 | tINS | RR | 3 | R20C104[3][B] | system/n1299_s4/F
10.167 | 0.330 | tNET | RR | 1 | R20C103[2][B] | system/n1327_s62/S0
10.419 | 0.252 | tINS | RR | 2 | R20C103[2][B] | system/n1327_s62/O
10.959 | 0.540 | tNET | RR | 1 | R20C108[0][B] | system/n1333_s8/I0
11.222 | 0.262 | tINS | RR | 1 | R20C108[0][B] | system/n1333_s8/F
11.794 | 0.572 | tNET | RR | 1 | R25C108[2][B] | system/n1333_s7/I2
12.311 | 0.516 | tINS | RR | 1 | R25C108[2][B] | system/n1333_s7/F
12.468 | 0.157 | tNET | RR | 1 | R26C108[3][A] | system/n1333_s5/I1
12.758 | 0.290 | tINS | RF | 1 | R26C108[3][A] | system/n1333_s5/F
12.763 | 0.005 | tNET | FF | 1 | R26C108[3][B] | system/n1333_s2/I2
13.178 | 0.415 | tINS | FR | 4 | R26C108[3][B] | system/n1333_s2/F
14.587 | 1.409 | tNET | RR | 1 | R59C113[1][B] | system/arbiter/n10_s6/I2
14.849 | 0.262 | tINS | RR | 2 | R59C113[1][B] | system/arbiter/n10_s6/F
14.989 | 0.140 | tNET | RR | 1 | R59C113[3][A] | system/arbiter/n27_s4/I1
15.487 | 0.498 | tINS | RR | 2 | R59C113[3][A] | system/arbiter/n27_s4/F
15.647 | 0.160 | tNET | RR | 1 | R60C113[3][B] | system/arbiter/n31_s3/I3
16.144 | 0.498 | tINS | RR | 1 | R60C113[3][B] | system/arbiter/n31_s3/F
16.147 | 0.003 | tNET | RR | 1 | R60C113[3][A] | system/arbiter/n31_s1/I0
16.644 | 0.498 | tINS | RR | 2 | R60C113[3][A] | system/arbiter/n31_s1/F
16.784 | 0.140 | tNET | RR | 1 | R60C113[2][B] | system/arbiter/n153_s4/I0
17.301 | 0.516 | tINS | RR | 44 | R60C113[2][B] | system/arbiter/n153_s4/F
17.656 | 0.355 | tNET | RR | 1 | R58C112[0][B] | system/arbiter/push_valid_s1/I3
18.182 | 0.526 | tINS | RR | 1 | R58C112[0][B] | system/arbiter/push_valid_s1/F
18.184 | 0.003 | tNET | RR | 1 | R58C112[1][A] | system/arbiter/push_valid_s0/I3
18.701 | 0.516 | tINS | RR | 2 | R58C112[1][A] | system/arbiter/push_valid_s0/F
18.706 | 0.005 | tNET | RR | 1 | R58C112[0][A] | system/arbiter/push_valid_s/I0
18.968 | 0.262 | tINS | RR | 3 | R58C112[0][A] | system/arbiter/push_valid_s/F
19.773 | 0.805 | tNET | RR | 1 | R27C111[3][B] | system/n921_s1/I3
20.294 | 0.521 | tINS | RR | 38 | R27C111[3][B] | system/n921_s1/F
22.801 | 2.506 | tNET | RR | 1 | R7C93[0][B] | system/events/n6895_s1/I3
23.063 | 0.262 | tINS | RR | 8 | R7C93[0][B] | system/events/n6895_s1/F
24.773 | 1.710 | tNET | RR | 1 | R23C93[3][B] | system/events/n7010_s0/I3
25.271 | 0.498 | tINS | RR | 8 | R23C93[3][B] | system/events/n7010_s0/F
26.819 | 1.549 | tNET | RR | 1 | R9C97[1][A] | system/events/mem[37]_22_s0/CE

Data Required Path:

AT | DELAY | TYPE | RF | FANOUT | LOC | NODE
20.345 | 20.345 | | | | | active clock edge time
20.345 | 0.000 | | | | | audio_clock/pll_49m152/pll/CLKOUT0.default_gen_clk
25.309 | 4.964 | tCL | RR | 9528 | PLL_T[0] | audio_clock/pll_49m152/pll/CLKOUT0
27.408 | 2.099 | tNET | RR | 1 | R9C97[1][A] | system/events/mem[37]_22_s0/CLK
27.097 | -0.311 | tSu | | 1 | R9C97[1][A] | system/events/mem[37]_22_s0

Path Statistics:

Clock Skew | 0.000
Setup Relationship | 20.345
Logic Level | 18
Arrival Clock Path Delay | cell: 0.000, 0.000%; route: 2.099, 100.000%
Arrival Data Path Delay | cell: 7.115, 36.014%; route: 10.631, 53.812%; tC2Q: 2.010, 10.174%
Required Clock Path Delay | cell: 0.000, 0.000%; route: 2.099, 100.000%

### Path4

Path Summary:

Slack | 0.447
Data Arrival Time | 26.897
Data Required Time | 27.344
From | system/performance/record_ram_record_ram_0_2_s
To | system/performance/event_velocity_0_s0
Launch Clk | audio_clock/pll_49m152/pll/CLKOUT0.default_gen_clk:[R]
Latch Clk | audio_clock/pll_49m152/pll/CLKOUT0.default_gen_clk:[R]

Data Arrival Path:

AT | DELAY | TYPE | RF | FANOUT | LOC | NODE
0.000 | 0.000 | | | | | active clock edge time
0.000 | 0.000 | | | | | audio_clock/pll_49m152/pll/CLKOUT0.default_gen_clk
4.964 | 4.964 | tCL | RR | 9528 | PLL_T[0] | audio_clock/pll_49m152/pll/CLKOUT0
7.072 | 2.109 | tNET | RR | 16 | BSRAM_R56[31][A] | system/performance/record_ram_record_ram_0_2_s/CLKB
9.077 | 2.005 | tC2Q | RF | 4 | BSRAM_R56[31][A] | system/performance/record_ram_record_ram_0_2_s/DO[1]
10.255 | 1.178 | tNET | FF | 1 | R44C128[0][A] | system/performance/active_key_2_s4/I1
10.781 | 0.526 | tINS | FR | 1 | R44C128[0][A] | system/performance/active_key_2_s4/F
10.784 | 0.003 | tNET | RR | 1 | R44C128[0][B] | system/performance/active_key_2_s3/I1
11.046 | 0.262 | tINS | RR | 1 | R44C128[0][B] | system/performance/active_key_2_s3/F
11.431 | 0.385 | tNET | RR | 1 | R46C127[0][A] | system/performance/active_key_2_s0/I2
11.811 | 0.380 | tINS | RF | 224 | R46C127[0][A] | system/performance/active_key_2_s0/F
15.770 | 3.959 | tNET | FF | 1 | R68C124[2][A] | system/performance/active_note_6_s13/I0
16.296 | 0.526 | tINS | FR | 29 | R68C124[2][A] | system/performance/active_note_6_s13/F
17.575 | 1.279 | tNET | RR | 1 | R70C114[1][A] | system/performance/active_note_1_s125/I0
18.036 | 0.461 | tINS | RR | 1 | R70C114[1][A] | system/performance/active_note_1_s125/F
18.039 | 0.003 | tNET | RR | 1 | R70C114[2][B] | system/performance/active_note_1_s115/I1
18.301 | 0.262 | tINS | RR | 1 | R70C114[2][B] | system/performance/active_note_1_s115/F
18.629 | 0.327 | tNET | RR | 1 | R69C114[2][B] | system/performance/active_note_1_s78/I2
19.155 | 0.526 | tINS | RR | 1 | R69C114[2][B] | system/performance/active_note_1_s78/F
19.821 | 0.666 | tNET | RR | 1 | R62C119[2][B] | system/performance/active_note_1_s25/I3
20.282 | 0.461 | tINS | RR | 1 | R62C119[2][B] | system/performance/active_note_1_s25/F
20.285 | 0.003 | tNET | RR | 1 | R62C119[3][A] | system/performance/active_note_1_s6/I3
20.782 | 0.498 | tINS | RR | 1 | R62C119[3][A] | system/performance/active_note_1_s6/F
20.940 | 0.157 | tNET | RR | 1 | R61C119[3][A] | system/performance/active_note_1_s1/I3
21.230 | 0.290 | tINS | RF | 1 | R61C119[3][A] | system/performance/active_note_1_s1/F
21.696 | 0.466 | tNET | FF | 1 | R61C125[0][A] | system/performance/active_note_1_s0/I0
22.157 | 0.461 | tINS | FR | 2 | R61C125[0][A] | system/performance/active_note_1_s0/F
23.151 | 0.994 | tNET | RR | 2 | R60C138[0][B] | system/performance/n4752_s0/I1
23.714 | 0.562 | tINS | RF | 1 | R60C138[0][B] | system/performance/n4752_s0/COUT
23.714 | 0.000 | tNET | FF | 2 | R60C138[1][A] | system/performance/n4753_s0/CIN
23.764 | 0.050 | tINS | FR | 1 | R60C138[1][A] | system/performance/n4753_s0/COUT
23.764 | 0.000 | tNET | RR | 2 | R60C138[1][B] | system/performance/n4754_s0/CIN
23.814 | 0.050 | tINS | RR | 1 | R60C138[1][B] | system/performance/n4754_s0/COUT
23.814 | 0.000 | tNET | RR | 2 | R60C138[2][A] | system/performance/n4755_s0/CIN
23.864 | 0.050 | tINS | RR | 1 | R60C138[2][A] | system/performance/n4755_s0/COUT
23.864 | 0.000 | tNET | RR | 2 | R60C138[2][B] | system/performance/n4756_s0/CIN
23.914 | 0.050 | tINS | RR | 1 | R60C138[2][B] | system/performance/n4756_s0/COUT
23.914 | 0.000 | tNET | RR | 2 | R60C139[0][A] | system/performance/n4757_s0/CIN
23.964 | 0.050 | tINS | RR | 3 | R60C139[0][A] | system/performance/n4757_s0/COUT
24.772 | 0.809 | tNET | RR | 1 | R60C135[3][B] | system/performance/n5028_s10/I2
25.270 | 0.498 | tINS | RR | 8 | R60C135[3][B] | system/performance/n5028_s10/F
26.635 | 1.365 | tNET | RR | 1 | R46C139[2][A] | system/performance/n5048_s2/I1
26.897 | 0.262 | tINS | RR | 1 | R46C139[2][A] | system/performance/n5048_s2/F
26.897 | 0.000 | tNET | RR | 1 | R46C139[2][A] | system/performance/event_velocity_0_s0/D

Data Required Path:

AT | DELAY | TYPE | RF | FANOUT | LOC | NODE
20.345 | 20.345 | | | | | active clock edge time
20.345 | 0.000 | | | | | audio_clock/pll_49m152/pll/CLKOUT0.default_gen_clk
25.309 | 4.964 | tCL | RR | 9528 | PLL_T[0] | audio_clock/pll_49m152/pll/CLKOUT0
27.408 | 2.099 | tNET | RR | 1 | R46C139[2][A] | system/performance/event_velocity_0_s0/CLK
27.344 | -0.064 | tSu | | 1 | R46C139[2][A] | system/performance/event_velocity_0_s0

Path Statistics:

Clock Skew | -0.009
Setup Relationship | 20.345
Logic Level | 16
Arrival Clock Path Delay | cell: 0.000, 0.000%; route: 2.109, 100.000%
Arrival Data Path Delay | cell: 6.228, 31.412%; route: 11.592, 58.474%; tC2Q: 2.005, 10.113%
Required Clock Path Delay | cell: 0.000, 0.000%; route: 2.099, 100.000%

### Path5

Path Summary:

Slack | 0.540
Data Arrival Time | 26.557
Data Required Time | 27.097
From | system/sensors/eventizer/fifo_fifo_0_0_s
To | system/events/mem[35]_22_s0
Launch Clk | audio_clock/pll_49m152/pll/CLKOUT0.default_gen_clk:[R]
Latch Clk | audio_clock/pll_49m152/pll/CLKOUT0.default_gen_clk:[R]

Data Arrival Path:

AT | DELAY | TYPE | RF | FANOUT | LOC | NODE
0.000 | 0.000 | | | | | active clock edge time
0.000 | 0.000 | | | | | audio_clock/pll_49m152/pll/CLKOUT0.default_gen_clk
4.964 | 4.964 | tCL | RR | 9528 | PLL_T[0] | audio_clock/pll_49m152/pll/CLKOUT0
7.063 | 2.099 | tNET | RR | 16 | BSRAM_R19[6] | system/sensors/eventizer/fifo_fifo_0_0_s/CLKB
9.073 | 2.010 | tC2Q | RR | 7 | BSRAM_R19[6] | system/sensors/eventizer/fifo_fifo_0_0_s/DO[13]
9.316 | 0.243 | tNET | RR | 1 | R20C104[3][B] | system/n1299_s4/I0
9.837 | 0.521 | tINS | RR | 3 | R20C104[3][B] | system/n1299_s4/F
10.167 | 0.330 | tNET | RR | 1 | R20C103[2][B] | system/n1327_s62/S0
10.419 | 0.252 | tINS | RR | 2 | R20C103[2][B] | system/n1327_s62/O
10.959 | 0.540 | tNET | RR | 1 | R20C108[0][B] | system/n1333_s8/I0
11.222 | 0.262 | tINS | RR | 1 | R20C108[0][B] | system/n1333_s8/F
11.794 | 0.572 | tNET | RR | 1 | R25C108[2][B] | system/n1333_s7/I2
12.311 | 0.516 | tINS | RR | 1 | R25C108[2][B] | system/n1333_s7/F
12.468 | 0.157 | tNET | RR | 1 | R26C108[3][A] | system/n1333_s5/I1
12.758 | 0.290 | tINS | RF | 1 | R26C108[3][A] | system/n1333_s5/F
12.763 | 0.005 | tNET | FF | 1 | R26C108[3][B] | system/n1333_s2/I2
13.178 | 0.415 | tINS | FR | 4 | R26C108[3][B] | system/n1333_s2/F
14.587 | 1.409 | tNET | RR | 1 | R59C113[1][B] | system/arbiter/n10_s6/I2
14.849 | 0.262 | tINS | RR | 2 | R59C113[1][B] | system/arbiter/n10_s6/F
14.989 | 0.140 | tNET | RR | 1 | R59C113[3][A] | system/arbiter/n27_s4/I1
15.487 | 0.498 | tINS | RR | 2 | R59C113[3][A] | system/arbiter/n27_s4/F
15.647 | 0.160 | tNET | RR | 1 | R60C113[3][B] | system/arbiter/n31_s3/I3
16.144 | 0.498 | tINS | RR | 1 | R60C113[3][B] | system/arbiter/n31_s3/F
16.147 | 0.003 | tNET | RR | 1 | R60C113[3][A] | system/arbiter/n31_s1/I0
16.644 | 0.498 | tINS | RR | 2 | R60C113[3][A] | system/arbiter/n31_s1/F
16.784 | 0.140 | tNET | RR | 1 | R60C113[2][B] | system/arbiter/n153_s4/I0
17.301 | 0.516 | tINS | RR | 44 | R60C113[2][B] | system/arbiter/n153_s4/F
17.656 | 0.355 | tNET | RR | 1 | R58C112[0][B] | system/arbiter/push_valid_s1/I3
18.182 | 0.526 | tINS | RR | 1 | R58C112[0][B] | system/arbiter/push_valid_s1/F
18.184 | 0.003 | tNET | RR | 1 | R58C112[1][A] | system/arbiter/push_valid_s0/I3
18.701 | 0.516 | tINS | RR | 2 | R58C112[1][A] | system/arbiter/push_valid_s0/F
18.706 | 0.005 | tNET | RR | 1 | R58C112[0][A] | system/arbiter/push_valid_s/I0
18.968 | 0.262 | tINS | RR | 3 | R58C112[0][A] | system/arbiter/push_valid_s/F
19.773 | 0.805 | tNET | RR | 1 | R27C111[3][B] | system/n921_s1/I3
20.294 | 0.521 | tINS | RR | 38 | R27C111[3][B] | system/n921_s1/F
22.801 | 2.506 | tNET | RR | 1 | R7C93[0][B] | system/events/n6895_s1/I3
23.063 | 0.262 | tINS | RR | 8 | R7C93[0][B] | system/events/n6895_s1/F
24.448 | 1.385 | tNET | RR | 1 | R22C94[3][A] | system/events/n6964_s0/I3
24.863 | 0.415 | tINS | RR | 8 | R22C94[3][A] | system/events/n6964_s0/F
26.557 | 1.694 | tNET | RR | 1 | R7C95[1][B] | system/events/mem[35]_22_s0/CE

Data Required Path:

AT | DELAY | TYPE | RF | FANOUT | LOC | NODE
20.345 | 20.345 | | | | | active clock edge time
20.345 | 0.000 | | | | | audio_clock/pll_49m152/pll/CLKOUT0.default_gen_clk
25.309 | 4.964 | tCL | RR | 9528 | PLL_T[0] | audio_clock/pll_49m152/pll/CLKOUT0
27.408 | 2.099 | tNET | RR | 1 | R7C95[1][B] | system/events/mem[35]_22_s0/CLK
27.097 | -0.311 | tSu | | 1 | R7C95[1][B] | system/events/mem[35]_22_s0

Path Statistics:

Clock Skew | 0.000
Setup Relationship | 20.345
Logic Level | 18
Arrival Clock Path Delay | cell: 0.000, 0.000%; route: 2.099, 100.000%
Arrival Data Path Delay | cell: 7.032, 36.076%; route: 10.451, 53.613%; tC2Q: 2.010, 10.311%
Required Clock Path Delay | cell: 0.000, 0.000%; route: 2.099, 100.000%

### Path6

Path Summary:

Slack | 0.756
Data Arrival Time | 26.579
Data Required Time | 27.335
From | system/performance/record_ram_record_ram_0_2_s
To | system/performance/event_note_6_s0
Launch Clk | audio_clock/pll_49m152/pll/CLKOUT0.default_gen_clk:[R]
Latch Clk | audio_clock/pll_49m152/pll/CLKOUT0.default_gen_clk:[R]

Data Arrival Path:

AT | DELAY | TYPE | RF | FANOUT | LOC | NODE
0.000 | 0.000 | | | | | active clock edge time
0.000 | 0.000 | | | | | audio_clock/pll_49m152/pll/CLKOUT0.default_gen_clk
4.964 | 4.964 | tCL | RR | 9528 | PLL_T[0] | audio_clock/pll_49m152/pll/CLKOUT0
7.072 | 2.109 | tNET | RR | 16 | BSRAM_R56[31][A] | system/performance/record_ram_record_ram_0_2_s/CLKB
9.077 | 2.005 | tC2Q | RF | 4 | BSRAM_R56[31][A] | system/performance/record_ram_record_ram_0_2_s/DO[1]
10.255 | 1.178 | tNET | FF | 1 | R44C128[0][A] | system/performance/active_key_2_s4/I1
10.781 | 0.526 | tINS | FR | 1 | R44C128[0][A] | system/performance/active_key_2_s4/F
10.784 | 0.003 | tNET | RR | 1 | R44C128[0][B] | system/performance/active_key_2_s3/I1
11.046 | 0.262 | tINS | RR | 1 | R44C128[0][B] | system/performance/active_key_2_s3/F
11.431 | 0.385 | tNET | RR | 1 | R46C127[0][A] | system/performance/active_key_2_s0/I2
11.811 | 0.380 | tINS | RF | 224 | R46C127[0][A] | system/performance/active_key_2_s0/F
15.770 | 3.959 | tNET | FF | 1 | R68C124[2][A] | system/performance/active_note_6_s13/I0
16.296 | 0.526 | tINS | FR | 29 | R68C124[2][A] | system/performance/active_note_6_s13/F
17.575 | 1.279 | tNET | RR | 1 | R70C114[1][A] | system/performance/active_note_1_s125/I0
18.036 | 0.461 | tINS | RR | 1 | R70C114[1][A] | system/performance/active_note_1_s125/F
18.039 | 0.003 | tNET | RR | 1 | R70C114[2][B] | system/performance/active_note_1_s115/I1
18.301 | 0.262 | tINS | RR | 1 | R70C114[2][B] | system/performance/active_note_1_s115/F
18.629 | 0.327 | tNET | RR | 1 | R69C114[2][B] | system/performance/active_note_1_s78/I2
19.155 | 0.526 | tINS | RR | 1 | R69C114[2][B] | system/performance/active_note_1_s78/F
19.821 | 0.666 | tNET | RR | 1 | R62C119[2][B] | system/performance/active_note_1_s25/I3
20.282 | 0.461 | tINS | RR | 1 | R62C119[2][B] | system/performance/active_note_1_s25/F
20.285 | 0.003 | tNET | RR | 1 | R62C119[3][A] | system/performance/active_note_1_s6/I3
20.782 | 0.498 | tINS | RR | 1 | R62C119[3][A] | system/performance/active_note_1_s6/F
20.940 | 0.157 | tNET | RR | 1 | R61C119[3][A] | system/performance/active_note_1_s1/I3
21.230 | 0.290 | tINS | RF | 1 | R61C119[3][A] | system/performance/active_note_1_s1/F
21.696 | 0.466 | tNET | FF | 1 | R61C125[0][A] | system/performance/active_note_1_s0/I0
22.157 | 0.461 | tINS | FR | 2 | R61C125[0][A] | system/performance/active_note_1_s0/F
23.151 | 0.994 | tNET | RR | 2 | R60C138[0][B] | system/performance/n4752_s0/I1
23.714 | 0.562 | tINS | RF | 1 | R60C138[0][B] | system/performance/n4752_s0/COUT
23.714 | 0.000 | tNET | FF | 2 | R60C138[1][A] | system/performance/n4753_s0/CIN
23.764 | 0.050 | tINS | FR | 1 | R60C138[1][A] | system/performance/n4753_s0/COUT
23.764 | 0.000 | tNET | RR | 2 | R60C138[1][B] | system/performance/n4754_s0/CIN
23.814 | 0.050 | tINS | RR | 1 | R60C138[1][B] | system/performance/n4754_s0/COUT
23.814 | 0.000 | tNET | RR | 2 | R60C138[2][A] | system/performance/n4755_s0/CIN
23.864 | 0.050 | tINS | RR | 1 | R60C138[2][A] | system/performance/n4755_s0/COUT
23.864 | 0.000 | tNET | RR | 2 | R60C138[2][B] | system/performance/n4756_s0/CIN
23.914 | 0.050 | tINS | RR | 1 | R60C138[2][B] | system/performance/n4756_s0/COUT
23.914 | 0.000 | tNET | RR | 2 | R60C139[0][A] | system/performance/n4757_s0/CIN
23.964 | 0.050 | tINS | RR | 3 | R60C139[0][A] | system/performance/n4757_s0/COUT
24.775 | 0.811 | tNET | RR | 1 | R60C135[3][A] | system/performance/n5049_s5/I0
25.272 | 0.498 | tINS | RR | 9 | R60C135[3][A] | system/performance/n5049_s5/F
26.052 | 0.780 | tNET | RR | 1 | R63C132[2][A] | system/performance/n5035_s0/I2
26.579 | 0.526 | tINS | RR | 1 | R63C132[2][A] | system/performance/n5035_s0/F
26.579 | 0.000 | tNET | RR | 1 | R63C132[2][A] | system/performance/event_note_6_s0/D

Data Required Path:

AT | DELAY | TYPE | RF | FANOUT | LOC | NODE
20.345 | 20.345 | | | | | active clock edge time
20.345 | 0.000 | | | | | audio_clock/pll_49m152/pll/CLKOUT0.default_gen_clk
25.309 | 4.964 | tCL | RR | 9528 | PLL_T[0] | audio_clock/pll_49m152/pll/CLKOUT0
27.399 | 2.090 | tNET | RR | 1 | R63C132[2][A] | system/performance/event_note_6_s0/CLK
27.335 | -0.064 | tSu | | 1 | R63C132[2][A] | system/performance/event_note_6_s0

Path Statistics:

Clock Skew | -0.019
Setup Relationship | 20.345
Logic Level | 16
Arrival Clock Path Delay | cell: 0.000, 0.000%; route: 2.109, 100.000%
Arrival Data Path Delay | cell: 6.491, 33.278%; route: 11.010, 56.443%; tC2Q: 2.005, 10.279%
Required Clock Path Delay | cell: 0.000, 0.000%; route: 2.090, 100.000%

### Path7

Path Summary:

Slack | 0.787
Data Arrival Time | 26.319
Data Required Time | 27.106
From | system/sensors/eventizer/fifo_fifo_0_0_s
To | system/events/mem[35]_5_s0
Launch Clk | audio_clock/pll_49m152/pll/CLKOUT0.default_gen_clk:[R]
Latch Clk | audio_clock/pll_49m152/pll/CLKOUT0.default_gen_clk:[R]

Data Arrival Path:

AT | DELAY | TYPE | RF | FANOUT | LOC | NODE
0.000 | 0.000 | | | | | active clock edge time
0.000 | 0.000 | | | | | audio_clock/pll_49m152/pll/CLKOUT0.default_gen_clk
4.964 | 4.964 | tCL | RR | 9528 | PLL_T[0] | audio_clock/pll_49m152/pll/CLKOUT0
7.063 | 2.099 | tNET | RR | 16 | BSRAM_R19[6] | system/sensors/eventizer/fifo_fifo_0_0_s/CLKB
9.073 | 2.010 | tC2Q | RR | 7 | BSRAM_R19[6] | system/sensors/eventizer/fifo_fifo_0_0_s/DO[13]
9.316 | 0.243 | tNET | RR | 1 | R20C104[3][B] | system/n1299_s4/I0
9.837 | 0.521 | tINS | RR | 3 | R20C104[3][B] | system/n1299_s4/F
10.167 | 0.330 | tNET | RR | 1 | R20C103[2][B] | system/n1327_s62/S0
10.419 | 0.252 | tINS | RR | 2 | R20C103[2][B] | system/n1327_s62/O
10.959 | 0.540 | tNET | RR | 1 | R20C108[0][B] | system/n1333_s8/I0
11.222 | 0.262 | tINS | RR | 1 | R20C108[0][B] | system/n1333_s8/F
11.794 | 0.572 | tNET | RR | 1 | R25C108[2][B] | system/n1333_s7/I2
12.311 | 0.516 | tINS | RR | 1 | R25C108[2][B] | system/n1333_s7/F
12.468 | 0.157 | tNET | RR | 1 | R26C108[3][A] | system/n1333_s5/I1
12.758 | 0.290 | tINS | RF | 1 | R26C108[3][A] | system/n1333_s5/F
12.763 | 0.005 | tNET | FF | 1 | R26C108[3][B] | system/n1333_s2/I2
13.178 | 0.415 | tINS | FR | 4 | R26C108[3][B] | system/n1333_s2/F
14.587 | 1.409 | tNET | RR | 1 | R59C113[1][B] | system/arbiter/n10_s6/I2
14.849 | 0.262 | tINS | RR | 2 | R59C113[1][B] | system/arbiter/n10_s6/F
14.989 | 0.140 | tNET | RR | 1 | R59C113[3][A] | system/arbiter/n27_s4/I1
15.487 | 0.498 | tINS | RR | 2 | R59C113[3][A] | system/arbiter/n27_s4/F
15.647 | 0.160 | tNET | RR | 1 | R60C113[3][B] | system/arbiter/n31_s3/I3
16.144 | 0.498 | tINS | RR | 1 | R60C113[3][B] | system/arbiter/n31_s3/F
16.147 | 0.003 | tNET | RR | 1 | R60C113[3][A] | system/arbiter/n31_s1/I0
16.644 | 0.498 | tINS | RR | 2 | R60C113[3][A] | system/arbiter/n31_s1/F
16.784 | 0.140 | tNET | RR | 1 | R60C113[2][B] | system/arbiter/n153_s4/I0
17.301 | 0.516 | tINS | RR | 44 | R60C113[2][B] | system/arbiter/n153_s4/F
17.656 | 0.355 | tNET | RR | 1 | R58C112[0][B] | system/arbiter/push_valid_s1/I3
18.182 | 0.526 | tINS | RR | 1 | R58C112[0][B] | system/arbiter/push_valid_s1/F
18.184 | 0.003 | tNET | RR | 1 | R58C112[1][A] | system/arbiter/push_valid_s0/I3
18.701 | 0.516 | tINS | RR | 2 | R58C112[1][A] | system/arbiter/push_valid_s0/F
18.706 | 0.005 | tNET | RR | 1 | R58C112[0][A] | system/arbiter/push_valid_s/I0
18.968 | 0.262 | tINS | RR | 3 | R58C112[0][A] | system/arbiter/push_valid_s/F
19.773 | 0.805 | tNET | RR | 1 | R27C111[3][B] | system/n921_s1/I3
20.294 | 0.521 | tINS | RR | 38 | R27C111[3][B] | system/n921_s1/F
22.801 | 2.506 | tNET | RR | 1 | R7C93[0][B] | system/events/n6895_s1/I3
23.063 | 0.262 | tINS | RR | 8 | R7C93[0][B] | system/events/n6895_s1/F
24.448 | 1.385 | tNET | RR | 1 | R22C94[3][A] | system/events/n6964_s0/I3
24.863 | 0.415 | tINS | RR | 8 | R22C94[3][A] | system/events/n6964_s0/F
26.319 | 1.456 | tNET | RR | 1 | R14C98[2][A] | system/events/mem[35]_5_s0/CE

Data Required Path:

AT | DELAY | TYPE | RF | FANOUT | LOC | NODE
20.345 | 20.345 | | | | | active clock edge time
20.345 | 0.000 | | | | | audio_clock/pll_49m152/pll/CLKOUT0.default_gen_clk
25.309 | 4.964 | tCL | RR | 9528 | PLL_T[0] | audio_clock/pll_49m152/pll/CLKOUT0
27.417 | 2.109 | tNET | RR | 1 | R14C98[2][A] | system/events/mem[35]_5_s0/CLK
27.106 | -0.311 | tSu | | 1 | R14C98[2][A] | system/events/mem[35]_5_s0

Path Statistics:

Clock Skew | 0.009
Setup Relationship | 20.345
Logic Level | 18
Arrival Clock Path Delay | cell: 0.000, 0.000%; route: 2.099, 100.000%
Arrival Data Path Delay | cell: 7.032, 36.521%; route: 10.214, 53.041%; tC2Q: 2.010, 10.438%
Required Clock Path Delay | cell: 0.000, 0.000%; route: 2.109, 100.000%

### Path8

Path Summary:

Slack | 0.787
Data Arrival Time | 26.319
Data Required Time | 27.106
From | system/sensors/eventizer/fifo_fifo_0_0_s
To | system/events/mem[35]_6_s0
Launch Clk | audio_clock/pll_49m152/pll/CLKOUT0.default_gen_clk:[R]
Latch Clk | audio_clock/pll_49m152/pll/CLKOUT0.default_gen_clk:[R]

Data Arrival Path:

AT | DELAY | TYPE | RF | FANOUT | LOC | NODE
0.000 | 0.000 | | | | | active clock edge time
0.000 | 0.000 | | | | | audio_clock/pll_49m152/pll/CLKOUT0.default_gen_clk
4.964 | 4.964 | tCL | RR | 9528 | PLL_T[0] | audio_clock/pll_49m152/pll/CLKOUT0
7.063 | 2.099 | tNET | RR | 16 | BSRAM_R19[6] | system/sensors/eventizer/fifo_fifo_0_0_s/CLKB
9.073 | 2.010 | tC2Q | RR | 7 | BSRAM_R19[6] | system/sensors/eventizer/fifo_fifo_0_0_s/DO[13]
9.316 | 0.243 | tNET | RR | 1 | R20C104[3][B] | system/n1299_s4/I0
9.837 | 0.521 | tINS | RR | 3 | R20C104[3][B] | system/n1299_s4/F
10.167 | 0.330 | tNET | RR | 1 | R20C103[2][B] | system/n1327_s62/S0
10.419 | 0.252 | tINS | RR | 2 | R20C103[2][B] | system/n1327_s62/O
10.959 | 0.540 | tNET | RR | 1 | R20C108[0][B] | system/n1333_s8/I0
11.222 | 0.262 | tINS | RR | 1 | R20C108[0][B] | system/n1333_s8/F
11.794 | 0.572 | tNET | RR | 1 | R25C108[2][B] | system/n1333_s7/I2
12.311 | 0.516 | tINS | RR | 1 | R25C108[2][B] | system/n1333_s7/F
12.468 | 0.157 | tNET | RR | 1 | R26C108[3][A] | system/n1333_s5/I1
12.758 | 0.290 | tINS | RF | 1 | R26C108[3][A] | system/n1333_s5/F
12.763 | 0.005 | tNET | FF | 1 | R26C108[3][B] | system/n1333_s2/I2
13.178 | 0.415 | tINS | FR | 4 | R26C108[3][B] | system/n1333_s2/F
14.587 | 1.409 | tNET | RR | 1 | R59C113[1][B] | system/arbiter/n10_s6/I2
14.849 | 0.262 | tINS | RR | 2 | R59C113[1][B] | system/arbiter/n10_s6/F
14.989 | 0.140 | tNET | RR | 1 | R59C113[3][A] | system/arbiter/n27_s4/I1
15.487 | 0.498 | tINS | RR | 2 | R59C113[3][A] | system/arbiter/n27_s4/F
15.647 | 0.160 | tNET | RR | 1 | R60C113[3][B] | system/arbiter/n31_s3/I3
16.144 | 0.498 | tINS | RR | 1 | R60C113[3][B] | system/arbiter/n31_s3/F
16.147 | 0.003 | tNET | RR | 1 | R60C113[3][A] | system/arbiter/n31_s1/I0
16.644 | 0.498 | tINS | RR | 2 | R60C113[3][A] | system/arbiter/n31_s1/F
16.784 | 0.140 | tNET | RR | 1 | R60C113[2][B] | system/arbiter/n153_s4/I0
17.301 | 0.516 | tINS | RR | 44 | R60C113[2][B] | system/arbiter/n153_s4/F
17.656 | 0.355 | tNET | RR | 1 | R58C112[0][B] | system/arbiter/push_valid_s1/I3
18.182 | 0.526 | tINS | RR | 1 | R58C112[0][B] | system/arbiter/push_valid_s1/F
18.184 | 0.003 | tNET | RR | 1 | R58C112[1][A] | system/arbiter/push_valid_s0/I3
18.701 | 0.516 | tINS | RR | 2 | R58C112[1][A] | system/arbiter/push_valid_s0/F
18.706 | 0.005 | tNET | RR | 1 | R58C112[0][A] | system/arbiter/push_valid_s/I0
18.968 | 0.262 | tINS | RR | 3 | R58C112[0][A] | system/arbiter/push_valid_s/F
19.773 | 0.805 | tNET | RR | 1 | R27C111[3][B] | system/n921_s1/I3
20.294 | 0.521 | tINS | RR | 38 | R27C111[3][B] | system/n921_s1/F
22.801 | 2.506 | tNET | RR | 1 | R7C93[0][B] | system/events/n6895_s1/I3
23.063 | 0.262 | tINS | RR | 8 | R7C93[0][B] | system/events/n6895_s1/F
24.448 | 1.385 | tNET | RR | 1 | R22C94[3][A] | system/events/n6964_s0/I3
24.863 | 0.415 | tINS | RR | 8 | R22C94[3][A] | system/events/n6964_s0/F
26.319 | 1.456 | tNET | RR | 1 | R14C98[2][B] | system/events/mem[35]_6_s0/CE

Data Required Path:

AT | DELAY | TYPE | RF | FANOUT | LOC | NODE
20.345 | 20.345 | | | | | active clock edge time
20.345 | 0.000 | | | | | audio_clock/pll_49m152/pll/CLKOUT0.default_gen_clk
25.309 | 4.964 | tCL | RR | 9528 | PLL_T[0] | audio_clock/pll_49m152/pll/CLKOUT0
27.417 | 2.109 | tNET | RR | 1 | R14C98[2][B] | system/events/mem[35]_6_s0/CLK
27.106 | -0.311 | tSu | | 1 | R14C98[2][B] | system/events/mem[35]_6_s0

Path Statistics:

Clock Skew | 0.009
Setup Relationship | 20.345
Logic Level | 18
Arrival Clock Path Delay | cell: 0.000, 0.000%; route: 2.099, 100.000%
Arrival Data Path Delay | cell: 7.032, 36.521%; route: 10.214, 53.041%; tC2Q: 2.010, 10.438%
Required Clock Path Delay | cell: 0.000, 0.000%; route: 2.109, 100.000%

### Path9

Path Summary:

Slack | 0.791
Data Arrival Time | 26.316
Data Required Time | 27.106
From | system/sensors/eventizer/fifo_fifo_0_0_s
To | system/events/mem[39]_4_s0
Launch Clk | audio_clock/pll_49m152/pll/CLKOUT0.default_gen_clk:[R]
Latch Clk | audio_clock/pll_49m152/pll/CLKOUT0.default_gen_clk:[R]

Data Arrival Path:

AT | DELAY | TYPE | RF | FANOUT | LOC | NODE
0.000 | 0.000 | | | | | active clock edge time
0.000 | 0.000 | | | | | audio_clock/pll_49m152/pll/CLKOUT0.default_gen_clk
4.964 | 4.964 | tCL | RR | 9528 | PLL_T[0] | audio_clock/pll_49m152/pll/CLKOUT0
7.063 | 2.099 | tNET | RR | 16 | BSRAM_R19[6] | system/sensors/eventizer/fifo_fifo_0_0_s/CLKB
9.073 | 2.010 | tC2Q | RR | 7 | BSRAM_R19[6] | system/sensors/eventizer/fifo_fifo_0_0_s/DO[13]
9.316 | 0.243 | tNET | RR | 1 | R20C104[3][B] | system/n1299_s4/I0
9.837 | 0.521 | tINS | RR | 3 | R20C104[3][B] | system/n1299_s4/F
10.167 | 0.330 | tNET | RR | 1 | R20C103[2][B] | system/n1327_s62/S0
10.419 | 0.252 | tINS | RR | 2 | R20C103[2][B] | system/n1327_s62/O
10.959 | 0.540 | tNET | RR | 1 | R20C108[0][B] | system/n1333_s8/I0
11.222 | 0.262 | tINS | RR | 1 | R20C108[0][B] | system/n1333_s8/F
11.794 | 0.572 | tNET | RR | 1 | R25C108[2][B] | system/n1333_s7/I2
12.311 | 0.516 | tINS | RR | 1 | R25C108[2][B] | system/n1333_s7/F
12.468 | 0.157 | tNET | RR | 1 | R26C108[3][A] | system/n1333_s5/I1
12.758 | 0.290 | tINS | RF | 1 | R26C108[3][A] | system/n1333_s5/F
12.763 | 0.005 | tNET | FF | 1 | R26C108[3][B] | system/n1333_s2/I2
13.178 | 0.415 | tINS | FR | 4 | R26C108[3][B] | system/n1333_s2/F
14.587 | 1.409 | tNET | RR | 1 | R59C113[1][B] | system/arbiter/n10_s6/I2
14.849 | 0.262 | tINS | RR | 2 | R59C113[1][B] | system/arbiter/n10_s6/F
14.989 | 0.140 | tNET | RR | 1 | R59C113[3][A] | system/arbiter/n27_s4/I1
15.487 | 0.498 | tINS | RR | 2 | R59C113[3][A] | system/arbiter/n27_s4/F
15.647 | 0.160 | tNET | RR | 1 | R60C113[3][B] | system/arbiter/n31_s3/I3
16.144 | 0.498 | tINS | RR | 1 | R60C113[3][B] | system/arbiter/n31_s3/F
16.147 | 0.003 | tNET | RR | 1 | R60C113[3][A] | system/arbiter/n31_s1/I0
16.644 | 0.498 | tINS | RR | 2 | R60C113[3][A] | system/arbiter/n31_s1/F
16.784 | 0.140 | tNET | RR | 1 | R60C113[2][B] | system/arbiter/n153_s4/I0
17.301 | 0.516 | tINS | RR | 44 | R60C113[2][B] | system/arbiter/n153_s4/F
17.656 | 0.355 | tNET | RR | 1 | R58C112[0][B] | system/arbiter/push_valid_s1/I3
18.182 | 0.526 | tINS | RR | 1 | R58C112[0][B] | system/arbiter/push_valid_s1/F
18.184 | 0.003 | tNET | RR | 1 | R58C112[1][A] | system/arbiter/push_valid_s0/I3
18.701 | 0.516 | tINS | RR | 2 | R58C112[1][A] | system/arbiter/push_valid_s0/F
18.706 | 0.005 | tNET | RR | 1 | R58C112[0][A] | system/arbiter/push_valid_s/I0
18.968 | 0.262 | tINS | RR | 3 | R58C112[0][A] | system/arbiter/push_valid_s/F
19.773 | 0.805 | tNET | RR | 1 | R27C111[3][B] | system/n921_s1/I3
20.294 | 0.521 | tINS | RR | 38 | R27C111[3][B] | system/n921_s1/F
22.801 | 2.506 | tNET | RR | 1 | R7C93[0][B] | system/events/n6895_s1/I3
23.063 | 0.262 | tINS | RR | 8 | R7C93[0][B] | system/events/n6895_s1/F
24.506 | 1.442 | tNET | RR | 1 | R15C97[1][B] | system/events/n7056_s0/I3
25.022 | 0.516 | tINS | RR | 8 | R15C97[1][B] | system/events/n7056_s0/F
26.316 | 1.294 | tNET | RR | 1 | R22C90[0][B] | system/events/mem[39]_4_s0/CE

Data Required Path:

AT | DELAY | TYPE | RF | FANOUT | LOC | NODE
20.345 | 20.345 | | | | | active clock edge time
20.345 | 0.000 | | | | | audio_clock/pll_49m152/pll/CLKOUT0.default_gen_clk
25.309 | 4.964 | tCL | RR | 9528 | PLL_T[0] | audio_clock/pll_49m152/pll/CLKOUT0
27.417 | 2.109 | tNET | RR | 1 | R22C90[0][B] | system/events/mem[39]_4_s0/CLK
27.106 | -0.311 | tSu | | 1 | R22C90[0][B] | system/events/mem[39]_4_s0

Path Statistics:

Clock Skew | 0.009
Setup Relationship | 20.345
Logic Level | 18
Arrival Clock Path Delay | cell: 0.000, 0.000%; route: 2.099, 100.000%
Arrival Data Path Delay | cell: 7.134, 37.054%; route: 10.109, 52.506%; tC2Q: 2.010, 10.440%
Required Clock Path Delay | cell: 0.000, 0.000%; route: 2.109, 100.000%

### Path10

Path Summary:

Slack | 0.848
Data Arrival Time | 26.496
Data Required Time | 27.344
From | system/performance/record_ram_record_ram_0_2_s
To | system/performance/event_on_s0
Launch Clk | audio_clock/pll_49m152/pll/CLKOUT0.default_gen_clk:[R]
Latch Clk | audio_clock/pll_49m152/pll/CLKOUT0.default_gen_clk:[R]

Data Arrival Path:

AT | DELAY | TYPE | RF | FANOUT | LOC | NODE
0.000 | 0.000 | | | | | active clock edge time
0.000 | 0.000 | | | | | audio_clock/pll_49m152/pll/CLKOUT0.default_gen_clk
4.964 | 4.964 | tCL | RR | 9528 | PLL_T[0] | audio_clock/pll_49m152/pll/CLKOUT0
7.072 | 2.109 | tNET | RR | 16 | BSRAM_R56[31][A] | system/performance/record_ram_record_ram_0_2_s/CLKB
9.077 | 2.005 | tC2Q | RF | 4 | BSRAM_R56[31][A] | system/performance/record_ram_record_ram_0_2_s/DO[1]
10.255 | 1.178 | tNET | FF | 1 | R44C128[0][A] | system/performance/active_key_2_s4/I1
10.781 | 0.526 | tINS | FR | 1 | R44C128[0][A] | system/performance/active_key_2_s4/F
10.784 | 0.003 | tNET | RR | 1 | R44C128[0][B] | system/performance/active_key_2_s3/I1
11.046 | 0.262 | tINS | RR | 1 | R44C128[0][B] | system/performance/active_key_2_s3/F
11.431 | 0.385 | tNET | RR | 1 | R46C127[0][A] | system/performance/active_key_2_s0/I2
11.811 | 0.380 | tINS | RF | 224 | R46C127[0][A] | system/performance/active_key_2_s0/F
15.770 | 3.959 | tNET | FF | 1 | R68C124[2][A] | system/performance/active_note_6_s13/I0
16.296 | 0.526 | tINS | FR | 29 | R68C124[2][A] | system/performance/active_note_6_s13/F
17.575 | 1.279 | tNET | RR | 1 | R70C114[1][A] | system/performance/active_note_1_s125/I0
18.036 | 0.461 | tINS | RR | 1 | R70C114[1][A] | system/performance/active_note_1_s125/F
18.039 | 0.003 | tNET | RR | 1 | R70C114[2][B] | system/performance/active_note_1_s115/I1
18.301 | 0.262 | tINS | RR | 1 | R70C114[2][B] | system/performance/active_note_1_s115/F
18.629 | 0.327 | tNET | RR | 1 | R69C114[2][B] | system/performance/active_note_1_s78/I2
19.155 | 0.526 | tINS | RR | 1 | R69C114[2][B] | system/performance/active_note_1_s78/F
19.821 | 0.666 | tNET | RR | 1 | R62C119[2][B] | system/performance/active_note_1_s25/I3
20.282 | 0.461 | tINS | RR | 1 | R62C119[2][B] | system/performance/active_note_1_s25/F
20.285 | 0.003 | tNET | RR | 1 | R62C119[3][A] | system/performance/active_note_1_s6/I3
20.782 | 0.498 | tINS | RR | 1 | R62C119[3][A] | system/performance/active_note_1_s6/F
20.940 | 0.157 | tNET | RR | 1 | R61C119[3][A] | system/performance/active_note_1_s1/I3
21.230 | 0.290 | tINS | RF | 1 | R61C119[3][A] | system/performance/active_note_1_s1/F
21.696 | 0.466 | tNET | FF | 1 | R61C125[0][A] | system/performance/active_note_1_s0/I0
22.157 | 0.461 | tINS | FR | 2 | R61C125[0][A] | system/performance/active_note_1_s0/F
23.151 | 0.994 | tNET | RR | 2 | R60C138[0][B] | system/performance/n4752_s0/I1
23.714 | 0.562 | tINS | RF | 1 | R60C138[0][B] | system/performance/n4752_s0/COUT
23.714 | 0.000 | tNET | FF | 2 | R60C138[1][A] | system/performance/n4753_s0/CIN
23.764 | 0.050 | tINS | FR | 1 | R60C138[1][A] | system/performance/n4753_s0/COUT
23.764 | 0.000 | tNET | RR | 2 | R60C138[1][B] | system/performance/n4754_s0/CIN
23.814 | 0.050 | tINS | RR | 1 | R60C138[1][B] | system/performance/n4754_s0/COUT
23.814 | 0.000 | tNET | RR | 2 | R60C138[2][A] | system/performance/n4755_s0/CIN
23.864 | 0.050 | tINS | RR | 1 | R60C138[2][A] | system/performance/n4755_s0/COUT
23.864 | 0.000 | tNET | RR | 2 | R60C138[2][B] | system/performance/n4756_s0/CIN
23.914 | 0.050 | tINS | RR | 1 | R60C138[2][B] | system/performance/n4756_s0/COUT
23.914 | 0.000 | tNET | RR | 2 | R60C139[0][A] | system/performance/n4757_s0/CIN
23.964 | 0.050 | tINS | RR | 3 | R60C139[0][A] | system/performance/n4757_s0/COUT
24.772 | 0.809 | tNET | RR | 1 | R60C135[3][B] | system/performance/n5028_s10/I2
25.270 | 0.498 | tINS | RR | 8 | R60C135[3][B] | system/performance/n5028_s10/F
26.496 | 1.226 | tNET | RR | 1 | R49C135[0][A] | system/performance/event_on_s0/D

Data Required Path:

AT | DELAY | TYPE | RF | FANOUT | LOC | NODE
20.345 | 20.345 | | | | | active clock edge time
20.345 | 0.000 | | | | | audio_clock/pll_49m152/pll/CLKOUT0.default_gen_clk
25.309 | 4.964 | tCL | RR | 9528 | PLL_T[0] | audio_clock/pll_49m152/pll/CLKOUT0
27.408 | 2.099 | tNET | RR | 1 | R49C135[0][A] | system/performance/event_on_s0/CLK
27.344 | -0.064 | tSu | | 1 | R49C135[0][A] | system/performance/event_on_s0

Path Statistics:

Clock Skew | -0.009
Setup Relationship | 20.345
Logic Level | 15
Arrival Clock Path Delay | cell: 0.000, 0.000%; route: 2.109, 100.000%
Arrival Data Path Delay | cell: 5.965, 30.710%; route: 11.454, 58.968%; tC2Q: 2.005, 10.322%
Required Clock Path Delay | cell: 0.000, 0.000%; route: 2.099, 100.000%

### Path11

Path Summary:

Slack | 0.858
Data Arrival Time | 26.239
Data Required Time | 27.097
From | system/sensors/eventizer/fifo_fifo_0_0_s
To | system/performance/last_record_ms_0_s0
Launch Clk | audio_clock/pll_49m152/pll/CLKOUT0.default_gen_clk:[R]
Latch Clk | audio_clock/pll_49m152/pll/CLKOUT0.default_gen_clk:[R]

Data Arrival Path:

AT | DELAY | TYPE | RF | FANOUT | LOC | NODE
0.000 | 0.000 | | | | | active clock edge time
0.000 | 0.000 | | | | | audio_clock/pll_49m152/pll/CLKOUT0.default_gen_clk
4.964 | 4.964 | tCL | RR | 9528 | PLL_T[0] | audio_clock/pll_49m152/pll/CLKOUT0
7.063 | 2.099 | tNET | RR | 16 | BSRAM_R19[6] | system/sensors/eventizer/fifo_fifo_0_0_s/CLKB
9.073 | 2.010 | tC2Q | RR | 7 | BSRAM_R19[6] | system/sensors/eventizer/fifo_fifo_0_0_s/DO[13]
9.316 | 0.243 | tNET | RR | 1 | R20C104[3][B] | system/n1299_s4/I0
9.837 | 0.521 | tINS | RR | 3 | R20C104[3][B] | system/n1299_s4/F
10.167 | 0.330 | tNET | RR | 1 | R20C103[2][B] | system/n1327_s62/S0
10.419 | 0.252 | tINS | RR | 2 | R20C103[2][B] | system/n1327_s62/O
10.959 | 0.540 | tNET | RR | 1 | R20C108[0][B] | system/n1333_s8/I0
11.222 | 0.262 | tINS | RR | 1 | R20C108[0][B] | system/n1333_s8/F
11.794 | 0.572 | tNET | RR | 1 | R25C108[2][B] | system/n1333_s7/I2
12.311 | 0.516 | tINS | RR | 1 | R25C108[2][B] | system/n1333_s7/F
12.468 | 0.157 | tNET | RR | 1 | R26C108[3][A] | system/n1333_s5/I1
12.758 | 0.290 | tINS | RF | 1 | R26C108[3][A] | system/n1333_s5/F
12.763 | 0.005 | tNET | FF | 1 | R26C108[3][B] | system/n1333_s2/I2
13.178 | 0.415 | tINS | FR | 4 | R26C108[3][B] | system/n1333_s2/F
14.587 | 1.409 | tNET | RR | 1 | R59C113[1][B] | system/arbiter/n10_s6/I2
14.849 | 0.262 | tINS | RR | 2 | R59C113[1][B] | system/arbiter/n10_s6/F
14.989 | 0.140 | tNET | RR | 1 | R59C113[3][A] | system/arbiter/n27_s4/I1
15.487 | 0.498 | tINS | RR | 2 | R59C113[3][A] | system/arbiter/n27_s4/F
15.647 | 0.160 | tNET | RR | 1 | R60C113[3][B] | system/arbiter/n31_s3/I3
16.144 | 0.498 | tINS | RR | 1 | R60C113[3][B] | system/arbiter/n31_s3/F
16.147 | 0.003 | tNET | RR | 1 | R60C113[3][A] | system/arbiter/n31_s1/I0
16.644 | 0.498 | tINS | RR | 2 | R60C113[3][A] | system/arbiter/n31_s1/F
16.784 | 0.140 | tNET | RR | 1 | R60C113[2][B] | system/arbiter/n153_s4/I0
17.301 | 0.516 | tINS | RR | 44 | R60C113[2][B] | system/arbiter/n153_s4/F
17.656 | 0.355 | tNET | RR | 1 | R58C112[0][B] | system/arbiter/push_valid_s1/I3
18.182 | 0.526 | tINS | RR | 1 | R58C112[0][B] | system/arbiter/push_valid_s1/F
18.184 | 0.003 | tNET | RR | 1 | R58C112[1][A] | system/arbiter/push_valid_s0/I3
18.701 | 0.516 | tINS | RR | 2 | R58C112[1][A] | system/arbiter/push_valid_s0/F
18.706 | 0.005 | tNET | RR | 1 | R58C112[0][A] | system/arbiter/push_valid_s/I0
18.968 | 0.262 | tINS | RR | 3 | R58C112[0][A] | system/arbiter/push_valid_s/F
19.773 | 0.805 | tNET | RR | 1 | R27C111[3][B] | system/n921_s1/I3
20.294 | 0.521 | tINS | RR | 38 | R27C111[3][B] | system/n921_s1/F
21.979 | 1.685 | tNET | RR | 1 | R59C135[3][A] | system/performance/record_capture_s4/I3
22.477 | 0.498 | tINS | RR | 1 | R59C135[3][A] | system/performance/record_capture_s4/F
22.479 | 0.003 | tNET | RR | 1 | R59C135[2][B] | system/performance/record_capture_s2/I3
22.941 | 0.461 | tINS | RR | 6 | R59C135[2][B] | system/performance/record_capture_s2/F
23.193 | 0.252 | tNET | RR | 1 | R57C135[0][B] | system/performance/record_capture_s5/I1
23.654 | 0.461 | tINS | RR | 24 | R57C135[0][B] | system/performance/record_capture_s5/F
24.367 | 0.712 | tNET | RR | 1 | R54C137[2][A] | system/performance/n8662_s0/I3
24.883 | 0.516 | tINS | RR | 32 | R54C137[2][A] | system/performance/n8662_s0/F
26.239 | 1.356 | tNET | RR | 1 | R50C133[1][B] | system/performance/last_record_ms_0_s0/CE

Data Required Path:

AT | DELAY | TYPE | RF | FANOUT | LOC | NODE
20.345 | 20.345 | | | | | active clock edge time
20.345 | 0.000 | | | | | audio_clock/pll_49m152/pll/CLKOUT0.default_gen_clk
25.309 | 4.964 | tCL | RR | 9528 | PLL_T[0] | audio_clock/pll_49m152/pll/CLKOUT0
27.408 | 2.099 | tNET | RR | 1 | R50C133[1][B] | system/performance/last_record_ms_0_s0/CLK
27.097 | -0.311 | tSu | | 1 | R50C133[1][B] | system/performance/last_record_ms_0_s0

Path Statistics:

Clock Skew | 0.000
Setup Relationship | 20.345
Logic Level | 20
Arrival Clock Path Delay | cell: 0.000, 0.000%; route: 2.099, 100.000%
Arrival Data Path Delay | cell: 8.291, 43.237%; route: 8.875, 46.281%; tC2Q: 2.010, 10.482%
Required Clock Path Delay | cell: 0.000, 0.000%; route: 2.099, 100.000%

### Path12

Path Summary:

Slack | 0.858
Data Arrival Time | 26.239
Data Required Time | 27.097
From | system/sensors/eventizer/fifo_fifo_0_0_s
To | system/performance/last_record_ms_2_s0
Launch Clk | audio_clock/pll_49m152/pll/CLKOUT0.default_gen_clk:[R]
Latch Clk | audio_clock/pll_49m152/pll/CLKOUT0.default_gen_clk:[R]

Data Arrival Path:

AT | DELAY | TYPE | RF | FANOUT | LOC | NODE
0.000 | 0.000 | | | | | active clock edge time
0.000 | 0.000 | | | | | audio_clock/pll_49m152/pll/CLKOUT0.default_gen_clk
4.964 | 4.964 | tCL | RR | 9528 | PLL_T[0] | audio_clock/pll_49m152/pll/CLKOUT0
7.063 | 2.099 | tNET | RR | 16 | BSRAM_R19[6] | system/sensors/eventizer/fifo_fifo_0_0_s/CLKB
9.073 | 2.010 | tC2Q | RR | 7 | BSRAM_R19[6] | system/sensors/eventizer/fifo_fifo_0_0_s/DO[13]
9.316 | 0.243 | tNET | RR | 1 | R20C104[3][B] | system/n1299_s4/I0
9.837 | 0.521 | tINS | RR | 3 | R20C104[3][B] | system/n1299_s4/F
10.167 | 0.330 | tNET | RR | 1 | R20C103[2][B] | system/n1327_s62/S0
10.419 | 0.252 | tINS | RR | 2 | R20C103[2][B] | system/n1327_s62/O
10.959 | 0.540 | tNET | RR | 1 | R20C108[0][B] | system/n1333_s8/I0
11.222 | 0.262 | tINS | RR | 1 | R20C108[0][B] | system/n1333_s8/F
11.794 | 0.572 | tNET | RR | 1 | R25C108[2][B] | system/n1333_s7/I2
12.311 | 0.516 | tINS | RR | 1 | R25C108[2][B] | system/n1333_s7/F
12.468 | 0.157 | tNET | RR | 1 | R26C108[3][A] | system/n1333_s5/I1
12.758 | 0.290 | tINS | RF | 1 | R26C108[3][A] | system/n1333_s5/F
12.763 | 0.005 | tNET | FF | 1 | R26C108[3][B] | system/n1333_s2/I2
13.178 | 0.415 | tINS | FR | 4 | R26C108[3][B] | system/n1333_s2/F
14.587 | 1.409 | tNET | RR | 1 | R59C113[1][B] | system/arbiter/n10_s6/I2
14.849 | 0.262 | tINS | RR | 2 | R59C113[1][B] | system/arbiter/n10_s6/F
14.989 | 0.140 | tNET | RR | 1 | R59C113[3][A] | system/arbiter/n27_s4/I1
15.487 | 0.498 | tINS | RR | 2 | R59C113[3][A] | system/arbiter/n27_s4/F
15.647 | 0.160 | tNET | RR | 1 | R60C113[3][B] | system/arbiter/n31_s3/I3
16.144 | 0.498 | tINS | RR | 1 | R60C113[3][B] | system/arbiter/n31_s3/F
16.147 | 0.003 | tNET | RR | 1 | R60C113[3][A] | system/arbiter/n31_s1/I0
16.644 | 0.498 | tINS | RR | 2 | R60C113[3][A] | system/arbiter/n31_s1/F
16.784 | 0.140 | tNET | RR | 1 | R60C113[2][B] | system/arbiter/n153_s4/I0
17.301 | 0.516 | tINS | RR | 44 | R60C113[2][B] | system/arbiter/n153_s4/F
17.656 | 0.355 | tNET | RR | 1 | R58C112[0][B] | system/arbiter/push_valid_s1/I3
18.182 | 0.526 | tINS | RR | 1 | R58C112[0][B] | system/arbiter/push_valid_s1/F
18.184 | 0.003 | tNET | RR | 1 | R58C112[1][A] | system/arbiter/push_valid_s0/I3
18.701 | 0.516 | tINS | RR | 2 | R58C112[1][A] | system/arbiter/push_valid_s0/F
18.706 | 0.005 | tNET | RR | 1 | R58C112[0][A] | system/arbiter/push_valid_s/I0
18.968 | 0.262 | tINS | RR | 3 | R58C112[0][A] | system/arbiter/push_valid_s/F
19.773 | 0.805 | tNET | RR | 1 | R27C111[3][B] | system/n921_s1/I3
20.294 | 0.521 | tINS | RR | 38 | R27C111[3][B] | system/n921_s1/F
21.979 | 1.685 | tNET | RR | 1 | R59C135[3][A] | system/performance/record_capture_s4/I3
22.477 | 0.498 | tINS | RR | 1 | R59C135[3][A] | system/performance/record_capture_s4/F
22.479 | 0.003 | tNET | RR | 1 | R59C135[2][B] | system/performance/record_capture_s2/I3
22.941 | 0.461 | tINS | RR | 6 | R59C135[2][B] | system/performance/record_capture_s2/F
23.193 | 0.252 | tNET | RR | 1 | R57C135[0][B] | system/performance/record_capture_s5/I1
23.654 | 0.461 | tINS | RR | 24 | R57C135[0][B] | system/performance/record_capture_s5/F
24.367 | 0.712 | tNET | RR | 1 | R54C137[2][A] | system/performance/n8662_s0/I3
24.883 | 0.516 | tINS | RR | 32 | R54C137[2][A] | system/performance/n8662_s0/F
26.239 | 1.356 | tNET | RR | 1 | R50C133[0][B] | system/performance/last_record_ms_2_s0/CE

Data Required Path:

AT | DELAY | TYPE | RF | FANOUT | LOC | NODE
20.345 | 20.345 | | | | | active clock edge time
20.345 | 0.000 | | | | | audio_clock/pll_49m152/pll/CLKOUT0.default_gen_clk
25.309 | 4.964 | tCL | RR | 9528 | PLL_T[0] | audio_clock/pll_49m152/pll/CLKOUT0
27.408 | 2.099 | tNET | RR | 1 | R50C133[0][B] | system/performance/last_record_ms_2_s0/CLK
27.097 | -0.311 | tSu | | 1 | R50C133[0][B] | system/performance/last_record_ms_2_s0

Path Statistics:

Clock Skew | 0.000
Setup Relationship | 20.345
Logic Level | 20
Arrival Clock Path Delay | cell: 0.000, 0.000%; route: 2.099, 100.000%
Arrival Data Path Delay | cell: 8.291, 43.237%; route: 8.875, 46.281%; tC2Q: 2.010, 10.482%
Required Clock Path Delay | cell: 0.000, 0.000%; route: 2.099, 100.000%

### Path13

Path Summary:

Slack | 0.858
Data Arrival Time | 26.239
Data Required Time | 27.097
From | system/sensors/eventizer/fifo_fifo_0_0_s
To | system/performance/last_record_ms_3_s0
Launch Clk | audio_clock/pll_49m152/pll/CLKOUT0.default_gen_clk:[R]
Latch Clk | audio_clock/pll_49m152/pll/CLKOUT0.default_gen_clk:[R]

Data Arrival Path:

AT | DELAY | TYPE | RF | FANOUT | LOC | NODE
0.000 | 0.000 | | | | | active clock edge time
0.000 | 0.000 | | | | | audio_clock/pll_49m152/pll/CLKOUT0.default_gen_clk
4.964 | 4.964 | tCL | RR | 9528 | PLL_T[0] | audio_clock/pll_49m152/pll/CLKOUT0
7.063 | 2.099 | tNET | RR | 16 | BSRAM_R19[6] | system/sensors/eventizer/fifo_fifo_0_0_s/CLKB
9.073 | 2.010 | tC2Q | RR | 7 | BSRAM_R19[6] | system/sensors/eventizer/fifo_fifo_0_0_s/DO[13]
9.316 | 0.243 | tNET | RR | 1 | R20C104[3][B] | system/n1299_s4/I0
9.837 | 0.521 | tINS | RR | 3 | R20C104[3][B] | system/n1299_s4/F
10.167 | 0.330 | tNET | RR | 1 | R20C103[2][B] | system/n1327_s62/S0
10.419 | 0.252 | tINS | RR | 2 | R20C103[2][B] | system/n1327_s62/O
10.959 | 0.540 | tNET | RR | 1 | R20C108[0][B] | system/n1333_s8/I0
11.222 | 0.262 | tINS | RR | 1 | R20C108[0][B] | system/n1333_s8/F
11.794 | 0.572 | tNET | RR | 1 | R25C108[2][B] | system/n1333_s7/I2
12.311 | 0.516 | tINS | RR | 1 | R25C108[2][B] | system/n1333_s7/F
12.468 | 0.157 | tNET | RR | 1 | R26C108[3][A] | system/n1333_s5/I1
12.758 | 0.290 | tINS | RF | 1 | R26C108[3][A] | system/n1333_s5/F
12.763 | 0.005 | tNET | FF | 1 | R26C108[3][B] | system/n1333_s2/I2
13.178 | 0.415 | tINS | FR | 4 | R26C108[3][B] | system/n1333_s2/F
14.587 | 1.409 | tNET | RR | 1 | R59C113[1][B] | system/arbiter/n10_s6/I2
14.849 | 0.262 | tINS | RR | 2 | R59C113[1][B] | system/arbiter/n10_s6/F
14.989 | 0.140 | tNET | RR | 1 | R59C113[3][A] | system/arbiter/n27_s4/I1
15.487 | 0.498 | tINS | RR | 2 | R59C113[3][A] | system/arbiter/n27_s4/F
15.647 | 0.160 | tNET | RR | 1 | R60C113[3][B] | system/arbiter/n31_s3/I3
16.144 | 0.498 | tINS | RR | 1 | R60C113[3][B] | system/arbiter/n31_s3/F
16.147 | 0.003 | tNET | RR | 1 | R60C113[3][A] | system/arbiter/n31_s1/I0
16.644 | 0.498 | tINS | RR | 2 | R60C113[3][A] | system/arbiter/n31_s1/F
16.784 | 0.140 | tNET | RR | 1 | R60C113[2][B] | system/arbiter/n153_s4/I0
17.301 | 0.516 | tINS | RR | 44 | R60C113[2][B] | system/arbiter/n153_s4/F
17.656 | 0.355 | tNET | RR | 1 | R58C112[0][B] | system/arbiter/push_valid_s1/I3
18.182 | 0.526 | tINS | RR | 1 | R58C112[0][B] | system/arbiter/push_valid_s1/F
18.184 | 0.003 | tNET | RR | 1 | R58C112[1][A] | system/arbiter/push_valid_s0/I3
18.701 | 0.516 | tINS | RR | 2 | R58C112[1][A] | system/arbiter/push_valid_s0/F
18.706 | 0.005 | tNET | RR | 1 | R58C112[0][A] | system/arbiter/push_valid_s/I0
18.968 | 0.262 | tINS | RR | 3 | R58C112[0][A] | system/arbiter/push_valid_s/F
19.773 | 0.805 | tNET | RR | 1 | R27C111[3][B] | system/n921_s1/I3
20.294 | 0.521 | tINS | RR | 38 | R27C111[3][B] | system/n921_s1/F
21.979 | 1.685 | tNET | RR | 1 | R59C135[3][A] | system/performance/record_capture_s4/I3
22.477 | 0.498 | tINS | RR | 1 | R59C135[3][A] | system/performance/record_capture_s4/F
22.479 | 0.003 | tNET | RR | 1 | R59C135[2][B] | system/performance/record_capture_s2/I3
22.941 | 0.461 | tINS | RR | 6 | R59C135[2][B] | system/performance/record_capture_s2/F
23.193 | 0.252 | tNET | RR | 1 | R57C135[0][B] | system/performance/record_capture_s5/I1
23.654 | 0.461 | tINS | RR | 24 | R57C135[0][B] | system/performance/record_capture_s5/F
24.367 | 0.712 | tNET | RR | 1 | R54C137[2][A] | system/performance/n8662_s0/I3
24.883 | 0.516 | tINS | RR | 32 | R54C137[2][A] | system/performance/n8662_s0/F
26.239 | 1.356 | tNET | RR | 1 | R50C133[0][A] | system/performance/last_record_ms_3_s0/CE

Data Required Path:

AT | DELAY | TYPE | RF | FANOUT | LOC | NODE
20.345 | 20.345 | | | | | active clock edge time
20.345 | 0.000 | | | | | audio_clock/pll_49m152/pll/CLKOUT0.default_gen_clk
25.309 | 4.964 | tCL | RR | 9528 | PLL_T[0] | audio_clock/pll_49m152/pll/CLKOUT0
27.408 | 2.099 | tNET | RR | 1 | R50C133[0][A] | system/performance/last_record_ms_3_s0/CLK
27.097 | -0.311 | tSu | | 1 | R50C133[0][A] | system/performance/last_record_ms_3_s0

Path Statistics:

Clock Skew | 0.000
Setup Relationship | 20.345
Logic Level | 20
Arrival Clock Path Delay | cell: 0.000, 0.000%; route: 2.099, 100.000%
Arrival Data Path Delay | cell: 8.291, 43.237%; route: 8.875, 46.281%; tC2Q: 2.010, 10.482%
Required Clock Path Delay | cell: 0.000, 0.000%; route: 2.099, 100.000%

### Path14

Path Summary:

Slack | 0.858
Data Arrival Time | 26.239
Data Required Time | 27.097
From | system/sensors/eventizer/fifo_fifo_0_0_s
To | system/performance/last_record_ms_4_s0
Launch Clk | audio_clock/pll_49m152/pll/CLKOUT0.default_gen_clk:[R]
Latch Clk | audio_clock/pll_49m152/pll/CLKOUT0.default_gen_clk:[R]

Data Arrival Path:

AT | DELAY | TYPE | RF | FANOUT | LOC | NODE
0.000 | 0.000 | | | | | active clock edge time
0.000 | 0.000 | | | | | audio_clock/pll_49m152/pll/CLKOUT0.default_gen_clk
4.964 | 4.964 | tCL | RR | 9528 | PLL_T[0] | audio_clock/pll_49m152/pll/CLKOUT0
7.063 | 2.099 | tNET | RR | 16 | BSRAM_R19[6] | system/sensors/eventizer/fifo_fifo_0_0_s/CLKB
9.073 | 2.010 | tC2Q | RR | 7 | BSRAM_R19[6] | system/sensors/eventizer/fifo_fifo_0_0_s/DO[13]
9.316 | 0.243 | tNET | RR | 1 | R20C104[3][B] | system/n1299_s4/I0
9.837 | 0.521 | tINS | RR | 3 | R20C104[3][B] | system/n1299_s4/F
10.167 | 0.330 | tNET | RR | 1 | R20C103[2][B] | system/n1327_s62/S0
10.419 | 0.252 | tINS | RR | 2 | R20C103[2][B] | system/n1327_s62/O
10.959 | 0.540 | tNET | RR | 1 | R20C108[0][B] | system/n1333_s8/I0
11.222 | 0.262 | tINS | RR | 1 | R20C108[0][B] | system/n1333_s8/F
11.794 | 0.572 | tNET | RR | 1 | R25C108[2][B] | system/n1333_s7/I2
12.311 | 0.516 | tINS | RR | 1 | R25C108[2][B] | system/n1333_s7/F
12.468 | 0.157 | tNET | RR | 1 | R26C108[3][A] | system/n1333_s5/I1
12.758 | 0.290 | tINS | RF | 1 | R26C108[3][A] | system/n1333_s5/F
12.763 | 0.005 | tNET | FF | 1 | R26C108[3][B] | system/n1333_s2/I2
13.178 | 0.415 | tINS | FR | 4 | R26C108[3][B] | system/n1333_s2/F
14.587 | 1.409 | tNET | RR | 1 | R59C113[1][B] | system/arbiter/n10_s6/I2
14.849 | 0.262 | tINS | RR | 2 | R59C113[1][B] | system/arbiter/n10_s6/F
14.989 | 0.140 | tNET | RR | 1 | R59C113[3][A] | system/arbiter/n27_s4/I1
15.487 | 0.498 | tINS | RR | 2 | R59C113[3][A] | system/arbiter/n27_s4/F
15.647 | 0.160 | tNET | RR | 1 | R60C113[3][B] | system/arbiter/n31_s3/I3
16.144 | 0.498 | tINS | RR | 1 | R60C113[3][B] | system/arbiter/n31_s3/F
16.147 | 0.003 | tNET | RR | 1 | R60C113[3][A] | system/arbiter/n31_s1/I0
16.644 | 0.498 | tINS | RR | 2 | R60C113[3][A] | system/arbiter/n31_s1/F
16.784 | 0.140 | tNET | RR | 1 | R60C113[2][B] | system/arbiter/n153_s4/I0
17.301 | 0.516 | tINS | RR | 44 | R60C113[2][B] | system/arbiter/n153_s4/F
17.656 | 0.355 | tNET | RR | 1 | R58C112[0][B] | system/arbiter/push_valid_s1/I3
18.182 | 0.526 | tINS | RR | 1 | R58C112[0][B] | system/arbiter/push_valid_s1/F
18.184 | 0.003 | tNET | RR | 1 | R58C112[1][A] | system/arbiter/push_valid_s0/I3
18.701 | 0.516 | tINS | RR | 2 | R58C112[1][A] | system/arbiter/push_valid_s0/F
18.706 | 0.005 | tNET | RR | 1 | R58C112[0][A] | system/arbiter/push_valid_s/I0
18.968 | 0.262 | tINS | RR | 3 | R58C112[0][A] | system/arbiter/push_valid_s/F
19.773 | 0.805 | tNET | RR | 1 | R27C111[3][B] | system/n921_s1/I3
20.294 | 0.521 | tINS | RR | 38 | R27C111[3][B] | system/n921_s1/F
21.979 | 1.685 | tNET | RR | 1 | R59C135[3][A] | system/performance/record_capture_s4/I3
22.477 | 0.498 | tINS | RR | 1 | R59C135[3][A] | system/performance/record_capture_s4/F
22.479 | 0.003 | tNET | RR | 1 | R59C135[2][B] | system/performance/record_capture_s2/I3
22.941 | 0.461 | tINS | RR | 6 | R59C135[2][B] | system/performance/record_capture_s2/F
23.193 | 0.252 | tNET | RR | 1 | R57C135[0][B] | system/performance/record_capture_s5/I1
23.654 | 0.461 | tINS | RR | 24 | R57C135[0][B] | system/performance/record_capture_s5/F
24.367 | 0.712 | tNET | RR | 1 | R54C137[2][A] | system/performance/n8662_s0/I3
24.883 | 0.516 | tINS | RR | 32 | R54C137[2][A] | system/performance/n8662_s0/F
26.239 | 1.356 | tNET | RR | 1 | R50C133[1][A] | system/performance/last_record_ms_4_s0/CE

Data Required Path:

AT | DELAY | TYPE | RF | FANOUT | LOC | NODE
20.345 | 20.345 | | | | | active clock edge time
20.345 | 0.000 | | | | | audio_clock/pll_49m152/pll/CLKOUT0.default_gen_clk
25.309 | 4.964 | tCL | RR | 9528 | PLL_T[0] | audio_clock/pll_49m152/pll/CLKOUT0
27.408 | 2.099 | tNET | RR | 1 | R50C133[1][A] | system/performance/last_record_ms_4_s0/CLK
27.097 | -0.311 | tSu | | 1 | R50C133[1][A] | system/performance/last_record_ms_4_s0

Path Statistics:

Clock Skew | 0.000
Setup Relationship | 20.345
Logic Level | 20
Arrival Clock Path Delay | cell: 0.000, 0.000%; route: 2.099, 100.000%
Arrival Data Path Delay | cell: 8.291, 43.237%; route: 8.875, 46.281%; tC2Q: 2.010, 10.482%
Required Clock Path Delay | cell: 0.000, 0.000%; route: 2.099, 100.000%

### Path15

Path Summary:

Slack | 0.899
Data Arrival Time | 26.198
Data Required Time | 27.097
From | system/sensors/eventizer/fifo_fifo_0_0_s
To | system/events/mem[39]_3_s0
Launch Clk | audio_clock/pll_49m152/pll/CLKOUT0.default_gen_clk:[R]
Latch Clk | audio_clock/pll_49m152/pll/CLKOUT0.default_gen_clk:[R]

Data Arrival Path:

AT | DELAY | TYPE | RF | FANOUT | LOC | NODE
0.000 | 0.000 | | | | | active clock edge time
0.000 | 0.000 | | | | | audio_clock/pll_49m152/pll/CLKOUT0.default_gen_clk
4.964 | 4.964 | tCL | RR | 9528 | PLL_T[0] | audio_clock/pll_49m152/pll/CLKOUT0
7.063 | 2.099 | tNET | RR | 16 | BSRAM_R19[6] | system/sensors/eventizer/fifo_fifo_0_0_s/CLKB
9.073 | 2.010 | tC2Q | RR | 7 | BSRAM_R19[6] | system/sensors/eventizer/fifo_fifo_0_0_s/DO[13]
9.316 | 0.243 | tNET | RR | 1 | R20C104[3][B] | system/n1299_s4/I0
9.837 | 0.521 | tINS | RR | 3 | R20C104[3][B] | system/n1299_s4/F
10.167 | 0.330 | tNET | RR | 1 | R20C103[2][B] | system/n1327_s62/S0
10.419 | 0.252 | tINS | RR | 2 | R20C103[2][B] | system/n1327_s62/O
10.959 | 0.540 | tNET | RR | 1 | R20C108[0][B] | system/n1333_s8/I0
11.222 | 0.262 | tINS | RR | 1 | R20C108[0][B] | system/n1333_s8/F
11.794 | 0.572 | tNET | RR | 1 | R25C108[2][B] | system/n1333_s7/I2
12.311 | 0.516 | tINS | RR | 1 | R25C108[2][B] | system/n1333_s7/F
12.468 | 0.157 | tNET | RR | 1 | R26C108[3][A] | system/n1333_s5/I1
12.758 | 0.290 | tINS | RF | 1 | R26C108[3][A] | system/n1333_s5/F
12.763 | 0.005 | tNET | FF | 1 | R26C108[3][B] | system/n1333_s2/I2
13.178 | 0.415 | tINS | FR | 4 | R26C108[3][B] | system/n1333_s2/F
14.587 | 1.409 | tNET | RR | 1 | R59C113[1][B] | system/arbiter/n10_s6/I2
14.849 | 0.262 | tINS | RR | 2 | R59C113[1][B] | system/arbiter/n10_s6/F
14.989 | 0.140 | tNET | RR | 1 | R59C113[3][A] | system/arbiter/n27_s4/I1
15.487 | 0.498 | tINS | RR | 2 | R59C113[3][A] | system/arbiter/n27_s4/F
15.647 | 0.160 | tNET | RR | 1 | R60C113[3][B] | system/arbiter/n31_s3/I3
16.144 | 0.498 | tINS | RR | 1 | R60C113[3][B] | system/arbiter/n31_s3/F
16.147 | 0.003 | tNET | RR | 1 | R60C113[3][A] | system/arbiter/n31_s1/I0
16.644 | 0.498 | tINS | RR | 2 | R60C113[3][A] | system/arbiter/n31_s1/F
16.784 | 0.140 | tNET | RR | 1 | R60C113[2][B] | system/arbiter/n153_s4/I0
17.301 | 0.516 | tINS | RR | 44 | R60C113[2][B] | system/arbiter/n153_s4/F
17.656 | 0.355 | tNET | RR | 1 | R58C112[0][B] | system/arbiter/push_valid_s1/I3
18.182 | 0.526 | tINS | RR | 1 | R58C112[0][B] | system/arbiter/push_valid_s1/F
18.184 | 0.003 | tNET | RR | 1 | R58C112[1][A] | system/arbiter/push_valid_s0/I3
18.701 | 0.516 | tINS | RR | 2 | R58C112[1][A] | system/arbiter/push_valid_s0/F
18.706 | 0.005 | tNET | RR | 1 | R58C112[0][A] | system/arbiter/push_valid_s/I0
18.968 | 0.262 | tINS | RR | 3 | R58C112[0][A] | system/arbiter/push_valid_s/F
19.773 | 0.805 | tNET | RR | 1 | R27C111[3][B] | system/n921_s1/I3
20.294 | 0.521 | tINS | RR | 38 | R27C111[3][B] | system/n921_s1/F
22.801 | 2.506 | tNET | RR | 1 | R7C93[0][B] | system/events/n6895_s1/I3
23.063 | 0.262 | tINS | RR | 8 | R7C93[0][B] | system/events/n6895_s1/F
24.506 | 1.442 | tNET | RR | 1 | R15C97[1][B] | system/events/n7056_s0/I3
25.022 | 0.516 | tINS | RR | 8 | R15C97[1][B] | system/events/n7056_s0/F
26.198 | 1.176 | tNET | RR | 1 | R25C95[2][A] | system/events/mem[39]_3_s0/CE

Data Required Path:

AT | DELAY | TYPE | RF | FANOUT | LOC | NODE
20.345 | 20.345 | | | | | active clock edge time
20.345 | 0.000 | | | | | audio_clock/pll_49m152/pll/CLKOUT0.default_gen_clk
25.309 | 4.964 | tCL | RR | 9528 | PLL_T[0] | audio_clock/pll_49m152/pll/CLKOUT0
27.408 | 2.099 | tNET | RR | 1 | R25C95[2][A] | system/events/mem[39]_3_s0/CLK
27.097 | -0.311 | tSu | | 1 | R25C95[2][A] | system/events/mem[39]_3_s0

Path Statistics:

Clock Skew | 0.000
Setup Relationship | 20.345
Logic Level | 18
Arrival Clock Path Delay | cell: 0.000, 0.000%; route: 2.099, 100.000%
Arrival Data Path Delay | cell: 7.134, 37.281%; route: 9.991, 52.215%; tC2Q: 2.010, 10.504%
Required Clock Path Delay | cell: 0.000, 0.000%; route: 2.099, 100.000%

### Path16

Path Summary:

Slack | 0.956
Data Arrival Time | 26.389
Data Required Time | 27.344
From | system/performance/record_ram_record_ram_0_2_s
To | system/performance/event_note_1_s0
Launch Clk | audio_clock/pll_49m152/pll/CLKOUT0.default_gen_clk:[R]
Latch Clk | audio_clock/pll_49m152/pll/CLKOUT0.default_gen_clk:[R]

Data Arrival Path:

AT | DELAY | TYPE | RF | FANOUT | LOC | NODE
0.000 | 0.000 | | | | | active clock edge time
0.000 | 0.000 | | | | | audio_clock/pll_49m152/pll/CLKOUT0.default_gen_clk
4.964 | 4.964 | tCL | RR | 9528 | PLL_T[0] | audio_clock/pll_49m152/pll/CLKOUT0
7.072 | 2.109 | tNET | RR | 16 | BSRAM_R56[31][A] | system/performance/record_ram_record_ram_0_2_s/CLKB
9.077 | 2.005 | tC2Q | RF | 4 | BSRAM_R56[31][A] | system/performance/record_ram_record_ram_0_2_s/DO[1]
10.255 | 1.178 | tNET | FF | 1 | R44C128[0][A] | system/performance/active_key_2_s4/I1
10.781 | 0.526 | tINS | FR | 1 | R44C128[0][A] | system/performance/active_key_2_s4/F
10.784 | 0.003 | tNET | RR | 1 | R44C128[0][B] | system/performance/active_key_2_s3/I1
11.046 | 0.262 | tINS | RR | 1 | R44C128[0][B] | system/performance/active_key_2_s3/F
11.431 | 0.385 | tNET | RR | 1 | R46C127[0][A] | system/performance/active_key_2_s0/I2
11.811 | 0.380 | tINS | RF | 224 | R46C127[0][A] | system/performance/active_key_2_s0/F
15.770 | 3.959 | tNET | FF | 1 | R68C124[2][A] | system/performance/active_note_6_s13/I0
16.296 | 0.526 | tINS | FR | 29 | R68C124[2][A] | system/performance/active_note_6_s13/F
17.575 | 1.279 | tNET | RR | 1 | R70C114[1][A] | system/performance/active_note_1_s125/I0
18.036 | 0.461 | tINS | RR | 1 | R70C114[1][A] | system/performance/active_note_1_s125/F
18.039 | 0.003 | tNET | RR | 1 | R70C114[2][B] | system/performance/active_note_1_s115/I1
18.301 | 0.262 | tINS | RR | 1 | R70C114[2][B] | system/performance/active_note_1_s115/F
18.629 | 0.327 | tNET | RR | 1 | R69C114[2][B] | system/performance/active_note_1_s78/I2
19.155 | 0.526 | tINS | RR | 1 | R69C114[2][B] | system/performance/active_note_1_s78/F
19.821 | 0.666 | tNET | RR | 1 | R62C119[2][B] | system/performance/active_note_1_s25/I3
20.282 | 0.461 | tINS | RR | 1 | R62C119[2][B] | system/performance/active_note_1_s25/F
20.285 | 0.003 | tNET | RR | 1 | R62C119[3][A] | system/performance/active_note_1_s6/I3
20.782 | 0.498 | tINS | RR | 1 | R62C119[3][A] | system/performance/active_note_1_s6/F
20.940 | 0.157 | tNET | RR | 1 | R61C119[3][A] | system/performance/active_note_1_s1/I3
21.230 | 0.290 | tINS | RF | 1 | R61C119[3][A] | system/performance/active_note_1_s1/F
21.696 | 0.466 | tNET | FF | 1 | R61C125[0][A] | system/performance/active_note_1_s0/I0
22.157 | 0.461 | tINS | FR | 2 | R61C125[0][A] | system/performance/active_note_1_s0/F
23.151 | 0.994 | tNET | RR | 2 | R60C138[0][B] | system/performance/n4752_s0/I1
23.714 | 0.562 | tINS | RF | 1 | R60C138[0][B] | system/performance/n4752_s0/COUT
23.714 | 0.000 | tNET | FF | 2 | R60C138[1][A] | system/performance/n4753_s0/CIN
23.764 | 0.050 | tINS | FR | 1 | R60C138[1][A] | system/performance/n4753_s0/COUT
23.764 | 0.000 | tNET | RR | 2 | R60C138[1][B] | system/performance/n4754_s0/CIN
23.814 | 0.050 | tINS | RR | 1 | R60C138[1][B] | system/performance/n4754_s0/COUT
23.814 | 0.000 | tNET | RR | 2 | R60C138[2][A] | system/performance/n4755_s0/CIN
23.864 | 0.050 | tINS | RR | 1 | R60C138[2][A] | system/performance/n4755_s0/COUT
23.864 | 0.000 | tNET | RR | 2 | R60C138[2][B] | system/performance/n4756_s0/CIN
23.914 | 0.050 | tINS | RR | 1 | R60C138[2][B] | system/performance/n4756_s0/COUT
23.914 | 0.000 | tNET | RR | 2 | R60C139[0][A] | system/performance/n4757_s0/CIN
23.964 | 0.050 | tINS | RR | 3 | R60C139[0][A] | system/performance/n4757_s0/COUT
24.775 | 0.811 | tNET | RR | 1 | R60C135[3][A] | system/performance/n5049_s5/I0
25.272 | 0.498 | tINS | RR | 9 | R60C135[3][A] | system/performance/n5049_s5/F
25.862 | 0.590 | tNET | RR | 1 | R63C133[2][A] | system/performance/n5040_s0/I2
26.389 | 0.526 | tINS | RR | 1 | R63C133[2][A] | system/performance/n5040_s0/F
26.389 | 0.000 | tNET | RR | 1 | R63C133[2][A] | system/performance/event_note_1_s0/D

Data Required Path:

AT | DELAY | TYPE | RF | FANOUT | LOC | NODE
20.345 | 20.345 | | | | | active clock edge time
20.345 | 0.000 | | | | | audio_clock/pll_49m152/pll/CLKOUT0.default_gen_clk
25.309 | 4.964 | tCL | RR | 9528 | PLL_T[0] | audio_clock/pll_49m152/pll/CLKOUT0
27.408 | 2.099 | tNET | RR | 1 | R63C133[2][A] | system/performance/event_note_1_s0/CLK
27.344 | -0.064 | tSu | | 1 | R63C133[2][A] | system/performance/event_note_1_s0

Path Statistics:

Clock Skew | -0.009
Setup Relationship | 20.345
Logic Level | 16
Arrival Clock Path Delay | cell: 0.000, 0.000%; route: 2.109, 100.000%
Arrival Data Path Delay | cell: 6.491, 33.605%; route: 10.820, 56.015%; tC2Q: 2.005, 10.380%
Required Clock Path Delay | cell: 0.000, 0.000%; route: 2.099, 100.000%

### Path17

Path Summary:

Slack | 0.956
Data Arrival Time | 26.389
Data Required Time | 27.344
From | system/performance/record_ram_record_ram_0_2_s
To | system/performance/event_note_4_s0
Launch Clk | audio_clock/pll_49m152/pll/CLKOUT0.default_gen_clk:[R]
Latch Clk | audio_clock/pll_49m152/pll/CLKOUT0.default_gen_clk:[R]

Data Arrival Path:

AT | DELAY | TYPE | RF | FANOUT | LOC | NODE
0.000 | 0.000 | | | | | active clock edge time
0.000 | 0.000 | | | | | audio_clock/pll_49m152/pll/CLKOUT0.default_gen_clk
4.964 | 4.964 | tCL | RR | 9528 | PLL_T[0] | audio_clock/pll_49m152/pll/CLKOUT0
7.072 | 2.109 | tNET | RR | 16 | BSRAM_R56[31][A] | system/performance/record_ram_record_ram_0_2_s/CLKB
9.077 | 2.005 | tC2Q | RF | 4 | BSRAM_R56[31][A] | system/performance/record_ram_record_ram_0_2_s/DO[1]
10.255 | 1.178 | tNET | FF | 1 | R44C128[0][A] | system/performance/active_key_2_s4/I1
10.781 | 0.526 | tINS | FR | 1 | R44C128[0][A] | system/performance/active_key_2_s4/F
10.784 | 0.003 | tNET | RR | 1 | R44C128[0][B] | system/performance/active_key_2_s3/I1
11.046 | 0.262 | tINS | RR | 1 | R44C128[0][B] | system/performance/active_key_2_s3/F
11.431 | 0.385 | tNET | RR | 1 | R46C127[0][A] | system/performance/active_key_2_s0/I2
11.811 | 0.380 | tINS | RF | 224 | R46C127[0][A] | system/performance/active_key_2_s0/F
15.770 | 3.959 | tNET | FF | 1 | R68C124[2][A] | system/performance/active_note_6_s13/I0
16.296 | 0.526 | tINS | FR | 29 | R68C124[2][A] | system/performance/active_note_6_s13/F
17.575 | 1.279 | tNET | RR | 1 | R70C114[1][A] | system/performance/active_note_1_s125/I0
18.036 | 0.461 | tINS | RR | 1 | R70C114[1][A] | system/performance/active_note_1_s125/F
18.039 | 0.003 | tNET | RR | 1 | R70C114[2][B] | system/performance/active_note_1_s115/I1
18.301 | 0.262 | tINS | RR | 1 | R70C114[2][B] | system/performance/active_note_1_s115/F
18.629 | 0.327 | tNET | RR | 1 | R69C114[2][B] | system/performance/active_note_1_s78/I2
19.155 | 0.526 | tINS | RR | 1 | R69C114[2][B] | system/performance/active_note_1_s78/F
19.821 | 0.666 | tNET | RR | 1 | R62C119[2][B] | system/performance/active_note_1_s25/I3
20.282 | 0.461 | tINS | RR | 1 | R62C119[2][B] | system/performance/active_note_1_s25/F
20.285 | 0.003 | tNET | RR | 1 | R62C119[3][A] | system/performance/active_note_1_s6/I3
20.782 | 0.498 | tINS | RR | 1 | R62C119[3][A] | system/performance/active_note_1_s6/F
20.940 | 0.157 | tNET | RR | 1 | R61C119[3][A] | system/performance/active_note_1_s1/I3
21.230 | 0.290 | tINS | RF | 1 | R61C119[3][A] | system/performance/active_note_1_s1/F
21.696 | 0.466 | tNET | FF | 1 | R61C125[0][A] | system/performance/active_note_1_s0/I0
22.157 | 0.461 | tINS | FR | 2 | R61C125[0][A] | system/performance/active_note_1_s0/F
23.151 | 0.994 | tNET | RR | 2 | R60C138[0][B] | system/performance/n4752_s0/I1
23.714 | 0.562 | tINS | RF | 1 | R60C138[0][B] | system/performance/n4752_s0/COUT
23.714 | 0.000 | tNET | FF | 2 | R60C138[1][A] | system/performance/n4753_s0/CIN
23.764 | 0.050 | tINS | FR | 1 | R60C138[1][A] | system/performance/n4753_s0/COUT
23.764 | 0.000 | tNET | RR | 2 | R60C138[1][B] | system/performance/n4754_s0/CIN
23.814 | 0.050 | tINS | RR | 1 | R60C138[1][B] | system/performance/n4754_s0/COUT
23.814 | 0.000 | tNET | RR | 2 | R60C138[2][A] | system/performance/n4755_s0/CIN
23.864 | 0.050 | tINS | RR | 1 | R60C138[2][A] | system/performance/n4755_s0/COUT
23.864 | 0.000 | tNET | RR | 2 | R60C138[2][B] | system/performance/n4756_s0/CIN
23.914 | 0.050 | tINS | RR | 1 | R60C138[2][B] | system/performance/n4756_s0/COUT
23.914 | 0.000 | tNET | RR | 2 | R60C139[0][A] | system/performance/n4757_s0/CIN
23.964 | 0.050 | tINS | RR | 3 | R60C139[0][A] | system/performance/n4757_s0/COUT
24.775 | 0.811 | tNET | RR | 1 | R60C135[3][A] | system/performance/n5049_s5/I0
25.272 | 0.498 | tINS | RR | 9 | R60C135[3][A] | system/performance/n5049_s5/F
25.862 | 0.590 | tNET | RR | 1 | R63C133[1][A] | system/performance/n5037_s0/I2
26.389 | 0.526 | tINS | RR | 1 | R63C133[1][A] | system/performance/n5037_s0/F
26.389 | 0.000 | tNET | RR | 1 | R63C133[1][A] | system/performance/event_note_4_s0/D

Data Required Path:

AT | DELAY | TYPE | RF | FANOUT | LOC | NODE
20.345 | 20.345 | | | | | active clock edge time
20.345 | 0.000 | | | | | audio_clock/pll_49m152/pll/CLKOUT0.default_gen_clk
25.309 | 4.964 | tCL | RR | 9528 | PLL_T[0] | audio_clock/pll_49m152/pll/CLKOUT0
27.408 | 2.099 | tNET | RR | 1 | R63C133[1][A] | system/performance/event_note_4_s0/CLK
27.344 | -0.064 | tSu | | 1 | R63C133[1][A] | system/performance/event_note_4_s0

Path Statistics:

Clock Skew | -0.009
Setup Relationship | 20.345
Logic Level | 16
Arrival Clock Path Delay | cell: 0.000, 0.000%; route: 2.109, 100.000%
Arrival Data Path Delay | cell: 6.491, 33.605%; route: 10.820, 56.015%; tC2Q: 2.005, 10.380%
Required Clock Path Delay | cell: 0.000, 0.000%; route: 2.099, 100.000%

### Path18

Path Summary:

Slack | 0.962
Data Arrival Time | 26.126
Data Required Time | 27.087
From | system/sensors/eventizer/fifo_fifo_0_0_s
To | system/events/mem[39]_8_s0
Launch Clk | audio_clock/pll_49m152/pll/CLKOUT0.default_gen_clk:[R]
Latch Clk | audio_clock/pll_49m152/pll/CLKOUT0.default_gen_clk:[R]

Data Arrival Path:

AT | DELAY | TYPE | RF | FANOUT | LOC | NODE
0.000 | 0.000 | | | | | active clock edge time
0.000 | 0.000 | | | | | audio_clock/pll_49m152/pll/CLKOUT0.default_gen_clk
4.964 | 4.964 | tCL | RR | 9528 | PLL_T[0] | audio_clock/pll_49m152/pll/CLKOUT0
7.063 | 2.099 | tNET | RR | 16 | BSRAM_R19[6] | system/sensors/eventizer/fifo_fifo_0_0_s/CLKB
9.073 | 2.010 | tC2Q | RR | 7 | BSRAM_R19[6] | system/sensors/eventizer/fifo_fifo_0_0_s/DO[13]
9.316 | 0.243 | tNET | RR | 1 | R20C104[3][B] | system/n1299_s4/I0
9.837 | 0.521 | tINS | RR | 3 | R20C104[3][B] | system/n1299_s4/F
10.167 | 0.330 | tNET | RR | 1 | R20C103[2][B] | system/n1327_s62/S0
10.419 | 0.252 | tINS | RR | 2 | R20C103[2][B] | system/n1327_s62/O
10.959 | 0.540 | tNET | RR | 1 | R20C108[0][B] | system/n1333_s8/I0
11.222 | 0.262 | tINS | RR | 1 | R20C108[0][B] | system/n1333_s8/F
11.794 | 0.572 | tNET | RR | 1 | R25C108[2][B] | system/n1333_s7/I2
12.311 | 0.516 | tINS | RR | 1 | R25C108[2][B] | system/n1333_s7/F
12.468 | 0.157 | tNET | RR | 1 | R26C108[3][A] | system/n1333_s5/I1
12.758 | 0.290 | tINS | RF | 1 | R26C108[3][A] | system/n1333_s5/F
12.763 | 0.005 | tNET | FF | 1 | R26C108[3][B] | system/n1333_s2/I2
13.178 | 0.415 | tINS | FR | 4 | R26C108[3][B] | system/n1333_s2/F
14.587 | 1.409 | tNET | RR | 1 | R59C113[1][B] | system/arbiter/n10_s6/I2
14.849 | 0.262 | tINS | RR | 2 | R59C113[1][B] | system/arbiter/n10_s6/F
14.989 | 0.140 | tNET | RR | 1 | R59C113[3][A] | system/arbiter/n27_s4/I1
15.487 | 0.498 | tINS | RR | 2 | R59C113[3][A] | system/arbiter/n27_s4/F
15.647 | 0.160 | tNET | RR | 1 | R60C113[3][B] | system/arbiter/n31_s3/I3
16.144 | 0.498 | tINS | RR | 1 | R60C113[3][B] | system/arbiter/n31_s3/F
16.147 | 0.003 | tNET | RR | 1 | R60C113[3][A] | system/arbiter/n31_s1/I0
16.644 | 0.498 | tINS | RR | 2 | R60C113[3][A] | system/arbiter/n31_s1/F
16.784 | 0.140 | tNET | RR | 1 | R60C113[2][B] | system/arbiter/n153_s4/I0
17.301 | 0.516 | tINS | RR | 44 | R60C113[2][B] | system/arbiter/n153_s4/F
17.656 | 0.355 | tNET | RR | 1 | R58C112[0][B] | system/arbiter/push_valid_s1/I3
18.182 | 0.526 | tINS | RR | 1 | R58C112[0][B] | system/arbiter/push_valid_s1/F
18.184 | 0.003 | tNET | RR | 1 | R58C112[1][A] | system/arbiter/push_valid_s0/I3
18.701 | 0.516 | tINS | RR | 2 | R58C112[1][A] | system/arbiter/push_valid_s0/F
18.706 | 0.005 | tNET | RR | 1 | R58C112[0][A] | system/arbiter/push_valid_s/I0
18.968 | 0.262 | tINS | RR | 3 | R58C112[0][A] | system/arbiter/push_valid_s/F
19.773 | 0.805 | tNET | RR | 1 | R27C111[3][B] | system/n921_s1/I3
20.294 | 0.521 | tINS | RR | 38 | R27C111[3][B] | system/n921_s1/F
22.801 | 2.506 | tNET | RR | 1 | R7C93[0][B] | system/events/n6895_s1/I3
23.063 | 0.262 | tINS | RR | 8 | R7C93[0][B] | system/events/n6895_s1/F
24.506 | 1.442 | tNET | RR | 1 | R15C97[1][B] | system/events/n7056_s0/I3
25.022 | 0.516 | tINS | RR | 8 | R15C97[1][B] | system/events/n7056_s0/F
26.126 | 1.104 | tNET | RR | 1 | R26C92[2][A] | system/events/mem[39]_8_s0/CE

Data Required Path:

AT | DELAY | TYPE | RF | FANOUT | LOC | NODE
20.345 | 20.345 | | | | | active clock edge time
20.345 | 0.000 | | | | | audio_clock/pll_49m152/pll/CLKOUT0.default_gen_clk
25.309 | 4.964 | tCL | RR | 9528 | PLL_T[0] | audio_clock/pll_49m152/pll/CLKOUT0
27.399 | 2.090 | tNET | RR | 1 | R26C92[2][A] | system/events/mem[39]_8_s0/CLK
27.087 | -0.311 | tSu | | 1 | R26C92[2][A] | system/events/mem[39]_8_s0

Path Statistics:

Clock Skew | -0.009
Setup Relationship | 20.345
Logic Level | 18
Arrival Clock Path Delay | cell: 0.000, 0.000%; route: 2.099, 100.000%
Arrival Data Path Delay | cell: 7.134, 37.423%; route: 9.919, 52.033%; tC2Q: 2.010, 10.544%
Required Clock Path Delay | cell: 0.000, 0.000%; route: 2.090, 100.000%

### Path19

Path Summary:

Slack | 1.001
Data Arrival Time | 26.344
Data Required Time | 27.344
From | system/performance/record_ram_record_ram_0_2_s
To | system/performance/event_velocity_3_s0
Launch Clk | audio_clock/pll_49m152/pll/CLKOUT0.default_gen_clk:[R]
Latch Clk | audio_clock/pll_49m152/pll/CLKOUT0.default_gen_clk:[R]

Data Arrival Path:

AT | DELAY | TYPE | RF | FANOUT | LOC | NODE
0.000 | 0.000 | | | | | active clock edge time
0.000 | 0.000 | | | | | audio_clock/pll_49m152/pll/CLKOUT0.default_gen_clk
4.964 | 4.964 | tCL | RR | 9528 | PLL_T[0] | audio_clock/pll_49m152/pll/CLKOUT0
7.072 | 2.109 | tNET | RR | 16 | BSRAM_R56[31][A] | system/performance/record_ram_record_ram_0_2_s/CLKB
9.077 | 2.005 | tC2Q | RF | 4 | BSRAM_R56[31][A] | system/performance/record_ram_record_ram_0_2_s/DO[1]
10.255 | 1.178 | tNET | FF | 1 | R44C128[0][A] | system/performance/active_key_2_s4/I1
10.781 | 0.526 | tINS | FR | 1 | R44C128[0][A] | system/performance/active_key_2_s4/F
10.784 | 0.003 | tNET | RR | 1 | R44C128[0][B] | system/performance/active_key_2_s3/I1
11.046 | 0.262 | tINS | RR | 1 | R44C128[0][B] | system/performance/active_key_2_s3/F
11.431 | 0.385 | tNET | RR | 1 | R46C127[0][A] | system/performance/active_key_2_s0/I2
11.811 | 0.380 | tINS | RF | 224 | R46C127[0][A] | system/performance/active_key_2_s0/F
15.770 | 3.959 | tNET | FF | 1 | R68C124[2][A] | system/performance/active_note_6_s13/I0
16.296 | 0.526 | tINS | FR | 29 | R68C124[2][A] | system/performance/active_note_6_s13/F
17.575 | 1.279 | tNET | RR | 1 | R70C114[1][A] | system/performance/active_note_1_s125/I0
18.036 | 0.461 | tINS | RR | 1 | R70C114[1][A] | system/performance/active_note_1_s125/F
18.039 | 0.003 | tNET | RR | 1 | R70C114[2][B] | system/performance/active_note_1_s115/I1
18.301 | 0.262 | tINS | RR | 1 | R70C114[2][B] | system/performance/active_note_1_s115/F
18.629 | 0.327 | tNET | RR | 1 | R69C114[2][B] | system/performance/active_note_1_s78/I2
19.155 | 0.526 | tINS | RR | 1 | R69C114[2][B] | system/performance/active_note_1_s78/F
19.821 | 0.666 | tNET | RR | 1 | R62C119[2][B] | system/performance/active_note_1_s25/I3
20.282 | 0.461 | tINS | RR | 1 | R62C119[2][B] | system/performance/active_note_1_s25/F
20.285 | 0.003 | tNET | RR | 1 | R62C119[3][A] | system/performance/active_note_1_s6/I3
20.782 | 0.498 | tINS | RR | 1 | R62C119[3][A] | system/performance/active_note_1_s6/F
20.940 | 0.157 | tNET | RR | 1 | R61C119[3][A] | system/performance/active_note_1_s1/I3
21.230 | 0.290 | tINS | RF | 1 | R61C119[3][A] | system/performance/active_note_1_s1/F
21.696 | 0.466 | tNET | FF | 1 | R61C125[0][A] | system/performance/active_note_1_s0/I0
22.157 | 0.461 | tINS | FR | 2 | R61C125[0][A] | system/performance/active_note_1_s0/F
23.151 | 0.994 | tNET | RR | 2 | R60C138[0][B] | system/performance/n4752_s0/I1
23.714 | 0.562 | tINS | RF | 1 | R60C138[0][B] | system/performance/n4752_s0/COUT
23.714 | 0.000 | tNET | FF | 2 | R60C138[1][A] | system/performance/n4753_s0/CIN
23.764 | 0.050 | tINS | FR | 1 | R60C138[1][A] | system/performance/n4753_s0/COUT
23.764 | 0.000 | tNET | RR | 2 | R60C138[1][B] | system/performance/n4754_s0/CIN
23.814 | 0.050 | tINS | RR | 1 | R60C138[1][B] | system/performance/n4754_s0/COUT
23.814 | 0.000 | tNET | RR | 2 | R60C138[2][A] | system/performance/n4755_s0/CIN
23.864 | 0.050 | tINS | RR | 1 | R60C138[2][A] | system/performance/n4755_s0/COUT
23.864 | 0.000 | tNET | RR | 2 | R60C138[2][B] | system/performance/n4756_s0/CIN
23.914 | 0.050 | tINS | RR | 1 | R60C138[2][B] | system/performance/n4756_s0/COUT
23.914 | 0.000 | tNET | RR | 2 | R60C139[0][A] | system/performance/n4757_s0/CIN
23.964 | 0.050 | tINS | RR | 3 | R60C139[0][A] | system/performance/n4757_s0/COUT
24.772 | 0.809 | tNET | RR | 1 | R60C135[3][B] | system/performance/n5028_s10/I2
25.270 | 0.498 | tINS | RR | 8 | R60C135[3][B] | system/performance/n5028_s10/F
25.822 | 0.552 | tNET | RR | 1 | R55C135[3][A] | system/performance/n5045_s2/I3
26.344 | 0.521 | tINS | RR | 1 | R55C135[3][A] | system/performance/n5045_s2/F
26.344 | 0.000 | tNET | RR | 1 | R55C135[3][A] | system/performance/event_velocity_3_s0/D

Data Required Path:

AT | DELAY | TYPE | RF | FANOUT | LOC | NODE
20.345 | 20.345 | | | | | active clock edge time
20.345 | 0.000 | | | | | audio_clock/pll_49m152/pll/CLKOUT0.default_gen_clk
25.309 | 4.964 | tCL | RR | 9528 | PLL_T[0] | audio_clock/pll_49m152/pll/CLKOUT0
27.408 | 2.099 | tNET | RR | 1 | R55C135[3][A] | system/performance/event_velocity_3_s0/CLK
27.344 | -0.064 | tSu | | 1 | R55C135[3][A] | system/performance/event_velocity_3_s0

Path Statistics:

Clock Skew | -0.009
Setup Relationship | 20.345
Logic Level | 16
Arrival Clock Path Delay | cell: 0.000, 0.000%; route: 2.109, 100.000%
Arrival Data Path Delay | cell: 6.486, 33.658%; route: 10.780, 55.938%; tC2Q: 2.005, 10.404%
Required Clock Path Delay | cell: 0.000, 0.000%; route: 2.099, 100.000%

### Path20

Path Summary:

Slack | 1.004
Data Arrival Time | 26.102
Data Required Time | 27.106
From | system/sensors/eventizer/fifo_fifo_0_0_s
To | system/events/mem[37]_6_s0
Launch Clk | audio_clock/pll_49m152/pll/CLKOUT0.default_gen_clk:[R]
Latch Clk | audio_clock/pll_49m152/pll/CLKOUT0.default_gen_clk:[R]

Data Arrival Path:

AT | DELAY | TYPE | RF | FANOUT | LOC | NODE
0.000 | 0.000 | | | | | active clock edge time
0.000 | 0.000 | | | | | audio_clock/pll_49m152/pll/CLKOUT0.default_gen_clk
4.964 | 4.964 | tCL | RR | 9528 | PLL_T[0] | audio_clock/pll_49m152/pll/CLKOUT0
7.063 | 2.099 | tNET | RR | 16 | BSRAM_R19[6] | system/sensors/eventizer/fifo_fifo_0_0_s/CLKB
9.073 | 2.010 | tC2Q | RR | 7 | BSRAM_R19[6] | system/sensors/eventizer/fifo_fifo_0_0_s/DO[13]
9.316 | 0.243 | tNET | RR | 1 | R20C104[3][B] | system/n1299_s4/I0
9.837 | 0.521 | tINS | RR | 3 | R20C104[3][B] | system/n1299_s4/F
10.167 | 0.330 | tNET | RR | 1 | R20C103[2][B] | system/n1327_s62/S0
10.419 | 0.252 | tINS | RR | 2 | R20C103[2][B] | system/n1327_s62/O
10.959 | 0.540 | tNET | RR | 1 | R20C108[0][B] | system/n1333_s8/I0
11.222 | 0.262 | tINS | RR | 1 | R20C108[0][B] | system/n1333_s8/F
11.794 | 0.572 | tNET | RR | 1 | R25C108[2][B] | system/n1333_s7/I2
12.311 | 0.516 | tINS | RR | 1 | R25C108[2][B] | system/n1333_s7/F
12.468 | 0.157 | tNET | RR | 1 | R26C108[3][A] | system/n1333_s5/I1
12.758 | 0.290 | tINS | RF | 1 | R26C108[3][A] | system/n1333_s5/F
12.763 | 0.005 | tNET | FF | 1 | R26C108[3][B] | system/n1333_s2/I2
13.178 | 0.415 | tINS | FR | 4 | R26C108[3][B] | system/n1333_s2/F
14.587 | 1.409 | tNET | RR | 1 | R59C113[1][B] | system/arbiter/n10_s6/I2
14.849 | 0.262 | tINS | RR | 2 | R59C113[1][B] | system/arbiter/n10_s6/F
14.989 | 0.140 | tNET | RR | 1 | R59C113[3][A] | system/arbiter/n27_s4/I1
15.487 | 0.498 | tINS | RR | 2 | R59C113[3][A] | system/arbiter/n27_s4/F
15.647 | 0.160 | tNET | RR | 1 | R60C113[3][B] | system/arbiter/n31_s3/I3
16.144 | 0.498 | tINS | RR | 1 | R60C113[3][B] | system/arbiter/n31_s3/F
16.147 | 0.003 | tNET | RR | 1 | R60C113[3][A] | system/arbiter/n31_s1/I0
16.644 | 0.498 | tINS | RR | 2 | R60C113[3][A] | system/arbiter/n31_s1/F
16.784 | 0.140 | tNET | RR | 1 | R60C113[2][B] | system/arbiter/n153_s4/I0
17.301 | 0.516 | tINS | RR | 44 | R60C113[2][B] | system/arbiter/n153_s4/F
17.656 | 0.355 | tNET | RR | 1 | R58C112[0][B] | system/arbiter/push_valid_s1/I3
18.182 | 0.526 | tINS | RR | 1 | R58C112[0][B] | system/arbiter/push_valid_s1/F
18.184 | 0.003 | tNET | RR | 1 | R58C112[1][A] | system/arbiter/push_valid_s0/I3
18.701 | 0.516 | tINS | RR | 2 | R58C112[1][A] | system/arbiter/push_valid_s0/F
18.706 | 0.005 | tNET | RR | 1 | R58C112[0][A] | system/arbiter/push_valid_s/I0
18.968 | 0.262 | tINS | RR | 3 | R58C112[0][A] | system/arbiter/push_valid_s/F
19.773 | 0.805 | tNET | RR | 1 | R27C111[3][B] | system/n921_s1/I3
20.294 | 0.521 | tINS | RR | 38 | R27C111[3][B] | system/n921_s1/F
22.801 | 2.506 | tNET | RR | 1 | R7C93[0][B] | system/events/n6895_s1/I3
23.063 | 0.262 | tINS | RR | 8 | R7C93[0][B] | system/events/n6895_s1/F
24.773 | 1.710 | tNET | RR | 1 | R23C93[3][B] | system/events/n7010_s0/I3
25.271 | 0.498 | tINS | RR | 8 | R23C93[3][B] | system/events/n7010_s0/F
26.102 | 0.831 | tNET | RR | 1 | R17C90[2][B] | system/events/mem[37]_6_s0/CE

Data Required Path:

AT | DELAY | TYPE | RF | FANOUT | LOC | NODE
20.345 | 20.345 | | | | | active clock edge time
20.345 | 0.000 | | | | | audio_clock/pll_49m152/pll/CLKOUT0.default_gen_clk
25.309 | 4.964 | tCL | RR | 9528 | PLL_T[0] | audio_clock/pll_49m152/pll/CLKOUT0
27.417 | 2.109 | tNET | RR | 1 | R17C90[2][B] | system/events/mem[37]_6_s0/CLK
27.106 | -0.311 | tSu | | 1 | R17C90[2][B] | system/events/mem[37]_6_s0

Path Statistics:

Clock Skew | 0.009
Setup Relationship | 20.345
Logic Level | 18
Arrival Clock Path Delay | cell: 0.000, 0.000%; route: 2.099, 100.000%
Arrival Data Path Delay | cell: 7.115, 37.371%; route: 9.914, 52.071%; tC2Q: 2.010, 10.557%
Required Clock Path Delay | cell: 0.000, 0.000%; route: 2.109, 100.000%

### Path21

Path Summary:

Slack | 1.004
Data Arrival Time | 26.102
Data Required Time | 27.106
From | system/sensors/eventizer/fifo_fifo_0_0_s
To | system/events/mem[37]_7_s0
Launch Clk | audio_clock/pll_49m152/pll/CLKOUT0.default_gen_clk:[R]
Latch Clk | audio_clock/pll_49m152/pll/CLKOUT0.default_gen_clk:[R]

Data Arrival Path:

AT | DELAY | TYPE | RF | FANOUT | LOC | NODE
0.000 | 0.000 | | | | | active clock edge time
0.000 | 0.000 | | | | | audio_clock/pll_49m152/pll/CLKOUT0.default_gen_clk
4.964 | 4.964 | tCL | RR | 9528 | PLL_T[0] | audio_clock/pll_49m152/pll/CLKOUT0
7.063 | 2.099 | tNET | RR | 16 | BSRAM_R19[6] | system/sensors/eventizer/fifo_fifo_0_0_s/CLKB
9.073 | 2.010 | tC2Q | RR | 7 | BSRAM_R19[6] | system/sensors/eventizer/fifo_fifo_0_0_s/DO[13]
9.316 | 0.243 | tNET | RR | 1 | R20C104[3][B] | system/n1299_s4/I0
9.837 | 0.521 | tINS | RR | 3 | R20C104[3][B] | system/n1299_s4/F
10.167 | 0.330 | tNET | RR | 1 | R20C103[2][B] | system/n1327_s62/S0
10.419 | 0.252 | tINS | RR | 2 | R20C103[2][B] | system/n1327_s62/O
10.959 | 0.540 | tNET | RR | 1 | R20C108[0][B] | system/n1333_s8/I0
11.222 | 0.262 | tINS | RR | 1 | R20C108[0][B] | system/n1333_s8/F
11.794 | 0.572 | tNET | RR | 1 | R25C108[2][B] | system/n1333_s7/I2
12.311 | 0.516 | tINS | RR | 1 | R25C108[2][B] | system/n1333_s7/F
12.468 | 0.157 | tNET | RR | 1 | R26C108[3][A] | system/n1333_s5/I1
12.758 | 0.290 | tINS | RF | 1 | R26C108[3][A] | system/n1333_s5/F
12.763 | 0.005 | tNET | FF | 1 | R26C108[3][B] | system/n1333_s2/I2
13.178 | 0.415 | tINS | FR | 4 | R26C108[3][B] | system/n1333_s2/F
14.587 | 1.409 | tNET | RR | 1 | R59C113[1][B] | system/arbiter/n10_s6/I2
14.849 | 0.262 | tINS | RR | 2 | R59C113[1][B] | system/arbiter/n10_s6/F
14.989 | 0.140 | tNET | RR | 1 | R59C113[3][A] | system/arbiter/n27_s4/I1
15.487 | 0.498 | tINS | RR | 2 | R59C113[3][A] | system/arbiter/n27_s4/F
15.647 | 0.160 | tNET | RR | 1 | R60C113[3][B] | system/arbiter/n31_s3/I3
16.144 | 0.498 | tINS | RR | 1 | R60C113[3][B] | system/arbiter/n31_s3/F
16.147 | 0.003 | tNET | RR | 1 | R60C113[3][A] | system/arbiter/n31_s1/I0
16.644 | 0.498 | tINS | RR | 2 | R60C113[3][A] | system/arbiter/n31_s1/F
16.784 | 0.140 | tNET | RR | 1 | R60C113[2][B] | system/arbiter/n153_s4/I0
17.301 | 0.516 | tINS | RR | 44 | R60C113[2][B] | system/arbiter/n153_s4/F
17.656 | 0.355 | tNET | RR | 1 | R58C112[0][B] | system/arbiter/push_valid_s1/I3
18.182 | 0.526 | tINS | RR | 1 | R58C112[0][B] | system/arbiter/push_valid_s1/F
18.184 | 0.003 | tNET | RR | 1 | R58C112[1][A] | system/arbiter/push_valid_s0/I3
18.701 | 0.516 | tINS | RR | 2 | R58C112[1][A] | system/arbiter/push_valid_s0/F
18.706 | 0.005 | tNET | RR | 1 | R58C112[0][A] | system/arbiter/push_valid_s/I0
18.968 | 0.262 | tINS | RR | 3 | R58C112[0][A] | system/arbiter/push_valid_s/F
19.773 | 0.805 | tNET | RR | 1 | R27C111[3][B] | system/n921_s1/I3
20.294 | 0.521 | tINS | RR | 38 | R27C111[3][B] | system/n921_s1/F
22.801 | 2.506 | tNET | RR | 1 | R7C93[0][B] | system/events/n6895_s1/I3
23.063 | 0.262 | tINS | RR | 8 | R7C93[0][B] | system/events/n6895_s1/F
24.773 | 1.710 | tNET | RR | 1 | R23C93[3][B] | system/events/n7010_s0/I3
25.271 | 0.498 | tINS | RR | 8 | R23C93[3][B] | system/events/n7010_s0/F
26.102 | 0.831 | tNET | RR | 1 | R17C90[2][A] | system/events/mem[37]_7_s0/CE

Data Required Path:

AT | DELAY | TYPE | RF | FANOUT | LOC | NODE
20.345 | 20.345 | | | | | active clock edge time
20.345 | 0.000 | | | | | audio_clock/pll_49m152/pll/CLKOUT0.default_gen_clk
25.309 | 4.964 | tCL | RR | 9528 | PLL_T[0] | audio_clock/pll_49m152/pll/CLKOUT0
27.417 | 2.109 | tNET | RR | 1 | R17C90[2][A] | system/events/mem[37]_7_s0/CLK
27.106 | -0.311 | tSu | | 1 | R17C90[2][A] | system/events/mem[37]_7_s0

Path Statistics:

Clock Skew | 0.009
Setup Relationship | 20.345
Logic Level | 18
Arrival Clock Path Delay | cell: 0.000, 0.000%; route: 2.099, 100.000%
Arrival Data Path Delay | cell: 7.115, 37.371%; route: 9.914, 52.071%; tC2Q: 2.010, 10.557%
Required Clock Path Delay | cell: 0.000, 0.000%; route: 2.109, 100.000%

### Path22

Path Summary:

Slack | 1.004
Data Arrival Time | 26.340
Data Required Time | 27.344
From | system/performance/record_ram_record_ram_0_2_s
To | system/performance/event_velocity_6_s0
Launch Clk | audio_clock/pll_49m152/pll/CLKOUT0.default_gen_clk:[R]
Latch Clk | audio_clock/pll_49m152/pll/CLKOUT0.default_gen_clk:[R]

Data Arrival Path:

AT | DELAY | TYPE | RF | FANOUT | LOC | NODE
0.000 | 0.000 | | | | | active clock edge time
0.000 | 0.000 | | | | | audio_clock/pll_49m152/pll/CLKOUT0.default_gen_clk
4.964 | 4.964 | tCL | RR | 9528 | PLL_T[0] | audio_clock/pll_49m152/pll/CLKOUT0
7.072 | 2.109 | tNET | RR | 16 | BSRAM_R56[31][A] | system/performance/record_ram_record_ram_0_2_s/CLKB
9.077 | 2.005 | tC2Q | RF | 4 | BSRAM_R56[31][A] | system/performance/record_ram_record_ram_0_2_s/DO[1]
10.255 | 1.178 | tNET | FF | 1 | R44C128[0][A] | system/performance/active_key_2_s4/I1
10.781 | 0.526 | tINS | FR | 1 | R44C128[0][A] | system/performance/active_key_2_s4/F
10.784 | 0.003 | tNET | RR | 1 | R44C128[0][B] | system/performance/active_key_2_s3/I1
11.046 | 0.262 | tINS | RR | 1 | R44C128[0][B] | system/performance/active_key_2_s3/F
11.431 | 0.385 | tNET | RR | 1 | R46C127[0][A] | system/performance/active_key_2_s0/I2
11.811 | 0.380 | tINS | RF | 224 | R46C127[0][A] | system/performance/active_key_2_s0/F
15.770 | 3.959 | tNET | FF | 1 | R68C124[2][A] | system/performance/active_note_6_s13/I0
16.296 | 0.526 | tINS | FR | 29 | R68C124[2][A] | system/performance/active_note_6_s13/F
17.575 | 1.279 | tNET | RR | 1 | R70C114[1][A] | system/performance/active_note_1_s125/I0
18.036 | 0.461 | tINS | RR | 1 | R70C114[1][A] | system/performance/active_note_1_s125/F
18.039 | 0.003 | tNET | RR | 1 | R70C114[2][B] | system/performance/active_note_1_s115/I1
18.301 | 0.262 | tINS | RR | 1 | R70C114[2][B] | system/performance/active_note_1_s115/F
18.629 | 0.327 | tNET | RR | 1 | R69C114[2][B] | system/performance/active_note_1_s78/I2
19.155 | 0.526 | tINS | RR | 1 | R69C114[2][B] | system/performance/active_note_1_s78/F
19.821 | 0.666 | tNET | RR | 1 | R62C119[2][B] | system/performance/active_note_1_s25/I3
20.282 | 0.461 | tINS | RR | 1 | R62C119[2][B] | system/performance/active_note_1_s25/F
20.285 | 0.003 | tNET | RR | 1 | R62C119[3][A] | system/performance/active_note_1_s6/I3
20.782 | 0.498 | tINS | RR | 1 | R62C119[3][A] | system/performance/active_note_1_s6/F
20.940 | 0.157 | tNET | RR | 1 | R61C119[3][A] | system/performance/active_note_1_s1/I3
21.230 | 0.290 | tINS | RF | 1 | R61C119[3][A] | system/performance/active_note_1_s1/F
21.696 | 0.466 | tNET | FF | 1 | R61C125[0][A] | system/performance/active_note_1_s0/I0
22.157 | 0.461 | tINS | FR | 2 | R61C125[0][A] | system/performance/active_note_1_s0/F
23.151 | 0.994 | tNET | RR | 2 | R60C138[0][B] | system/performance/n4752_s0/I1
23.714 | 0.562 | tINS | RF | 1 | R60C138[0][B] | system/performance/n4752_s0/COUT
23.714 | 0.000 | tNET | FF | 2 | R60C138[1][A] | system/performance/n4753_s0/CIN
23.764 | 0.050 | tINS | FR | 1 | R60C138[1][A] | system/performance/n4753_s0/COUT
23.764 | 0.000 | tNET | RR | 2 | R60C138[1][B] | system/performance/n4754_s0/CIN
23.814 | 0.050 | tINS | RR | 1 | R60C138[1][B] | system/performance/n4754_s0/COUT
23.814 | 0.000 | tNET | RR | 2 | R60C138[2][A] | system/performance/n4755_s0/CIN
23.864 | 0.050 | tINS | RR | 1 | R60C138[2][A] | system/performance/n4755_s0/COUT
23.864 | 0.000 | tNET | RR | 2 | R60C138[2][B] | system/performance/n4756_s0/CIN
23.914 | 0.050 | tINS | RR | 1 | R60C138[2][B] | system/performance/n4756_s0/COUT
23.914 | 0.000 | tNET | RR | 2 | R60C139[0][A] | system/performance/n4757_s0/CIN
23.964 | 0.050 | tINS | RR | 3 | R60C139[0][A] | system/performance/n4757_s0/COUT
24.772 | 0.809 | tNET | RR | 1 | R60C135[3][B] | system/performance/n5028_s10/I2
25.270 | 0.498 | tINS | RR | 8 | R60C135[3][B] | system/performance/n5028_s10/F
25.879 | 0.609 | tNET | RR | 1 | R46C139[0][A] | system/performance/n5042_s2/I1
26.340 | 0.461 | tINS | RR | 1 | R46C139[0][A] | system/performance/n5042_s2/F
26.340 | 0.000 | tNET | RR | 1 | R46C139[0][A] | system/performance/event_velocity_6_s0/D

Data Required Path:

AT | DELAY | TYPE | RF | FANOUT | LOC | NODE
20.345 | 20.345 | | | | | active clock edge time
20.345 | 0.000 | | | | | audio_clock/pll_49m152/pll/CLKOUT0.default_gen_clk
25.309 | 4.964 | tCL | RR | 9528 | PLL_T[0] | audio_clock/pll_49m152/pll/CLKOUT0
27.408 | 2.099 | tNET | RR | 1 | R46C139[0][A] | system/performance/event_velocity_6_s0/CLK
27.344 | -0.064 | tSu | | 1 | R46C139[0][A] | system/performance/event_velocity_6_s0

Path Statistics:

Clock Skew | -0.009
Setup Relationship | 20.345
Logic Level | 16
Arrival Clock Path Delay | cell: 0.000, 0.000%; route: 2.109, 100.000%
Arrival Data Path Delay | cell: 6.426, 33.353%; route: 10.836, 56.241%; tC2Q: 2.005, 10.406%
Required Clock Path Delay | cell: 0.000, 0.000%; route: 2.099, 100.000%

### Path23

Path Summary:

Slack | 1.033
Data Arrival Time | 26.064
Data Required Time | 27.097
From | system/sensors/eventizer/fifo_fifo_0_0_s
To | system/performance/last_record_ms_30_s0
Launch Clk | audio_clock/pll_49m152/pll/CLKOUT0.default_gen_clk:[R]
Latch Clk | audio_clock/pll_49m152/pll/CLKOUT0.default_gen_clk:[R]

Data Arrival Path:

AT | DELAY | TYPE | RF | FANOUT | LOC | NODE
0.000 | 0.000 | | | | | active clock edge time
0.000 | 0.000 | | | | | audio_clock/pll_49m152/pll/CLKOUT0.default_gen_clk
4.964 | 4.964 | tCL | RR | 9528 | PLL_T[0] | audio_clock/pll_49m152/pll/CLKOUT0
7.063 | 2.099 | tNET | RR | 16 | BSRAM_R19[6] | system/sensors/eventizer/fifo_fifo_0_0_s/CLKB
9.073 | 2.010 | tC2Q | RR | 7 | BSRAM_R19[6] | system/sensors/eventizer/fifo_fifo_0_0_s/DO[13]
9.316 | 0.243 | tNET | RR | 1 | R20C104[3][B] | system/n1299_s4/I0
9.837 | 0.521 | tINS | RR | 3 | R20C104[3][B] | system/n1299_s4/F
10.167 | 0.330 | tNET | RR | 1 | R20C103[2][B] | system/n1327_s62/S0
10.419 | 0.252 | tINS | RR | 2 | R20C103[2][B] | system/n1327_s62/O
10.959 | 0.540 | tNET | RR | 1 | R20C108[0][B] | system/n1333_s8/I0
11.222 | 0.262 | tINS | RR | 1 | R20C108[0][B] | system/n1333_s8/F
11.794 | 0.572 | tNET | RR | 1 | R25C108[2][B] | system/n1333_s7/I2
12.311 | 0.516 | tINS | RR | 1 | R25C108[2][B] | system/n1333_s7/F
12.468 | 0.157 | tNET | RR | 1 | R26C108[3][A] | system/n1333_s5/I1
12.758 | 0.290 | tINS | RF | 1 | R26C108[3][A] | system/n1333_s5/F
12.763 | 0.005 | tNET | FF | 1 | R26C108[3][B] | system/n1333_s2/I2
13.178 | 0.415 | tINS | FR | 4 | R26C108[3][B] | system/n1333_s2/F
14.587 | 1.409 | tNET | RR | 1 | R59C113[1][B] | system/arbiter/n10_s6/I2
14.849 | 0.262 | tINS | RR | 2 | R59C113[1][B] | system/arbiter/n10_s6/F
14.989 | 0.140 | tNET | RR | 1 | R59C113[3][A] | system/arbiter/n27_s4/I1
15.487 | 0.498 | tINS | RR | 2 | R59C113[3][A] | system/arbiter/n27_s4/F
15.647 | 0.160 | tNET | RR | 1 | R60C113[3][B] | system/arbiter/n31_s3/I3
16.144 | 0.498 | tINS | RR | 1 | R60C113[3][B] | system/arbiter/n31_s3/F
16.147 | 0.003 | tNET | RR | 1 | R60C113[3][A] | system/arbiter/n31_s1/I0
16.644 | 0.498 | tINS | RR | 2 | R60C113[3][A] | system/arbiter/n31_s1/F
16.784 | 0.140 | tNET | RR | 1 | R60C113[2][B] | system/arbiter/n153_s4/I0
17.301 | 0.516 | tINS | RR | 44 | R60C113[2][B] | system/arbiter/n153_s4/F
17.656 | 0.355 | tNET | RR | 1 | R58C112[0][B] | system/arbiter/push_valid_s1/I3
18.182 | 0.526 | tINS | RR | 1 | R58C112[0][B] | system/arbiter/push_valid_s1/F
18.184 | 0.003 | tNET | RR | 1 | R58C112[1][A] | system/arbiter/push_valid_s0/I3
18.701 | 0.516 | tINS | RR | 2 | R58C112[1][A] | system/arbiter/push_valid_s0/F
18.706 | 0.005 | tNET | RR | 1 | R58C112[0][A] | system/arbiter/push_valid_s/I0
18.968 | 0.262 | tINS | RR | 3 | R58C112[0][A] | system/arbiter/push_valid_s/F
19.773 | 0.805 | tNET | RR | 1 | R27C111[3][B] | system/n921_s1/I3
20.294 | 0.521 | tINS | RR | 38 | R27C111[3][B] | system/n921_s1/F
21.979 | 1.685 | tNET | RR | 1 | R59C135[3][A] | system/performance/record_capture_s4/I3
22.477 | 0.498 | tINS | RR | 1 | R59C135[3][A] | system/performance/record_capture_s4/F
22.479 | 0.003 | tNET | RR | 1 | R59C135[2][B] | system/performance/record_capture_s2/I3
22.941 | 0.461 | tINS | RR | 6 | R59C135[2][B] | system/performance/record_capture_s2/F
23.193 | 0.252 | tNET | RR | 1 | R57C135[0][B] | system/performance/record_capture_s5/I1
23.654 | 0.461 | tINS | RR | 24 | R57C135[0][B] | system/performance/record_capture_s5/F
24.367 | 0.712 | tNET | RR | 1 | R54C137[2][A] | system/performance/n8662_s0/I3
24.883 | 0.516 | tINS | RR | 32 | R54C137[2][A] | system/performance/n8662_s0/F
26.064 | 1.181 | tNET | RR | 1 | R50C139[1][B] | system/performance/last_record_ms_30_s0/CE

Data Required Path:

AT | DELAY | TYPE | RF | FANOUT | LOC | NODE
20.345 | 20.345 | | | | | active clock edge time
20.345 | 0.000 | | | | | audio_clock/pll_49m152/pll/CLKOUT0.default_gen_clk
25.309 | 4.964 | tCL | RR | 9528 | PLL_T[0] | audio_clock/pll_49m152/pll/CLKOUT0
27.408 | 2.099 | tNET | RR | 1 | R50C139[1][B] | system/performance/last_record_ms_30_s0/CLK
27.097 | -0.311 | tSu | | 1 | R50C139[1][B] | system/performance/last_record_ms_30_s0

Path Statistics:

Clock Skew | 0.000
Setup Relationship | 20.345
Logic Level | 20
Arrival Clock Path Delay | cell: 0.000, 0.000%; route: 2.099, 100.000%
Arrival Data Path Delay | cell: 8.291, 43.635%; route: 8.700, 45.786%; tC2Q: 2.010, 10.578%
Required Clock Path Delay | cell: 0.000, 0.000%; route: 2.099, 100.000%

### Path24

Path Summary:

Slack | 1.050
Data Arrival Time | 26.047
Data Required Time | 27.097
From | system/sensors/eventizer/fifo_fifo_0_0_s
To | system/performance/last_record_ms_1_s0
Launch Clk | audio_clock/pll_49m152/pll/CLKOUT0.default_gen_clk:[R]
Latch Clk | audio_clock/pll_49m152/pll/CLKOUT0.default_gen_clk:[R]

Data Arrival Path:

AT | DELAY | TYPE | RF | FANOUT | LOC | NODE
0.000 | 0.000 | | | | | active clock edge time
0.000 | 0.000 | | | | | audio_clock/pll_49m152/pll/CLKOUT0.default_gen_clk
4.964 | 4.964 | tCL | RR | 9528 | PLL_T[0] | audio_clock/pll_49m152/pll/CLKOUT0
7.063 | 2.099 | tNET | RR | 16 | BSRAM_R19[6] | system/sensors/eventizer/fifo_fifo_0_0_s/CLKB
9.073 | 2.010 | tC2Q | RR | 7 | BSRAM_R19[6] | system/sensors/eventizer/fifo_fifo_0_0_s/DO[13]
9.316 | 0.243 | tNET | RR | 1 | R20C104[3][B] | system/n1299_s4/I0
9.837 | 0.521 | tINS | RR | 3 | R20C104[3][B] | system/n1299_s4/F
10.167 | 0.330 | tNET | RR | 1 | R20C103[2][B] | system/n1327_s62/S0
10.419 | 0.252 | tINS | RR | 2 | R20C103[2][B] | system/n1327_s62/O
10.959 | 0.540 | tNET | RR | 1 | R20C108[0][B] | system/n1333_s8/I0
11.222 | 0.262 | tINS | RR | 1 | R20C108[0][B] | system/n1333_s8/F
11.794 | 0.572 | tNET | RR | 1 | R25C108[2][B] | system/n1333_s7/I2
12.311 | 0.516 | tINS | RR | 1 | R25C108[2][B] | system/n1333_s7/F
12.468 | 0.157 | tNET | RR | 1 | R26C108[3][A] | system/n1333_s5/I1
12.758 | 0.290 | tINS | RF | 1 | R26C108[3][A] | system/n1333_s5/F
12.763 | 0.005 | tNET | FF | 1 | R26C108[3][B] | system/n1333_s2/I2
13.178 | 0.415 | tINS | FR | 4 | R26C108[3][B] | system/n1333_s2/F
14.587 | 1.409 | tNET | RR | 1 | R59C113[1][B] | system/arbiter/n10_s6/I2
14.849 | 0.262 | tINS | RR | 2 | R59C113[1][B] | system/arbiter/n10_s6/F
14.989 | 0.140 | tNET | RR | 1 | R59C113[3][A] | system/arbiter/n27_s4/I1
15.487 | 0.498 | tINS | RR | 2 | R59C113[3][A] | system/arbiter/n27_s4/F
15.647 | 0.160 | tNET | RR | 1 | R60C113[3][B] | system/arbiter/n31_s3/I3
16.144 | 0.498 | tINS | RR | 1 | R60C113[3][B] | system/arbiter/n31_s3/F
16.147 | 0.003 | tNET | RR | 1 | R60C113[3][A] | system/arbiter/n31_s1/I0
16.644 | 0.498 | tINS | RR | 2 | R60C113[3][A] | system/arbiter/n31_s1/F
16.784 | 0.140 | tNET | RR | 1 | R60C113[2][B] | system/arbiter/n153_s4/I0
17.301 | 0.516 | tINS | RR | 44 | R60C113[2][B] | system/arbiter/n153_s4/F
17.656 | 0.355 | tNET | RR | 1 | R58C112[0][B] | system/arbiter/push_valid_s1/I3
18.182 | 0.526 | tINS | RR | 1 | R58C112[0][B] | system/arbiter/push_valid_s1/F
18.184 | 0.003 | tNET | RR | 1 | R58C112[1][A] | system/arbiter/push_valid_s0/I3
18.701 | 0.516 | tINS | RR | 2 | R58C112[1][A] | system/arbiter/push_valid_s0/F
18.706 | 0.005 | tNET | RR | 1 | R58C112[0][A] | system/arbiter/push_valid_s/I0
18.968 | 0.262 | tINS | RR | 3 | R58C112[0][A] | system/arbiter/push_valid_s/F
19.773 | 0.805 | tNET | RR | 1 | R27C111[3][B] | system/n921_s1/I3
20.294 | 0.521 | tINS | RR | 38 | R27C111[3][B] | system/n921_s1/F
21.979 | 1.685 | tNET | RR | 1 | R59C135[3][A] | system/performance/record_capture_s4/I3
22.477 | 0.498 | tINS | RR | 1 | R59C135[3][A] | system/performance/record_capture_s4/F
22.479 | 0.003 | tNET | RR | 1 | R59C135[2][B] | system/performance/record_capture_s2/I3
22.941 | 0.461 | tINS | RR | 6 | R59C135[2][B] | system/performance/record_capture_s2/F
23.193 | 0.252 | tNET | RR | 1 | R57C135[0][B] | system/performance/record_capture_s5/I1
23.654 | 0.461 | tINS | RR | 24 | R57C135[0][B] | system/performance/record_capture_s5/F
24.367 | 0.712 | tNET | RR | 1 | R54C137[2][A] | system/performance/n8662_s0/I3
24.883 | 0.516 | tINS | RR | 32 | R54C137[2][A] | system/performance/n8662_s0/F
26.047 | 1.164 | tNET | RR | 1 | R51C133[3][A] | system/performance/last_record_ms_1_s0/CE

Data Required Path:

AT | DELAY | TYPE | RF | FANOUT | LOC | NODE
20.345 | 20.345 | | | | | active clock edge time
20.345 | 0.000 | | | | | audio_clock/pll_49m152/pll/CLKOUT0.default_gen_clk
25.309 | 4.964 | tCL | RR | 9528 | PLL_T[0] | audio_clock/pll_49m152/pll/CLKOUT0
27.408 | 2.099 | tNET | RR | 1 | R51C133[3][A] | system/performance/last_record_ms_1_s0/CLK
27.097 | -0.311 | tSu | | 1 | R51C133[3][A] | system/performance/last_record_ms_1_s0

Path Statistics:

Clock Skew | 0.000
Setup Relationship | 20.345
Logic Level | 20
Arrival Clock Path Delay | cell: 0.000, 0.000%; route: 2.099, 100.000%
Arrival Data Path Delay | cell: 8.291, 43.676%; route: 8.682, 45.736%; tC2Q: 2.010, 10.588%
Required Clock Path Delay | cell: 0.000, 0.000%; route: 2.099, 100.000%

### Path25

Path Summary:

Slack | 1.082
Data Arrival Time | 26.262
Data Required Time | 27.344
From | system/performance/record_ram_record_ram_0_2_s
To | system/performance/event_velocity_2_s0
Launch Clk | audio_clock/pll_49m152/pll/CLKOUT0.default_gen_clk:[R]
Latch Clk | audio_clock/pll_49m152/pll/CLKOUT0.default_gen_clk:[R]

Data Arrival Path:

AT | DELAY | TYPE | RF | FANOUT | LOC | NODE
0.000 | 0.000 | | | | | active clock edge time
0.000 | 0.000 | | | | | audio_clock/pll_49m152/pll/CLKOUT0.default_gen_clk
4.964 | 4.964 | tCL | RR | 9528 | PLL_T[0] | audio_clock/pll_49m152/pll/CLKOUT0
7.072 | 2.109 | tNET | RR | 16 | BSRAM_R56[31][A] | system/performance/record_ram_record_ram_0_2_s/CLKB
9.077 | 2.005 | tC2Q | RF | 4 | BSRAM_R56[31][A] | system/performance/record_ram_record_ram_0_2_s/DO[1]
10.255 | 1.178 | tNET | FF | 1 | R44C128[0][A] | system/performance/active_key_2_s4/I1
10.781 | 0.526 | tINS | FR | 1 | R44C128[0][A] | system/performance/active_key_2_s4/F
10.784 | 0.003 | tNET | RR | 1 | R44C128[0][B] | system/performance/active_key_2_s3/I1
11.046 | 0.262 | tINS | RR | 1 | R44C128[0][B] | system/performance/active_key_2_s3/F
11.431 | 0.385 | tNET | RR | 1 | R46C127[0][A] | system/performance/active_key_2_s0/I2
11.811 | 0.380 | tINS | RF | 224 | R46C127[0][A] | system/performance/active_key_2_s0/F
15.770 | 3.959 | tNET | FF | 1 | R68C124[2][A] | system/performance/active_note_6_s13/I0
16.296 | 0.526 | tINS | FR | 29 | R68C124[2][A] | system/performance/active_note_6_s13/F
17.575 | 1.279 | tNET | RR | 1 | R70C114[1][A] | system/performance/active_note_1_s125/I0
18.036 | 0.461 | tINS | RR | 1 | R70C114[1][A] | system/performance/active_note_1_s125/F
18.039 | 0.003 | tNET | RR | 1 | R70C114[2][B] | system/performance/active_note_1_s115/I1
18.301 | 0.262 | tINS | RR | 1 | R70C114[2][B] | system/performance/active_note_1_s115/F
18.629 | 0.327 | tNET | RR | 1 | R69C114[2][B] | system/performance/active_note_1_s78/I2
19.155 | 0.526 | tINS | RR | 1 | R69C114[2][B] | system/performance/active_note_1_s78/F
19.821 | 0.666 | tNET | RR | 1 | R62C119[2][B] | system/performance/active_note_1_s25/I3
20.282 | 0.461 | tINS | RR | 1 | R62C119[2][B] | system/performance/active_note_1_s25/F
20.285 | 0.003 | tNET | RR | 1 | R62C119[3][A] | system/performance/active_note_1_s6/I3
20.782 | 0.498 | tINS | RR | 1 | R62C119[3][A] | system/performance/active_note_1_s6/F
20.940 | 0.157 | tNET | RR | 1 | R61C119[3][A] | system/performance/active_note_1_s1/I3
21.230 | 0.290 | tINS | RF | 1 | R61C119[3][A] | system/performance/active_note_1_s1/F
21.696 | 0.466 | tNET | FF | 1 | R61C125[0][A] | system/performance/active_note_1_s0/I0
22.157 | 0.461 | tINS | FR | 2 | R61C125[0][A] | system/performance/active_note_1_s0/F
23.151 | 0.994 | tNET | RR | 2 | R60C138[0][B] | system/performance/n4752_s0/I1
23.714 | 0.562 | tINS | RF | 1 | R60C138[0][B] | system/performance/n4752_s0/COUT
23.714 | 0.000 | tNET | FF | 2 | R60C138[1][A] | system/performance/n4753_s0/CIN
23.764 | 0.050 | tINS | FR | 1 | R60C138[1][A] | system/performance/n4753_s0/COUT
23.764 | 0.000 | tNET | RR | 2 | R60C138[1][B] | system/performance/n4754_s0/CIN
23.814 | 0.050 | tINS | RR | 1 | R60C138[1][B] | system/performance/n4754_s0/COUT
23.814 | 0.000 | tNET | RR | 2 | R60C138[2][A] | system/performance/n4755_s0/CIN
23.864 | 0.050 | tINS | RR | 1 | R60C138[2][A] | system/performance/n4755_s0/COUT
23.864 | 0.000 | tNET | RR | 2 | R60C138[2][B] | system/performance/n4756_s0/CIN
23.914 | 0.050 | tINS | RR | 1 | R60C138[2][B] | system/performance/n4756_s0/COUT
23.914 | 0.000 | tNET | RR | 2 | R60C139[0][A] | system/performance/n4757_s0/CIN
23.964 | 0.050 | tINS | RR | 3 | R60C139[0][A] | system/performance/n4757_s0/COUT
24.772 | 0.809 | tNET | RR | 1 | R60C135[3][B] | system/performance/n5028_s10/I2
25.270 | 0.498 | tINS | RR | 8 | R60C135[3][B] | system/performance/n5028_s10/F
25.801 | 0.531 | tNET | RR | 1 | R46C139[1][B] | system/performance/n5046_s2/I1
26.262 | 0.461 | tINS | RR | 1 | R46C139[1][B] | system/performance/n5046_s2/F
26.262 | 0.000 | tNET | RR | 1 | R46C139[1][B] | system/performance/event_velocity_2_s0/D

Data Required Path:

AT | DELAY | TYPE | RF | FANOUT | LOC | NODE
20.345 | 20.345 | | | | | active clock edge time
20.345 | 0.000 | | | | | audio_clock/pll_49m152/pll/CLKOUT0.default_gen_clk
25.309 | 4.964 | tCL | RR | 9528 | PLL_T[0] | audio_clock/pll_49m152/pll/CLKOUT0
27.408 | 2.099 | tNET | RR | 1 | R46C139[1][B] | system/performance/event_velocity_2_s0/CLK
27.344 | -0.064 | tSu | | 1 | R46C139[1][B] | system/performance/event_velocity_2_s0

Path Statistics:

Clock Skew | -0.009
Setup Relationship | 20.345
Logic Level | 16
Arrival Clock Path Delay | cell: 0.000, 0.000%; route: 2.109, 100.000%
Arrival Data Path Delay | cell: 6.426, 33.487%; route: 10.759, 56.064%; tC2Q: 2.005, 10.448%
Required Clock Path Delay | cell: 0.000, 0.000%; route: 2.099, 100.000%

### Hold Analysis Report

#### Report Command:report_timing -hold -max_paths 25 -max_common_paths 1

### Path1

Path Summary:

Slack | 0.035
Data Arrival Time | 5.906
Data Required Time | 5.871
From | system/synth/u_polar0/tR3_17_s0
To | system/synth/u_polar0/states_states_0_1_s
Launch Clk | audio_clock/pll_49m152/pll/CLKOUT0.default_gen_clk:[R]
Latch Clk | audio_clock/pll_49m152/pll/CLKOUT0.default_gen_clk:[R]

Data Arrival Path:

AT | DELAY | TYPE | RF | FANOUT | LOC | NODE
0.000 | 0.000 | | | | | active clock edge time
0.000 | 0.000 | | | | | audio_clock/pll_49m152/pll/CLKOUT0.default_gen_clk
4.964 | 4.964 | tCL | RR | 9528 | PLL_T[0] | audio_clock/pll_49m152/pll/CLKOUT0
5.641 | 0.677 | tNET | RR | 1 | R40C69[3][A] | system/synth/u_polar0/tR3_17_s0/CLK
5.782 | 0.141 | tC2Q | RF | 2 | R40C69[3][A] | system/synth/u_polar0/tR3_17_s0/Q
5.906 | 0.124 | tNET | FF | 1 | BSRAM_R38[14][A] | system/synth/u_polar0/states_states_0_1_s/DI[13]

Data Required Path:

AT | DELAY | TYPE | RF | FANOUT | LOC | NODE
0.000 | 0.000 | | | | | active clock edge time
0.000 | 0.000 | | | | | audio_clock/pll_49m152/pll/CLKOUT0.default_gen_clk
4.964 | 4.964 | tCL | RR | 9528 | PLL_T[0] | audio_clock/pll_49m152/pll/CLKOUT0
5.834 | 0.870 | tNET | RR | 1 | BSRAM_R38[14][A] | system/synth/u_polar0/states_states_0_1_s/CLKA
5.871 | 0.037 | tHld | | 1 | BSRAM_R38[14][A] | system/synth/u_polar0/states_states_0_1_s

Path Statistics:

Clock Skew | 0.193
Hold Relationship | 0.000
Logic Level | 1
Arrival Clock Path Delay | cell: 0.000, 0.000%; route: 0.677, 100.000%
Arrival Data Path Delay | cell: 0.000, 0.000%; route: 0.124, 46.792%; tC2Q: 0.141, 53.208%
Required Clock Path Delay | cell: 0.000, 0.000%; route: 0.870, 100.000%

### Path2

Path Summary:

Slack | 0.068
Data Arrival Time | 5.939
Data Required Time | 5.871
From | system/synth/u_polar0/tR3_8_s0
To | system/synth/u_polar0/states_states_0_1_s
Launch Clk | audio_clock/pll_49m152/pll/CLKOUT0.default_gen_clk:[R]
Latch Clk | audio_clock/pll_49m152/pll/CLKOUT0.default_gen_clk:[R]

Data Arrival Path:

AT | DELAY | TYPE | RF | FANOUT | LOC | NODE
0.000 | 0.000 | | | | | active clock edge time
0.000 | 0.000 | | | | | audio_clock/pll_49m152/pll/CLKOUT0.default_gen_clk
4.964 | 4.964 | tCL | RR | 9528 | PLL_T[0] | audio_clock/pll_49m152/pll/CLKOUT0
5.637 | 0.673 | tNET | RR | 1 | R41C68[2][B] | system/synth/u_polar0/tR3_8_s0/CLK
5.778 | 0.141 | tC2Q | RF | 2 | R41C68[2][B] | system/synth/u_polar0/tR3_8_s0/Q
5.939 | 0.161 | tNET | FF | 1 | BSRAM_R38[14][A] | system/synth/u_polar0/states_states_0_1_s/DI[4]

Data Required Path:

AT | DELAY | TYPE | RF | FANOUT | LOC | NODE
0.000 | 0.000 | | | | | active clock edge time
0.000 | 0.000 | | | | | audio_clock/pll_49m152/pll/CLKOUT0.default_gen_clk
4.964 | 4.964 | tCL | RR | 9528 | PLL_T[0] | audio_clock/pll_49m152/pll/CLKOUT0
5.834 | 0.870 | tNET | RR | 1 | BSRAM_R38[14][A] | system/synth/u_polar0/states_states_0_1_s/CLKA
5.871 | 0.037 | tHld | | 1 | BSRAM_R38[14][A] | system/synth/u_polar0/states_states_0_1_s

Path Statistics:

Clock Skew | 0.197
Hold Relationship | 0.000
Logic Level | 1
Arrival Clock Path Delay | cell: 0.000, 0.000%; route: 0.673, 100.000%
Arrival Data Path Delay | cell: 0.000, 0.000%; route: 0.161, 53.311%; tC2Q: 0.141, 46.689%
Required Clock Path Delay | cell: 0.000, 0.000%; route: 0.870, 100.000%

### Path3

Path Summary:

Slack | 0.068
Data Arrival Time | 5.939
Data Required Time | 5.871
From | system/synth/u_polar0/tR3_6_s0
To | system/synth/u_polar0/states_states_0_1_s
Launch Clk | audio_clock/pll_49m152/pll/CLKOUT0.default_gen_clk:[R]
Latch Clk | audio_clock/pll_49m152/pll/CLKOUT0.default_gen_clk:[R]

Data Arrival Path:

AT | DELAY | TYPE | RF | FANOUT | LOC | NODE
0.000 | 0.000 | | | | | active clock edge time
0.000 | 0.000 | | | | | audio_clock/pll_49m152/pll/CLKOUT0.default_gen_clk
4.964 | 4.964 | tCL | RR | 9528 | PLL_T[0] | audio_clock/pll_49m152/pll/CLKOUT0
5.637 | 0.673 | tNET | RR | 1 | R41C68[1][B] | system/synth/u_polar0/tR3_6_s0/CLK
5.778 | 0.141 | tC2Q | RF | 2 | R41C68[1][B] | system/synth/u_polar0/tR3_6_s0/Q
5.939 | 0.161 | tNET | FF | 1 | BSRAM_R38[14][A] | system/synth/u_polar0/states_states_0_1_s/DI[2]

Data Required Path:

AT | DELAY | TYPE | RF | FANOUT | LOC | NODE
0.000 | 0.000 | | | | | active clock edge time
0.000 | 0.000 | | | | | audio_clock/pll_49m152/pll/CLKOUT0.default_gen_clk
4.964 | 4.964 | tCL | RR | 9528 | PLL_T[0] | audio_clock/pll_49m152/pll/CLKOUT0
5.834 | 0.870 | tNET | RR | 1 | BSRAM_R38[14][A] | system/synth/u_polar0/states_states_0_1_s/CLKA
5.871 | 0.037 | tHld | | 1 | BSRAM_R38[14][A] | system/synth/u_polar0/states_states_0_1_s

Path Statistics:

Clock Skew | 0.197
Hold Relationship | 0.000
Logic Level | 1
Arrival Clock Path Delay | cell: 0.000, 0.000%; route: 0.673, 100.000%
Arrival Data Path Delay | cell: 0.000, 0.000%; route: 0.161, 53.311%; tC2Q: 0.141, 46.689%
Required Clock Path Delay | cell: 0.000, 0.000%; route: 0.870, 100.000%

### Path4

Path Summary:

Slack | 0.069
Data Arrival Time | 5.940
Data Required Time | 5.871
From | system/synth/u_polar0/tR3_13_s0
To | system/synth/u_polar0/states_states_0_1_s
Launch Clk | audio_clock/pll_49m152/pll/CLKOUT0.default_gen_clk:[R]
Latch Clk | audio_clock/pll_49m152/pll/CLKOUT0.default_gen_clk:[R]

Data Arrival Path:

AT | DELAY | TYPE | RF | FANOUT | LOC | NODE
0.000 | 0.000 | | | | | active clock edge time
0.000 | 0.000 | | | | | audio_clock/pll_49m152/pll/CLKOUT0.default_gen_clk
4.964 | 4.964 | tCL | RR | 9528 | PLL_T[0] | audio_clock/pll_49m152/pll/CLKOUT0
5.637 | 0.673 | tNET | RR | 1 | R41C68[0][B] | system/synth/u_polar0/tR3_13_s0/CLK
5.778 | 0.141 | tC2Q | RF | 2 | R41C68[0][B] | system/synth/u_polar0/tR3_13_s0/Q
5.940 | 0.162 | tNET | FF | 1 | BSRAM_R38[14][A] | system/synth/u_polar0/states_states_0_1_s/DI[9]

Data Required Path:

AT | DELAY | TYPE | RF | FANOUT | LOC | NODE
0.000 | 0.000 | | | | | active clock edge time
0.000 | 0.000 | | | | | audio_clock/pll_49m152/pll/CLKOUT0.default_gen_clk
4.964 | 4.964 | tCL | RR | 9528 | PLL_T[0] | audio_clock/pll_49m152/pll/CLKOUT0
5.834 | 0.870 | tNET | RR | 1 | BSRAM_R38[14][A] | system/synth/u_polar0/states_states_0_1_s/CLKA
5.871 | 0.037 | tHld | | 1 | BSRAM_R38[14][A] | system/synth/u_polar0/states_states_0_1_s

Path Statistics:

Clock Skew | 0.197
Hold Relationship | 0.000
Logic Level | 1
Arrival Clock Path Delay | cell: 0.000, 0.000%; route: 0.673, 100.000%
Arrival Data Path Delay | cell: 0.000, 0.000%; route: 0.162, 53.465%; tC2Q: 0.141, 46.535%
Required Clock Path Delay | cell: 0.000, 0.000%; route: 0.870, 100.000%

### Path5

Path Summary:

Slack | 0.073
Data Arrival Time | 5.944
Data Required Time | 5.871
From | system/synth/u_polar0/tR3_19_s0
To | system/synth/u_polar0/states_states_0_1_s
Launch Clk | audio_clock/pll_49m152/pll/CLKOUT0.default_gen_clk:[R]
Latch Clk | audio_clock/pll_49m152/pll/CLKOUT0.default_gen_clk:[R]

Data Arrival Path:

AT | DELAY | TYPE | RF | FANOUT | LOC | NODE
0.000 | 0.000 | | | | | active clock edge time
0.000 | 0.000 | | | | | audio_clock/pll_49m152/pll/CLKOUT0.default_gen_clk
4.964 | 4.964 | tCL | RR | 9528 | PLL_T[0] | audio_clock/pll_49m152/pll/CLKOUT0
5.641 | 0.677 | tNET | RR | 1 | R41C69[2][A] | system/synth/u_polar0/tR3_19_s0/CLK
5.782 | 0.141 | tC2Q | RF | 2 | R41C69[2][A] | system/synth/u_polar0/tR3_19_s0/Q
5.944 | 0.162 | tNET | FF | 1 | BSRAM_R38[14][A] | system/synth/u_polar0/states_states_0_1_s/DI[15]

Data Required Path:

AT | DELAY | TYPE | RF | FANOUT | LOC | NODE
0.000 | 0.000 | | | | | active clock edge time
0.000 | 0.000 | | | | | audio_clock/pll_49m152/pll/CLKOUT0.default_gen_clk
4.964 | 4.964 | tCL | RR | 9528 | PLL_T[0] | audio_clock/pll_49m152/pll/CLKOUT0
5.834 | 0.870 | tNET | RR | 1 | BSRAM_R38[14][A] | system/synth/u_polar0/states_states_0_1_s/CLKA
5.871 | 0.037 | tHld | | 1 | BSRAM_R38[14][A] | system/synth/u_polar0/states_states_0_1_s

Path Statistics:

Clock Skew | 0.193
Hold Relationship | 0.000
Logic Level | 1
Arrival Clock Path Delay | cell: 0.000, 0.000%; route: 0.677, 100.000%
Arrival Data Path Delay | cell: 0.000, 0.000%; route: 0.162, 53.465%; tC2Q: 0.141, 46.535%
Required Clock Path Delay | cell: 0.000, 0.000%; route: 0.870, 100.000%

### Path6

Path Summary:

Slack | 0.092
Data Arrival Time | 5.963
Data Required Time | 5.871
From | system/synth/u_polar0/tR3_4_s0
To | system/synth/u_polar0/states_states_0_1_s
Launch Clk | audio_clock/pll_49m152/pll/CLKOUT0.default_gen_clk:[R]
Latch Clk | audio_clock/pll_49m152/pll/CLKOUT0.default_gen_clk:[R]

Data Arrival Path:

AT | DELAY | TYPE | RF | FANOUT | LOC | NODE
0.000 | 0.000 | | | | | active clock edge time
0.000 | 0.000 | | | | | audio_clock/pll_49m152/pll/CLKOUT0.default_gen_clk
4.964 | 4.964 | tCL | RR | 9528 | PLL_T[0] | audio_clock/pll_49m152/pll/CLKOUT0
5.637 | 0.673 | tNET | RR | 1 | R41C68[0][A] | system/synth/u_polar0/tR3_4_s0/CLK
5.781 | 0.144 | tC2Q | RR | 2 | R41C68[0][A] | system/synth/u_polar0/tR3_4_s0/Q
5.963 | 0.182 | tNET | RR | 1 | BSRAM_R38[14][A] | system/synth/u_polar0/states_states_0_1_s/DI[0]

Data Required Path:

AT | DELAY | TYPE | RF | FANOUT | LOC | NODE
0.000 | 0.000 | | | | | active clock edge time
0.000 | 0.000 | | | | | audio_clock/pll_49m152/pll/CLKOUT0.default_gen_clk
4.964 | 4.964 | tCL | RR | 9528 | PLL_T[0] | audio_clock/pll_49m152/pll/CLKOUT0
5.834 | 0.870 | tNET | RR | 1 | BSRAM_R38[14][A] | system/synth/u_polar0/states_states_0_1_s/CLKA
5.871 | 0.037 | tHld | | 1 | BSRAM_R38[14][A] | system/synth/u_polar0/states_states_0_1_s

Path Statistics:

Clock Skew | 0.197
Hold Relationship | 0.000
Logic Level | 1
Arrival Clock Path Delay | cell: 0.000, 0.000%; route: 0.673, 100.000%
Arrival Data Path Delay | cell: 0.000, 0.000%; route: 0.182, 55.828%; tC2Q: 0.144, 44.172%
Required Clock Path Delay | cell: 0.000, 0.000%; route: 0.870, 100.000%

### Path7

Path Summary:

Slack | 0.094
Data Arrival Time | 5.965
Data Required Time | 5.871
From | system/synth/u_polar0/tR3_15_s0
To | system/synth/u_polar0/states_states_0_1_s
Launch Clk | audio_clock/pll_49m152/pll/CLKOUT0.default_gen_clk:[R]
Latch Clk | audio_clock/pll_49m152/pll/CLKOUT0.default_gen_clk:[R]

Data Arrival Path:

AT | DELAY | TYPE | RF | FANOUT | LOC | NODE
0.000 | 0.000 | | | | | active clock edge time
0.000 | 0.000 | | | | | audio_clock/pll_49m152/pll/CLKOUT0.default_gen_clk
4.964 | 4.964 | tCL | RR | 9528 | PLL_T[0] | audio_clock/pll_49m152/pll/CLKOUT0
5.637 | 0.673 | tNET | RR | 1 | R42C70[3][A] | system/synth/u_polar0/tR3_15_s0/CLK
5.781 | 0.144 | tC2Q | RR | 2 | R42C70[3][A] | system/synth/u_polar0/tR3_15_s0/Q
5.965 | 0.184 | tNET | RR | 1 | BSRAM_R38[14][A] | system/synth/u_polar0/states_states_0_1_s/DI[11]

Data Required Path:

AT | DELAY | TYPE | RF | FANOUT | LOC | NODE
0.000 | 0.000 | | | | | active clock edge time
0.000 | 0.000 | | | | | audio_clock/pll_49m152/pll/CLKOUT0.default_gen_clk
4.964 | 4.964 | tCL | RR | 9528 | PLL_T[0] | audio_clock/pll_49m152/pll/CLKOUT0
5.834 | 0.870 | tNET | RR | 1 | BSRAM_R38[14][A] | system/synth/u_polar0/states_states_0_1_s/CLKA
5.871 | 0.037 | tHld | | 1 | BSRAM_R38[14][A] | system/synth/u_polar0/states_states_0_1_s

Path Statistics:

Clock Skew | 0.197
Hold Relationship | 0.000
Logic Level | 1
Arrival Clock Path Delay | cell: 0.000, 0.000%; route: 0.673, 100.000%
Arrival Data Path Delay | cell: 0.000, 0.000%; route: 0.184, 56.098%; tC2Q: 0.144, 43.902%
Required Clock Path Delay | cell: 0.000, 0.000%; route: 0.870, 100.000%

### Path8

Path Summary:

Slack | 0.097
Data Arrival Time | 5.964
Data Required Time | 5.867
From | system/synth/u_polar0/addr3_6_s0
To | system/synth/u_polar0/states_states_0_2_s
Launch Clk | audio_clock/pll_49m152/pll/CLKOUT0.default_gen_clk:[R]
Latch Clk | audio_clock/pll_49m152/pll/CLKOUT0.default_gen_clk:[R]

Data Arrival Path:

AT | DELAY | TYPE | RF | FANOUT | LOC | NODE
0.000 | 0.000 | | | | | active clock edge time
0.000 | 0.000 | | | | | audio_clock/pll_49m152/pll/CLKOUT0.default_gen_clk
4.964 | 4.964 | tCL | RR | 9528 | PLL_T[0] | audio_clock/pll_49m152/pll/CLKOUT0
5.637 | 0.673 | tNET | RR | 1 | R44C70[1][A] | system/synth/u_polar0/addr3_6_s0/CLK
5.781 | 0.144 | tC2Q | RR | 12 | R44C70[1][A] | system/synth/u_polar0/addr3_6_s0/Q
5.964 | 0.183 | tNET | RR | 1 | BSRAM_R38[14][B] | system/synth/u_polar0/states_states_0_2_s/ADA[11]

Data Required Path:

AT | DELAY | TYPE | RF | FANOUT | LOC | NODE
0.000 | 0.000 | | | | | active clock edge time
0.000 | 0.000 | | | | | audio_clock/pll_49m152/pll/CLKOUT0.default_gen_clk
4.964 | 4.964 | tCL | RR | 9528 | PLL_T[0] | audio_clock/pll_49m152/pll/CLKOUT0
5.830 | 0.866 | tNET | RR | 1 | BSRAM_R38[14][B] | system/synth/u_polar0/states_states_0_2_s/CLKA
5.867 | 0.037 | tHld | | 1 | BSRAM_R38[14][B] | system/synth/u_polar0/states_states_0_2_s

Path Statistics:

Clock Skew | 0.193
Hold Relationship | 0.000
Logic Level | 1
Arrival Clock Path Delay | cell: 0.000, 0.000%; route: 0.673, 100.000%
Arrival Data Path Delay | cell: 0.000, 0.000%; route: 0.183, 55.963%; tC2Q: 0.144, 44.037%
Required Clock Path Delay | cell: 0.000, 0.000%; route: 0.866, 100.000%

### Path9

Path Summary:

Slack | 0.097
Data Arrival Time | 5.968
Data Required Time | 5.871
From | system/synth/u_polar0/tR3_21_s0
To | system/synth/u_polar0/states_states_0_1_s
Launch Clk | audio_clock/pll_49m152/pll/CLKOUT0.default_gen_clk:[R]
Latch Clk | audio_clock/pll_49m152/pll/CLKOUT0.default_gen_clk:[R]

Data Arrival Path:

AT | DELAY | TYPE | RF | FANOUT | LOC | NODE
0.000 | 0.000 | | | | | active clock edge time
0.000 | 0.000 | | | | | audio_clock/pll_49m152/pll/CLKOUT0.default_gen_clk
4.964 | 4.964 | tCL | RR | 9528 | PLL_T[0] | audio_clock/pll_49m152/pll/CLKOUT0
5.641 | 0.677 | tNET | RR | 1 | R41C69[2][B] | system/synth/u_polar0/tR3_21_s0/CLK
5.785 | 0.144 | tC2Q | RR | 2 | R41C69[2][B] | system/synth/u_polar0/tR3_21_s0/Q
5.968 | 0.183 | tNET | RR | 1 | BSRAM_R38[14][A] | system/synth/u_polar0/states_states_0_1_s/DI[17]

Data Required Path:

AT | DELAY | TYPE | RF | FANOUT | LOC | NODE
0.000 | 0.000 | | | | | active clock edge time
0.000 | 0.000 | | | | | audio_clock/pll_49m152/pll/CLKOUT0.default_gen_clk
4.964 | 4.964 | tCL | RR | 9528 | PLL_T[0] | audio_clock/pll_49m152/pll/CLKOUT0
5.834 | 0.870 | tNET | RR | 1 | BSRAM_R38[14][A] | system/synth/u_polar0/states_states_0_1_s/CLKA
5.871 | 0.037 | tHld | | 1 | BSRAM_R38[14][A] | system/synth/u_polar0/states_states_0_1_s

Path Statistics:

Clock Skew | 0.193
Hold Relationship | 0.000
Logic Level | 1
Arrival Clock Path Delay | cell: 0.000, 0.000%; route: 0.677, 100.000%
Arrival Data Path Delay | cell: 0.000, 0.000%; route: 0.183, 55.963%; tC2Q: 0.144, 44.037%
Required Clock Path Delay | cell: 0.000, 0.000%; route: 0.870, 100.000%

### Path10

Path Summary:

Slack | 0.102
Data Arrival Time | 5.969
Data Required Time | 5.867
From | system/synth/u_polar0/tL3_25_s0
To | system/synth/u_polar0/states_states_0_2_s
Launch Clk | audio_clock/pll_49m152/pll/CLKOUT0.default_gen_clk:[R]
Latch Clk | audio_clock/pll_49m152/pll/CLKOUT0.default_gen_clk:[R]

Data Arrival Path:

AT | DELAY | TYPE | RF | FANOUT | LOC | NODE
0.000 | 0.000 | | | | | active clock edge time
0.000 | 0.000 | | | | | audio_clock/pll_49m152/pll/CLKOUT0.default_gen_clk
4.964 | 4.964 | tCL | RR | 9528 | PLL_T[0] | audio_clock/pll_49m152/pll/CLKOUT0
5.637 | 0.673 | tNET | RR | 1 | R39C75[0][A] | system/synth/u_polar0/tL3_25_s0/CLK
5.778 | 0.141 | tC2Q | RF | 2 | R39C75[0][A] | system/synth/u_polar0/tL3_25_s0/Q
5.969 | 0.191 | tNET | FF | 1 | BSRAM_R38[14][B] | system/synth/u_polar0/states_states_0_2_s/DI[17]

Data Required Path:

AT | DELAY | TYPE | RF | FANOUT | LOC | NODE
0.000 | 0.000 | | | | | active clock edge time
0.000 | 0.000 | | | | | audio_clock/pll_49m152/pll/CLKOUT0.default_gen_clk
4.964 | 4.964 | tCL | RR | 9528 | PLL_T[0] | audio_clock/pll_49m152/pll/CLKOUT0
5.830 | 0.866 | tNET | RR | 1 | BSRAM_R38[14][B] | system/synth/u_polar0/states_states_0_2_s/CLKA
5.867 | 0.037 | tHld | | 1 | BSRAM_R38[14][B] | system/synth/u_polar0/states_states_0_2_s

Path Statistics:

Clock Skew | 0.193
Hold Relationship | 0.000
Logic Level | 1
Arrival Clock Path Delay | cell: 0.000, 0.000%; route: 0.673, 100.000%
Arrival Data Path Delay | cell: 0.000, 0.000%; route: 0.191, 57.530%; tC2Q: 0.141, 42.470%
Required Clock Path Delay | cell: 0.000, 0.000%; route: 0.866, 100.000%

### Path11

Path Summary:

Slack | 0.129
Data Arrival Time | 6.000
Data Required Time | 5.871
From | system/synth/u_polar0/addr3_7_s0
To | system/synth/u_polar0/states_states_0_1_s
Launch Clk | audio_clock/pll_49m152/pll/CLKOUT0.default_gen_clk:[R]
Latch Clk | audio_clock/pll_49m152/pll/CLKOUT0.default_gen_clk:[R]

Data Arrival Path:

AT | DELAY | TYPE | RF | FANOUT | LOC | NODE
0.000 | 0.000 | | | | | active clock edge time
0.000 | 0.000 | | | | | audio_clock/pll_49m152/pll/CLKOUT0.default_gen_clk
4.964 | 4.964 | tCL | RR | 9528 | PLL_T[0] | audio_clock/pll_49m152/pll/CLKOUT0
5.637 | 0.673 | tNET | RR | 1 | R42C70[1][A] | system/synth/u_polar0/addr3_7_s0/CLK
5.781 | 0.144 | tC2Q | RR | 12 | R42C70[1][A] | system/synth/u_polar0/addr3_7_s0/Q
6.000 | 0.219 | tNET | RR | 1 | BSRAM_R38[14][A] | system/synth/u_polar0/states_states_0_1_s/ADA[12]

Data Required Path:

AT | DELAY | TYPE | RF | FANOUT | LOC | NODE
0.000 | 0.000 | | | | | active clock edge time
0.000 | 0.000 | | | | | audio_clock/pll_49m152/pll/CLKOUT0.default_gen_clk
4.964 | 4.964 | tCL | RR | 9528 | PLL_T[0] | audio_clock/pll_49m152/pll/CLKOUT0
5.834 | 0.870 | tNET | RR | 1 | BSRAM_R38[14][A] | system/synth/u_polar0/states_states_0_1_s/CLKA
5.871 | 0.037 | tHld | | 1 | BSRAM_R38[14][A] | system/synth/u_polar0/states_states_0_1_s

Path Statistics:

Clock Skew | 0.197
Hold Relationship | 0.000
Logic Level | 1
Arrival Clock Path Delay | cell: 0.000, 0.000%; route: 0.673, 100.000%
Arrival Data Path Delay | cell: 0.000, 0.000%; route: 0.219, 60.331%; tC2Q: 0.144, 39.669%
Required Clock Path Delay | cell: 0.000, 0.000%; route: 0.870, 100.000%

### Path12

Path Summary:

Slack | 0.133
Data Arrival Time | 6.000
Data Required Time | 5.867
From | system/synth/u_polar0/addr3_7_s0
To | system/synth/u_polar0/states_states_0_2_s
Launch Clk | audio_clock/pll_49m152/pll/CLKOUT0.default_gen_clk:[R]
Latch Clk | audio_clock/pll_49m152/pll/CLKOUT0.default_gen_clk:[R]

Data Arrival Path:

AT | DELAY | TYPE | RF | FANOUT | LOC | NODE
0.000 | 0.000 | | | | | active clock edge time
0.000 | 0.000 | | | | | audio_clock/pll_49m152/pll/CLKOUT0.default_gen_clk
4.964 | 4.964 | tCL | RR | 9528 | PLL_T[0] | audio_clock/pll_49m152/pll/CLKOUT0
5.637 | 0.673 | tNET | RR | 1 | R42C70[1][A] | system/synth/u_polar0/addr3_7_s0/CLK
5.781 | 0.144 | tC2Q | RR | 12 | R42C70[1][A] | system/synth/u_polar0/addr3_7_s0/Q
6.000 | 0.219 | tNET | RR | 1 | BSRAM_R38[14][B] | system/synth/u_polar0/states_states_0_2_s/ADA[12]

Data Required Path:

AT | DELAY | TYPE | RF | FANOUT | LOC | NODE
0.000 | 0.000 | | | | | active clock edge time
0.000 | 0.000 | | | | | audio_clock/pll_49m152/pll/CLKOUT0.default_gen_clk
4.964 | 4.964 | tCL | RR | 9528 | PLL_T[0] | audio_clock/pll_49m152/pll/CLKOUT0
5.830 | 0.866 | tNET | RR | 1 | BSRAM_R38[14][B] | system/synth/u_polar0/states_states_0_2_s/CLKA
5.867 | 0.037 | tHld | | 1 | BSRAM_R38[14][B] | system/synth/u_polar0/states_states_0_2_s

Path Statistics:

Clock Skew | 0.193
Hold Relationship | 0.000
Logic Level | 1
Arrival Clock Path Delay | cell: 0.000, 0.000%; route: 0.673, 100.000%
Arrival Data Path Delay | cell: 0.000, 0.000%; route: 0.219, 60.331%; tC2Q: 0.144, 39.669%
Required Clock Path Delay | cell: 0.000, 0.000%; route: 0.866, 100.000%

### Path13

Path Summary:

Slack | 0.138
Data Arrival Time | 5.812
Data Required Time | 5.674
From | system/synth/u_polar0/end3_10_s0
To | system/synth/u_polar0/states_states_0_5_s
Launch Clk | audio_clock/pll_49m152/pll/CLKOUT0.default_gen_clk:[R]
Latch Clk | audio_clock/pll_49m152/pll/CLKOUT0.default_gen_clk:[R]

Data Arrival Path:

AT | DELAY | TYPE | RF | FANOUT | LOC | NODE
0.000 | 0.000 | | | | | active clock edge time
0.000 | 0.000 | | | | | audio_clock/pll_49m152/pll/CLKOUT0.default_gen_clk
4.964 | 4.964 | tCL | RR | 9528 | PLL_T[0] | audio_clock/pll_49m152/pll/CLKOUT0
5.637 | 0.673 | tNET | RR | 1 | R37C81[2][A] | system/synth/u_polar0/end3_10_s0/CLK
5.778 | 0.141 | tC2Q | RF | 1 | R37C81[2][A] | system/synth/u_polar0/end3_10_s0/Q
5.812 | 0.034 | tNET | FF | 1 | BSRAM_R38[16][B] | system/synth/u_polar0/states_states_0_5_s/DI[5]

Data Required Path:

AT | DELAY | TYPE | RF | FANOUT | LOC | NODE
0.000 | 0.000 | | | | | active clock edge time
0.000 | 0.000 | | | | | audio_clock/pll_49m152/pll/CLKOUT0.default_gen_clk
4.964 | 4.964 | tCL | RR | 9528 | PLL_T[0] | audio_clock/pll_49m152/pll/CLKOUT0
5.637 | 0.673 | tNET | RR | 1 | BSRAM_R38[16][B] | system/synth/u_polar0/states_states_0_5_s/CLKA
5.674 | 0.037 | tHld | | 1 | BSRAM_R38[16][B] | system/synth/u_polar0/states_states_0_5_s

Path Statistics:

Clock Skew | 0.000
Hold Relationship | 0.000
Logic Level | 1
Arrival Clock Path Delay | cell: 0.000, 0.000%; route: 0.673, 100.000%
Arrival Data Path Delay | cell: 0.000, 0.000%; route: 0.034, 19.429%; tC2Q: 0.141, 80.571%
Required Clock Path Delay | cell: 0.000, 0.000%; route: 0.673, 100.000%

### Path14

Path Summary:

Slack | 0.144
Data Arrival Time | 6.015
Data Required Time | 5.871
From | system/synth/u_polar0/tR3_18_s0
To | system/synth/u_polar0/states_states_0_1_s
Launch Clk | audio_clock/pll_49m152/pll/CLKOUT0.default_gen_clk:[R]
Latch Clk | audio_clock/pll_49m152/pll/CLKOUT0.default_gen_clk:[R]

Data Arrival Path:

AT | DELAY | TYPE | RF | FANOUT | LOC | NODE
0.000 | 0.000 | | | | | active clock edge time
0.000 | 0.000 | | | | | audio_clock/pll_49m152/pll/CLKOUT0.default_gen_clk
4.964 | 4.964 | tCL | RR | 9528 | PLL_T[0] | audio_clock/pll_49m152/pll/CLKOUT0
5.637 | 0.673 | tNET | RR | 1 | R41C68[3][A] | system/synth/u_polar0/tR3_18_s0/CLK
5.781 | 0.144 | tC2Q | RR | 2 | R41C68[3][A] | system/synth/u_polar0/tR3_18_s0/Q
6.015 | 0.234 | tNET | RR | 1 | BSRAM_R38[14][A] | system/synth/u_polar0/states_states_0_1_s/DI[14]

Data Required Path:

AT | DELAY | TYPE | RF | FANOUT | LOC | NODE
0.000 | 0.000 | | | | | active clock edge time
0.000 | 0.000 | | | | | audio_clock/pll_49m152/pll/CLKOUT0.default_gen_clk
4.964 | 4.964 | tCL | RR | 9528 | PLL_T[0] | audio_clock/pll_49m152/pll/CLKOUT0
5.834 | 0.870 | tNET | RR | 1 | BSRAM_R38[14][A] | system/synth/u_polar0/states_states_0_1_s/CLKA
5.871 | 0.037 | tHld | | 1 | BSRAM_R38[14][A] | system/synth/u_polar0/states_states_0_1_s

Path Statistics:

Clock Skew | 0.197
Hold Relationship | 0.000
Logic Level | 1
Arrival Clock Path Delay | cell: 0.000, 0.000%; route: 0.673, 100.000%
Arrival Data Path Delay | cell: 0.000, 0.000%; route: 0.234, 61.905%; tC2Q: 0.144, 38.095%
Required Clock Path Delay | cell: 0.000, 0.000%; route: 0.870, 100.000%

### Path15

Path Summary:

Slack | 0.146
Data Arrival Time | 6.013
Data Required Time | 5.867
From | system/synth/u_polar0/tL3_15_s0
To | system/synth/u_polar0/states_states_0_2_s
Launch Clk | audio_clock/pll_49m152/pll/CLKOUT0.default_gen_clk:[R]
Latch Clk | audio_clock/pll_49m152/pll/CLKOUT0.default_gen_clk:[R]

Data Arrival Path:

AT | DELAY | TYPE | RF | FANOUT | LOC | NODE
0.000 | 0.000 | | | | | active clock edge time
0.000 | 0.000 | | | | | audio_clock/pll_49m152/pll/CLKOUT0.default_gen_clk
4.964 | 4.964 | tCL | RR | 9528 | PLL_T[0] | audio_clock/pll_49m152/pll/CLKOUT0
5.637 | 0.673 | tNET | RR | 1 | R43C70[2][A] | system/synth/u_polar0/tL3_15_s0/CLK
5.781 | 0.144 | tC2Q | RR | 2 | R43C70[2][A] | system/synth/u_polar0/tL3_15_s0/Q
6.013 | 0.232 | tNET | RR | 1 | BSRAM_R38[14][B] | system/synth/u_polar0/states_states_0_2_s/DI[7]

Data Required Path:

AT | DELAY | TYPE | RF | FANOUT | LOC | NODE
0.000 | 0.000 | | | | | active clock edge time
0.000 | 0.000 | | | | | audio_clock/pll_49m152/pll/CLKOUT0.default_gen_clk
4.964 | 4.964 | tCL | RR | 9528 | PLL_T[0] | audio_clock/pll_49m152/pll/CLKOUT0
5.830 | 0.866 | tNET | RR | 1 | BSRAM_R38[14][B] | system/synth/u_polar0/states_states_0_2_s/CLKA
5.867 | 0.037 | tHld | | 1 | BSRAM_R38[14][B] | system/synth/u_polar0/states_states_0_2_s

Path Statistics:

Clock Skew | 0.193
Hold Relationship | 0.000
Logic Level | 1
Arrival Clock Path Delay | cell: 0.000, 0.000%; route: 0.673, 100.000%
Arrival Data Path Delay | cell: 0.000, 0.000%; route: 0.232, 61.702%; tC2Q: 0.144, 38.298%
Required Clock Path Delay | cell: 0.000, 0.000%; route: 0.866, 100.000%

### Path16

Path Summary:

Slack | 0.146
Data Arrival Time | 6.021
Data Required Time | 5.875
From | system/synth/u_polar0/addr3_7_s0
To | system/synth/u_polar0/states_states_0_0_s
Launch Clk | audio_clock/pll_49m152/pll/CLKOUT0.default_gen_clk:[R]
Latch Clk | audio_clock/pll_49m152/pll/CLKOUT0.default_gen_clk:[R]

Data Arrival Path:

AT | DELAY | TYPE | RF | FANOUT | LOC | NODE
0.000 | 0.000 | | | | | active clock edge time
0.000 | 0.000 | | | | | audio_clock/pll_49m152/pll/CLKOUT0.default_gen_clk
4.964 | 4.964 | tCL | RR | 9528 | PLL_T[0] | audio_clock/pll_49m152/pll/CLKOUT0
5.637 | 0.673 | tNET | RR | 1 | R42C70[1][A] | system/synth/u_polar0/addr3_7_s0/CLK
5.781 | 0.144 | tC2Q | RR | 12 | R42C70[1][A] | system/synth/u_polar0/addr3_7_s0/Q
6.021 | 0.240 | tNET | RR | 1 | BSRAM_R38[13] | system/synth/u_polar0/states_states_0_0_s/ADA[12]

Data Required Path:

AT | DELAY | TYPE | RF | FANOUT | LOC | NODE
0.000 | 0.000 | | | | | active clock edge time
0.000 | 0.000 | | | | | audio_clock/pll_49m152/pll/CLKOUT0.default_gen_clk
4.964 | 4.964 | tCL | RR | 9528 | PLL_T[0] | audio_clock/pll_49m152/pll/CLKOUT0
5.838 | 0.874 | tNET | RR | 1 | BSRAM_R38[13] | system/synth/u_polar0/states_states_0_0_s/CLKA
5.875 | 0.037 | tHld | | 1 | BSRAM_R38[13] | system/synth/u_polar0/states_states_0_0_s

Path Statistics:

Clock Skew | 0.201
Hold Relationship | 0.000
Logic Level | 1
Arrival Clock Path Delay | cell: 0.000, 0.000%; route: 0.673, 100.000%
Arrival Data Path Delay | cell: 0.000, 0.000%; route: 0.240, 62.500%; tC2Q: 0.144, 37.500%
Required Clock Path Delay | cell: 0.000, 0.000%; route: 0.874, 100.000%

### Path17

Path Summary:

Slack | 0.150
Data Arrival Time | 6.017
Data Required Time | 5.867
From | system/synth/u_polar0/tL3_11_s0
To | system/synth/u_polar0/states_states_0_2_s
Launch Clk | audio_clock/pll_49m152/pll/CLKOUT0.default_gen_clk:[R]
Latch Clk | audio_clock/pll_49m152/pll/CLKOUT0.default_gen_clk:[R]

Data Arrival Path:

AT | DELAY | TYPE | RF | FANOUT | LOC | NODE
0.000 | 0.000 | | | | | active clock edge time
0.000 | 0.000 | | | | | audio_clock/pll_49m152/pll/CLKOUT0.default_gen_clk
4.964 | 4.964 | tCL | RR | 9528 | PLL_T[0] | audio_clock/pll_49m152/pll/CLKOUT0
5.641 | 0.677 | tNET | RR | 1 | R43C69[0][B] | system/synth/u_polar0/tL3_11_s0/CLK
5.785 | 0.144 | tC2Q | RR | 2 | R43C69[0][B] | system/synth/u_polar0/tL3_11_s0/Q
6.017 | 0.232 | tNET | RR | 1 | BSRAM_R38[14][B] | system/synth/u_polar0/states_states_0_2_s/DI[3]

Data Required Path:

AT | DELAY | TYPE | RF | FANOUT | LOC | NODE
0.000 | 0.000 | | | | | active clock edge time
0.000 | 0.000 | | | | | audio_clock/pll_49m152/pll/CLKOUT0.default_gen_clk
4.964 | 4.964 | tCL | RR | 9528 | PLL_T[0] | audio_clock/pll_49m152/pll/CLKOUT0
5.830 | 0.866 | tNET | RR | 1 | BSRAM_R38[14][B] | system/synth/u_polar0/states_states_0_2_s/CLKA
5.867 | 0.037 | tHld | | 1 | BSRAM_R38[14][B] | system/synth/u_polar0/states_states_0_2_s

Path Statistics:

Clock Skew | 0.189
Hold Relationship | 0.000
Logic Level | 1
Arrival Clock Path Delay | cell: 0.000, 0.000%; route: 0.677, 100.000%
Arrival Data Path Delay | cell: 0.000, 0.000%; route: 0.232, 61.702%; tC2Q: 0.144, 38.298%
Required Clock Path Delay | cell: 0.000, 0.000%; route: 0.866, 100.000%

### Path18

Path Summary:

Slack | 0.152
Data Arrival Time | 6.023
Data Required Time | 5.871
From | system/synth/u_polar0/addr3_6_s0
To | system/synth/u_polar0/states_states_0_1_s
Launch Clk | audio_clock/pll_49m152/pll/CLKOUT0.default_gen_clk:[R]
Latch Clk | audio_clock/pll_49m152/pll/CLKOUT0.default_gen_clk:[R]

Data Arrival Path:

AT | DELAY | TYPE | RF | FANOUT | LOC | NODE
0.000 | 0.000 | | | | | active clock edge time
0.000 | 0.000 | | | | | audio_clock/pll_49m152/pll/CLKOUT0.default_gen_clk
4.964 | 4.964 | tCL | RR | 9528 | PLL_T[0] | audio_clock/pll_49m152/pll/CLKOUT0
5.637 | 0.673 | tNET | RR | 1 | R44C70[1][A] | system/synth/u_polar0/addr3_6_s0/CLK
5.781 | 0.144 | tC2Q | RR | 12 | R44C70[1][A] | system/synth/u_polar0/addr3_6_s0/Q
6.023 | 0.242 | tNET | RR | 1 | BSRAM_R38[14][A] | system/synth/u_polar0/states_states_0_1_s/ADA[11]

Data Required Path:

AT | DELAY | TYPE | RF | FANOUT | LOC | NODE
0.000 | 0.000 | | | | | active clock edge time
0.000 | 0.000 | | | | | audio_clock/pll_49m152/pll/CLKOUT0.default_gen_clk
4.964 | 4.964 | tCL | RR | 9528 | PLL_T[0] | audio_clock/pll_49m152/pll/CLKOUT0
5.834 | 0.870 | tNET | RR | 1 | BSRAM_R38[14][A] | system/synth/u_polar0/states_states_0_1_s/CLKA
5.871 | 0.037 | tHld | | 1 | BSRAM_R38[14][A] | system/synth/u_polar0/states_states_0_1_s

Path Statistics:

Clock Skew | 0.197
Hold Relationship | 0.000
Logic Level | 1
Arrival Clock Path Delay | cell: 0.000, 0.000%; route: 0.673, 100.000%
Arrival Data Path Delay | cell: 0.000, 0.000%; route: 0.242, 62.694%; tC2Q: 0.144, 37.306%
Required Clock Path Delay | cell: 0.000, 0.000%; route: 0.870, 100.000%

### Path19

Path Summary:

Slack | 0.153
Data Arrival Time | 5.972
Data Required Time | 5.819
From | system/synth/u_polar0/v_3_s0
To | system/synth/u_polar0/states_states_0_1_s
Launch Clk | audio_clock/pll_49m152/pll/CLKOUT0.default_gen_clk:[R]
Latch Clk | audio_clock/pll_49m152/pll/CLKOUT0.default_gen_clk:[R]

Data Arrival Path:

AT | DELAY | TYPE | RF | FANOUT | LOC | NODE
0.000 | 0.000 | | | | | active clock edge time
0.000 | 0.000 | | | | | audio_clock/pll_49m152/pll/CLKOUT0.default_gen_clk
4.964 | 4.964 | tCL | RR | 9528 | PLL_T[0] | audio_clock/pll_49m152/pll/CLKOUT0
5.637 | 0.673 | tNET | RR | 1 | R44C68[0][B] | system/synth/u_polar0/v_3_s0/CLK
5.781 | 0.144 | tC2Q | RR | 90 | R44C68[0][B] | system/synth/u_polar0/v_3_s0/Q
5.972 | 0.191 | tNET | RR | 1 | BSRAM_R38[14][A] | system/synth/u_polar0/states_states_0_1_s/CEA

Data Required Path:

AT | DELAY | TYPE | RF | FANOUT | LOC | NODE
0.000 | 0.000 | | | | | active clock edge time
0.000 | 0.000 | | | | | audio_clock/pll_49m152/pll/CLKOUT0.default_gen_clk
4.964 | 4.964 | tCL | RR | 9528 | PLL_T[0] | audio_clock/pll_49m152/pll/CLKOUT0
5.834 | 0.870 | tNET | RR | 1 | BSRAM_R38[14][A] | system/synth/u_polar0/states_states_0_1_s/CLKA
5.819 | -0.015 | tHld | | 1 | BSRAM_R38[14][A] | system/synth/u_polar0/states_states_0_1_s

Path Statistics:

Clock Skew | 0.197
Hold Relationship | 0.000
Logic Level | 1
Arrival Clock Path Delay | cell: 0.000, 0.000%; route: 0.673, 100.000%
Arrival Data Path Delay | cell: 0.000, 0.000%; route: 0.191, 57.015%; tC2Q: 0.144, 42.985%
Required Clock Path Delay | cell: 0.000, 0.000%; route: 0.870, 100.000%

### Path20

Path Summary:

Slack | 0.158
Data Arrival Time | 6.029
Data Required Time | 5.871
From | system/synth/u_polar0/tR3_5_s0
To | system/synth/u_polar0/states_states_0_1_s
Launch Clk | audio_clock/pll_49m152/pll/CLKOUT0.default_gen_clk:[R]
Latch Clk | audio_clock/pll_49m152/pll/CLKOUT0.default_gen_clk:[R]

Data Arrival Path:

AT | DELAY | TYPE | RF | FANOUT | LOC | NODE
0.000 | 0.000 | | | | | active clock edge time
0.000 | 0.000 | | | | | audio_clock/pll_49m152/pll/CLKOUT0.default_gen_clk
4.964 | 4.964 | tCL | RR | 9528 | PLL_T[0] | audio_clock/pll_49m152/pll/CLKOUT0
5.633 | 0.669 | tNET | RR | 1 | R39C67[3][A] | system/synth/u_polar0/tR3_5_s0/CLK
5.774 | 0.141 | tC2Q | RF | 2 | R39C67[3][A] | system/synth/u_polar0/tR3_5_s0/Q
6.029 | 0.255 | tNET | FF | 1 | BSRAM_R38[14][A] | system/synth/u_polar0/states_states_0_1_s/DI[1]

Data Required Path:

AT | DELAY | TYPE | RF | FANOUT | LOC | NODE
0.000 | 0.000 | | | | | active clock edge time
0.000 | 0.000 | | | | | audio_clock/pll_49m152/pll/CLKOUT0.default_gen_clk
4.964 | 4.964 | tCL | RR | 9528 | PLL_T[0] | audio_clock/pll_49m152/pll/CLKOUT0
5.834 | 0.870 | tNET | RR | 1 | BSRAM_R38[14][A] | system/synth/u_polar0/states_states_0_1_s/CLKA
5.871 | 0.037 | tHld | | 1 | BSRAM_R38[14][A] | system/synth/u_polar0/states_states_0_1_s

Path Statistics:

Clock Skew | 0.201
Hold Relationship | 0.000
Logic Level | 1
Arrival Clock Path Delay | cell: 0.000, 0.000%; route: 0.669, 100.000%
Arrival Data Path Delay | cell: 0.000, 0.000%; route: 0.255, 64.394%; tC2Q: 0.141, 35.606%
Required Clock Path Delay | cell: 0.000, 0.000%; route: 0.870, 100.000%

### Path21

Path Summary:

Slack | 0.162
Data Arrival Time | 6.029
Data Required Time | 5.867
From | system/synth/u_polar0/tL3_23_s0
To | system/synth/u_polar0/states_states_0_2_s
Launch Clk | audio_clock/pll_49m152/pll/CLKOUT0.default_gen_clk:[R]
Latch Clk | audio_clock/pll_49m152/pll/CLKOUT0.default_gen_clk:[R]

Data Arrival Path:

AT | DELAY | TYPE | RF | FANOUT | LOC | NODE
0.000 | 0.000 | | | | | active clock edge time
0.000 | 0.000 | | | | | audio_clock/pll_49m152/pll/CLKOUT0.default_gen_clk
4.964 | 4.964 | tCL | RR | 9528 | PLL_T[0] | audio_clock/pll_49m152/pll/CLKOUT0
5.637 | 0.673 | tNET | RR | 1 | R42C72[3][A] | system/synth/u_polar0/tL3_23_s0/CLK
5.778 | 0.141 | tC2Q | RF | 2 | R42C72[3][A] | system/synth/u_polar0/tL3_23_s0/Q
6.029 | 0.251 | tNET | FF | 1 | BSRAM_R38[14][B] | system/synth/u_polar0/states_states_0_2_s/DI[15]

Data Required Path:

AT | DELAY | TYPE | RF | FANOUT | LOC | NODE
0.000 | 0.000 | | | | | active clock edge time
0.000 | 0.000 | | | | | audio_clock/pll_49m152/pll/CLKOUT0.default_gen_clk
4.964 | 4.964 | tCL | RR | 9528 | PLL_T[0] | audio_clock/pll_49m152/pll/CLKOUT0
5.830 | 0.866 | tNET | RR | 1 | BSRAM_R38[14][B] | system/synth/u_polar0/states_states_0_2_s/CLKA
5.867 | 0.037 | tHld | | 1 | BSRAM_R38[14][B] | system/synth/u_polar0/states_states_0_2_s

Path Statistics:

Clock Skew | 0.193
Hold Relationship | 0.000
Logic Level | 1
Arrival Clock Path Delay | cell: 0.000, 0.000%; route: 0.673, 100.000%
Arrival Data Path Delay | cell: 0.000, 0.000%; route: 0.251, 64.031%; tC2Q: 0.141, 35.969%
Required Clock Path Delay | cell: 0.000, 0.000%; route: 0.866, 100.000%

### Path22

Path Summary:

Slack | 0.162
Data Arrival Time | 6.029
Data Required Time | 5.867
From | system/synth/u_polar0/tL3_12_s0
To | system/synth/u_polar0/states_states_0_2_s
Launch Clk | audio_clock/pll_49m152/pll/CLKOUT0.default_gen_clk:[R]
Latch Clk | audio_clock/pll_49m152/pll/CLKOUT0.default_gen_clk:[R]

Data Arrival Path:

AT | DELAY | TYPE | RF | FANOUT | LOC | NODE
0.000 | 0.000 | | | | | active clock edge time
0.000 | 0.000 | | | | | audio_clock/pll_49m152/pll/CLKOUT0.default_gen_clk
4.964 | 4.964 | tCL | RR | 9528 | PLL_T[0] | audio_clock/pll_49m152/pll/CLKOUT0
5.633 | 0.669 | tNET | RR | 1 | R42C71[0][A] | system/synth/u_polar0/tL3_12_s0/CLK
5.774 | 0.141 | tC2Q | RF | 2 | R42C71[0][A] | system/synth/u_polar0/tL3_12_s0/Q
6.029 | 0.255 | tNET | FF | 1 | BSRAM_R38[14][B] | system/synth/u_polar0/states_states_0_2_s/DI[4]

Data Required Path:

AT | DELAY | TYPE | RF | FANOUT | LOC | NODE
0.000 | 0.000 | | | | | active clock edge time
0.000 | 0.000 | | | | | audio_clock/pll_49m152/pll/CLKOUT0.default_gen_clk
4.964 | 4.964 | tCL | RR | 9528 | PLL_T[0] | audio_clock/pll_49m152/pll/CLKOUT0
5.830 | 0.866 | tNET | RR | 1 | BSRAM_R38[14][B] | system/synth/u_polar0/states_states_0_2_s/CLKA
5.867 | 0.037 | tHld | | 1 | BSRAM_R38[14][B] | system/synth/u_polar0/states_states_0_2_s

Path Statistics:

Clock Skew | 0.197
Hold Relationship | 0.000
Logic Level | 1
Arrival Clock Path Delay | cell: 0.000, 0.000%; route: 0.669, 100.000%
Arrival Data Path Delay | cell: 0.000, 0.000%; route: 0.255, 64.394%; tC2Q: 0.141, 35.606%
Required Clock Path Delay | cell: 0.000, 0.000%; route: 0.866, 100.000%

### Path23

Path Summary:

Slack | 0.162
Data Arrival Time | 6.033
Data Required Time | 5.871
From | system/synth/u_polar0/tR3_10_s0
To | system/synth/u_polar0/states_states_0_1_s
Launch Clk | audio_clock/pll_49m152/pll/CLKOUT0.default_gen_clk:[R]
Latch Clk | audio_clock/pll_49m152/pll/CLKOUT0.default_gen_clk:[R]

Data Arrival Path:

AT | DELAY | TYPE | RF | FANOUT | LOC | NODE
0.000 | 0.000 | | | | | active clock edge time
0.000 | 0.000 | | | | | audio_clock/pll_49m152/pll/CLKOUT0.default_gen_clk
4.964 | 4.964 | tCL | RR | 9528 | PLL_T[0] | audio_clock/pll_49m152/pll/CLKOUT0
5.637 | 0.673 | tNET | RR | 1 | R40C66[2][A] | system/synth/u_polar0/tR3_10_s0/CLK
5.778 | 0.141 | tC2Q | RF | 2 | R40C66[2][A] | system/synth/u_polar0/tR3_10_s0/Q
6.033 | 0.255 | tNET | FF | 1 | BSRAM_R38[14][A] | system/synth/u_polar0/states_states_0_1_s/DI[6]

Data Required Path:

AT | DELAY | TYPE | RF | FANOUT | LOC | NODE
0.000 | 0.000 | | | | | active clock edge time
0.000 | 0.000 | | | | | audio_clock/pll_49m152/pll/CLKOUT0.default_gen_clk
4.964 | 4.964 | tCL | RR | 9528 | PLL_T[0] | audio_clock/pll_49m152/pll/CLKOUT0
5.834 | 0.870 | tNET | RR | 1 | BSRAM_R38[14][A] | system/synth/u_polar0/states_states_0_1_s/CLKA
5.871 | 0.037 | tHld | | 1 | BSRAM_R38[14][A] | system/synth/u_polar0/states_states_0_1_s

Path Statistics:

Clock Skew | 0.197
Hold Relationship | 0.000
Logic Level | 1
Arrival Clock Path Delay | cell: 0.000, 0.000%; route: 0.673, 100.000%
Arrival Data Path Delay | cell: 0.000, 0.000%; route: 0.255, 64.394%; tC2Q: 0.141, 35.606%
Required Clock Path Delay | cell: 0.000, 0.000%; route: 0.870, 100.000%

### Path24

Path Summary:

Slack | 0.162
Data Arrival Time | 6.033
Data Required Time | 5.871
From | system/synth/u_polar0/tR3_9_s0
To | system/synth/u_polar0/states_states_0_1_s
Launch Clk | audio_clock/pll_49m152/pll/CLKOUT0.default_gen_clk:[R]
Latch Clk | audio_clock/pll_49m152/pll/CLKOUT0.default_gen_clk:[R]

Data Arrival Path:

AT | DELAY | TYPE | RF | FANOUT | LOC | NODE
0.000 | 0.000 | | | | | active clock edge time
0.000 | 0.000 | | | | | audio_clock/pll_49m152/pll/CLKOUT0.default_gen_clk
4.964 | 4.964 | tCL | RR | 9528 | PLL_T[0] | audio_clock/pll_49m152/pll/CLKOUT0
5.637 | 0.673 | tNET | RR | 1 | R40C66[1][B] | system/synth/u_polar0/tR3_9_s0/CLK
5.778 | 0.141 | tC2Q | RF | 2 | R40C66[1][B] | system/synth/u_polar0/tR3_9_s0/Q
6.033 | 0.255 | tNET | FF | 1 | BSRAM_R38[14][A] | system/synth/u_polar0/states_states_0_1_s/DI[5]

Data Required Path:

AT | DELAY | TYPE | RF | FANOUT | LOC | NODE
0.000 | 0.000 | | | | | active clock edge time
0.000 | 0.000 | | | | | audio_clock/pll_49m152/pll/CLKOUT0.default_gen_clk
4.964 | 4.964 | tCL | RR | 9528 | PLL_T[0] | audio_clock/pll_49m152/pll/CLKOUT0
5.834 | 0.870 | tNET | RR | 1 | BSRAM_R38[14][A] | system/synth/u_polar0/states_states_0_1_s/CLKA
5.871 | 0.037 | tHld | | 1 | BSRAM_R38[14][A] | system/synth/u_polar0/states_states_0_1_s

Path Statistics:

Clock Skew | 0.197
Hold Relationship | 0.000
Logic Level | 1
Arrival Clock Path Delay | cell: 0.000, 0.000%; route: 0.673, 100.000%
Arrival Data Path Delay | cell: 0.000, 0.000%; route: 0.255, 64.394%; tC2Q: 0.141, 35.606%
Required Clock Path Delay | cell: 0.000, 0.000%; route: 0.870, 100.000%

### Path25

Path Summary:

Slack | 0.170
Data Arrival Time | 2.255
Data Required Time | 2.086
From | video_clock/init/rRomAddr_5_s1
To | video_clock/init/rRomDReg_0_s4
Launch Clk | sys_clk:[R]
Latch Clk | sys_clk:[R]

Data Arrival Path:

AT | DELAY | TYPE | RF | FANOUT | LOC | NODE
0.000 | 0.000 | | | | | active clock edge time
0.000 | 0.000 | | | | | sys_clk
0.000 | 0.000 | tCL | RR | 1 | IOB117[B] | sys_clk_ibuf/I
0.675 | 0.675 | tINS | RR | 513 | IOB117[B] | sys_clk_ibuf/O
2.054 | 1.379 | tNET | RR | 1 | R39C138[1][B] | video_clock/init/rRomAddr_5_s1/CLK
2.195 | 0.141 | tC2Q | RF | 2 | R39C138[1][B] | video_clock/init/rRomAddr_5_s1/Q
2.255 | 0.060 | tNET | FF | 1 | BSRAM_R38[29][A] | video_clock/init/rRomDReg_0_s4/AD[10]

Data Required Path:

AT | DELAY | TYPE | RF | FANOUT | LOC | NODE
0.000 | 0.000 | | | | | active clock edge time
0.000 | 0.000 | | | | | sys_clk
0.000 | 0.000 | tCL | RR | 1 | IOB117[B] | sys_clk_ibuf/I
0.675 | 0.675 | tINS | RR | 513 | IOB117[B] | sys_clk_ibuf/O
2.050 | 1.375 | tNET | RR | 1 | BSRAM_R38[29][A] | video_clock/init/rRomDReg_0_s4/CLK
2.086 | 0.035 | tHld | | 1 | BSRAM_R38[29][A] | video_clock/init/rRomDReg_0_s4

Path Statistics:

Clock Skew | -0.004
Hold Relationship | 0.000
Logic Level | 1
Arrival Clock Path Delay | cell: 0.675, 32.879%; route: 1.379, 67.121%
Arrival Data Path Delay | cell: 0.000, 0.000%; route: 0.060, 29.851%; tC2Q: 0.141, 70.149%
Required Clock Path Delay | cell: 0.675, 32.943%; route: 1.375, 67.057%

### Recovery Analysis Report

#### Report Command:report_timing -recovery -max_paths 25 -max_common_paths 1

### Path1

Path Summary:

Slack | 8.207
Data Arrival Time | 18.640
Data Required Time | 26.847
From | ready_sync_s0
To | system/synth/u_polar1/n25821_0_s
Launch Clk | audio_clock/pll_49m152/pll/CLKOUT0.default_gen_clk:[R]
Latch Clk | audio_clock/pll_49m152/pll/CLKOUT0.default_gen_clk:[R]

Data Arrival Path:

AT | DELAY | TYPE | RF | FANOUT | LOC | NODE
0.000 | 0.000 | | | | | active clock edge time
0.000 | 0.000 | | | | | audio_clock/pll_49m152/pll/CLKOUT0.default_gen_clk
4.964 | 4.964 | tCL | RR | 9528 | PLL_T[0] | audio_clock/pll_49m152/pll/CLKOUT0
7.063 | 2.099 | tNET | RR | 1 | R43C141[2][B] | ready_sync_s0/CLK
7.431 | 0.368 | tC2Q | RF | 11 | R43C141[2][B] | ready_sync_s0/Q
8.618 | 1.187 | tNET | FF | 1 | R24C123[0][A] | rst_n_s0/I1
9.079 | 0.461 | tINS | FR | 463 | R24C123[0][A] | rst_n_s0/F
10.101 | 1.021 | tNET | RR | 1 | R27C109[3][B] | system/audio_rst_n_s1/I3
10.598 | 0.498 | tINS | RR | 3143 | R27C109[3][B] | system/audio_rst_n_s1/F
13.909 | 3.311 | tNET | RR | 1 | R21C96[1][B] | system/events/mem[0]_ER_init_s2/I0
14.299 | 0.390 | tINS | RF | 13 | R21C96[1][B] | system/events/mem[0]_ER_init_s2/F
18.640 | 4.341 | tNET | FF | 1 | DSP_R65[19] | system/synth/u_polar1/n25821_0_s/RESET[0]

Data Required Path:

AT | DELAY | TYPE | RF | FANOUT | LOC | NODE
20.345 | 20.345 | | | | | active clock edge time
20.345 | 0.000 | | | | | audio_clock/pll_49m152/pll/CLKOUT0.default_gen_clk
25.309 | 4.964 | tCL | RR | 9528 | PLL_T[0] | audio_clock/pll_49m152/pll/CLKOUT0
27.408 | 2.099 | tNET | RR | 1 | DSP_R65[19] | system/synth/u_polar1/n25821_0_s/CLK[0]
26.847 | -0.561 | tSu | | 1 | DSP_R65[19] | system/synth/u_polar1/n25821_0_s

Path Statistics:

Clock Skew | 0.000
Setup Relationship | 20.345
Logic Level | 4
Arrival Clock Path Delay | cell: 0.000, 0.000%; route: 2.099, 100.000%
Arrival Data Path Delay | cell: 1.349, 11.650%; route: 9.861, 85.175%; tC2Q: 0.368, 3.174%
Required Clock Path Delay | cell: 0.000, 0.000%; route: 2.099, 100.000%

### Path2

Path Summary:

Slack | 9.115
Data Arrival Time | 17.741
Data Required Time | 26.857
From | ready_sync_s0
To | system/synth/u_polar1/n25822_0_s
Launch Clk | audio_clock/pll_49m152/pll/CLKOUT0.default_gen_clk:[R]
Latch Clk | audio_clock/pll_49m152/pll/CLKOUT0.default_gen_clk:[R]

Data Arrival Path:

AT | DELAY | TYPE | RF | FANOUT | LOC | NODE
0.000 | 0.000 | | | | | active clock edge time
0.000 | 0.000 | | | | | audio_clock/pll_49m152/pll/CLKOUT0.default_gen_clk
4.964 | 4.964 | tCL | RR | 9528 | PLL_T[0] | audio_clock/pll_49m152/pll/CLKOUT0
7.063 | 2.099 | tNET | RR | 1 | R43C141[2][B] | ready_sync_s0/CLK
7.431 | 0.368 | tC2Q | RF | 11 | R43C141[2][B] | ready_sync_s0/Q
8.618 | 1.187 | tNET | FF | 1 | R24C123[0][A] | rst_n_s0/I1
9.079 | 0.461 | tINS | FR | 463 | R24C123[0][A] | rst_n_s0/F
10.101 | 1.021 | tNET | RR | 1 | R27C109[3][B] | system/audio_rst_n_s1/I3
10.598 | 0.498 | tINS | RR | 3143 | R27C109[3][B] | system/audio_rst_n_s1/F
13.909 | 3.311 | tNET | RR | 1 | R21C96[1][B] | system/events/mem[0]_ER_init_s2/I0
14.299 | 0.390 | tINS | RF | 13 | R21C96[1][B] | system/events/mem[0]_ER_init_s2/F
17.741 | 3.442 | tNET | FF | 1 | DSP_R65[21] | system/synth/u_polar1/n25822_0_s/RESET[0]

Data Required Path:

AT | DELAY | TYPE | RF | FANOUT | LOC | NODE
20.345 | 20.345 | | | | | active clock edge time
20.345 | 0.000 | | | | | audio_clock/pll_49m152/pll/CLKOUT0.default_gen_clk
25.309 | 4.964 | tCL | RR | 9528 | PLL_T[0] | audio_clock/pll_49m152/pll/CLKOUT0
27.417 | 2.109 | tNET | RR | 1 | DSP_R65[21] | system/synth/u_polar1/n25822_0_s/CLK[0]
26.857 | -0.561 | tSu | | 1 | DSP_R65[21] | system/synth/u_polar1/n25822_0_s

Path Statistics:

Clock Skew | 0.009
Setup Relationship | 20.345
Logic Level | 4
Arrival Clock Path Delay | cell: 0.000, 0.000%; route: 2.099, 100.000%
Arrival Data Path Delay | cell: 1.349, 12.631%; route: 8.962, 83.927%; tC2Q: 0.368, 3.442%
Required Clock Path Delay | cell: 0.000, 0.000%; route: 2.109, 100.000%

### Path3

Path Summary:

Slack | 9.923
Data Arrival Time | 16.924
Data Required Time | 26.847
From | ready_sync_s0
To | system/synth/n3266_s
Launch Clk | audio_clock/pll_49m152/pll/CLKOUT0.default_gen_clk:[R]
Latch Clk | audio_clock/pll_49m152/pll/CLKOUT0.default_gen_clk:[R]

Data Arrival Path:

AT | DELAY | TYPE | RF | FANOUT | LOC | NODE
0.000 | 0.000 | | | | | active clock edge time
0.000 | 0.000 | | | | | audio_clock/pll_49m152/pll/CLKOUT0.default_gen_clk
4.964 | 4.964 | tCL | RR | 9528 | PLL_T[0] | audio_clock/pll_49m152/pll/CLKOUT0
7.063 | 2.099 | tNET | RR | 1 | R43C141[2][B] | ready_sync_s0/CLK
7.431 | 0.368 | tC2Q | RF | 11 | R43C141[2][B] | ready_sync_s0/Q
8.618 | 1.187 | tNET | FF | 1 | R24C123[0][A] | rst_n_s0/I1
9.079 | 0.461 | tINS | FR | 463 | R24C123[0][A] | rst_n_s0/F
10.101 | 1.021 | tNET | RR | 1 | R27C109[3][B] | system/audio_rst_n_s1/I3
10.598 | 0.498 | tINS | RR | 3143 | R27C109[3][B] | system/audio_rst_n_s1/F
13.909 | 3.311 | tNET | RR | 1 | R21C96[1][B] | system/events/mem[0]_ER_init_s2/I0
14.299 | 0.390 | tINS | RF | 13 | R21C96[1][B] | system/events/mem[0]_ER_init_s2/F
16.924 | 2.625 | tNET | FF | 1 | DSP_R65[25] | system/synth/n3266_s/RESET[0]

Data Required Path:

AT | DELAY | TYPE | RF | FANOUT | LOC | NODE
20.345 | 20.345 | | | | | active clock edge time
20.345 | 0.000 | | | | | audio_clock/pll_49m152/pll/CLKOUT0.default_gen_clk
25.309 | 4.964 | tCL | RR | 9528 | PLL_T[0] | audio_clock/pll_49m152/pll/CLKOUT0
27.408 | 2.099 | tNET | RR | 1 | DSP_R65[25] | system/synth/n3266_s/CLK[0]
26.847 | -0.561 | tSu | | 1 | DSP_R65[25] | system/synth/n3266_s

Path Statistics:

Clock Skew | 0.000
Setup Relationship | 20.345
Logic Level | 4
Arrival Clock Path Delay | cell: 0.000, 0.000%; route: 2.099, 100.000%
Arrival Data Path Delay | cell: 1.349, 13.678%; route: 8.144, 82.595%; tC2Q: 0.368, 3.727%
Required Clock Path Delay | cell: 0.000, 0.000%; route: 2.099, 100.000%

### Path4

Path Summary:

Slack | 10.077
Data Arrival Time | 16.780
Data Required Time | 26.857
From | ready_sync_s0
To | system/synth/n3387_s
Launch Clk | audio_clock/pll_49m152/pll/CLKOUT0.default_gen_clk:[R]
Latch Clk | audio_clock/pll_49m152/pll/CLKOUT0.default_gen_clk:[R]

Data Arrival Path:

AT | DELAY | TYPE | RF | FANOUT | LOC | NODE
0.000 | 0.000 | | | | | active clock edge time
0.000 | 0.000 | | | | | audio_clock/pll_49m152/pll/CLKOUT0.default_gen_clk
4.964 | 4.964 | tCL | RR | 9528 | PLL_T[0] | audio_clock/pll_49m152/pll/CLKOUT0
7.063 | 2.099 | tNET | RR | 1 | R43C141[2][B] | ready_sync_s0/CLK
7.431 | 0.368 | tC2Q | RF | 11 | R43C141[2][B] | ready_sync_s0/Q
8.618 | 1.187 | tNET | FF | 1 | R24C123[0][A] | rst_n_s0/I1
9.079 | 0.461 | tINS | FR | 463 | R24C123[0][A] | rst_n_s0/F
10.101 | 1.021 | tNET | RR | 1 | R27C109[3][B] | system/audio_rst_n_s1/I3
10.598 | 0.498 | tINS | RR | 3143 | R27C109[3][B] | system/audio_rst_n_s1/F
13.909 | 3.311 | tNET | RR | 1 | R21C96[1][B] | system/events/mem[0]_ER_init_s2/I0
14.299 | 0.390 | tINS | RF | 13 | R21C96[1][B] | system/events/mem[0]_ER_init_s2/F
16.780 | 2.481 | tNET | FF | 1 | DSP_R65[26] | system/synth/n3387_s/RESET[0]

Data Required Path:

AT | DELAY | TYPE | RF | FANOUT | LOC | NODE
20.345 | 20.345 | | | | | active clock edge time
20.345 | 0.000 | | | | | audio_clock/pll_49m152/pll/CLKOUT0.default_gen_clk
25.309 | 4.964 | tCL | RR | 9528 | PLL_T[0] | audio_clock/pll_49m152/pll/CLKOUT0
27.417 | 2.109 | tNET | RR | 1 | DSP_R65[26] | system/synth/n3387_s/CLK[0]
26.857 | -0.561 | tSu | | 1 | DSP_R65[26] | system/synth/n3387_s

Path Statistics:

Clock Skew | 0.009
Setup Relationship | 20.345
Logic Level | 4
Arrival Clock Path Delay | cell: 0.000, 0.000%; route: 2.099, 100.000%
Arrival Data Path Delay | cell: 1.349, 13.880%; route: 8.001, 82.337%; tC2Q: 0.368, 3.782%
Required Clock Path Delay | cell: 0.000, 0.000%; route: 2.109, 100.000%

### Path5

Path Summary:

Slack | 10.327
Data Arrival Time | 16.530
Data Required Time | 26.857
From | ready_sync_s0
To | system/synth/u_polar0/n25821_0_s
Launch Clk | audio_clock/pll_49m152/pll/CLKOUT0.default_gen_clk:[R]
Latch Clk | audio_clock/pll_49m152/pll/CLKOUT0.default_gen_clk:[R]

Data Arrival Path:

AT | DELAY | TYPE | RF | FANOUT | LOC | NODE
0.000 | 0.000 | | | | | active clock edge time
0.000 | 0.000 | | | | | audio_clock/pll_49m152/pll/CLKOUT0.default_gen_clk
4.964 | 4.964 | tCL | RR | 9528 | PLL_T[0] | audio_clock/pll_49m152/pll/CLKOUT0
7.063 | 2.099 | tNET | RR | 1 | R43C141[2][B] | ready_sync_s0/CLK
7.431 | 0.368 | tC2Q | RF | 11 | R43C141[2][B] | ready_sync_s0/Q
8.618 | 1.187 | tNET | FF | 1 | R24C123[0][A] | rst_n_s0/I1
9.079 | 0.461 | tINS | FR | 463 | R24C123[0][A] | rst_n_s0/F
10.101 | 1.021 | tNET | RR | 1 | R27C109[3][B] | system/audio_rst_n_s1/I3
10.598 | 0.498 | tINS | RR | 3143 | R27C109[3][B] | system/audio_rst_n_s1/F
13.909 | 3.311 | tNET | RR | 1 | R21C96[1][B] | system/events/mem[0]_ER_init_s2/I0
14.299 | 0.390 | tINS | RF | 13 | R21C96[1][B] | system/events/mem[0]_ER_init_s2/F
16.530 | 2.231 | tNET | FF | 1 | DSP_R47[23] | system/synth/u_polar0/n25821_0_s/RESET[0]

Data Required Path:

AT | DELAY | TYPE | RF | FANOUT | LOC | NODE
20.345 | 20.345 | | | | | active clock edge time
20.345 | 0.000 | | | | | audio_clock/pll_49m152/pll/CLKOUT0.default_gen_clk
25.309 | 4.964 | tCL | RR | 9528 | PLL_T[0] | audio_clock/pll_49m152/pll/CLKOUT0
27.417 | 2.109 | tNET | RR | 1 | DSP_R47[23] | system/synth/u_polar0/n25821_0_s/CLK[0]
26.857 | -0.561 | tSu | | 1 | DSP_R47[23] | system/synth/u_polar0/n25821_0_s

Path Statistics:

Clock Skew | 0.009
Setup Relationship | 20.345
Logic Level | 4
Arrival Clock Path Delay | cell: 0.000, 0.000%; route: 2.099, 100.000%
Arrival Data Path Delay | cell: 1.349, 14.247%; route: 7.751, 81.871%; tC2Q: 0.368, 3.882%
Required Clock Path Delay | cell: 0.000, 0.000%; route: 2.109, 100.000%

### Path6

Path Summary:

Slack | 10.358
Data Arrival Time | 16.489
Data Required Time | 26.847
From | ready_sync_s0
To | system/synth/n3524_s
Launch Clk | audio_clock/pll_49m152/pll/CLKOUT0.default_gen_clk:[R]
Latch Clk | audio_clock/pll_49m152/pll/CLKOUT0.default_gen_clk:[R]

Data Arrival Path:

AT | DELAY | TYPE | RF | FANOUT | LOC | NODE
0.000 | 0.000 | | | | | active clock edge time
0.000 | 0.000 | | | | | audio_clock/pll_49m152/pll/CLKOUT0.default_gen_clk
4.964 | 4.964 | tCL | RR | 9528 | PLL_T[0] | audio_clock/pll_49m152/pll/CLKOUT0
7.063 | 2.099 | tNET | RR | 1 | R43C141[2][B] | ready_sync_s0/CLK
7.431 | 0.368 | tC2Q | RF | 11 | R43C141[2][B] | ready_sync_s0/Q
8.618 | 1.187 | tNET | FF | 1 | R24C123[0][A] | rst_n_s0/I1
9.079 | 0.461 | tINS | FR | 463 | R24C123[0][A] | rst_n_s0/F
10.101 | 1.021 | tNET | RR | 1 | R27C109[3][B] | system/audio_rst_n_s1/I3
10.598 | 0.498 | tINS | RR | 3143 | R27C109[3][B] | system/audio_rst_n_s1/F
13.909 | 3.311 | tNET | RR | 1 | R21C96[1][B] | system/events/mem[0]_ER_init_s2/I0
14.299 | 0.390 | tINS | RF | 13 | R21C96[1][B] | system/events/mem[0]_ER_init_s2/F
16.489 | 2.190 | tNET | FF | 1 | DSP_R65[27] | system/synth/n3524_s/RESET[0]

Data Required Path:

AT | DELAY | TYPE | RF | FANOUT | LOC | NODE
20.345 | 20.345 | | | | | active clock edge time
20.345 | 0.000 | | | | | audio_clock/pll_49m152/pll/CLKOUT0.default_gen_clk
25.309 | 4.964 | tCL | RR | 9528 | PLL_T[0] | audio_clock/pll_49m152/pll/CLKOUT0
27.408 | 2.099 | tNET | RR | 1 | DSP_R65[27] | system/synth/n3524_s/CLK[0]
26.847 | -0.561 | tSu | | 1 | DSP_R65[27] | system/synth/n3524_s

Path Statistics:

Clock Skew | 0.000
Setup Relationship | 20.345
Logic Level | 4
Arrival Clock Path Delay | cell: 0.000, 0.000%; route: 2.099, 100.000%
Arrival Data Path Delay | cell: 1.349, 14.309%; route: 7.709, 81.792%; tC2Q: 0.368, 3.899%
Required Clock Path Delay | cell: 0.000, 0.000%; route: 2.099, 100.000%

### Path7

Path Summary:

Slack | 10.386
Data Arrival Time | 16.461
Data Required Time | 26.847
From | ready_sync_s0
To | system/synth/u_expression/n746_s
Launch Clk | audio_clock/pll_49m152/pll/CLKOUT0.default_gen_clk:[R]
Latch Clk | audio_clock/pll_49m152/pll/CLKOUT0.default_gen_clk:[R]

Data Arrival Path:

AT | DELAY | TYPE | RF | FANOUT | LOC | NODE
0.000 | 0.000 | | | | | active clock edge time
0.000 | 0.000 | | | | | audio_clock/pll_49m152/pll/CLKOUT0.default_gen_clk
4.964 | 4.964 | tCL | RR | 9528 | PLL_T[0] | audio_clock/pll_49m152/pll/CLKOUT0
7.063 | 2.099 | tNET | RR | 1 | R43C141[2][B] | ready_sync_s0/CLK
7.431 | 0.368 | tC2Q | RF | 11 | R43C141[2][B] | ready_sync_s0/Q
8.618 | 1.187 | tNET | FF | 1 | R24C123[0][A] | rst_n_s0/I1
9.079 | 0.461 | tINS | FR | 463 | R24C123[0][A] | rst_n_s0/F
10.101 | 1.021 | tNET | RR | 1 | R27C109[3][B] | system/audio_rst_n_s1/I3
10.598 | 0.498 | tINS | RR | 3143 | R27C109[3][B] | system/audio_rst_n_s1/F
13.909 | 3.311 | tNET | RR | 1 | R21C96[1][B] | system/events/mem[0]_ER_init_s2/I0
14.299 | 0.390 | tINS | RF | 13 | R21C96[1][B] | system/events/mem[0]_ER_init_s2/F
16.461 | 2.163 | tNET | FF | 1 | DSP_R65[35] | system/synth/u_expression/n746_s/RESET[0]

Data Required Path:

AT | DELAY | TYPE | RF | FANOUT | LOC | NODE
20.345 | 20.345 | | | | | active clock edge time
20.345 | 0.000 | | | | | audio_clock/pll_49m152/pll/CLKOUT0.default_gen_clk
25.309 | 4.964 | tCL | RR | 9528 | PLL_T[0] | audio_clock/pll_49m152/pll/CLKOUT0
27.408 | 2.099 | tNET | RR | 1 | DSP_R65[35] | system/synth/u_expression/n746_s/CLK[0]
26.847 | -0.561 | tSu | | 1 | DSP_R65[35] | system/synth/u_expression/n746_s

Path Statistics:

Clock Skew | 0.000
Setup Relationship | 20.345
Logic Level | 4
Arrival Clock Path Delay | cell: 0.000, 0.000%; route: 2.099, 100.000%
Arrival Data Path Delay | cell: 1.349, 14.351%; route: 7.682, 81.738%; tC2Q: 0.368, 3.910%
Required Clock Path Delay | cell: 0.000, 0.000%; route: 2.099, 100.000%

### Path8

Path Summary:

Slack | 10.682
Data Arrival Time | 16.165
Data Required Time | 26.847
From | ready_sync_s0
To | system/synth/u_polar0/n25822_0_s
Launch Clk | audio_clock/pll_49m152/pll/CLKOUT0.default_gen_clk:[R]
Latch Clk | audio_clock/pll_49m152/pll/CLKOUT0.default_gen_clk:[R]

Data Arrival Path:

AT | DELAY | TYPE | RF | FANOUT | LOC | NODE
0.000 | 0.000 | | | | | active clock edge time
0.000 | 0.000 | | | | | audio_clock/pll_49m152/pll/CLKOUT0.default_gen_clk
4.964 | 4.964 | tCL | RR | 9528 | PLL_T[0] | audio_clock/pll_49m152/pll/CLKOUT0
7.063 | 2.099 | tNET | RR | 1 | R43C141[2][B] | ready_sync_s0/CLK
7.431 | 0.368 | tC2Q | RF | 11 | R43C141[2][B] | ready_sync_s0/Q
8.618 | 1.187 | tNET | FF | 1 | R24C123[0][A] | rst_n_s0/I1
9.079 | 0.461 | tINS | FR | 463 | R24C123[0][A] | rst_n_s0/F
10.101 | 1.021 | tNET | RR | 1 | R27C109[3][B] | system/audio_rst_n_s1/I3
10.598 | 0.498 | tINS | RR | 3143 | R27C109[3][B] | system/audio_rst_n_s1/F
13.909 | 3.311 | tNET | RR | 1 | R21C96[1][B] | system/events/mem[0]_ER_init_s2/I0
14.299 | 0.390 | tINS | RF | 13 | R21C96[1][B] | system/events/mem[0]_ER_init_s2/F
16.165 | 1.866 | tNET | FF | 1 | DSP_R47[25] | system/synth/u_polar0/n25822_0_s/RESET[0]

Data Required Path:

AT | DELAY | TYPE | RF | FANOUT | LOC | NODE
20.345 | 20.345 | | | | | active clock edge time
20.345 | 0.000 | | | | | audio_clock/pll_49m152/pll/CLKOUT0.default_gen_clk
25.309 | 4.964 | tCL | RR | 9528 | PLL_T[0] | audio_clock/pll_49m152/pll/CLKOUT0
27.408 | 2.099 | tNET | RR | 1 | DSP_R47[25] | system/synth/u_polar0/n25822_0_s/CLK[0]
26.847 | -0.561 | tSu | | 1 | DSP_R47[25] | system/synth/u_polar0/n25822_0_s

Path Statistics:

Clock Skew | 0.000
Setup Relationship | 20.345
Logic Level | 4
Arrival Clock Path Delay | cell: 0.000, 0.000%; route: 2.099, 100.000%
Arrival Data Path Delay | cell: 1.349, 14.818%; route: 7.386, 81.144%; tC2Q: 0.368, 4.038%
Required Clock Path Delay | cell: 0.000, 0.000%; route: 2.099, 100.000%

### Path9

Path Summary:

Slack | 10.734
Data Arrival Time | 16.104
Data Required Time | 26.838
From | ready_sync_s0
To | system/synth/n3491_s
Launch Clk | audio_clock/pll_49m152/pll/CLKOUT0.default_gen_clk:[R]
Latch Clk | audio_clock/pll_49m152/pll/CLKOUT0.default_gen_clk:[R]

Data Arrival Path:

AT | DELAY | TYPE | RF | FANOUT | LOC | NODE
0.000 | 0.000 | | | | | active clock edge time
0.000 | 0.000 | | | | | audio_clock/pll_49m152/pll/CLKOUT0.default_gen_clk
4.964 | 4.964 | tCL | RR | 9528 | PLL_T[0] | audio_clock/pll_49m152/pll/CLKOUT0
7.063 | 2.099 | tNET | RR | 1 | R43C141[2][B] | ready_sync_s0/CLK
7.431 | 0.368 | tC2Q | RF | 11 | R43C141[2][B] | ready_sync_s0/Q
8.618 | 1.187 | tNET | FF | 1 | R24C123[0][A] | rst_n_s0/I1
9.079 | 0.461 | tINS | FR | 463 | R24C123[0][A] | rst_n_s0/F
10.101 | 1.021 | tNET | RR | 1 | R27C109[3][B] | system/audio_rst_n_s1/I3
10.598 | 0.498 | tINS | RR | 3143 | R27C109[3][B] | system/audio_rst_n_s1/F
13.909 | 3.311 | tNET | RR | 1 | R21C96[1][B] | system/events/mem[0]_ER_init_s2/I0
14.299 | 0.390 | tINS | RF | 13 | R21C96[1][B] | system/events/mem[0]_ER_init_s2/F
16.104 | 1.805 | tNET | FF | 1 | DSP_R65[28] | system/synth/n3491_s/RESET[0]

Data Required Path:

AT | DELAY | TYPE | RF | FANOUT | LOC | NODE
20.345 | 20.345 | | | | | active clock edge time
20.345 | 0.000 | | | | | audio_clock/pll_49m152/pll/CLKOUT0.default_gen_clk
25.309 | 4.964 | tCL | RR | 9528 | PLL_T[0] | audio_clock/pll_49m152/pll/CLKOUT0
27.399 | 2.090 | tNET | RR | 1 | DSP_R65[28] | system/synth/n3491_s/CLK[0]
26.838 | -0.561 | tSu | | 1 | DSP_R65[28] | system/synth/n3491_s

Path Statistics:

Clock Skew | -0.009
Setup Relationship | 20.345
Logic Level | 4
Arrival Clock Path Delay | cell: 0.000, 0.000%; route: 2.099, 100.000%
Arrival Data Path Delay | cell: 1.349, 14.919%; route: 7.324, 81.016%; tC2Q: 0.368, 4.065%
Required Clock Path Delay | cell: 0.000, 0.000%; route: 2.090, 100.000%

### Path10

Path Summary:

Slack | 10.821
Data Arrival Time | 16.026
Data Required Time | 26.847
From | ready_sync_s0
To | system/synth/u_gain/n143_s
Launch Clk | audio_clock/pll_49m152/pll/CLKOUT0.default_gen_clk:[R]
Latch Clk | audio_clock/pll_49m152/pll/CLKOUT0.default_gen_clk:[R]

Data Arrival Path:

AT | DELAY | TYPE | RF | FANOUT | LOC | NODE
0.000 | 0.000 | | | | | active clock edge time
0.000 | 0.000 | | | | | audio_clock/pll_49m152/pll/CLKOUT0.default_gen_clk
4.964 | 4.964 | tCL | RR | 9528 | PLL_T[0] | audio_clock/pll_49m152/pll/CLKOUT0
7.063 | 2.099 | tNET | RR | 1 | R43C141[2][B] | ready_sync_s0/CLK
7.431 | 0.368 | tC2Q | RF | 11 | R43C141[2][B] | ready_sync_s0/Q
8.618 | 1.187 | tNET | FF | 1 | R24C123[0][A] | rst_n_s0/I1
9.079 | 0.461 | tINS | FR | 463 | R24C123[0][A] | rst_n_s0/F
10.101 | 1.021 | tNET | RR | 1 | R27C109[3][B] | system/audio_rst_n_s1/I3
10.598 | 0.498 | tINS | RR | 3143 | R27C109[3][B] | system/audio_rst_n_s1/F
13.909 | 3.311 | tNET | RR | 1 | R21C96[1][B] | system/events/mem[0]_ER_init_s2/I0
14.299 | 0.390 | tINS | RF | 13 | R21C96[1][B] | system/events/mem[0]_ER_init_s2/F
16.026 | 1.727 | tNET | FF | 1 | DSP_R65[31] | system/synth/u_gain/n143_s/RESET[0]

Data Required Path:

AT | DELAY | TYPE | RF | FANOUT | LOC | NODE
20.345 | 20.345 | | | | | active clock edge time
20.345 | 0.000 | | | | | audio_clock/pll_49m152/pll/CLKOUT0.default_gen_clk
25.309 | 4.964 | tCL | RR | 9528 | PLL_T[0] | audio_clock/pll_49m152/pll/CLKOUT0
27.408 | 2.099 | tNET | RR | 1 | DSP_R65[31] | system/synth/u_gain/n143_s/CLK[0]
26.847 | -0.561 | tSu | | 1 | DSP_R65[31] | system/synth/u_gain/n143_s

Path Statistics:

Clock Skew | 0.000
Setup Relationship | 20.345
Logic Level | 4
Arrival Clock Path Delay | cell: 0.000, 0.000%; route: 2.099, 100.000%
Arrival Data Path Delay | cell: 1.349, 15.048%; route: 7.247, 80.852%; tC2Q: 0.368, 4.100%
Required Clock Path Delay | cell: 0.000, 0.000%; route: 2.099, 100.000%

### Path11

Path Summary:

Slack | 10.983
Data Arrival Time | 15.874
Data Required Time | 26.857
From | ready_sync_s0
To | system/synth/u_gain/n188_s
Launch Clk | audio_clock/pll_49m152/pll/CLKOUT0.default_gen_clk:[R]
Latch Clk | audio_clock/pll_49m152/pll/CLKOUT0.default_gen_clk:[R]

Data Arrival Path:

AT | DELAY | TYPE | RF | FANOUT | LOC | NODE
0.000 | 0.000 | | | | | active clock edge time
0.000 | 0.000 | | | | | audio_clock/pll_49m152/pll/CLKOUT0.default_gen_clk
4.964 | 4.964 | tCL | RR | 9528 | PLL_T[0] | audio_clock/pll_49m152/pll/CLKOUT0
7.063 | 2.099 | tNET | RR | 1 | R43C141[2][B] | ready_sync_s0/CLK
7.431 | 0.368 | tC2Q | RF | 11 | R43C141[2][B] | ready_sync_s0/Q
8.618 | 1.187 | tNET | FF | 1 | R24C123[0][A] | rst_n_s0/I1
9.079 | 0.461 | tINS | FR | 463 | R24C123[0][A] | rst_n_s0/F
10.101 | 1.021 | tNET | RR | 1 | R27C109[3][B] | system/audio_rst_n_s1/I3
10.598 | 0.498 | tINS | RR | 3143 | R27C109[3][B] | system/audio_rst_n_s1/F
13.909 | 3.311 | tNET | RR | 1 | R21C96[1][B] | system/events/mem[0]_ER_init_s2/I0
14.299 | 0.390 | tINS | RF | 13 | R21C96[1][B] | system/events/mem[0]_ER_init_s2/F
15.874 | 1.575 | tNET | FF | 1 | DSP_R65[29] | system/synth/u_gain/n188_s/RESET[0]

Data Required Path:

AT | DELAY | TYPE | RF | FANOUT | LOC | NODE
20.345 | 20.345 | | | | | active clock edge time
20.345 | 0.000 | | | | | audio_clock/pll_49m152/pll/CLKOUT0.default_gen_clk
25.309 | 4.964 | tCL | RR | 9528 | PLL_T[0] | audio_clock/pll_49m152/pll/CLKOUT0
27.417 | 2.109 | tNET | RR | 1 | DSP_R65[29] | system/synth/u_gain/n188_s/CLK[0]
26.857 | -0.561 | tSu | | 1 | DSP_R65[29] | system/synth/u_gain/n188_s

Path Statistics:

Clock Skew | 0.009
Setup Relationship | 20.345
Logic Level | 4
Arrival Clock Path Delay | cell: 0.000, 0.000%; route: 2.099, 100.000%
Arrival Data Path Delay | cell: 1.349, 15.308%; route: 7.094, 80.521%; tC2Q: 0.368, 4.171%
Required Clock Path Delay | cell: 0.000, 0.000%; route: 2.109, 100.000%

### Path12

Path Summary:

Slack | 11.423
Data Arrival Time | 15.434
Data Required Time | 26.857
From | ready_sync_s0
To | system/synth/n3071_s
Launch Clk | audio_clock/pll_49m152/pll/CLKOUT0.default_gen_clk:[R]
Latch Clk | audio_clock/pll_49m152/pll/CLKOUT0.default_gen_clk:[R]

Data Arrival Path:

AT | DELAY | TYPE | RF | FANOUT | LOC | NODE
0.000 | 0.000 | | | | | active clock edge time
0.000 | 0.000 | | | | | audio_clock/pll_49m152/pll/CLKOUT0.default_gen_clk
4.964 | 4.964 | tCL | RR | 9528 | PLL_T[0] | audio_clock/pll_49m152/pll/CLKOUT0
7.063 | 2.099 | tNET | RR | 1 | R43C141[2][B] | ready_sync_s0/CLK
7.431 | 0.368 | tC2Q | RF | 11 | R43C141[2][B] | ready_sync_s0/Q
8.618 | 1.187 | tNET | FF | 1 | R24C123[0][A] | rst_n_s0/I1
9.079 | 0.461 | tINS | FR | 463 | R24C123[0][A] | rst_n_s0/F
10.101 | 1.021 | tNET | RR | 1 | R27C109[3][B] | system/audio_rst_n_s1/I3
10.598 | 0.498 | tINS | RR | 3143 | R27C109[3][B] | system/audio_rst_n_s1/F
13.909 | 3.311 | tNET | RR | 1 | R21C96[1][B] | system/events/mem[0]_ER_init_s2/I0
14.299 | 0.390 | tINS | RF | 13 | R21C96[1][B] | system/events/mem[0]_ER_init_s2/F
15.434 | 1.135 | tNET | FF | 1 | DSP_R47[30] | system/synth/n3071_s/RESET[0]

Data Required Path:

AT | DELAY | TYPE | RF | FANOUT | LOC | NODE
20.345 | 20.345 | | | | | active clock edge time
20.345 | 0.000 | | | | | audio_clock/pll_49m152/pll/CLKOUT0.default_gen_clk
25.309 | 4.964 | tCL | RR | 9528 | PLL_T[0] | audio_clock/pll_49m152/pll/CLKOUT0
27.417 | 2.109 | tNET | RR | 1 | DSP_R47[30] | system/synth/n3071_s/CLK[0]
26.857 | -0.561 | tSu | | 1 | DSP_R47[30] | system/synth/n3071_s

Path Statistics:

Clock Skew | 0.009
Setup Relationship | 20.345
Logic Level | 4
Arrival Clock Path Delay | cell: 0.000, 0.000%; route: 2.099, 100.000%
Arrival Data Path Delay | cell: 1.349, 16.113%; route: 6.654, 79.497%; tC2Q: 0.368, 4.390%
Required Clock Path Delay | cell: 0.000, 0.000%; route: 2.109, 100.000%

### Path13

Path Summary:

Slack | 13.269
Data Arrival Time | 13.792
Data Required Time | 27.061
From | ready_sync_s0
To | system/effects/comb_average_10_s0
Launch Clk | audio_clock/pll_49m152/pll/CLKOUT0.default_gen_clk:[R]
Latch Clk | audio_clock/pll_49m152/pll/CLKOUT0.default_gen_clk:[R]

Data Arrival Path:

AT | DELAY | TYPE | RF | FANOUT | LOC | NODE
0.000 | 0.000 | | | | | active clock edge time
0.000 | 0.000 | | | | | audio_clock/pll_49m152/pll/CLKOUT0.default_gen_clk
4.964 | 4.964 | tCL | RR | 9528 | PLL_T[0] | audio_clock/pll_49m152/pll/CLKOUT0
7.063 | 2.099 | tNET | RR | 1 | R43C141[2][B] | ready_sync_s0/CLK
7.431 | 0.368 | tC2Q | RF | 11 | R43C141[2][B] | ready_sync_s0/Q
8.618 | 1.187 | tNET | FF | 1 | R24C123[0][A] | rst_n_s0/I1
9.079 | 0.461 | tINS | FR | 463 | R24C123[0][A] | rst_n_s0/F
10.101 | 1.021 | tNET | RR | 1 | R27C109[3][B] | system/audio_rst_n_s1/I3
10.522 | 0.421 | tINS | RF | 3143 | R27C109[3][B] | system/audio_rst_n_s1/F
13.792 | 3.270 | tNET | FF | 1 | R46C60[3][A] | system/effects/comb_average_10_s0/CLEAR

Data Required Path:

AT | DELAY | TYPE | RF | FANOUT | LOC | NODE
20.345 | 20.345 | | | | | active clock edge time
20.345 | 0.000 | | | | | audio_clock/pll_49m152/pll/CLKOUT0.default_gen_clk
25.309 | 4.964 | tCL | RR | 9528 | PLL_T[0] | audio_clock/pll_49m152/pll/CLKOUT0
27.408 | 2.099 | tNET | RR | 1 | R46C60[3][A] | system/effects/comb_average_10_s0/CLK
27.061 | -0.347 | tSu | | 1 | R46C60[3][A] | system/effects/comb_average_10_s0

Path Statistics:

Clock Skew | 0.000
Setup Relationship | 20.345
Logic Level | 3
Arrival Clock Path Delay | cell: 0.000, 0.000%; route: 2.099, 100.000%
Arrival Data Path Delay | cell: 0.882, 13.115%; route: 5.479, 81.423%; tC2Q: 0.368, 5.462%
Required Clock Path Delay | cell: 0.000, 0.000%; route: 2.099, 100.000%

### Path14

Path Summary:

Slack | 13.269
Data Arrival Time | 13.792
Data Required Time | 27.061
From | ready_sync_s0
To | system/synth/u_polar0/v_5_s0
Launch Clk | audio_clock/pll_49m152/pll/CLKOUT0.default_gen_clk:[R]
Latch Clk | audio_clock/pll_49m152/pll/CLKOUT0.default_gen_clk:[R]

Data Arrival Path:

AT | DELAY | TYPE | RF | FANOUT | LOC | NODE
0.000 | 0.000 | | | | | active clock edge time
0.000 | 0.000 | | | | | audio_clock/pll_49m152/pll/CLKOUT0.default_gen_clk
4.964 | 4.964 | tCL | RR | 9528 | PLL_T[0] | audio_clock/pll_49m152/pll/CLKOUT0
7.063 | 2.099 | tNET | RR | 1 | R43C141[2][B] | ready_sync_s0/CLK
7.431 | 0.368 | tC2Q | RF | 11 | R43C141[2][B] | ready_sync_s0/Q
8.618 | 1.187 | tNET | FF | 1 | R24C123[0][A] | rst_n_s0/I1
9.079 | 0.461 | tINS | FR | 463 | R24C123[0][A] | rst_n_s0/F
10.101 | 1.021 | tNET | RR | 1 | R27C109[3][B] | system/audio_rst_n_s1/I3
10.522 | 0.421 | tINS | RF | 3143 | R27C109[3][B] | system/audio_rst_n_s1/F
13.792 | 3.270 | tNET | FF | 1 | R46C68[1][A] | system/synth/u_polar0/v_5_s0/CLEAR

Data Required Path:

AT | DELAY | TYPE | RF | FANOUT | LOC | NODE
20.345 | 20.345 | | | | | active clock edge time
20.345 | 0.000 | | | | | audio_clock/pll_49m152/pll/CLKOUT0.default_gen_clk
25.309 | 4.964 | tCL | RR | 9528 | PLL_T[0] | audio_clock/pll_49m152/pll/CLKOUT0
27.408 | 2.099 | tNET | RR | 1 | R46C68[1][A] | system/synth/u_polar0/v_5_s0/CLK
27.061 | -0.347 | tSu | | 1 | R46C68[1][A] | system/synth/u_polar0/v_5_s0

Path Statistics:

Clock Skew | 0.000
Setup Relationship | 20.345
Logic Level | 3
Arrival Clock Path Delay | cell: 0.000, 0.000%; route: 2.099, 100.000%
Arrival Data Path Delay | cell: 0.882, 13.115%; route: 5.479, 81.423%; tC2Q: 0.368, 5.462%
Required Clock Path Delay | cell: 0.000, 0.000%; route: 2.099, 100.000%

### Path15

Path Summary:

Slack | 13.271
Data Arrival Time | 13.781
Data Required Time | 27.051
From | ready_sync_s0
To | system/effects/active_mode_0_s0
Launch Clk | audio_clock/pll_49m152/pll/CLKOUT0.default_gen_clk:[R]
Latch Clk | audio_clock/pll_49m152/pll/CLKOUT0.default_gen_clk:[R]

Data Arrival Path:

AT | DELAY | TYPE | RF | FANOUT | LOC | NODE
0.000 | 0.000 | | | | | active clock edge time
0.000 | 0.000 | | | | | audio_clock/pll_49m152/pll/CLKOUT0.default_gen_clk
4.964 | 4.964 | tCL | RR | 9528 | PLL_T[0] | audio_clock/pll_49m152/pll/CLKOUT0
7.063 | 2.099 | tNET | RR | 1 | R43C141[2][B] | ready_sync_s0/CLK
7.431 | 0.368 | tC2Q | RF | 11 | R43C141[2][B] | ready_sync_s0/Q
8.618 | 1.187 | tNET | FF | 1 | R24C123[0][A] | rst_n_s0/I1
9.079 | 0.461 | tINS | FR | 463 | R24C123[0][A] | rst_n_s0/F
10.101 | 1.021 | tNET | RR | 1 | R27C109[3][B] | system/audio_rst_n_s1/I3
10.522 | 0.421 | tINS | RF | 3143 | R27C109[3][B] | system/audio_rst_n_s1/F
13.781 | 3.259 | tNET | FF | 1 | R45C59[2][A] | system/effects/active_mode_0_s0/CLEAR

Data Required Path:

AT | DELAY | TYPE | RF | FANOUT | LOC | NODE
20.345 | 20.345 | | | | | active clock edge time
20.345 | 0.000 | | | | | audio_clock/pll_49m152/pll/CLKOUT0.default_gen_clk
25.309 | 4.964 | tCL | RR | 9528 | PLL_T[0] | audio_clock/pll_49m152/pll/CLKOUT0
27.399 | 2.090 | tNET | RR | 1 | R45C59[2][A] | system/effects/active_mode_0_s0/CLK
27.051 | -0.347 | tSu | | 1 | R45C59[2][A] | system/effects/active_mode_0_s0

Path Statistics:

Clock Skew | -0.009
Setup Relationship | 20.345
Logic Level | 3
Arrival Clock Path Delay | cell: 0.000, 0.000%; route: 2.099, 100.000%
Arrival Data Path Delay | cell: 0.882, 13.137%; route: 5.468, 81.392%; tC2Q: 0.368, 5.471%
Required Clock Path Delay | cell: 0.000, 0.000%; route: 2.090, 100.000%

### Path16

Path Summary:

Slack | 13.271
Data Arrival Time | 13.781
Data Required Time | 27.051
From | ready_sync_s0
To | system/effects/active_mode_1_s0
Launch Clk | audio_clock/pll_49m152/pll/CLKOUT0.default_gen_clk:[R]
Latch Clk | audio_clock/pll_49m152/pll/CLKOUT0.default_gen_clk:[R]

Data Arrival Path:

AT | DELAY | TYPE | RF | FANOUT | LOC | NODE
0.000 | 0.000 | | | | | active clock edge time
0.000 | 0.000 | | | | | audio_clock/pll_49m152/pll/CLKOUT0.default_gen_clk
4.964 | 4.964 | tCL | RR | 9528 | PLL_T[0] | audio_clock/pll_49m152/pll/CLKOUT0
7.063 | 2.099 | tNET | RR | 1 | R43C141[2][B] | ready_sync_s0/CLK
7.431 | 0.368 | tC2Q | RF | 11 | R43C141[2][B] | ready_sync_s0/Q
8.618 | 1.187 | tNET | FF | 1 | R24C123[0][A] | rst_n_s0/I1
9.079 | 0.461 | tINS | FR | 463 | R24C123[0][A] | rst_n_s0/F
10.101 | 1.021 | tNET | RR | 1 | R27C109[3][B] | system/audio_rst_n_s1/I3
10.522 | 0.421 | tINS | RF | 3143 | R27C109[3][B] | system/audio_rst_n_s1/F
13.781 | 3.259 | tNET | FF | 1 | R45C59[2][B] | system/effects/active_mode_1_s0/CLEAR

Data Required Path:

AT | DELAY | TYPE | RF | FANOUT | LOC | NODE
20.345 | 20.345 | | | | | active clock edge time
20.345 | 0.000 | | | | | audio_clock/pll_49m152/pll/CLKOUT0.default_gen_clk
25.309 | 4.964 | tCL | RR | 9528 | PLL_T[0] | audio_clock/pll_49m152/pll/CLKOUT0
27.399 | 2.090 | tNET | RR | 1 | R45C59[2][B] | system/effects/active_mode_1_s0/CLK
27.051 | -0.347 | tSu | | 1 | R45C59[2][B] | system/effects/active_mode_1_s0

Path Statistics:

Clock Skew | -0.009
Setup Relationship | 20.345
Logic Level | 3
Arrival Clock Path Delay | cell: 0.000, 0.000%; route: 2.099, 100.000%
Arrival Data Path Delay | cell: 0.882, 13.137%; route: 5.468, 81.392%; tC2Q: 0.368, 5.471%
Required Clock Path Delay | cell: 0.000, 0.000%; route: 2.090, 100.000%

### Path17

Path Summary:

Slack | 13.271
Data Arrival Time | 13.790
Data Required Time | 27.061
From | ready_sync_s0
To | system/effects/aout0_0_s0
Launch Clk | audio_clock/pll_49m152/pll/CLKOUT0.default_gen_clk:[R]
Latch Clk | audio_clock/pll_49m152/pll/CLKOUT0.default_gen_clk:[R]

Data Arrival Path:

AT | DELAY | TYPE | RF | FANOUT | LOC | NODE
0.000 | 0.000 | | | | | active clock edge time
0.000 | 0.000 | | | | | audio_clock/pll_49m152/pll/CLKOUT0.default_gen_clk
4.964 | 4.964 | tCL | RR | 9528 | PLL_T[0] | audio_clock/pll_49m152/pll/CLKOUT0
7.063 | 2.099 | tNET | RR | 1 | R43C141[2][B] | ready_sync_s0/CLK
7.431 | 0.368 | tC2Q | RF | 11 | R43C141[2][B] | ready_sync_s0/Q
8.618 | 1.187 | tNET | FF | 1 | R24C123[0][A] | rst_n_s0/I1
9.079 | 0.461 | tINS | FR | 463 | R24C123[0][A] | rst_n_s0/F
10.101 | 1.021 | tNET | RR | 1 | R27C109[3][B] | system/audio_rst_n_s1/I3
10.522 | 0.421 | tINS | RF | 3143 | R27C109[3][B] | system/audio_rst_n_s1/F
13.790 | 3.268 | tNET | FF | 1 | R45C60[0][A] | system/effects/aout0_0_s0/CLEAR

Data Required Path:

AT | DELAY | TYPE | RF | FANOUT | LOC | NODE
20.345 | 20.345 | | | | | active clock edge time
20.345 | 0.000 | | | | | audio_clock/pll_49m152/pll/CLKOUT0.default_gen_clk
25.309 | 4.964 | tCL | RR | 9528 | PLL_T[0] | audio_clock/pll_49m152/pll/CLKOUT0
27.408 | 2.099 | tNET | RR | 1 | R45C60[0][A] | system/effects/aout0_0_s0/CLK
27.061 | -0.347 | tSu | | 1 | R45C60[0][A] | system/effects/aout0_0_s0

Path Statistics:

Clock Skew | 0.000
Setup Relationship | 20.345
Logic Level | 3
Arrival Clock Path Delay | cell: 0.000, 0.000%; route: 2.099, 100.000%
Arrival Data Path Delay | cell: 0.882, 13.119%; route: 5.477, 81.418%; tC2Q: 0.368, 5.463%
Required Clock Path Delay | cell: 0.000, 0.000%; route: 2.099, 100.000%

### Path18

Path Summary:

Slack | 13.271
Data Arrival Time | 13.790
Data Required Time | 27.061
From | ready_sync_s0
To | system/effects/aout0_1_s0
Launch Clk | audio_clock/pll_49m152/pll/CLKOUT0.default_gen_clk:[R]
Latch Clk | audio_clock/pll_49m152/pll/CLKOUT0.default_gen_clk:[R]

Data Arrival Path:

AT | DELAY | TYPE | RF | FANOUT | LOC | NODE
0.000 | 0.000 | | | | | active clock edge time
0.000 | 0.000 | | | | | audio_clock/pll_49m152/pll/CLKOUT0.default_gen_clk
4.964 | 4.964 | tCL | RR | 9528 | PLL_T[0] | audio_clock/pll_49m152/pll/CLKOUT0
7.063 | 2.099 | tNET | RR | 1 | R43C141[2][B] | ready_sync_s0/CLK
7.431 | 0.368 | tC2Q | RF | 11 | R43C141[2][B] | ready_sync_s0/Q
8.618 | 1.187 | tNET | FF | 1 | R24C123[0][A] | rst_n_s0/I1
9.079 | 0.461 | tINS | FR | 463 | R24C123[0][A] | rst_n_s0/F
10.101 | 1.021 | tNET | RR | 1 | R27C109[3][B] | system/audio_rst_n_s1/I3
10.522 | 0.421 | tINS | RF | 3143 | R27C109[3][B] | system/audio_rst_n_s1/F
13.790 | 3.268 | tNET | FF | 1 | R45C60[0][B] | system/effects/aout0_1_s0/CLEAR

Data Required Path:

AT | DELAY | TYPE | RF | FANOUT | LOC | NODE
20.345 | 20.345 | | | | | active clock edge time
20.345 | 0.000 | | | | | audio_clock/pll_49m152/pll/CLKOUT0.default_gen_clk
25.309 | 4.964 | tCL | RR | 9528 | PLL_T[0] | audio_clock/pll_49m152/pll/CLKOUT0
27.408 | 2.099 | tNET | RR | 1 | R45C60[0][B] | system/effects/aout0_1_s0/CLK
27.061 | -0.347 | tSu | | 1 | R45C60[0][B] | system/effects/aout0_1_s0

Path Statistics:

Clock Skew | 0.000
Setup Relationship | 20.345
Logic Level | 3
Arrival Clock Path Delay | cell: 0.000, 0.000%; route: 2.099, 100.000%
Arrival Data Path Delay | cell: 0.882, 13.119%; route: 5.477, 81.418%; tC2Q: 0.368, 5.463%
Required Clock Path Delay | cell: 0.000, 0.000%; route: 2.099, 100.000%

### Path19

Path Summary:

Slack | 13.271
Data Arrival Time | 13.790
Data Required Time | 27.061
From | ready_sync_s0
To | system/effects/aout0_2_s0
Launch Clk | audio_clock/pll_49m152/pll/CLKOUT0.default_gen_clk:[R]
Latch Clk | audio_clock/pll_49m152/pll/CLKOUT0.default_gen_clk:[R]

Data Arrival Path:

AT | DELAY | TYPE | RF | FANOUT | LOC | NODE
0.000 | 0.000 | | | | | active clock edge time
0.000 | 0.000 | | | | | audio_clock/pll_49m152/pll/CLKOUT0.default_gen_clk
4.964 | 4.964 | tCL | RR | 9528 | PLL_T[0] | audio_clock/pll_49m152/pll/CLKOUT0
7.063 | 2.099 | tNET | RR | 1 | R43C141[2][B] | ready_sync_s0/CLK
7.431 | 0.368 | tC2Q | RF | 11 | R43C141[2][B] | ready_sync_s0/Q
8.618 | 1.187 | tNET | FF | 1 | R24C123[0][A] | rst_n_s0/I1
9.079 | 0.461 | tINS | FR | 463 | R24C123[0][A] | rst_n_s0/F
10.101 | 1.021 | tNET | RR | 1 | R27C109[3][B] | system/audio_rst_n_s1/I3
10.522 | 0.421 | tINS | RF | 3143 | R27C109[3][B] | system/audio_rst_n_s1/F
13.790 | 3.268 | tNET | FF | 1 | R45C60[1][A] | system/effects/aout0_2_s0/CLEAR

Data Required Path:

AT | DELAY | TYPE | RF | FANOUT | LOC | NODE
20.345 | 20.345 | | | | | active clock edge time
20.345 | 0.000 | | | | | audio_clock/pll_49m152/pll/CLKOUT0.default_gen_clk
25.309 | 4.964 | tCL | RR | 9528 | PLL_T[0] | audio_clock/pll_49m152/pll/CLKOUT0
27.408 | 2.099 | tNET | RR | 1 | R45C60[1][A] | system/effects/aout0_2_s0/CLK
27.061 | -0.347 | tSu | | 1 | R45C60[1][A] | system/effects/aout0_2_s0

Path Statistics:

Clock Skew | 0.000
Setup Relationship | 20.345
Logic Level | 3
Arrival Clock Path Delay | cell: 0.000, 0.000%; route: 2.099, 100.000%
Arrival Data Path Delay | cell: 0.882, 13.119%; route: 5.477, 81.418%; tC2Q: 0.368, 5.463%
Required Clock Path Delay | cell: 0.000, 0.000%; route: 2.099, 100.000%

### Path20

Path Summary:

Slack | 13.271
Data Arrival Time | 13.790
Data Required Time | 27.061
From | ready_sync_s0
To | system/effects/aout0_3_s0
Launch Clk | audio_clock/pll_49m152/pll/CLKOUT0.default_gen_clk:[R]
Latch Clk | audio_clock/pll_49m152/pll/CLKOUT0.default_gen_clk:[R]

Data Arrival Path:

AT | DELAY | TYPE | RF | FANOUT | LOC | NODE
0.000 | 0.000 | | | | | active clock edge time
0.000 | 0.000 | | | | | audio_clock/pll_49m152/pll/CLKOUT0.default_gen_clk
4.964 | 4.964 | tCL | RR | 9528 | PLL_T[0] | audio_clock/pll_49m152/pll/CLKOUT0
7.063 | 2.099 | tNET | RR | 1 | R43C141[2][B] | ready_sync_s0/CLK
7.431 | 0.368 | tC2Q | RF | 11 | R43C141[2][B] | ready_sync_s0/Q
8.618 | 1.187 | tNET | FF | 1 | R24C123[0][A] | rst_n_s0/I1
9.079 | 0.461 | tINS | FR | 463 | R24C123[0][A] | rst_n_s0/F
10.101 | 1.021 | tNET | RR | 1 | R27C109[3][B] | system/audio_rst_n_s1/I3
10.522 | 0.421 | tINS | RF | 3143 | R27C109[3][B] | system/audio_rst_n_s1/F
13.790 | 3.268 | tNET | FF | 1 | R45C60[1][B] | system/effects/aout0_3_s0/CLEAR

Data Required Path:

AT | DELAY | TYPE | RF | FANOUT | LOC | NODE
20.345 | 20.345 | | | | | active clock edge time
20.345 | 0.000 | | | | | audio_clock/pll_49m152/pll/CLKOUT0.default_gen_clk
25.309 | 4.964 | tCL | RR | 9528 | PLL_T[0] | audio_clock/pll_49m152/pll/CLKOUT0
27.408 | 2.099 | tNET | RR | 1 | R45C60[1][B] | system/effects/aout0_3_s0/CLK
27.061 | -0.347 | tSu | | 1 | R45C60[1][B] | system/effects/aout0_3_s0

Path Statistics:

Clock Skew | 0.000
Setup Relationship | 20.345
Logic Level | 3
Arrival Clock Path Delay | cell: 0.000, 0.000%; route: 2.099, 100.000%
Arrival Data Path Delay | cell: 0.882, 13.119%; route: 5.477, 81.418%; tC2Q: 0.368, 5.463%
Required Clock Path Delay | cell: 0.000, 0.000%; route: 2.099, 100.000%

### Path21

Path Summary:

Slack | 13.271
Data Arrival Time | 13.790
Data Required Time | 27.061
From | ready_sync_s0
To | system/effects/aout0_4_s0
Launch Clk | audio_clock/pll_49m152/pll/CLKOUT0.default_gen_clk:[R]
Latch Clk | audio_clock/pll_49m152/pll/CLKOUT0.default_gen_clk:[R]

Data Arrival Path:

AT | DELAY | TYPE | RF | FANOUT | LOC | NODE
0.000 | 0.000 | | | | | active clock edge time
0.000 | 0.000 | | | | | audio_clock/pll_49m152/pll/CLKOUT0.default_gen_clk
4.964 | 4.964 | tCL | RR | 9528 | PLL_T[0] | audio_clock/pll_49m152/pll/CLKOUT0
7.063 | 2.099 | tNET | RR | 1 | R43C141[2][B] | ready_sync_s0/CLK
7.431 | 0.368 | tC2Q | RF | 11 | R43C141[2][B] | ready_sync_s0/Q
8.618 | 1.187 | tNET | FF | 1 | R24C123[0][A] | rst_n_s0/I1
9.079 | 0.461 | tINS | FR | 463 | R24C123[0][A] | rst_n_s0/F
10.101 | 1.021 | tNET | RR | 1 | R27C109[3][B] | system/audio_rst_n_s1/I3
10.522 | 0.421 | tINS | RF | 3143 | R27C109[3][B] | system/audio_rst_n_s1/F
13.790 | 3.268 | tNET | FF | 1 | R45C60[2][A] | system/effects/aout0_4_s0/CLEAR

Data Required Path:

AT | DELAY | TYPE | RF | FANOUT | LOC | NODE
20.345 | 20.345 | | | | | active clock edge time
20.345 | 0.000 | | | | | audio_clock/pll_49m152/pll/CLKOUT0.default_gen_clk
25.309 | 4.964 | tCL | RR | 9528 | PLL_T[0] | audio_clock/pll_49m152/pll/CLKOUT0
27.408 | 2.099 | tNET | RR | 1 | R45C60[2][A] | system/effects/aout0_4_s0/CLK
27.061 | -0.347 | tSu | | 1 | R45C60[2][A] | system/effects/aout0_4_s0

Path Statistics:

Clock Skew | 0.000
Setup Relationship | 20.345
Logic Level | 3
Arrival Clock Path Delay | cell: 0.000, 0.000%; route: 2.099, 100.000%
Arrival Data Path Delay | cell: 0.882, 13.119%; route: 5.477, 81.418%; tC2Q: 0.368, 5.463%
Required Clock Path Delay | cell: 0.000, 0.000%; route: 2.099, 100.000%

### Path22

Path Summary:

Slack | 13.271
Data Arrival Time | 13.790
Data Required Time | 27.061
From | ready_sync_s0
To | system/effects/aout0_5_s0
Launch Clk | audio_clock/pll_49m152/pll/CLKOUT0.default_gen_clk:[R]
Latch Clk | audio_clock/pll_49m152/pll/CLKOUT0.default_gen_clk:[R]

Data Arrival Path:

AT | DELAY | TYPE | RF | FANOUT | LOC | NODE
0.000 | 0.000 | | | | | active clock edge time
0.000 | 0.000 | | | | | audio_clock/pll_49m152/pll/CLKOUT0.default_gen_clk
4.964 | 4.964 | tCL | RR | 9528 | PLL_T[0] | audio_clock/pll_49m152/pll/CLKOUT0
7.063 | 2.099 | tNET | RR | 1 | R43C141[2][B] | ready_sync_s0/CLK
7.431 | 0.368 | tC2Q | RF | 11 | R43C141[2][B] | ready_sync_s0/Q
8.618 | 1.187 | tNET | FF | 1 | R24C123[0][A] | rst_n_s0/I1
9.079 | 0.461 | tINS | FR | 463 | R24C123[0][A] | rst_n_s0/F
10.101 | 1.021 | tNET | RR | 1 | R27C109[3][B] | system/audio_rst_n_s1/I3
10.522 | 0.421 | tINS | RF | 3143 | R27C109[3][B] | system/audio_rst_n_s1/F
13.790 | 3.268 | tNET | FF | 1 | R45C60[2][B] | system/effects/aout0_5_s0/CLEAR

Data Required Path:

AT | DELAY | TYPE | RF | FANOUT | LOC | NODE
20.345 | 20.345 | | | | | active clock edge time
20.345 | 0.000 | | | | | audio_clock/pll_49m152/pll/CLKOUT0.default_gen_clk
25.309 | 4.964 | tCL | RR | 9528 | PLL_T[0] | audio_clock/pll_49m152/pll/CLKOUT0
27.408 | 2.099 | tNET | RR | 1 | R45C60[2][B] | system/effects/aout0_5_s0/CLK
27.061 | -0.347 | tSu | | 1 | R45C60[2][B] | system/effects/aout0_5_s0

Path Statistics:

Clock Skew | 0.000
Setup Relationship | 20.345
Logic Level | 3
Arrival Clock Path Delay | cell: 0.000, 0.000%; route: 2.099, 100.000%
Arrival Data Path Delay | cell: 0.882, 13.119%; route: 5.477, 81.418%; tC2Q: 0.368, 5.463%
Required Clock Path Delay | cell: 0.000, 0.000%; route: 2.099, 100.000%

### Path23

Path Summary:

Slack | 13.273
Data Arrival Time | 13.779
Data Required Time | 27.051
From | ready_sync_s0
To | system/effects/comb_average_15_s0
Launch Clk | audio_clock/pll_49m152/pll/CLKOUT0.default_gen_clk:[R]
Latch Clk | audio_clock/pll_49m152/pll/CLKOUT0.default_gen_clk:[R]

Data Arrival Path:

AT | DELAY | TYPE | RF | FANOUT | LOC | NODE
0.000 | 0.000 | | | | | active clock edge time
0.000 | 0.000 | | | | | audio_clock/pll_49m152/pll/CLKOUT0.default_gen_clk
4.964 | 4.964 | tCL | RR | 9528 | PLL_T[0] | audio_clock/pll_49m152/pll/CLKOUT0
7.063 | 2.099 | tNET | RR | 1 | R43C141[2][B] | ready_sync_s0/CLK
7.431 | 0.368 | tC2Q | RF | 11 | R43C141[2][B] | ready_sync_s0/Q
8.618 | 1.187 | tNET | FF | 1 | R24C123[0][A] | rst_n_s0/I1
9.079 | 0.461 | tINS | FR | 463 | R24C123[0][A] | rst_n_s0/F
10.101 | 1.021 | tNET | RR | 1 | R27C109[3][B] | system/audio_rst_n_s1/I3
10.522 | 0.421 | tINS | RF | 3143 | R27C109[3][B] | system/audio_rst_n_s1/F
13.779 | 3.257 | tNET | FF | 1 | R44C59[0][A] | system/effects/comb_average_15_s0/CLEAR

Data Required Path:

AT | DELAY | TYPE | RF | FANOUT | LOC | NODE
20.345 | 20.345 | | | | | active clock edge time
20.345 | 0.000 | | | | | audio_clock/pll_49m152/pll/CLKOUT0.default_gen_clk
25.309 | 4.964 | tCL | RR | 9528 | PLL_T[0] | audio_clock/pll_49m152/pll/CLKOUT0
27.399 | 2.090 | tNET | RR | 1 | R44C59[0][A] | system/effects/comb_average_15_s0/CLK
27.051 | -0.347 | tSu | | 1 | R44C59[0][A] | system/effects/comb_average_15_s0

Path Statistics:

Clock Skew | -0.009
Setup Relationship | 20.345
Logic Level | 3
Arrival Clock Path Delay | cell: 0.000, 0.000%; route: 2.099, 100.000%
Arrival Data Path Delay | cell: 0.882, 13.141%; route: 5.466, 81.387%; tC2Q: 0.368, 5.472%
Required Clock Path Delay | cell: 0.000, 0.000%; route: 2.090, 100.000%

### Path24

Path Summary:

Slack | 13.273
Data Arrival Time | 13.788
Data Required Time | 27.061
From | ready_sync_s0
To | system/effects/comb_average_9_s0
Launch Clk | audio_clock/pll_49m152/pll/CLKOUT0.default_gen_clk:[R]
Latch Clk | audio_clock/pll_49m152/pll/CLKOUT0.default_gen_clk:[R]

Data Arrival Path:

AT | DELAY | TYPE | RF | FANOUT | LOC | NODE
0.000 | 0.000 | | | | | active clock edge time
0.000 | 0.000 | | | | | audio_clock/pll_49m152/pll/CLKOUT0.default_gen_clk
4.964 | 4.964 | tCL | RR | 9528 | PLL_T[0] | audio_clock/pll_49m152/pll/CLKOUT0
7.063 | 2.099 | tNET | RR | 1 | R43C141[2][B] | ready_sync_s0/CLK
7.431 | 0.368 | tC2Q | RF | 11 | R43C141[2][B] | ready_sync_s0/Q
8.618 | 1.187 | tNET | FF | 1 | R24C123[0][A] | rst_n_s0/I1
9.079 | 0.461 | tINS | FR | 463 | R24C123[0][A] | rst_n_s0/F
10.101 | 1.021 | tNET | RR | 1 | R27C109[3][B] | system/audio_rst_n_s1/I3
10.522 | 0.421 | tINS | RF | 3143 | R27C109[3][B] | system/audio_rst_n_s1/F
13.788 | 3.266 | tNET | FF | 1 | R44C56[2][A] | system/effects/comb_average_9_s0/CLEAR

Data Required Path:

AT | DELAY | TYPE | RF | FANOUT | LOC | NODE
20.345 | 20.345 | | | | | active clock edge time
20.345 | 0.000 | | | | | audio_clock/pll_49m152/pll/CLKOUT0.default_gen_clk
25.309 | 4.964 | tCL | RR | 9528 | PLL_T[0] | audio_clock/pll_49m152/pll/CLKOUT0
27.408 | 2.099 | tNET | RR | 1 | R44C56[2][A] | system/effects/comb_average_9_s0/CLK
27.061 | -0.347 | tSu | | 1 | R44C56[2][A] | system/effects/comb_average_9_s0

Path Statistics:

Clock Skew | 0.000
Setup Relationship | 20.345
Logic Level | 3
Arrival Clock Path Delay | cell: 0.000, 0.000%; route: 2.099, 100.000%
Arrival Data Path Delay | cell: 0.882, 13.123%; route: 5.475, 81.413%; tC2Q: 0.368, 5.465%
Required Clock Path Delay | cell: 0.000, 0.000%; route: 2.099, 100.000%

### Path25

Path Summary:

Slack | 13.273
Data Arrival Time | 13.788
Data Required Time | 27.061
From | ready_sync_s0
To | system/synth/u_polar0/v_0_s0
Launch Clk | audio_clock/pll_49m152/pll/CLKOUT0.default_gen_clk:[R]
Latch Clk | audio_clock/pll_49m152/pll/CLKOUT0.default_gen_clk:[R]

Data Arrival Path:

AT | DELAY | TYPE | RF | FANOUT | LOC | NODE
0.000 | 0.000 | | | | | active clock edge time
0.000 | 0.000 | | | | | audio_clock/pll_49m152/pll/CLKOUT0.default_gen_clk
4.964 | 4.964 | tCL | RR | 9528 | PLL_T[0] | audio_clock/pll_49m152/pll/CLKOUT0
7.063 | 2.099 | tNET | RR | 1 | R43C141[2][B] | ready_sync_s0/CLK
7.431 | 0.368 | tC2Q | RF | 11 | R43C141[2][B] | ready_sync_s0/Q
8.618 | 1.187 | tNET | FF | 1 | R24C123[0][A] | rst_n_s0/I1
9.079 | 0.461 | tINS | FR | 463 | R24C123[0][A] | rst_n_s0/F
10.101 | 1.021 | tNET | RR | 1 | R27C109[3][B] | system/audio_rst_n_s1/I3
10.522 | 0.421 | tINS | RF | 3143 | R27C109[3][B] | system/audio_rst_n_s1/F
13.788 | 3.266 | tNET | FF | 1 | R44C68[2][A] | system/synth/u_polar0/v_0_s0/CLEAR

Data Required Path:

AT | DELAY | TYPE | RF | FANOUT | LOC | NODE
20.345 | 20.345 | | | | | active clock edge time
20.345 | 0.000 | | | | | audio_clock/pll_49m152/pll/CLKOUT0.default_gen_clk
25.309 | 4.964 | tCL | RR | 9528 | PLL_T[0] | audio_clock/pll_49m152/pll/CLKOUT0
27.408 | 2.099 | tNET | RR | 1 | R44C68[2][A] | system/synth/u_polar0/v_0_s0/CLK
27.061 | -0.347 | tSu | | 1 | R44C68[2][A] | system/synth/u_polar0/v_0_s0

Path Statistics:

Clock Skew | 0.000
Setup Relationship | 20.345
Logic Level | 3
Arrival Clock Path Delay | cell: 0.000, 0.000%; route: 2.099, 100.000%
Arrival Data Path Delay | cell: 0.882, 13.123%; route: 5.475, 81.413%; tC2Q: 0.368, 5.465%
Required Clock Path Delay | cell: 0.000, 0.000%; route: 2.099, 100.000%

### Removal Analysis Report

#### Report Command:report_timing -removal -max_paths 25 -max_common_paths 1

### Path1

Path Summary:

Slack | 0.386
Data Arrival Time | 2.383
Data Required Time | 1.997
From | audio_clock/first_lock_stable_s0
To | audio_clock/pll_49m152/init/rEnable_1_s0
Launch Clk | sys_clk:[R]
Latch Clk | sys_clk:[R]

Data Arrival Path:

AT | DELAY | TYPE | RF | FANOUT | LOC | NODE
0.000 | 0.000 | | | | | active clock edge time
0.000 | 0.000 | | | | | sys_clk
0.000 | 0.000 | tCL | RR | 1 | IOB117[B] | sys_clk_ibuf/I
0.675 | 0.675 | tINS | RR | 513 | IOB117[B] | sys_clk_ibuf/O
2.054 | 1.379 | tNET | RR | 1 | R37C134[2][A] | audio_clock/first_lock_stable_s0/CLK
2.198 | 0.144 | tC2Q | RR | 7 | R37C134[2][A] | audio_clock/first_lock_stable_s0/Q
2.383 | 0.185 | tNET | RR | 1 | R33C133[2][A] | audio_clock/pll_49m152/init/rEnable_1_s0/CLEAR

Data Required Path:

AT | DELAY | TYPE | RF | FANOUT | LOC | NODE
0.000 | 0.000 | | | | | active clock edge time
0.000 | 0.000 | | | | | sys_clk
0.000 | 0.000 | tCL | RR | 1 | IOB117[B] | sys_clk_ibuf/I
0.675 | 0.675 | tINS | RR | 513 | IOB117[B] | sys_clk_ibuf/O
2.050 | 1.375 | tNET | RR | 1 | R33C133[2][A] | audio_clock/pll_49m152/init/rEnable_1_s0/CLK
1.997 | -0.053 | tHld | | 1 | R33C133[2][A] | audio_clock/pll_49m152/init/rEnable_1_s0

Path Statistics:

Clock Skew | -0.004
Hold Relationship | 0.000
Logic Level | 1
Arrival Clock Path Delay | cell: 0.675, 32.879%; route: 1.379, 67.121%
Arrival Data Path Delay | cell: 0.000, 0.000%; route: 0.185, 56.231%; tC2Q: 0.144, 43.769%
Required Clock Path Delay | cell: 0.675, 32.943%; route: 1.375, 67.057%

### Path2

Path Summary:

Slack | 0.386
Data Arrival Time | 2.383
Data Required Time | 1.997
From | audio_clock/first_lock_stable_s0
To | audio_clock/pll_49m152/init/rEnable_0_s0
Launch Clk | sys_clk:[R]
Latch Clk | sys_clk:[R]

Data Arrival Path:

AT | DELAY | TYPE | RF | FANOUT | LOC | NODE
0.000 | 0.000 | | | | | active clock edge time
0.000 | 0.000 | | | | | sys_clk
0.000 | 0.000 | tCL | RR | 1 | IOB117[B] | sys_clk_ibuf/I
0.675 | 0.675 | tINS | RR | 513 | IOB117[B] | sys_clk_ibuf/O
2.054 | 1.379 | tNET | RR | 1 | R37C134[2][A] | audio_clock/first_lock_stable_s0/CLK
2.198 | 0.144 | tC2Q | RR | 7 | R37C134[2][A] | audio_clock/first_lock_stable_s0/Q
2.383 | 0.185 | tNET | RR | 1 | R33C133[0][A] | audio_clock/pll_49m152/init/rEnable_0_s0/CLEAR

Data Required Path:

AT | DELAY | TYPE | RF | FANOUT | LOC | NODE
0.000 | 0.000 | | | | | active clock edge time
0.000 | 0.000 | | | | | sys_clk
0.000 | 0.000 | tCL | RR | 1 | IOB117[B] | sys_clk_ibuf/I
0.675 | 0.675 | tINS | RR | 513 | IOB117[B] | sys_clk_ibuf/O
2.050 | 1.375 | tNET | RR | 1 | R33C133[0][A] | audio_clock/pll_49m152/init/rEnable_0_s0/CLK
1.997 | -0.053 | tHld | | 1 | R33C133[0][A] | audio_clock/pll_49m152/init/rEnable_0_s0

Path Statistics:

Clock Skew | -0.004
Hold Relationship | 0.000
Logic Level | 1
Arrival Clock Path Delay | cell: 0.675, 32.879%; route: 1.379, 67.121%
Arrival Data Path Delay | cell: 0.000, 0.000%; route: 0.185, 56.231%; tC2Q: 0.144, 43.769%
Required Clock Path Delay | cell: 0.675, 32.943%; route: 1.375, 67.057%

### Path3

Path Summary:

Slack | 1.844
Data Arrival Time | 7.629
Data Required Time | 5.785
From | system/sensors/eventizer/overflow_s0
To | system/monitor/bundle_18_s0
Launch Clk | audio_clock/pll_49m152/pll/CLKOUT0.default_gen_clk:[R]
Latch Clk | audio_clock/pll_49m152/pll/CLKOUT0.default_gen_clk:[R]

Data Arrival Path:

AT | DELAY | TYPE | RF | FANOUT | LOC | NODE
0.000 | 0.000 | | | | | active clock edge time
0.000 | 0.000 | | | | | audio_clock/pll_49m152/pll/CLKOUT0.default_gen_clk
4.964 | 4.964 | tCL | RR | 9528 | PLL_T[0] | audio_clock/pll_49m152/pll/CLKOUT0
5.641 | 0.677 | tNET | RR | 1 | R26C110[2][A] | system/sensors/eventizer/overflow_s0/CLK
5.785 | 0.144 | tC2Q | RR | 2 | R26C110[2][A] | system/sensors/eventizer/overflow_s0/Q
5.991 | 0.206 | tNET | RR | 1 | R27C109[3][B] | system/audio_rst_n_s1/I0
6.189 | 0.198 | tINS | RR | 3143 | R27C109[3][B] | system/audio_rst_n_s1/F
7.629 | 1.440 | tNET | RR | 1 | R37C5[2][A] | system/monitor/bundle_18_s0/CLEAR

Data Required Path:

AT | DELAY | TYPE | RF | FANOUT | LOC | NODE
0.000 | 0.000 | | | | | active clock edge time
0.000 | 0.000 | | | | | audio_clock/pll_49m152/pll/CLKOUT0.default_gen_clk
4.964 | 4.964 | tCL | RR | 9528 | PLL_T[0] | audio_clock/pll_49m152/pll/CLKOUT0
5.838 | 0.874 | tNET | RR | 1 | R37C5[2][A] | system/monitor/bundle_18_s0/CLK
5.785 | -0.053 | tHld | | 1 | R37C5[2][A] | system/monitor/bundle_18_s0

Path Statistics:

Clock Skew | 0.197
Hold Relationship | 0.000
Logic Level | 2
Arrival Clock Path Delay | cell: 0.000, 0.000%; route: 0.677, 100.000%
Arrival Data Path Delay | cell: 0.198, 9.960%; route: 1.646, 82.797%; tC2Q: 0.144, 7.243%
Required Clock Path Delay | cell: 0.000, 0.000%; route: 0.874, 100.000%

### Path4

Path Summary:

Slack | 1.844
Data Arrival Time | 7.629
Data Required Time | 5.785
From | system/sensors/eventizer/overflow_s0
To | system/synth/u_polar0/right_10_s0
Launch Clk | audio_clock/pll_49m152/pll/CLKOUT0.default_gen_clk:[R]
Latch Clk | audio_clock/pll_49m152/pll/CLKOUT0.default_gen_clk:[R]

Data Arrival Path:

AT | DELAY | TYPE | RF | FANOUT | LOC | NODE
0.000 | 0.000 | | | | | active clock edge time
0.000 | 0.000 | | | | | audio_clock/pll_49m152/pll/CLKOUT0.default_gen_clk
4.964 | 4.964 | tCL | RR | 9528 | PLL_T[0] | audio_clock/pll_49m152/pll/CLKOUT0
5.641 | 0.677 | tNET | RR | 1 | R26C110[2][A] | system/sensors/eventizer/overflow_s0/CLK
5.785 | 0.144 | tC2Q | RR | 2 | R26C110[2][A] | system/sensors/eventizer/overflow_s0/Q
5.991 | 0.206 | tNET | RR | 1 | R27C109[3][B] | system/audio_rst_n_s1/I0
6.189 | 0.198 | tINS | RR | 3143 | R27C109[3][B] | system/audio_rst_n_s1/F
7.629 | 1.440 | tNET | RR | 1 | R37C61[3][A] | system/synth/u_polar0/right_10_s0/CLEAR

Data Required Path:

AT | DELAY | TYPE | RF | FANOUT | LOC | NODE
0.000 | 0.000 | | | | | active clock edge time
0.000 | 0.000 | | | | | audio_clock/pll_49m152/pll/CLKOUT0.default_gen_clk
4.964 | 4.964 | tCL | RR | 9528 | PLL_T[0] | audio_clock/pll_49m152/pll/CLKOUT0
5.838 | 0.874 | tNET | RR | 1 | R37C61[3][A] | system/synth/u_polar0/right_10_s0/CLK
5.785 | -0.053 | tHld | | 1 | R37C61[3][A] | system/synth/u_polar0/right_10_s0

Path Statistics:

Clock Skew | 0.197
Hold Relationship | 0.000
Logic Level | 2
Arrival Clock Path Delay | cell: 0.000, 0.000%; route: 0.677, 100.000%
Arrival Data Path Delay | cell: 0.198, 9.960%; route: 1.646, 82.797%; tC2Q: 0.144, 7.243%
Required Clock Path Delay | cell: 0.000, 0.000%; route: 0.874, 100.000%

### Path5

Path Summary:

Slack | 1.849
Data Arrival Time | 7.634
Data Required Time | 5.785
From | system/sensors/eventizer/overflow_s0
To | system/monitor/bundle_17_s0
Launch Clk | audio_clock/pll_49m152/pll/CLKOUT0.default_gen_clk:[R]
Latch Clk | audio_clock/pll_49m152/pll/CLKOUT0.default_gen_clk:[R]

Data Arrival Path:

AT | DELAY | TYPE | RF | FANOUT | LOC | NODE
0.000 | 0.000 | | | | | active clock edge time
0.000 | 0.000 | | | | | audio_clock/pll_49m152/pll/CLKOUT0.default_gen_clk
4.964 | 4.964 | tCL | RR | 9528 | PLL_T[0] | audio_clock/pll_49m152/pll/CLKOUT0
5.641 | 0.677 | tNET | RR | 1 | R26C110[2][A] | system/sensors/eventizer/overflow_s0/CLK
5.785 | 0.144 | tC2Q | RR | 2 | R26C110[2][A] | system/sensors/eventizer/overflow_s0/Q
5.991 | 0.206 | tNET | RR | 1 | R27C109[3][B] | system/audio_rst_n_s1/I0
6.189 | 0.198 | tINS | RR | 3143 | R27C109[3][B] | system/audio_rst_n_s1/F
7.634 | 1.445 | tNET | RR | 1 | R36C5[0][A] | system/monitor/bundle_17_s0/CLEAR

Data Required Path:

AT | DELAY | TYPE | RF | FANOUT | LOC | NODE
0.000 | 0.000 | | | | | active clock edge time
0.000 | 0.000 | | | | | audio_clock/pll_49m152/pll/CLKOUT0.default_gen_clk
4.964 | 4.964 | tCL | RR | 9528 | PLL_T[0] | audio_clock/pll_49m152/pll/CLKOUT0
5.838 | 0.874 | tNET | RR | 1 | R36C5[0][A] | system/monitor/bundle_17_s0/CLK
5.785 | -0.053 | tHld | | 1 | R36C5[0][A] | system/monitor/bundle_17_s0

Path Statistics:

Clock Skew | 0.197
Hold Relationship | 0.000
Logic Level | 2
Arrival Clock Path Delay | cell: 0.000, 0.000%; route: 0.677, 100.000%
Arrival Data Path Delay | cell: 0.198, 9.935%; route: 1.651, 82.840%; tC2Q: 0.144, 7.225%
Required Clock Path Delay | cell: 0.000, 0.000%; route: 0.874, 100.000%

### Path6

Path Summary:

Slack | 1.849
Data Arrival Time | 7.634
Data Required Time | 5.785
From | system/sensors/eventizer/overflow_s0
To | system/synth/u_polar0/right_11_s0
Launch Clk | audio_clock/pll_49m152/pll/CLKOUT0.default_gen_clk:[R]
Latch Clk | audio_clock/pll_49m152/pll/CLKOUT0.default_gen_clk:[R]

Data Arrival Path:

AT | DELAY | TYPE | RF | FANOUT | LOC | NODE
0.000 | 0.000 | | | | | active clock edge time
0.000 | 0.000 | | | | | audio_clock/pll_49m152/pll/CLKOUT0.default_gen_clk
4.964 | 4.964 | tCL | RR | 9528 | PLL_T[0] | audio_clock/pll_49m152/pll/CLKOUT0
5.641 | 0.677 | tNET | RR | 1 | R26C110[2][A] | system/sensors/eventizer/overflow_s0/CLK
5.785 | 0.144 | tC2Q | RR | 2 | R26C110[2][A] | system/sensors/eventizer/overflow_s0/Q
5.991 | 0.206 | tNET | RR | 1 | R27C109[3][B] | system/audio_rst_n_s1/I0
6.189 | 0.198 | tINS | RR | 3143 | R27C109[3][B] | system/audio_rst_n_s1/F
7.634 | 1.445 | tNET | RR | 1 | R36C61[3][A] | system/synth/u_polar0/right_11_s0/CLEAR

Data Required Path:

AT | DELAY | TYPE | RF | FANOUT | LOC | NODE
0.000 | 0.000 | | | | | active clock edge time
0.000 | 0.000 | | | | | audio_clock/pll_49m152/pll/CLKOUT0.default_gen_clk
4.964 | 4.964 | tCL | RR | 9528 | PLL_T[0] | audio_clock/pll_49m152/pll/CLKOUT0
5.838 | 0.874 | tNET | RR | 1 | R36C61[3][A] | system/synth/u_polar0/right_11_s0/CLK
5.785 | -0.053 | tHld | | 1 | R36C61[3][A] | system/synth/u_polar0/right_11_s0

Path Statistics:

Clock Skew | 0.197
Hold Relationship | 0.000
Logic Level | 2
Arrival Clock Path Delay | cell: 0.000, 0.000%; route: 0.677, 100.000%
Arrival Data Path Delay | cell: 0.198, 9.935%; route: 1.651, 82.840%; tC2Q: 0.144, 7.225%
Required Clock Path Delay | cell: 0.000, 0.000%; route: 0.874, 100.000%

### Path7

Path Summary:

Slack | 1.849
Data Arrival Time | 7.634
Data Required Time | 5.785
From | system/sensors/eventizer/overflow_s0
To | system/synth/u_polar0/right_30_s0
Launch Clk | audio_clock/pll_49m152/pll/CLKOUT0.default_gen_clk:[R]
Latch Clk | audio_clock/pll_49m152/pll/CLKOUT0.default_gen_clk:[R]

Data Arrival Path:

AT | DELAY | TYPE | RF | FANOUT | LOC | NODE
0.000 | 0.000 | | | | | active clock edge time
0.000 | 0.000 | | | | | audio_clock/pll_49m152/pll/CLKOUT0.default_gen_clk
4.964 | 4.964 | tCL | RR | 9528 | PLL_T[0] | audio_clock/pll_49m152/pll/CLKOUT0
5.641 | 0.677 | tNET | RR | 1 | R26C110[2][A] | system/sensors/eventizer/overflow_s0/CLK
5.785 | 0.144 | tC2Q | RR | 2 | R26C110[2][A] | system/sensors/eventizer/overflow_s0/Q
5.991 | 0.206 | tNET | RR | 1 | R27C109[3][B] | system/audio_rst_n_s1/I0
6.189 | 0.198 | tINS | RR | 3143 | R27C109[3][B] | system/audio_rst_n_s1/F
7.634 | 1.445 | tNET | RR | 1 | R36C65[2][A] | system/synth/u_polar0/right_30_s0/CLEAR

Data Required Path:

AT | DELAY | TYPE | RF | FANOUT | LOC | NODE
0.000 | 0.000 | | | | | active clock edge time
0.000 | 0.000 | | | | | audio_clock/pll_49m152/pll/CLKOUT0.default_gen_clk
4.964 | 4.964 | tCL | RR | 9528 | PLL_T[0] | audio_clock/pll_49m152/pll/CLKOUT0
5.838 | 0.874 | tNET | RR | 1 | R36C65[2][A] | system/synth/u_polar0/right_30_s0/CLK
5.785 | -0.053 | tHld | | 1 | R36C65[2][A] | system/synth/u_polar0/right_30_s0

Path Statistics:

Clock Skew | 0.197
Hold Relationship | 0.000
Logic Level | 2
Arrival Clock Path Delay | cell: 0.000, 0.000%; route: 0.677, 100.000%
Arrival Data Path Delay | cell: 0.198, 9.935%; route: 1.651, 82.840%; tC2Q: 0.144, 7.225%
Required Clock Path Delay | cell: 0.000, 0.000%; route: 0.874, 100.000%

### Path8

Path Summary:

Slack | 1.852
Data Arrival Time | 7.629
Data Required Time | 5.777
From | system/sensors/eventizer/overflow_s0
To | system/synth/u_polar0/sumR_4_s0
Launch Clk | audio_clock/pll_49m152/pll/CLKOUT0.default_gen_clk:[R]
Latch Clk | audio_clock/pll_49m152/pll/CLKOUT0.default_gen_clk:[R]

Data Arrival Path:

AT | DELAY | TYPE | RF | FANOUT | LOC | NODE
0.000 | 0.000 | | | | | active clock edge time
0.000 | 0.000 | | | | | audio_clock/pll_49m152/pll/CLKOUT0.default_gen_clk
4.964 | 4.964 | tCL | RR | 9528 | PLL_T[0] | audio_clock/pll_49m152/pll/CLKOUT0
5.641 | 0.677 | tNET | RR | 1 | R26C110[2][A] | system/sensors/eventizer/overflow_s0/CLK
5.785 | 0.144 | tC2Q | RR | 2 | R26C110[2][A] | system/sensors/eventizer/overflow_s0/Q
5.991 | 0.206 | tNET | RR | 1 | R27C109[3][B] | system/audio_rst_n_s1/I0
6.189 | 0.198 | tINS | RR | 3143 | R27C109[3][B] | system/audio_rst_n_s1/F
7.629 | 1.440 | tNET | RR | 1 | R37C63[3][A] | system/synth/u_polar0/sumR_4_s0/CLEAR

Data Required Path:

AT | DELAY | TYPE | RF | FANOUT | LOC | NODE
0.000 | 0.000 | | | | | active clock edge time
0.000 | 0.000 | | | | | audio_clock/pll_49m152/pll/CLKOUT0.default_gen_clk
4.964 | 4.964 | tCL | RR | 9528 | PLL_T[0] | audio_clock/pll_49m152/pll/CLKOUT0
5.830 | 0.866 | tNET | RR | 1 | R37C63[3][A] | system/synth/u_polar0/sumR_4_s0/CLK
5.777 | -0.053 | tHld | | 1 | R37C63[3][A] | system/synth/u_polar0/sumR_4_s0

Path Statistics:

Clock Skew | 0.189
Hold Relationship | 0.000
Logic Level | 2
Arrival Clock Path Delay | cell: 0.000, 0.000%; route: 0.677, 100.000%
Arrival Data Path Delay | cell: 0.198, 9.960%; route: 1.646, 82.797%; tC2Q: 0.144, 7.243%
Required Clock Path Delay | cell: 0.000, 0.000%; route: 0.866, 100.000%

### Path9

Path Summary:

Slack | 1.852
Data Arrival Time | 7.633
Data Required Time | 5.781
From | system/sensors/eventizer/overflow_s0
To | system/synth/u_polar0/sumR_5_s0
Launch Clk | audio_clock/pll_49m152/pll/CLKOUT0.default_gen_clk:[R]
Latch Clk | audio_clock/pll_49m152/pll/CLKOUT0.default_gen_clk:[R]

Data Arrival Path:

AT | DELAY | TYPE | RF | FANOUT | LOC | NODE
0.000 | 0.000 | | | | | active clock edge time
0.000 | 0.000 | | | | | audio_clock/pll_49m152/pll/CLKOUT0.default_gen_clk
4.964 | 4.964 | tCL | RR | 9528 | PLL_T[0] | audio_clock/pll_49m152/pll/CLKOUT0
5.641 | 0.677 | tNET | RR | 1 | R26C110[2][A] | system/sensors/eventizer/overflow_s0/CLK
5.785 | 0.144 | tC2Q | RR | 2 | R26C110[2][A] | system/sensors/eventizer/overflow_s0/Q
5.991 | 0.206 | tNET | RR | 1 | R27C109[3][B] | system/audio_rst_n_s1/I0
6.189 | 0.198 | tINS | RR | 3143 | R27C109[3][B] | system/audio_rst_n_s1/F
7.633 | 1.444 | tNET | RR | 1 | R37C64[2][B] | system/synth/u_polar0/sumR_5_s0/CLEAR

Data Required Path:

AT | DELAY | TYPE | RF | FANOUT | LOC | NODE
0.000 | 0.000 | | | | | active clock edge time
0.000 | 0.000 | | | | | audio_clock/pll_49m152/pll/CLKOUT0.default_gen_clk
4.964 | 4.964 | tCL | RR | 9528 | PLL_T[0] | audio_clock/pll_49m152/pll/CLKOUT0
5.834 | 0.870 | tNET | RR | 1 | R37C64[2][B] | system/synth/u_polar0/sumR_5_s0/CLK
5.781 | -0.053 | tHld | | 1 | R37C64[2][B] | system/synth/u_polar0/sumR_5_s0

Path Statistics:

Clock Skew | 0.193
Hold Relationship | 0.000
Logic Level | 2
Arrival Clock Path Delay | cell: 0.000, 0.000%; route: 0.677, 100.000%
Arrival Data Path Delay | cell: 0.198, 9.940%; route: 1.650, 82.831%; tC2Q: 0.144, 7.229%
Required Clock Path Delay | cell: 0.000, 0.000%; route: 0.870, 100.000%

### Path10

Path Summary:

Slack | 1.852
Data Arrival Time | 7.633
Data Required Time | 5.781
From | system/sensors/eventizer/overflow_s0
To | system/synth/u_polar0/sumR_13_s0
Launch Clk | audio_clock/pll_49m152/pll/CLKOUT0.default_gen_clk:[R]
Latch Clk | audio_clock/pll_49m152/pll/CLKOUT0.default_gen_clk:[R]

Data Arrival Path:

AT | DELAY | TYPE | RF | FANOUT | LOC | NODE
0.000 | 0.000 | | | | | active clock edge time
0.000 | 0.000 | | | | | audio_clock/pll_49m152/pll/CLKOUT0.default_gen_clk
4.964 | 4.964 | tCL | RR | 9528 | PLL_T[0] | audio_clock/pll_49m152/pll/CLKOUT0
5.641 | 0.677 | tNET | RR | 1 | R26C110[2][A] | system/sensors/eventizer/overflow_s0/CLK
5.785 | 0.144 | tC2Q | RR | 2 | R26C110[2][A] | system/sensors/eventizer/overflow_s0/Q
5.991 | 0.206 | tNET | RR | 1 | R27C109[3][B] | system/audio_rst_n_s1/I0
6.189 | 0.198 | tINS | RR | 3143 | R27C109[3][B] | system/audio_rst_n_s1/F
7.633 | 1.444 | tNET | RR | 1 | R37C64[3][A] | system/synth/u_polar0/sumR_13_s0/CLEAR

Data Required Path:

AT | DELAY | TYPE | RF | FANOUT | LOC | NODE
0.000 | 0.000 | | | | | active clock edge time
0.000 | 0.000 | | | | | audio_clock/pll_49m152/pll/CLKOUT0.default_gen_clk
4.964 | 4.964 | tCL | RR | 9528 | PLL_T[0] | audio_clock/pll_49m152/pll/CLKOUT0
5.834 | 0.870 | tNET | RR | 1 | R37C64[3][A] | system/synth/u_polar0/sumR_13_s0/CLK
5.781 | -0.053 | tHld | | 1 | R37C64[3][A] | system/synth/u_polar0/sumR_13_s0

Path Statistics:

Clock Skew | 0.193
Hold Relationship | 0.000
Logic Level | 2
Arrival Clock Path Delay | cell: 0.000, 0.000%; route: 0.677, 100.000%
Arrival Data Path Delay | cell: 0.198, 9.940%; route: 1.650, 82.831%; tC2Q: 0.144, 7.229%
Required Clock Path Delay | cell: 0.000, 0.000%; route: 0.870, 100.000%

### Path11

Path Summary:

Slack | 1.852
Data Arrival Time | 7.633
Data Required Time | 5.781
From | system/sensors/eventizer/overflow_s0
To | system/synth/u_polar0/sumR_16_s0
Launch Clk | audio_clock/pll_49m152/pll/CLKOUT0.default_gen_clk:[R]
Latch Clk | audio_clock/pll_49m152/pll/CLKOUT0.default_gen_clk:[R]

Data Arrival Path:

AT | DELAY | TYPE | RF | FANOUT | LOC | NODE
0.000 | 0.000 | | | | | active clock edge time
0.000 | 0.000 | | | | | audio_clock/pll_49m152/pll/CLKOUT0.default_gen_clk
4.964 | 4.964 | tCL | RR | 9528 | PLL_T[0] | audio_clock/pll_49m152/pll/CLKOUT0
5.641 | 0.677 | tNET | RR | 1 | R26C110[2][A] | system/sensors/eventizer/overflow_s0/CLK
5.785 | 0.144 | tC2Q | RR | 2 | R26C110[2][A] | system/sensors/eventizer/overflow_s0/Q
5.991 | 0.206 | tNET | RR | 1 | R27C109[3][B] | system/audio_rst_n_s1/I0
6.189 | 0.198 | tINS | RR | 3143 | R27C109[3][B] | system/audio_rst_n_s1/F
7.633 | 1.444 | tNET | RR | 1 | R37C64[1][A] | system/synth/u_polar0/sumR_16_s0/CLEAR

Data Required Path:

AT | DELAY | TYPE | RF | FANOUT | LOC | NODE
0.000 | 0.000 | | | | | active clock edge time
0.000 | 0.000 | | | | | audio_clock/pll_49m152/pll/CLKOUT0.default_gen_clk
4.964 | 4.964 | tCL | RR | 9528 | PLL_T[0] | audio_clock/pll_49m152/pll/CLKOUT0
5.834 | 0.870 | tNET | RR | 1 | R37C64[1][A] | system/synth/u_polar0/sumR_16_s0/CLK
5.781 | -0.053 | tHld | | 1 | R37C64[1][A] | system/synth/u_polar0/sumR_16_s0

Path Statistics:

Clock Skew | 0.193
Hold Relationship | 0.000
Logic Level | 2
Arrival Clock Path Delay | cell: 0.000, 0.000%; route: 0.677, 100.000%
Arrival Data Path Delay | cell: 0.198, 9.940%; route: 1.650, 82.831%; tC2Q: 0.144, 7.229%
Required Clock Path Delay | cell: 0.000, 0.000%; route: 0.870, 100.000%

### Path12

Path Summary:

Slack | 1.852
Data Arrival Time | 7.633
Data Required Time | 5.781
From | system/sensors/eventizer/overflow_s0
To | system/synth/u_polar0/sumR_31_s0
Launch Clk | audio_clock/pll_49m152/pll/CLKOUT0.default_gen_clk:[R]
Latch Clk | audio_clock/pll_49m152/pll/CLKOUT0.default_gen_clk:[R]

Data Arrival Path:

AT | DELAY | TYPE | RF | FANOUT | LOC | NODE
0.000 | 0.000 | | | | | active clock edge time
0.000 | 0.000 | | | | | audio_clock/pll_49m152/pll/CLKOUT0.default_gen_clk
4.964 | 4.964 | tCL | RR | 9528 | PLL_T[0] | audio_clock/pll_49m152/pll/CLKOUT0
5.641 | 0.677 | tNET | RR | 1 | R26C110[2][A] | system/sensors/eventizer/overflow_s0/CLK
5.785 | 0.144 | tC2Q | RR | 2 | R26C110[2][A] | system/sensors/eventizer/overflow_s0/Q
5.991 | 0.206 | tNET | RR | 1 | R27C109[3][B] | system/audio_rst_n_s1/I0
6.189 | 0.198 | tINS | RR | 3143 | R27C109[3][B] | system/audio_rst_n_s1/F
7.633 | 1.444 | tNET | RR | 1 | R37C64[2][A] | system/synth/u_polar0/sumR_31_s0/CLEAR

Data Required Path:

AT | DELAY | TYPE | RF | FANOUT | LOC | NODE
0.000 | 0.000 | | | | | active clock edge time
0.000 | 0.000 | | | | | audio_clock/pll_49m152/pll/CLKOUT0.default_gen_clk
4.964 | 4.964 | tCL | RR | 9528 | PLL_T[0] | audio_clock/pll_49m152/pll/CLKOUT0
5.834 | 0.870 | tNET | RR | 1 | R37C64[2][A] | system/synth/u_polar0/sumR_31_s0/CLK
5.781 | -0.053 | tHld | | 1 | R37C64[2][A] | system/synth/u_polar0/sumR_31_s0

Path Statistics:

Clock Skew | 0.193
Hold Relationship | 0.000
Logic Level | 2
Arrival Clock Path Delay | cell: 0.000, 0.000%; route: 0.677, 100.000%
Arrival Data Path Delay | cell: 0.198, 9.940%; route: 1.650, 82.831%; tC2Q: 0.144, 7.229%
Required Clock Path Delay | cell: 0.000, 0.000%; route: 0.870, 100.000%

### Path13

Path Summary:

Slack | 1.854
Data Arrival Time | 7.639
Data Required Time | 5.785
From | system/sensors/eventizer/overflow_s0
To | system/monitor/ack_sync_s0
Launch Clk | audio_clock/pll_49m152/pll/CLKOUT0.default_gen_clk:[R]
Latch Clk | audio_clock/pll_49m152/pll/CLKOUT0.default_gen_clk:[R]

Data Arrival Path:

AT | DELAY | TYPE | RF | FANOUT | LOC | NODE
0.000 | 0.000 | | | | | active clock edge time
0.000 | 0.000 | | | | | audio_clock/pll_49m152/pll/CLKOUT0.default_gen_clk
4.964 | 4.964 | tCL | RR | 9528 | PLL_T[0] | audio_clock/pll_49m152/pll/CLKOUT0
5.641 | 0.677 | tNET | RR | 1 | R26C110[2][A] | system/sensors/eventizer/overflow_s0/CLK
5.785 | 0.144 | tC2Q | RR | 2 | R26C110[2][A] | system/sensors/eventizer/overflow_s0/Q
5.991 | 0.206 | tNET | RR | 1 | R27C109[3][B] | system/audio_rst_n_s1/I0
6.189 | 0.198 | tINS | RR | 3143 | R27C109[3][B] | system/audio_rst_n_s1/F
7.639 | 1.450 | tNET | RR | 1 | R35C5[0][A] | system/monitor/ack_sync_s0/CLEAR

Data Required Path:

AT | DELAY | TYPE | RF | FANOUT | LOC | NODE
0.000 | 0.000 | | | | | active clock edge time
0.000 | 0.000 | | | | | audio_clock/pll_49m152/pll/CLKOUT0.default_gen_clk
4.964 | 4.964 | tCL | RR | 9528 | PLL_T[0] | audio_clock/pll_49m152/pll/CLKOUT0
5.838 | 0.874 | tNET | RR | 1 | R35C5[0][A] | system/monitor/ack_sync_s0/CLK
5.785 | -0.053 | tHld | | 1 | R35C5[0][A] | system/monitor/ack_sync_s0

Path Statistics:

Clock Skew | 0.197
Hold Relationship | 0.000
Logic Level | 2
Arrival Clock Path Delay | cell: 0.000, 0.000%; route: 0.677, 100.000%
Arrival Data Path Delay | cell: 0.198, 9.910%; route: 1.656, 82.883%; tC2Q: 0.144, 7.207%
Required Clock Path Delay | cell: 0.000, 0.000%; route: 0.874, 100.000%

### Path14

Path Summary:

Slack | 1.854
Data Arrival Time | 7.639
Data Required Time | 5.785
From | system/sensors/eventizer/overflow_s0
To | system/effects/cfill1_7_s3
Launch Clk | audio_clock/pll_49m152/pll/CLKOUT0.default_gen_clk:[R]
Latch Clk | audio_clock/pll_49m152/pll/CLKOUT0.default_gen_clk:[R]

Data Arrival Path:

AT | DELAY | TYPE | RF | FANOUT | LOC | NODE
0.000 | 0.000 | | | | | active clock edge time
0.000 | 0.000 | | | | | audio_clock/pll_49m152/pll/CLKOUT0.default_gen_clk
4.964 | 4.964 | tCL | RR | 9528 | PLL_T[0] | audio_clock/pll_49m152/pll/CLKOUT0
5.641 | 0.677 | tNET | RR | 1 | R26C110[2][A] | system/sensors/eventizer/overflow_s0/CLK
5.785 | 0.144 | tC2Q | RR | 2 | R26C110[2][A] | system/sensors/eventizer/overflow_s0/Q
5.991 | 0.206 | tNET | RR | 1 | R27C109[3][B] | system/audio_rst_n_s1/I0
6.189 | 0.198 | tINS | RR | 3143 | R27C109[3][B] | system/audio_rst_n_s1/F
7.639 | 1.450 | tNET | RR | 1 | R35C57[0][B] | system/effects/cfill1_7_s3/CLEAR

Data Required Path:

AT | DELAY | TYPE | RF | FANOUT | LOC | NODE
0.000 | 0.000 | | | | | active clock edge time
0.000 | 0.000 | | | | | audio_clock/pll_49m152/pll/CLKOUT0.default_gen_clk
4.964 | 4.964 | tCL | RR | 9528 | PLL_T[0] | audio_clock/pll_49m152/pll/CLKOUT0
5.838 | 0.874 | tNET | RR | 1 | R35C57[0][B] | system/effects/cfill1_7_s3/CLK
5.785 | -0.053 | tHld | | 1 | R35C57[0][B] | system/effects/cfill1_7_s3

Path Statistics:

Clock Skew | 0.197
Hold Relationship | 0.000
Logic Level | 2
Arrival Clock Path Delay | cell: 0.000, 0.000%; route: 0.677, 100.000%
Arrival Data Path Delay | cell: 0.198, 9.910%; route: 1.656, 82.883%; tC2Q: 0.144, 7.207%
Required Clock Path Delay | cell: 0.000, 0.000%; route: 0.874, 100.000%

### Path15

Path Summary:

Slack | 1.854
Data Arrival Time | 7.639
Data Required Time | 5.785
From | system/sensors/eventizer/overflow_s0
To | system/effects/cfill1_5_s1
Launch Clk | audio_clock/pll_49m152/pll/CLKOUT0.default_gen_clk:[R]
Latch Clk | audio_clock/pll_49m152/pll/CLKOUT0.default_gen_clk:[R]

Data Arrival Path:

AT | DELAY | TYPE | RF | FANOUT | LOC | NODE
0.000 | 0.000 | | | | | active clock edge time
0.000 | 0.000 | | | | | audio_clock/pll_49m152/pll/CLKOUT0.default_gen_clk
4.964 | 4.964 | tCL | RR | 9528 | PLL_T[0] | audio_clock/pll_49m152/pll/CLKOUT0
5.641 | 0.677 | tNET | RR | 1 | R26C110[2][A] | system/sensors/eventizer/overflow_s0/CLK
5.785 | 0.144 | tC2Q | RR | 2 | R26C110[2][A] | system/sensors/eventizer/overflow_s0/Q
5.991 | 0.206 | tNET | RR | 1 | R27C109[3][B] | system/audio_rst_n_s1/I0
6.189 | 0.198 | tINS | RR | 3143 | R27C109[3][B] | system/audio_rst_n_s1/F
7.639 | 1.450 | tNET | RR | 1 | R35C57[3][A] | system/effects/cfill1_5_s1/CLEAR

Data Required Path:

AT | DELAY | TYPE | RF | FANOUT | LOC | NODE
0.000 | 0.000 | | | | | active clock edge time
0.000 | 0.000 | | | | | audio_clock/pll_49m152/pll/CLKOUT0.default_gen_clk
4.964 | 4.964 | tCL | RR | 9528 | PLL_T[0] | audio_clock/pll_49m152/pll/CLKOUT0
5.838 | 0.874 | tNET | RR | 1 | R35C57[3][A] | system/effects/cfill1_5_s1/CLK
5.785 | -0.053 | tHld | | 1 | R35C57[3][A] | system/effects/cfill1_5_s1

Path Statistics:

Clock Skew | 0.197
Hold Relationship | 0.000
Logic Level | 2
Arrival Clock Path Delay | cell: 0.000, 0.000%; route: 0.677, 100.000%
Arrival Data Path Delay | cell: 0.198, 9.910%; route: 1.656, 82.883%; tC2Q: 0.144, 7.207%
Required Clock Path Delay | cell: 0.000, 0.000%; route: 0.874, 100.000%

### Path16

Path Summary:

Slack | 1.854
Data Arrival Time | 7.639
Data Required Time | 5.785
From | system/sensors/eventizer/overflow_s0
To | system/synth/u_polar0/right_7_s0
Launch Clk | audio_clock/pll_49m152/pll/CLKOUT0.default_gen_clk:[R]
Latch Clk | audio_clock/pll_49m152/pll/CLKOUT0.default_gen_clk:[R]

Data Arrival Path:

AT | DELAY | TYPE | RF | FANOUT | LOC | NODE
0.000 | 0.000 | | | | | active clock edge time
0.000 | 0.000 | | | | | audio_clock/pll_49m152/pll/CLKOUT0.default_gen_clk
4.964 | 4.964 | tCL | RR | 9528 | PLL_T[0] | audio_clock/pll_49m152/pll/CLKOUT0
5.641 | 0.677 | tNET | RR | 1 | R26C110[2][A] | system/sensors/eventizer/overflow_s0/CLK
5.785 | 0.144 | tC2Q | RR | 2 | R26C110[2][A] | system/sensors/eventizer/overflow_s0/Q
5.991 | 0.206 | tNET | RR | 1 | R27C109[3][B] | system/audio_rst_n_s1/I0
6.189 | 0.198 | tINS | RR | 3143 | R27C109[3][B] | system/audio_rst_n_s1/F
7.639 | 1.450 | tNET | RR | 1 | R35C61[2][A] | system/synth/u_polar0/right_7_s0/CLEAR

Data Required Path:

AT | DELAY | TYPE | RF | FANOUT | LOC | NODE
0.000 | 0.000 | | | | | active clock edge time
0.000 | 0.000 | | | | | audio_clock/pll_49m152/pll/CLKOUT0.default_gen_clk
4.964 | 4.964 | tCL | RR | 9528 | PLL_T[0] | audio_clock/pll_49m152/pll/CLKOUT0
5.838 | 0.874 | tNET | RR | 1 | R35C61[2][A] | system/synth/u_polar0/right_7_s0/CLK
5.785 | -0.053 | tHld | | 1 | R35C61[2][A] | system/synth/u_polar0/right_7_s0

Path Statistics:

Clock Skew | 0.197
Hold Relationship | 0.000
Logic Level | 2
Arrival Clock Path Delay | cell: 0.000, 0.000%; route: 0.677, 100.000%
Arrival Data Path Delay | cell: 0.198, 9.910%; route: 1.656, 82.883%; tC2Q: 0.144, 7.207%
Required Clock Path Delay | cell: 0.000, 0.000%; route: 0.874, 100.000%

### Path17

Path Summary:

Slack | 1.854
Data Arrival Time | 7.639
Data Required Time | 5.785
From | system/sensors/eventizer/overflow_s0
To | system/synth/u_polar0/right_8_s0
Launch Clk | audio_clock/pll_49m152/pll/CLKOUT0.default_gen_clk:[R]
Latch Clk | audio_clock/pll_49m152/pll/CLKOUT0.default_gen_clk:[R]

Data Arrival Path:

AT | DELAY | TYPE | RF | FANOUT | LOC | NODE
0.000 | 0.000 | | | | | active clock edge time
0.000 | 0.000 | | | | | audio_clock/pll_49m152/pll/CLKOUT0.default_gen_clk
4.964 | 4.964 | tCL | RR | 9528 | PLL_T[0] | audio_clock/pll_49m152/pll/CLKOUT0
5.641 | 0.677 | tNET | RR | 1 | R26C110[2][A] | system/sensors/eventizer/overflow_s0/CLK
5.785 | 0.144 | tC2Q | RR | 2 | R26C110[2][A] | system/sensors/eventizer/overflow_s0/Q
5.991 | 0.206 | tNET | RR | 1 | R27C109[3][B] | system/audio_rst_n_s1/I0
6.189 | 0.198 | tINS | RR | 3143 | R27C109[3][B] | system/audio_rst_n_s1/F
7.639 | 1.450 | tNET | RR | 1 | R35C61[0][A] | system/synth/u_polar0/right_8_s0/CLEAR

Data Required Path:

AT | DELAY | TYPE | RF | FANOUT | LOC | NODE
0.000 | 0.000 | | | | | active clock edge time
0.000 | 0.000 | | | | | audio_clock/pll_49m152/pll/CLKOUT0.default_gen_clk
4.964 | 4.964 | tCL | RR | 9528 | PLL_T[0] | audio_clock/pll_49m152/pll/CLKOUT0
5.838 | 0.874 | tNET | RR | 1 | R35C61[0][A] | system/synth/u_polar0/right_8_s0/CLK
5.785 | -0.053 | tHld | | 1 | R35C61[0][A] | system/synth/u_polar0/right_8_s0

Path Statistics:

Clock Skew | 0.197
Hold Relationship | 0.000
Logic Level | 2
Arrival Clock Path Delay | cell: 0.000, 0.000%; route: 0.677, 100.000%
Arrival Data Path Delay | cell: 0.198, 9.910%; route: 1.656, 82.883%; tC2Q: 0.144, 7.207%
Required Clock Path Delay | cell: 0.000, 0.000%; route: 0.874, 100.000%

### Path18

Path Summary:

Slack | 1.854
Data Arrival Time | 7.635
Data Required Time | 5.781
From | system/sensors/eventizer/overflow_s0
To | system/monitor/req_s2
Launch Clk | audio_clock/pll_49m152/pll/CLKOUT0.default_gen_clk:[R]
Latch Clk | audio_clock/pll_49m152/pll/CLKOUT0.default_gen_clk:[R]

Data Arrival Path:

AT | DELAY | TYPE | RF | FANOUT | LOC | NODE
0.000 | 0.000 | | | | | active clock edge time
0.000 | 0.000 | | | | | audio_clock/pll_49m152/pll/CLKOUT0.default_gen_clk
4.964 | 4.964 | tCL | RR | 9528 | PLL_T[0] | audio_clock/pll_49m152/pll/CLKOUT0
5.641 | 0.677 | tNET | RR | 1 | R26C110[2][A] | system/sensors/eventizer/overflow_s0/CLK
5.785 | 0.144 | tC2Q | RR | 2 | R26C110[2][A] | system/sensors/eventizer/overflow_s0/Q
5.991 | 0.206 | tNET | RR | 1 | R27C109[3][B] | system/audio_rst_n_s1/I0
6.189 | 0.198 | tINS | RR | 3143 | R27C109[3][B] | system/audio_rst_n_s1/F
7.635 | 1.446 | tNET | RR | 1 | R35C6[2][A] | system/monitor/req_s2/CLEAR

Data Required Path:

AT | DELAY | TYPE | RF | FANOUT | LOC | NODE
0.000 | 0.000 | | | | | active clock edge time
0.000 | 0.000 | | | | | audio_clock/pll_49m152/pll/CLKOUT0.default_gen_clk
4.964 | 4.964 | tCL | RR | 9528 | PLL_T[0] | audio_clock/pll_49m152/pll/CLKOUT0
5.834 | 0.870 | tNET | RR | 1 | R35C6[2][A] | system/monitor/req_s2/CLK
5.781 | -0.053 | tHld | | 1 | R35C6[2][A] | system/monitor/req_s2

Path Statistics:

Clock Skew | 0.193
Hold Relationship | 0.000
Logic Level | 2
Arrival Clock Path Delay | cell: 0.000, 0.000%; route: 0.677, 100.000%
Arrival Data Path Delay | cell: 0.198, 9.930%; route: 1.652, 82.849%; tC2Q: 0.144, 7.222%
Required Clock Path Delay | cell: 0.000, 0.000%; route: 0.870, 100.000%

### Path19

Path Summary:

Slack | 1.854
Data Arrival Time | 7.635
Data Required Time | 5.781
From | system/sensors/eventizer/overflow_s0
To | system/effects/cfill1_3_s3
Launch Clk | audio_clock/pll_49m152/pll/CLKOUT0.default_gen_clk:[R]
Latch Clk | audio_clock/pll_49m152/pll/CLKOUT0.default_gen_clk:[R]

Data Arrival Path:

AT | DELAY | TYPE | RF | FANOUT | LOC | NODE
0.000 | 0.000 | | | | | active clock edge time
0.000 | 0.000 | | | | | audio_clock/pll_49m152/pll/CLKOUT0.default_gen_clk
4.964 | 4.964 | tCL | RR | 9528 | PLL_T[0] | audio_clock/pll_49m152/pll/CLKOUT0
5.641 | 0.677 | tNET | RR | 1 | R26C110[2][A] | system/sensors/eventizer/overflow_s0/CLK
5.785 | 0.144 | tC2Q | RR | 2 | R26C110[2][A] | system/sensors/eventizer/overflow_s0/Q
5.991 | 0.206 | tNET | RR | 1 | R27C109[3][B] | system/audio_rst_n_s1/I0
6.189 | 0.198 | tINS | RR | 3143 | R27C109[3][B] | system/audio_rst_n_s1/F
7.635 | 1.446 | tNET | RR | 1 | R35C58[2][A] | system/effects/cfill1_3_s3/CLEAR

Data Required Path:

AT | DELAY | TYPE | RF | FANOUT | LOC | NODE
0.000 | 0.000 | | | | | active clock edge time
0.000 | 0.000 | | | | | audio_clock/pll_49m152/pll/CLKOUT0.default_gen_clk
4.964 | 4.964 | tCL | RR | 9528 | PLL_T[0] | audio_clock/pll_49m152/pll/CLKOUT0
5.834 | 0.870 | tNET | RR | 1 | R35C58[2][A] | system/effects/cfill1_3_s3/CLK
5.781 | -0.053 | tHld | | 1 | R35C58[2][A] | system/effects/cfill1_3_s3

Path Statistics:

Clock Skew | 0.193
Hold Relationship | 0.000
Logic Level | 2
Arrival Clock Path Delay | cell: 0.000, 0.000%; route: 0.677, 100.000%
Arrival Data Path Delay | cell: 0.198, 9.930%; route: 1.652, 82.849%; tC2Q: 0.144, 7.222%
Required Clock Path Delay | cell: 0.000, 0.000%; route: 0.870, 100.000%

### Path20

Path Summary:

Slack | 1.854
Data Arrival Time | 7.635
Data Required Time | 5.781
From | system/sensors/eventizer/overflow_s0
To | system/effects/cfill1_4_s3
Launch Clk | audio_clock/pll_49m152/pll/CLKOUT0.default_gen_clk:[R]
Latch Clk | audio_clock/pll_49m152/pll/CLKOUT0.default_gen_clk:[R]

Data Arrival Path:

AT | DELAY | TYPE | RF | FANOUT | LOC | NODE
0.000 | 0.000 | | | | | active clock edge time
0.000 | 0.000 | | | | | audio_clock/pll_49m152/pll/CLKOUT0.default_gen_clk
4.964 | 4.964 | tCL | RR | 9528 | PLL_T[0] | audio_clock/pll_49m152/pll/CLKOUT0
5.641 | 0.677 | tNET | RR | 1 | R26C110[2][A] | system/sensors/eventizer/overflow_s0/CLK
5.785 | 0.144 | tC2Q | RR | 2 | R26C110[2][A] | system/sensors/eventizer/overflow_s0/Q
5.991 | 0.206 | tNET | RR | 1 | R27C109[3][B] | system/audio_rst_n_s1/I0
6.189 | 0.198 | tINS | RR | 3143 | R27C109[3][B] | system/audio_rst_n_s1/F
7.635 | 1.446 | tNET | RR | 1 | R35C58[1][B] | system/effects/cfill1_4_s3/CLEAR

Data Required Path:

AT | DELAY | TYPE | RF | FANOUT | LOC | NODE
0.000 | 0.000 | | | | | active clock edge time
0.000 | 0.000 | | | | | audio_clock/pll_49m152/pll/CLKOUT0.default_gen_clk
4.964 | 4.964 | tCL | RR | 9528 | PLL_T[0] | audio_clock/pll_49m152/pll/CLKOUT0
5.834 | 0.870 | tNET | RR | 1 | R35C58[1][B] | system/effects/cfill1_4_s3/CLK
5.781 | -0.053 | tHld | | 1 | R35C58[1][B] | system/effects/cfill1_4_s3

Path Statistics:

Clock Skew | 0.193
Hold Relationship | 0.000
Logic Level | 2
Arrival Clock Path Delay | cell: 0.000, 0.000%; route: 0.677, 100.000%
Arrival Data Path Delay | cell: 0.198, 9.930%; route: 1.652, 82.849%; tC2Q: 0.144, 7.222%
Required Clock Path Delay | cell: 0.000, 0.000%; route: 0.870, 100.000%

### Path21

Path Summary:

Slack | 1.854
Data Arrival Time | 7.635
Data Required Time | 5.781
From | system/sensors/eventizer/overflow_s0
To | system/effects/cfill1_6_s3
Launch Clk | audio_clock/pll_49m152/pll/CLKOUT0.default_gen_clk:[R]
Latch Clk | audio_clock/pll_49m152/pll/CLKOUT0.default_gen_clk:[R]

Data Arrival Path:

AT | DELAY | TYPE | RF | FANOUT | LOC | NODE
0.000 | 0.000 | | | | | active clock edge time
0.000 | 0.000 | | | | | audio_clock/pll_49m152/pll/CLKOUT0.default_gen_clk
4.964 | 4.964 | tCL | RR | 9528 | PLL_T[0] | audio_clock/pll_49m152/pll/CLKOUT0
5.641 | 0.677 | tNET | RR | 1 | R26C110[2][A] | system/sensors/eventizer/overflow_s0/CLK
5.785 | 0.144 | tC2Q | RR | 2 | R26C110[2][A] | system/sensors/eventizer/overflow_s0/Q
5.991 | 0.206 | tNET | RR | 1 | R27C109[3][B] | system/audio_rst_n_s1/I0
6.189 | 0.198 | tINS | RR | 3143 | R27C109[3][B] | system/audio_rst_n_s1/F
7.635 | 1.446 | tNET | RR | 1 | R35C58[1][A] | system/effects/cfill1_6_s3/CLEAR

Data Required Path:

AT | DELAY | TYPE | RF | FANOUT | LOC | NODE
0.000 | 0.000 | | | | | active clock edge time
0.000 | 0.000 | | | | | audio_clock/pll_49m152/pll/CLKOUT0.default_gen_clk
4.964 | 4.964 | tCL | RR | 9528 | PLL_T[0] | audio_clock/pll_49m152/pll/CLKOUT0
5.834 | 0.870 | tNET | RR | 1 | R35C58[1][A] | system/effects/cfill1_6_s3/CLK
5.781 | -0.053 | tHld | | 1 | R35C58[1][A] | system/effects/cfill1_6_s3

Path Statistics:

Clock Skew | 0.193
Hold Relationship | 0.000
Logic Level | 2
Arrival Clock Path Delay | cell: 0.000, 0.000%; route: 0.677, 100.000%
Arrival Data Path Delay | cell: 0.198, 9.930%; route: 1.652, 82.849%; tC2Q: 0.144, 7.222%
Required Clock Path Delay | cell: 0.000, 0.000%; route: 0.870, 100.000%

### Path22

Path Summary:

Slack | 1.854
Data Arrival Time | 7.635
Data Required Time | 5.781
From | system/sensors/eventizer/overflow_s0
To | system/synth/u_polar0/right_14_s0
Launch Clk | audio_clock/pll_49m152/pll/CLKOUT0.default_gen_clk:[R]
Latch Clk | audio_clock/pll_49m152/pll/CLKOUT0.default_gen_clk:[R]

Data Arrival Path:

AT | DELAY | TYPE | RF | FANOUT | LOC | NODE
0.000 | 0.000 | | | | | active clock edge time
0.000 | 0.000 | | | | | audio_clock/pll_49m152/pll/CLKOUT0.default_gen_clk
4.964 | 4.964 | tCL | RR | 9528 | PLL_T[0] | audio_clock/pll_49m152/pll/CLKOUT0
5.641 | 0.677 | tNET | RR | 1 | R26C110[2][A] | system/sensors/eventizer/overflow_s0/CLK
5.785 | 0.144 | tC2Q | RR | 2 | R26C110[2][A] | system/sensors/eventizer/overflow_s0/Q
5.991 | 0.206 | tNET | RR | 1 | R27C109[3][B] | system/audio_rst_n_s1/I0
6.189 | 0.198 | tINS | RR | 3143 | R27C109[3][B] | system/audio_rst_n_s1/F
7.635 | 1.446 | tNET | RR | 1 | R35C62[1][B] | system/synth/u_polar0/right_14_s0/CLEAR

Data Required Path:

AT | DELAY | TYPE | RF | FANOUT | LOC | NODE
0.000 | 0.000 | | | | | active clock edge time
0.000 | 0.000 | | | | | audio_clock/pll_49m152/pll/CLKOUT0.default_gen_clk
4.964 | 4.964 | tCL | RR | 9528 | PLL_T[0] | audio_clock/pll_49m152/pll/CLKOUT0
5.834 | 0.870 | tNET | RR | 1 | R35C62[1][B] | system/synth/u_polar0/right_14_s0/CLK
5.781 | -0.053 | tHld | | 1 | R35C62[1][B] | system/synth/u_polar0/right_14_s0

Path Statistics:

Clock Skew | 0.193
Hold Relationship | 0.000
Logic Level | 2
Arrival Clock Path Delay | cell: 0.000, 0.000%; route: 0.677, 100.000%
Arrival Data Path Delay | cell: 0.198, 9.930%; route: 1.652, 82.849%; tC2Q: 0.144, 7.222%
Required Clock Path Delay | cell: 0.000, 0.000%; route: 0.870, 100.000%

### Path23

Path Summary:

Slack | 1.854
Data Arrival Time | 7.635
Data Required Time | 5.781
From | system/sensors/eventizer/overflow_s0
To | system/synth/u_polar0/right_17_s0
Launch Clk | audio_clock/pll_49m152/pll/CLKOUT0.default_gen_clk:[R]
Latch Clk | audio_clock/pll_49m152/pll/CLKOUT0.default_gen_clk:[R]

Data Arrival Path:

AT | DELAY | TYPE | RF | FANOUT | LOC | NODE
0.000 | 0.000 | | | | | active clock edge time
0.000 | 0.000 | | | | | audio_clock/pll_49m152/pll/CLKOUT0.default_gen_clk
4.964 | 4.964 | tCL | RR | 9528 | PLL_T[0] | audio_clock/pll_49m152/pll/CLKOUT0
5.641 | 0.677 | tNET | RR | 1 | R26C110[2][A] | system/sensors/eventizer/overflow_s0/CLK
5.785 | 0.144 | tC2Q | RR | 2 | R26C110[2][A] | system/sensors/eventizer/overflow_s0/Q
5.991 | 0.206 | tNET | RR | 1 | R27C109[3][B] | system/audio_rst_n_s1/I0
6.189 | 0.198 | tINS | RR | 3143 | R27C109[3][B] | system/audio_rst_n_s1/F
7.635 | 1.446 | tNET | RR | 1 | R35C62[2][A] | system/synth/u_polar0/right_17_s0/CLEAR

Data Required Path:

AT | DELAY | TYPE | RF | FANOUT | LOC | NODE
0.000 | 0.000 | | | | | active clock edge time
0.000 | 0.000 | | | | | audio_clock/pll_49m152/pll/CLKOUT0.default_gen_clk
4.964 | 4.964 | tCL | RR | 9528 | PLL_T[0] | audio_clock/pll_49m152/pll/CLKOUT0
5.834 | 0.870 | tNET | RR | 1 | R35C62[2][A] | system/synth/u_polar0/right_17_s0/CLK
5.781 | -0.053 | tHld | | 1 | R35C62[2][A] | system/synth/u_polar0/right_17_s0

Path Statistics:

Clock Skew | 0.193
Hold Relationship | 0.000
Logic Level | 2
Arrival Clock Path Delay | cell: 0.000, 0.000%; route: 0.677, 100.000%
Arrival Data Path Delay | cell: 0.198, 9.930%; route: 1.652, 82.849%; tC2Q: 0.144, 7.222%
Required Clock Path Delay | cell: 0.000, 0.000%; route: 0.870, 100.000%

### Path24

Path Summary:

Slack | 1.857
Data Arrival Time | 7.638
Data Required Time | 5.781
From | system/sensors/eventizer/overflow_s0
To | system/synth/u_polar0/issuing_s1
Launch Clk | audio_clock/pll_49m152/pll/CLKOUT0.default_gen_clk:[R]
Latch Clk | audio_clock/pll_49m152/pll/CLKOUT0.default_gen_clk:[R]

Data Arrival Path:

AT | DELAY | TYPE | RF | FANOUT | LOC | NODE
0.000 | 0.000 | | | | | active clock edge time
0.000 | 0.000 | | | | | audio_clock/pll_49m152/pll/CLKOUT0.default_gen_clk
4.964 | 4.964 | tCL | RR | 9528 | PLL_T[0] | audio_clock/pll_49m152/pll/CLKOUT0
5.641 | 0.677 | tNET | RR | 1 | R26C110[2][A] | system/sensors/eventizer/overflow_s0/CLK
5.785 | 0.144 | tC2Q | RR | 2 | R26C110[2][A] | system/sensors/eventizer/overflow_s0/Q
5.991 | 0.206 | tNET | RR | 1 | R27C109[3][B] | system/audio_rst_n_s1/I0
6.189 | 0.198 | tINS | RR | 3143 | R27C109[3][B] | system/audio_rst_n_s1/F
7.638 | 1.449 | tNET | RR | 1 | R36C68[1][A] | system/synth/u_polar0/issuing_s1/CLEAR

Data Required Path:

AT | DELAY | TYPE | RF | FANOUT | LOC | NODE
0.000 | 0.000 | | | | | active clock edge time
0.000 | 0.000 | | | | | audio_clock/pll_49m152/pll/CLKOUT0.default_gen_clk
4.964 | 4.964 | tCL | RR | 9528 | PLL_T[0] | audio_clock/pll_49m152/pll/CLKOUT0
5.834 | 0.870 | tNET | RR | 1 | R36C68[1][A] | system/synth/u_polar0/issuing_s1/CLK
5.781 | -0.053 | tHld | | 1 | R36C68[1][A] | system/synth/u_polar0/issuing_s1

Path Statistics:

Clock Skew | 0.193
Hold Relationship | 0.000
Logic Level | 2
Arrival Clock Path Delay | cell: 0.000, 0.000%; route: 0.677, 100.000%
Arrival Data Path Delay | cell: 0.198, 9.915%; route: 1.655, 82.874%; tC2Q: 0.144, 7.211%
Required Clock Path Delay | cell: 0.000, 0.000%; route: 0.870, 100.000%

### Path25

Path Summary:

Slack | 1.857
Data Arrival Time | 7.634
Data Required Time | 5.777
From | system/sensors/eventizer/overflow_s0
To | system/synth/u_polar0/sumR_11_s0
Launch Clk | audio_clock/pll_49m152/pll/CLKOUT0.default_gen_clk:[R]
Latch Clk | audio_clock/pll_49m152/pll/CLKOUT0.default_gen_clk:[R]

Data Arrival Path:

AT | DELAY | TYPE | RF | FANOUT | LOC | NODE
0.000 | 0.000 | | | | | active clock edge time
0.000 | 0.000 | | | | | audio_clock/pll_49m152/pll/CLKOUT0.default_gen_clk
4.964 | 4.964 | tCL | RR | 9528 | PLL_T[0] | audio_clock/pll_49m152/pll/CLKOUT0
5.641 | 0.677 | tNET | RR | 1 | R26C110[2][A] | system/sensors/eventizer/overflow_s0/CLK
5.785 | 0.144 | tC2Q | RR | 2 | R26C110[2][A] | system/sensors/eventizer/overflow_s0/Q
5.991 | 0.206 | tNET | RR | 1 | R27C109[3][B] | system/audio_rst_n_s1/I0
6.189 | 0.198 | tINS | RR | 3143 | R27C109[3][B] | system/audio_rst_n_s1/F
7.634 | 1.445 | tNET | RR | 1 | R36C63[3][A] | system/synth/u_polar0/sumR_11_s0/CLEAR

Data Required Path:

AT | DELAY | TYPE | RF | FANOUT | LOC | NODE
0.000 | 0.000 | | | | | active clock edge time
0.000 | 0.000 | | | | | audio_clock/pll_49m152/pll/CLKOUT0.default_gen_clk
4.964 | 4.964 | tCL | RR | 9528 | PLL_T[0] | audio_clock/pll_49m152/pll/CLKOUT0
5.830 | 0.866 | tNET | RR | 1 | R36C63[3][A] | system/synth/u_polar0/sumR_11_s0/CLK
5.777 | -0.053 | tHld | | 1 | R36C63[3][A] | system/synth/u_polar0/sumR_11_s0

Path Statistics:

Clock Skew | 0.189
Hold Relationship | 0.000
Logic Level | 2
Arrival Clock Path Delay | cell: 0.000, 0.000%; route: 0.677, 100.000%
Arrival Data Path Delay | cell: 0.198, 9.935%; route: 1.651, 82.840%; tC2Q: 0.144, 7.225%
Required Clock Path Delay | cell: 0.000, 0.000%; route: 0.866, 100.000%

## Minimum Pulse Width Report:

#### Report Command:report_min_pulse_width -nworst 10 -detail

### MPW1

MPW Summary:

Slack: | 2.322
Actual Width: | 2.572
Required Width: | 0.250
Type: | Low Pulse Width
Clock: | video_clock/pll/CLKOUT0.default_gen_clk
Objects: | video/green_lane/shift_9_s0

Late clock Path:

AT | DELAY | TYPE | RF | NODE
4.000 | 0.000 | | | active clock edge time
4.000 | 0.000 | | | video_clock/pll/CLKOUT0.default_gen_clk
6.958 | 2.958 | tCL | FF | video_clock/pll/CLKOUT0
9.063 | 2.105 | tNET | FF | video/green_lane/shift_9_s0/CLK

Early clock Path:

AT | DELAY | TYPE | RF | NODE
8.000 | 0.000 | | | active clock edge time
8.000 | 0.000 | | | video_clock/pll/CLKOUT0.default_gen_clk
10.958 | 2.958 | tCL | RR | video_clock/pll/CLKOUT0
11.635 | 0.677 | tNET | RR | video/green_lane/shift_9_s0/CLK

### MPW2

MPW Summary:

Slack: | 2.322
Actual Width: | 2.572
Required Width: | 0.250
Type: | Low Pulse Width
Clock: | video_clock/pll/CLKOUT0.default_gen_clk
Objects: | video/green_lane/shift_8_s0

Late clock Path:

AT | DELAY | TYPE | RF | NODE
4.000 | 0.000 | | | active clock edge time
4.000 | 0.000 | | | video_clock/pll/CLKOUT0.default_gen_clk
6.958 | 2.958 | tCL | FF | video_clock/pll/CLKOUT0
9.063 | 2.105 | tNET | FF | video/green_lane/shift_8_s0/CLK

Early clock Path:

AT | DELAY | TYPE | RF | NODE
8.000 | 0.000 | | | active clock edge time
8.000 | 0.000 | | | video_clock/pll/CLKOUT0.default_gen_clk
10.958 | 2.958 | tCL | RR | video_clock/pll/CLKOUT0
11.635 | 0.677 | tNET | RR | video/green_lane/shift_8_s0/CLK

### MPW3

MPW Summary:

Slack: | 2.322
Actual Width: | 2.572
Required Width: | 0.250
Type: | Low Pulse Width
Clock: | video_clock/pll/CLKOUT0.default_gen_clk
Objects: | video/blue_lane/shift_9_s0

Late clock Path:

AT | DELAY | TYPE | RF | NODE
4.000 | 0.000 | | | active clock edge time
4.000 | 0.000 | | | video_clock/pll/CLKOUT0.default_gen_clk
6.958 | 2.958 | tCL | FF | video_clock/pll/CLKOUT0
9.063 | 2.105 | tNET | FF | video/blue_lane/shift_9_s0/CLK

Early clock Path:

AT | DELAY | TYPE | RF | NODE
8.000 | 0.000 | | | active clock edge time
8.000 | 0.000 | | | video_clock/pll/CLKOUT0.default_gen_clk
10.958 | 2.958 | tCL | RR | video_clock/pll/CLKOUT0
11.635 | 0.677 | tNET | RR | video/blue_lane/shift_9_s0/CLK

### MPW4

MPW Summary:

Slack: | 2.322
Actual Width: | 2.572
Required Width: | 0.250
Type: | Low Pulse Width
Clock: | video_clock/pll/CLKOUT0.default_gen_clk
Objects: | video/blue_lane/shift_8_s0

Late clock Path:

AT | DELAY | TYPE | RF | NODE
4.000 | 0.000 | | | active clock edge time
4.000 | 0.000 | | | video_clock/pll/CLKOUT0.default_gen_clk
6.958 | 2.958 | tCL | FF | video_clock/pll/CLKOUT0
9.063 | 2.105 | tNET | FF | video/blue_lane/shift_8_s0/CLK

Early clock Path:

AT | DELAY | TYPE | RF | NODE
8.000 | 0.000 | | | active clock edge time
8.000 | 0.000 | | | video_clock/pll/CLKOUT0.default_gen_clk
10.958 | 2.958 | tCL | RR | video_clock/pll/CLKOUT0
11.635 | 0.677 | tNET | RR | video/blue_lane/shift_8_s0/CLK

### MPW5

MPW Summary:

Slack: | 2.322
Actual Width: | 2.572
Required Width: | 0.250
Type: | Low Pulse Width
Clock: | video_clock/pll/CLKOUT0.default_gen_clk
Objects: | video/blue_lane/shift_7_s0

Late clock Path:

AT | DELAY | TYPE | RF | NODE
4.000 | 0.000 | | | active clock edge time
4.000 | 0.000 | | | video_clock/pll/CLKOUT0.default_gen_clk
6.958 | 2.958 | tCL | FF | video_clock/pll/CLKOUT0
9.063 | 2.105 | tNET | FF | video/blue_lane/shift_7_s0/CLK

Early clock Path:

AT | DELAY | TYPE | RF | NODE
8.000 | 0.000 | | | active clock edge time
8.000 | 0.000 | | | video_clock/pll/CLKOUT0.default_gen_clk
10.958 | 2.958 | tCL | RR | video_clock/pll/CLKOUT0
11.635 | 0.677 | tNET | RR | video/blue_lane/shift_7_s0/CLK

### MPW6

MPW Summary:

Slack: | 2.322
Actual Width: | 2.572
Required Width: | 0.250
Type: | Low Pulse Width
Clock: | video_clock/pll/CLKOUT0.default_gen_clk
Objects: | video/blue_lane/shift_6_s0

Late clock Path:

AT | DELAY | TYPE | RF | NODE
4.000 | 0.000 | | | active clock edge time
4.000 | 0.000 | | | video_clock/pll/CLKOUT0.default_gen_clk
6.958 | 2.958 | tCL | FF | video_clock/pll/CLKOUT0
9.063 | 2.105 | tNET | FF | video/blue_lane/shift_6_s0/CLK

Early clock Path:

AT | DELAY | TYPE | RF | NODE
8.000 | 0.000 | | | active clock edge time
8.000 | 0.000 | | | video_clock/pll/CLKOUT0.default_gen_clk
10.958 | 2.958 | tCL | RR | video_clock/pll/CLKOUT0
11.635 | 0.677 | tNET | RR | video/blue_lane/shift_6_s0/CLK

### MPW7

MPW Summary:

Slack: | 2.322
Actual Width: | 2.572
Required Width: | 0.250
Type: | Low Pulse Width
Clock: | video_clock/pll/CLKOUT0.default_gen_clk
Objects: | video/blue_lane/shift_4_s0

Late clock Path:

AT | DELAY | TYPE | RF | NODE
4.000 | 0.000 | | | active clock edge time
4.000 | 0.000 | | | video_clock/pll/CLKOUT0.default_gen_clk
6.958 | 2.958 | tCL | FF | video_clock/pll/CLKOUT0
9.063 | 2.105 | tNET | FF | video/blue_lane/shift_4_s0/CLK

Early clock Path:

AT | DELAY | TYPE | RF | NODE
8.000 | 0.000 | | | active clock edge time
8.000 | 0.000 | | | video_clock/pll/CLKOUT0.default_gen_clk
10.958 | 2.958 | tCL | RR | video_clock/pll/CLKOUT0
11.635 | 0.677 | tNET | RR | video/blue_lane/shift_4_s0/CLK

### MPW8

MPW Summary:

Slack: | 2.323
Actual Width: | 2.573
Required Width: | 0.250
Type: | High Pulse Width
Clock: | video_clock/pll/CLKOUT0.default_gen_clk
Objects: | video/green_lane/shift_9_s0

Late clock Path:

AT | DELAY | TYPE | RF | NODE
0.000 | 0.000 | | | active clock edge time
0.000 | 0.000 | | | video_clock/pll/CLKOUT0.default_gen_clk
2.958 | 2.958 | tCL | RR | video_clock/pll/CLKOUT0
5.067 | 2.109 | tNET | RR | video/green_lane/shift_9_s0/CLK

Early clock Path:

AT | DELAY | TYPE | RF | NODE
4.000 | 0.000 | | | active clock edge time
4.000 | 0.000 | | | video_clock/pll/CLKOUT0.default_gen_clk
6.958 | 2.958 | tCL | FF | video_clock/pll/CLKOUT0
7.641 | 0.682 | tNET | FF | video/green_lane/shift_9_s0/CLK

### MPW9

MPW Summary:

Slack: | 2.323
Actual Width: | 2.573
Required Width: | 0.250
Type: | High Pulse Width
Clock: | video_clock/pll/CLKOUT0.default_gen_clk
Objects: | video/green_lane/shift_8_s0

Late clock Path:

AT | DELAY | TYPE | RF | NODE
0.000 | 0.000 | | | active clock edge time
0.000 | 0.000 | | | video_clock/pll/CLKOUT0.default_gen_clk
2.958 | 2.958 | tCL | RR | video_clock/pll/CLKOUT0
5.067 | 2.109 | tNET | RR | video/green_lane/shift_8_s0/CLK

Early clock Path:

AT | DELAY | TYPE | RF | NODE
4.000 | 0.000 | | | active clock edge time
4.000 | 0.000 | | | video_clock/pll/CLKOUT0.default_gen_clk
6.958 | 2.958 | tCL | FF | video_clock/pll/CLKOUT0
7.641 | 0.682 | tNET | FF | video/green_lane/shift_8_s0/CLK

### MPW10

MPW Summary:

Slack: | 2.323
Actual Width: | 2.573
Required Width: | 0.250
Type: | High Pulse Width
Clock: | video_clock/pll/CLKOUT0.default_gen_clk
Objects: | video/blue_lane/shift_9_s0

Late clock Path:

AT | DELAY | TYPE | RF | NODE
0.000 | 0.000 | | | active clock edge time
0.000 | 0.000 | | | video_clock/pll/CLKOUT0.default_gen_clk
2.958 | 2.958 | tCL | RR | video_clock/pll/CLKOUT0
5.067 | 2.109 | tNET | RR | video/blue_lane/shift_9_s0/CLK

Early clock Path:

AT | DELAY | TYPE | RF | NODE
4.000 | 0.000 | | | active clock edge time
4.000 | 0.000 | | | video_clock/pll/CLKOUT0.default_gen_clk
6.958 | 2.958 | tCL | FF | video_clock/pll/CLKOUT0
7.641 | 0.682 | tNET | FF | video/blue_lane/shift_9_s0/CLK

## High Fanout Nets Report:

#### Report Command:report_high_fanout_nets -max_nets 10

FANOUT | NET NAME | WORST SLACK | MAX DELAY
9528 | audio_clk | 0.272 | 2.604
5433 | pixel_clk | 5.266 | 2.604
3216 | n11_7 | 13.481 | 3.621
3143 | system/audio_rst_n | 3.994 | 3.474
2179 | system/visual/bin[0] | 30.756 | 6.114
1165 | system/visual/bin[1] | 31.967 | 5.107
676 | system/visual/bin[2] | 31.448 | 6.261
513 | sys_clk_d | 13.348 | 3.932
487 | system/control/u_allocator/scan_id[0] | 9.128 | 2.822
463 | rst_n | 2.434 | 5.476

## Route Congestions Report:

#### Report Command:report_route_congestion -max_grids 10

GRID LOC | ROUTE CONGESTIONS
R2C83 | 100.00%
R2C84 | 100.00%
R2C136 | 100.00%
R2C141 | 100.00%
R2C145 | 100.00%
R8C87 | 100.00%
R8C93 | 100.00%
R8C94 | 100.00%
R30C75 | 100.00%
R30C76 | 100.00%

## Timing Exceptions Report:

### Setup Analysis Report

#### Report Command:report_exceptions -setup -max_paths 5 -max_common_paths 1

#### Timing Path Constraint[1]: set_max_delay 40.000 -from [get_cells {system/monitor/bundle*}] -to [get_cells {system/monitor/dst_left* system/monitor/dst_right*}]

### Path1

Path Summary:

Slack | 36.912
Data Arrival Time | 8.038
Data Required Time | 44.950
From | system/monitor/bundle_37_s0
To | system/monitor/dst_left_13_s0
Launch Clk | audio_clock/pll_49m152/pll/CLKOUT0.default_gen_clk:[R]
Latch Clk | video_clock/pll/CLKOUT1.default_gen_clk:[R]

Data Arrival Path:

AT | DELAY | TYPE | RF | FANOUT | LOC | NODE
0.000 | 0.000 | | | | | active clock edge time
0.000 | 0.000 | | | | | audio_clock/pll_49m152/pll/CLKOUT0.default_gen_clk
4.964 | 4.964 | tCL | RR | 9528 | PLL_T[0] | audio_clock/pll_49m152/pll/CLKOUT0
7.063 | 2.099 | tNET | RR | 1 | R39C6[1][B] | system/monitor/bundle_37_s0/CLK
7.446 | 0.382 | tC2Q | RR | 1 | R39C6[1][B] | system/monitor/bundle_37_s0/Q
8.038 | 0.592 | tNET | RR | 1 | R39C5[3][A] | system/monitor/dst_left_13_s0/D

Data Required Path:

AT | DELAY | TYPE | RF | FANOUT | LOC | NODE
40.000 | 40.000 | | | | | active clock edge time
40.000 | 0.000 | | | | | video_clock/pll/CLKOUT1.default_gen_clk
42.958 | 2.958 | tCL | RR | 5433 | PLL_B[1] | video_clock/pll/CLKOUT1
45.049 | 2.090 | tNET | RR | 1 | R39C5[3][A] | system/monitor/dst_left_13_s0/CLK
45.014 | -0.035 | tUnc | | | | system/monitor/dst_left_13_s0
44.950 | -0.064 | tSu | | 1 | R39C5[3][A] | system/monitor/dst_left_13_s0

Path Statistics:

Clock Skew | -2.015
Setup Relationship | 40.000
Logic Level | 1
Arrival Clock Path Delay | cell: 0.000, 0.000%; route: 2.099, 100.000%
Arrival Data Path Delay | cell: 0.000, 0.000%; route: 0.592, 60.769%; tC2Q: 0.382, 39.231%
Required Clock Path Delay | cell: 0.000, 0.000%; route: 2.090, 100.000%

### Path2

Path Summary:

Slack | 36.914
Data Arrival Time | 8.036
Data Required Time | 44.950
From | system/monitor/bundle_36_s0
To | system/monitor/dst_left_12_s0
Launch Clk | audio_clock/pll_49m152/pll/CLKOUT0.default_gen_clk:[R]
Latch Clk | video_clock/pll/CLKOUT1.default_gen_clk:[R]

Data Arrival Path:

AT | DELAY | TYPE | RF | FANOUT | LOC | NODE
0.000 | 0.000 | | | | | active clock edge time
0.000 | 0.000 | | | | | audio_clock/pll_49m152/pll/CLKOUT0.default_gen_clk
4.964 | 4.964 | tCL | RR | 9528 | PLL_T[0] | audio_clock/pll_49m152/pll/CLKOUT0
7.063 | 2.099 | tNET | RR | 1 | R39C6[2][A] | system/monitor/bundle_36_s0/CLK
7.446 | 0.382 | tC2Q | RR | 1 | R39C6[2][A] | system/monitor/bundle_36_s0/Q
8.036 | 0.590 | tNET | RR | 1 | R39C5[2][B] | system/monitor/dst_left_12_s0/D

Data Required Path:

AT | DELAY | TYPE | RF | FANOUT | LOC | NODE
40.000 | 40.000 | | | | | active clock edge time
40.000 | 0.000 | | | | | video_clock/pll/CLKOUT1.default_gen_clk
42.958 | 2.958 | tCL | RR | 5433 | PLL_B[1] | video_clock/pll/CLKOUT1
45.049 | 2.090 | tNET | RR | 1 | R39C5[2][B] | system/monitor/dst_left_12_s0/CLK
45.014 | -0.035 | tUnc | | | | system/monitor/dst_left_12_s0
44.950 | -0.064 | tSu | | 1 | R39C5[2][B] | system/monitor/dst_left_12_s0

Path Statistics:

Clock Skew | -2.015
Setup Relationship | 40.000
Logic Level | 1
Arrival Clock Path Delay | cell: 0.000, 0.000%; route: 2.099, 100.000%
Arrival Data Path Delay | cell: 0.000, 0.000%; route: 0.590, 60.668%; tC2Q: 0.382, 39.332%
Required Clock Path Delay | cell: 0.000, 0.000%; route: 2.090, 100.000%

### Path3

Path Summary:

Slack | 36.928
Data Arrival Time | 8.022
Data Required Time | 44.950
From | system/monitor/bundle_38_s0
To | system/monitor/dst_left_14_s0
Launch Clk | audio_clock/pll_49m152/pll/CLKOUT0.default_gen_clk:[R]
Latch Clk | video_clock/pll/CLKOUT1.default_gen_clk:[R]

Data Arrival Path:

AT | DELAY | TYPE | RF | FANOUT | LOC | NODE
0.000 | 0.000 | | | | | active clock edge time
0.000 | 0.000 | | | | | audio_clock/pll_49m152/pll/CLKOUT0.default_gen_clk
4.964 | 4.964 | tCL | RR | 9528 | PLL_T[0] | audio_clock/pll_49m152/pll/CLKOUT0
7.063 | 2.099 | tNET | RR | 1 | R39C6[0][B] | system/monitor/bundle_38_s0/CLK
7.446 | 0.382 | tC2Q | RR | 1 | R39C6[0][B] | system/monitor/bundle_38_s0/Q
8.022 | 0.576 | tNET | RR | 1 | R39C5[3][B] | system/monitor/dst_left_14_s0/D

Data Required Path:

AT | DELAY | TYPE | RF | FANOUT | LOC | NODE
40.000 | 40.000 | | | | | active clock edge time
40.000 | 0.000 | | | | | video_clock/pll/CLKOUT1.default_gen_clk
42.958 | 2.958 | tCL | RR | 5433 | PLL_B[1] | video_clock/pll/CLKOUT1
45.049 | 2.090 | tNET | RR | 1 | R39C5[3][B] | system/monitor/dst_left_14_s0/CLK
45.014 | -0.035 | tUnc | | | | system/monitor/dst_left_14_s0
44.950 | -0.064 | tSu | | 1 | R39C5[3][B] | system/monitor/dst_left_14_s0

Path Statistics:

Clock Skew | -2.015
Setup Relationship | 40.000
Logic Level | 1
Arrival Clock Path Delay | cell: 0.000, 0.000%; route: 2.099, 100.000%
Arrival Data Path Delay | cell: 0.000, 0.000%; route: 0.576, 60.104%; tC2Q: 0.382, 39.896%
Required Clock Path Delay | cell: 0.000, 0.000%; route: 2.090, 100.000%

### Path4

Path Summary:

Slack | 37.059
Data Arrival Time | 7.901
Data Required Time | 44.959
From | system/monitor/bundle_40_s0
To | system/monitor/dst_left_16_s0
Launch Clk | audio_clock/pll_49m152/pll/CLKOUT0.default_gen_clk:[R]
Latch Clk | video_clock/pll/CLKOUT1.default_gen_clk:[R]

Data Arrival Path:

AT | DELAY | TYPE | RF | FANOUT | LOC | NODE
0.000 | 0.000 | | | | | active clock edge time
0.000 | 0.000 | | | | | audio_clock/pll_49m152/pll/CLKOUT0.default_gen_clk
4.964 | 4.964 | tCL | RR | 9528 | PLL_T[0] | audio_clock/pll_49m152/pll/CLKOUT0
7.063 | 2.099 | tNET | RR | 1 | R40C4[3][A] | system/monitor/bundle_40_s0/CLK
7.446 | 0.382 | tC2Q | RR | 1 | R40C4[3][A] | system/monitor/bundle_40_s0/Q
7.901 | 0.455 | tNET | RR | 1 | R40C4[1][B] | system/monitor/dst_left_16_s0/D

Data Required Path:

AT | DELAY | TYPE | RF | FANOUT | LOC | NODE
40.000 | 40.000 | | | | | active clock edge time
40.000 | 0.000 | | | | | video_clock/pll/CLKOUT1.default_gen_clk
42.958 | 2.958 | tCL | RR | 5433 | PLL_B[1] | video_clock/pll/CLKOUT1
45.058 | 2.099 | tNET | RR | 1 | R40C4[1][B] | system/monitor/dst_left_16_s0/CLK
45.023 | -0.035 | tUnc | | | | system/monitor/dst_left_16_s0
44.959 | -0.064 | tSu | | 1 | R40C4[1][B] | system/monitor/dst_left_16_s0

Path Statistics:

Clock Skew | -2.005
Setup Relationship | 40.000
Logic Level | 1
Arrival Clock Path Delay | cell: 0.000, 0.000%; route: 2.099, 100.000%
Arrival Data Path Delay | cell: 0.000, 0.000%; route: 0.455, 54.328%; tC2Q: 0.382, 45.672%
Required Clock Path Delay | cell: 0.000, 0.000%; route: 2.099, 100.000%

### Path5

Path Summary:

Slack | 37.068
Data Arrival Time | 7.901
Data Required Time | 44.968
From | system/monitor/bundle_23_s0
To | system/monitor/dst_right_23_s0
Launch Clk | audio_clock/pll_49m152/pll/CLKOUT0.default_gen_clk:[R]
Latch Clk | video_clock/pll/CLKOUT1.default_gen_clk:[R]

Data Arrival Path:

AT | DELAY | TYPE | RF | FANOUT | LOC | NODE
0.000 | 0.000 | | | | | active clock edge time
0.000 | 0.000 | | | | | audio_clock/pll_49m152/pll/CLKOUT0.default_gen_clk
4.964 | 4.964 | tCL | RR | 9528 | PLL_T[0] | audio_clock/pll_49m152/pll/CLKOUT0
7.063 | 2.099 | tNET | RR | 1 | R39C6[1][A] | system/monitor/bundle_23_s0/CLK
7.446 | 0.382 | tC2Q | RR | 1 | R39C6[1][A] | system/monitor/bundle_23_s0/Q
7.901 | 0.455 | tNET | RR | 1 | R39C7[2][B] | system/monitor/dst_right_23_s0/D

Data Required Path:

AT | DELAY | TYPE | RF | FANOUT | LOC | NODE
40.000 | 40.000 | | | | | active clock edge time
40.000 | 0.000 | | | | | video_clock/pll/CLKOUT1.default_gen_clk
42.958 | 2.958 | tCL | RR | 5433 | PLL_B[1] | video_clock/pll/CLKOUT1
45.067 | 2.109 | tNET | RR | 1 | R39C7[2][B] | system/monitor/dst_right_23_s0/CLK
45.032 | -0.035 | tUnc | | | | system/monitor/dst_right_23_s0
44.968 | -0.064 | tSu | | 1 | R39C7[2][B] | system/monitor/dst_right_23_s0

Path Statistics:

Clock Skew | -1.996
Setup Relationship | 40.000
Logic Level | 1
Arrival Clock Path Delay | cell: 0.000, 0.000%; route: 2.099, 100.000%
Arrival Data Path Delay | cell: 0.000, 0.000%; route: 0.455, 54.328%; tC2Q: 0.382, 45.672%
Required Clock Path Delay | cell: 0.000, 0.000%; route: 2.109, 100.000%

### Hold Analysis Report

#### Report Command:report_exceptions -hold -max_paths 5 -max_common_paths 1

#### No timing exceptions to report!

### Recovery Analysis Report

#### Report Command:report_exceptions -recovery -max_paths 5 -max_common_paths 1

#### Timing Path Constraint[1]: set_max_delay 40.000 -from [get_cells {system/monitor/bundle*}] -to [get_cells {system/monitor/dst_left* system/monitor/dst_right*}]

#### No timing paths to report!

### Removal Analysis Report

#### Report Command:report_exceptions -removal -max_paths 5 -max_common_paths 1

#### No timing exceptions to report!

## Timing Constraints Report:

SDC Command Type | State | Detail Command
TC_CLOCK | Actived | create_clock -name sys_clk -period 20.000 [get_ports {sys_clk}]
TC_FALSE_PATH | Actived | set_false_path -from [get_ports {key_n[*]}] -to [get_cells {board/key_meta*}]
TC_FALSE_PATH | Actived | set_false_path -to [get_cells {ready_meta*}]
TC_FALSE_PATH | Actived | set_false_path -to [get_cells {pressed_meta*}]
TC_FALSE_PATH | Actived | set_false_path -to [get_cells {status_meta*}]
TC_FALSE_PATH | Actived | set_false_path -to [get_cells {system/irq_meta*}]
TC_FALSE_PATH | Actived | set_false_path -to [get_cells {system/uart/receiver/rx_meta*}]
TC_FALSE_PATH | Actived | set_false_path -to [get_cells {system/monitor/ack_meta*}]
TC_FALSE_PATH | Actived | set_false_path -to [get_cells {system/monitor/req_meta*}]
TC_FALSE_PATH | Actived | set_false_path -to [get_pins {video_reset_*_s0/CLEAR}]
TC_FALSE_PATH | Actived | set_false_path -to [get_pins {video/*_lane/serial_ready_*_s0/CLEAR}]
TC_FALSE_PATH | Actived | set_false_path -from [get_ports {mpr_scl[*]}] -to [get_cells {system/sensors/*/bus/scl_sync_0_s0*}]
TC_FALSE_PATH | Actived | set_false_path -from [get_ports {mpr_sda[*]}] -to [get_cells {system/sensors/*/bus/sda_sync_0_s0*}]
TC_MAX_DELAY | Actived | set_max_delay 40.000 -from [get_cells {system/monitor/bundle*}] -to [get_cells {system/monitor/dst_left* system/monitor/dst_right*}]
