wujijun11/git/TangMega60K_Synth/hardware/wiring31005/core30353_p1.png

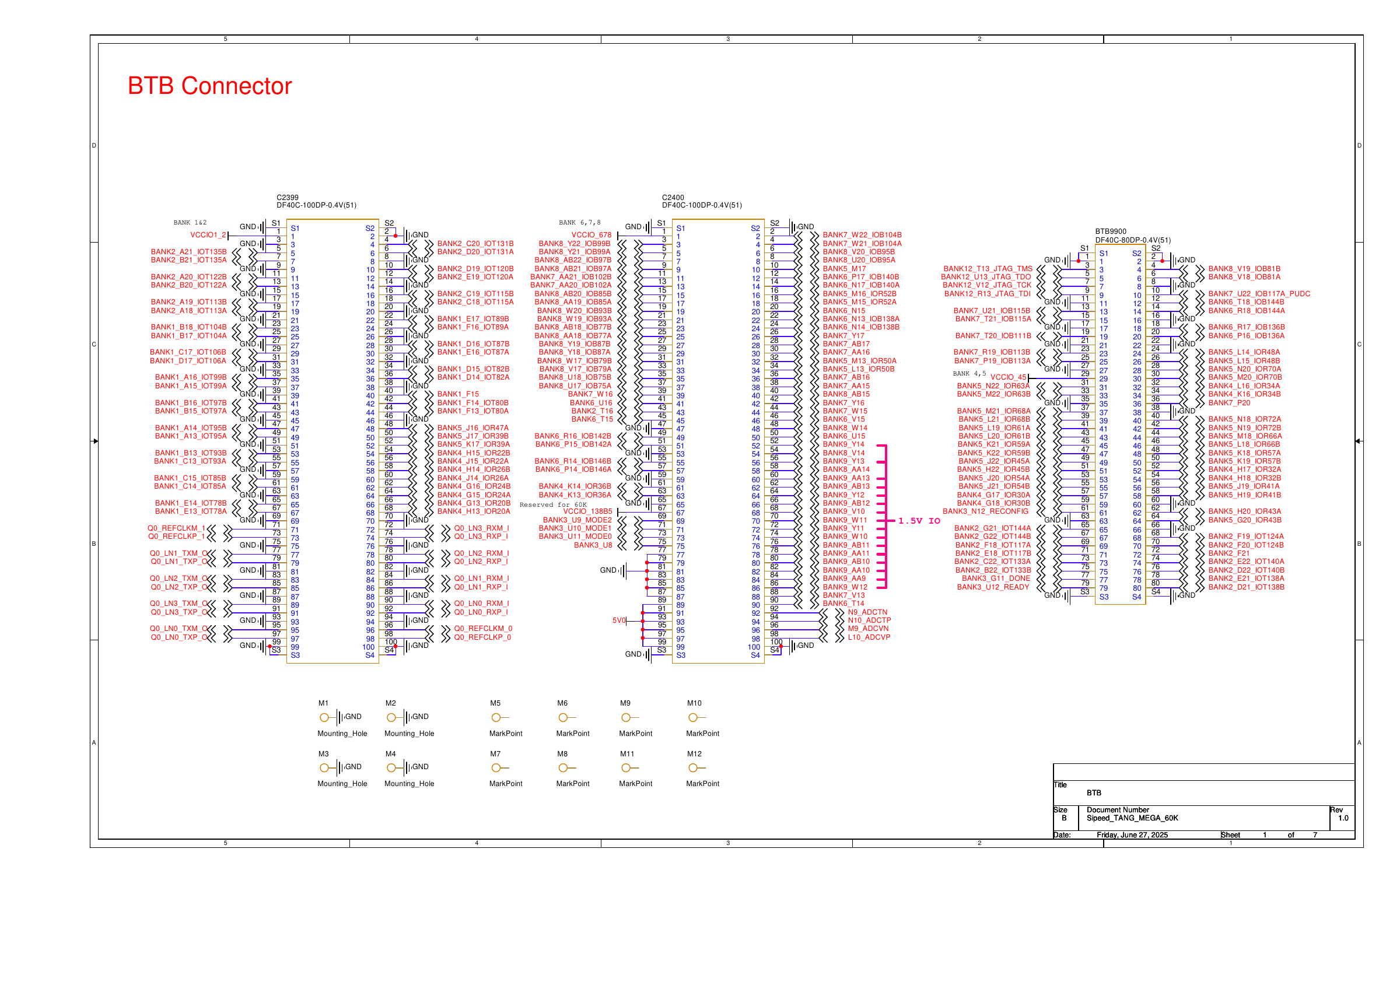
TangMega60K_Synth/hardware/wiring31005/core30353_p1.png
