wujijun11/git/TangMega60K_Synth/hardware/wiring31005/neo31005_p7.png

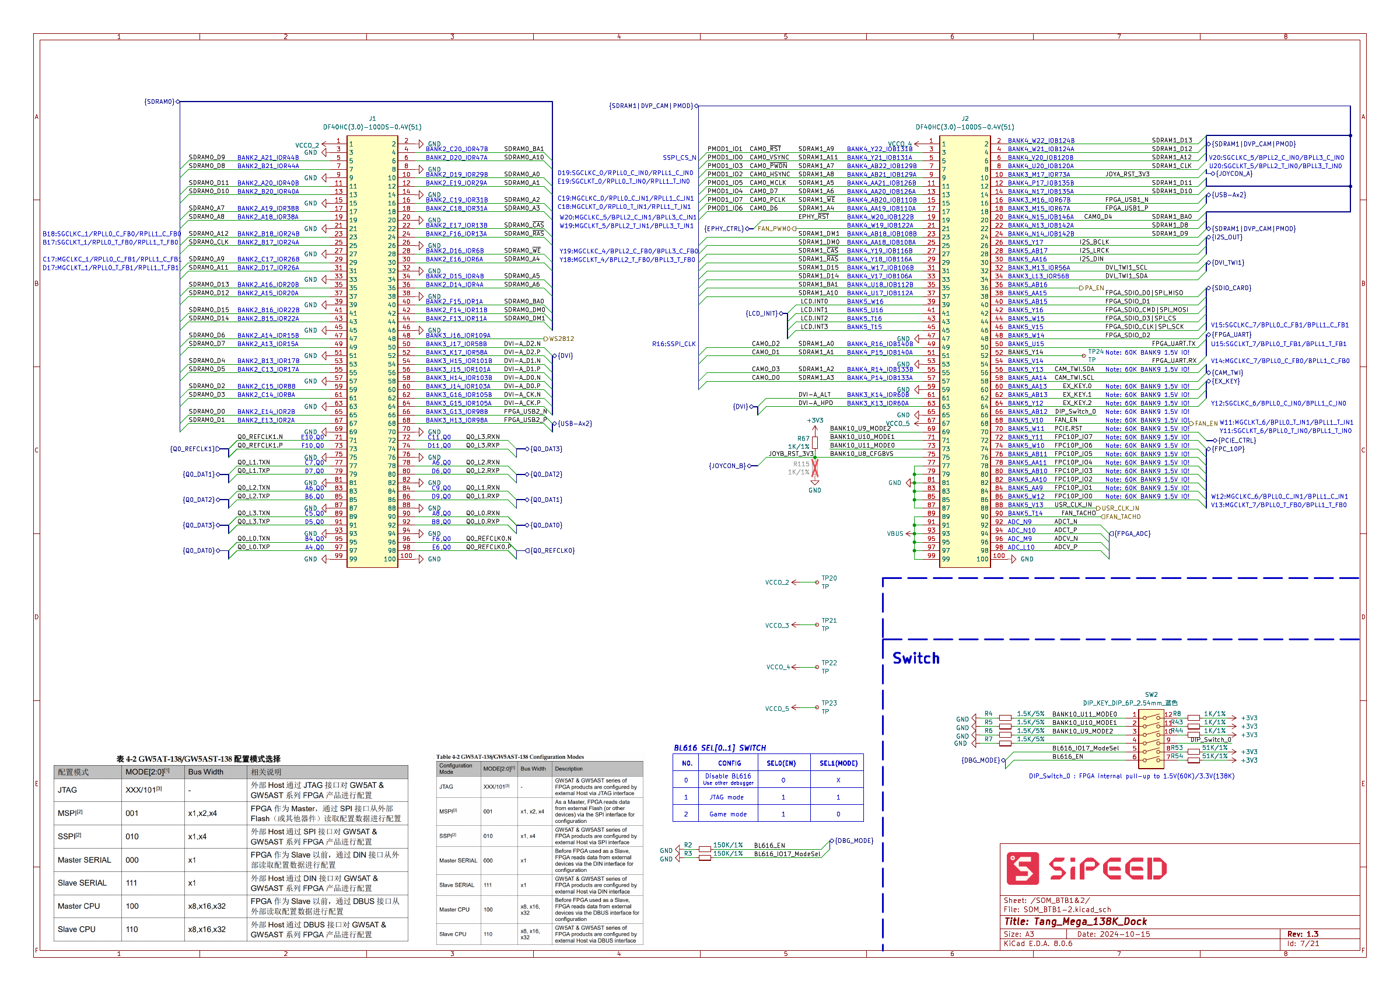
TangMega60K_Synth/hardware/wiring31005/neo31005_p7.png
