wujijun11/git/TangMega60K_Synth/verification/second-code-review-20261023/README.md

# 本轮代码修改与验证（2026-10-23）

电脑端 1.0.3 与 C3 蓝牙固件已编译完成。修改针对命令积压后的停止、断开清理，
以及蓝牙通知和订阅变化同时发生时的稳定性。接线与 UART 引脚保持现有约定。

## 修改

- `desktop/web/controller.js`：将外层命令队列限制为 128 个等待请求。
  “全部停止”会取消尚未发送的旧操作，等待当前事务的 ACK/数据边界结束后发停止。
  断开时取消旧队列，按 FPGA 已确认的远程音符释放，避免继续执行旧演奏。
  有意取消的操作不再被界面误报为新的通信故障。
- `desktop/web/protocol.js`、`mobile/web/protocol.js`：先登记正在等待的请求，
  再调用序号回调，防止回调重入时出现两个并发写入或无法结束的 Promise。
- `firmware/libraries/BridgeBLE/src/BLECharacteristic.cpp/.h`：保护 NimBLE
  订阅列表的读写；通知使用私有快照。在调用 BLE 主机和用户回调前释放锁。
  保留上一轮已修复的同步接收回调，避免延迟回调读到后一条命令。

## 验证与产物

| 范围 | 结果 |
|---|---|
| 新增电脑端停止、断开、队列上限 | 7/7 通过 |
| 独立断开账本、回调重入检查 | 5/5 通过 |
| 电脑端与手机端序号回调 | 10/10 通过 |
| 既有电脑端控制器与手机端回归 | 通过 |
| C3 实际接收代码及选中 SDK 函数主机测试 | 60/60 通过 |
| 实际通知/订阅函数的确定性抢占模型 | 9/9 通过；修改前 4 项失败 |
| 电脑 EXE 提取的原生通信模块 | 11/11 通过 |
| Chromium 界面演示模式 | 通过，0 页面错误，7 张截图 |
| FPGA 主系统停止/表达控制仿真 | 通过；81 个输入与 6D50 构建一致 |

C3 使用 Arduino-ESP32 3.3.5 和项目内 BridgeBLE 编译，已核对 64 个库文件，
确认实际编译的是项目内 30 个 CPP。程序使用 667,954 字节，静态 RAM 24,004 字节。
应用二进制 SHA-256：
`daae9aa6d09b57a32964d25a04cb53ef405625b1b6302624671d008d89c63832`。

FPGA 源码本轮未改，复用源文件全部匹配的完整主工程 6D50；未重新生成测试替代工程。
电脑可运行包为 `desktop/TangNeonStudio-Windows-1.0.3.zip`。
手机端包含协议源修改，本轮没有生成 APK。

详细记录分别在 `desktop/`、`desktop-ui/`、`desktop-build/evidence/`、`c3/`、
`c3-receive-tests/`、`c3-firmware/build-manifest.json` 和 `fpga/`。

## 实机边界

本轮没有向 FPGA 或 C3 烧录，也未验证真实蓝牙射频连接、FPGA ACK 或喇叭声音。
主机中的受控抢占验证的是容器与锁的代码行为，不等同于 ESP32 调度或真实无线测试。
需烧录本轮 C3 固件后再完成实机连接验证。
