wujijun11/git/TangMega60K_Synth/hardware/ahct125/release/verification/layout_review.md

# AHCT125 LED R1 布局与地铜独立审查

日期：2026-10-18（Asia/Shanghai）。结论：**本次保存的PCB文件与实际导出的底层Gerber中，GND铜具有可计算的几何连接，地网连通性审查通过。** 不是只依据原生DRC的`passed`字段得出结论，也不代表成品已经焊接或通过稳定运行、温升、电压与波形测试。

## 对应文件

| 输入 | SHA-256 |
| --- | --- |
| `C:/Users/asus/Documents/LCEDA-Pro/projects/AHCT125-LED-R1/pcb/PCB1.epcb2` | `b05a49bfd3b9bc0bfd62769282007b017f5dbb9ace538e5443deec26355a959a` |
| 同项目 `Gerber_AHCT125_LED_R1.zip` | `ff1231a71da42265830669f89beb39aa31c08283d48180a0a21f38eae18b9032` |
| `hardware/ahct125/generate_ground_plane.py` | `5c9ec9f9e4be4c036611b37075938095f70db761c8b3b298fb64565e556e114c` |

原生完整DRC记录为`references/pcb-check-ground-contours.json`，返回`passed=true`、`verbose=[]`、`saved=true`。

独立检查脚本为 [check_ground_connectivity.py](check_ground_connectivity.py)，结果为 [independent-ground-check.json](independent-ground-check.json)。脚本不导入或运行地铜生成器、不启动编辑器、不写设计文件；只写独立JSON证据。

## 独立重建方法

1. 从最终`.epcb2`读取内嵌FOOTPRINT、COMPONENT、ATTR和PAD_NET，依据元件旋转、局部焊盘坐标和网络分配重建实际焊盘。未直接把旧的布局快照当作最终焊盘位置。
2. 从最终PCB直接读取141个底层GND FILL轮廓，逐个检查有效性与无孔属性，再独立求并集。
3. 重建GND通孔焊盘的铜环、地过孔和顶层短接地线。检查真实铜面面积重叠，并建立跨层几何连接图；不是只检查中心点是否落在图形范围内。
4. 打开实际制造ZIP的`Gerber_BottomLayer.GBL`，按其毫米坐标格式解析全部141个G36/G37区域，再与保存的PCB固定地铜比较。

## 结果

| 项目 | 结果 |
| --- | --- |
| 原生底层FILL轮廓 | 141个，全部有效、单轮廓无内孔 |
| 轮廓并集 | 1个有效Polygon，面积约1051.25089mm² |
| 通孔GND焊盘 | C3-2、J1-2、J2-3、J3-2，4个均与铜面有面积重叠 |
| GND过孔 | 8个均与同一底层铜面有面积重叠 |
| 顶层SMD地脚 | C1-2、C2-2、R1-2、U1-1/5/7/9/12，共8个 |
| SMD到地面 | 全部经顶层地线及地过孔连接；最终文件有9段顶层地线 |
| 底层12个接地点 | 全部连接至同一铜面 |
| 实际Gerber地铜 | 141个区域，并集为同一Polygon；12个接地点全部重叠 |
| 原生铜与Gerber的Hausdorff差 | 0.00000662mm以下，符合本次导出坐标精度差异 |
| 原生铜与Gerber面积对称差 | 约0.00017529mm² |

生成器报告的轮廓并集误差为0，表示写入前的浮点轮廓覆盖了生成器的目标几何；原生文件与Gerber有坐标舍入，不能要求其面积对称差也严格为0。

## 间距与生成器边界

生成参数为异网避让0.30mm、板边内缩0.60mm。将最终原生焊盘重新构造后，独立算得底层地铜到其他网铜的最小间距约 **0.29812mm**。该微小偏差来自生成时采用的API快照坐标舍入及曲线离散，不能宣称最终每一处严格不小于0.30000mm；当前原生完整DRC无报告项。

审查到的生成器从当前板上排除底层非GND线、非GND过孔、NPTH安装孔及非GND通孔焊盘；当前SMD均位于顶层。它不是通用铺铜引擎：若以后加入底层SMD焊盘、弧线、不同类型铜形状或改变板框，须先扩展或重新审查避让算法。其通孔焊盘位置取自布局快照，若位置改变也必须更新快照；本次快照与最终重构焊盘的最大位置差约0.001714mm。

底层地铜由固定`FILL`构成，当前没有可自动重算这些轮廓的动态POUR对象。移动元件、改线、改孔或改板框后，须重新生成固定铜面，再执行原生完整DRC、独立连通性及制造文件复核。**不能仅按Shift+B就认定固定铜面已经重建，也不能继续沿用旧哈希与旧检查结果。** 生成器要求修改时关闭对应EDA会话，避免覆盖编辑器尚未保存的状态。

## 本次审查没有证明的项目

- 实物焊接质量、过孔镀铜与电气连续性；尚待首板检查。
- 5V电源跌落、数据高低电平与脉宽；尚待合格电源和示波器实测。
- 任意杜邦线持续2A、整板热裕量或长距离数据线能力；没有这些承诺。
- 任意PCB修改后仍连通；本结论由上述保存文件和哈希限定。

制造文件的完整性、钻孔/锡膏及BOM/CPL另见同目录`manufacturing_review.md`，不能由本次GND区域解析替代全部CAM审查。
