wujijun11/git/TangMega60K_Synth/verification/modelsim-20261014/core_acceptance/README.md

# ModelSim regression acceptance

Core: 33/33 verified; CorePassed=True.

Full: 33/34 verified; FullPassed=False; status=DeferredByUser.

Current production RTL, testbench, ROM, vendor and project inputs match tested SHA256: True (107 inputs).

Base evidence: C:\Users\asus\Desktop\Git\TangMega60K_Synth\verification\modelsim-20261014\run_20261014_124827_1829ac81

The original run and its logs are retained. The current runner defaults to Core; Full keeps the additional N64 test with a 7200-second default limit. Runner changes below do not alter the tested production inputs.

| Case | Status | Evidence run |
|---|---|---|
| full_system | Passed | C:\Users\asus\Desktop\Git\TangMega60K_Synth\verification\modelsim-20261014\run_20261014_124827_1829ac81 |
| global_panic | Passed | C:\Users\asus\Desktop\Git\TangMega60K_Synth\verification\modelsim-20261014\run_20261014_124827_1829ac81 |
| control_router | Passed | C:\Users\asus\Desktop\Git\TangMega60K_Synth\verification\modelsim-20261014\run_20261014_124827_1829ac81 |
| expression_merge | Passed | C:\Users\asus\Desktop\Git\TangMega60K_Synth\verification\modelsim-20261014\run_20261014_124827_1829ac81 |
| note_arbiter | Passed | C:\Users\asus\Desktop\Git\TangMega60K_Synth\verification\modelsim-20261014\run_20261014_124827_1829ac81 |
| runtime_fx | Passed | C:\Users\asus\Desktop\Git\TangMega60K_Synth\verification\modelsim-20261014\run_20261014_124827_1829ac81 |
| runtime_fx_storage | Passed | C:\Users\asus\Desktop\Git\TangMega60K_Synth\verification\modelsim-20261014\run_20261014_124827_1829ac81 |
| remote_note_watchdog | Passed | C:\Users\asus\Desktop\Git\TangMega60K_Synth\verification\modelsim-20261014\run_20261014_124827_1829ac81 |
| audio_visualizer | Passed | C:\Users\asus\Desktop\Git\TangMega60K_Synth\verification\modelsim-20261014\run_20261014_124827_1829ac81 |
| audio_monitor_cdc | Passed | C:\Users\asus\Desktop\Git\TangMega60K_Synth\verification\modelsim-20261014\run_20261014_124827_1829ac81 |
| watchdog_arbiter | Passed | C:\Users\asus\Desktop\Git\TangMega60K_Synth\verification\modelsim-20261014\run_20261014_124827_1829ac81 |
| mpr121_i2c | Passed | C:\Users\asus\Desktop\Git\TangMega60K_Synth\verification\modelsim-20261014\run_20261014_124827_1829ac81 |
| mpr121_frontend | Passed | C:\Users\asus\Desktop\Git\TangMega60K_Synth\verification\modelsim-20261014\run_20261014_124827_1829ac81 |
| mpr121_backpressure | Passed | C:\Users\asus\Desktop\Git\TangMega60K_Synth\verification\modelsim-20261014\run_20261014_124827_1829ac81 |
| mpr121_timing | Passed | C:\Users\asus\Desktop\Git\TangMega60K_Synth\verification\modelsim-20261014\run_20261014_124827_1829ac81 |
| mpr121_capacity | Passed | C:\Users\asus\Desktop\Git\TangMega60K_Synth\verification\modelsim-20261014\run_20261014_124827_1829ac81 |
| performance | Passed | C:\Users\asus\Desktop\Git\TangMega60K_Synth\verification\modelsim-20261014\run_20261014_124827_1829ac81 |
| performance_retrigger | Passed | C:\Users\asus\Desktop\Git\TangMega60K_Synth\verification\modelsim-20261014\run_20261014_124827_1829ac81 |
| performance_commit | Passed | C:\Users\asus\Desktop\Git\TangMega60K_Synth\verification\modelsim-20261014\run_20261014_124827_1829ac81 |
| board_local_actions | Passed | C:\Users\asus\Desktop\Git\TangMega60K_Synth\verification\modelsim-20261014\run_20261014_124827_1829ac81 |
| ws2812_waveform | Passed | C:\Users\asus\Desktop\Git\TangMega60K_Synth\verification\modelsim-20261014\run_20261014_124827_1829ac81 |
| ws2812_matrix | Passed | C:\Users\asus\Desktop\Git\TangMega60K_Synth\verification\modelsim-20261014\run_20261014_124827_1829ac81 |
| remote_uart | Passed | C:\Users\asus\Desktop\Git\TangMega60K_Synth\verification\modelsim-20261014\run_20261014_124827_1829ac81 |
| video_encoder | Passed | C:\Users\asus\Desktop\Git\TangMega60K_Synth\verification\modelsim-20261014\run_20261014_124827_1829ac81 |
| video_timing | Passed | C:\Users\asus\Desktop\Git\TangMega60K_Synth\verification\modelsim-20261014\run_20261014_124827_1829ac81 |
| video_vendor | Passed | C:\Users\asus\Desktop\Git\TangMega60K_Synth\verification\modelsim-20261014\run_20261014_124827_1829ac81 |
| audio_units | Passed | C:\Users\asus\Desktop\Git\TangMega60K_Synth\verification\modelsim-20261014\run_20261014_124827_1829ac81 |
| audio_engine_n4 | Passed | C:\Users\asus\Desktop\Git\TangMega60K_Synth\verification\modelsim-20261014\run_20261014_124827_1829ac81 |
| audio_engine_n64 | DeferredByUser | See retained attempt history in manifest.json |
| audio_i2s | Passed | C:\Users\asus\Desktop\Git\TangMega60K_Synth\verification\modelsim-20261014\run_20261014_124827_1829ac81 |
| ws2812_reject_zero | Passed | C:\Users\asus\Desktop\Git\TangMega60K_Synth\verification\modelsim-20261014\run_20261014_124827_1829ac81 |
| ws2812_reject_large | Passed | C:\Users\asus\Desktop\Git\TangMega60K_Synth\verification\modelsim-20261014\run_20261014_124827_1829ac81 |
| ws2812_reject_map | Passed | C:\Users\asus\Desktop\Git\TangMega60K_Synth\verification\modelsim-20261014\run_20261014_124827_1829ac81 |
| ws2812_reject_duplicate | Passed | C:\Users\asus\Desktop\Git\TangMega60K_Synth\verification\modelsim-20261014\run_20261014_124827_1829ac81 |

## Runner versions

- C:\Users\asus\Desktop\Git\TangMega60K_Synth\scripts\test-modelsim-full.ps1: changed=True; tested SHA256=f111469eb7b86fab99ca4096bfe0efad916f3d0c99df4b571378385b17401796; current SHA256=aaf93fb76ff3207a4f3ff6dfb24dffcade2664d3800e84c099fab2ea6f5b596f
- C:\Users\asus\Desktop\Git\TangMega60K_Synth\scripts\test-modelsim-full.cmd: changed=True; tested SHA256=963b39cb8146ee03d70f95fd1f31e31c8fc7a2e528e896ebad1c03f8ba8f9300; current SHA256=0fb8793aa582fc2c12ef32a34b1217c5eba04a2dc826a05dbddb480c57530e32
- C:\Users\asus\Desktop\Git\TangMega60K_Synth\sim\view_full_modelsim.do: changed=False; tested SHA256=4bf1f06421f66c03c01e2ba988356e761d4425667897177055724ca22b2c4060; current SHA256=4bf1f06421f66c03c01e2ba988356e761d4425667897177055724ca22b2c4060

The additional legacy audio_engine_n64 case is DeferredByUser. Its original 600-second wall-clock timeout and partial measurement remain in the base run. It has no completed PASS result.

This acceptance covers RTL and vendor primitive simulation. It does not establish physical board, sensor, LED, display, audio or Bluetooth hardware acceptance.
