wujijun11/git/TangMega60K_Synth/hardware/touch25/verification/optimization_20261009.md

# Touch25 R1 装配与校准优化记录 · 2026-10-09

本次按用户“继续优化”落实装配与调试工具，不修改面板铜、尺寸、孔位、接口或音符映射，不生成新Gerber。

## 已完成

- 面板侧8/8/9针2.54 mm成组母壳，组号与pin1两端标记、模块端按ELE实物顺序核对、线束拉力固定。
- 以R1坐标绘制装配SVG/PNG；模块示意放在下沿外绝缘托架，明确外形/孔距/插头高度尚待实物测量，不将示意图交作加工图。
- 标准库Python离线校准工具、空CSV模板和指南：逐键分析三种功放环境下的未触摸、保持、松开、邻键数据，提出按下/松开阈值候选；拦截缺测、ACK/传感器故障、量纲错误、噪声重叠、重复样本和阈值位宽问题。没有生成虚构实测阈值。
- B驱动交接文档：8/8/9通道启用与mask、IRQ同步及补充轮询、超时、配置读回、有序事件、故障组释放、跨模块和弦和完整延迟验收。
- README及原装配指南增加入口并记录最终Gerber上传成功；未提交订单、未付款。

## 验证

`test_calibrate_touch25.py` 的10个测试全部通过。覆盖25键/ELE8映射、基线8位左移2位、缺测、故障、噪声重叠、8位阈值边界、重复样本/无效通道、时间递增、同一字节快照的分析/指纹一致性及CLI空日志/报告覆盖保护。测试数据为合成数据，不能视为首板采样。

装配图按manifest核对25电极、25接口针、8/8/9针数、六个3.2 mm孔和290 × 105 mm尺寸；PNG文字已目视检查。

制造文件前后哈希核对一致：

| 文件 | SHA256 |
| --- | --- |
| `Gerber_Touch25_C4_C6_18mm_R1_2026-10-09.zip` | `796CCB39E2B18CB72EF80832254A5D7D71BE6FFF0C74F9DEE4A8960D6979C42C` |
| `Touch25_C4_C6_18mm_R1_Final/pcb/Touch25_C4_C6_18mm_R1.epcb2` | `FB1FD51E2866946595F541ED09F2368CB593F4B1FB900645BA40952DE7F242B6` |

原141项原生DRC及163项Gerber审核对应同一制造文件；本次未修改制造文件，不以新工具测试替代这些审核。

## 尚待实物/固件工作

模块外形与底托尺寸、线束实际制作、九路GPIO约束、MPR121采集RTL、真实日志导出、逐键校准和回写后的验收尚未完成。当前位流仍使用既有板载按键/发声测试入口，不会因新增文档或校准工具自动识别触摸琴键。

候选阈值是实测日志极值加工程余量的启发式建议，必须用独立数据和实物事件复测；没有触摸灵敏度、抗干扰或端到端≤10 ms已达标的声明。
