wujijun11/git/TangMega60K_Synth/docs/reports/chord-touch-20261028/issues/问题与修正记录.md

# 本轮问题与修正记录

以下失败记录保留原始日志，不作为通过证据。没有通过修改公共接口、放松SDC或隐去失败来交付。

| 问题 | 原因 | 处理与证据 |
|---|---|---|
| 限幅器测试台编译错误 | 大于32位的无尺寸十进制测试常数 | 改成显式64位有符号常数；`unsized-test-constant.compile.log`保留旧错误，最终`core`日志验证算术 |
| 提前邮箱测试初始化不能完成 | 测试事务超时1000周期短于43字节读取所需时间 | 改为10000周期；`mailbox-test-timeout.log`保留失败；生产TIMEOUT不变 |
| 预期钢琴标记没有出现 | 测试台FM与POLAR同时开启时，优先执行FM分支 | 明确选择POLAR；`wrong-fm-test-selection.json`及两份日志保留误配；最终`stable_polar_n4/n64`才是钢琴通过证据 |
| 邮箱日志的ns后缀与默认ps格式不符 | `%t`默认按全局精度打印 | 增加一行`$timeformat`，仅修正打印单位，并单独复跑该用例；最终证据在`early-label-correction`。核心10项较早的该行文本仍保留；正式延迟分析始终使用完整板级CSV，不使用这行加速单元测试数值 |

最终封存脚本严格核对：较早核心测试台与最终测试台只允许这一行打印单位设置的差异；另外必须存在最终源码的邮箱单独复跑成功记录。RTL、ROM、时序约束不能套用这一例外。

完整时序检查一次通过。原有核心板全部灯熄灭、启动异常、供电或杜邦线问题没有由本轮代码证明解决；本轮是本地仿真与构建，未下载板卡。
