wujijun11/git/TangMega60K_Synth/verification/uart-live-debug-20261023/main_status_core0.csv

Groups:
debug_status[47:0] = | debug_status[47] | debug_status[46] | debug_status[45] | debug_status[44] | debug_status[43] | debug_status[42] | debug_status[41] | debug_status[40] | debug_status[39] | debug_status[38] | debug_status[37] | debug_status[36] | debug_status[35] | debug_status[34] | debug_status[33] | debug_status[32] | debug_status[31] | debug_status[30] | debug_status[29] | debug_status[28] | debug_status[27] | debug_status[26] | debug_status[25] | debug_status[24] | debug_status[23] | debug_status[22] | debug_status[21] | debug_status[20] | debug_status[19] | debug_status[18] | debug_status[17] | debug_status[16] | debug_status[15] | debug_status[14] | debug_status[13] | debug_status[12] | debug_status[11] | debug_status[10] | debug_status[9] | debug_status[8] | debug_status[7] | debug_status[6] | debug_status[5] | debug_status[4] | debug_status[3] | debug_status[2] | debug_status[1] | debug_status[0]
Data:
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
