wujijun11/git/TangMega60K_Synth/hardware/ahct125/release/production/PCB_AHCT125_LED_R1.pdf

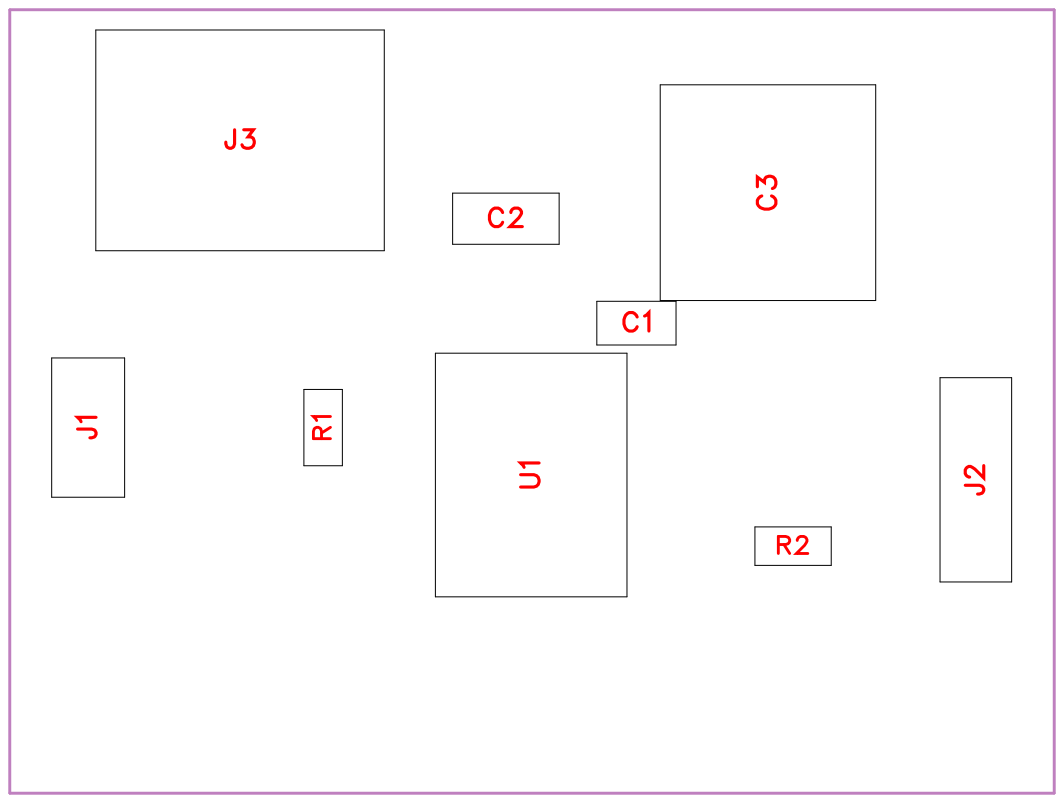
[picture p32: page 1]

No. | Quantity | Comment | Designator | Footprint | Value | Manufacture r Part | Manufacture r | Supplier Part | Supplier
1 | 1 | 100nF | C1 | C0603 | 100nF | CC0603KRX7R 9BB104 | YAGEO(ýè) | C14663 | LCSC
2 | 1 | 10uF | C2 | C0805 | 10uF | CL21A106KAY NNNE | SAMSUNG( ) C15850 | | LCSC
3 | 1 | 1000uF | C3 | CAP-TH_BD8. 0-P3.50-D0. 6-FD | 1000uF | 10PX1000MEF C8X11.5 | Rubycon(¢•ó) Tj | T* () C88853 | LCSC
4 | 1 | B-2100S02P-A110 | J1 | HDR-TH_2P-P 2.54-V-M-1 | | B-2100S02P-A110 | Ckmtw(•Ñß) | C124375 | LCSC
5 | 1 | B-2100S03P-A110 | J2 | HDR-TH_3P-P 2.54-V-M-1 | | B-2100S03P-A110 | Ckmtw(•Ñß) | C124376 | LCSC
6 | 1 | KF127-5.08-2P | J3 | CONN-TH_P5. 08_KF127-5. 08-2P | | KF127-5.08-2P | KEFA(ÑÑ) | C474906 | LCSC
7 | 1 | 10k© | R1 | R0603 | 10k© | 0603WAF1002 T5E | UNI-ROYAL(š) Tj | T* (ð) C25804 | LCSC
8 | 1 | 330© | R2 | R0603 | 330© | 0603WAF3300 T5E | UNI-ROYAL(š) Tj | T* (ð) C23138 | LCSC
9 | 1 | SN74AHCT125 DR | U1 | SOIC-14_L8. 7-W3.9-P1.2 7-LS6.0-BL | | SN74AHCT125 DR | TI(·Þêh) | C155176 | LCSC

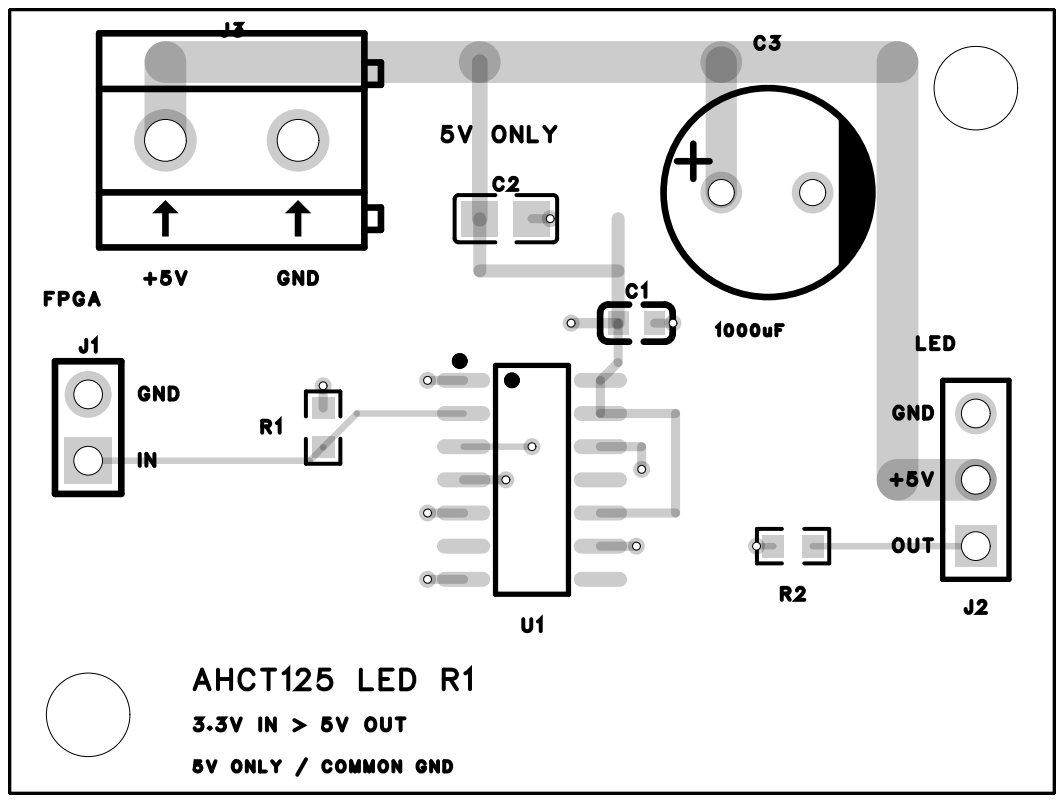
[picture p33: page 4]

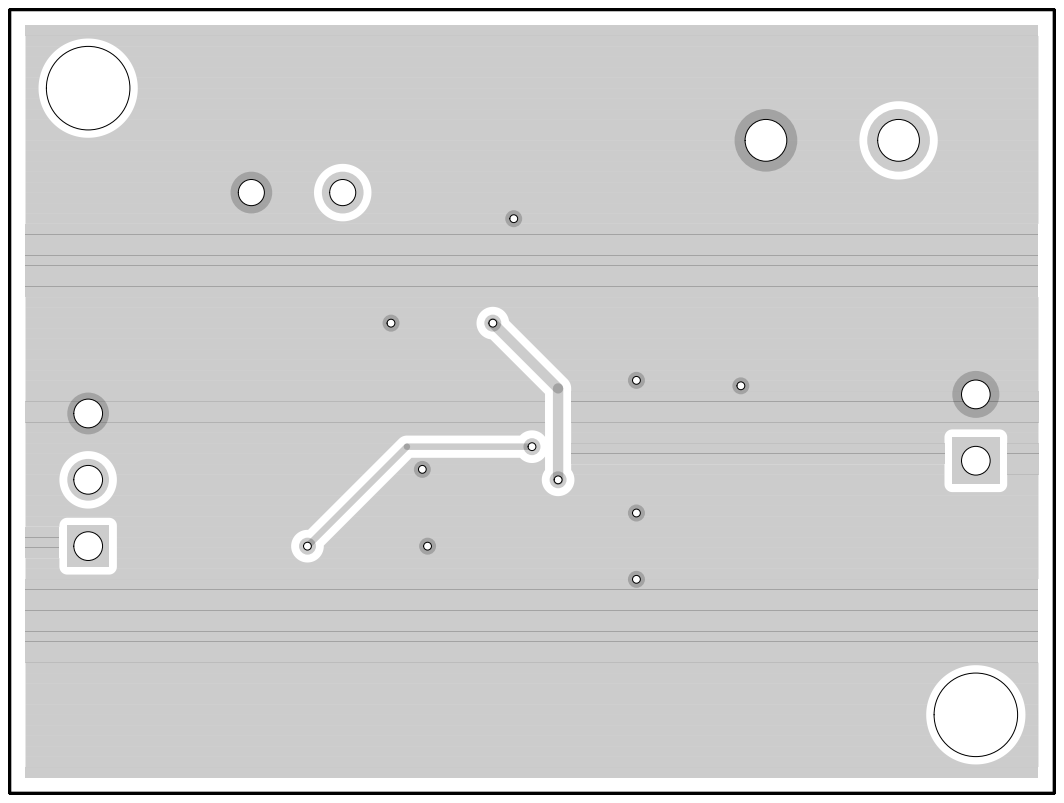
[picture p34: page 5]

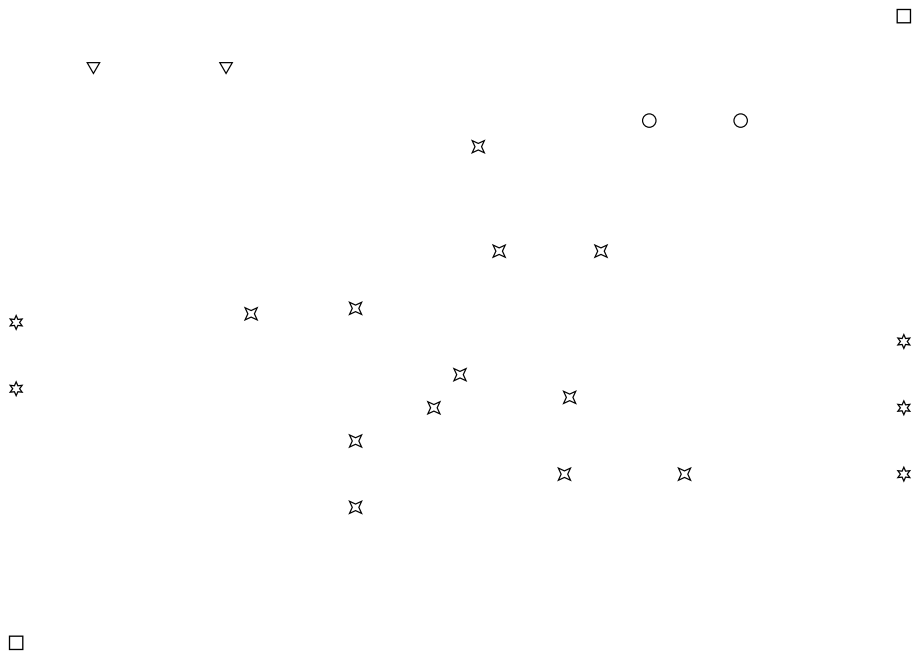
[picture p35: page 6]
