wujijun11/git/(list of files, drawings)

Other design files:
TangMega60K_Synth/hardware/ahct125/release/verification/pcb-check-ground-contours.json
TangMega60K_Synth/hardware/ahct125/release/verification/sch-check.json
