wujijun11/git/(commit log)

2026-09-17 Integrate audio engine and fix SystemVerilog mixer identifiers
    [stereo_mixer.v]
2026-09-19 Integrate Live64 diagnostic and verify 64-note I2S output
    [frequencies64.csv]
2026-09-23 Integrate 60K board diagnostics and record main-engine validation
2026-09-23 Fix I2S startup underrun and verify registered-reset GAO on hardware
    [zero_underrun_later.csv, zero_underrun_run15.csv]
2026-09-23 Integrate eight-partial piano and 48 kHz I2S board work
    Merge teammate A's four-region piano RTL, ROMs, models, and FM verification into the current audio engine. Include the independently validated 48 kHz board projects, test scripts, and hardware reports while preserving the existing I2S startup fix and bitstreams.
    [board_audio_48k_core0.csv, board_audio_48k_later_core0.csv, board_audio_48k_reconnected_core0.csv]
2026-09-24 Integrate teammate B interaction chain with audio engine
2026-09-24 Add B 48 kHz board self-test and record hardware capture
2026-10-08 Add playable board keys and 16-note I2S diagnostics
    Include source ROMs, hardware validation records and build scripts. Fix board-key test paths when invoked from the repository root.
    [board_audio_16_48k_i2s_top.v, board_instrument_b_48k_i2s_top.v, board_key_event_adapter.v, board_sequence16_48k_i2s_top.v, poly16_event_source.v, sequence16_event_source.v, tb_board_audio_16_48k_i2s.sv, tb_board_instrument_b_48k_i2s.sv]
2026-10-08 Improve playable key response with 2 ms debounce
    Verify production-parameter input-to-I2S latency, glitch rejection, release tails, four-note triggering and reset. Record passing functional regression and rebuilt bitstream; physical end-to-end latency remains to be measured.
    [board_instrument_b_48k_i2s_top.v, tb_board_key_latency.sv]
2026-10-11 Integrate full FPGA instrument, mobile control and touch hardware
    Add the 25-key MPR121 and slider frontend, 64-voice four-timbre contest
    entry, runtime effects, score playback, LED guidance and HDMI visuals.
    Include Android and ESP32-C3 BLE bridge sources and touch PCB designs.
    Fix remapped-note release, hung BLE writes, stale connection callbacks
    and duplicate-pitch multi-touch release, with focused regression tests.
    Document the verified builds and pending physical acceptance, including
    97 percent BSRAM usage and the 0.001 ns minimum setup margin.
    Keep real-time audio synthesis in FPGA HDL. Exclude generated outputs,
    tool caches, private order evidence and local EDA account databases;
    c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
2026-10-14 Improve FPGA timing margin and publish verified ModelSim regressions
    Select the equivalent watchdog/nonempty and performance payload mux changes,
    raising minimum setup slack from 0.051 ns to 0.272 ns with 106/118 BSRAM.
    Include the 25-pixel WS2812 matrix and Waveshare ESP32-C3 integration updates,
    RAM/storage fixes, diagnostics, reproducible runners and source references.
    Archive original small reports, Core 28+5 logs, two equivalence suites and
    the selected-release audit. Preserve audited file bytes in Git. Document
    the 0.035 ns hold margin, deferred long test and pending hardware validation.
    Keep generated binaries, tool libraries, account data and private orders out.
2026-10-24 Publish current piano firmware, desktop controller and UART diagnostics
    Update the complete FPGA instrument, checked C3 BLE bridge and local BLE
    library, and Tang Neon Studio 1.0.4 sources. Include curated regression and
    UART observation evidence, wiring documentation, and sanitized AHCT125
    manufacturing sources. Preserve audited file bytes and vendor licenses.
    Document the actual hardware limits: main build 8FE0 and passive SRAM
    observation build 3B9F have no timing violations, but the FPGA ACK is still
    unverified and nonvolatile FPGA programming is pending.
    Publication validation: all 739 selected files match the staged Git blobs;
    357 enabled references across 17 FPGA projects exist. Omi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
2026-10-24 Add backplane BOM and safety validation
2026-10-24 Correct backplane AHCT connectors and strengthen interface checks
2026-10-26 Add FPGA learning mode and publish current instrument clients
    Integrate the pending slider menu, 1024-event score storage, MIDI/catalog
    clients, configurable Windows keys, mode status, direct-pitch playback,
    and Windows background realtime score streaming.
    Add a synthesizable physical-key learning stepper, strict status readback,
    numbered 5x5 guide UI, regression benches, and repeatable verification.
    Refresh legacy mobile VM tests for current script dependencies and upload
    locking behavior without changing client runtime code.
    Publish the verified LearningMode bitstream and Windows 1.5.0 portable ZIP
    with SHA256 and original evidence. Record 19 ModelSim cases, build/timing,
    client checks,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
2026-10-27 fix(triage): suspend failed headroom release and add isolated boot probe
2026-10-28 test: extend OLED idle overlay to 10s and record slider power fault
2026-10-30 feat: publish independent sustain test build and module interface guide
    Add switchable sustain between the original V2 allocator and voice engine,
    with menu/OLED state and Windows/Android capability-aware control.
    Preserve F571 audio algorithms, fixed chord gain, early touch, clocks and pins.
    Archive the previously verified 34 ModelSim cases, 21 client checks, Gowin
    reports and historical fixes. Publish the identical FPGA/Windows/Android
    packages with hashes and an explicit NOT TESTED ON HARDWARE status.
    Document 90 RTL files, 97 modules, 1465 ports and 122 named instances, with
    Chinese signal meanings, timing notes, parameter overrides and connections.
    Rerun interface/document consistency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
2026-10-31 Fix remote sustain disconnect cleanup and velocity-zero watchdog tracking
